dronrome1245/ARDU/02_СЛЕДУЮЩИЙ_ШАГ.md

# 02 — СЛЕДУЮЩИЙ ШАГ

> Совместимый handoff-файл. Канонический статус находится в `STATUS.md`.

**Актуальное направление на 2026-11-14:** Android 0.22.16, Nano R7, ESP V5 source CI PASS; R7 30 712/30 720 B Flash. Следующее физическое действие по D-128 — сохранить `/api/settings`, установить ESP V5 OTA с приватными credentials, затем Nano R7 по полностью проверенному write+verify, после этого провести `04_Прошивка/FAMILY_R7_ACCEPTANCE.md`. До выполненных электрических 44+44 и безопасного Class II gate потолочный монтаж не разрешён. Следующие абзацы — исторический handoff 2026-09.

## Цель следующей итерации

Подтвердить питание и физическую разводку двух потолочных корпусов, затем собрать первый ESP8266↔Nano стенд.

## Уже закрыто

- запас WS2812B подтверждён: 5 м;
- `Ardublock2.aia` разобран;
- режимы и параметры v1 определены;
- модель нового Wi‑Fi приложения определена;
- предварительный HTTP API создан.

## От владельца нужны три группы данных

1. Есть ли мультиметр и паяльник/припой.
2. Расстояние между двумя круглыми корпусами и фактическая потолочная проводка: где разветвляется линия второй клавиши, сколько жил приходит к каждому корпусу.
3. Где можно безопасно и обслуживаемо разместить общий S-30-5.

## Затем измерить

1. S-30-5: V+↔V- без нагрузки.
2. YP-8: 5 В на VIN → VOUT без нагрузки.
3. После подтверждения 3,3 В — YP-8 с ESP8266 под Wi‑Fi нагрузкой.
4. Прочитать маркировку и количество электролитов около `1000 µF`.
5. Собрать делитель Nano TX → ESP RX и измерить его выход до подключения ESP8266.

## Параллельная подготовка

- удалить `201` на DS3231 перед штатным питанием с CR2032;
- проверить способ прошивки ESP8266 через имеющийся Nano/другой мост;
- физически примерить 43 LED на кантик 71,5 см;
- не замыкать DOUT последнего LED обратно на DIN первого.

## После этого

1. утвердить окончательный BOM;
2. собрать `S-30-5 → Nano + YP-8/ESP8266 → UART → одно кольцо`;
3. добиться `PING/PONG`;
4. включить F01 постоянный цвет по Wi‑Fi;
5. добавить второе кольцо;
6. подключить MAX9814 и реализовать M01 VU градиент.

Подробный порядок: `04_Прошивка/ПОРЯДОК_РЕАЛИЗАЦИИ.md`.

## Актуальный следующий шаг 2026-09-20

Собрать безопасный низкоомный programmer-divider `750 Ом / 1,5 кОм` из имеющихся резисторов 1,5 кОм, оставить `100 µF 10 V` у ESP, проверить HIGH около 3,3 В и повторить upload на `115200` с ручным кратким `RST→GND` во время `Connecting...`. Прямой D0→ESP RX больше не использовать как штатный способ.

## Актуальный следующий шаг — FW-0 Nano

1. Полностью отделить Nano от ESP по D0/D1 на время загрузки FW-0.
2. Убрать перемычку `RESET Nano → GND` — она нужна была только когда Nano работала USB↔UART-мостом.
3. Оставить Nano подключённой только по USB к компьютеру и загрузить `04_Прошивка/nano_fw0/nano_fw0.ino`.
4. Открыть Serial Monitor `115200`, окончание строки `Newline`; ожидать `ARDU NANO FW0 READY`.
5. Отправить `PING` → ожидать `PONG`; затем `STATUS` → ожидать строку `STATUS FW=FW0 ...`.

До успешного теста кольцо, ESP и MAX9814 к FW-0 не подключать.

### Уточнение после первой попытки FW-0

Перед повторным Upload Nano: ESP должен быть полностью отключён от `D0` и `D1`; перемычка `RESET Nano→GND` снята; Serial Monitor закрыт. Повторить upload с текущими настройками Arduino IDE. Только если `not in sync` сохранится на полностью изолированной Nano, проверять вариант `ATmega328P (Old Bootloader)` и ручной reset.

### Следующий тест Nano после сохранения `resp=0x41`

В Arduino IDE выбрать `Tools → Processor → ATmega328P (Old Bootloader)` и повторить Upload при полностью свободных D0/D1 и снятом `RESET→GND`. Если ошибка сохранится — выполнить ручной reset Nano в момент начала загрузки.

## Актуальный следующий шаг — FW-1

FW-0 закрыт. Оставить Nano изолированной от ESP, выбрать `Arduino Nano → ATmega328P (Old Bootloader)`. Открыть `04_Прошивка/nano_fw1/nano_fw1.ino` и сначала выполнить только Verify/Compile. Если Arduino IDE сообщает, что `FastLED.h` не найден, установить библиотеку `FastLED` через Library Manager. Кольцо пока не подключать. После успешной компиляции перейти к физической схеме одного кольца на D6.

### FW-1 — физический тест одного канала

Собрать только Nano + один вход WS2812B: Nano питается по USB; лента питается от S-30-5 5 В; земли Nano и S-30-5/ленты объединены; `Nano 5V` с `S-30-5 V+` не соединять. DATA: D6 → DIN начала ленты; предпочтительно через 330 Ом, а для текущего короткого стенда допустим временный последовательный 1,5 кОм из наличия. Проверять первые 43 LED на малой яркости/лимите 500 мА. Второе кольцо, ESP и MAX9814 не подключать.

### FW-1 — схема по AlexGyver

Предыдущий временный вариант DATA через `1,5 кОм` отменён. Перед подключением ленты:
1. прочитать полную маркировку имеющегося электролита `1000 µF` и подтвердить рабочее напряжение ≥6,3 В;
2. найти среди имеющихся резистор `200–500 Ом` (предпочтительно 330 Ом) либо подтвердить, что его нет;
3. затем собрать: `S-30-5 +5V/GND → лента`, `1000 µF` параллельно +5V/GND у начала ленты, `Nano D6 → 200–500 Ом → DIN`, `Nano GND → GND ленты`. Nano остаётся на USB; Nano 5V к S-30-5 V+ не соединять.

### После подтверждения 1000 µF 6,3 V

Конденсатор для питания WS2812B подтверждён. Следующее — найти/подтвердить DATA-резистор `200–500 Ом` (целевой 330 Ом). До его подтверждения физический FW-1 с лентой не собирать.

### После подготовки 220 Ом

1. Пока лента не подключена, загрузить `04_Прошивка/nano_fw1/nano_fw1.ino` в Mini-USB Nano с `ATmega328P (Old Bootloader)`.
2. Отключить USB Nano и 230 В/S-30-5.
3. Собрать один канал: `Nano D6 → 220 Ом → DIN WS2812B`; `S-30-5 +5V → +5V ленты`; `S-30-5 V- → GND ленты`; `Nano GND → GND ленты`; `1000 µF 6,3 V` параллельно +5V/GND у начала ленты (`+` к +5V, `-` к GND).
4. `Nano 5V` с `S-30-5 +5V` не соединять. Второе кольцо, ESP и MAX9814 не подключать.
5. После сборки включить S-30-5, затем подключить Nano по USB. Ожидаемый результат — первые 43 LED тускло красные; затем проверить `STATUS`, `COLOR 0 32 0`, `COLOR 0 0 32`.

## Актуальный следующий шаг — FW-2

1. Открыть `04_Прошивка/nano_fw2/nano_fw2.ino`.
2. Оставить Mini-USB Nano как `Arduino Nano → ATmega328P (Old Bootloader)`.
3. Выполнить только Verify/Compile, не подключая второе кольцо.
4. После успешной компиляции подтвердить наличие второго DATA-резистора `200–500 Ом` (220 Ом подходит) и второго электролита около `1000 µF` ≥6,3 В для второго кольца либо временно тестировать два коротких сегмента рядом с одним общим качественным 5 В вводом.
5. Физический FW-2: D6→резистор→DIN A, D7→резистор→DIN B, обе ленты от S-30-5, общая GND, одинаковый кадр; затем команды `RING A`, `RING B`, `BOTH`.

## Актуальный шаг после решения о зеркальном D7

Второе кольцо пока не подключать. D7 физически не тестировать. На текущем D6-кольце завершить F01-команды:

1. `OFF` — все 43 LED должны погаснуть, ответ `OK`.
2. `ON` — должен вернуться текущий цвет, ответ `OK`.
3. `BRIGHT 8` — заметно уменьшить яркость, ответ `OK`.
4. `BRIGHT 64` — увеличить яркость, ответ `OK`.
5. `STATUS` — проверить, что POWER/BRIGHTNESS/RGB совпадают с командами.

После этого следующий физический слой добавлять только к одному кольцу. D7 остаётся зеркальным выходом и будет проверен после полной настройки первого кольца.

## Актуальный следующий шаг — MAX9814 на одном кольце

1. Сначала открыть и скомпилировать/загрузить `04_Прошивка/nano_mic_test/nano_mic_test.ino` на Mini-USB Nano (`ATmega328P (Old Bootloader)`).
2. После успешной загрузки обесточить стенд и подключить MAX9814: `Vdd→Nano 5V`, `GND→Nano GND`, `Out→A0`; `Gain` и `AR` оставить неподключёнными.
3. Включить стенд, Serial Monitor `115200`, `Newline`.
4. В тишине отправить `MIC` несколько раз; затем говорить/хлопать рядом с микрофоном и снова отправлять `MIC`.
5. Успех этапа: среднее значение остаётся в разумном диапазоне и `P2P` заметно увеличивается при звуке. Второе кольцо, ESP8266 и RTC пока не подключать.

### MAX9814 — уточнённый тест реакции на звук

Перезагрузить обновлённый `nano_mic_test.ino`. В Serial Monitor отправить `MIC1S` и в течение следующей секунды сохранять тишину; дождаться строки `MIC1S ...`. Затем снова отправить `MIC1S` и во время самой секунды сказать громко/хлопнуть рядом с микрофоном. Прислать обе строки. Сравниваем прежде всего `P2P`, а также MIN/MAX; только после этого решаем, годится ли текущая чувствительность MAX9814 для M01 без смены Gain/AREF.

### MAX9814 — уменьшить Gain до 50 dB

1. Обесточить Nano/стенд.
2. Соединить вывод `Gain` MAX9814 с `GND` MAX9814/Nano. `AR` оставить неподключённым.
3. Включить стенд; скетч менять не нужно.
4. Желательно выполнить тест с кольцом `OFF`, чтобы сначала измерить микрофон без возможной помехи от WS2812B.
5. Отправить `MIC1S` в тишине и ещё раз `MIC1S` с громкой речью/хлопком.
6. Цель: громкий тест не должен доходить до `MIN=0` или `MAX=1023`, а `P2P` должен заметно превышать тихий уровень. Если 50 dB всё ещё клиппует — следующий обратимый шаг `Gain→Vdd` (40 dB).

### MAX9814 — откат к последней рабочей схеме

1. Полностью выключить питание стенда.
2. Снять только перемычку `Gain→GND`.
3. Проверить, что остаётся ровно: `Vdd→5V`, `GND→GND`, `Out→A0`; `Gain` и `AR` свободны.
4. Включить и выполнить `MIC1S`.
5. Если `AVG` вернётся примерно к 250, модуль/ADC исправны; затем отдельно по маркировке платы повторно определить пин Gain. Если AVG останется около 0 — измерить мультиметром напряжение `Out→GND` на включённом модуле.

### MAX9814 — перед повторной сменой Gain

Не подключать Gain повторно вслепую. Сначала визуально подтвердить на конкретной плате подписи/расположение выводов `AR / Out / Gain / Vdd / GND` и место, куда ставилась перемычка. После подтверждения повторить 50 dB (`Gain→GND`) либо, если нужно больше запаса, 40 dB (`Gain→Vdd`). Floating 60 dB оставить только как диагностическое состояние: на громком сигнале уже наблюдается `MIN=0`.

### MAX9814 — повтор 50 dB после фотоидентификации

При выключенном питании соединить **центральный свободный** вывод `Gain` с **крайним правым** `GND` (куда приходит синий провод). Жёлтый `Out→A0` и зелёный `Vdd→5V` не трогать; `AR` оставить свободным. После включения выполнить `MIC1S` в тишине и при громком звуке.

### MAX9814 — следующий тест 40 dB

1. Полностью обесточить Nano/стенд.
2. Переставить перемычку `Gain`: снять с `GND` и соединить с `Vdd` MAX9814 (зелёный провод/пин Vdd). Не соединять Gain одновременно с GND и Vdd.
3. `Out→A0`, `Vdd→5V`, `GND→GND` оставить как есть; `AR` оставить свободным.
4. После включения выполнить `MIC1S` в тишине и `MIC1S` при громком звуке.
5. Цель: `MIN>0`, `MAX<1023`, при этом P2P громкого сигнала заметно выше тишины. Проверить также, что `SAMPLES` снова близко к ~5000; если снова около 1000, отдельно диагностировать частоту выборки.

### MAX9814 — перейти к 40 dB

1. Выключить питание.
2. Снять перемычку `Gain→GND`.
3. Соединить `Gain→Vdd` (центральный Gain на соседний справа Vdd/зелёный провод). `Out→A0`, `GND`, `AR` оставить как есть.
4. Включить и выполнить `MIC1S` в тишине.
5. Выполнить `MIC1S` при громкой речи/хлопке.
6. Успех: при громком звуке `MIN>0` и `MAX<1023`, а P2P заметно выше тихого. Тогда 40 dB принимаем для дальнейшего M01.

## Актуальный следующий шаг — M01 VU градиент

1. Оставить MAX9814: `Vdd→5V`, `GND→GND`, `Out→A0`, `Gain→Vdd` (40 dB), `AR` свободен. Второе кольцо и ESP не подключать.
2. Открыть `04_Прошивка/nano_m01/nano_m01.ino`, Verify/Compile и загрузить в Mini-USB Nano (`ATmega328P (Old Bootloader)`).
3. В тихой комнате отправить `CAL`; ожидать `CAL QUIET_MAX=... LOW_PASS=...`. Во время CAL не шуметь.
4. После CAL включить реальную музыку на обычной громкости. Кольцо должно давать симметричный VU-градиент от зелёного к красному и автоматически менять длину шкалы.
5. Для диагностики отправить `AUDIO`; прислать строку при тишине и при музыке, если визуально режим ведёт себя слишком тихо/слишком резко.
6. Экстремальный хлопок не использовать как основной критерий M01; частотные режимы/FHT позже отдельно проверят клиппинг и входную обработку.

## Актуальный следующий шаг — FHT diagnostic

1. Оставить текущее подключение MAX9814: `Gain→Vdd` (40 dB), `Out→A0`, `AR` floating; второе кольцо/ESP/RTC не подключать.
2. Открыть `04_Прошивка/nano_fht_test/nano_fht_test.ino` и выполнить Verify/Compile для `Arduino Nano → ATmega328P (Old Bootloader)`.
3. Если IDE сообщает `FHT.h: No such file or directory`, установить FHT-библиотеку из официального репозитория ColorMusic (`libraries/FHT`) и повторить Verify.
4. После успешной загрузки выполнить `CALF` в тишине.
5. Затем несколько раз `FREQ` в тишине и при музыке. Ожидается, что LOW/MID/HIGH меняются вместе со звуком, а после CALF тишина в основном подавлена.
6. На этом этапе лента специально гасится: сначала проверяем анализ, потом добавляем M03/M04.

### FHT — использовать AvrFHT

1. В Arduino IDE открыть Library Manager и установить `AvrFHT` by KobaProduction.
2. Открыть актуальный `04_Прошивка/nano_fht_test/nano_fht_test.ino` — он уже адаптирован под AvrFHT.
3. Verify/Compile для `Arduino Nano → ATmega328P (Old Bootloader)`.
4. После успешной загрузки: `CALF` в тишине, затем `FREQ` в тишине и при музыке.
5. Старую `FHT` из `AlexGyver/ColorMusic/libraries/FHT` отдельно копировать не нужно, если AvrFHT компилируется и проходит физический тест.

### AvrFHT — повтор после исправления DC-калибровки

1. Загрузить свежий `04_Прошивка/nano_fht_test/nano_fht_test.ino`.
2. Сначала отправить `ADC`. Нормальный ориентир для текущего MAX9814 — `AVG` примерно 240–270; MIN/MAX могут немного гулять.
3. Если `ADC AVG≈250`, отправить `CALF` в тишине. В строке `CALF DC=...` DC также должен быть около 250, а не 914.
4. Затем отправить `FREQRAW` в тишине и при музыке, после этого `FREQ`.
5. Если `ADC` снова показывает около 900, FHT пока не диагностировать: проверить физическое напряжение `OUT→GND` MAX9814 мультиметром.

### AvrFHT — один развилочный тест `ADC`

Не менять проводку и Gain. В текущем Serial Monitor отправить `ADC`.
- Если ответ `ERR UNKNOWN_COMMAND` — на Nano осталась предыдущая версия скетча; загрузить свежий `nano_fht_test.ino` и повторить `ADC`.
- Если `ADC AVG≈240..270` — железо MAX9814/A0 исправно, ошибка локализована в CALF/FHT-коде.
- Если `ADC AVG≈900..1000` — сначала измерить мультиметром `MAX9814 OUT→GND`; к FHT не переходить.

### 2026-09-21 — сначала восстановить обычный A0, FHT не трогать

1. Ничего не менять и отправить команду `ADC` в текущем FHT-скетче.
2. Если `ADC AVG` около 0: выключить питание, снять **только** перемычку `Gain→Vdd`, оставить `Out→A0`, `Vdd→5V`, `GND→GND`, `AR` свободным; включить и снова отправить `ADC`.
3. Если после снятия Gain `ADC AVG` возвращается примерно к 250 — проблема локализована в физической установке перемычки Gain/соседнем контакте. Не продолжать FHT до устойчивого прямого ADC.
4. Если и с floating Gain `ADC AVG≈0` — измерить мультиметром `MAX9814 OUT→GND` и проверить питание `Vdd→GND`.

### 2026-09-21 — перепрошить актуальный FHT-test

1. Не менять проводку MAX9814.
2. В Arduino IDE открыть заново файл `04_Прошивка/nano_fht_test/nano_fht_test.ino` из актуальной версии репозитория.
3. Выбрать `Arduino Nano → ATmega328P (Old Bootloader)` и Upload.
4. После старта отправить `HELP`; в ответе обязательно должна быть команда `ADC`.
5. Затем отправить `ADC` и прислать строку. Только после этого снова выполнять `CALF/FREQRAW`.

### 2026-09-21 — измерить MAX9814 напрямую мультиметром

Не менять прошивку и не выполнять CALF/FREQ. На включённом стенде измерить:
1. `красный щуп → Vdd MAX9814`, `чёрный → GND MAX9814`;
2. `красный щуп → Out MAX9814`, `чёрный → GND MAX9814`.

Ориентир: Vdd около 5 В; Out около 1,25 В DC. Если Out нормальный, проверить провод `Out→A0`/контакт A0. Если Out около 0 В, обесточить и проверить, не смещены ли разъёмы и не замыкает ли `Gain→Vdd` соседний `Out`.

### 2026-09-21 — проверить напряжение непосредственно на Nano A0

Не менять Gain, прошивку или FHT. Оставить `Out→A0` подключённым. На включённом стенде измерить мультиметром: красный щуп прямо на физический контакт `Nano A0`, чёрный щуп на `Nano GND`.
- Если `A0≈1,24 В` — провод до Nano исправен; далее проверять сам A0/ADC и скетч.
- Если `A0≈0 В` — неисправен/не попал в контакт провод `MAX9814 Out→A0` или разъём на одной из сторон.

### 2026-09-21 — прозвонить Out→A0

1. Полностью выключить питание Nano и MAX9814.
2. Снять сигнальный провод `MAX9814 Out→Nano A0` хотя бы с одного конца.
3. Прозвонить сам провод/джампер: сопротивление между его концами должно быть близко к 0 Ом.
4. При снятом Out измерить сопротивление `Nano A0→Nano GND`. Оно не должно быть близко к 0 Ом.
5. Если провод плохой — заменить. Если провод исправен, но A0 сильно посажен на GND — временно перенести микрофон на другой свободный аналоговый вход для диагностики либо исследовать Nano A0 отдельно.

### 2026-09-21 — повторить ADC после ремонта провода

1. Не менять текущую проводку MAX9814.
2. На актуальном `nano_fht_test.ino` отправить `ADC`.
3. Если `ADC AVG≈240..270`, выполнить `CALF` в тишине.
4. После CALF выполнить `FREQRAW` в тишине и при музыке, затем `FREQ`.
5. Если ADC всё ещё не около 250, FHT не продолжать — сначала снова проверить A0.

### 2026-09-21 — проверить FHT после noise gate

Проводку и прошивку не менять. После уже выполненного `CALF`:
1. В тишине отправить `FREQ`.
2. Включить обычную музыку и отправить `FREQ` несколько раз на заметных ударах/звуках.
3. Ожидается: в тишине LOW/MID/HIGH в основном 0; при звуке хотя бы один диапазон должен устойчиво проходить порог.
4. Если при музыке почти всё остаётся 0, не повышать Gain: `SPECTR_LOW_PASS=64` оказался слишком консервативным из-за единичного выброса CALF, и следующим изменением будет более устойчивый алгоритм калибровки шума.

### 2026-09-21 — проверить новую CALF P90

1. Загрузить свежий `04_Прошивка/nano_fht_test/nano_fht_test.ino` (`ATmega328P (Old Bootloader)`). Проводку MAX9814 не менять.
2. В тишине выполнить `CALF`. Новая строка имеет вид `CALF DC=... P50=... P90=... MAX=... SPECTR_LOW_PASS=...`.
3. Ожидается, что `P90` будет существенно ближе к обычному тихому PEAK (~19), чем одиночный `MAX≈58..61`; gate должен стать заметно ниже прежних 61–64.
4. Затем один `FREQ` в тишине и 3–5 `FREQ` под обычную музыку. Успех: тишина в основном 0, при музыке хотя бы LOW/MID/HIGH регулярно ненулевые.
5. Если P90 всё ещё неожиданно высок, прислать строку CALF и несколько FREQRAW — тогда подберём процентиль по фактическому распределению, не меняя Gain.

### 2026-09-21 — не считать P90 эквивалентом оригинала ColorMusic

Перед дальнейшей настройкой FHT сначала выбрать: либо воспроизвести оригинальный частотный вход AlexGyver (отдельный ADC-вход через конденсатор и соответствующая опора), либо осознанно оставить прямой MAX9814→ADC и адаптировать алгоритм. До этого P90 считать только диагностическим экспериментом, не финальным решением.

### 2026-09-21 — перед продолжением FHT сравнить две проверенные ветки

Не продолжать подгонять P90 как финальный алгоритм. Сначала извлечь и сравнить конкретные схемы: (1) официальный ColorMusic/MAX9814; (2) community FireEdition/technotrasher с вариантом MAX4466. После сравнения решить, какой аналоговый вход ARDU воспроизводить на стенде. MAX4466 в инвентаре позволяет сделать прямой сравнительный тест без покупки деталей.

### 2026-09-21 — перейти на vendored original FHT

1. Для ARDU больше не использовать AvrFHT как основную FHT-зависимость.
2. Скопировать папку `04_Прошивка/libraries/FHT` целиком в пользовательскую `Arduino/libraries/FHT` (при наличии старой FHT заменить её этой pinned-копией).
3. Перезапустить Arduino IDE.
4. Открыть свежий `04_Прошивка/nano_fht_test/nano_fht_test.ino` и выполнить Verify/Compile для `Arduino Nano → ATmega328P (Old Bootloader)`.
5. Пока не менять аппаратный вход и не продолжать калибровку: сначала подтвердить чистую компиляцию на оригинальной FHT, затем отдельно приблизить частотный вход к ColorMusic v2.10.

### 2026-09-21 — повторить Verify после SCALE compatibility fix

1. Обновить/открыть свежий `04_Прошивка/nano_fht_test/nano_fht_test.ino`.
2. Vendored папку `FHT` в `Documents/Arduino/libraries/FHT` не менять.
3. Выполнить Verify/Compile для `Arduino Nano → ATmega328P (Old Bootloader)`.
4. Если ошибки `SCALE` исчезли, прислать итог компиляции. Сообщение `grpc ... invalid UTF-8` пока считать вторичным эффектом вывода пути с кириллицей; отдельно лечить только если оно останется после устранения реальной C++ ошибки.

### 2026-09-21 — runtime-проверка после перехода на original FHT

1. Открыть Serial Monitor на 115200.
2. После reset убедиться, что появляется `ARDU NANO FHT TEST READY`.
3. Отправить `HELP`.
4. Отправить `STATUS`.
5. Отправить `ADC`.
6. Не выполнять `CALF` до подтверждения, что `ADC AVG` снова около 250 и runtime не изменился после замены библиотеки.

### 2026-09-21 — перепроверить startup DC и оригинальный CALF

1. Загрузить свежий `nano_fht_test.ino`.
2. После загрузки/перезапуска подождать не менее секунды и отправить `STATUS`.
3. Ожидается `DC` примерно 240..270. Если снова далеко от текущего ADC — сначала диагностировать стартовую калибровку, FHT не продолжать.
4. Затем отправить `ADC`; AVG должен оставаться примерно 250.
5. Если STATUS DC и ADC согласованы, в тишине выполнить `CALF`. Теперь вывод снова оригинального типа: `CALF DC=... QUIET_MAX=... SPECTR_LOW_PASS=...`, где порог = абсолютный максимум + 3.

### 2026-09-21 — повторить валидный тест после восстановления A0

1. Убедиться, что `MAX9814 Out→Nano A0` физически держится.
2. После загрузки свежего скетча подождать 1–2 секунды.
3. Отправить `ADC`.
4. Затем `STATUS`.
5. Если `ADC AVG` и `STATUS DC` оба примерно 240..270, выполнить `CALF` в тишине.
6. После CALF выполнить один `FREQRAW` в тишине и несколько `FREQRAW` под музыку. `FREQ` проверять после подтверждения адекватного порога.

### 2026-09-21 — закрыть проверку noise gate original FHT

1. Проводку и код не менять.
2. В тишине отправить `FREQ` 2–3 раза.
3. Затем при обычной музыке/голосе отправить `FREQ` 3–5 раз.
4. Успех: в тишине LOW/MID/HIGH в основном 0; при звуке хотя бы один диапазон стабильно ненулевой и превышает `LOW_PASS=36`.
5. Дополнительно один `FREQRAW` в тишине полезен для прямого сравнения с уже полученным raw peak=82.

### 2026-09-21 — проверить три диапазона ColorMusic v2.10

Код и проводку не менять. Использовать контролируемый синус/тон через внешний динамик перед MAX9814 и смотреть `FREQ`.

- Сначала тон около 2 кГц: ожидать преимущественно LOW.
- Затем около 4–5 кГц: ожидать MID.
- Затем около 8 кГц: ожидать HIGH.

Это ориентиры для проверки соответствия исходным bins v2.10 (2..5 / 6..10 / 11..31); реальные границы зависят от фактической частоты выборки Arduino. Достаточно по 2–3 строки `FREQ` на каждый тон. Не менять Gain и не перекалибровывать между тонами.

### 2026-09-21 — перед тестом MID/HIGH собрать двухвходовый тракт v2.10

Контролируемые тоны на текущем A0-only стенде больше не считать следующим финальным тестом. Сначала:
1. разобрать официальную схему «С микрофоном» ColorMusic и выписать точные соединения/номиналы узла A2↔A3;
2. перенести основной mono/VU вход на Nano A2;
3. добавить отдельный FHT-вход Nano A3 через оригинальный конденсаторный узел;
4. после этого адаптировать `nano_fht_test` и M01 к A2/A3 и повторить ADC/CALF/FREQ;
5. только затем проверять LOW/MID/HIGH тонами.

### 2026-09-21 — после полного FHT-pass на A0 перейти к финальному A2/A3

A0 больше не диагностировать: его цель выполнена. Следующий шаг — воспроизвести официальный двухвходовый аудиотракт ColorMusic v2.10:
1. A2 — mono/VU вход;
2. A3 — FHT-вход через оригинальный конденсаторный узел;
3. после сборки проверить ADC/уровни;
4. выполнить CALF;
5. быстро повторить 2/5/8 кГц как regression-test. Ожидаем те же LOW/MID/HIGH классы.

### 2026-09-21 — A2/A3 пока не переподключать

Текущий `nano_fht_test` всё ещё читает A0. До новой версии скетча оставить рабочий A0 как есть. После подготовки A2/A3-версии физическая логика будет: основной аудиосигнал → A2; A2 → 10 nF (103) → A3. Выход микрофона не соединять напрямую одновременно с A2 и A3.

### 2026-09-21 — новый A2/A3-скетч готов

1. Сначала Verify/Upload `04_Прошивка/nano_audio_v210_test/nano_audio_v210_test.ino` на Nano с `ATmega328P (Old Bootloader)`.
2. После успешной загрузки полностью обесточить стенд.
3. Собрать ровно по `04_Прошивка/AUDIO_V210_WIRING.md`.
4. Перед C1 проверить его маркировку: 1 µF и напряжение не ниже 6,3 V.
5. После включения сначала `STATUS`, затем `ADC2`, `ADC3`. Не выполнять CALF до этих трёх строк.

### 2026-09-22 — исправленная сборка A2/A3

Не ставить 4,7 kΩ резисторы в аудиотракт. После успешного Verify/Upload нового скетча собрать:
`MAX9814 Out → +C1− → A2`, затем `A2 → 103/10 nF → A3`.
A0 внешне не подключать; скетч держит его LOW как оригинальный `POT_GND`.
Перед монтажом C1 подтвердить его напряжение ≥6,3 V.

### 2026-09-24 — следующий шаг: M03 «5 полос»

1. Оставить подтверждённую схему MAX9814: `Vdd→5V`, `GND→GND`, `Gain→Vdd` (40 dB), `AR` свободен, `Out→A0`.
2. Оставить одно кольцо на D6; D7/второе кольцо не подключать.
3. В Arduino IDE открыть `04_Прошивка/nano_m03/nano_m03.ino`.
4. Выбрать `Arduino Nano → ATmega328P (Old Bootloader)` и сначала выполнить только Verify/Compile.
5. После успешной компиляции загрузить скетч. В тишине выполнить `STATUS`, `ADC`, `CALF`, затем `BANDS`.
6. После CALF проверить 2 кГц → LOW/красная центральная зона, 4–5 кГц → MID/зелёные зоны, 8 кГц → HIGH/жёлтые зоны; затем проверить реальную музыку.

### 2026-09-24 — отдельная проверка ленты

1. Открыть `04_Прошивка/nano_strip_test/nano_strip_test.ino`.
2. Выбрать `Arduino Nano → ATmega328P (Old Bootloader)` и загрузить скетч.
3. Открыть Serial Monitor: 115200 baud, Newline.
4. Выполнить: `STATUS`, затем `RED`, `GREEN`, `BLUE`, `WHITE`, `CHASE`, в конце `OFF`.
5. Проверить, что все 43 LED работают во всех цветах, а CHASE проходит по всей длине без пропусков.
6. Этот тест не использует MAX9814/A0/FHT и нужен для отделения неисправности ленты/питания от аудиотракта.

## Актуальный следующий шаг — M04 «3 полосы» (2026-09-25)

M03 полностью закрыт на одном кольце. Второе кольцо/D7 не подключать.

1. В Arduino IDE открыть `04_Прошивка/nano_m04/nano_m04.ino`.
2. Оставить `Board: Arduino Nano`, `Processor: ATmega328P (Old Bootloader)`.
3. Выполнить сначала только Verify/Compile.
4. Если компиляция успешна — Upload на ту же Nano.
5. Открыть Serial Monitor `115200`, окончание строки `Newline`.
6. Ожидать `ARDU NANO M04 READY`, затем отправить `STATUS`.
7. Норма: `FW=M04 MODE=M04`, `MIC_PIN=A0`, `BACKGROUND=0`, D7 физически остаётся неподключённым.
8. Только после этого выполнить `ADC` и `CALF` в тишине, затем визуально проверить 2/5/8 кГц: LOW / MID / HIGH должны зажигать три разные последовательные трети кольца.

Схему MAX9814 и DATA не менять: используется уже проверенный M03-стенд с общей GND.

## Актуальный следующий шаг — M05 «1 полоса» (2026-09-25)

M04 полностью закрыт. Второе кольцо/D7 не подключать.

1. Открыть `04_Прошивка/nano_m05_r2/nano_m05_r2.ino`.
2. Выбрать `Board: Arduino Nano`, `Processor: ATmega328P (Old Bootloader)`.
3. Выполнить только Verify/Compile.
4. После успешной компиляции — Upload.
5. В Serial Monitor `115200/Newline` ожидать `ARDU NANO M05 R2 READY`.
6. `STATUS` должен показать `FW=M05 REV=2 MODE=M05 ... SUBMODE=THREE BACKGROUND=0`.
7. После `ADC` и `CALF` проверить команды `SUBMODE THREE`, `SUBMODE LOW`, `SUBMODE MID`, `SUBMODE HIGH`.
8. Для одиночных подрежимов использовать контролируемые 2/5/8 кГц; кольцо должно целиком вспыхивать только на выбранной группе.

**Важно:** для текущего теста использовать только M05 R2. Если в Arduino IDE открыт старый unsaved sketch без `R2`, закрыть его и открыть `nano_m05_r2.ino`.

## Актуальный следующий шаг — M05 R3 (2026-09-26)

1. Открыть `04_Прошивка/nano_m05_r3/nano_m05_r3.ino`.
2. Verify + Upload на `Arduino Nano / ATmega328P (Old Bootloader)`.
3. Serial Monitor 115200/Newline: ожидать `ARDU NANO M05 R3 READY`.
4. Одним пакетом выполнить: `STATUS`, `ADC`, `CALF`, `STATUS`.
5. Продолжать тест подрежимов только если STATUS показывает `REV=3`, `DC_OK=YES`, `CAL=YES` и DC остаётся примерно около 250.
6. Затем проверить `SUBMODE THREE/LOW/MID/HIGH`; при любом новом reset (UPTIME снова уменьшается) тест остановить и зафиксировать момент.

## Актуальный следующий шаг — M05 R4 UART/FastLED test (2026-09-26)

1. Открыть `04_Прошивка/nano_m05_r4/nano_m05_r4.ino`.
2. Verify + Upload на Arduino Nano / ATmega328P (Old Bootloader).
3. STATUS должен содержать `FW=M05 REV=4`, `FASTLED_IRQ=ON RX_GUARD_MS=5`.
4. Выполнить `CALF`; убедиться `DC_OK=YES CAL=YES`.
5. Создать худший режим для UART: `ON`, затем `BACKGROUND 32` — кольцо постоянно светится и `FastLED.show()` продолжает работать.
6. Пока кольцо светится, отправить `STATUS` подряд 10 раз и затем по 2–3 раза `SUBMODE LOW`, `SUBMODE MID`, `SUBMODE HIGH`, `SUBMODE THREE`.
7. Успех: ни одного `ERR UNKNOWN_COMMAND` / `ERR BAD_SUBMODE`; все ответы целые; кольцо не мерцает случайными пикселями и цвета не искажаются.
8. В конце вернуть `BACKGROUND 0`.

## Актуальный следующий шаг — M08 R1 «Бегущие частоты» (2026-09-26)

1. Открыть `04_Прошивка/nano_m08_r1/nano_m08_r1.ino`.
2. Verify + Upload для `Arduino Nano / ATmega328P (Old Bootloader)`.
3. Serial Monitor 115200/Newline: ожидать `ARDU NANO M08 R1 READY`.
4. Выполнить пакетом: `STATUS`, `ADC`, `CALF`, `STATUS`.
5. Норма: `FW=M08 REV=1`, `DC_OK=YES`, `CAL=YES`, `FASTLED_IRQ=ON RX_GUARD_MS=5`, `SPEED_MS=11`.
6. На реальной музыке `SUBMODE THREE`: цветные импульсы должны появляться около центрального DATA-index и расходиться в две стороны по кольцу.
7. Проверить `SUBMODE LOW/MID/HIGH` с 2/5/8 kHz или музыкой соответствующего диапазона.
8. Проверить скорость: `SPEED 5` быстрее, `SPEED 20` медленнее, `SPEED 50` заметно медленнее; затем вернуть `SPEED 11`.
9. Во время активного эффекта несколько раз подряд отправить `STATUS`; Serial errors возвращаться не должны.

## Актуальный следующий шаг — M09 R1 «Анализатор спектра» (2026-09-26)

1. Открыть `04_Прошивка/nano_m09_r1/nano_m09_r1.ino`.
2. Verify + Upload для `Arduino Nano / ATmega328P (Old Bootloader)`.
3. Serial Monitor 115200/Newline: ожидать `ARDU NANO M09 R1 READY`.
4. Выполнить пакетом: `STATUS`, `ADC`, `CALF`, `STATUS`.
5. Норма: `FW=M09 REV=1`, `DC_OK=YES`, `CAL=YES`, `DISPLAY_BINS=20`, `HUE_START=0`, `HUE_STEP=5`, `FASTLED_IRQ=ON RX_GUARD_MS=5`.
6. Включить музыку: должна появиться симметричная спектральная картинка; в тишине после decay кольцо гаснет.
7. Во время музыки выполнить несколько `SPEC`: значения bins должны меняться по спектру.
8. Проверить `HUESTART 80` — меняется стартовая цветовая позиция; `HUESTEP 12` — меняется шаг цветов. Затем вернуть `HUESTART 0`, `HUESTEP 5`.
9. Во время активной картинки несколько раз подряд отправить `STATUS`; Serial errors возвращаться не должны.

## Актуальный следующий шаг — F02 R1 «Плавная смена цвета» (2026-09-26)

1. Открыть `04_Прошивка/nano_f02_r1/nano_f02_r1.ino`.
2. Verify + Upload для `Arduino Nano / ATmega328P (Old Bootloader)`.
3. Serial Monitor 115200/Newline: ожидать `ARDU NANO F02 R1 READY`.
4. STATUS должен показать `FW=F02 REV=1 MODE=F02 POWER=ON BRIGHTNESS=64 SAT=255 SPEED_MS=100 FASTLED_IRQ=ON RX_GUARD_MS=5`.
5. Визуально: всё кольцо одного цвета, цвет плавно проходит по HUE.
6. Проверить `SPEED 20` (быстрее), `SPEED 200` (медленнее), затем `SPEED 100`.
7. Проверить `SAT 80` (цвет ближе к белому) и возврат `SAT 255`.
8. Проверить `HUE 96`: текущая точка цикла должна сразу перескочить на новый цвет и продолжить движение оттуда.
9. При активном эффекте отправить несколько STATUS подряд; UART errors быть не должно.

## Актуальный следующий шаг — F03 R1 «Бегущая радуга» (2026-09-26)

1. Открыть `04_Прошивка/nano_f03_r1/nano_f03_r1.ino`.
2. Verify + Upload для `Arduino Nano / ATmega328P (Old Bootloader)`.
3. Serial Monitor 115200/Newline: ожидать `ARDU NANO F03 R1 READY`.
4. STATUS должен показать `FW=F03 REV=1 MODE=F03 POWER=ON BRIGHTNESS=64 SPEED=1 STEP10=5 FRAME_MS=30 FASTLED_IRQ=ON RX_GUARD_MS=5`.
5. Визуально: по кольцу одновременно виден цветовой градиент, который движется во времени.
6. Проверить скорость: `SPEED 1` baseline, `SPEED 5` заметно быстрее, `SPEED 15` ещё быстрее, затем вернуть `SPEED 1`.
7. Проверить spatial step: `STEP10 5` baseline (0.5/LED), `STEP10 20` больше цветового разброса по кольцу, `STEP10 50` ещё больше; затем вернуть `STEP10 5`.
8. `HUE 96` должен сразу сдвинуть всю текущую палитру и движение продолжится.
9. Во время активного эффекта отправить несколько STATUS подряд; Serial errors быть не должно.

## Актуальный следующий шаг — AMBIENT R1 (2026-09-26)

1. Открыть `04_Прошивка/nano_ambient_r1/nano_ambient_r1.ino`.
2. Verify + Upload для `Arduino Nano / ATmega328P (Old Bootloader)`.
3. Serial Monitor 115200/Newline: ожидать `ARDU NANO AMBIENT R1 READY`.
4. STATUS: `FW=AMBIENT REV=1 EFFECT=F01 AUTO=OFF PERIOD_S=10 FASTLED_IRQ=ON RX_GUARD_MS=5`.
5. Ручная интеграция: `EFFECT F01` → `EFFECT F02` → `EFFECT F03` → `EFFECT F01`; визуально каждый ранее проверенный эффект должен сохраняться.
6. Проверить `NEXT` три раза и `PREV` три раза; последовательность должна быть циклической.
7. Выполнить `PERIOD 3`, затем `AUTO ON`; наблюдать минимум 12 секунд. Ожидается автоматическая последовательность F01→F02→F03→F01 примерно раз в 3 s.
8. Во время AUTO несколько раз подряд отправлять STATUS; ошибок Serial быть не должно, EFFECT должен меняться.
9. Выполнить `AUTO OFF`; текущий эффект должен остаться выбранным и больше сам не переключаться.
10. Вернуть `PERIOD 10` после теста.

## Актуальный следующий шаг — DS3231 RTC R1 (2026-09-26)

**Сначала аппаратная безопасность:** проверить/удалить резистор `201` зарядной цепи DS3231. С установленной CR2032 не подключать VCC модуля к 5 В, пока удаление `201` не подтверждено.

После выполнения D-017:

1. Подключить `DS3231 VCC→Nano 5V`, `GND→GND`, `SDA→A4`, `SCL→A5`. SQW/32K оставить свободными.
2. Открыть `04_Прошивка/nano_rtc_r1/nano_rtc_r1.ino`.
3. Verify + Upload для Arduino Nano / ATmega328P (Old Bootloader).
4. Serial Monitor 115200/Newline: ожидать `ARDU NANO RTC R1 READY`.
5. Выполнить `STATUS`, `TIME`, подождать 5–10 s, снова `TIME`, затем `TEMP`.
6. Если время неверное или OSF=1: `SET 2026-09-26 HH:MM:SS` с текущим локальным временем, затем `STATUS`.
7. После `SET` норма: `PRESENT=YES OSF=0 LOST_POWER=NO`.
8. Retention-test: полностью снять питание Nano/RTC на 1–2 минуты, затем включить снова. `TIME` должно продолжиться, `LOST_POWER=NO`.

## Актуальный следующий шаг — ALARM R1 (2026-09-26)

1. Оставить DS3231 подключённым как в пройденном RTC R1.
2. Открыть `04_Прошивка/nano_alarm_r1/nano_alarm_r1.ino`.
3. Verify + Upload для Arduino Nano / ATmega328P (Old Bootloader).
4. Startup: `ARDU NANO ALARM R1 READY`.
5. Выполнить `STATUS`. Норма: `RTC_PRESENT=YES RTC_VALID=YES`.
6. Посмотреть `TIME` и выбрать время на 1–2 минуты вперёд.
7. Например, если сейчас 20:45, выполнить `ALARMSET 20:47`, затем `ALARM ON`, затем `STATUS`. Норма: `SAVED=YES ALARM=ON ALARM_TIME=20:47`.
8. До наступления alarm нажать Reset Nano. После startup выполнить `STATUS`: alarm должен остаться ON с тем же временем.
9. Дождаться минуты. Ожидается ровно одна строка `EVENT ALARM_TRIGGER RTC=...`.
10. Повторные STATUS/TIME в эту же минуту не должны генерировать второе событие.
11. Для повторного теста в тот же день использовать `ALARM CLEARLAST`, затем назначить новую минуту.

## Актуальный следующий шаг — DAWN R1 (2026-09-26)

1. Открыть `04_Прошивка/nano_dawn_r1/nano_dawn_r1.ino`.
2. Verify + Upload для Arduino Nano / ATmega328P (Old Bootloader).
3. Startup: `ARDU NANO DAWN R1 READY`; STATUS должен показать RTC valid, сохранённый alarm и defaults dawn.
4. Быстрый визуальный тест: `DAWN TEST 20`. За 20 s кольцо должно плавно пройти от почти нулевой яркости к `MAX_BR=120`, одновременно меняя hue `8→32`. В конце ожидается `EVENT DAWN_COMPLETE`, STATUS → `DAWN=HOLD`.
5. Во время активного рассвета несколько раз отправить STATUS; Serial errors быть не должно.
6. `DAWN STOP` → кольцо полностью гаснет, STATUS → `DAWN=IDLE`.
7. Параметрический test: `MAXBR 64`, `STARTHUE 0`, `ENDHUE 64`, `DAWN TEST 15`; затем вернуть `MAXBR 120`, `STARTHUE 8`, `ENDHUE 32`.
8. Trigger integration: `FADEMIN 1`, `ALARM CLEARLAST`, назначить alarm на следующую минуту, `ALARM ON`.
9. Ожидать `EVENT ALARM_TRIGGER` + `EVENT DAWN_START SOURCE=ALARM DURATION_S=60`, затем через минуту `EVENT DAWN_COMPLETE`.
10. После теста вернуть `FADEMIN 30`.

## Актуальный следующий шаг — DAWN R2 reset recovery (2026-09-26)

1. Открыть `04_Прошивка/nano_dawn_r2/nano_dawn_r2.ino`.
2. Verify + Upload для Arduino Nano / ATmega328P (Old Bootloader).
3. Startup: `ARDU NANO DAWN R2 READY`.
4. Выполнить `DAWN TEST 30`; подождать примерно 10 s и нажать Reset Nano.
5. После reset ожидать `EVENT DAWN_RECOVER PHASE=RUNNING SOURCE=TEST ELAPSED_S=... REMAINING_S=...`. Визуально рассвет продолжает примерно с прежней яркости, не начинает с нуля.
6. Общая длительность должна остаться около исходных 30 s от первого START.
7. После `EVENT DAWN_COMPLETE` нажать Reset: ожидать `DAWN=HOLD` и восстановленный конечный свет.
8. Выполнить `DAWN STOP`, затем ещё один Reset: кольцо остаётся выключенным, `DAWN=IDLE`, recovery event отсутствует.
9. Alarm recovery: `FADEMIN 1`, `ALARM CLEARLAST`, alarm на следующую минуту, `ALARM ON`. После начала рассвета подождать 15–25 s и Reset.
10. Ожидать `EVENT DAWN_RECOVER ... SOURCE=ALARM`; второго `ALARM_TRIGGER` не должно быть. После теста `DAWN STOP`, `FADEMIN 30`.

## Актуальный следующий шаг — NIGHT R1 (2026-09-26)

1. Открыть `04_Прошивка/nano_night_r1/nano_night_r1.ino`.
2. Verify + Upload для Arduino Nano / ATmega328P (Old Bootloader).
3. Startup: `ARDU NANO NIGHT R1 READY`.
4. На чистом NIGHT EEPROM ожидается `POWER=OFF HUE=24 SAT=180 BRIGHTNESS=18 SAVED=NO`.
5. Выполнить: `ON`, `HUE 24`, `SAT 180`, `BRIGHT 18`, `STATUS`. Визуально — постоянное спокойное низкояркое свечение.
6. Параметрический test: `HUE 0 → 96 → 24`; `SAT 255 → 80 → 180`; `BRIGHT 2 → 40 → 18`.
7. Оставить NIGHT ON с defaults и нажать Reset. После startup должно восстановиться `POWER=ON HUE=24 SAT=180 BRIGHTNESS=18 SAVED=YES`, кольцо само загорается.
8. Выполнить `OFF`, Reset. После startup `POWER=OFF SAVED=YES`, кольцо остаётся выключенным.
9. При NIGHT ON несколько раз подряд отправить STATUS; UART errors быть не должно.

## Актуальный следующий шаг — NIGHT R2 schedule (2026-09-26)

1. Открыть `04_Прошивка/nano_night_r2/nano_night_r2.ino`.
2. Verify + Upload для Arduino Nano / ATmega328P (Old Bootloader).
3. Startup: `ARDU NANO NIGHT R2 READY`.
4. `STATUS`, `TIME`: должны быть `RTC_PRESENT=YES RTC_VALID=YES`.
5. Manual regression: `ON`, `HUE 24`, `SAT 180`, `BRIGHT 18`; затем HUE `0→96→24`, SAT `255→80→180`, BRIGHT `2→40→18`.
6. Для schedule test посмотреть TIME и задать окно на ближайшие минуты. Например при 21:50: `OFF`, `SCHEDULESET 21:51 21:53`, `SCHEDULE ON`.
7. До start: POWER=OFF/WINDOW=INACTIVE. В start minute: `EVENT NIGHT_SCHEDULE POWER=ON`. В off minute: `EVENT NIGHT_SCHEDULE POWER=OFF`.
8. При SCHEDULE=ON нажать Reset: schedule/times сохраняются, POWER сразу восстанавливается по RTC.
9. Manual override: при schedule ON выполнить `ON`; норма `SCHEDULE=OFF CONTROL=MANUAL MANUAL_POWER=ON`.
10. После теста выбрать `SCHEDULESET 22:00 07:00` и оставить `SCHEDULE ON` или `SCHEDULE OFF` по желанию владельца.

## Актуальный следующий шаг — M02 R1 VU радуга (2026-09-27)

1. Открыть `04_Прошивка/nano_m02_r1/nano_m02_r1.ino`.
2. Arduino IDE: Board = Arduino Nano; Processor = `ATmega328P (Old Bootloader)`.
3. Verify. Если компиляция прошла — Upload.
4. Serial Monitor: 115200 baud, Newline.
5. Startup должен содержать `ARDU NANO M02 R1 READY` и `STATUS FW=M02 REV=1`.
6. Отправить `ADC`; `AVG` должен быть в 120..400 и `DC_OK=YES`.
7. В тишине выполнить `CAL`; ожидается `CAL DC=... QUIET_MAX=... LOW_PASS=...`, затем `CAL=YES`.
8. Выполнить базовый visual test с `BACKGROUND 0`, `BRIGHT 64`, `SMOOTH 30`, `RAINSTEP10 50`, `ON`.
9. Проверить скорость `RAINSTEP10 5 → 100 → 50`.
10. Проверить сглаживание `SMOOTH 10 → 80 → 30`.
11. При активной ленте выполнить быстрый пакет `STATUS/AUDIO/STATUS/AUDIO/STATUS`; повреждения UART быть не должно.
12. Проверить `OFF` и `ON`.
13. Полный критерий: `04_Прошивка/M02_R1_TEST.md`.
14. M02 hardware PASS завершён.

## После M02 — L01 и хлопковый выключатель

Это не меняет текущий непосредственный шаг M02.

После hardware PASS M02:
1. отдельный L01 R1: белый свет, яркость, ON/OFF, лимит тока;
2. затем clap diagnostic на MAX9814 и подбор устойчивого распознавания без ложных срабатываний на музыку/речь;
3. подтвердить cold power-on → L01 ON в общей state machine;
4. только после этого собирать единую полную Nano-прошивку.

Требования: `04_Прошивка/LIGHT_CLAP_REQUIREMENTS.md`.

## M02 R1 — после успешного Upload (2026-09-27)

1. Открыть Serial Monitor на 115200 baud; окончание строки = Newline.
2. После reset/startup найти `ARDU NANO M02 R1 READY` и строку STATUS.
3. Отправить `ADC`.
4. Затем отправить `STATUS`.
5. Норма для перехода к CAL: `ADC AVG=120..400`, MIN не около 0, MAX не около 1023, STATUS `DC_OK=YES`.
6. Если gate пройден — следующим шагом выполнить `CAL` в тишине.

## Актуальный следующий шаг — L01 R1 обычный свет (2026-09-27)

1. Открыть `04_Прошивка/nano_l01_r1/nano_l01_r1.ino`.
2. Arduino Nano / `ATmega328P (Old Bootloader)`.
3. Verify + Upload.
4. Serial Monitor: 115200 / Newline.
5. Startup: `ARDU NANO L01 R1 READY`.
6. Кольцо после startup должно автоматически включиться постоянным белым.
7. Выполнить полный тест `04_Прошивка/L01_R1_TEST.md`.
8. После hardware PASS L01 перейти к отдельному clap diagnostic MAX9814.

## Актуальный следующий шаг — L01 R2 Kelvin/RGB + persistence (2026-09-27)

L01 R1 закрыт полностью.

1. Открыть `04_Прошивка/nano_l01_r2/nano_l01_r2.ino`.
2. Verify + Upload для Arduino Nano / ATmega328P (Old Bootloader).
3. Проверить presets 2700/4000/6000.
4. Проверить произвольный Kelvin 1800..6500.
5. Проверить произвольные RGB-цвета.
6. Проверить BRIGHT.
7. `PRESET 2700` + нужный `BRIGHT` + `SAVE`, затем Reset/полный power cycle: профиль должен восстановиться.
8. Отдельно сохранить произвольный RGB и подтвердить restore.
9. Полный критерий: `04_Прошивка/L01_R2_TEST.md`.
10. После hardware PASS L01 R2 перейти к clap diagnostic.

## Актуальный следующий шаг — L01 R3 / 44 LED (2026-09-27)

L01 R2 полностью пройден.

1. Открыть `04_Прошивка/nano_l01_r3/nano_l01_r3.ino`.
2. Verify + Upload.
3. STATUS должен показать `FW=L01 REV=3` и `LEDS=44`.
4. Проверить, что физически работают все 44 LED.
5. `PRESET 2700` должен дать `RGB=255,170,87` и выглядеть как прежний R2 `KELVIN 2200`.
6. Проверить 4000/6000 и короткий RGB regression.
7. `PRESET 2700`, `BRIGHT 64`, `SAVE` → Reset → полный power cycle; профиль должен восстановиться.
8. Полный критерий: `04_Прошивка/L01_R3_TEST.md`.
9. После PASS L01 R3 перейти к clap diagnostic; перед общей сборкой обязательно выполнить 44-LED migration музыкальных режимов.

## Актуальный следующий шаг — CLAP DIAG R1 (2026-09-27)

L01 R3 закрыт полностью. Старые 43-LED скетчи не менять.

1. Открыть `04_Прошивка/nano_clap_diag_r1/nano_clap_diag_r1.ino`.
2. Verify + Upload для Arduino Nano / ATmega328P (Old Bootloader).
3. Serial Monitor: 115200 / Newline.
4. Проверить `ADC`, затем `CALCLAP`.
5. Сделать 10 одиночных хлопков и снять `STATS`.
6. Сделать 5 двойных хлопков и сохранить несколько `GAP_MS`.
7. 30 секунд речи → `STATS`.
8. 30 секунд музыки → `STATS`.
9. Проверить бытовые импульсные звуки.
10. При необходимости подобрать `THRESH`.
11. Полный критерий: `04_Прошивка/CLAP_DIAG_R1_TEST.md`.
12. Только по фактическим данным выбрать single/double clap и final detector.

## Актуальный следующий шаг — CLAP DIAG R2 (2026-09-27)

R1 считать диагностически недостаточным: mouse click ловится, хлопок не ловится.

1. Открыть `04_Прошивка/nano_clap_diag_r2/nano_clap_diag_r2.ino`.
2. Verify + Upload.
3. Выполнить `ADC`, `CALCLAP`, `STATUS`.
4. `CAPTURE` тишины.
5. `CAPTURE` одного mouse click.
6. Три отдельных `CAPTURE` обычного хлопка.
7. `CAPTURE` речи.
8. `CAPTURE` музыки.
9. Сравнить MAX_P2P / MAX_DEV / MAX_AVG_SHIFT.
10. Только после измерений выбрать final threshold и single/double-clap logic.
11. Полный тест: `04_Прошивка/CLAP_DIAG_R2_TEST.md`.

## Актуальный следующий шаг — CLAP DIAG R3 (2026-09-27)

1. Upload `04_Прошивка/nano_clap_diag_r3/nano_clap_diag_r3.ino`.
2. Выполнить `ADC`, затем `CALCLAP`.
3. После CALCLAP дождаться `EVENT ARMED`.
4. CLEAR → EVENT ARMED → 5 одиночных хлопков → STATS.
5. CLEAR → EVENT ARMED → 30 s тишины → STATS.
6. Аналогично 30 s речи и 30 s музыки.
7. CLEAR → EVENT ARMED → 5 double-clap pairs; сохранить GAP_MS.
8. Полный критерий: `04_Прошивка/CLAP_DIAG_R3_TEST.md`.

## Актуальный следующий шаг — CLAP GYVER R1 (2026-09-27)

Предыдущий P2P/DEV path не использовать как основной.

1. Открыть `04_Прошивка/nano_clap_gyver_r1/nano_clap_gyver_r1.ino`.
2. Verify + Upload.
3. `ADC`, `STATUS`.
4. С defaults `TRSH=250 TIMEOUT=500` проверить 5 одиночных хлопков.
5. Проверить 5 double-clap pairs.
6. Проверить 10 одиночных mouse clicks: DOUBLE_CLAP быть не должно.
7. 30 s речи и 30 s музыки: оценить прежде всего DOUBLE_CLAP.
8. Если clap вообще не ловится: `TRSH 200`, затем при необходимости `TRSH 150`; timeout пока оставить 500.
9. Полный критерий: `04_Прошивка/CLAP_GYVER_R1_TEST.md`.

## Актуальный следующий шаг — CLAP GYVER R2 (2026-09-27)

1. Upload `04_Прошивка/nano_clap_gyver_r2/nano_clap_gyver_r2.ino`.
2. Дождаться `EVENT CLAP_READY`.
3. Выполнить `ADC`, `STATUS`; DC_OK должен быть YES.
4. `CLEAR` → CLAP_READY → 5 одиночных хлопков при TRSH=150 → STATS.
5. Если clap не ловится: TRACE ON → 3 хлопка → TRACE OFF; затем только при необходимости `TRSH 100`.
6. Когда single clap ловится — 5 double-clap pairs.
7. Проверить mouse clicks / speech / music по DOUBLE_EVENTS.
8. Полный критерий: `04_Прошивка/CLAP_GYVER_R2_TEST.md`.

## Актуальный следующий шаг — CLAP GYVER R3 CAL (2026-09-27)

1. Upload `04_Прошивка/nano_clap_gyver_r3_cal/nano_clap_gyver_r3_cal.ino`.
2. Для трёх детей выполнить `CLAPCAL START 9`.
3. После quiet baseline сделать по 3 successful `CLAPCAL SAMPLE` каждым пользователем.
4. `CLAPCAL FINISH` — получить suggested threshold.
5. Не сохранять сразу: проверить каждым ребёнком несколько double-clap.
6. Проверить тишину/речь/музыку на false DOUBLE_CLAP.
7. Если результат хороший — `CLAPCAL SAVE`.
8. Reset/power cycle → STATUS должен восстановить saved threshold.
9. Полный тест: `04_Прошивка/CLAP_GYVER_R3_CAL_TEST.md`.

## Актуальный следующий шаг — FW-10 CORE R1 (2026-09-27)

1. Открыть `04_Прошивка/nano_fw10_core_r1/nano_fw10_core_r1.ino`.
2. Verify для Arduino Nano / ATmega328P (Old Bootloader).
3. Если Verify проходит — Upload.
4. Startup ожидается `ARDU NANO FW10 CORE R1 READY`.
5. Выполнить полный `04_Прошивка/FW10_CORE_R1_TEST.md`.
6. До pass CORE R1 не подключать второе D7-кольцо.
7. После pass CORE R1 — отдельный CORE R2 two-ring/power layer.

## Актуальный следующий шаг — ESP8266 HTTP BRIDGE R1 (2026-09-27)

Повторные ручные Dawn/Alarm tests отложены до Android app regression.

1. Открыть `05_WiFi_и_приложение/esp8266_http_bridge_r1/esp8266_http_bridge_r1.ino`.
2. Создать рядом локальный `wifi_secrets.h` по образцу `wifi_secrets.example.h`; вписать SSID/password домашней Wi-Fi.
3. Compile для ранее рабочей конфигурации ESP8266MOD/4MB.
4. Прошить ESP ранее подтверждённым способом.
5. После normal boot соединить рабочий UART ESP↔Nano и общий GND.
6. Минимально проверить:
   - `GET /api/ping`;
   - `GET /api/status`;
   - `POST /api/dev/nano` body=`PING` → Nano `PONG`.
7. Не повторять Dawn/Alarm/Night manual regression на этом этапе.
8. После transport smoke-pass сразу создавать Android Studio/Kotlin app R1.

## Актуальный следующий шаг — Android Studio/Kotlin app R1 (2026-09-29)

Минимальный transport smoke-pass закрыт:
- ESP8266 Wi-Fi/HTTP работает;
- `GET /api/status` получает ответ FW10 CORE R1;
- raw `PING` получает `PONG`;
- `SET ...` пишет DS3231;
- `GET /api/time` читает валидное RTC-время.

Дальше:
1. Создать native Android Studio/Kotlin app R1.
2. Первый экран/слой: подключение к ARDU, `/api/ping`, `/api/status`, `/api/time`.
3. Добавить обязательный Developer Mode с raw `POST /api/dev/nano`.
4. После минимального app transport pass перейти к L01 controls и выполнять сквозной regression через приложение по D-071.

## Актуальный следующий шаг — Android app R1 physical transport pass (2026-09-29)

Исходный проект уже создан в `05_WiFi_и_приложение/android_app_r1/`.

1. **Gradle Sync — ПРОЙДЕН.**
2. **Build/install/launch на физическом телефоне — ПРОЙДЕН.**
3. **`/api/ping` — ПРОЙДЕН:** основной экран показал `Онлайн • HTTP_BRIDGE_R1`.
4. **`/api/status` — ПРОЙДЕН:** `FW=FW10_CORE`, `REV=1`, `LEDS=44`, `RTC_VALID=YES` подтверждены на телефоне.
5. **`/api/time` — ПРОЙДЕН:** время DS3231 увеличивается после обновления; `UPTIME_MS` Nano также растёт.
6. Открыть Developer Mode: `PING` → `PONG`; затем несколько безопасных STATUS-команд подряд.
7. После transport PASS зафиксировать результат и переходить к пользовательскому экрану L01 + сквозному regression по D-071.

Полный чек-лист: `05_WiFi_и_приложение/ANDROID_APP_R1_TEST.md`.

## Актуальный следующий шаг — HTTP_BRIDGE_R2 + L01 ON/OFF (2026-09-30)

Минимальный Android transport R1 полностью ПРОЙДЕН, включая Developer `PING→PONG`.

Код следующего слоя уже в репозитории:
- `05_WiFi_и_приложение/esp8266_http_bridge_r2/esp8266_http_bridge_r2.ino`;
- `05_WiFi_и_приложение/ESP8266_HTTP_BRIDGE_R2_TEST.md`;
- текущий Android project расширен L01 status + ON/OFF.

Следующий физический gate:
1. `git pull` локального `C:\ARDU`.
2. В каталоге `esp8266_http_bridge_r2` создать `wifi_secrets.h` по example и вписать те же Wi-Fi credentials.
3. Compile R2 для той же ESP8266 конфигурации, что прошла R1.
4. После успешного compile — upload R2 на физический ESP и normal boot.
5. Запустить обновлённое Android-приложение: верх должен показать `Онлайн • HTTP_BRIDGE_R2`.
6. Блок `Обычный свет L01` должен показать фактический профиль.
7. `Включить` → кольцо D6 включается, STATUS `MODE=L01`.
8. `Выключить` → кольцо гаснет, STATUS `MODE=OFF`.
9. Повторить ON/OFF несколько раз; затем Developer `PING→PONG` и STATUS/TIME regression.
10. После PASS перейти к brightness + Kelvin presets 2700/4000/6000.

До pass этого слоя не добавлять RGB, sliders, D7, Ambient или Music.

## Актуальный следующий шаг — L01 через текущий HTTP_BRIDGE_R1 без ESP reflash (2026-09-30)

**Предыдущий план немедленного compile/upload HTTP_BRIDGE_R2 отменён D-074. ESP сейчас не трогать.**

1. Выполнить `git pull` в `C:\ARDU`.
2. Android Studio: открыть текущий `android_app_r1`, Sync Project with Gradle Files.
3. Не прошивать ESP и не менять спаянный UART/питание.
4. Запустить обновлённое приложение на телефоне.
5. Верх должен по-прежнему показать `Онлайн • HTTP_BRIDGE_R1`.
6. Блок `Обычный свет L01` должен показать фактический profile, прочитанный из Nano.
7. При исходном `MODE=OFF`: нажать `Включить` → кольцо D6 загорается, STATUS становится `MODE=L01`.
8. Нажать `Выключить` → кольцо гаснет, STATUS становится `MODE=OFF`.
9. Повторить ON/OFF несколько раз; `UPTIME_MS` должен расти без reset.
10. Закрыть/открыть приложение и убедиться, что L01 state снова читается из Nano.
11. Developer `PING→PONG`, STATUS и TIME должны сохраниться.
12. После PASS перейти к brightness + Kelvin presets 2700/4000/6000 тем же app-side compatibility способом.

`HTTP_BRIDGE_R2` физически прошивать только позже отдельным пакетным этапом.

## Актуальный следующий шаг — HTTP_BRIDGE_R4 first wired flash + OTA proof (2026-09-30)

1. `git pull`.
2. Открыть `05_WiFi_и_приложение/esp8266_http_bridge_r4/esp8266_http_bridge_r4.ino`.
3. Вручную вписать реальные `WIFI_SSID`, `WIFI_PASSWORD`, `OTA_PASSWORD` в локальный скетч. Не коммитить секреты.
4. Verify R4 для Generic ESP8266 Module / 4 MB.
5. Только после compile PASS выполнить один wired upload по уже подтверждённой programmer procedure.
6. Вернуть normal boot + рабочий UART.
7. `/api/ping` должен показать `HTTP_BRIDGE_R4`, `wifi_connected=true`, `ota_ready=true`, `ota_hostname=ardu`, `ota_port=8266`.
8. Проверить STATUS/TIME/Developer PING regression.
9. Arduino IDE → Tools → Port: должен появиться network port `ardu`.
10. Следующую минимальную ESP revision загрузить через этот network port с OTA password — без изменения проводки.
11. После OTA proof считать wired programmer path recovery-only и продолжать app/L01 integration.

Полный тест: `05_WiFi_и_приложение/ESP8266_HTTP_BRIDGE_R4_OTA_TEST.md`.

## Актуальный следующий шаг — доказать OTA upload R4 (2026-09-30)

Текущее подтверждённое состояние:
- R4 физически прошит;
- Wi-Fi подключён;
- `192.168.0.4/api/ping` работает;
- `HTTP_BRIDGE_R4`;
- `ota_ready=true`;
- OTA hostname `ardu`, port `8266`;
- Windows `ardu.local` не резолвит, но это не блокирует проверку OTA через network port/IP.

Дальше:
1. В Arduino IDE проверить Tools → Port на наличие сетевого ESP/ardu.
2. Если сетевой port найден — выполнить минимальный OTA upload без изменения проводки.
3. После OTA reboot повторить `/api/ping`.
4. Проверить `/api/status`, `/api/time`, Developer `PING→PONG`.
5. После OTA PASS вернуться к Android L01 integration.

## Актуальный следующий шаг — первый реальный OTA upload HTTP_BRIDGE_R5 (2026-09-30)

Подтверждено:
- физический ESP работает на `HTTP_BRIDGE_R4`;
- `/api/ping` по `192.168.0.4` работает;
- `ota_ready=true`;
- Arduino IDE видит сетевой порт `ardu 192.168.0.4`.

Следующий gate:
1. `git pull`.
2. Открыть `05_WiFi_и_приложение/esp8266_http_bridge_r5/esp8266_http_bridge_r5.ino`.
3. В локальной R5 вручную вписать ТЕ ЖЕ `WIFI_SSID`, `WIFI_PASSWORD`, `OTA_PASSWORD`, которые сейчас использует рабочий R4. Секреты не коммитить.
4. Arduino IDE: Board = Generic ESP8266 Module, flash = фактические 4 MB.
5. Выполнить Verify.
6. Tools → Port → выбрать сетевой `ardu 192.168.0.4`.
7. Нажать Upload и при запросе ввести текущий `OTA_PASSWORD` R4.
8. Проводку, GPIO0, RST и Nano RESET для этого upload НЕ менять.
9. После автоматического reboot проверить `curl.exe http://192.168.0.4/api/ping`; обязательный признак нового образа — `"fw":"HTTP_BRIDGE_R5"`.
10. Затем проверить `/api/status`, `/api/time` и Developer `PING→PONG`.
11. После PASS зафиксировать OTA как основной ESP update path и вернуть фокус на Android L01: ON/OFF → brightness → Kelvin 2700/4000/6000 → persistence.

## Актуальный следующий шаг — post-OTA Nano transport regression (2026-09-30)

OTA upload R5 уже ПРОЙДЕН:
- network port: `ardu 192.168.0.4`;
- после reboot `/api/ping` возвращает `fw=HTTP_BRIDGE_R5`;
- Wi-Fi и OTA service снова поднялись.

Сейчас выполнить только три проверки, не меняя проводку:
1. `curl.exe http://192.168.0.4/api/status`
2. `curl.exe http://192.168.0.4/api/time`
3. `curl.exe -X POST http://192.168.0.4/api/dev/nano -H "Content-Type: text/plain" --data-binary "PING"`

PASS:
- `/api/status`: `ok=true`, Nano отвечает `FW=FW10_CORE REV=1`;
- `/api/time`: `ok=true`, Nano возвращает валидный `TIME ...`;
- Developer PING: `ok=true`, поле `nano` = `PONG`.

После этих трёх PASS:
- wired programmer path = recovery-only;
- ESP updates по умолчанию = OTA;
- следующий функциональный слой = Android L01 ON/OFF, затем brightness, Kelvin 2700/4000/6000, persistence.

## Актуальный следующий шаг — Android L01 на HTTP_BRIDGE_R5 (2026-09-30)

OTA gate полностью ПРОЙДЕН. Физический ESP теперь `HTTP_BRIDGE_R5`; wired flashing = recovery-only.

Следующий слой — только L01 ON/OFF:
1. использовать semantic `GET /api/light/status`;
2. использовать semantic `POST /api/light/settings {"enabled":true|false}`;
3. Nano остаётся источником истины;
4. после команды приложение перечитывает фактическое L01 state;
5. проверить на телефоне: ON → D6 кольцо включается и Nano `MODE=L01`; OFF → кольцо гаснет и Nano `MODE=OFF`;
6. повторить несколько раз и проверить reconnect/state reread.

До физического PASS ON/OFF не добавлять brightness/Kelvin/RGB/persistence.

После ON/OFF PASS:
- brightness;
- Kelvin presets 2700/4000/6000;
- persistence.

## Актуальный следующий шаг — Android semantic L01 read-only gate (2026-09-30)

Подтверждено напрямую на HTTP_BRIDGE_R5:
`GET /api/light/status` → `enabled=false`, `2700 K`, `RGB 255,170,87`, brightness `64`, saved profile valid.

Android transport обновлён до `0.3-l01-semantic-r1`.

Сейчас:
1. `git pull`;
2. Android Studio → Sync;
3. Run на физическом телефоне;
4. убедиться, что верх показывает `Онлайн • HTTP_BRIDGE_R5`;
5. блок L01 должен показать `Выключен • 2700 K • яркость 64`.

Это read-only gate. Если в Nano всё ещё активен DAWN, пока не нажимать L01 ON/OFF.

После read-only PASS следующим отдельным шагом проверить L01 ON/OFF через semantic `POST /api/light/settings`.

## Актуальный следующий шаг — пакетный Android L01 ON/OFF regression (2026-09-30)

Read-only Android semantic gate ПРОЙДЕН.

В одном тестовом цикле:
1. Нажать `Включить`; визуально проверить D6 и нажать `Обновить`.
2. Убедиться: L01 = `Включён`, общий STATUS = `MODE=L01`.
3. Нажать `Выключить`; нажать `Обновить`.
4. Убедиться: L01 = `Выключен`, общий STATUS = `MODE=OFF`.
5. Повторить ON→OFF ещё два раза.
6. Оставить OFF, полностью закрыть приложение, открыть снова.
7. Убедиться, что после reconnect приложение снова читает `Выключен • 2700 K • яркость 64`.
8. Developer Mode → `PING` → `PONG`.

Если перед первым нажатием STATUS всё ещё `MODE=DAWN`, `Включить` намеренно переключит верхний режим с DAWN на L01. Это допустимо только если текущий Dawn уже можно прервать.

После PASS переходить к brightness.

## Актуальный следующий шаг — OTA R6 + brightness/Kelvin пакет (2026-09-30)

Предыдущий Android semantic ON/OFF gate полностью ПРОЙДЕН.

Подготовлено:
- ESP: `05_WiFi_и_приложение/esp8266_http_bridge_r6/esp8266_http_bridge_r6.ino`;
- test plan: `05_WiFi_и_приложение/ESP8266_HTTP_BRIDGE_R6_TEST.md`;
- Android: `0.4-l01-bright-kelvin-r1`;
- UI: brightness slider + presets 2700/4000/6000.

Один пакетный gate:
1. `git pull`.
2. В локальную R6 скопировать те же Wi-Fi/OTA credentials из рабочей R5.
3. Verify R6.
4. Выбрать network port `ardu 192.168.0.4` и выполнить OTA Upload; проводку не менять.
5. `GET /api/ping` должен вернуть `HTTP_BRIDGE_R6`.
6. Direct semantic smoke:
   - POST `{"brightness":128}`;
   - POST `{"kelvin":4000}`;
   - GET `/api/light/status` → brightness 128 / kelvin 4000.
7. Android Studio: Sync/Run обновлённого app.
8. Включить L01 и одним циклом проверить brightness примерно 32 → 128 → 220.
9. Проверить presets 2700 → 4000 → 6000.
10. Вернуть 2700 K / brightness 64.
11. Refresh, ON→OFF→ON, Developer PING→PONG.

До PASS этого пакета не добавлять RGB, произвольный Kelvin slider или persistence.

## Актуальный следующий шаг — R7 complete L01 profile одним пакетом (2026-09-30)

R6 OTA + Android brightness/Kelvin физически работают.

Подготовлено:
- `esp8266_http_bridge_r7/esp8266_http_bridge_r7.ino`;
- `ESP8266_HTTP_BRIDGE_R7_TEST.md`;
- Android `0.5-l01-profile-r1`.

Один крупный gate:
1. `git pull`.
2. Локально перенести актуальные Wi-Fi/OTA credentials в R7.
3. Verify + OTA Upload через `ardu 192.168.0.4`.
4. После reboot подтвердить `HTTP_BRIDGE_R7`.
5. JSON smoke выполнять через `Invoke-RestMethod`, не через проблемный `curl.exe --data-binary`.
6. Android: проверить arbitrary Kelvin 2200→3500→5200.
7. RGB: красный→зелёный→синий.
8. Установить Kelvin 4000 / brightness 100 и сохранить startup profile.
9. Полный power-cycle ARDU → должен стартовать L01 4000 K / 100.
10. Вернуть baseline 2700 K / 64 и снова сохранить.
11. OFF→ON, Refresh, Developer PING→PONG.

Если весь пакет PASS — L01 profile/persistence integration закрывается целиком; дальше можно переходить к следующему функциональному разделу, не делая дополнительных микротестов L01.

## Актуальный следующий шаг — CORE R2 CLAPCAL compile-budget gate (2026-09-30)

R7 complete L01 profile полностью ПРОЙДЕН.

Следующая крупная функция L01 — clap control + family calibration.

ФАКТ:
- FW10 CORE R1 уже содержит работающий double-clap detector;
- default `TRSH=70 / TIMEOUT=500`;
- threshold/timeout уже имеют EEPROM block;
- app-ready family calibration существует в `nano_clap_gyver_r3_cal`, но ещё не интегрирована в CORE;
- CORE R1 compile size ранее был `26014/30720` flash (84%) и `1316/2048` SRAM globals (64%).

Поэтому порядок:
1. создать новую Nano revision `FW10 CORE R2`, не переписывая R1;
2. перенести CLAPCAL без второго полноценного runtime detector там, где можно переиспользовать существующие классы;
3. сохранить EEPROM layout совместимым;
4. сначала Verify и снять flash/SRAM report;
5. если не помещается — НЕ загружать на Nano, сначала оптимизировать;
6. только после compile-budget PASS готовить ESP/Android semantic clap wizard;
7. затем одним физическим блоком проверить clap enable/disable + calibration + persistence.

До compile-budget PASS Nano R1 на железе не трогать.

## CORE R2 source готов — выполнить Verify (2026-09-30)

Файлы:
- `04_Прошивка/nano_fw10_core_r2/nano_fw10_core_r2.ino`;
- `04_Прошивка/FW10_CORE_R2_CLAPCAL_TEST.md`.

Сейчас только:
1. `git pull`;
2. открыть `nano_fw10_core_r2.ino`;
3. Board = Arduino Nano;
4. Processor = ATmega328P (Old Bootloader);
5. нажать Verify;
6. прислать compiler/memory report целиком.

НЕ нажимать Upload до анализа flash/SRAM.

После compile-budget PASS следующий шаг будет крупным: Nano R2 upload + startup smoke + весь family calibration, а затем ESP/Android wizard.

## Актуальный следующий шаг — оптимизировать CORE R2 после 96% flash (2026-09-30)

Первый Verify:
- flash `29788/30720` = 96%, free 932;
- globals `1445/2048` = 70%, free 603.

Решение:
1. Nano пока НЕ прошивать.
2. Сохранить весь функционал CLAPCAL и EEPROM compatibility.
3. Уменьшать прежде всего flash:
   - убрать/сократить диагностические строки и HELP;
   - не дублировать calibration-only logic;
   - по возможности переиспользовать runtime detector;
   - не увеличивать globals без необходимости.
4. Повторить Verify новой ревизии.
5. Только после приемлемого запаса переходить к hardware calibration batch.

Причина: общая Nano-прошивка ещё должна принять Ambient/Music; 932 bytes остатка делает это нереалистичным.

## Актуальный следующий шаг — Verify CORE R3 compact CLAPCAL (2026-09-30)

R2 не загружался. Создан R3:
- `04_Прошивка/nano_fw10_core_r3/nano_fw10_core_r3.ino`;
- `04_Прошивка/FW10_CORE_R3_CLAPCAL_TEST.md`.

Сейчас:
1. `git pull`;
2. открыть R3;
3. Arduino Nano / ATmega328P (Old Bootloader);
4. Verify;
5. прислать две строки memory report.

Upload пока не выполнять.

Сравнение:
- CORE R1: 26014 flash / 1316 globals;
- CORE R2: 29788 flash / 1445 globals;
- цель R3 — вернуть заметный запас относительно R2.

## Актуальный следующий шаг — CORE R3 большой hardware CLAPCAL block (2026-09-30)

Compile R3 принят для аппаратного теста:
- flash 27822/30720;
- globals 1392/2048.

Выполнить одним блоком:
1. временно удержать ESP в Reset, чтобы его TX не мешал USB-UART Nano;
2. Upload CORE R3 в Nano;
3. не отпуская ESP Reset, открыть Serial Monitor 115200;
4. startup/STATUS + CLAP STATUS;
5. `LIGHT CLAP OFF` → double clap не переключает свет;
6. `LIGHT CLAP ON` → double clap переключает L01/OFF;
7. `CLAPCAL START 9`;
8. собрать 9 успешных `CLAPCAL SAMPLE` (для семьи — по 3 пары на пользователя);
9. `CLAPCAL FINISH`, проверить suggested threshold несколькими double-clap;
10. `CLAPCAL SAVE`;
11. снять ESP Reset, выполнить полный power-cycle ARDU;
12. через HTTP проверить `STATUS`, `CLAP STATUS`, Developer PING; новый threshold должен сохраниться;
13. проверить double-clap после power-cycle.

Если весь пакет PASS — Nano clap runtime+calibration считаются закрытыми, затем одним следующим слоем делается semantic ESP/Android calibration wizard.

## Актуальный следующий шаг — повторить Nano R3 upload через manual reset (2026-09-30)

Первая попытка: resp=0x00, R3 не записан.

Без разборки стенда:
1. ESP RST → GND оставить на время Nano upload.
2. Проверить: Nano RESET НЕ соединён с GND.
3. Закрыть Serial Monitor/Serial Plotter и другие программы, использующие COM3.
4. Board = Arduino Nano; Processor = ATmega328P (Old Bootloader); Port = COM3.
5. Нажать Upload.
6. Когда IDE перейдёт от compile к Uploading..., один раз кратко нажать и отпустить Reset на Nano (либо кратко Nano RESET→GND и отпустить).
7. Если снова resp=0x00: проверить, что COM3 действительно Nano (USB unplug → COM3 исчезает; replug → появляется), затем повторить.
8. Только если manual reset не помогает — временно снять только провод ESP TX0/GPIO1 → Nano D0/RX; остальные линии не трогать; ESP всё равно держать Reset LOW.

После успешного Upload: ESP Reset пока оставить LOW и перейти к Serial startup/CLAPCAL batch.

## Актуальный следующий шаг — full Nano v1 release build (2026-10-01)

Предыдущий шаг «повторить Upload CORE R3» отменён решением владельца о финализации.

Не загружать CORE R3 отдельно.

Сейчас:
1. открыть `FINALIZATION_PLAN.md`;
2. собрать новый полный release source Nano v1 из проверенных подсистем;
3. использовать один 44-LED framebuffer и mirrored D6/D7 outputs;
4. добавить CLAPCAL, Ambient, Music M01/M02/M03/M04/M05/M08/M09;
5. закрыть persistence/settings/current-limit/UART v1;
6. оптимизировать flash/SRAM;
7. выполнить только Verify/compile до полного scope;
8. после release-budget PASS временно снять ESP TX→Nano D0 и сделать единственный финальный Nano Upload;
9. затем полный ESP v1 OTA;
10. после firmware freeze — Android functionality/design и финальный монтаж.

## Актуальный следующий шаг — final ESP v1 before release upload session (2026-10-01)

Full Nano v1 уже помещается и проходит CI:
- flash 28090/30720 = 91%;
- globals 1070/2048 = 52%;
- free SRAM 978 bytes.

Nano пока НЕ загружать.

Дальше:
1. считать compact numeric UART v1 Nano замороженным;
2. собрать полный ESP8266 v1 semantic HTTP API под этот UART;
3. Verify/compile ESP v1;
4. выполнить финальный source/API review Nano+ESP;
5. только после двух compile PASS провести один обслуживаемый hardware session:
   - временно разорвать ESP TX→Nano D0;
   - финально загрузить Nano v1;
   - восстановить UART;
   - OTA-загрузить ESP v1;
   - выполнить один общий acceptance smoke/regression;
6. затем firmware freeze → Android app completion/design.

## Актуальный следующий шаг — final release upload + acceptance (2026-10-01)

Обе прошивки source/compile ready.

НЕ добавлять новые firmware features.

1. Подготовить локальный `esp8266_ardu_v1`: перенести рабочие WIFI_SSID/WIFI_PASSWORD/OTA_PASSWORD из локального R7, секреты не коммитить.
2. Выполнить `RELEASE_V1_UPLOAD_ACCEPTANCE.md`.
3. Для Nano upload временно разорвать ESP TX→Nano D0/RX.
4. Загрузить `nano_ardu_v1` один раз.
5. Вернуть UART.
6. Сразу OTA-загрузить `esp8266_ardu_v1`.
7. Выполнить HTTP/UART/режимный acceptance.
8. При PASS — firmware freeze и переход к Android app.

## Актуальный blocker/next gate — replacement Nano + end-to-end acceptance (2026-10-02)

Текущая Nano не принимает final upload; replacement Nano уже заказана. Root cause старой платы не подтверждён.

Пока плата в пути Android functionality доведена до `0.9-functional-v1-rc1` и CI PASS.

Когда новая Nano будет на руках:
1. проверить новую Nano простым upload/boot gate;
2. final upload `nano_ardu_v1`;
3. direct UART smoke 1/2/4/3;
4. вернуть ESP TX→Nano RX;
5. final OTA `esp8266_ardu_v1`;
6. выполнить firmware acceptance;
7. установить Android functional RC и выполнить `ANDROID_V1_FUNCTIONAL_TEST.md`;
8. при PASS перейти к design/UX, второму кольцу и power/ceiling stages.

## Software visual gate while replacement Nano is pending — 2026-10-03

Android `0.14-ios-homehub-focus-rc1` implements the owner-approved Home Hub + Focus Dial direction and passes CI.

Optional immediate owner check before hardware arrives:
1. `git pull`;
2. start `mock_esp_v1.py`;
3. Run Android;
4. review Light Home Hub overview;
5. open ordinary-light device → review Focus Dial;
6. inspect Music / Ambient / Night / Alarm contextual heroes.

Only visual/release-blocker corrections should be made from this point. Physical next gate remains the replacement Nano final-upload sequence.

## Current software next step — owner review of premium Light v0.15 (2026-10-03)

1. `git pull`.
2. Start the existing stateful ESP v1 mock.
3. Run Android `0.15-premium-light-rc1`.
4. Inspect:
   - Light Home Hub overview;
   - visual scene tiles;
   - transition to detailed control;
   - Focus Dial appearance and touch;
   - Kelvin/color/clap controls below the dial.
5. If visual direction is accepted, next implementation pass = premium Music / Ambient / Night / Alarm using the same approved language.

Physical hardware gate remains replacement Nano → final Nano upload → ESP OTA → firmware + Android end-to-end acceptance.

## Immediate Android review gate — real assets Light v0.16 (2026-10-03)

1. `git pull`.
2. Start the existing ESP v1 mock.
3. Android Studio → Run.
4. Inspect Light overview:
   - real living-room hero;
   - ARDU/Online/Refresh/Settings over hero;
   - no old separate status rectangle;
   - real Evening/Warm/Day/Cool photo tiles;
   - ordinary-light state overlay.
5. Open ordinary-light control and re-check Focus Dial.
6. If approved, next software implementation = matching real image asset packs for Music / Ambient / Night / Alarm.

Hardware next gate remains replacement Nano → final Nano v1 → ESP v1 OTA → end-to-end acceptance.

## Immediate Android visual check — Light v0.17 (2026-10-03)

After `git pull` and Run:
1. confirm the hero now shows the warm floor lamp on the right;
2. confirm Brightness and Temperature cards are exactly equal;
3. re-check scene photo tiles and Focus Dial.

If PASS, Light visual geometry is considered closed and the next software pass is real-photo asset propagation to Music / Ambient / Night / Alarm.

## Current software visual gate — Android v0.18 contextual photo heroes (2026-10-03)

Light v0.17 owner check: PASS.

1. `git pull`.
2. Android Studio → Run.
3. Open **Музыка** and inspect the real-photo hero crop/indigo-teal atmosphere.
4. Open **Фон** and inspect purple/cyan atmosphere.
5. Open **Ночь** and confirm the darker right-biased room/lamp composition remains readable.
6. Open **Будильник** and confirm the warm dawn composition is readable.
7. Verify cards/sliders below each hero are unchanged and functional against the stateful mock.

Current v0.18 intentionally uses one approved high-resolution photo master with four different crops/grades. If these compositions pass on the phone, the next visual iteration may replace them with four separate optimized generated WebP assets without changing Android/API architecture.

Physical hardware gate remains replacement Nano → final Nano v1 upload → ESP v1 OTA → firmware + Android end-to-end acceptance.

## Immediate Android check — v0.19 Music/header polish (2026-10-03)

1. `git pull`.
2. Android Studio → Run.
3. Open **Музыка**.
4. Confirm the complete second lines are visible in the mode cards: `Градиент`, `Радуга`, `полос`, `полосы`.
5. Confirm ARDU / Online / refresh / settings / current mode / RTC at the top are **not enclosed by one large rounded rectangle**.
6. Quickly switch to **Фон / Ночь / Будильник** and confirm the same frameless top status rule.

If these two visual defects are gone, this polish gate is closed. Physical next gate remains replacement Nano → final Nano v1 upload → ESP v1 OTA → firmware + Android end-to-end acceptance.

## Next implementation — Music v0.20 Home Hub pass (2026-10-04)

Canonical plan: `05_WiFi_и_приложение/MUSIC_V0_20_PLAN.md`.

Implementation order:
1. create dedicated `ardu_music_hero.webp`;
2. integrate Light-like Music Home Hub hero with status/actions inside it;
3. remove large Play/Stop controls;
4. mode card tap = select + start Music; labels without `VU`; equal-height grid;
5. bottom-nav leave from active Music = `mode=off` before/while navigating;
6. fix SmartSliderView edge clipping globally and regress all user tabs;
7. convert bottom navigation to icon-only native vector items;
8. contract tests + debug APK + owner-phone smoke on mock.

No Nano/ESP change is currently required for these behaviors. Firmware source changes are allowed if a real blocker is found, but physical final upload still waits for replacement Nano.

## Immediate Android smoke — v0.20 Music Home Hub (2026-10-04)

1. `git pull`.
2. Start the existing stateful ESP v1 mock.
3. Android Studio → Run.
4. Open **Музыка** and confirm the hero/status/title are one Home Hub block, with no separate player and no Play/Stop row.
5. Confirm all seven mode cards are visible in two rows, equal height, labels: Градиент / Радуга / 5 полос / 3 полосы / Частота / Бегущие / Спектр.
6. Tap several mode cards; each must immediately become active.
7. While Music is active, tap **Свет**, **Фон**, **Ночь**, then **Будильник** in separate checks; Music must go OFF and the target tab must not auto-start its own mode.
8. Open Settings from active Music: Music must remain active until another bottom user tab is chosen.
9. On every user tab move each custom smart slider to minimum and maximum; the thumb must remain fully visible.
10. Confirm bottom navigation shows icons without visible text labels.

If PASS, close Android Music v0.20 visual/function gate and continue with remaining per-tab premium polish or hardware acceptance depending on replacement Nano arrival.

## Immediate Android smoke — v0.20.1 Music visual hotfix (2026-10-04)

1. `git pull`.
2. Android Studio → Run.
3. Open **Музыка** and confirm the main hero is visibly less zoomed and the complete dedicated image is readable.
4. Confirm all seven mode cards show their own colorful visual illustration and remain equal in height.
5. Tap modes and confirm selected mint border/glow follows the active mode.
6. Inspect bottom navigation: all five icons must be visually centered, with no text labels, inside a clearly separate rounded dock.
7. Re-check Music → another bottom tab still stops active Music.
8. Re-check SmartSlider thumbs at min/max if needed.

If PASS, close the Music visual hotfix gate.

## Immediate Android smoke — v0.20.2 Music framing/icon hotfix (2026-10-04)

1. `git pull`.
2. Android Studio → Run.
3. Open **Музыка**.
4. Confirm the dedicated hero photo is shown as a complete landscape image: no enlarged/cropped photo copy should appear above/below or behind it.
5. Confirm the hero block is visibly more compact than v0.20.1 (250dp instead of 330dp).
6. Compare **Градиент** and **Частота**: Градиент must be a smooth multicolor wave; Частота must be a clearly different radio-frequency/beacon symbol with concentric arcs and a center marker.
7. Tap both modes and confirm selected mint state still follows the active mode and each tap starts Music directly.
8. Re-check bottom dock and Music → another bottom tab OFF behavior only if a regression is suspected.

If PASS, close the Music framing/icon visual gate and keep the next physical gate: replacement Nano → final Nano upload → final ESP OTA → firmware acceptance → Android end-to-end acceptance.

## Immediate Android smoke — v0.20.3 approved Music room hero (2026-10-04)

1. `git pull`.
2. Android Studio → Run.
3. Open **Музыка**.
4. Confirm the hero clearly shows the sofa on the left and the compact speaker on the right at the same time.
5. Confirm the right edge of the photo, including the speaker and plant, is not cropped.
6. Confirm no giant close-up speaker remains and the hero reads as a living room.
7. Re-check only obvious regressions: Music mode tiles still work, selected mint state still follows the active mode, and bottom dock remains intact.

If PASS, close the Music hero visual gate. Next physical gate: replacement Nano → final Nano upload → final ESP OTA → firmware acceptance → Android end-to-end acceptance.

## Актуальный следующий шаг — 2026-10-04 после Ambient v0.21

### Software
1. `git pull`.
2. Android Studio → Run.
3. Открыть **Фон**.
4. Проверить Home Hub hero, status/actions внутри hero, три illustrated effect tiles и selected mint state.
5. Быстро проверить ON/OFF, sliders и auto-cycle на отсутствие регрессии.

После visual PASS следующий небольшой design pass — **Ночь**, без изменения API/UART.

### Hardware
Replacement Nano numeric UART уже подтверждён. Следующий физический gate — OTA финального `ARDU_ESP_V1`, затем firmware acceptance и Android end-to-end acceptance.

## Актуальный следующий шаг — 2026-10-04 после v0.22

### Android
1. `git pull`.
2. Android Studio → Run.
3. Проверить **Ночь** и **Будильник** по v0.22 smoke из Android README.
4. Если визуально PASS — normal-tab redesign закрыт; дальше только release-blocker polish.

### Hardware
Final ESP OTA и read-only status/settings gate уже PASS.
Следующее физическое действие: синхронизировать DS3231 через final `/api/time/sync`, затем повторить `/api/time` и `/api/status`. После RTC PASS продолжить release acceptance и Android end-to-end test.

## Актуальный следующий шаг — Android на реальном ARDU

1. На ПК: `git pull`.
2. Android Studio → Run на физическом телефоне.
3. Телефон должен быть в той же домашней Wi-Fi сети, что ESP.
4. В приложении открыть Settings → Подключение.
5. Ввести `192.168.0.4`.
6. Нажать **Сохранить и переподключиться**.
7. Критерий PASS:
   - Online;
   - реальное время RTC;
   - Light показывает фактические 4000 K / brightness 64;
   - текущий top-level mode считывается с Nano.
8. Затем выполнить первый app-side L01 smoke: OFF → ON и проверить физическое кольцо.

PowerShell baseline уже закрыт; возвращаться к нему нужно только для диагностики расхождения app/device.

## Актуальный следующий шаг — v0.23 на реальном телефоне

1. `git pull`.
2. Android Studio → Run.
3. Подключение к ARDU оставлять на `192.168.0.4`.
4. Сравнить пять вкладок с concept screenshots.
5. Проверить только короткий functional regression:
   - Свет: overview brightness + Kelvin;
   - Музыка: один mode tap;
   - Фон: один effect + hue/brightness;
   - Ночь: +/- brightness;
   - Будильник: enable/time.
6. Прислать screenshots/video v0.23.

Rollback: `git switch archive/android-v0.22-homehub-2026-10-04` даёт точный предыдущий UI.

## Дополнительный финальный gate — ARDU-DIRECT / reserve-ready v1

После текущего v0.23 real-phone smoke:
1. В локальной копии ESP source задать отдельный `SOFTAP_PASSWORD` (>=8 символов) вместе с существующими Wi-Fi/OTA credentials.
2. Verify/compile `05_WiFi_и_приложение/esp8266_ardu_v1/esp8266_ardu_v1.ino`.
3. Пока домашний роутер включён: OTA upload → `/api/ping` Station regression.
4. Отключить/сделать недоступным домашний роутер.
5. Подождать fallback startup (cold boot максимум около 15 s; при потере уже работающего Station AP поднимается без нового 15-s boot wait).
6. На телефоне подключиться к защищённой сети `ARDU-DIRECT`.
7. Android app должен найти `192.168.4.1`; проверить `/api/ping`, L01 ON/OFF и один brightness write/readback.
8. Включить роутер обратно и подтвердить возврат ESP в Station.
9. До потолочного монтажа физически установить доступный USB-C PD BACKUP input + 15→5 V reserve path; сам аккумулятор для завершения v1 не требуется.

## Handoff 2026-10-05 — ring profiles + battery-free v1 build

1. Compile/verify updated `nano_ardu_v1`: confirm flash <30720 and safe SRAM margin after second 44-LED buffer.
2. Compile updated `esp8266_ardu_v1`: Station + ARDU-DIRECT + `/api/system/rings`.
3. Android `assembleDebug` / Run: Settings → Rings normal/emergency selectors.
4. Purchase final battery-free v1 power parts per `02_КОМПОНЕНТЫ_BOM.md`.
5. Bench-build final main power path with Mean Well IRM-30-5ST and existing INV-051 automatic relay selector.
6. Wire D8 MAINS_SENSE: MAIN_5V → 1.5 kΩ → D8; D8 → 4.7 kΩ → GND.
7. Build BACKUP path (no battery): HUSB238 set 15 V/3 A → 3 A fuse → Pololu D36V50F5 → relay NC.
8. Connect both 44-LED rings; normal profile tests: BOTH → A → B → BOTH.
9. Test emergency profile by removing MAIN while powering BACKUP from a suitable 15-V PD source; verify automatic profile switch + event + ARDU-DIRECT.
10. Only after voltage-drop/temperature/relay-contact test: ceiling install. Future battery is plug-in accessory and not required for v1 acceptance.

## Актуальный следующий шаг — 2026-10-07 после D-100

Предыдущие разделы про reserve-ready / ring-profile / BACKUP hardware считать **ОТМЕНЁННЫМИ**.

1. `git pull`.
2. Android Studio → Run → закончить v0.23 real-phone visual/function smoke.
3. Verify/compile текущий ESP source с сохранённым `ARDU-DIRECT` fallback.
4. Physical `ARDU-DIRECT` smoke: недоступный роутер → телефон в `ARDU-DIRECT` → app finds `192.168.4.1` → L01 read/write.
5. Для финального железа вернуться к обычному two-ring power gate: Class II 5 V PSU, D6+D7 44+44, current limit 3000 mA до acceptance.
6. Никаких аккумуляторных/backup деталей или аварийного ring-profile теста.

## Актуальный следующий шаг — 2026-10-07 после отката Android

Предыдущие указания тестировать v0.23 считать отменёнными.

1. Если локально сейчас archive branch:
   `git switch main`
2. `git pull`.
3. Android Studio → Run.
4. Убедиться, что внешний вид снова соответствует выбранному v0.22.
5. Проверить Online и короткий L01 smoke на реальном ARDU.
6. Затем выполнить physical ARDU-DIRECT smoke.
7. После network gate — обычный two-ring power acceptance.
8. Не делать новый общий редизайн без отдельного решения владельца.

## Актуальный следующий шаг — 2026-10-07 после repo cleanup

Локальный конфликт credentials больше не является частью архитектуры репозитория.

1. Однократно отбросить старое локальное изменение tracked ESP sketch.
2. Перейти на `main` и получить текущий репозиторий.
3. Android Studio → Run; внешний вид должен остаться выбранным v0.22.
4. Продолжить functional acceptance на реальном устройстве:
   - Light brightness/Kelvin/RGB/profile;
   - clap;
   - Music;
   - Ambient;
   - Night;
   - Alarm/Dawn;
   - events + power-cycle persistence.
5. ARDU-DIRECT тестировать отдельным gate после основного app acceptance.

## Актуальный следующий шаг — v0.22.2 visual emulator pass

1. `git pull`.
2. Android Studio → Pixel emulator → Run.
3. Не прошивать Nano/ESP для этого шага.
4. Визуально пройти:
   - Свет обзор;
   - Свет управление;
   - Музыка;
   - Фон;
   - Ночь;
   - Будильник;
   - Настройки.
5. Владелец перечисляет дефекты; исправлять по одному экрану/малой группе.
6. После visual PASS отдельно выполнить Nano/ESP compile+upload gate для:
   - ARDU-DIRECT;
   - reset defaults;
   - monotonic Ambient speed.

## Актуальный следующий шаг — v0.22.4 heroes + preset design

1. `git pull` → Emulator → Run.
2. Проверить новые hero: Фон / Ночь / Будильник.
3. Затем отдельно утвердить расширенный список Ambient presets и **как физически светится каждый**.
4. Не фиксировать текущие 4 presets как финальные.
5. После согласования preset model — реализовать её малой отдельной итерацией.
6. Firmware upload пока не выполнять.

## Актуальный следующий шаг — 2026-10-08 после решения D-104

- Android версия не менялась: `0.22.5-ambient-hero-hotfix-rc1`.
- Ближайший фактический gate: `git pull` → Android Studio Emulator → Run → проверить исправленную картинку страницы «Фон».
- По D-104 будущая страница «Фон» сохраняет F01, но **не требует F02/F03**.
- Двенадцать пресетов — **идея**, документ `04_Прошивка/AMBIENT_PRESETS_CONCEPT.md`; не реализовывать/не прошивать без отдельного одобрения.
- Старые F02/F03 всё ещё существуют в текущем коде, их удаление требует отдельной миграции и тестирования. Не считать source и железо изменёнными.

## Актуальный следующий шаг — 2026-10-08: visuals PASS, Ambient implementation plan

- Владелец принял текущие hero-картинки страниц «Фон», «Ночь», «Будильник»; дополнительный Android emulator image check больше не является блокером.
- Новый документ: `04_Прошивка/AMBIENT_PRESETS_IMPLEMENTATION_PLAN.md` (G0…G5). **План сохранён; реализация не запущена.**
- Если дана отдельная команда реализовать пресеты: сначала утвердить каталог и P12/release scope, сделать свежий full Nano/ESP build + Flash/SRAM/EEPROM snapshot (G0/G1), затем три P01/P04/P05 и compile gates.
- Соблюдать `FINALIZATION_PLAN.md`: никакого одиночного firmware prototype upload поверх известной рабочей Nano; полная RC сборка и hardware acceptance только после разрешения.
- F01 останется, F02/F03 планируется убрать лишь из будущего UI; существующие firmware/API/Android пока неизменны. Продолжают ожидать physical ARDU-DIRECT smoke и двухкольцевой 44+44 power test.

## Актуальный следующий шаг — 2026-10-08: первые 3 preset renderer source-complete

- Созданы P01/P04/P05 preview renderer и host tests. GitHub Actions [37807204353](https://github.com/dronrome1245/ARDU/actions/runs/37807204353): standard Nano 28690 Flash/1234 SRAM, full Nano with lab 29312 Flash/1234 SRAM; компиляция и host tests PASS.
- Новый source-only отчёт: `04_Прошивка/AMBIENT_PRESETS_LAB_R1.md`, логика включается **только** флагом `ARDU_AMBIENT_PRESET_PROBE=1`; обычный код F01/F02/F03 не меняет поведение.
- До дальнейшего шага привести Flash к запасу (текущий lab на 128 байт выше 95% ориентира) и оценить stack; затем только полный согласованный release-кандидат Nano / физический осмотр сцен. Не выполнять самостоятельную lab-прошивку.
- Функциональный Android/ESP/API/EEPROM не менялся; по D-104 F02/F03 планируется убрать из будущего UI после миграции. Остаются ARDU-DIRECT и two-ring hardware gates.

## Актуальный следующий шаг — 2026-10-08: PREVIEW RC1 source+HEX готовы

- Полный Nano-скетч `04_Прошивка/nano_ambient_preview_rc1/nano_ambient_preview_rc1.ino` + локальный header, не отдельная тестовая урезанная версия.
- [CI 37809369365](https://github.com/dronrome1245/ARDU/actions/runs/37809369365) PASS: preview 29376/30720 Flash, 1234/2048 globals, [HEX](https://github.com/dronrome1245/ARDU/actions/runs/37809369365/artifacts/11564965835).
- **Владелец:** прочитать `04_Прошивка/AMBIENT_PRESETS_PREVIEW_RC1_TEST.md`, при снятом питании временно отключить ESP TX→Nano D0, Nano Old Bootloader Verify/Upload полной RC, Serial `1`→`O 1`, вернуть UART, открыть Android «Фон» → F01 «Цвет» и посмотреть ~33-секундный цикл P01/P04/P05/F01.
- Запас до hard Flash = 1344 B, внутренний 95% target превышен на 192 B. Запас SRAM для stack/locals = 814 B, фактическое железо/stack/two-ring/load **ещё не измерялись**. При проблеме откат к обычному `nano_ardu_v1.ino`.

## Актуальный следующий шаг — 2026-10-08: исправленная Nano Preview RC2 (один файл)

**Последний blocker:** Windows Arduino IDE не находила `ambient_preset_probe.h` у RC1 даже при нахождении рядом. **Решение:** `04_Прошивка/nano_ambient_preview_rc2/nano_ambient_preview_rc2.ino` содержит всю Nano v1 и три сцены внутри одного .ino.

[CI 37814719230](https://github.com/dronrome1245/ARDU/actions/runs/37814719230) **PASS**: отдельная сборка из **одного .ino**, 29376/30720 Flash + 1234/2048 globals; [HEX](https://github.com/dronrome1245/ARDU/actions/runs/37814719230/artifacts/11567275089). Пользователь: `git pull` или Raw download нового файла, открыть `nano_ambient_preview_rc2.ino`, Nano Old Bootloader → **Verify**, затем безопасный Upload/Serial/Android «Фон» → F01 по `04_Прошивка/AMBIENT_PRESETS_PREVIEW_RC2_TEST.md`. Ничего не прошивалось и не проверялось на реальном LED на этом шаге; ESP/Android/API/UART/EEPROM без изменений.

## Актуальный следующий шаг — 2026-10-08: готов единый source Ambient12 + ARDU-DIRECT, надо физически загрузить

1. Прочитать `ARDU_AMBIENT12_RELEASE_CANDIDATE.md`. Не заливать экспериментальную Nano preview RC2: целевая полная Nano v2 — `04_Прошивка/nano_ambient12_v1/nano_ambient12_v1.ino`.
2. `cd C:\ARDU` → `git switch main` → `git pull`. Проверить работающий ESP /api/ping в домашней сети, снять snapshot /api/settings.
3. В `esp8266_ardu_v2` из `wifi_secrets.example.h` создать локальный `wifi_secrets.h`, подставить реальный домашний SSID/password, старый OTA password и новый WPA2 ARDU-DIRECT password ≥8, установить `ARDU_CREDENTIALS_CONFIGURED 1`. Не коммитить/отправлять пароль. Arduino IDE ESP v2 Verify → **единственное OTA-обновление по работающему Station**.
4. Проверить ESP ping fw=ARDU_ESP_V2_AMBIENT12, Wi-Fi Station/OTA/старую Nano. Только затем полная Nano v2 Old Bootloader USB; **при снятом питании** отключить ESP TX→Nano D0 на время Upload, вернуть после, проверить /api/status /api/ambient/presets.
5. Android Studio Run v0.22.6 или CI APK [37819918951](https://github.com/dronrome1245/ARDU/actions/runs/37819918951/artifacts/11568856875); убедиться в 12 P-сценах, изменении/EEPROM readback, переходе L01/Music/Night/Alarm, затем отключить только домашний Wi-Fi и проверить ARDU-DIRECT 192.168.4.1/WPA2 и восстановление Station.
6. **Не считать релиз готовым по одному CI:** Flash Nano около 29306/30720 после оптимизации [CI 37820974644](https://github.com/dronrome1245/ARDU/actions/runs/37820974644), SRAM globals 1282/2048, реальные worst-case stack и 44+44 ток/температура и световые паттерны не подтверждены.

## Актуальный handoff — ESP v2 R2 без wifi_secrets.h (2026-10-08)

Последнее явное решение владельца D-110: **один `esp8266_ardu_v2.ino`**, в начале четыре вручную вводимые значения `ARDU_WIFI_SSID`, `ARDU_WIFI_PASSWORD`, `ARDU_OTA_PASSWORD`, `ARDU_SOFTAP_PASSWORD`. Никакого `wifi_secrets.h`/флагов, старые указания про создание header заменены. Сохранить отдельную копию .ino вне Git и не коммитить реальные секреты. [ESP CI 37823238584](https://github.com/dronrome1245/ARDU/actions/runs/37823238584) PASS single-file (четыре тестовых значения) + negative default placeholder guard.

Далее по [ARDU_AMBIENT12_RELEASE_CANDIDATE.md](ARDU_AMBIENT12_RELEASE_CANDIDATE.md): личные 4 значения → Arduino IDE Verify → OTA по работающему Station и **паролю старой ESP для текущего Upload** → `/api/ping` → полная Nano v2 по USB → Android 0.22.6 → ARDU-DIRECT/192.168.4.1. Физических Upload/Direct PASS ещё нет.

## Следующий практический шаг — 2026-10-08: новая ESP v2 уже прошита / проверки Nano впереди

**ESP OTA физически PASS:** владелец показал `/api/ping` с `fw:ARDU_ESP_V2_AMBIENT12`, `network_mode:station`, `192.168.0.4`, `ota_ready:true`. Arduino IDE network Serial Monitor error не свидетельствует о сбое установленной прошивки. **Не повторять OTA**.

Сейчас проверить мост новой ESP со старой Nano: `curl.exe http://192.168.0.4/api/status` и `curl.exe http://192.168.0.4/api/ambient/presets`. При old Nano ожидаются рабочий статус и `supported:false` для P-сцен. Только затем полная Nano v2 USB/Old Bootloader с безопасным ESP TX→Nano D0 disconnect/power isolation; Android v0.22.6; отдельно Wi-Fi `ARDU-DIRECT`/192.168.4.1 smoke. План `ARDU_AMBIENT12_RELEASE_CANDIDATE.md`.

## Актуальный следующий шаг — 2026-10-08: Android v0.22.7, все 12 изображений, pull → Run

- В GitHub `main` уже есть 12 реальных `ardu_preset_p01.webp`..`ardu_preset_p12.webp` и обновлённый Android `0.22.7-ambient12-photo-tiles-rc1` (versionCode30). Плитки в «Фон»: 3 строки × 4, изображения с подписями вместо текстовых P05..P12.
- **CI [37838263956](https://github.com/dronrome1245/ARDU/actions/runs/37838263956) PASS**, включая наличие 12 binary assets, Gradle unit contract tests, сборку и [APK](https://github.com/dronrome1245/ARDU/actions/runs/37838263956/artifacts/11576287564). [Art mapping](05_WiFi_и_приложение/AMBIENT12_ARTWORK.md).
- Владелец: `cd C:\ARDU` → `git pull` → Android Studio **Run**, открыть «Фон», проверить 12 миниатюр/названия/выделение P01..P12 и регулировку конкретного пресета. При ошибках прислать скриншот.
- Никакой Nano/ESP перепрошивки ради картинок. В предыдущем тесте пользователя `GET /api/ambient/presets` возвращал все 12 и `P01` применялся/сохранялся; ARDU-DIRECT fallback/2×44 load/полная приёмка эффектов ещё pending.

## Актуальный следующий шаг — 2026-10-09: Android v0.22.8 offline/readback UI

1. В GitHub обновлён Android `0.22.8-ux-readback-rc1` (versionCode31), D-112, [Android CI](https://github.com/dronrome1245/ARDU/actions/runs/37930295301). Фото всех P01..P12 уже визуально показаны владельцем в v0.22.7; на видео ESP «Нет связи» и лента отключена.
2. Владелец: `cd C:\ARDU` → `git pull` → Android Studio **Run**. Без ESP проверь отсутствие ложных 80%/0%, запрет настройки офлайн, начало каждой вкладки сверху и приоритет фотоплиток «Фон».
3. С включёнными Nano+ESP в Wi-Fi проверь реальные readback/состояния, кнопки музыки, пресеты P01–P12, режим F01, ночник и alarm/RTC. Ошибки и скриншоты присылай для дальнейшего точечного исправления.
4. Прошивки не трогать ради UI; отдельно по `ARDU_AMBIENT12_RELEASE_CANDIDATE.md` остаются 44+44 силовой gate, ARDU-DIRECT без роутера, RAM/stack и аппаратная приёмка эффектов.

## Актуальный следующий шаг — 2026-10-09, Android 0.22.9 heartbeat RC

1. Android `0.22.9-keepalive-diagnostics-rc1` / code 32, [CI PASS](https://github.com/dronrome1245/ARDU/actions/runs/37958078703). По просьбе владельца исправлен зависающий `Онлайн` (опрос ESP+Nano каждые 5 секунд в открытом приложении); общие Настройки → Отображение → `Показывать служебные сообщения` (default OFF); усилен контраст кнопки музыки. Протокол и прошивки не менялись.
2. Владелец: `cd C:\ARDU` → `git pull` → Android Studio Run. Проверка: при включённой ARDU `Онлайн`; выключить питание штатным способом, подождать 5–10 с плюс возможный сетевой timeout, убедиться `Нет связи`; включить обратно, дождаться автоматического восстановления. Не отсоединять работающие провода UART/питания ради теста. Переключить служебные сообщения в Настройках, сравнить экран «Фон»/«Свет», перезапустить приложение и проверить запоминание настройки.
3. По коду Nano `dynamics` разбито на 3 диапазона; приведённые на видео 182,190,225 имеют одинаковый коэффициент ускорения. Следующая **отдельная** итерация: непрерывная скорость для P01–P12, компиляция полной Nano и memory/stack, затем физический световой тест после безопасного upload (не часть Android 0.22.9).
4. В текущем UI при чтении Nano reported current limit 4500 мА. До испытания 44+44 LED придерживаться 3000 мА; это настройка, не измеренный ток. Актуальны ARDU-DIRECT, power, heat, stack и UI end-to-end gates.

## Актуальный следующий шаг — 2026-10-09, owner PASS Online/Offline в Android 0.22.9

**Закрыто по тесту владельца:** автоматическая смена Online/Offline на телефоне после 0.22.9 (подтверждение в чате). Видео `18429670918804.mp4` (~63 с) дополнительно показывает чтение состояния, смену разделов Свет/Музыка, контраст кнопки запуска, но не момент отключения питания. Не просить повторять Online/Offline без новой причины.

**Следующее ПО:** компактный source patch полной Nano v2 `renderPreset()`: вместо трёх диапазонов `dynamics` — непрерывная скорость с предсказуемым влиянием регулятора. До физического Upload: CI Nano compile, Flash/SRAM budget, frame-renderer host tests и проверка безопасности изменения. Затем владелец смотрит один 44-LED канал, тестирует P01/P03/P05/P12 и фиксирует реальную скорость. Не перепрошивать ESP/Android ради одной скоростной коррекции.

**Остаётся:** проверить скрытие служебных надписей и сохранение тумблера после перезапуска Android; USB/HTTP readback errors при переключении музыки и завершение мастера калибровки хлопков; ARDU-DIRECT и два 44-LED кольца под нагрузкой. Держать лимит тока не более 3000 мА до измерения.

## Актуальный следующий шаг — 2026-10-09: физический gate Nano Ambient12 R2 скорости

**Source + CI выполнены:** полный новый `04_Прошивка/nano_ambient12_v2/nano_ambient12_v2.ino`, boot `ARDU1 3`, [Arduino Verify https://github.com/dronrome1245/ARDU/actions/runs/37966945125](https://github.com/dronrome1245/ARDU/actions/runs/37966945125) PASS: **29336/30720 Flash, 1286/2048 globals SRAM**, все 12 рендереров и 256 коэффициентов скорости проверены на host, полный HEX собран. Старый `nano_ambient12_v1` сохранён для отката; ESP/Android неизменны.

**Владелец:** `cd C:\ARDU` → `git pull` → Arduino IDE → File/Open: новый `.ino`. Arduino Nano + ATmega328P (Old Bootloader), USB-C COM → Verify. При снятом S-30-5 и USB отсоединить ESP TX0/GPIO1 от Nano D0/RX; затем USB Upload. Проверить boot `ARDU1 3` в Serial Monitor 115200; снять питание, восстановить ESP TX→Nano D0, включить стенд, проверить HTTP status/presets. **Только один проверенный 44-LED канал на D6**: P11 скорость 0→128→255 (~16→7→4 s на один цикл), затем P01/P03/P05/P12. Лимит ≤3000 мА, яркость ≤40%. Полный регламент и rollback: `04_Прошивка/AMBIENT12_SPEED_R2_TEST.md`.

**Физическая приёмка скорости/стека ещё не получена.** Два кольца 44+44, питание/температура, ARDU-DIRECT, все остальные эффекты сохраняются как открытые gates; Android 0.22.9 Online/Offline уже подтверждён владельцем.

## Следующий аппаратный шаг — 2026-10-09: проверка немного замедленного P11 в Nano R3

По обратной связи владельца P11 «Дыхание» на предыдущей прошивке визуально понравилось, но скорость при 0 хочется чуть уменьшить. Создана новая отдельная **полная** `04_Прошивка/nano_ambient12_v3/nano_ambient12_v3.ino` (boot `ARDU1 4`) — цикл P11 ~20,2 с при 0 и прежние ~4,1 с при 255, остальные 11 сцен не затронуты. [CI https://github.com/dronrome1245/ARDU/actions/runs/37971273171](https://github.com/dronrome1245/ARDU/actions/runs/37971273171) PASS: все 12 exact-source рендереров, 256 монотонных P11 скоростей, компиляция **29376 Flash/1286 global SRAM**, R2 rollback скетч сохранён. Stack/питание/физический эффект R3 ещё **НЕ проверены**.

**Следующее действие владельца:** `cd C:\ARDU` → `git pull` → Arduino IDE открыть **новый** `nano_ambient12_v3/nano_ambient12_v3.ino`, Nano/ATmega328P Old Bootloader, Verify; при полностью снятом питании временно снять ESP TX0→Nano D0, затем безопасный USB Upload; увидеть `ARDU1 4`, вернуть ESP TX→D0 при выключенном питании; проверить P11 при 0/128/255 на одном 44-LED кольце. Полная последовательность и откат: `04_Прошивка/AMBIENT12_BREATHING_R3_TEST.md`. Ни ESP, ни Android не обновлять ради P11; ток до двухкольцевого теста ≤3000 мА.

## АКТУАЛЬНЫЙ следующий шаг (2026-10-09) — установить и испытать полную Nano Ambient12 R4

**Source gate PASS:** `04_Прошивка/nano_ambient12_v4/nano_ambient12_v4.ino` содержит 12 видимо анимируемых сцен, P11 «Дыхание» без изменений. [Arduino Verify https://github.com/dronrome1245/ARDU/actions/runs/37975908088](https://github.com/dronrome1245/ARDU/actions/runs/37975908088) PASS: full Nano 29410 Flash / 1286 global SRAM, 44-LED host pixel motion по каждой P01..P12, R3 rollback сохранён. Ревизия загрузки `ARDU1 5`.

**Владелец выполняет один проверяемый физический шаг:** `cd C:\ARDU` → `git pull` → Arduino IDE открыть `04_Прошивка/nano_ambient12_v4/nano_ambient12_v4.ino`, Board Arduino Nano, Processor ATmega328P (Old Bootloader), Verify. На полностью обесточенном стенде временно разъединить ESP TX0→Nano D0/RX, USB Upload, проверить `ARDU1 5`, обесточить и вернуть UART. На одном 44-LED кольце при умеренной яркости последовательно проверить все 12 эффектов с динамикой 0/128/255. Полная инструкция + rollback: `04_Прошивка/AMBIENT12_ALL_SCENES_R4_TEST.md`.

ESP OTA/Android Run ради новых сцен не нужны, физический R4 PASS ещё не получен. До 44+44 power gate не выше 3000 мА; USB/RTC/Music/ночник надо кратко регрессионно проверить после Upload, а ARDU-DIRECT/stack/двухкольцевой ток оставить отдельными этапами.

## Актуальный приоритет после owner R4 motion PASS — 2026-10-09

Владелец подтвердил, что после Nano Ambient12 R4 все P01..P12 **визуально движутся на реальной лампе**. Motion gate закрыт по отчёту владельца, больше не нужен новый Nano firmware только ради видимой анимации. Дальнейшие проверки профилей и железа отделены от этого.

**Ближайший исправляемый дефект программно — Android:** по предыдущему телефонному видео при Music команда порой сопровождалась `unexpected end of stream` или `Connection reset`; команда и readback в `MainActivity.runDeviceAction` сейчас обрабатываются общим try/catch, поэтому надо отличать подтверждённое применение от временно недоступного status GET и допускать восстановление UI из фактического Nano. После успешного CLAPCAL SAVE мастер должен исчезать или сбрасывать завершённое состояние, чтобы не предлагать повторно «Следующая пара», «Рассчитать», «Сохранить». Сохранить диагностику и проверяемую настройку «Показывать служебные сообщения» из Android 0.22.9, оставить approved Home Hub UI.

**Следующий аппаратный gate:** сохраняемость параметров P, полный L01/Music/Night/RTC/Alarm/Clap smoke, ARDU-DIRECT без роутера, два кольца 44+44 с замером питания/температуры и контролем stack. Не начинать потолочный монтаж до безопасного Class II БП и силовой проверки. Программный лимит ≤3000 мА до завершения измерений.

## АКТУАЛЬНЫЙ gate — 2026-10-09, Android 0.22.10 desktop icon & connectivity corrections

**Source/CI выполнены (D-117):** Android `0.22.10-launcher-readback-clap-rc1`, versionCode33. Добавлены нативные adaptive/round/themed launcher ресурсы и icon/roundIcon в manifest; при полученном POST ACK и неуспешном Nano readback команда показывается как подтверждённая с ожиданием нового snapshot, а не ложно «не применена»; только GET сбросы HTTP потока повторяются один раз, не POST. CLAPCAL wizard скрывается и запоминает закрытие после подтверждённого SAVE, новая калибровка открывает заново. [Android Verify https://github.com/dronrome1245/ARDU/actions/runs/37981648045](https://github.com/dronrome1245/ARDU/actions/runs/37981648045) **PASS**, готов APK.

**Шаг владельца:** `cd C:\ARDU` → `git pull` → Android Studio Run. Проверить рабочий стол Android — значок ARDU должен быть тёмный с мятным светящимся кольцом и A. Старый ярлык иногда кэшируется лаунчером — тогда убрать только ярлык с рабочего стола и добавить ARDU заново из списка приложений (не удалять приложение/настройки). Запустить Music (M01/M03/M09) и проверить работу при обычной связи; провести сохранение порога хлопков и убедиться, что мастер закрылся и не открылся повторно после обновления экрана/перезапуска, в настройках проверить тумблер служебных надписей. После сбоя GET не должно быть ложного сообщения о провале подтверждённой команды. Следующий gate — тест прямого ARDU-DIRECT без домашнего роутера, затем два кольца 44+44 и силовые/тепловые/stack измерения. Nano R4 и ESP **не прошивать** ради launcher icon/Android-only исправлений.

## Актуальный следующий gate — 2026-10-10, Android 0.22.11 четыре исправления после видео

Владелец прислал телефонную запись `18437905058452.mp4` и четыре замечания. В Android-only версии `0.22.11-presets-submodes-scene-contrast-rc1`, code34, реализовано: (1) «Фон» 12 P сцен + brightness/dynamics, без visible F01/ручного цвета и автоперебора, ON/OFF перенесены к P плиткам; (2) Music M05/M08 4 равные submode кнопки перед слайдерами и сильный Mint selected; (3) Music background slider явно подписан только **яркостью** и объясняет fixed firmware background hue; у M09 неактуальный slider скрывается; (4) Light «Вечер» = 2700K/115/45% golden фото, «Кино» = 1800K/18/7% dark-blue фото. «Гости» и «Чтение» не тронуты.

[Android Verify https://github.com/dronrome1245/ARDU/actions/runs/38035137524](https://github.com/dronrome1245/ARDU/actions/runs/38035137524) **PASS**, Android debug APK собран, прошивки Nano R4/ESP не изменялись. **Следующий шаг владельца**: `cd C:\ARDU` → `git pull` → Android Studio Run. Проверить скрытый «Свой цвет», сохранённые 12 пресетов, Music M05/M08 submode selected при переключении, фоновые music labels, два quick scenes на реальной лампе, ранее проверенные Online/Offline. Не повышать лимит тока выше 3000 мА до power gate.

После owner phone acceptance: реальный Mxx/Night/Alarm/clap smoke, сцены EEPROM after cold restart, ARDU-DIRECT Station→SoftAP→Station и оба 44 LED кольца/силовая защита/стек/Class II PSU. Не включать новый Nano /ESP firmware ради этих UI-изменений.

2026-10-17 D-126: ESP V4 Nano remote programming source/CI ready; add GPIO4→BC548→Nano RESET service line, then physical write+verify gate. See `02_Архитектура_и_решения/NANO_REMOTE_FLASH.md`.
