dronrome1245/ARDU/01_СТАТУС_ПРОЕКТА.md

# Статус проекта ARDU

> **Актуальный handoff 2026-11-14:** D-128 принят и реализован в исходниках. Android 0.22.16 CI PASS; Nano R7 + ESP V5 source CI PASS ([run 43595155594](https://github.com/dronrome1245/ARDU/actions/runs/43595155594)); Nano занимает 30 712/30 720 B Flash, всего 8 B свободно. Физически установлена R6; R7/ESP V5 не залиты. Далее безопасное OTA ESP V5 → verified Nano R7 → `04_Прошивка/FAMILY_R7_ACCEPTANCE.md`. Монтаж блокируют 44+44 нагрузочный gate и подтверждение Class II БП. Сведения ниже сохранены как история; источник истины — `STATUS.md`.

Дата: 2026-09-06

Канонический статус находится в `STATUS.md`.

Текущий этап: функциональная модель режимов и нового Wi‑Fi приложения завершена; дальше — измерения питания, физическая разводка двух корпусов и первый стенд ESP8266 ↔ Nano.

Ключевые новые документы:

- `04_Прошивка/РЕЖИМЫ_РАБОТЫ.md`;
- `04_Прошивка/ПОРЯДОК_РЕАЛИЗАЦИИ.md`;
- `04_Прошивка/MODEL_IDS.md`;
- `05_WiFi_и_приложение/ФУНКЦИОНАЛЬНАЯ_МОДЕЛЬ.md`;
- `05_WiFi_и_приложение/API_V1.md`;
- `05_WiFi_и_приложение/МОДЕЛЬ_ЭКРАНОВ.md`;
- `08_Исходники_и_референсы/Ardublock2_РАЗБОР.md`;
- `08_Исходники_и_референсы/ColorMusic_РЕЖИМЫ_И_ПАРАМЕТРЫ.md`.

Старый `Ardublock2.aia` разобран. Его Bluetooth-протокол не переносится как обязательный внешний контракт.

Следующий практический шаг: измерить YP-8 и S-30-5, определить потолочную низковольтную разводку и место БП, затем утвердить BOM и собрать первый Wi‑Fi/UART стенд.

## Handoff 2026-09-20

ESP8266 воспроизводимо прошивается до 100% через Nano USB↔UART на 115200 при локальном 100 µF, GPIO0=LOW и ручном кратком RST→GND во время Connecting. Прямой D0→ESP RX используется только как диагностический путь и не считается безопасной штатной схемой. Делитель 1,5 кОм / 3,0 кОм снова вызывает ошибку; следующий тест — низкоомный делитель 750 Ом / 1,5 кОм.

## Handoff 2026-09-20 — переход к FW-0

По решению владельца подбор programmer-divider ESP временно отложен. Безопасность прямого ~5 В на ESP RX не пересматривается: это не штатная схема. Создан `04_Прошивка/nano_fw0/nano_fw0.ino`; следующий тест — загрузить его в Nano и подтвердить `ARDU NANO FW0 READY`, `PING→PONG`, `STATUS`.

## Handoff 2026-09-20 — FW-0 закрыт

Mini-USB Nano подтверждена как `ATmega328P (Old Bootloader)`. FW-0 загружен; `PING→PONG`, `STATUS` работают. Создан `04_Прошивка/nano_fw1/nano_fw1.ino`; следующий шаг — сначала компиляция FW-1 с FastLED без подключения кольца, затем один WS2812B-канал на D6.

## Handoff 2026-09-24 — D-040 закрыт, создан M03

Single-input MAX9814/A0 с 40 dB, DEFAULT AREF, software DC subtraction и original FHT подтверждён на железе для LOW/MID/HIGH. Создан `04_Прошивка/nano_m03/nano_m03.ino` — M03 «5 полос» для одного 43-LED кольца D6. Следующий шаг — Verify/Compile M03 для `ATmega328P (Old Bootloader)`; затем upload, `CALF` и визуальная проверка 2/4–5/8 кГц.

## Handoff 2026-09-25 — M03 закрыт, создан M04

M03 «5 полос» полностью пройден на одном D6-кольце: тишина гасит ленту, 2/5/8 кГц разделяются как LOW/MID/HIGH, реальная музыка проверена. Общая GND Nano/ленты/БП обязательна и восстановлена. Создан `04_Прошивка/nano_m04/nano_m04.ino` — M04 «3 полосы» на том же A0/FHT frontend. Следующий шаг — Verify/Compile M04 для `ATmega328P (Old Bootloader)`, затем Upload и STATUS.

## Handoff 2026-09-25 — M04 закрыт, создан M05

M04 «3 полосы» полностью пройден на одном D6-кольце. Создан `04_Прошивка/nano_m05_r2/nano_m05_r2.ino` с подрежимами `THREE/LOW/MID/HIGH`; frontend MAX9814/A0/FHT не менялся. Следующий шаг — Verify/Compile M05 для `ATmega328P (Old Bootloader)`.

## Handoff 2026-09-25 — M05 R2

После compile conflict M05 актуальная ревизия — R2: `04_Прошивка/nano_m05_r2/nano_m05_r2.ino`. Ожидаемый startup: `ARDU NANO M05 R2 READY`; STATUS: `FW=M05 REV=2`. Следующий шаг — Verify/Compile именно R2.

## Handoff 2026-09-26 — M05 R3

M05 R2 между тестами перезапустился и затем показал invalid `DC=1000`; результаты LOW/MID/HIGH после reset не засчитаны. Актуальная ревизия — `04_Прошивка/nano_m05_r3/nano_m05_r3.ino`. R3 отвергает CALF при DC вне 120..400 и выводит `DC_OK`. Следующий шаг — Verify/Upload R3, затем STATUS/ADC/CALF/STATUS одним пакетом.

## Handoff 2026-09-26 — M05 R4 UART/FastLED

M05 visual behavior is correct, but Serial command corruption is reproducible only while the ring is actively updated. Current revision: `04_Прошивка/nano_m05_r4/nano_m05_r4.ino`. R4 enables FastLED interrupts and a 5 ms RX guard. Next: Verify/Upload R4 and stress Serial while ring is continuously lit; verify no LED glitches.

## Handoff 2026-09-26 — M05 closed, M08 R1 next

M05 R4 полностью пройден: visual + UART stress при активном кольце без ошибок. Создан `04_Прошивка/nano_m08_r1/nano_m08_r1.ino`; наследует R4 UART fix и DC guard. Следующий шаг — Verify/Upload M08 R1, затем ADC/CALF и running-frequency visual tests.

## Handoff 2026-09-26 — M08 closed, M09 R1 next

M08 R1 полностью пройден на железе. Следующий режим: `04_Прошивка/nano_m09_r1/nano_m09_r1.ino` — анализатор спектра, 20 displayed bins, `HUESTART/HUESTEP`, inherited DC guard и FastLED/UART fix. Следующий шаг — Verify/Upload + ADC/CALF + visual test.

## Handoff 2026-09-26 — FW-6 closed, F02 R1 next

M09 R1 полностью пройден, весь FW-6 закрыт на одном кольце. Начат FW-7. Актуальный тестовый файл: `04_Прошивка/nano_f02_r1/nano_f02_r1.ino` — плавная смена общего цвета, HUE/SAT/SPEED/BRIGHT, inherited FastLED/UART fix.

## Handoff 2026-09-26 — F02 closed, F03 R1 next

F02 R1 полностью пройден. Актуальный файл: `04_Прошивка/nano_f03_r1/nano_f03_r1.ino`. F03 = running rainbow, default `SPEED=1`, `STEP10=5`, inherited FastLED/UART fix. Следующий шаг — Verify/Upload и visual parameter regression.

## Handoff 2026-09-26 — F03 closed, AMBIENT R1 next

F03 R1 пройден. Для закрытия FW-7 создан `04_Прошивка/nano_ambient_r1/nano_ambient_r1.ino`: F01/F02/F03, EFFECT/NEXT/PREV, AUTO ON/OFF, PERIOD seconds, inherited FastLED/UART fix. Следующий шаг — hardware integration test.

## Handoff 2026-09-26 — FW-7 closed, RTC R1 next

AMBIENT R1 пройден, FW-7 закрыт. Подготовлены `04_Прошивка/nano_rtc_r1/nano_rtc_r1.ino` и `04_Прошивка/RTC_DS3231_WIRING.md`. Перед подключением 5 В к DS3231 с установленной CR2032 необходимо подтвердить удаление резистора `201` зарядной цепи.

## Handoff 2026-09-26 — RTC passed, ALARM R1 next

RTC R1 пройден. Подготовлены `04_Прошивка/nano_alarm_r1/nano_alarm_r1.ino` и `ALARM_R1_TEST.md`. Следующий шаг — Verify/Upload, задать alarm на 1–2 минуты вперёд, подтвердить сохранение после reset и одно `EVENT ALARM_TRIGGER`.

## Handoff 2026-09-26 — ALARM passed, DAWN R1 next

ALARM R1 пройден: persistence после reset и daily trigger подтверждены. Созданы `04_Прошивка/nano_dawn_r1/nano_dawn_r1.ino` и `DAWN_R1_TEST.md`. Следующий шаг — Verify/Upload, `DAWN TEST 20`, STOP, параметрический тест, затем alarm-triggered dawn.

## Handoff 2026-09-26 — DAWN R1 closed, DAWN R2 next

DAWN R1 пройден. Созданы `04_Прошивка/nano_dawn_r2/nano_dawn_r2.ino` и `DAWN_R2_TEST.md`. R2 восстанавливает RUNNING/HOLD после reset по DS3231; EEPROM пишет только state transitions.

## Handoff 2026-09-26 — FW-8 closed, NIGHT R1 next

DAWN R2 полностью пройден; FW-8 закрыт. Созданы `04_Прошивка/nano_night_r1/nano_night_r1.ino` и `NIGHT_R1_TEST.md`. Следующий шаг — Verify/Upload, visual HSV/brightness regression и persistence ON/OFF после reset.

## Handoff 2026-09-26 — NIGHT R2 schedule next

NIGHT R1 заменён до hardware pass. Актуальный файл: `04_Прошивка/nano_night_r2/nano_night_r2.ino`. Включает manual nightlight, persistence и DS3231 schedule. Следующий шаг — `NIGHT_R2_TEST.md`.

## Handoff 2026-09-27 — FW-9 closed, M02 R1 next

NIGHT R2 hardware test подтверждён владельцем как полностью сработавший; FW-9 закрыт. По новому решению владельца до общей Nano-интеграции отдельно закрываются M02, затем M06. Созданы `nano_m02_r1/nano_m02_r1.ino` и `M02_R1_TEST.md`. Следующий шаг — Verify/Upload M02 R1 и полный hardware test. После M02 → M06 → единая полная Nano-прошивка → regression → приложение.

## Handoff 2026-09-27 — L01/clap and RTC app time added

Добавлен обязательный режим обычного света `L01`: app ON/OFF/brightness, cold power-on после подачи 230 В → L01 ON, локальный clap switch на MAX9814 с app enable/disable. Точный clap detector выбирается после hardware test. Приложение обязано показывать фактическое время DS3231. Порядок: текущий M02 → M06 → L01/clap → единая Nano-прошивка → regression → ESP/app.

## Handoff 2026-09-27 — M06 removed, L01 R1 next

M02 закрыт. M06 R1 полностью прошёл hardware test, после чего владелец исключил стробоскоп из ARDU; активные файлы M06 удалены. Текущий следующий слой: `04_Прошивка/nano_l01_r1/nano_l01_r1.ino` + `L01_R1_TEST.md`. После L01 → clap diagnostic → единая Nano-прошивка → regression → ESP/app.

## Handoff 2026-09-27 — L01 R2 Kelvin/RGB persistence next

L01 R1 полностью пройден. По новому решению владельца ordinary light поддерживает приблизительный Kelvin, presets 2700/4000/6000, любой RGB-цвет и отдельную яркость. L01 startup profile сохраняется на Nano и применяется после cold power-on. Созданы `nano_l01_r2/nano_l01_r2.ino` и `L01_R2_TEST.md`. Следующий шаг — Verify/Upload и persistence test, затем clap diagnostic.

## Handoff 2026-10-01 — finalization v1

По решению владельца дальнейшие промежуточные Nano/ESP uploads прекращены. Канонический план: `FINALIZATION_PLAN.md`. Физический Nano оставить на FW10 CORE R1 до готовности полной release v1; CORE R3 отдельно не загружать. Следующий engineering step — интеграция полной Nano v1 (все active Music/Ambient + CLAPCAL + persistence + D6/D7 44+44 + current limit), compile/SRAM optimization и UART freeze. После этого один Nano upload → один ESP OTA release → Android completion → design → power/mount/release.

## Handoff 2026-10-01 — Nano + ESP v1 release candidates ready

Полные Nano/ESP release candidates проходят CI. Nano = 28024/30720 flash, 1070/2048 globals. ESP = RAM 39%, IRAM 92%, IROM 324376 bytes. Frozen UART: `06_Интерфейс_управления/UART_V1.md`. Следующий шаг — только `RELEASE_V1_UPLOAD_ACCEPTANCE.md`: один final Nano upload, затем ESP OTA, acceptance и firmware freeze.

## Handoff 2026-10-02 — Android design v1 ready

Android `0.10-design-v1-rc1` source/CI ready:
- full final HTTP API functionality;
- fixed 5-mode bottom navigation;
- dark card UI;
- color previews;
- Settings/Developer separated from normal controls;
- contract tests PASS;
- debug APK PASS.

Physical next gate unchanged: replacement Nano → final Nano v1 upload → ESP v1 OTA → firmware + Android end-to-end acceptance.

## Handoff 2026-10-02 — Android v0.13 unified smart-home UI ready

Current Android RC: `0.13-smart-home-tabs-rc1`.

Light/Music/Ambient/Night/Alarm now share one smart-home UI language with semantic custom sliders and selected-state controls. Final Android CI run 37056022090 PASS. Firmware/API unchanged. Replacement Nano remains the next physical gate.

## Handoff 2026-10-03 — final Android style owner-approved

Android current RC: `0.14-ios-homehub-focus-rc1`.

Owner-approved style = mint-dark **Home Hub + Focus Dial**. Home Hub contextual overview + Focus Dial detailed Light control are implemented; contextual heroes are applied to Music/Ambient/Night/Alarm. API/firmware unchanged. Final Android CI run 37062432020 PASS.

Physical next gate remains replacement Nano → final Nano upload → ESP OTA → full firmware/Android acceptance.

## Handoff 2026-10-03 — Android v0.18 contextual photo heroes ready

Current Android RC: `0.18-photo-heroes-rc1`.

Owner accepted the corrected Light v0.17 geometry. Music/Ambient/Night/Alarm contextual heroes now render from a real high-resolution photo master with per-tab focal crop and color grade instead of synthetic Canvas room geometry. Android Verify run 37111268646 PASS. Firmware/API unchanged.

Software next gate: phone visual smoke of Music / Ambient / Night / Alarm contextual photo heroes. Physical next gate remains replacement Nano → final Nano upload → ESP OTA → full firmware/Android acceptance.

## Handoff 2026-10-03 — Android v0.19 Music/header polish ready

Current Android RC: `0.19-music-header-polish-rc1`.

Owner accepted the v0.18 contextual photo screens overall. v0.19 fixes clipped two-line Music mode labels and removes the outer framed card from the common top status/header on normal non-Light tabs. Light Home Hub is unchanged. Android Verify run 37112061533 PASS; firmware/API unchanged.

Software next gate: quick phone check of Music labels + frameless top status. Physical gate remains replacement Nano → final Nano upload → ESP OTA → full firmware/Android acceptance.

## Handoff 2026-10-04 — Android v0.20 Music Home Hub ready

Current Android RC: `0.20-music-homehub-rc1`.

Music now has a dedicated Home Hub photo hero, direct-start mode cards without VU or Play/Stop, 4+3 equal-height non-scroll mode grid, automatic Music OFF when selecting another bottom user tab, global SmartSlider edge clipping fix, and icon-only bottom navigation. Static contract clean; Actions run 37194558467 PASS. Nano/ESP/API unchanged.

Software next gate: owner-phone visual/function smoke v0.20. Physical gate remains replacement Nano → final Nano upload → ESP OTA → full acceptance.

## Handoff 2026-10-04 — Android v0.20.1 Music visual hotfix ready

Current Android RC: `0.20.1-music-visual-hotfix-rc1`.

Owner v0.20 screenshot review triggered three visual-only fixes: uncropped Music hero presentation, illustrated Music mode tiles, and centered icon navigation in a separate dock. Direct-start/stop-on-leave, slider edge fix and semantic API remain unchanged. Actions run 37196929089 PASS.

Next: owner-phone visual smoke v0.20.1. Physical gate remains replacement Nano → final Nano upload → ESP OTA → full acceptance.

## Handoff 2026-10-04 — Android v0.20.2 Music framing/icon hotfix ready

Current Android RC: `0.20.2-music-framing-icon-hotfix-rc1`.

Owner follow-up on v0.20.1 found two remaining visual defects: the Music hero still looked zoomed and M05 «Частота» was too similar to M01 «Градиент». v0.20.2 removes the remaining `centerCrop` photo backdrop, reduces the hero to 250dp with one full `fitCenter` image, and gives M05 a distinct radio-frequency/beacon illustration. API/UART/firmware and Music interaction remain unchanged. Android Verify run 37204187940 PASS.

Next: owner-phone visual smoke v0.20.2. Physical gate remains replacement Nano → final Nano upload → ESP OTA → full acceptance.

## Handoff 2026-10-04 — Android v0.20.3 approved Music room hero ready

Current Android RC: `0.20.3-music-room-hero-rc1`.

Owner approved the wide room composition: sofa visible on the left, compact speaker visible on the right, with blue/amber lighting and room context. `ardu_music_hero.webp` is now 640×360 and rendered by the existing 250dp `fitCenter` hero without `centerCrop`, so the right side is preserved. Android Verify run 37209345952 PASS; API/UART/firmware unchanged.

Next: `git pull` → Android Studio Run → owner-phone visual smoke of the Music hero. Physical gate remains replacement Nano → final Nano upload → ESP OTA → full acceptance.

## Handoff override 2026-10-04 — Android v0.21 / ESP OTA next

Canonical current status is `STATUS.md`.

- replacement Nano numeric UART PING: PASS (`1 → O 1`);
- final ESP v1 local compile: PASS;
- physical next step: OTA `esp8266_ardu_v1.ino`, then release acceptance;
- Android source: `0.21-ambient-homehub-rc1`;
- software next check: owner-phone visual smoke of Ambient Home Hub.

## Handoff override 2026-10-04 — Android v0.22 / RTC sync next

Canonical state is in `STATUS.md`.

- final ESP `ARDU_ESP_V1` OTA: PASS;
- physical `/api/status` + `/api/settings`: PASS;
- current physical blocker: DS3231 invalid time; sync RTC next;
- Android source: `0.22-night-alarm-homehub-rc1`;
- all five normal user tabs now use the approved premium Home Hub/Focus language;
- next Android check: Night + Alarm phone visual smoke.

## Handoff override 2026-10-04 — real Android connection next

- final ESP/Nano Wi-Fi baseline: PASS;
- RTC: PASS;
- L01 OFF/ON repeated semantic regression: PASS;
- current real device IP: `192.168.0.4`;
- Android source: `0.22-night-alarm-homehub-rc1`;
- next: physical phone → same Wi-Fi → Settings → Connection → `192.168.0.4` → save/reconnect → verify Online + real state.

## Handoff override 2026-10-04 — v0.23 visual parity with rollback

- real Android ↔ real ARDU connection: PASS by owner video;
- previous UI safely archived at `archive/android-v0.22-homehub-2026-10-04`;
- current Android source: `0.23-concept-parity-rc1`;
- firmware/API/UART unchanged;
- next: `git pull` → Run → real-phone visual/function smoke.

## Handoff override 2026-10-05 — routerless reserve-ready v1

- Station remains primary, but ESP/Android source now includes `ARDU-DIRECT` fallback at `192.168.4.1`;
- direct-mode source is implemented but not yet physically flashed/accepted;
- final v1 is installed without a battery;
- before ceiling mounting install the accessible USB-C PD BACKUP input and internal 15→5 V reserve path;
- external battery is an optional later accessory; no internal charger/battery.

## Handoff override 2026-10-07 — backup branch cancelled

- owner cancelled accumulator/emergency backup power completely (D-100);
- do not install or buy BACKUP/EXT power hardware, HUSB238, reserve DC/DC, source relay, MAINS_SENSE or emergency ring-profile parts;
- Nano/ESP/Android backup-only source changes were reverted;
- final v1 uses the normal Class II 5-V PSU and mirrored D6/D7 rings;
- Nano USB-C is service/programming only;
- `ARDU-DIRECT` remains in scope as a separate router-less Wi-Fi feature and still needs physical smoke.

## Handoff override 2026-10-07 — v0.22 UI restored

Canonical Android: `0.22.1-homehub-restored-rc1`.

- v0.23 visual experiment rejected by owner;
- v0.22 visual files restored in `main`;
- ARDU-DIRECT support retained;
- battery/backup branch remains cancelled;
- next: Run restored main → ARDU-DIRECT physical smoke → normal two-ring power acceptance.

## Handoff override 2026-10-08 — D-104 Ambient preset concept

**РЕШЕНИЕ:** F01 остаётся в будущем user-facing Ambient; F02/F03 больше не нужны.
**ИДЕЯ:** 12 атмосферных сцен + 4 compact renderer families + индивидуальная яркость/динамика, подробно в `04_Прошивка/AMBIENT_PRESETS_CONCEPT.md`.

Никаких новых frozen P IDs, API/UART или EEPROM форматов. Код Android/Nano/ESP в этом шаге не менялся; F02/F03 всё ещё существуют в source. Следующий практический шаг остаётся визуальной проверкой Ambient hero в эмуляторе Android v0.22.5.

## Handoff override 2026-10-08 — Ambient visual accepted; implementation plan

- Owner accepted all current Android page hero images («Фон», «Ночь», «Будильник»). Android source still `0.22.5-ambient-hero-hotfix-rc1`.
- Canonical implementation roadmap: `04_Прошивка/AMBIENT_PRESETS_IMPLEMENTATION_PLAN.md`. Documentation only; no new firmware / app code / API / IDs / EEPROM changes.
- D-104 stays: future Ambient UI = manual F01 + proposed atmospheric preset cards; hide F02/F03 only after supported migration. P01…P12 are provisional, P12 open.
- Next coding gate only on separate owner command: approve scope and catalog, compile-size/EEPROM baseline, then P01/P04/P05 before adding more.
- `FINALIZATION_PLAN.md` release protections and unfinished ARDU-DIRECT/two-ring physical acceptance remain in force.

## Handoff override 2026-10-08 — three Ambient software renderers CI PASS

- Explicit owner command initiated implementation, not just documentation.
- `04_Прошивка/nano_ardu_v1/ambient_preset_probe.h` now contains 3 actual prototype LED renderers: Aurora (P01), Cosmos (P04), Fireplace (P05). Special compile flag only, default firmware unchanged.
- [Arduino Verify 37807204353](https://github.com/dronrome1245/ARDU/actions/runs/37807204353): host tests and two full Nano variants PASS. Default 28690 Flash / 1234 SRAM; experimental 29312 Flash / 1234 SRAM, 128 Flash bytes above 95% target.
- No Nano/ESP uploads, no changes to Android/APIs/UART/EEPROM; real ring visual acceptance pending.
- Next: reduce/prove Flash/stack budget, then explicitly agreed **full Nano RC** hardware test. Do not use experimental standalone upload.
- Canonical detail: `04_Прошивка/AMBIENT_PRESETS_LAB_R1.md`; G0 catalog including P12 not yet frozen.

## Handoff override 2026-10-08 — complete Nano Ambient PREVIEW RC1 for hardware check

- Source: `04_Прошивка/nano_ambient_preview_rc1/nano_ambient_preview_rc1.ino` + local renderer header, CI-copy matched to full Nano v1. Android F01 tile launches P01/P04/P05/legacy F01 preview cycle; default Nano and F02/F03 semantics unchanged.
- [CI run 37809369365](https://github.com/dronrome1245/ARDU/actions/runs/37809369365) PASS: preview Flash 29376, globals 1234, self-contained Arduino sketch, [HEX](https://github.com/dronrome1245/ARDU/actions/runs/37809369365/artifacts/11564965835).
- Physical upload **not done**; next: `04_Прошивка/AMBIENT_PRESETS_PREVIEW_RC1_TEST.md`. Soft 95% Flash target exceeded by 192B; hard max met, device runtime tests pending.

## Handoff override 2026-10-08 — single-file Ambient Preview RC2

- Owner Windows Arduino IDE failed at missing `ambient_preset_probe.h` in RC1 despite header being in the same folder; root cause not verified.
- New source `04_Прошивка/nano_ambient_preview_rc2/nano_ambient_preview_rc2.ino` has full Nano v1 and inline three scene renderers, NO extra local .h. CI [37814719230](https://github.com/dronrome1245/ARDU/actions/runs/37814719230) passed truly isolated 1-file compilation, 29376 Flash / 1234 SRAM globals; [HEX](https://github.com/dronrome1245/ARDU/actions/runs/37814719230/artifacts/11567275089).
- Next owner gate: `04_Прошивка/AMBIENT_PRESETS_PREVIEW_RC2_TEST.md`, first Windows Verify, then safe Upload + UART recovery + actual ring visual test. RC1 is superseded for physical testing; no hardware acceptance yet.

## Handoff override 2026-10-08 — integrated Ambient12 + protected ARDU-DIRECT

D-109 supersedes previous idea-only catalog: full Nano scene engine P01..P12 / F01 manual, ESP v2 with private-header Station OTA and WPA2 ARDU-DIRECT, Android Home Hub v0.22.6 scene controls. Source/CI green: [Nano 37820974644](https://github.com/dronrome1245/ARDU/actions/runs/37820974644), [ESP 37820404281](https://github.com/dronrome1245/ARDU/actions/runs/37820404281), [Android 37819918951](https://github.com/dronrome1245/ARDU/actions/runs/37819918951). Owner **has not yet flashed new ESP/Nano or verified direct Wi-Fi**.

Next steps strictly in `ARDU_AMBIENT12_RELEASE_CANDIDATE.md`: fill ignored ESP wifi_secrets.h (4 private values) and upload ESP v2 OTA first while home Station works, validate old Nano/L01/status, then Nano v2 USB/Old Bootloader safely, Android v0.22.6, direct-mode and two-ring power/stack acceptance. Retired F02/F03 numeric IDs reserved; old v1 binaries retained as rollback.

## Handoff override — ESP v2 R2 now self-contained manual Wi-Fi credentials (2026-10-08)

Owner rejects `wifi_secrets.h`; ESP `esp8266_ardu_v2.ino` now has four editable macros for home SSID/Wi-Fi, future OTA and WPA2 ARDU-DIRECT pass. One .ino; v2 extra headers/templates deleted. [ESP CI 37823238584](https://github.com/dronrome1245/ARDU/actions/runs/37823238584) PASS isolated one-file with dummy credentials + intentional reject of defaults. Real secrets must not enter Git. Follow `ARDU_AMBIENT12_RELEASE_CANDIDATE.md` to Verify then owner-side OTA. Hardware tests pending.

## Handoff override 2026-10-08 — physical ESP v2 OTA firmware PASS

Owner posted physical ESP HTTP ping: `fw=ARDU_ESP_V2_AMBIENT12`, Station Wi-Fi true at `192.168.0.4`, `rssi=-57`, OTA ready port 8266, SoftAP false (expected in Station). ESP v2 R2 **is installed and running**. Device status/UART link to old Nano and ARDU-DIRECT failover **not yet confirmed**. Next read `/api/status` and `/api/ambient/presets`, then full Nano v2 hardware gate per `ARDU_AMBIENT12_RELEASE_CANDIDATE.md`. Do not reflash ESP just because network Serial Monitor failed to open.

## Handoff override 2026-10-08 — approved twelve-photo Ambient Android UI source and CI PASS

All twelve owner-approved P01..P12 images were converted to compact 192×192 WebP and uploaded as binary Git assets in `android_app_r1/app/src/main/res/drawable-nodpi`. The Android «Фон» page now draws a four-column, three-row photo grid, no more text-only P05..P12; version `0.22.7-ambient12-photo-tiles-rc1` / code 30, preserving approved Home Hub heroes and scene HTTP behavior. [CI 37838263956](https://github.com/dronrome1245/ARDU/actions/runs/37838263956) PASS, [debug APK](https://github.com/dronrome1245/ARDU/actions/runs/37838263956/artifacts/11576287564). Next owner step: `git pull` → Android Studio Run → screenshot/visual test of all thumbnails. No ESP/Nano flash needed for assets. Nano/ESP scene API already returned P01 applied persisted per owner, but full hardware scene/current/ARDU-DIRECT acceptance still pending.

## Handoff override — Android offline/readback UI corrections 2026-10-09

Owner visual walkthrough verified all 12 photo assets load on the phone but showed «Нет связи» and no LED strip. Android `0.22.8-ux-readback-rc1` (code31) D-112 fixes false initial values, offline command/preview, scroll offset, makes P01..P12 photo grid primary, adds Music start/stop and Night/Alarm safety/clarity. [CI](https://github.com/dronrome1245/ARDU/actions/runs/37930295301). Next: `git pull` → Android Studio Run and record offline + connected Nano smoke; no Nano/ESP reflash for Android UI. Hardware/44+44/direct-mode gates remain open.

## Handoff override — Android 0.22.9 keepalive and service captions (2026-10-09)

Owner v0.22.8 video shows online ESP v2 + Nano v2, twelve P tiles, screen reports 4500 mA (not measured load). Reported stale `Онлайн` when power removed is due to lack of periodic polling. Android 0.22.9/code32 now polls ESP+Nano every 5s only in foreground, safely distinguishes ESP-only/no link/reconnect, and adds Settings toggle for nonessential technical work captions (default OFF, errors visible). Primary Music Start contrast repaired. [CI PASS](https://github.com/dronrome1245/ARDU/actions/runs/37958078703). Next owner gate: pull-run, power ARDU off/on and watch status/reconnect, test captions switch. Nano `dynamics` still 3 speeds; fix with separate firmware compile/visual gate. No hardware flashed this iteration.

## Handoff 2026-10-09 — Android 0.22.9 owner-confirmed Online/Offline

Owner reports Online/Offline automatic status working on real phone in Android `0.22.9`. Video `18429670918804.mp4` (~63s) shows Light/Music modes and the online status; direct off-on moment is not visible and exact latency was not measured. Status heartbeat practical gate closed by owner report, not as independent capture proof. Next: separate Nano `renderPreset` continuous dynamics source/size test; 44-LED visual acceptance, current/stack and ARDU-DIRECT still open. Settings message visibility and HTTP-error/readback need later phone regression.

## Handoff override 2026-10-09 — Nano Ambient12 R2 continuous preset speed, source/CI PASS

D-114 создан новый **полный однофайловый** Nano `04_Прошивка/nano_ambient12_v2/nano_ambient12_v2.ino` (boot `ARDU1 3`) с непрерывной динамикой P01..P12; P11 дыхание ~16..4 с. Установленная предыдущая Nano пока не менялась. [Arduino Verify PASS](https://github.com/dronrome1245/ARDU/actions/runs/37966945125): old R1 29306 Flash/1282 globals, R2 29336 Flash/1286 globals, one full v2 HEX artifact. Source+host test PASS не заменяют real LED/stack/питание. Следующий шаг владельца — `git pull`, безопасный USB Upload Nano R2 при временно изолированном ESP TX→Nano D0 (при снятом питании), затем только один 44-LED канал и P11/P01/P03/P05/P12 скорость 0/128/255. Подробно `04_Прошивка/AMBIENT12_SPEED_R2_TEST.md`. ESP и Android не прошивать из-за скорости; rollback к `nano_ambient12_v1`. Лимит текущего стенда до мощностного теста ≤3000 мА.

## Handoff override — 2026-10-09 Nano R4 all-scene animated candidate

По команде владельца все 12 P-пресетов переработаны **одной новой полной Nano**. `nano_ambient12_v4/nano_ambient12_v4.ino` сохраняет утверждённое P11 «Дыхание» из R3 и добавляет заметное движение P01..P10/P12, не меняя ESP/Android/UART/EEPROM. [GitHub Arduino Verify https://github.com/dronrome1245/ARDU/actions/runs/37975908088](https://github.com/dronrome1245/ARDU/actions/runs/37975908088) PASS: реальные кадры 44 HSV LED на концах шкалы динамики для каждой сцены, один файл Nano compile, **29410/30720 Flash, 1286/2048 globals SRAM**, отдельный HEX, boot `ARDU1 5`. Устройство не прошивали через инструмент; следующий gate владельца — безопасный один USB Upload Nano R4, проверка всех P01..P12 на одной 44-LED ленте по `04_Прошивка/AMBIENT12_ALL_SCENES_R4_TEST.md`; при неуспехе откат к полной R3. 44+44 ток/нагрев/stack, ARDU-DIRECT остаются open; лимит ≤3000мА.

## Handoff override — 2026-10-09, Android 0.22.10 native launcher icon / readback (D-117)

Владелец попросил заменить значок ARDU на рабочем столе телефона; в AndroidManifest v0.22.9 icon/roundIcon отсутствовали. Android v0.22.10 versionCode33 добавляет настоящий APK `@mipmap/ic_launcher`, круглый `@mipmap/ic_launcher_round` и monochrome Android 13+; тёмный фон, мятное кольцо + белая A, жёлтый световой акцент, approved UI не меняется. Одновременно улучшены HTTP GET retry без опасного повторения POST, отделён подтверждённый Nano write от сбоя последующего readback; CLAPCAL saved UI session после подтверждения SAVE не открывается вновь по Nano finished. [CI https://github.com/dronrome1245/ARDU/actions/runs/37981648045](https://github.com/dronrome1245/ARDU/actions/runs/37981648045) PASS: Kotlin tests, XML static проверки, debug APK `ardu-android-02210-launcher-debug-apk`; физическая приёмка нового значка и поведения приложения ещё pending. Git pull → Android Studio Run (тот же applicationId). Nano R4 фон уже owner motion PASS, ESP без изменений. Продолжают быть открыты ARDU-DIRECT/два кольца/питание/stack/Class II.

## Handoff 2026-10-10 — Android 0.22.11, four UX corrections D-118

По видео владельца `18437905058452.mp4` исправлен Android-only: только 12 фотопресетов на «Фон» (скрыта legacy F01 ручная настройка; ON/OFF и P brightness/dynamics доступны), четыре выделяющиеся M05/M08 подрежима на всю ширину **над** слайдерами, пояснение настоящего music background **brightness vs fixed hue**, заметно разные Evening 2700K/115 (~45%) и Cinema 1800K/18 (~7%) плюс разные warm/cool thumbnail grades. Light Guests/Reading, Nano Ambient12 R4, ESP v2, UART/API/EEPROM — unchanged. Версия Android 0.22.11/code34, [CI PASS](https://github.com/dronrome1245/ARDU/actions/runs/38035137524), debug APK `ardu-android-02211-presets-music-scenes-debug-apk`.

Следующий gate владельца: `cd C:\ARDU` → `git pull` → Android Studio Run, визуальный тест Android 0.22.11, поочерёдное подтверждение 4 требований на телефоне и сравнение Evening/Cinema на лампе. Новый music background color регулятор **не реализован** — для независимого цвета требуется отдельное решение firmware/API. Остаток v1: Mxx/Night/Alarm regression, scene EEPROM persistence, ARDU-DIRECT, 44+44 power/heat/stack, Class II финальный PSU.

2026-10-17 D-126: ESP V4 Nano remote programming source/CI ready; add GPIO4→BC548→Nano RESET service line, then physical write+verify gate. See `02_Архитектура_и_решения/NANO_REMOTE_FLASH.md`.
