dronrome1245/ARDU/STATUS.md

# Статус проекта ARDU

Дата состояния: 2026-11-14

## Текущий этап

**2026-11-14 — D-128, UX для детской комнаты — source implementation, hardware GATE OPEN.** Пользователь утвердил 6 изменений: вкладки не отправляют режимы; ночник плавно загорается/гаснет; автономный будильник разделён на Пн–Пт и Сб–Вс; после alarm-досветки есть настраиваемое auto-off; 4 избранные фоновые сцены; «Кино» → «Отдых». В main обновлён Android `0.22.16-family-schedule-rc1` (read-only tabs, избранное 4×, теплый «Отдых», family alarm controls со строгим capability gate), отдельно добавлены source-кандидаты Nano `04_Прошивка/nano_warm_dawn_v7/nano_warm_dawn_v7.ino` (boot ARDU1 8, не залита в устройство) и ESP `05_WiFi_и_приложение/esp8266_family_v5/esp8266_family_v5.ino` (не установлена на ESP). **CI PASS**: Nano R7/ESP V5 [run 43595155594](https://github.com/dronrome1245/ARDU/actions/runs/43595155594), Android 0.22.16 [run 43593418689](https://github.com/dronrome1245/ARDU/actions/runs/43593418689). **Nano R7: 30 712/30 720 B flash, 1 076/2 048 B global SRAM; flash reserve всего 8 байт!** CI строго проверяет аппаратный предел и отдельно предупреждает о превышении прежнего резервного порога 30 300 B; новые функции без оптимизации Nano не добавлять. Аппаратных тестов новых Night/Alarm семантик нет. Следующий шаг — безопасно установить сначала ESP V5 (локальные приватные credentials), затем Nano R7 с **полным AVRDUDE write+verify**, предварительно сохранив параметры; проверить автономные сценарии по `04_Прошивка/FAMILY_R7_ACCEPTANCE.md`. Старую R6 оставить для rollback. Прежний электрический gate 44+44/Class II не снят.

**2026-11-07 — кольцо B СВЕТИТСЯ, ошибка подключения DATA исправлена:** пользователь подтвердил «ты прав. поменял все горит» после диагностики по маркировке стрелок WS2812B и рекомендации перенести DATA на вход DIN вместо DOUT. Это подтверждает **свечение кольца B**, 5 В ранее измерены непосредственно на ленте; **кольцо A было отключено**, совместный 44+44 test, current/voltage-drop/тепло и финальная электробезопасность не подтверждены. **Потолочный монтаж НЕ разрешён до** подтверждения Class II БП 5В/6А (S-30-5 с PE без потолочного PE недопустим), защиты соединений 230 В, подключения/синхронной проверки обоих колец под нагрузкой, отсутствия просадки/нагрева и надёжной фиксации проводов. Текущий предел по последнему `/api/status`: 500 mA. Следующий практический шаг — установить, какой БП реально будет использоваться для потолка.

**2026-11-07 — второй LED-круг не светится, первый отключён (со слов владельца):** Nano R6 содержит независимые выходы FastLED D6/D7 (по 44 LED, общий кадр); отключение кольца A само по себе не гасит B. Владелец сообщил, что физически подключённое кольцо B пока не светится, а A отключено. Пока неизвестны состояние режима L01, наличие 5 В прямо на кольце B, правильность DIN/DOUT, GND и соединения D7 (220–470 Ом). Подготовлен первый безопасный gate: `POST /api/light/settings {"enabled":true,"brightness":64}` → `GET /api/status`; при подтверждённом режиме `light` и отсутствии свечения — измерить только DC +5V/GND непосредственно у кольца B, без доступа к открытой сети 230В. Не прошивать Nano и не менять DATA при питании.

**2026-11-07 — физически подключено второе кольцо (сообщение владельца, без hardware PASS):** владелец сообщил «я подключил второе кольцо». Nano R6 уже реализует **2×44 WS2812B, D6/D7 зеркально**; `/api/status` перед новым подключением подтверждал `current_limit_ma=3000`. Показания напряжения на дальнем кольце, фактическое свечение 44+44, ток/нагрев, наличие 220–470 Ω DATA, bulk 1000 µF и класс текущего БП пока **не представлены**. Следующий gate — двухкольцевой низковольтный тест: при безопасном источнике и отсутствии КЗ временно `POST /api/system/current-limit {"milliamps":500}`, проверить оба кольца, измерить +5V/GND непосредственно на B под нагрузкой, последовательно вернуть не более 3000 mA после проверки, проконтролировать стабильность и нагрев. **Не выдавать за подтверждённый 2-ring PASS или безопасную потолочную установку**. На потолочном вводе нет PE; металлический S-30-5 не использовать как финальный БП.

**2026-11-07 — Nano R6 по Wi-Fi: write+verify+application PASS (D-127 закрыт аппаратно).** Владелец запустил `tools/flash_nano_over_wifi.ps1` с локально собранным `nano_warm_dawn_v6.ino.hex` (29 378 B), **без** `-VerifyOnly`, через ESP `ARDU_ESP_V4_NANO_REMOTE_R3_DIAG` / `net:192.168.0.4:3280`, AVRDUDE 8.0-arduino.1 / ATmega328P Old Bootloader 57600 baud. `Writing 100% 13.92 s`; `Reading 100% 12.47 s`; **`29378 bytes of flash verified`**, AVRDUDE exit 0. ESP: `last_result=disconnected`, `active=false`, `uart_overrun=false`, `uart_rx_error=false`, RX=512, TCP→UART=33648 B, UART→TCP=31450 B, max TCP=133, max UART=102. Post-flash `/api/status`: **PASS** `mode=light`, `rtc_valid=true`, `current_limit_ma=3000`. Nano физически установлена и проверена, снимать её с потолка не потребовалось. **Отдельно остаётся** функциональная аппаратная приёмка Night D-125 (ON/OFF/manual/DAWN/restart): успешная запись ещё не доказывает все сценарии. Предыдущий `-VerifyOnly` mismatch относился к старому содержимому и локальному HEX до этой установки, не к нынешнему проверенному R6. Следующий шаг — не перепрошивать, а проверить D-125 через API или при доступности лампы, восстановив исходные настройки.

**2026-11-07 — RTC восстановлен через Wi-Fi:** владелец отправил `POST /api/time/sync` с локальными датой/временем Windows; ответ `ok:true, applied:true`. Повторный `GET /api/time` вернул `ok:true, valid:true, date:2026-11-07, time:21:25:28`, Nano `D 4 1 2026 11 7 21 25 28`. Значит DS3231 принимает запись и возвращает валидное время. Предыдущий `D 4 0` устранён синхронизацией, первопричина сброса/флага потери хода не установлена; сохранение RTC без питания отдельно не проверено. **Следующий gate:** прочитать `/api/settings` перед изменениями, затем проверить manual Night и события расписания D-125 поэтапно.

**2026-11-07 — RTC gate уточнён:** пользовательский `GET /api/time` вернул `{"ok":true,"valid":false,"nano":"D 4 0"}`; Nano доступна по UART, но часы DS3231 невалидны для Night schedule/Dawn. В `nano_warm_dawn_v6` `rtcValidNow()` требует I2C ACK DS3231, чтение status 0x0F без OSF (bit7), и корректные календарные регистры; причина пока не различима по `D 4 0`. Следующее обратимое действие — синхронизировать RTC через `POST /api/time/sync` **с правильными локальными часами Windows** и повторить GET `/api/time`. При неудаче не менять прошивки; локализовать DS3231/I2C/питание/батарею. Перед синхронизацией учесть возможное немедленное срабатывание расписания Night.

**2026-11-07 — После verify-only Nano HTTP recovered, но RTC INVALID:** пользовательский `GET http://192.168.0.4/api/status` вернул `ok:true`, `mode:light`, `rtc_valid:false`, `current_limit_ma:3000`, `uptime_ms:214617`, Nano отвечает по UART (`D 2 1 0 0 70 500 3000 1 0 0 214617`). Имеется **блокер автоматического расписания Night D-125 / Alarm** — до восстановления валидного RTC не проводить временные тесты, не писать Nano. Ближайшая диагностика: `GET /api/time`, затем при необходимости отдельная синхронизация DS3231 после анализа ответа.

**2026-11-07 — R3 DIAG physical verify-only:** пользователь подтвердил физический ESP `ARDU_ESP_V4_NANO_REMOTE_R3_DIAG`, Station `192.168.0.4`, `nano_remote_flash:true`. С локально скомпилированным `nano_warm_dawn_v6.ino.hex` (29 378 B) скрипт `-VerifyOnly` смог выполнить полное чтение AVRDUDE `Reading 100% 11.29 s` без STK500 sync loss; R3 `uart_overrun=false`, `uart_rx_error=false`, UART RX=512 B, TCP→UART=2129 B, UART→TCP=30398 B, max TCP=22, max UART=114, last_result=`disconnected`. Однако **сравнение Flash FAIL**: mismatch начиная с адреса `0x002e` (`device 0x88` vs `input 0xf5`). Ранее записывался другой HEX размером 29 722 B; разница сборок является правдоподобным объяснением, но не подтверждена. **Нельзя объявлять full byte-for-byte verify PASS** и нельзя считать готовым механизм нового Wi-Fi write+verify. Следующий шаг: прочитать `/api/status`, `/api/time`, `/api/settings`, затем проверить Night D-125 функционально, сохранив настройки; повторно не писать Nano до выяснения различий и проверки транспорта записи. Исходники Nano/ESP не менялись.

**2026-11-07 — D-125 Night / Wi-Fi verification gate:** источник Nano R6 с событийным расписанием уже присутствует в main, на устройстве ранее зарегистрирован startup `ARDU1 7`, но полного AVRDUDE verify и функционального hardware PASS пока нет. Инструмент `tools/flash_nano_over_wifi.ps1` получил `-VerifyOnly` (только readback-сравнение HEX, без записи) и автоматический вывод ESP R3 UART/TCP диагностик даже после ошибки. Добавлен `04_Прошивка/NIGHT_R6_WIFI_ACCEPTANCE.md` со сценариями ON/OFF/manual/DAWN/restart. **Следующий аппаратный шаг:** установить ESP V4 R3 DIAG через существующий OTA → проверить готовый Nano R6 HEX командой `-VerifyOnly` → сохранить UART counters/errors и результат `/api/status` → затем проверить сценарии Night. До результата verify Nano не перезаписывать. Исходники ESP/Nano в этой итерации не менялись, устройство удалённо не прошивалось.

**2026-10-17 — D-127 / R6 фактически запускается, но полный Wi-Fi verify всё ещё FAIL; подготовлен ESP V4 R3 DIAG.** На физическом ESP R2 повторный Nano upload снова дал `write 29 722 B = 100%`, а verify сорвался почти сразу. Отдельный `flash:v:` в новом bootloader-сеансе дошёл до 48% и потерял sync с тем же `expected 0x14`, затем эксперимент с 64-byte flash page дошёл только до 7%; значит переход write→verify и размер страницы не являются достаточным объяснением. После холодного старта Nano штатно отвечает `/api/status`, а аппаратный reset-only сеанс дал сырую startup-строку `�ARDU1 7` + `V 9 1`, что является физическим доказательством запуска Nano R6/FW_REV7, но **не заменяет обязательный byte-for-byte AVRDUDE verify**. R3 DIAG сохраняет R2 transport и добавляет latch `Serial.hasOverrun()/hasRxError()`, счётчики байтов и максимальную очередь UART/TCP в `/api/system/nano-program/status`; также фильтрует residual `D ...` из `/api/events` и очищает мусорный префикс перед `ARDU1`. Следующий gate: OTA R3 DIAG → только verify → сразу status diagnostics; Nano больше не записывать до этого результата.

**2026-10-17 — D-127 / первый реальный Nano Wi-Fi upload: WRITE 100%, VERIFY FAIL на ~22%; готов ESP V4 R2 lossless bridge, повторный physical gate pending.** На фактическом железе `avrdude 8.0-arduino.1` через `net:192.168.0.4:3280`, `arduino`, 57600 успешно синхронизировался с ATmega328P (`1E 95 0F`) и записал 29 722 B Nano R6 до 100%. На фазе verify чтение дошло примерно до 22% и протокол потерял синхронизацию (`expected 0x14`, получены `0xe6/0xff/0xc4`). Это **не hardware PASS**: R6 нельзя считать подтверждённой без полного readback verify. В ESP V4 R2 мост больше не игнорирует частичные `write()`: TCP↔UART передаётся до полного количества байт, UART→TCP читает неблокирующим `HardwareSerial::read`, RX buffer programming mode = 512 B, stall имеет явный fail вместо молчаливой потери. AVRDUDE verify остаётся обязательным; `-V` запрещён. Следующий gate: OTA V4 R2 → повтор того же Nano R6 HEX → требовать полный `write + verify + /api/status`.

**2026-10-17 — D-126 / удалённая прошивка Nano: ESP V4 SOURCE + compile gate PASS; hardware gate pending.** Подготовлен `esp8266_nano_remote_v4`: существующий ESP ArduinoOTA сохраняется, дополнительно Station-only service arm с текущим OTA password и IP binding открывает TCP 3280; при подключении стандартного AVRDUDE ESP переключает общий UART на Nano Old Bootloader 57600 и через GPIO4/NPN аппаратно сбрасывает Nano. Добавлен `tools/flash_nano_over_wifi.ps1`. Требуется один раз физически собрать reset stage из имеющихся BC548 + 1,5 kΩ + 4,7 kΩ; после первого реального write+verify будущие Nano updates можно выполнять по Wi-Fi без USB-доступа. Подробно: `02_Архитектура_и_решения/NANO_REMOTE_FLASH.md`.

**2026-10-17 — D-125 / Nano R6 Night schedule semantics: SOURCE + isolated Arduino compile gate PASS в one-shot builder; физическая загрузка R6 pending.** Владелец уточнил конечную модель Night: расписание задаёт два автоматических события (ON/OFF), но не ограничивает ручной Night временным окном. Подготовлен `04_Прошивка/nano_warm_dawn_v6/nano_warm_dawn_v6.ino`, boot `ARDU1 7`: `schedule_on` автоматически переводит в NIGHT (кроме активного DAWN), `schedule_off` выключает NIGHT, но не трогает вручную выбранный LIGHT/MUSIC/AMBIENT; после автоматического ON ручная смена режима разрешена до следующей границы; ручной NIGHT работает 24/7; при загрузке внутри окна расписания NIGHT применяется сразу. Установленная на потолке Nano остаётся R5/FW_REV6 до следующего физического USB-доступа. ESP/Android менять для этой семантики не требуется.

**2026-10-17 — физический RTC/Dawn partial PASS на установленной однокольцевой лампе.** Через `192.168.0.4` подтверждены ESP V3, валидный RTC, UART Nano и автономный запуск ускоренного будильника: `mode:dawn`, `dawn_phase:running`, события `V 6` и `V 2 1 60`; владелец визуально подтвердил позднюю яркую фазу. `current_limit_ma` возвращён на 3000. Начало текущей квадратичной яркости визуально очень тёмное; 5-минутное наблюдение подтвердило работающий running-state, но окончательная настройка кривой остаётся отдельной задачей. Также подтверждено ограничение R5: сохранённый `lastTrigger` запрещает второй автоматический alarm в ту же дату.

**2026-10-10 — переход к физическому Ring B 44 LED (D-124): владелец имеет три отдельных проводника 1×1,5 мм², планирует заранее собрать всю низковольтную трассу и только после стендового PASS поднять два корпуса на потолок.** Владелец сообщил «все получилось» о предыдущем пакете Android/ESP/Nano; это **самоотчёт об успехе**, без опубликованных в данном сообщении новых измерений, firmware-ping или доказательства завершения двухкольцевого/сетевого силового теста. **ФАКТ по прошлым измерениям:** расстояние A→B ≈2 м, Nano D6=Ring A, D7=Ring B, по 44 WS2812B; +5 В и GND — раздельные ветви от общего 5-вольтового узла. Новые три проводника владельца идентифицированы только по количеству и номинальному сечению; их фактическая длина, тип жилы (моножила/многопроволочная), изоляция/цвета **не подтверждены**.

**РЕШЕНИЕ монтажа:** три жилы вести только для **низковольтной отдельной ветви** B: `+5V`, `GND`, `Nano D7 → отдельный series resistor 220–470 Ω у контроллера → DATA_B → DIN первого LED кольца B`. DATA вести близко с GND, не с 230 В; питание Ring B параллельно Ring A, **не** от площадок конца первого кольца и не через его DATA OUT. У Ring B можно параллельно подать +5V/GND на начало и конец одной 44-LED ленты, но последний DOUT оставлять открытым. Толстые/жёсткие жилы не нагружать на медные площадки WS2812B: короткие гибкие переходники, механическое крепление и изоляция; местный электролит около 1000 µF ≥6,3 V параллельно +5/GND (полярность проверить), качественные разъёмные соединения. Резистор D6 уже предусмотрен; наличие **второго** 220–470 Ω и **второго** конденсатора не доказано. До питания прозвонка полярности/отсутствия коротких замыканий; сначала низкая яркость/current cap (начать ≤500 мА), затем по измерениям постепенно до ≤3000 мА. Бывшее значение owner `current_limit_ma:3025` потребует снижения до силового теста.

**ЖЁСТКИЙ монтажный gate:** у потолочного вывода нет PE; открытый металлический S-30-5/клемма PE = **только стенд**, не финальная установка. Финальный потолочный источник — надлежащий **Class II / double-insulated** изолированный 230→5 V/6 A с безопасно закрытыми сетевыми соединениями, защитой и разгрузкой кабелей от натяжения; по BOM Mean Well IRM-30-5ST пока в статусе **«докупить»**, покупка/установка владельцем не подтверждена. Старую 230-вольтовую линию ко второму корпусу нельзя использовать в качестве +5/GND/DATA и нельзя оставлять незащищённой; её отключение, изоляция и монтаж сети — квалифицированным электриком при снятом напряжении. **Пока проверки 44+44 питания/нагрева/напряжений и безопасного Class II БП нет — на потолок не поднимать.** Подробная схема/контрольный протокол: [`02_Архитектура_и_решения/RING_B_44LED_МОНТАЖ_И_ПРОВЕРКА.md`](02_Архитектура_и_решения/RING_B_44LED_МОНТАЖ_И_ПРОВЕРКА.md). Физическое подключение B владельцем **ещё не подтверждено**.

**2026-10-10 — Полная source-реализация warm dawn + последний ARDU-DIRECT recovery + плавное затухание glow (D-121…123); hardware acceptance pending.** Пользователь подтвердил постоянный резкий обрыв свечения активной вкладки у бывшей границы капсулы и повторную нестабильность ARDU-DIRECT. Прислал два JSON с физического ESP V2: `/api/ping` содержит `ok:true`, `network_mode:softap`, `softap_active:true`, `ip:192.168.4.1`; `/api/status` содержит `ok:true`, `nano_fw:ARDU_V2`, `mode:dawn`, `rtc_valid:true`, `ambient_preset_selected:P11`, `current_limit_ma:3025`. Это доказывает доступность ESP и Nano **в моменты двух успешных GET**, но **не доказывает стабильность во времени**. После ещё одного FAIL пользователь решил отказаться от идеи Direct; не превращать в бесконечные итерации. По просьбе владельца вместо фиолетового рассвета реализованы 4 редактируемых тёплых профиля: Firmware + API + Android source.

- **Nano R5** `04_Прошивка/nano_warm_dawn_v5/nano_warm_dawn_v5.ino` — полный отдельный однофайловый sketch, boot `ARDU1 6`, warm Kelvin LUT 1800–4000 K; EEPROM DAWN_VER=2 в тех же 8 байтах 16..23, старые HSV значения заменяются безопасными 2000→3600K defaults, alarm time/RTC, P01..P12, audio и прочие EEPROM блоки сохранены. `D 3 3` даёт десятое значение `1` (capability), новый атомарный UART `78 <startStep> <endStep>` (0..110 step=20K), `77` persist. Время будильника — **конец**, а не начало рассвета. CPU flash 29 534 B / global SRAM 1 286 B, [Arduino Verify PASS](https://github.com/dronrome1245/ARDU/actions/runs/38050231423); физический LED PASS pending.
- **ESP V3** `05_WiFi_и_приложение/esp8266_warm_dawn_v3/esp8266_warm_dawn_v3.ino` — полный однофайловый R2-compatible sketch с четырьмя обязательными локальными паролями. [ESP Verify PASS](https://github.com/dronrome1245/ARDU/actions/runs/38050334769). Сетевые запросы STA к роутеру **не повторяются, пока к ARDU-DIRECT подключён хотя бы один клиент** (исключить channel-jumps от 10-секундного STA retry), возвращаются после отключения AP клиентов. API отдаёт `alarm.dawn_kelvin_supported`, `start_kelvin/end_kelvin` только когда Nano сообщает marker=1; новые поля принимаются попарно, валидируются и атомарно пишутся через opcode 78+77. При старой Nano возвращается 409 и старые HSV не подменяются Kelvin.
- **Android 0.22.15**, code38 — 4 `DawnPresets`: «Очень мягкий» 40 мин 1800→3000 K 25%, «Мягкий» 25 мин 1800→3200 K 30%, «Стандарт» 30 мин 2000→3600 K 40%, «Бодрый» 20 мин 2200→4000 K 55%. Индивидуальная настройка длительности/яркости/начального и конечного Kelvin, EEPROM подтверждается чтением Nano через ESP. Если `dawn_kelvin_supported:false`, нельзя включить legacy HSV-рассвет или отправить preset; при этом **выключить ранее включённый старый будильник можно**. Нижний selected glow имеет внутренние radial falloff ≤43% ширины ячейки с нулевой альфой до её края — соседние кнопки не разделены резкой линией. В direct Wi-Fi GET читает `/api/status` отдельно, допускает старые проверенные настройки **только как read-only** при прерванном `/api/settings`, не выдаёт их за свежий ACK; direct timeout GET можно повторить однократно, POST никогда. [Android Verify PASS](https://github.com/dronrome1245/ARDU/actions/runs/38051196760) на code38, включая финальную UI safety правку 38268f6. [Nano PASS](https://github.com/dronrome1245/ARDU/actions/runs/38051196764) и [ESP PASS](https://github.com/dronrome1245/ARDU/actions/runs/38051196756) повторно подтверждены для текущего пакета; APK `ardu-android-02215-warm-dawn-presets-debug-apk` собран. **Физический Android/лампа/SoftAP — pending**.

**Следующий обязательный gate:** `RELEASE_WARM_DAWN_DIRECT_ACCEPTANCE.md`. Сначала сохранить личную ESP-копию с паролями; по домашнему Wi-Fi обновить ESP V3 через OTA (прошивка в GitHub с шаблонными паролями, без подставления локально не загрузится), далее безопасно прошить Nano R5 с помощью USB Arduino IDE / Old Bootloader, вернуть ESP TX→Nano RX, затем `git pull` → Android Studio Run 0.22.15. После `/api/settings` с `dawn_kelvin_supported:true` проверить на лампе preset, ускоренный 1-минутный тест до времени будильника, STOP, холодный рестарт и Direct. В исходном status владельца был **3025 мА** — вернуть `current_limit_ma` ≤3000 через Station до новых силовых тестов. Старые прошивки Nano R4, ESP V2 оставлены для отката; AVR stack/44+44/Final Class II БП отдельно pending. Нельзя считать CI физическим приёмочным PASS.

**2026-10-10 — Android 0.22.13, ARDU-DIRECT transport stabilization и glow без рамки (D-120). SOURCE/CI PASS в `main`, телефон owner gate pending.** Владелец после теста direct сообщил «нестабильно работает» и прислал `18442333063828.mp4` (около 106,7 c). По кадрам в видео: телефон **подключён** к сети `ARDU-DIRECT` без интернета, в приложении указан `192.168.4.1`, статус однажды стал «● Прямое подключение», L01 state был прочитан и OFF отобразился; позднее около 01:17 появилась «● Ошибка данных» / «нет подтверждения команды», состояние Nano снова стало недоступным. Это **частичный physical PASS для AP discovery/HTTP и FAIL для надёжного удержания управления**. По одному видео нельзя определить, был ли причиной Wi-Fi route Android, краткий STA-retry ESP8266, Nano timeout или питание. Не утверждать, что код Android устранил корневую аппаратную причину.

**Android SOURCE:** `0.22.13-direct-stable-borderless-glow-rc1`, versionCode36, [code commit a221172](https://github.com/dronrome1245/ARDU/commit/a2211723729c039d3ee75bad42f91c1a7ab49169). В `NavGlowItemView` сняты glass/capsule fill и stroke, оставлены только выбранные radial mint halo, свет под иконкой/подписью и тонкая свободная нижняя подсветка. В `ArduApiClient` соединение к `192.168.4.1` направляется через найденный `Network` транспорта `TRANSPORT_WIFI` **с IPv4 192.168.4.x**; никаких требований к интернету или ACCESS_FINE_LOCATION/SSID; добавлено только `ACCESS_NETWORK_STATE`. При таком Wi-Fi direct discovery пробует **исключительно** `192.168.4.1`, не перебирает старые Station IP/ardu.local; когда Wi-Fi сменится, Station адреса вновь доступны. В direct увеличен read timeout до минимум 8 сек; повтор mutating POST **запрещён**. В `MainActivity` исключён heartbeat во время команды и её readback; одинаковый путь используется для кнопок и переключения вкладок. При потерянном POST ACK устройство перечитывается **без повторной команды**, ошибка не объявляется подтверждённым применением. Android-only, Nano R4/ESP v2/HTTP/UART/EEPROM не изменены.

**CI:** [Android Verify 38048024255](https://github.com/dronrome1245/ARDU/actions/runs/38048024255) **PASS**: static direct route/glow checks, Kotlin/JUnit, debug APK `ardu-android-02213-direct-borderless-debug-apk` (artifact ID 11668866174). Аппаратную устойчивость нельзя подтвердить сборкой — phone gate по-прежнему открыт. Следующий gate: `git pull` → Android Studio Run 0.22.13, сравнить glow без рамки, затем в ARDU-DIRECT отключить мобильные данные, показать /api/ping и поочерёдно выполнить пять ON/OFF L01 с readback, потом возврат в Station. При повторах ошибок отдельно измерить /api/ping vs /api/status браузером на телефоне (ESP link vs Nano UART), прежде чем менять ESP или питание. Протокол в `05_WiFi_и_приложение/ARDU_DIRECT_STATION_AP_TEST.md`.

**2026-10-10 — Android 0.22.12, neon glow нижней навигации (D-119), source/CI PASS, phone gate ожидается.** Владелец сообщил «проверил 0.22.11» без результатов по отдельным ранее открытым визуальным пунктам и приложил эталон нижней панели: активный tab в полупрозрачной тёмной капсуле с мятно-голубым мягким ореолом, подчёркнутым краем, светящимися иконкой и подписью. Реализовано в одном Android-пакете `0.22.12-nav-glow-rc1`, versionCode **35**: пять равных нижних `NavGlowItemView`, glow только для выбранной вкладки, прежние 5 SVG/vector icons и подписи, полная область вкладки реагирует на касание, inactive остаётся нейтральным. `showSection()` задаёт selected для icon/text/container. Kotlin `NavGlowItemView.kt` рисует translucent glass capsule, двухслойный mint/cyan radial halo и тонкую нижнюю линию без bitmap или blur-rendering зависимости. Управление Nano/ESP, режимы и HTTP API **не менялись**.

**Source commits:** [nav glow 351fb4f](https://github.com/dronrome1245/ARDU/commit/351fb4f97d1800572694430e16b475145fbf97cd), [CI path fix 765b51e](https://github.com/dronrome1245/ARDU/commit/765b51e183c58b433862e3bdaef8c1615f755aa9), [stable redraw alpha 92980e5](https://github.com/dronrome1245/ARDU/commit/92980e570aa2f80f6c9298c72c34c8686e431085). [Android Verify PASS 38046617214](https://github.com/dronrome1245/ARDU/actions/runs/38046617214) — пять равных glow tabs, Kotlin/JUnit unit tests, debug APK `ardu-android-02212-nav-glow-debug-apk` (artifact ID 11668260250). **Source/CI PASS не означает физический visual PASS.** **Смартфон v0.22.12 и вид свечения пока не проверены владельцем.**

**ARDU-DIRECT gate:** просмотр ESP v2 source подтверждает `ARDU-DIRECT` WPA2 fallback при недоступной Station (после начальной попытки подключения ≤15 с), `192.168.4.1`, `network_mode:softap`, `softap_active:true`; Android `ArduApiClient.ping()` имеет кандидата `http://192.168.4.1`. Аппаратный PASS не заявлен. Точный owner-test: `05_WiFi_и_приложение/ARDU_DIRECT_STATION_AP_TEST.md`: Station→выкл. роутера (лампа остаётся под питанием)→ARDU-DIRECT→контрольный /api/ping→управление→вкл. роутера→Station. Пароль SoftAP хранится только в личной копии ESP .ino, не в GitHub.

**Следующее действие:** Android Studio `cd C:\ARDU && git pull` → Run 0.22.12, проверить selected glow всех 5 табов без прежнего квадратного фона и без мерцания; затем провести описанный **реальный** ARDU-DIRECT тест и прислать ping-response из SoftAP (без пароля). Для Android glow **не перепрошивать Nano/ESP**. Прочие gates: full Music/L01/Night/Alarm regression, 44+44 питание/нагрев/stack, Class II PSU; current limit ≤3000 мА до замеров.

**2026-10-10 — Android 0.22.11, видео владельца и четыре UX-коррекции (D-118); CI PASS, phone acceptance pending.** Владелец передал `18437905058452.mp4` (≈6:09, портрет 578×1280) и потребовал: (1) убрать дублирующий F01/ручной цвет со страницы «Фон», оставив 12 пресетов; (2) выровнять четыре кнопки подрежимов M05/M08 по всей ширине **над** ползунками и усилить выделение; (3) пояснить, где выбирается цвет фоновых светодиодов в музыке; (4) существенно различить «Вечер» и «Кино». Видео демонстрирует близкие световые фото-миниатюры вечер/кино, узкий ряд подрежимов под слайдерами и отдельный F01 внизу «Фон»; запись экрана не доказывает физические изменения ленты.

**РЕШЕНИЕ / source:** новый Android `0.22.11-presets-submodes-scene-contrast-rc1`, versionCode **34**: F01, HSV и старый Auto panel сохранены в XML только скрытыми для старых bindings, но **не представлены пользователю**; видимые 12 WebP-сцен, brightness/dynamics и кнопки ON/OFF остались, ON не активирует старый F01, а повторно выбирает сохранённый Pxx. UART/HTTP/EEPROM F01 не удалены. Подрежимы `3 полосы / Низ / Средние / Верх` занимают четыре равные ширины в карточке Music над эффектными ползунками; текущий `cfg.submode` из Nano выделяется ярко-мятной заливкой и тёмным шрифтом. Music `background_brightness` в действующем Nano — **только яркость**, не цвет: у M01/M02/M05/M08 фон фиолетовый, M03/M04 цвета LOW/MID/HIGH, M09 backgroundBrightness не используется и поэтому скрыт. Android теперь показывает честную подсказку, отдельный регулятор hue не рисуется. Быстрые сцены **Вечер = 2700 K / 115 из 255 ≈45%**, **Кино = 1800 K / 18 из 255 ≈7%** (ранее 2200 K/38 и 2700 K/90), фотокарточки получили разные тёплую/тёмно-синюю grading и динамический процент из общего `LightQuickScenes`. Гости/Чтение, approved Home Hub визуальная структура, Android connectivity, Nano R4 и ESP v2 не изменены.

**CI:** [Android Verify https://github.com/dronrome1245/ARDU/actions/runs/38035137524](https://github.com/dronrome1245/ARDU/actions/runs/38035137524) **PASS** — XML/static guard на скрытый F01 и сохранённые ON/OFF, 4× weighted submode before sliders/selected state, реальные Music background подписи, Kotlin unit tests `LightQuickScenesTest`, `MusicBackgroundUiPolicyTest`, все предыдущие unit tests, debug APK `ardu-android-02211-presets-music-scenes-debug-apk`. **Телефон 0.22.11 ещё не протестирован владельцем.** Следующий gate: `git pull` → Android Studio Run, проверить 5 вкладок, «Фон» без F01, M05/M08 расположение/подсветку, M01/M03/M09 bg label и различие Evening/Cinema на лампе. Если нужен **изменяемый цвет музыкального фона**, потребуется отдельное решение Nano/ESP/API; не выдавать Android UI-only подпись за рабочий регулятор.

**2026-10-09 — Android 0.22.10: собственный значок ARDU на рабочем столе + устойчивее readback/калибровка (D-117).** По просьбе владельца сразу заменить стандартную launcher icon, сохранив утверждённый Home Hub/Focus Dial, в Android `05_WiFi_и_приложение/android_app_r1` добавлен реальный адаптивный значок приложения: тёмно-синий фон, мятное световое кольцо и белая «A» с золотым акцентом; варианты launcher `@mipmap/ic_launcher`, круглый `ic_launcher_round`, Android 13+ `monochrome`. Новые ресурсы `res/drawable/ardu_launcher_foreground.xml`, `ardu_launcher_monochrome.xml`, `res/mipmap-anydpi-v26/ic_launcher*.xml`; `AndroidManifest.xml` явно указывает `android:icon` и `android:roundIcon`. Это **установленный APK launcher resource**, не просто изображение в макете. При Android Studio Run app ID `com.ardu.app` тот же; значок меняется вместе с установленным приложением.

**Дополнительно Android 0.22.10, versionCode33:** исходная ошибка `Connection reset`/`unexpected end of stream` при Music READ обрабатывается безопасным однократным повтором **только GET**, без повторной отправки POST. `runDeviceAction` теперь разделяет подтверждённое выполнение POST и чтение Nano snapshot: если устройство уже подтвердило действие, но readback не удался, UI сообщает «команда подтверждена, состояние перечитывается», блокирует устаревшие регуляторы и восстанавливает данные по foreground heartbeat. Состояние `CLAPCAL FINISHED` из Nano по-прежнему может оставаться после `SAVE`, поэтому Android после **подтверждённого** сохранения закрывает мастер, хранит эту UI-настройку на телефоне и открывает снова при новом старте калибровки. Изменения в Nano/ESP/protocol/EEPROM отсутствуют.

[GitHub Android Verify https://github.com/dronrome1245/ARDU/actions/runs/37981648045](https://github.com/dronrome1245/ARDU/actions/runs/37981648045) **PASS**: static photo+launcher binding/XML, Kotlin/JUnit tests HTTP read-only retry policy + CLAPCAL wizard, полноценный debug APK `ardu-android-02210-launcher-debug-apk`. **Рабочий стол и HTTP/error UX на настоящем телефоне с этой версией ещё не проверены**, следующий gate владельца — `cd C:\ARDU` → `git pull` → Android Studio Run; проверить новый значок, сессию сохранения хлопков, Music Мxx и восстановление связи. ARDU Nano R4/ESP не перепрошивать ради Android значка.

**2026-10-09 — физическое движение 12 фоновых сцен подтверждено владельцем.** После полного Nano Ambient12 R4 (D-116) владелец сообщил: «все задвигалось это хорошо. что осталось исправить?». **ФАКТ ПО ОТЧЁТУ ВЛАДЕЛЬЦА:** ранее неподвижные P01..P10/P12 теперь анимируются на подключённой лампе; P11 «Дыхание» двигался до этого. Этот gate — **owner visual motion PASS**, без видеозамера, идентификации boot-строки `ARDU1 5`, оценки каждой цветовой палитры, подтверждения всех 256 скоростей, EEPROM после отключения питания, двух колец 44+44 или худшей глубины стека. Старые строки «Upload pending» ниже исторические и для источников не означают, что владелец не испытал движение. Программа R4 в GitHub `main` `880f3f6`; [Arduino Verify main 37976579921](https://github.com/dronrome1245/ARDU/actions/runs/37976579921) PASS: **29410/30720 Flash, 1286/2048 globals SRAM**.

**Приоритет следующих исправлений/проверок:** (1) Android 0.22.9: обработка непостоянных `unexpected end of stream`/`Connection reset` при переключении Music с отделением результата записи от readback; закрытие/сброс состояния мастера CLAPCAL после подтверждённого SAVE и проверка сохранения диагностического toggle; (2) без новых прошивок — hardware regression M01/M02/M03/M04/M05/M08/M09, L01/clap, ночник, RTC/будильник/рассвет/STOP, переходы режимов, EEPROM P01..P12 brightness/dynamics после cold reboot; (3) Station→защищённый `ARDU-DIRECT`→Station без роутера; (4) два кольца 44+44, 5V под нагрузкой/ток/нагрев/сигнальная линия, worst-case Nano stack, Class II финальный БП. Лимит тока сохранять ≤3000 мА до реальных измерений. Online/Offline Android 0.22.9 уже подтверждён владельцем ранее; не повторять как незакрытый gate без нового дефекта.

**2026-10-09 — Nano Ambient12 R4: все 12 P-сцен оживлены на уровне исходников, полный CI PASS, Upload владельца ожидается (D-116).** Владелец сообщил: «сделай все сразу. сейчас работает только дыхание». Причина по source: большинство P01..P10/P12 использовали `phase=(uint8_t)(t>>2)` и имели слишком медленный 33–131-секундный фазовый оборот, отдельные P02/P04/P07 также были низкоконтрастны. В новом **полном одном .ino** `04_Прошивка/nano_ambient12_v4/nano_ambient12_v4.ino` (boot `ARDU1 5`) все P01–P10 и P12 получили собственное движение, а P11 «Дыхание» сохраняет точный Q16 clock и пиксельную формулу из R3. EEPROM 29 B, ID P01..P12, UART 111..115, ESP/Android, общий 44 LED буфер на D6+D7, текущий лимит 5V и другие режимы не менялись. Предыдущая **полная R3** оставлена для rollback.

**Подтверждено CI:** [Arduino Verify https://github.com/dronrome1245/ARDU/actions/runs/37975908088](https://github.com/dronrome1245/ARDU/actions/runs/37975908088) **PASS**, как unit/host test, так и настоящая сборка AVR Nano ATmega328P (Old Bootloader) из **одного** .ino. Exact-source 44-HSV-LED host проверил 12 сцен на `dynamics=0` и `255` за 2 секунды: изменяются реальные LED-кадры, изменение ползунка меняет пиксели, P11 идентичен R3, проверена Q16-семантика и rollover millis(). В частности P04 «Космос»: звёздная разница высокой скорости увеличена с 66 до 487 единиц суммарного HSV расхождения по 44 пикселям после доработки рендерера. Полная R3: **29376/30720 Flash и 1286/2048 bytes globals SRAM**; полная R4: **29410/30720 Flash и 1286/2048 globals SRAM**, +34 Flash, +0 статической SRAM, запас 1310 B Flash и 762 B SRAM для локальных переменных/стека. Проектный мягкий Flash target 95%=29184 превышен на 226 B — **это тестовый кандидат, не production freeze**.

**Следующий физический gate:** владелец выполняет `git pull`, безопасный Arduino Nano USB Upload **полной R4** с ESP TX0→Nano D0 временно снятым только при обесточенном стенде, затем восстановить UART, подтвердить загрузку по `ARDU1 5`; на **одном проверенном кольце 44 LED** пройти P01..P12, движение 0/128/255 и сохранение EEPROM. Регламент + откат: [AMBIENT12_ALL_SCENES_R4_TEST.md](04_Прошивка/AMBIENT12_ALL_SCENES_R4_TEST.md). **Физический эффект R4 ещё не подтверждён**; пока не измерены stack, ток/нагрев 44+44 и ARDU-DIRECT. До силового gate не повышать лимит выше 3000 мА. Прошивки ESP/Android не трогать.

**2026-10-09 — Nano Ambient12 R3, P11 «Дыхание» ещё немного медленнее на нуле (D-115, source/CI PASS, R3 Upload pending).** Владелец сообщил, что после предыдущего исправления «Дыхание классно получилось», но предложил «на нуле ещё чуть-чуть замедлить». Это подтверждение положительного визуального результата P11 на используемой лампе **без измеренного периода и без достоверного boot-маркера**, не полная приёмка всех P-сцен/44+44. В отдельном полном `04_Прошивка/nano_ambient12_v3/nano_ambient12_v3.ino` скорость P11 при `dynamics=0` уменьшена: полный цикл ~**20,2 с** вместо ~16,4 с у R2; при `dynamics=128` ~6,8 с, при 255 прежние ~4,1 с. Только P11 получает плавно уменьшающуюся к нулю дополнительную задержку; **остальные 11 сцен и их рендереры побайтно совпадают с R2**. 256 настроек остаются монотонными, изменение не сбрасывает фазу. Параметры в Nano EEPROM/UART 111..115, Android, ESP, питание и лимиты тока не менялись. Новая boot-строка `ARDU1 4`; R2 сохранена для отката.

**ФАКТ CI:** [Arduino Verify https://github.com/dronrome1245/ARDU/actions/runs/37971273171](https://github.com/dronrome1245/ARDU/actions/runs/37971273171) **PASS** — exact-source clock/12-renderer host tests, P11 256 монотонных скоростей, все прежние скорости остальных 11, millis rollover, полная AVR ATmega328P Old Bootloader сборка и HEX. R2 **29336/30720 Flash, 1286/2048 global SRAM** → R3 **29376/30720 Flash, 1286/2048 global SRAM** (+40 Flash, +0 globals). Остаток 1344 байта Flash и 762 байта SRAM для локальных переменных/стека; worst-case runtime stack не измерен. Мягкий ориентир ≤95% Flash (29184 байта) превышен на 192 байта; это тестовая RC, не production freeze. Полная инструкция на один 44-LED канал и rollback: `04_Прошивка/AMBIENT12_BREATHING_R3_TEST.md`.

**Следующий физический шаг:** после `git pull` загрузить только новый полный Nano R3 при штатно безопасном отключении ESP TX→Nano D0 на полностью обесточенном стенде, увидеть `ARDU1 4`, восстановить UART, проверить P11 при 0/128/255 и один неизменённый пресет на одном 44-LED кольце. Не менять ESP/Android, не повышать лимит выше 3000 мА до силового теста; исходная R2 остаётся rollback. **Реальный Upload и скорость R3 на кольце пока не подтверждены**.

**2026-10-09 — исправление скорости P01..P12 реализовано в исходнике полной Nano Ambient12 R2 (D-114), CI PASS; железо ещё не обновлено.** Вместо прежних трёх диапазонов `dynamics 0..69 / 70..170 / 171..255` новый **отдельный** `04_Прошивка/nano_ambient12_v2/nano_ambient12_v2.ino` использует 256 монотонных коэффициентов движения 0..255 без сброса фазы при настройке. P11 «Дыхание» ускорено до цикла примерно 16..4 с. P02/07 намеренно сохраняют почти статический вид. **ФАКТ ПО CI:** [Arduino Verify https://github.com/dronrome1245/ARDU/actions/runs/37966945125](https://github.com/dronrome1245/ARDU/actions/runs/37966945125) PASS: тесты точных функций полного скетча и 12 рендереров, rollover millis, две *полные* сборки Nano; прежняя R1 29306 Flash/1282 globals SRAM, новая R2 **29336/30720 Flash, 1286/2048 globals SRAM** (+30/+4, запас 1384 Flash и 762 SRAM для локальных переменных и стека). Внутренний soft-ориентир Flash 95%=29184 B всё ещё превышен на **152 B**; worst-case runtime stack и эффект на реальной ленте не проверены. Готов отдельный HEX `ardu-nano-ambient12-v2-velocity-rc2`; старый скетч не изменён. Новая boot-строка R2 `ARDU1 3`, ESP `nano_fw:ARDU_V2` по-прежнему является feature-label и не идентифицирует patch revision. **Порядок аппаратной проверки** и rollback: [AMBIENT12_SPEED_R2_TEST.md](04_Прошивка/AMBIENT12_SPEED_R2_TEST.md).

**Следующий gate:** владельцу после `git pull` на стенде выполнить **Verify и безопасный USB Upload только полной R2**, с временным отключением ESP TX→Nano D0 при снятом питании; затем подключить один 44-LED канал D6, пройти P11/P01/P03/P05/P12 при `dynamics 0→128→255` и проверить EEPROM/остальные функции. До измерений при 44+44 не поднимать лимит тока выше **3000 мА**. Новую ESP/Android не загружать ради скорости. Если тест плохой — откат к ранее рабочему `nano_ambient12_v1`; до physical PASS итоговую приёмку не закрывать.

**2026-10-09 — фактическая приёмка Android 0.22.9: Online/Offline PASS по сообщению владельца.** Владелец прямо подтвердил, что при тестировании последней сборки статус подключения автоматически переключается. Получено видео `18429670918804.mp4` (~63 с, экран 578×1280): на нём `Онлайн`, видны экраны «Свет» и «Музыка», переключение сцен освещения и музыкальных режимов, читаемая кнопка «Запустить». **В кадре нет момента отключения ARDU, времени обнаружения потери связи, проверки Settings-тумблера служебных сообщений и светодиодной ленты**; эти сведения не приписывать видеозаписи. Реальное переключение статуса принято как отдельно сообщённый владельцем phone PASS, без измерения задержки.

Следующие открытые задачи: проверить показ/сохранение настройки «Показывать служебные сообщения», исправить трёхступенчатую `dynamics` Nano для P01–P12 через отдельную небольшую прошивочную итерацию с compile/size/memory и реальным LED visual gate; также остаётся улучшение HTTP/readback после ошибок и закрытия мастера хлопков после сохранения. Никакие прошивки не менялись при этой приёмке.

**2026-10-09 — Android 0.22.9 keepalive/diagnostics RC1, CI PASS.** Владелец прислал два идентичных файла одного 4:29 экранного видео Android 0.22.8. На записи показаны `Онлайн`, ESP `ARDU_ESP_V2_AMBIENT12`, Nano `ARDU_V2` и все 12 фотосцен; **физическая анимация WS2812B в кадре отсутствует**. В настройках на экране показан лимит 4500 мА — это сохранённая настройка, **не измерение тока**; до двухкольцевого теста возвращать/соблюдать 3000 мА. По обратной связи добавлен Android-only RC1 `0.22.9-keepalive-diagnostics-rc1` (versionCode 32): пока приложение открыто, раз в 5 секунд последовательные HTTP `/api/ping` и Nano-backed `/api/status` проверяют ESP отдельно от Nano, отключают контролы при потере связи, восстанавливают полноценные настройки после возвращения; монитор останавливается в `onStop`. В общих настройках добавлен сохраняемый тумблер **«Показывать служебные сообщения»** (по умолчанию выключен): скрывает шесть рабочих строк «…готово», порог хлопков, числовые данные микрофона и подтверждение поддержки пресетов; сохраняет видимыми связь, ошибки и предупреждения отсутствующих функций. Исправлен контраст `▶ Запустить` музыки.

[Android CI https://github.com/dronrome1245/ARDU/actions/runs/37958078703](https://github.com/dronrome1245/ARDU/actions/runs/37958078703) **PASS**: assets, статические UX-проверки, Kotlin unit tests, debug APK. **Железо и работа фоновой heartbeat-проверки на реальном телефоне пока не проверены**; Nano/ESP прошивки не менялись. В исходнике Nano `renderPreset()` `dynamics 0..255` действительно конвертируется только в три диапазона `<70 / 70..170 / >170`; например 182/190/225 имеют одинаковую скорость. Это установленный **source-дефект**; непрерывная скорость требует отдельного Nano patch, compile/size/stack и физического теста, НЕ является частью Android 0.22.9.

**Следующее действие:** владелец `git pull` → Android Studio Run, открыть приложение с работающей ESP/Nano, выключить **питание ARDU** и проверить смену `Онлайн→Нет связи` примерно за один-два цикла, снова включить и дождаться восстановления; в настройках проверить переключатель служебных подписей, выбранный пресет и читабельность Music Start. Затем отдельный компактный Nano scene-speed candidate + физический LED visual gate.

**2026-10-09 — Android UX/readback RC1:** пользователь подтвердил, что 12 изображений P01..P12 загрузились в Android на телефоне, и приложил видео обхода пяти экранов без подключённой светодиодной ленты. На записи устройство показывало «Нет связи»; поэтому это **визуальный smoke 12 фотоплиток**, а не подтверждение управления лампой. После замечаний пользователя в Android `0.22.8-ux-readback-rc1` (versionCode 31) реализованы:
- до первого успешного ответа ESP/Nano — прочерки/«нет данных» вместо ложных 80%/4000 K/0% и прочих непроверенных состояний, кнопки действий заблокированы; круговой регулятор также показывает «—»;
- команды не отправляются при offline; после ошибки команда не считается применённой, UI пытается перечитать фактическое состояние;
- вкладки всегда открываются сверху, а не с прежней позиции ScrollView;
- 12 фотопресетов «Фон» первыми после фото-обложки; индивидуальные настройки выбранной сцены сразу ниже, F01 «Свой цвет» ниже; подписи увеличены до 11sp, по ним тоже можно выбирать;
- явно обозначенные запуск/остановка светомузыки, достоверная подпись переключателя ночника, проверка времени расписания, разрешение кнопки остановки рассвета только при RUNNING/HOLD и пояснение при недоступном RTC;
- повышенный лимит тока >3000 мА требует отдельного явного подтверждения; до двухкольцевого теста не повышать;
- калибровка хлопков следует состоянию Nano, а не ошибочному локальному подтверждению сохранения.

Исходники в GitHub, [Android Actions 37930295301](https://github.com/dronrome1245/ARDU/actions/runs/37930295301) **PASS**: asset bindings, Kotlin/JVM unit tests, debug APK. **Новый визуальный PASS на телефоне и физический end-to-end PASS после этой коррекции пока не получены.** Следующий шаг владельца: `cd C:\ARDU` → `git pull` → Android Studio Run, сначала открыть приложение **без ESP** (нет ложных значений/ложных переключений), затем с работающей ESP/Nano в Station или ARDU-DIRECT (настройки прочитаны от устройства, сцены и кнопки меняют фактический режим). Фотоэффекты, 44+44 LED/current/stack и direct mode проверять отдельно. ESP/Nano из-за Android UX не перепрошивать.

## Что подтверждено и решено

- Два старых круглых плоских светильника используются как корпуса под WS2812B: обычный свет L01, светомузыка, фоновые эффекты, ночник и световой будильник.
- Отдельные точечные светильники комнаты сохраняются на первой клавише; дополнительно ARDU получает собственный обычный белый режим L01 на WS2812B.
- Вторая клавиша полностью снимает питание ARDU. После холодной загрузки от подачи 230 В ARDU должен включать L01; будильник работает только если питание оставлено включённым.
- Два корпуса работают синхронно от одного Nano/ESP8266/MAX9814/DS3231.
- Рабочая архитектура: `приложение → домашний Wi‑Fi → ESP8266 → UART → Nano → два кольца WS2812B + MAX9814 + DS3231`.
- Wi‑Fi v1: домашний Station — основной; при недоступном роутере source включает защищённый fallback `ARDU-DIRECT` (`192.168.4.1`). Интернет/облако не требуются; physical direct-mode smoke ещё pending.
- В наличии 5 м WS2812B; для двух колец нужно около 1,43 м.
- **ФАКТ:** владелец увеличил кольцо до 44 LED на корпус; новая каноническая геометрия = 44+44 = 88 LED. Ранее пройденные 43-LED тесты остаются историческими.
- БП S-30-5 5 В 6 А остаётся базовым; на выходе фактического экземпляра измерено `5,01 В` без существенной нагрузки, проверка под нагрузкой ещё требуется; программный лимит лент ориентировочно 4,5 А до фактической проверки.
- **РЕШЕНИЕ владельца 2026-10-07:** аккумуляторное резервное питание отменено полностью. Никаких BACKUP/EXT 5V/USB-C PD входов, HUSB238, reserve DC/DC, source relay, MAINS_SENSE или аварийных ring profiles в v1 не будет. USB-C Nano остаётся сервисным. `ARDU-DIRECT` сохраняется как независимая функция работы без роутера.
- DATA: D6 → кольцо A, D7 → кольцо B; одинаковый кадр на оба кольца.
- Актуальная распиновка аудиотракта Nano по D-040: D0/D1 UART ESP8266; A0 — единственный вход MAX9814 для VU и FHT; A4/A5 — DS3231. A2/A3 в финальном аудиотракте не используются.
- Белая переходная плата ESP8266 питается только 3,3 В; 5 В на VCC запрещены.
- YP-8/AMS1117-3.3: при диагностике 2026-09-20 с общим чёрным щупом на `S-30-5 V-` измерено: `S-30-5 V+ ≈ 5,0 В`, `YP-8 VIN+ ≈ 4,7 В`, `YP-8 VOUT+ ≈ 3,50 В`, `ESP VCC ≈ 3,25 В`. Эти значения относятся к общей точке `S-30-5 V-` и сами по себе не дают истинное напряжение YP-8/ESP между локальными `VCC/GND`; вероятно есть заметное падение по GND-проводнику. Питание ESP считать **неподтверждённым для Wi‑Fi** до измерения `YP-8 GND` и `ESP GND` относительно `S-30-5 V-` и пересборки контактов.
- Nano как USB↔UART-мост: loopback-тест 2026-09-19 пройден (`RESET→GND`, `D0/RX↔D1/TX`). По новым крупным фото 2026-09-20 **штатный последовательный `1 кОм` именно на нашем экземпляре не подтверждён**: рядом с USB-UART видны два SMD `151` (=150 Ом), а четыре `102` (=1 кОм) расположены у индикаторов RX/TX/POW/L. Точный резистор в пути USB-UART→D0 нужно установить измерением конкретной платы.
- Внешний делитель `1,5 кОм / 3,0 кОм` фактически дал `Nano D0 = 4,95 В`, `ESP RX = 3,36 В`. Эти измерения сами по себе хорошо согласуются с расчётом внешнего делителя и **не подтверждают наличие дополнительного 1 кОм перед D0**. До изменения programmer-path сначала измерить, связан ли D0 с парой `151` и какое сопротивление реально стоит между USB-UART и D0.
- Первый тестовый скетч ESP8266 успешно компилируется в Arduino IDE. Отчёт сборки: RAM `28108/80192` (35%), IRAM `59747/65536` (91%, включая 32768 байт cache), код во flash `236148/1048576` (22%).
- **Прошивка ESP8266 воспроизводимо проходит на 100%** через Nano USB↔UART при `Upload Speed = 115200`, установленном локальном `100 µF 10 V`, временном прямом `Nano D0 → ESP RX`, `GPIO0 = LOW` и ручном кратком reset `RST ESP → GND` во время `Connecting...`. После обычного boot тестовый скетч выводит `ARDU ESP8266 OK`. Это подтверждает ESP8266, flash и USB↔UART-мост. Прямой путь `D0 ≈ 4,95 В → ESP RX` остаётся только диагностическим и **не допускается как штатная схема**.
- DS3231 имеет цепь подзаряда; с установленной CR2032 проектное решение — отключить зарядную цепь (удалить резистор `201`).
- Предыдущий MIT App Inventor проект `Ardublock2.aia` (`LumpV3.1`) полностью разобран как функциональный источник.
- В старом приложении подтверждены 9 ColorMusic-режимов, подрежимы, общие яркости, калибровка, будильник и незавершённые разделы ночника/фона.
- Старый Bluetooth-протокол больше не считается обязательным контрактом. Новый внешний интерфейс — локальный HTTP API; внутренний ESP8266↔Nano протокол будет компактным UART.
- Созданы целевые документы по режимам, приложению, API и разбору старого `.aia`.
- **ФАКТ ПО SOURCE 2026-10-05:** ESP добавлен fallback SoftAP `ARDU-DIRECT`, Android direct fallback source добавлен (`192.168.4.1`). Firmware/API semantics Nano не менялись; compile/real-device acceptance нового ESP source ещё требуется.

## Принятый набор функций v1

### Обычный свет L01

- температурный обычный свет с Kelvin;
- пресеты 2700 K / 4000 K / 6000 K;
- произвольный RGB-цвет;
- регулируемая яркость;
- сохранённый startup profile L01;
- ВКЛ/ВЫКЛ из приложения;
- автоматический L01 ON после холодного power-on от второй клавиши;
- хлопковый выключатель на MAX9814;
- clap enable/disable из приложения;
- точный clap detector — после отдельного аппаратного теста.

### Светомузыка

1. VU градиент;
2. VU радуга;
3. 5 полос;
4. 3 полосы;
5. 1 полоса/частотный подрежим;
6. бегущие частоты;
7. анализатор спектра.

Цветная подсветка из старого режима №7 перенесена в раздел фоновых эффектов.

### Фоновые эффекты

- постоянный цвет;
- плавная смена цвета;
- бегущая радуга;
- автоперебор.

### Ночник

- цвет;
- насыщенность;
- яркость;
- расписание — после основной версии.

### Будильник

- ВКЛ/ВЫКЛ;
- время;
- длительность рассвета;
- максимальная яркость;
- начальный/конечный цвет;
- синхронизация RTC с телефоном;
- отображение в приложении фактического времени DS3231;
- остановка активного рассвета.

## Новые канонические документы

- `04_Прошивка/РЕЖИМЫ_РАБОТЫ.md`
- `05_WiFi_и_приложение/ФУНКЦИОНАЛЬНАЯ_МОДЕЛЬ.md`
- `05_WiFi_и_приложение/API_V1.md`
- `05_WiFi_и_приложение/МОДЕЛЬ_ЭКРАНОВ.md`
- `08_Исходники_и_референсы/Ardublock2_РАЗБОР.md`
- `06_Интерфейс_управления/ПРОТОКОЛ_КОМАНД.md` обновлён: фактический старый протокол отделён от нового.

## Что осталось уточнить/измерить

1. YP-8/ESP8266: повторная проверка показала падение с `3,32 В` без нагрузки до около `2,1 В` на `VCC/GND` ESP после подключения. Сначала измерить напряжение прямо на `VOUT/GND` YP-8 при подключённом ESP, затем локализовать причину (стабилизатор/источник либо проводка/контакты); к Wi‑Fi-тесту пока не переходить.
2. S-30-5: `5,01 В` без существенной нагрузки подтверждено; проверить напряжение и нагрев под тестовой нагрузкой.
3. Уточнить количество и напряжение электролитов около 1000 мкФ.
4. Расстояние между двумя потолочными корпусами.
5. Где находится разветвление линии от второй клавиши к двум старым светильникам.
6. Сколько жил и какого сечения приходит к каждому корпусу.
7. Где безопасно и обслуживаемо разместить общий S-30-5.
8. Достаточно ли монтажного провода для 5 В/GND и двух DATA-линий.
9. USB-UART часть Nano проверена loopback-тестом; далее проверить реальную прошивку ESP8266 после устранения просадки питания.

## Предварительный минимальный BOM на докупку

Пока не утверждать окончательно до измерений и осмотра проводки.

С высокой вероятностью:

- 2× резистор 330 Ом в DATA-линии + небольшой запас;
- возможно второй электролит около 1000 мкФ ≥10 В, если в наличии только один;
- монтажный провод/клеммы/предохранители и защитный корпус сетевой части — после определения физической разводки;
- USB-UART 3,3 В — только если не удастся прошить ESP8266 через имеющийся Nano/другой доступный мост.

## Следующий практический шаг

1. Изолированный тест ленты `04_Прошивка/nano_strip_test/nano_strip_test.ino` **ПРОЙДЕН НА ЖЕЛЕЗЕ 2026-09-25** на одном канале D6 / 43 WS2812B.
2. Перед повторной проверкой владелец объединил `Nano GND` с общей землёй ленты/БП `S-30-5 V-`. После этого команды `RED/GREEN/BLUE/WHITE/CHASE` работают корректно.
3. **ФАКТ:** D6→220 Ω→DIN, 43 LED и базовая цветовая/последовательная адресация исправны в изолированном тесте; A0/MAX9814/FHT/RTC/ESP в нём не участвуют, D7 удерживается LOW.
4. **ПРЕДПОЛОЖЕНИЕ:** отсутствие общей GND было одной из причин прежних самопроизвольных вспышек. Единственной доказанной причиной это пока не считать, так как контролируемый A/B-тест без/с общей землёй не проводился.
5. `OFF` выдержан не менее 60 с без самопроизвольных вспышек — изолированный тест ленты **ПОЛНОСТЬЮ ПРОЙДЕН**.
6. После возврата `nano_m03.ino` при подключённой ленте и общей земле выполнено `OFF → ADC`: `AVG=251 MIN=221 MAX=281 P2P=60`.
7. **ФАКТ:** A0/MAX9814 снова находится в нормальном рабочем диапазоне и согласуется с прежними ~234–256 counts; прежний аномальный `CALF DC=11` сейчас не воспроизводится.
8. В тишине выполнен `CALF`: `DC=250 QUIET_MAX=52 SPECTR_LOW_PASS=55`.
9. **ФАКТ:** `DC=250` практически совпадает с предыдущим `ADC AVG=251`; калибровка A0 валидна. `QUIET_MAX=52` выше прежнего рабочего baseline ~33, поэтому перед тонами нужно проверить подавление тишины новым gate=55.
10. После `ON` в тишине `BANDS` дал `LOW=0 MID=0 HIGH=0 LP=55 BR=6,6,6 FLASH=0,0,0`: noise gate работает, но видимый фон создавался настройкой `BACKGROUND=6`, а не шумом микрофона.
11. Команда `BACKGROUND 0` подтверждена на железе. После неё: `BANDS LOW=0 MID=0 HIGH=0 LP=55 BR=0,0,0 FLASH=0,0,0`; лента в тишине полностью гаснет, реакция на звук сохраняется.
12. Контролируемый тон 2 kHz при `BACKGROUND 0` и `LP=55`: `BANDS LOW=97 MID=0 HIGH=0 LP=55 BR=0,0,0 FLASH=0,0,0`.
13. **ФАКТ:** 2 kHz корректно попадает только в LOW; первый из трёх regression-тонов M03 пройден.
14. Дополнительный тест 4 kHz: несколько `BANDS` дали примерно `LOW=0 MID=105–106 HIGH=57–77`; MID устойчиво доминирует, но HIGH также иногда выше gate=55 и может давать отдельный flash.
15. **ФАКТ:** 4 kHz классифицируется прежде всего как MID, но разделение не идеально чистое.
16. **ПРЕДПОЛОЖЕНИЕ:** HIGH-компонент может быть гармоникой/искажением источника тона или микрофонного тракта; порог `LP=55` пока не менять.
17. Точный 5 kHz: `LOW=0 MID=92 HIGH=56` и `LOW=0 MID=89 HIGH=56` при `LP=55`.
18. **ФАКТ:** 5 kHz уверенно классифицируется как MID; HIGH остаётся слабым компонентом примерно на пороге gate.
19. Точный 8 kHz: `LOW=0 MID=0 HIGH=64`, затем `HIGH=55` и `HIGH=81` при `LP=55`; в активных кадрах `FLASH HIGH=1`.
20. **ФАКТ:** 8 kHz попадает только в HIGH. Базовый regression M03 закрыт: 2 kHz→LOW, 5 kHz→MID, 8 kHz→HIGH.
21. Ненулевые `BR` в других полосах при нулевых текущих `BANDS` являются остатком программного затухания/сглаживания, а не текущей ошибочной классификацией.
22. Визуальная проверка M03 на реальной музыке при `BACKGROUND 0` **ПРОЙДЕНА 2026-09-25**: работают 5 зон, в паузах/тишине кольцо полностью гаснет.
23. **ФАКТ:** M03 «5 полос» полностью пройден на одном D6-кольце: валидный ADC/CALF, noise gate, отсутствие фонового свечения, 2/5/8 kHz→LOW/MID/HIGH и визуальная реакция на музыку подтверждены.
24. Следующий слой FW-6 — M04 «3 полосы» на том же одном кольце, без подключения второго кольца и без изменения проверенного A0/MAX9814 frontend.
25. Создан `04_Прошивка/nano_m04/nano_m04.ino`: тот же проверенный A0/FHT/noise-gate тракт, но отрисовка по оригинальной логике ColorMusic v2.10 — первая треть HIGH, средняя треть MID, последняя треть LOW.
26. После подтверждённого владельцем полного гашения в тишине код M03 и новый M04 используют `DEFAULT_BACKGROUND=0`; фон остаётся регулируемым командой `BACKGROUND <0..255>`.
27. **НЕ ПРОВЕРЕНО:** M04 ещё не компилировался/не загружался на физическую Nano.
28. M04 **COMPILE + UPLOAD PASSED 2026-09-25** на фактической Nano (`ATmega328P (Old Bootloader)`).
29. Стартовый runtime подтверждён: `ARDU NANO M04 READY`; `STATUS FW=M04 MODE=M04 POWER=ON BRIGHTNESS=64 BACKGROUND=0 MIC=MAX9814 MIC_PIN=A0 MIC_GAIN=40DB AR=FLOAT ADC_REF=DEFAULT DC=250 SPECTR_LOW_PASS=40 CAL=NO LEDS=43 FHT_N=64`.
30. **ФАКТ:** стартовый DC=250 согласуется с ранее рабочим MAX9814/A0, но CAL ещё не выполнен.
31. M04 `ADC` в тишине: `AVG=249 MIN=243 MAX=256 P2P=13`.
32. **ФАКТ:** A0/MAX9814 стабилен, среднее 249 совпадает со стартовым DC=250, насыщения нет; тихий размах малый.
33. M04 `CALF` в тишине: `DC=251 QUIET_MAX=43 SPECTR_LOW_PASS=46`.
34. **ФАКТ:** калибровка валидна: `DC=251` согласуется с `ADC AVG=249`; в тишине ложных вспышек нет.
35. При близком расположении микрофона нажатия клавиш клавиатуры вызывают реакцию ленты — это ожидаемая реакция на короткие широкополосные звуковые импульсы, а не ложный шум.
36. При непрерывных 2/5/8 kHz визуально наблюдается: после старта тона зоны загораются, затем примерно через некоторое время полностью гаснут.
37. **ФАКТ ПО КОДУ:** M04 использует оригинальную ColorMusic v2.10 flash-логику: `colorMusic_f/bandFiltered` сравнивается с медленным `colorMusic_aver/bandAverage`; при постоянном тоне среднее постепенно догоняет сигнал, `FLASH` сбрасывается и яркость затухает до `BACKGROUND=0`. Поэтому постоянный синус не обязан светиться постоянно.
38. **ПРЕДПОЛОЖЕНИЕ:** одновременная начальная вспышка нескольких/всех зон создаётся широкополосным фронтом включения тона и/или гармониками источника; подтвердить через `BANDS`.
39. Контролируемая классификация M04 после адаптивного затухания **ПРОЙДЕНА**: владелец подтвердил корректные `2 kHz→LOW`, `5 kHz→MID`, `8 kHz→HIGH`.
40. **ФАКТ:** частотный frontend M04 работает корректно; затухание постоянного синуса относится только к flash-логике отображения.
41. Визуальная проверка M04 на реальной музыке **ПРОЙДЕНА 2026-09-25**: три последовательные зоны реагируют раздельно, в паузе при `BACKGROUND=0` кольцо полностью гаснет.
42. **ФАКТ:** M04 «3 полосы» полностью пройден на одном D6-кольце.
43. Создан `04_Прошивка/nano_m05_r2/nano_m05_r2.ino` — M05 «1 полоса» с подрежимами `THREE / LOW / MID / HIGH`.
44. Логика M05 повторяет ColorMusic v2.10: в `THREE` всё кольцо показывает одну активную группу с приоритетом `HIGH → MID → LOW`; в остальных подрежимах реагирует только выбранная группа. Аналоговый/FHT frontend не менялся.
45. **НЕ ПРОВЕРЕНО:** M05 ещё не компилировался и не загружался на физическую Nano.
46. Первая компиляция M05 **НЕ ПРОШЛА** из-за конфликта имён: Arduino core определяет макросы `LOW`/`HIGH`, а M05 использовал их как значения `enum Submode`.
47. Код исправлен: внутренние значения переименованы в `LOW_ONLY / MID_ONLY / HIGH_ONLY`; внешние команды остаются `SUBMODE LOW/MID/HIGH`.
48. Повторная попытка компиляции снова показала старую ошибку `Submode::LOW` на строке 72, при этом актуальный файл в GitHub уже содержит `LOW_ONLY/MID_ONLY/HIGH_ONLY`.
49. **ФАКТ:** Arduino IDE компилирует старую несохранённую временную копию из `.arduinoIDE-unsaved.../sketch_sep25a.ino`, а не обновлённый `04_Прошивка/nano_m05_r2/nano_m05_r2.ino`.
50. M05 R2 **COMPILE + UPLOAD PASSED 2026-09-25** на фактической Nano.
51. Runtime M05 R2 **ПОДТВЕРЖДЁН 2026-09-25**: `ARDU NANO M05 R2 READY`; `STATUS FW=M05 REV=2 MODE=M05 POWER=ON BRIGHTNESS=64 BACKGROUND=0 SUBMODE=THREE MIC=MAX9814 MIC_PIN=A0 MIC_GAIN=40DB AR=FLOAT ADC_REF=DEFAULT DC=250 SPECTR_LOW_PASS=40 CAL=NO LEDS=43 FHT_N=64`.
52. **ФАКТ:** на Nano запущена именно ревизия R2; стартовый DC=250 согласуется с рабочим MAX9814/A0.
53. M05 R2 `ADC` в тишине дал `AVG=10 MIN=6 MAX=28 P2P=22` — **НЕВАЛИДНО** для рабочего MAX9814/A0.
54. **ФАКТ ПО КОДУ:** `calibrateDcOffset()`, `analyzeAudio()`, `printAdc()` и ADC setup в M05 R2 идентичны уже пройденному M04; программная регрессия в этих функциях не обнаружена.
55. **ФАКТ:** startup M05 R2 перед этим показал `DC=250`, то есть A0 был нормален при старте, а затем физический уровень упал.
56. `CALF` не выполнять до восстановления A0.
57. Измерено: `MAX9814 Vdd→GND=5,08 В`, `MAX9814 Out→GND=1,25 В`, `Nano A0→Nano GND=0,16 В`.
58. **ФАКТ:** MAX9814 запитан и формирует нормальный DC bias на Out, но этот уровень не приходит на A0. Неисправность локализована в пути `Out→A0` или в паразитной нагрузке/замыкании A0.
59. Это почти точно повторяет подтверждённый эпизод 2026-09-21: `Out=1,24 В`, `A0=0,15 В`, после ремонта провода/контакта A0 восстановился до ~1,25 В.
60. После восстановления физического пути A0 повторный M05 R2 `ADC` 2026-09-26: `AVG=250 MIN=241 MAX=262 P2P=21`.
61. **ФАКТ:** A0/MAX9814 снова в нормальном рабочем диапазоне; ранее локализованный аппаратный обрыв/контакт больше не проявляется в текущем измерении.
62. Следующий пакет проверки M05 R2: `CALF` в тишине, затем без перепрошивки проверить `SUBMODE THREE / LOW / MID / HIGH`, возвратить `THREE` в конце.

### 2026-09-26 — M05 R2 выявил reset + invalid DC; подготовлен R3

- В `SUBMODE=THREE` после валидной калибровки получено `DC=255 SPECTR_LOW_PASS=68 CAL=YES UPTIME_MS=710801`.
- Позже в `SUBMODE=LOW/MID/HIGH/THREE` STATUS показывал `DC=1000 SPECTR_LOW_PASS=40 CAL=YES`.
- **ФАКТ:** `UPTIME_MS` уменьшился с `710801` до `120349`, значит между этими тестами Nano перезапустилась.
- **ФАКТ:** `DC=1000` невалиден для текущего MAX9814/A0; результаты подрежимов после этого состояния не засчитываются.
- **ПРЕДПОЛОЖЕНИЕ:** причина перезапуска аппаратная/питание/USB либо внешняя; по текущим данным источник reset не установлен.
- Обнаружен программный недостаток R2: `CALF` не отвергает явно неверный DC.
- Создан `04_Прошивка/nano_m05_r3/nano_m05_r3.ino`.
- R3: `FW=M05 REV=3`, startup `ARDU NANO M05 R3 READY`; допустимый startup/CALF DC = `120..400`; при выходе за диапазон калибровка отклоняется с `ERR CALF_BAD_DC`, `CAL=NO`; STATUS добавляет `DC_OK=YES/NO`.
- Следующий критерий — Verify/Upload M05 R3, затем одним пакетом `STATUS → ADC → CALF → STATUS`; только при `DC_OK=YES` проверять `THREE/LOW/MID/HIGH`.

### 2026-09-26 — M05 R3 guard подтверждён на железе

- Startup/STATUS: `FW=M05 REV=3 ... DC=249 DC_OK=YES CAL=NO`.
- `ADC`: `AVG=250 MIN=223 MAX=288 P2P=65`.
- Первые две попытки `CALF` корректно отклонены защитой: `ERR CALF_BAD_DC DC=26` и `DC=25`.
- Затем три валидных калибровки подряд: `DC=250 QUIET_MAX=42 LP=45`, `DC=250 QUIET_MAX=33 LP=36`, `DC=251 QUIET_MAX=33 LP=36`.
- Финальный STATUS: `DC=251 DC_OK=YES SPECTR_LOW_PASS=36 CAL=YES`.
- **ФАКТ:** guard R3 работает: invalid DC не переводит систему в валидное CAL-состояние.
- **ФАКТ:** в этом фрагменте reset не наблюдался: `UPTIME_MS` рос с `417849` до `509745`.
- **ФАКТ:** `SUBMODE THREE/LOW/MID/HIGH/THREE` принимаются командами.
- **ОТКРЫТО:** два кратких провала DC к 25–26 означают, что физический путь MAX9814 Out→A0 всё ещё может быть intermittent. До перехода к следующему режиму нужен короткий stability-check без перепрошивки.

### 2026-09-26 — вероятная причина периодического ERR UNKNOWN_COMMAND при активной ленте

- Владелец уточнил: `ERR UNKNOWN_COMMAND` появляется при повторной отправке одной и той же команды с небольшим интервалом.
- В серии при `POWER=OFF` шесть последовательных `ADC` прошли без единой ошибки.
- **ФАКТ ИЗ FASTLED:** на AVR/Nano для clockless WS2812 FastLED по умолчанию отключает прерывания на весь `show()`; в этот интервал hardware Serial может терять входящие байты.
- **ПРЕДПОЛОЖЕНИЕ:** периодические `ERR UNKNOWN_COMMAND` возникают из-за потери/искажения байтов UART во время `FastLED.show()`, а не из-за логики распознавания конкретной команды.
- Пока не менять firmware revision только ради диагностики этого эффекта. Для аппаратных тестов с частыми Serial-командами использовать `OFF`; финальный ESP↔Nano протокол должен иметь ACK/retry либо иной механизм устойчивости к потерям.
- Отдельная задача перед финальной UART-интеграцией: воспроизводимо подтвердить ошибку при `ON` и её отсутствие при `OFF`, затем выбрать transport-level fix.

### 2026-09-26 — M05 визуально пройден; UART ломается только при активном FastLED; создан R4

- Владелец визуально подтвердил M05: `LOW`, `MID`, `HIGH`, `THREE` работают ожидаемо.
- При `POWER=ON` и активно обновляемом кольце Serial-команды часто повреждаются: `ERR UNKNOWN_COMMAND`, `ERR BAD_SUBMODE`.
- При `POWER=OFF` серия из шести `ADC` подряд прошла без ошибок.
- Финальный STATUS R3 после визуального теста: `DC=249 DC_OK=YES LP=36 CAL=YES UPTIME_MS=3152824`; reset в этом фрагменте не было.
- **ФАКТ:** проблема коррелирует именно с активным `FastLED.show()`; M05 visual logic при этом работает.
- **ФАКТ ИЗ FASTLED:** на AVR `FASTLED_ALLOW_INTERRUPTS` по умолчанию = 0; разрешение прерываний во время clockless show поддерживается опцией конфигурации.
- Создан `04_Прошивка/nano_m05_r4/nano_m05_r4.ino`.
- R4 включает `FASTLED_ALLOW_INTERRUPTS=1` до `FastLED.h` и вводит `SERIAL_RX_GUARD_MS=5`: основной `FastLED.show()` не стартует, пока принимается команда.
- STATUS R4 выводит `FASTLED_IRQ=ON RX_GUARD_MS=5`.
- Следующий критерий — Verify/Upload R4, затем при постоянно светящемся кольце отправлять `STATUS`/подрежимы серией и проверить одновременно отсутствие UART errors и отсутствие визуальных артефактов WS2812B.

### 2026-09-26 — M05 R4 полностью пройден; подготовлен M08 R1

- Владелец подтвердил стресс-тест R4: при активном кольце серии `STATUS` и `SUBMODE` проходят без `ERR UNKNOWN_COMMAND` / `ERR BAD_SUBMODE`.
- Визуально случайных пикселей, искажений цветов и проблем WS2812B не наблюдается.
- STATUS R4 подтверждает `FASTLED_IRQ=ON RX_GUARD_MS=5`, `DC_OK=YES`, `CAL=YES`; `UPTIME_MS` растёт.
- **ФАКТ:** M05 R4 полностью закрывает функциональность M05 и проблему Serial/FastLED на текущем 43-LED стенде.
- **РЕШЕНИЕ:** рабочий transport fix R4 переносить в последующие FastLED-режимы на Nano.
- Создан `04_Прошивка/nano_m08_r1/nano_m08_r1.ino` — M08 «бегущие частоты», первая ревизия нового режима.
- M08 R1 сохраняет: MAX9814/A0 frontend, DC guard, CALF, `FASTLED_ALLOW_INTERRUPTS=1`, RX guard 5 ms, подрежимы `THREE/LOW/MID/HIGH`.
- Добавлен параметр `SPEED <1..255>`; default `11 ms`, как `RUNNING_SPEED=11` в ColorMusic v2.10.
- Для нечётных 43 LED оригинальный двухсторонний линейный эффект адаптирован к одному центральному пикселю index 21: след расходится по DATA-цепочке в обе стороны к её концам.
- **НЕ ПРОВЕРЕНО:** compile/upload/runtime M08 R1.
- Следующий критерий — Verify/Upload M08 R1, затем `STATUS → ADC → CALF → STATUS`, после чего визуально проверить `THREE/LOW/MID/HIGH` и `SPEED 5/20/50`.

### 2026-09-26 — M08 R1 полностью пройден; подготовлен M09 R1

- Владелец подтвердил визуальную работу M08 R1: `THREE/LOW/MID/HIGH` ведут себя адекватно; `SPEED 5/20/50/11` меняет скорость ожидаемо.
- STATUS во время активного эффекта стабилен: `FW=M08 REV=1`, `DC=250 DC_OK=YES`, `SPECTR_LOW_PASS=36`, `CAL=YES`, `FASTLED_IRQ=ON RX_GUARD_MS=5`.
- Серия STATUS при активном эффекте прошла без возврата `UNKNOWN_COMMAND`; `UPTIME_MS` монотонно рос.
- **ФАКТ:** M08 R1 полностью пройден на одном D6-кольце.
- Создан `04_Прошивка/nano_m09_r1/nano_m09_r1.ino` — M09 «анализатор спектра».
- M09 R1 наследует проверенный MAX9814/A0 frontend, DC/CALF guard и FastLED/UART fix.
- Алгоритм M09 повторяет ColorMusic v2.10: 20 отображаемых частотных bins, peak-hold с `LIGHT_SMOOTH=2`, автоматическая нормализация через медленный `freq_max_f`, `HUE_START=0`, `HUE_STEP=5`.
- Для 43 LED спектр симметричен по DATA-цепочке; центральный нечётный LED продолжает самый низкочастотный центральный участок.
- Диагностические команды M09: `SPEC`, `HUESTART <0..255>`, `HUESTEP <1..255>`, `BRIGHT <0..255>`.
- **НЕ ПРОВЕРЕНО:** compile/upload/runtime M09 R1.
- Следующий критерий — Verify/Upload M09 R1, затем `STATUS → ADC → CALF → STATUS`; после этого музыка + `SPEC` и проверка `HUESTART/HUESTEP`.

### 2026-09-26 — M09 R1 полностью пройден; FW-6 закрыт; подготовлен F02 R1

- M09 R1 hardware test пройден визуально.
- `ADC AVG=251 MIN=231 MAX=274 P2P=43`.
- `CALF DC=251 QUIET_MAX=42 SPECTR_LOW_PASS=45`.
- Финальный STATUS стабилен: `FW=M09 REV=1`, `DC_OK=YES`, `CAL=YES`, `DISPLAY_BINS=20`, `HUE_START=0`, `HUE_STEP=5`, `FASTLED_IRQ=ON RX_GUARD_MS=5`.
- `SPEC` на музыке показывает изменяющиеся значения по bins; верхние bins при данном музыкальном материале часто нулевые, что само по себе не является ошибкой.
- `HUESTART 80` и `HUESTEP 12` визуально меняют раскладку; возврат к `0/5` подтверждён.
- Серия STATUS во время активного эффекта прошла без UART errors; uptime рос.
- **ФАКТ:** M09 R1 полностью пройден на одном D6-кольце.
- **ФАКТ:** этап FW-6 (M03/M04/M05/M08/M09) закрыт на одном кольце.
- Следующий слой по утверждённому порядку — FW-7 фоновые эффекты.
- Создан `04_Прошивка/nano_f02_r1/nano_f02_r1.ino` — F02 «плавная смена цвета», первая ревизия.
- F02 R1 повторяет ColorMusic light_mode=1: общий HUE плавно увеличивается; defaults `HUE=0`, `SAT=255`, `SPEED_MS=100`; `BRIGHTNESS=64`.
- Команды: `HUE 0..255`, `SAT 0..255`, `SPEED 1..255`, `BRIGHT 0..255`, `ON/OFF`.
- F02 R1 наследует проверенный `FASTLED_ALLOW_INTERRUPTS=1` + RX guard 5 ms.
- **НЕ ПРОВЕРЕНО:** compile/upload/runtime F02 R1.

### 2026-09-26 — F02 R1 полностью пройден; подготовлен F03 R1

- F02 R1 visual test пройден: плавный общий HUE, `SPEED 20/200/100`, `SAT 80/255`, `HUE 96` работают ожидаемо.
- Серия STATUS при активном эффекте прошла без UART errors; `UPTIME_MS` монотонно рос.
- **ФАКТ:** F02 R1 полностью пройден на одном D6-кольце.
- Создан `04_Прошивка/nano_f03_r1/nano_f03_r1.ino` — F03 «бегущая радуга».
- F03 R1 основан на ColorMusic v2.10 `light_mode=2`: общий базовый HUE сдвигается каждые 30 ms, а вдоль LED используется пространственный rainbow step.
- Defaults: `SPEED=1`, `STEP10=5` (=0.5 hue/LED), `BRIGHTNESS=64`.
- Команды: `SPEED 1..20`, `STEP10 5..100`, `HUE 0..255`, `BRIGHT 0..255`, `ON/OFF`.
- F03 R1 наследует проверенный `FASTLED_ALLOW_INTERRUPTS=1` + RX guard 5 ms.
- **НЕ ПРОВЕРЕНО:** compile/upload/runtime F03 R1.

### 2026-09-26 — F03 R1 пройден; подготовлен интегрированный AMBIENT R1

- Владелец подтвердил полный визуальный пакет F03 R1: бегущая радуга, изменение `SPEED`, `STEP10`, `HUE` работают адекватно.
- **ФАКТ:** F03 R1 считается пройденным на одном D6-кольце.
- Для завершения FW-7 создан `04_Прошивка/nano_ambient_r1/nano_ambient_r1.ino` — общий фоновой контроллер.
- AMBIENT R1 объединяет проверенные `F01/F02/F03`.
- Управление эффектами: `EFFECT F01|F02|F03`, `NEXT`, `PREV`.
- Автоперебор: `AUTO ON/OFF`, `PERIOD 1..255` секунд; default `AUTO=OFF`, `PERIOD_S=10`.
- Ручной выбор `EFFECT/NEXT/PREV` сбрасывает таймер автоперебора, но не выключает AUTO.
- Эффект-специфичные параметры сохраняются раздельно внутри контроллера; `HUE/SAT/SPEED/STEP10` применяются к текущему эффекту.
- AMBIENT R1 наследует проверенный `FASTLED_ALLOW_INTERRUPTS=1` + RX guard 5 ms.
- **НЕ ПРОВЕРЕНО:** compile/upload/runtime AMBIENT R1.
- Следующий критерий — Verify/Upload, ручное переключение F01→F02→F03→F01, NEXT/PREV, затем `PERIOD 3` + `AUTO ON` и наблюдение минимум полного цикла.

### 2026-09-26 — AMBIENT R1 пройден; FW-7 закрыт; подготовлен RTC R1

- Владелец подтвердил корректную работу интегрированного AMBIENT R1: ручной выбор F01/F02/F03, NEXT/PREV и автоперебор работают.
- **ФАКТ:** этап FW-7 «фоновые эффекты» закрыт на одном D6-кольце.
- Следующий этап по порядку — FW-8 DS3231 + будильник/рассвет.
- Первый FW-8 шаг намеренно изолирован от будильника и рассвета: создан `04_Прошивка/nano_rtc_r1/nano_rtc_r1.ino`.
- Создана инструкция `04_Прошивка/RTC_DS3231_WIRING.md`.
- RTC R1 использует только штатную `Wire.h`, без внешней RTC-библиотеки; DS3231 читается напрямую по I²C адресу `0x68`.
- Команды: `STATUS`, `TIME`, `TEMP`, `SET YYYY-MM-DD HH:MM:SS`, `CLEAROSF`.
- **АППАРАТНЫЙ STOP:** в репозитории пока нет подтверждения удаления резистора `201` зарядной цепи DS3231. С установленной CR2032 не подавать 5 В на RTC до выполнения D-017.
- Безопасная временная альтернатива до выпайки `201`: вынуть CR2032 и только после этого проверить I²C от 5 В; retention-test тогда отложить.
- После выполнения D-017 проводка: `VCC→5V`, `GND→GND`, `SDA→A4`, `SCL→A5`; SQW/32K не подключать.
- **НЕ ПРОВЕРЕНО:** compile/upload/runtime RTC R1.

### 2026-09-26 — RTC R1 пройден; подготовлен ALARM R1

- DS3231 обнаружен по I²C: `PRESENT=YES`, адрес `0x68`, SDA=A4, SCL=A5.
- До установки времени часы шли от заводского/сброшенного значения `2000-01-01`; последовательные `TIME` подтвердили ход секунд.
- Температура DS3231 читается: `29.50 °C`.
- `SET 2026-09-26 20:38:00` прошёл; после этого `OSF=0 LOST_POWER=NO`, время продолжило идти.
- Владелец подтвердил выполнение всего запрошенного RTC-теста; удаление резистора `201` и резервное питание от CR2032 считаются подтверждёнными владельцем. Журнал в сообщении прямо подтверждает основной I²C/time/OSF путь; retention подтверждён сообщением владельца.
- **ФАКТ:** RTC R1 hardware pass.
- Следующая малая итерация FW-8: создан `04_Прошивка/nano_alarm_r1/nano_alarm_r1.ino` и `04_Прошивка/ALARM_R1_TEST.md`.
- ALARM R1 пока не управляет светом: проверяет только ежедневный триггер `EVENT ALARM_TRIGGER`, сохранение enabled/hour/minute после reset и защиту от повторного срабатывания в ту же дату.
- Настройки ALARM R1 хранятся во внутренней EEPROM ATmega328P с magic/version/checksum; это намеренно исключает AT24C32 из текущей итерации.
- **НЕ ПРОВЕРЕНО:** compile/upload/runtime ALARM R1.

### 2026-09-26 — ALARM R1 пройден; подготовлен DAWN R1

- ALARM R1 startup/runtime подтверждён: `RTC_PRESENT=YES RTC_VALID=YES`.
- `ALARMSET 20:50` + `ALARM ON` сохранены во внутренней EEPROM Nano: после reset `ALARM=ON ALARM_TIME=20:50 SAVED=YES` восстановились.
- В заданную минуту получено ровно одно штатное событие: `EVENT ALARM_TRIGGER RTC=2026-09-26 20:50:00`.
- Последующее `ALARM CLEARLAST` в той же минуте намеренно очистило защиту даты, поэтому повторный `EVENT ...20:50:07` является ожидаемым поведением тестовой команды, а не самопроизвольным дублем.
- **ФАКТ:** ALARM R1 persistence + daily trigger logic пройдены.
- Создан `04_Прошивка/nano_dawn_r1/nano_dawn_r1.ino` и `04_Прошивка/DAWN_R1_TEST.md`.
- DAWN R1 добавляет реальный световой рассвет на D6: линейный рост яркости 0→MAX_BR и переход HUE START→END по кратчайшей HSV-дуге.
- Defaults: `FADE_MIN=30`, `MAX_BR=120`, `START_HUE=8`, `END_HUE=32`.
- Для быстрого аппаратного теста есть `DAWN TEST <5..120 sec>`; штатный alarm запускает тот же renderer на `FADE_MIN`.
- `DAWN STOP` немедленно гасит кольцо; после завершения рассвет остаётся в `HOLD` на конечном цвете/яркости.
- ALARM R1 EEPROM block 0..9 сохранён совместимым; dawn settings хранятся отдельным блоком с magic/version/checksum.
- DAWN R1 наследует проверенный FastLED/UART fix.
- **ОГРАНИЧЕНИЕ R1:** восстановление прогресса активного рассвета после reset ещё не реализовано; это следующий слой после визуального/trigger pass.
- **НЕ ПРОВЕРЕНО:** compile/upload/runtime DAWN R1.

### 2026-09-26 — DAWN R1 пройден; подготовлен DAWN R2 reset recovery

- Владелец подтвердил DAWN R1 полностью и визуально: ускоренный рассвет, параметры, STOP и запуск от alarm работают.
- **ФАКТ:** DAWN R1 hardware pass.
- Семантика текущей v1 сохранена: `ALARM_TIME` — момент запуска рассвета; `FADE_MIN` задаёт длительность после этого момента.
- Создан `04_Прошивка/nano_dawn_r2/nano_dawn_r2.ino` и `04_Прошивка/DAWN_R2_TEST.md`.
- R2 добавляет reset recovery без периодических записей EEPROM: на START сохраняются RTC start + duration + source; после reset прогресс вычисляется по DS3231.
- Runtime EEPROM пишется только на переходах `START / COMPLETE(HOLD) / STOP(IDLE)`.
- Поддерживается recovery для `TEST`, `MANUAL` и `ALARM`.
- STATUS R2 добавляет `SOURCE`, `RUNTIME_SAVED`, `RECOVERED`.
- Ожидаемое событие при восстановлении активного рассвета: `EVENT DAWN_RECOVER PHASE=RUNNING ...`.
- Alarm daily-trigger lock из ALARM R1 сохраняется, поэтому reset внутри alarm-dawn не должен создавать второй `ALARM_TRIGGER`.
- **НЕ ПРОВЕРЕНО:** compile/upload/runtime DAWN R2.

### 2026-09-26 — DAWN R2 пройден; FW-8 закрыт; подготовлен NIGHT R1

- DAWN R2 alarm path подтверждён: `21:19:00 ALARM_TRIGGER → DAWN_START 60 s → DAWN_COMPLETE`.
- TEST recovery подтверждён: после reset на 19-й секунде получено `EVENT DAWN_RECOVER PHASE=RUNNING SOURCE=TEST ELAPSED_S=19 REMAINING_S=11`; рассвет завершился по исходной шкале времени.
- HOLD/STOP persistence подтверждены: после STOP состояние `IDLE` сохраняется через reset.
- Alarm recovery подтверждён: после reset на 19-й секунде alarm-dawn восстановился как `SOURCE=ALARM ... REMAINING_S=41`, без повторного `ALARM_TRIGGER`, затем завершился штатно.
- **ФАКТ:** DAWN R2 reset recovery полностью пройден на одном D6-кольце.
- **ФАКТ:** этап FW-8 (DS3231 + alarm + dawn + reset recovery) закрыт.
- Следующий этап по утверждённому порядку — FW-9 «Ночник».
- Создан `04_Прошивка/nano_night_r1/nano_night_r1.ino` и `04_Прошивка/NIGHT_R1_TEST.md`.
- NIGHT R1: постоянный HSV, ON/OFF, `HUE/SAT/BRIGHT`, немедленное сохранение во внутреннюю EEPROM и восстановление после reset.
- Defaults на чистой EEPROM: `POWER=OFF HUE=24 SAT=180 BRIGHTNESS=18`; значения цвета/яркости соответствуют текущему примеру API v1, POWER=OFF выбран как безопасный startup default.
- EEPROM block NIGHT R1 начинается с offset 64, не пересекается с alarm/dawn test blocks.
- NIGHT R1 наследует проверенный FastLED/UART fix.
- Расписание ночника в R1 не входит: по функциональной модели это дополнительная функция после базового ночника.
- **НЕ ПРОВЕРЕНО:** compile/upload/runtime NIGHT R1.

### 2026-09-26 — NIGHT R1 заменён NIGHT R2 с расписанием

- По решению владельца расписание ночника включено в текущий FW-9, поэтому отдельный аппаратный pass NIGHT R1 больше не требуется.
- **РЕШЕНИЕ:** NIGHT R1 остаётся исторической первой ревизией, но до аппаратного теста заменён NIGHT R2.
- Создан `04_Прошивка/nano_night_r2/nano_night_r2.ino` и `04_Прошивка/NIGHT_R2_TEST.md`.
- NIGHT R2 содержит весь базовый ночник: постоянный HSV, HUE/SAT/BRIGHT, manual ON/OFF, EEPROM persistence.
- Добавлен DS3231 schedule:
  - default `SCHEDULE=OFF`;
  - сохранённые default времена `22:00 → 07:00`;
  - переход через полночь поддерживается;
  - интервал трактуется как `[ON, OFF)`;
  - `SCHEDULE ON` немедленно применяет текущее состояние по RTC;
  - schedule transitions не пишут EEPROM, POWER вычисляется из RTC;
  - ручные `ON/OFF` отключают schedule и переводят NIGHT в manual control;
  - HUE/SAT/BRIGHT не отключают schedule;
  - при enabled schedule и невалидном RTC fail-safe POWER=OFF.
- STATUS добавляет `CONTROL`, `MANUAL_POWER`, `SCHEDULE`, `SCHED_ON`, `SCHED_OFF`, `WINDOW`, `RTC_PRESENT/VALID`, `TIME`.
- Команды: `SCHEDULESET HH:MM HH:MM`, `SCHEDULE ON/OFF`, `TIME`.
- EEPROM NIGHT R2 остаётся на base 64, но имеет новую magic/version; непроверенные R1-настройки не мигрируются.
- **НЕ ПРОВЕРЕНО:** compile/upload/runtime NIGHT R2.

## Следующая контрольная точка

**Питание измерено, потолочная разводка определена, окончательный BOM утверждён, ESP8266 прошивается и устойчиво обменивается командами с Nano; одно кольцо управляется по Wi‑Fi.**

### Диагностика programmer UART 2026-09-20

- Повторная безопасная попытка с делителем `1,5 кОм / 3,0 кОм` при оставленном `100 µF 10 V` снова завершилась ошибкой загрузки. Точный код ошибки в этом сообщении не зафиксирован.
- Поскольку без делителя + 100 µF полная прошивка на 115200 прошла успешно, а возврат делителя снова нарушил upload, высокий импеданс/качество programmer UART остаётся подтверждённым подозреваемым фактором.
- Следующий тест: низкоомный делитель `750 Ом / 1,5 кОм` из имеющихся резисторов 1,5 кОм, с обязательным измерением HIGH до подключения ESP.

### Вход в ROM bootloader ESP8266 2026-09-20

- При Upload Speed `57600` без ручного reset esptool остаётся на `Connecting...` и соединение не устанавливается.
- Если при `GPIO0 = LOW` кратковременно замкнуть `RST ESP → GND` и отпустить, загрузка начинается.
- Это подтверждает: для текущего стенда Nano-as-USB↔UART автоматический reset/boot ESP не реализован; вход в ROM bootloader выполняется вручную.
- Ошибка отсутствия connect и возможные ошибки уже во время записи — разные этапы диагностики.

### Повторяемость прошивки ESP8266 2026-09-20

- Полная запись на `115200` без внешнего делителя повторно подтверждена: upload доходит до `100%` при ручном кратком reset `RST→GND` на этапе `Connecting...`.
- Без ручного reset соединение с ROM bootloader не начинается.
- С делителем `1,5 кОм / 3,0 кОм` upload снова завершается ошибкой.
- Прямой 5-вольтовый TX не использовать дальше как рабочую схему; задача теперь — сохранить эту устойчивость при безопасном уровне RX.

### Переход к FW-0 Nano 2026-09-20

- Владелец решил временно не тратить время на дальнейший подбор programmer-divider, пока диагностическая прошивка ESP воспроизводимо работает.
- Это **не** отменяет ограничение по уровню: прямой ~5 В на ESP RX остаётся небезопасным и не принимается как финальная схема.
- Создан первый кодовый слой `04_Прошивка/nano_fw0/nano_fw0.ino`: неблокирующий Serial parser, команды `PING`, `STATUS`, `HELP`, централизованные пины D6/D7/A0/A4/A5 и безопасный LOW на DATA-кольцах при старте.
- Код ещё не проверен компиляцией/загрузкой на физической Nano; следующий критерий — аппаратный тест владельца.

### Первая аппаратная попытка FW-0 Nano 2026-09-20

- `nano_fw0.ino` успешно компилируется для выбранной Nano: flash `2514 / 30720` байт (8%), SRAM `254 / 2048` байт (12%).
- Загрузка в Nano не завершилась: 10 попыток `not in sync: resp=0x41`, затем `unable to open port COM3 for programmer arduino`.
- `0x41` соответствует ASCII `A`; с учётом ранее работающего ESP-скетча `ARDU ESP8266 OK` первым проверяется остаточное подключение ESP к D0/D1 Nano. Это пока диагностическая гипотеза, не факт.
- Следующий тест: полностью отключить ESP от D0/D1, убрать `RESET Nano→GND`, закрыть Serial Monitor и повторить upload без изменения Processor/bootloader.

### FW-0 Nano: ESP исключён из причины `resp=0x41`

- Повторный Upload выполнен при полностью отключённых от Nano линиях D0/D1, снятой перемычке `RESET→GND` и закрытом Serial Monitor.
- Результат не изменился: `not in sync: resp=0x41`.
- Следовательно, гипотеза о помехе от ESP8266 на UART Nano для этой ошибки исключена.
- Следующий тест: выбрать `ATmega328P (Old Bootloader)` и повторить Upload на той же Nano/COM3.

### FW-0 Nano закрыт 2026-09-20

- На фактической Mini-USB Nano загрузка проходит при выборе `ATmega328P (Old Bootloader)`.
- После загрузки `PING` возвращает `PONG`.
- `STATUS` возвращает `STATUS FW=FW0 POWER=OFF BRIGHTNESS=32 ...`; полученный uptime `127729 ms` подтверждает устойчивую работу цикла без зависания на момент теста.
- Критерий FW-0 выполнен. Подготовлен следующий слой `04_Прошивка/nano_fw1/nano_fw1.ino` для одного кольца/F01.
- FW-1 пока не считается проверенным: сначала компиляция с FastLED, затем отдельный физический тест одного кольца.

### FW-1 Nano: компиляция пройдена 2026-09-20

- `04_Прошивка/nano_fw1/nano_fw1.ino` успешно компилируется для Mini-USB Nano с `ATmega328P (Old Bootloader)`.
- Библиотека FastLED установлена/доступна в Arduino IDE.
- Следующий шаг — физический тест одного WS2812B-канала на D6. Второе кольцо, ESP8266 и MAX9814 пока не подключать.

### FW-1: схема WS2812B приведена к рекомендациям AlexGyver 2026-09-20

- По явному решению владельца для узлов, у которых есть проверенная схема исходного проекта ColorMusic/AlexGyver, использовать её как базовую и отклоняться только по отдельной инженерной причине.
- Для WS2812B официальная страница ColorMusic рекомендует электролит по питанию ленты минимум `1000 µF`, напряжение не ниже `6,3 V`; общий WS2812-гайд AlexGyver рекомендует `1000–2200 µF` на питание ленты.
- DATA-резистор — отдельный элемент: в WS2812-гайде AlexGyver рекомендованы `200–500 Ом`. Конденсатор 1000 µF не является заменой DATA-резистора.
- Предыдущая временная рекомендация использовать `1,5 кОм` в DATA для FW-1 отменена.
- До физического FW-1 нужно подтвердить номинал/напряжение имеющегося `1000 µF` и наличие резистора `200–500 Ом` (предпочтительно 330 Ом).

### Конденсатор 1000 µF для WS2812B подтверждён

- Фактический электролит для входа питания ленты имеет маркировку `1000 µF 6.3 V`.
- Для 5-вольтовой линии он подходит и соответствует минимальному рабочему напряжению, указанному в рекомендациях ColorMusic/AlexGyver.
- Следующий аппаратный блокер FW-1 — DATA-резистор в диапазоне `200–500 Ом` (предпочтительно 330 Ом).

### FW-1: DATA-резистор подтверждён

- Владелец подготовил последовательный резистор `220 Ом` для DATA WS2812B.
- Номинал входит в диапазон `200–500 Ом`, принятый по рекомендациям AlexGyver.
- Для физического FW-1 теперь подтверждены оба пассивных элемента: `220 Ом` в DATA и `1000 µF 6,3 V` параллельно питанию ленты.
- Следующий шаг — загрузить `nano_fw1.ino` в Nano без подключённой ленты, затем собрать один канал D6→220 Ом→DIN и проверить F01 на первых 43 LED.

### FW-1 аппаратно пройден; начат FW-2

- Один канал WS2812B на D6 с `220 Ом` в DATA и `1000 µF 6,3 V` по питанию работает.
- `STATUS` вернул `STATUS FW=FW1 MODE=F01 POWER=ON BRIGHTNESS=32 RGB=32,0,0 LEDS=43 UPTIME_MS=11880`.
- Команды смены цвета приняты с `OK`; по сообщению владельца тест полностью успешен.
- Критерий FW-1 выполнен.
- Создан `04_Прошивка/nano_fw2/nano_fw2.ino` для двух независимых DATA-линий D6/D7, одинакового кадра на 43+43 LED и диагностических команд `RING A`, `RING B`, `BOTH`.
- Следующий шаг: сначала только скомпилировать FW-2. Для физического FW-2 потребуется второй DATA-резистор `200–500 Ом` и желательно второй электролит порядка `1000 µF` у второго кольца.

### Решение по второму каналу после FW-1

- Владелец решил не переходить сейчас к физическому FW-2.
- Канал `D7` остаётся зарезервирован под второе кольцо и должен в дальнейшем **зеркально повторять кадр D6**, без отдельного режима/состояния.
- Физическое подключение и тест второго кольца откладываются до полной настройки и стабилизации первого кольца.
- Подготовленный `nano_fw2` сохраняется как черновик будущей проверки двух выходов, но не является текущим следующим шагом.
- Текущий фокус: довести одно кольцо до полного рабочего контура. Ближайшая проверка — завершить управление F01 (`OFF/ON/BRIGHT/COLOR`), затем переходить к следующему подсистемному слою на том же кольце.

### F01 одного кольца полностью проверен; следующий слой MAX9814

- Команды `OFF`, `ON`, `BRIGHT 8`, `BRIGHT 64`, `STATUS` проверены владельцем на физическом D6-кольце и работают.
- F01/управление одним кольцом считаются полностью закрытыми для текущего этапа.
- Согласно актуальному однокольцевому порядку следующий слой — MAX9814 на A0.
- Подготовлен `04_Прошивка/nano_mic_test/nano_mic_test.ino`: сохраняет F01 и добавляет неблокирующую диагностику микрофона командой `MIC` (`AVG/MIN/MAX/P2P`).
- Базовая схема MAX9814 берётся по AlexGyver: `Vdd→5V`, `GND→GND`, `Out→A0`; `Gain` и `AR` на первом тесте оставить неподключёнными. Внешний AREF пока не используется, чтобы не добавлять второй неизвестный узел.

### Первые измерения MAX9814 на A0

- Получены два диагностических окна по 50 мс: `AVG=249 MIN=61 MAX=413 P2P=352 SAMPLES=251` и `AVG=252 MIN=130 MAX=415 P2P=285 SAMPLES=251`.
- Среднее около 250 ADC хорошо соответствует ожидаемому смещению выхода MAX9814 около 1,25 В при стандартном 5-вольтовом ADC Nano (идеально около 256 отсчётов).
- В обоих окнах нет явного клиппинга в 0/1023, но P2P уже велик (`285–352`). По этим двум строкам нельзя надёжно сравнить тишину и хлопок: команда `MIC` показывает только последнее завершённое 50-мс окно и может не захватить короткий импульс.
- В `nano_mic_test.ino` добавлена команда `MIC1S`: после запуска она собирает непрерывное 1-секундное окно и автоматически печатает AVG/MIN/MAX/P2P/SAMPLES. Следующий тест — одно окно `MIC1S` в тишине и одно с хлопком/речью в течение самой секунды захвата.

### MAX9814: реакция на звук подтверждена, 60 dB перегружает вход на громком сигнале

- `MIC1S` в тишине: `AVG=252 MIN=108 MAX=417 P2P=309 SAMPLES=4998`.
- `MIC1S` при громком звуке/хлопке: `AVG=307 MIN=0 MAX=886 P2P=886 SAMPLES=4995`.
- Микрофон и A0 однозначно реагируют на звук: P2P вырос с 309 до 886.
- При громком тесте MIN достиг `0`, то есть отрицательная полуволна упёрлась в нижнюю границу ADC; текущий `Gain` floating = 60 dB слишком высокий для громкого сигнала.
- Следующий минимальный тест: соединить `Gain MAX9814 → GND` (50 dB), оставить `AR` неподключённым, повторить `MIC1S` в тишине и при громком звуке. Внешний AREF сейчас не применять: уменьшение опоры ADC только уменьшит запас до клиппинга.

### MAX9814: попытка Gain→GND дала ненормальный нулевой выход

- После изменения только `Gain→GND` получено: `MIC1S AVG=0 MIN=0 MAX=5 P2P=5` и `AVG=0 MIN=0 MAX=16 P2P=16`.
- Это **не соответствует** ожидаемому поведению MAX9814 при 50 dB: DC-смещение OUT должно сохраниться, а не падать почти до нуля.
- Поскольку до перемычки модуль выдавал `AVG≈252`, первым подозревается ошибка подключения/замыкание OUT или неверный контакт Gain, а не внезапная неисправность микрофона.
- Следующий минимальный тест: обесточить стенд, полностью снять перемычку Gain→GND и вернуть точную предыдущую схему `Vdd→5V`, `GND→GND`, `Out→A0`, `Gain/AR` свободны; после включения повторить `MIC1S`. Если AVG снова около 250 — модуль исправен, затем отдельно идентифицировать физический пин Gain перед повтором.

### MAX9814: после снятия Gain→GND рабочий выход восстановился

- После снятия перемычки `Gain→GND` и возврата `Gain` в floating при шуме получено `MIC1S AVG=278 MIN=0 MAX=508 P2P=508 SAMPLES=4996`.
- Это подтверждает, что MAX9814 и вход A0 снова работают; предыдущий почти нулевой результат был связан именно с подключением перемычки/контактом, а не с окончательной неисправностью модуля.
- При floating Gain=60 dB сигнал всё ещё достигает нижней границы ADC (`MIN=0`), поэтому 60 dB для громкого сигнала избыточны.
- До повторной попытки 50/40 dB нужно физически перепроверить, что перемычка ставится именно на вывод `Gain`, а не на соседний `Out`/другую дорожку. Лучше подтвердить фото/маркировкой платы.

### MAX9814: по фото подтверждена распиновка конкретной платы

- На крупном фото читается порядок выводов слева направо: `AR`, `Out`, `Gain`, `Vdd`, `GND`.
- В текущем рабочем подключении: `Out` — жёлтый провод, `Vdd` — зелёный, `GND` — синий; `AR` и центральный `Gain` свободны.
- Для режима 50 dB нужно соединить именно центральный свободный вывод `Gain` с крайним правым `GND`; `Out` (жёлтый) остаётся подключён к A0, `AR` остаётся свободным.
- Перед повтором теста рекомендуется проверить, что перемычка не касается `Out`.

### MAX9814: 50 dB подтверждён, но громкий сигнал всё ещё клиппует

- При `Gain→GND` (50 dB) тишина: `AVG=250 MIN=85 MAX=360 P2P=275 SAMPLES=5000`.
- При громком звуке: `AVG=260 MIN=0 MAX=507 P2P=507 SAMPLES=996`.
- DC-смещение снова нормальное (`AVG≈250`), значит теперь `Gain→GND` подключён правильно.
- На громком сигнале `MIN=0`: нижний клиппинг сохраняется даже при 50 dB. Следующий штатный режим платы — `Gain→Vdd` (40 dB).
- Второй capture имеет аномально низкое число выборок (`996` вместо ~5000/с); это не меняет вывода о клиппинге, но после перехода на 40 dB нужно проверить, повторяется ли аномалия.

### MAX9814 на 50 dB: шум от ленты не выявлен, клиппинг остаётся

- При `Gain→GND` (50 dB) в спокойном состоянии получено `AVG=250 MIN=85 MAX=360 P2P=275 SAMPLES=5000`.
- При шуме с включённой лентой: `AVG=260 MIN=0 MAX=507 P2P=507`; при шуме без ленты: `AVG=257 MIN=0 MAX=506 P2P=506`.
- Практически одинаковые MIN/MAX/P2P при шуме с лентой и без неё показывают, что в текущем стенде WS2812B не вносит заметной дополнительной помехи в A0.
- Но при громком сигнале `MIN=0` сохраняется, то есть 50 dB всё ещё даёт клиппинг по нижней границе ADC.
- Следующий минимальный тест — `Gain→Vdd` (40 dB), `AR` оставить floating, повторить тишину и громкий звук. Если клиппинг исчезнет и P2P останется уверенно выше тихого уровня, 40 dB принять рабочим Gain для M01.

### MAX9814 на 40 dB: FW-4 закрыт, начат M01

- `Gain→Vdd` (40 dB), тихое окно: `AVG=250 MIN=205 MAX=282 P2P=77 SAMPLES=4997`.
- Громкий звук/хлопок: `AVG=250 MIN=0 MAX=503 P2P=503 SAMPLES=4999`.
- На 40 dB тихий фон резко уменьшился по сравнению с 50/60 dB, а реакция на звук остаётся сильной. Краткий экстремальный хлопок всё ещё достигает нижнего rail (`MIN=0`).
- Для M01 это не блокирует продолжение: исходный ColorMusic v2.10 в VU-режимах использует максимум положительных отсчётов, порог тишины, экспоненту 1.4, сглаживание 0.3 и медленный автогейн. Наш положительный максимум меняется примерно от `282` в тишине до `503` при громком звуке.
- Критерий FW-4 выполнен: уровень звука устойчиво отличается от шума помещения. Рабочее состояние MAX9814 для M01 — `Gain→Vdd` (40 dB), `AR` floating.
- Создан `04_Прошивка/nano_m01/nano_m01.ino`, адаптирующий VU-логику ColorMusic под одно кольцо 43 LED на D6. Добавлена команда `CAL`, которая измеряет тихий максимум и ставит `LOW_PASS = quietMax + 13`, как в ColorMusic.

### M01 VU-градиент аппаратно пройден; начат FHT-этап

- Калибровка в тишине: `CAL QUIET_MAX=260 LOW_PASS=273`.
- В рабочем режиме получена диагностика `AUDIO PEAK=276 LOW_PASS=273 LEVEL=2.6 FILTERED=17.8 AVG=63.4 MAX=114.2 PAIRS=3`.
- Владелец подтвердил, что M01 визуально работает на физическом кольце. Критерий первого музыкального режима выполнен.
- Низкий мгновенный `PEAK=276` в одной диагностической строке не противоречит работе: `AUDIO` печатает один текущий кадр, а VU использует сглаживание и медленный автогейн; в этот момент `FILTERED=17.8` и `PAIRS=3` сохраняли реакцию.
- Следующий слой — частотный анализ FHT, всё ещё только на одном кольце.
- Создан `04_Прошивка/nano_fht_test/nano_fht_test.ino`: FHT_N=64, диапазоны ColorMusic `2..5 / 6..10 / 11..31`, калибровка `CALF`, диагностика `FREQ/FREQRAW`.
- В отличие от исходного ColorMusic для ARDU на этапе FHT оставлена `ADC_REF=DEFAULT`: фактический MAX9814 имеет DC offset около 1,25 В, поэтому внутренняя 1,1-вольтовая опора без дополнительного входного преобразования непригодна.

### FHT library choice

- В Arduino Library Manager доступна `AvrFHT` (KobaProduction), но текущий тестовый код ARDU использует API исходной `FHT.h`, как ColorMusic v2.10.
- `AvrFHT` является переработкой старой ArduinoFHT/OpenMusicLabs и меняет структуру заголовков; она не считается drop-in заменой для текущего скетча без адаптации.
- По решению проекта придерживаться проверенной сборки AlexGyver для FHT-этапа используем точную библиотеку `libraries/FHT` из официального репозитория `AlexGyver/ColorMusic` и устанавливаем её вручную в Arduino libraries.

### FHT dependency: переходим на AvrFHT

- Проверен `KobaProduction/AvrFHT` версии `1.1.1`: библиотека предназначена для AVR и является модернизированной версией старой ArduinoFHT/Open Music Labs.
- Она подходит для Arduino Nano ATmega328P, но API немного отличается от старой FHT: используется `FHT_SAMPLES_N`, модульные headers и `fht_transform()` вместо `fht_run()`.
- У AlexGyver FHT действительно есть: в официальном репозитории ColorMusic лежит `libraries/FHT/FHT.h` и связанные таблицы. Это старая библиотека, вложенная в проект, поэтому она может не появляться как отдельная библиотека в Library Manager.
- `04_Прошивка/nano_fht_test/nano_fht_test.ino` переведён на AvrFHT. Для MAX9814 дополнительно введено программное вычитание измеренного DC offset перед FHT; ADC reference остаётся DEFAULT.

### AvrFHT: первая CALF выявила неверное измерение DC, тест исправлен

- Первая попытка после перехода на AvrFHT дала `CALF DC=914 QUIET_MAX=32 SPECTR_LOW_PASS=35`, после чего `FREQ` в тишине и при музыке возвращал нули.
- `DC=914` резко противоречит ранее многократно измеренному MAX9814 offset около `250` ADC, поэтому эти FHT-результаты считаются недействительными.
- Наиболее вероятная причина — измерение DC offset после переключения ADC на быстрый prescaler=32. Код исправлен: DC и отдельная команда `ADC` теперь измеряются на штатном prescaler=128, первые преобразования после переключения отбрасываются, затем для FHT возвращается prescaler=32.
- Следующий тест: загрузить обновлённый `nano_fht_test.ino`, сначала выполнить `ADC`. Ожидаемый AVG около 250. Только затем `CALF`, `FREQRAW`, `FREQ`.

### AvrFHT: повтор CALF всё ещё даёт аномальный DC≈946

- Повтор после исправления: `CALF DC=946 QUIET_MAX=33 SPECTR_LOW_PASS=36`.
- `FREQRAW`: `LOW=19 MID=27 HIGH=19 PEAK=27` и затем `LOW=19 MID=19 HIGH=19 PEAK=19`.
- DC≈946 по-прежнему противоречит ранее подтверждённому MAX9814 offset≈250 на том же A0, поэтому частотные результаты пока не использовать для принятия решений.
- Ключевой следующий тест уже есть в свежем скетче: команда `ADC`. Она одновременно проверяет физический A0 и подтверждает, что на Nano действительно загружена последняя версия скетча (в старой версии команда отсутствует).

### 2026-09-21 — после повторного подключения Gain FHT видит DC=0

- Получено `CALF DC=0 QUIET_MAX=19 SPECTR_LOW_PASS=22`.
- Два `FREQRAW` подряд дали `LOW=0 MID=0 HIGH=0 PEAK=0`.
- **ФАКТ:** это не нормальная работа MAX9814; при ранее исправной схеме его OUT/A0 имел DC около 250 ADC. Нулевой DC означает, что сейчас путь `MAX9814 OUT → A0` фактически находится около 0 В либо нарушен контакт/питание.
- **ПРЕДПОЛОЖЕНИЕ:** поскольку изменение появилось после манипуляции с `Gain→Vdd`, первым проверяется сама перемычка Gain и соседний контакт Out. FHT до восстановления обычного ADC≈250 не диагностировать.

### 2026-09-21 — команда ADC отсутствует на Nano: загружена старая версия FHT-скетча

- В актуальном `04_Прошивка/nano_fht_test/nano_fht_test.ino` команда `ADC` присутствует.
- Физическая Nano отвечает на `ADC` строкой `ERR UNKNOWN_COMMAND`.
- **ФАКТ:** последние результаты `CALF DC=0` и нулевые `FREQRAW` получены не на текущей исправленной версии скетча и не должны использоваться для диагностики железа.
- Следующий шаг — заново загрузить свежий `nano_fht_test.ino` с `ATmega328P (Old Bootloader)`, после загрузки проверить, что `HELP` содержит `ADC`, затем выполнить `ADC`.

### 2026-09-21 — актуальный FHT-скетч подтверждён, прямой ADC почти нулевой

- `HELP` на физической Nano подтвердил актуальную версию: `CMDS PING STATUS ADC CALF FREQ FREQRAW HELP`.
- Прямая команда `ADC` дала `AVG=0 MIN=0 MAX=13`.
- **ФАКТ:** проблема находится до FHT: A0 сейчас видит почти 0 В. Ранее тот же MAX9814 в рабочем M01 давал DC около 250 ADC.
- Следующая развилка — мультиметром измерить непосредственно на модуле `Vdd→GND` и `Out→GND`, не меняя прошивку. Ожидается около 5 В питания и около 1,25 В DC на Out. Если Out≈1,25 В, искать обрыв/неверный контакт до A0; если Out≈0 В, искать проблему питания/перемычки Gain/замыкания на модуле.

### 2026-09-21 — MAX9814 исправен, проблема локализована между Out и Nano A0

- Прямое измерение на MAX9814: `Vdd→GND = 5,09 В`, `Out→GND = 1,24 В`.
- **ФАКТ:** питание MAX9814 и его DC offset нормальны; сам модуль не является причиной `ADC AVG=0`.
- **ФАКТ:** Nano при этом читает `A0` около нуля, значит неисправность/обрыв находится в соединении `MAX9814 Out → Nano A0`, контакте A0 или непосредственно во входе A0.
- Следующий минимальный тест: при включённом стенде измерить напряжение прямо на физическом пине `Nano A0 → Nano GND`, не меняя проводку. Если там около 1,24 В — проблема уже внутри Nano/выбранного входа/скетча; если около 0 В — проблема в проводе/разъёме Out→A0.

### 2026-09-21 — падение между MAX9814 Out и Nano A0 подтверждено

- При том же включённом стенде: `MAX9814 Out→GND = 1,24 В`, а непосредственно `Nano A0→Nano GND = 0,15 В`.
- **ФАКТ:** прямой аналоговый путь `Out→A0` неисправен/имеет плохой контакт либо A0 чем-то нагружен; при исправном соединении эти две точки должны иметь практически одинаковое напряжение.
- Следующий шаг выполнять только при выключенном питании: проверить провод/джампер Out→A0 на сопротивление/прозвонку и отдельно проверить A0→GND на низкое сопротивление при отсоединённом Out.

### 2026-09-21 — провод Out→A0 исправлен, напряжение на A0 восстановлено

- После исправления провода `MAX9814 Out→Nano A0` непосредственно на `Nano A0→GND` измерено `1,25 В`.
- **ФАКТ:** аналоговая линия от MAX9814 до Nano восстановлена; это совпадает с ожидаемым DC offset MAX9814 и предыдущими рабочими измерениями.
- Следующий контроль — команда `ADC` на актуальном FHT-скетче. Ожидаемый `AVG` около 250–260. Только после этого снова выполнять `CALF/FREQRAW/FREQ`.

### 2026-09-21 — AvrFHT заработал после ремонта Out→A0

- Прямой ADC после ремонта: `AVG=250 MIN=233 MAX=264` — DC bias MAX9814 снова нормальный.
- `CALF`: `DC=250 QUIET_MAX=61 SPECTR_LOW_PASS=64`.
- `FREQRAW` в тишине: `LOW=19 MID=19 HIGH=16 PEAK=19`.
- `FREQRAW` при звуке/музыке: `LOW=64 MID=30 HIGH=19 PEAK=64`.
- **ФАКТ:** FHT теперь получает корректный аналоговый сигнал и спектральные значения меняются при звуке. На данном фрагменте сильнее всего вырос диапазон LOW; MID вырос слабее, HIGH почти не изменился.
- `FW-6a` базовый FHT-тракт считать работоспособным, но полное разделение LOW/MID/HIGH ещё не закрыто. Следующий тест — `FREQ` после noise gate в тишине и при музыке; затем при необходимости отдельные частотные тесты.
- `SPECTR_LOW_PASS=64` заметно выше текущего тихого `PEAK=19`, потому что CALF берёт максимальный выброс за серию кадров. Если после gate музыка часто обнуляется, алгоритм калибровки потребуется адаптировать к MAX9814.

### 2026-09-21 — noise gate FHT завышен абсолютным максимумом CALF

- Повторная калибровка: `CALF DC=258 QUIET_MAX=58 SPECTR_LOW_PASS=61`.
- После неё все проверенные `FREQ` дали нули, при этом `FREQRAW` позже показал `LOW=37 MID=19 HIGH=19 PEAK=37`.
- **ФАКТ:** порог `61` выше текущего полезного raw-сигнала `37`, поэтому нулевой `FREQ` является ожидаемым следствием слишком высокого gate, а не отказом AvrFHT.
- Причина алгоритмическая: старая ColorMusic-калибровка берёт абсолютный максимум шума. С MAX9814 единичный выброс завышает порог относительно обычного фона около 19.
- `nano_fht_test.ino` изменён: CALF теперь сохраняет максимум каждого из 100 FHT-кадров, берёт 90-й процентиль и добавляет прежний запас `+3`. В вывод добавлены `P50`, `P90`, `MAX`, чтобы видеть распределение и одиночные выбросы.

### 2026-09-21 — сверка с оригинальным AlexGyver ColorMusic v2.10

- **ФАКТ:** в оригинале VU и частотный анализ используют разные аналоговые входы: `SOUND_R=A2`, `SOUND_R_FREQ=A3`, причём A3 помечен как вход `через кондер`.
- **ФАКТ:** при `POTENT=0` оригинальный код использует внутреннюю опору ADC 1.1 В и ускоряет ADC prescaler до 32.
- **ФАКТ:** оригинальная калибровка спектра делает 100 FHT-анализов, ищет абсолютный максимум по bins 2..31 и ставит `SPEKTR_LOW_PASS = max + 3`. P90-калибровка в текущем ARDU — наша экспериментальная адаптация, а не алгоритм AlexGyver.
- **ФАКТ:** перед ручной калибровкой ColorMusic гасит ленту, ждёт 500 мс, выполняет калибровку и рекомендует ставить музыку на паузу; пороги можно сохранять в EEPROM.
- Следовательно, высокий порог ARDU нельзя считать доказательством недостатка алгоритма AlexGyver: наша текущая входная схема FHT (`MAX9814 Out→A0` напрямую + программное вычитание DC + DEFAULT AREF) отличается от его аппаратного тракта.

### 2026-09-21 — найдено несколько веток ColorMusic и след MAX4466

- На официальной странице AlexGyver ColorMusic подтверждена цепочка официальных прошивок `v1.1 → v2.0 → v2.2 → v2.3 → v2.4 → v2.5 → v2.6 → v2.6.1 → v2.6.2 → v2.7 → v2.8 → v2.10`.
- Официальная страница в списке компонентов указывает микрофонный модуль `MAX9814`; отдельной официальной версии AlexGyver, специально заявленной под MAX4466, не найдено.
- В сообществе есть самостоятельная ветка `ColorMusic FireEdition` (Slenk, на базе technotrasher) с версиями минимум 2.0/2.4/2.5/2.5.1/2.6/2.7/3.1, отдельными входами MIC/LINE и отдельными частотными входами через конденсатор.
- В обсуждении исходного проекта technotrasher 28.12.2020 прямо писал о переработке аппаратной части и выборе `MAX4466` по совету Diman. В FireEdition-потоке также есть практическое обсуждение пользователя с MAX4466 и рекомендации Diman по его подключению. Это сообщественная модификация, а не официальная ревизия AlexGyver.
- До дальнейшего изменения ARDU FHT требуется отдельно сравнить оригинальный MAX9814-тракт и community MAX4466/FireEdition-тракт по схеме, а не только по коду.

### 2026-09-21 — владелец выбрал позднюю официальную линию AlexGyver ColorMusic

- Community FireEdition/MAX4466 больше не рассматривается как основная база прошивки.
- Базу следует выбирать среди поздних официальных ColorMusic; текущий кандидат — `colorMusic_v2.10` как самая поздняя официальная папка прошивки в репозитории AlexGyver.
- Конкретное утверждение v2.10 как финальной версии-базы ждёт выбора владельца после сравнения с v2.7/v2.8.

### 2026-09-21 — оригинальная FHT и поздние ColorMusic сохранены в ARDU

- В ARDU vendored точная FHT из официального `AlexGyver/ColorMusic`, pinned на commit `a3f94de053d431f15282c2f67681b77ab66c30ae`: `04_Прошивка/libraries/FHT/`.
- Сохранены исходные имена файлов, примеры и upstream MIT license.
- `nano_fht_test.ino` переведён с API AvrFHT обратно на исходный API ColorMusic: `FHT_N=64`, `#include <FHT.h>`, `fht_run()`, `fht_mag_log()`.
- Неизменённые поздние официальные скетчи v2.7/v2.8/v2.9/v2.10 сохранены в `08_Исходники_и_референсы/AlexGyver_ColorMusic_official/`.
- Создан каталог точных оригинальных имён прошивок. AvrFHT остаётся историческим диагностическим этапом, но больше не является основной зависимостью.
- Компиляция ARDU после возврата на оригинальную FHT ещё должна быть подтверждена владельцем.

### 2026-09-21 — исправлена совместимость оригинальной FHT с современным FastLED

- Verify с vendored `FHT.h` выявил конфликт препроцессора: оригинальная OpenMusicLabs FHT объявляет глобальный `#define SCALE 1`, а современный FastLED имеет C++ поля/константы с именем `SCALE`.
- Ошибка проявлялась как `expected unqualified-id before numeric constant` в `FastLED/src/fl/math/fixed_point/*`.
- **РЕШЕНИЕ:** оригинальную vendored FHT не изменять; в `nano_fht_test.ino` сразу после `#include <FHT.h>` выполнить `#undef SCALE` перед `#include <FastLED.h>`.
- Это сохраняет исходный FHT-код/имена и устраняет утечку старого макроса в современный FastLED.
- Повторный Verify на физическом ПК ещё требуется.

### 2026-09-21 — оригинальная FHT + FastLED успешно собраны и загружены

- После compatibility fix `#undef SCALE` текущий `nano_fht_test.ino` успешно прошёл компиляцию и Upload на фактическую Nano.
- **ФАКТ:** vendored оригинальная FHT AlexGyver совместима с текущей средой ARDU и современной FastLED при локальном снятии legacy-макроса `SCALE`.
- **ФАКТ:** исходный `FHT.h` при этом не изменён.
- Следующий минимальный runtime-тест: `HELP` и `STATUS`, затем `ADC`; только после подтверждения нормального запуска переходить к дальнейшей проверке FHT.

### 2026-09-21 — runtime original FHT подтверждён, обнаружен ранний DC=390

- После перехода на оригинальную FHT команды работают: `HELP` корректен, `STATUS ... LIB=AlexGyver_FHT FHT_N=64`.
- Прямой ADC после запуска: `AVG=251 MIN=242 MAX=258` — физический MAX9814→A0 исправен и стабилен.
- В том же запуске `STATUS` показал `DC=390`, то есть стартовая `calibrateDcOffset()` отработала не в установившемся состоянии.
- **ФАКТ:** текущее значение A0 около 251; `DC=390` не соответствует текущему входу и не должно использоваться для FHT.
- **ПРЕДПОЛОЖЕНИЕ:** стартовая DC-калибровка выполнялась слишком рано после reset/upload, пока выход MAX9814/аналоговый тракт ещё стабилизировался.
- Код синхронизирован с поздней ColorMusic: экспериментальный P90 удалён, `CALF` снова использует 100 FHT-кадров, абсолютный максимум bins 2..31 и `+3`. Перед калибровкой и стартовой DC-калибровкой добавлена пауза 500 ms.

### 2026-09-21 — причина предыдущего DC=390 уточнена владельцем

- Владелец сообщил, что во время предыдущего runtime-теста провод `MAX9814 Out→Nano A0` отвалился.
- **ФАКТ:** предыдущий `STATUS ... DC=390` нельзя использовать для оценки алгоритма startup DC; вход A0 в тот момент не был надёжно подключён.
- Предыдущая гипотеза о слишком ранней startup-калибровке больше не считается подтверждённой причиной того результата.
- Новый скетч уже загружен. Следующий валидный тест выполнять только при физически исправном `Out→A0`: сначала `ADC`, затем `STATUS`; при согласованных значениях около 250 — `CALF` в тишине.

### 2026-09-21 — original FHT + original CALF дают валидные значения

- После восстановления провода A0 и загрузки свежего скетча:
  - `ADC AVG=265 MIN=259 MAX=272`;
  - `STATUS ... LIB=AlexGyver_FHT FHT_N=64 DC=252`;
  - `CALF DC=264 QUIET_MAX=33 SPECTR_LOW_PASS=36`;
  - `FREQRAW LOW=74 MID=82 HIGH=27 PEAK=82`.
- **ФАКТ:** текущий ADC и повторная DC-калибровка согласованы (~264–265); прежний невалидный DC=390 больше не воспроизводится.
- **ФАКТ:** оригинальный ColorMusic-порог `max + 3` теперь даёт разумный `LOW_PASS=36`, а текущий raw-пик достигает 82, то есть полезный спектральный сигнал способен уверенно превышать gate.
- Контекст последнего `FREQRAW` (тишина/музыка) в сообщении владельца не указан, поэтому разделение тишины и полезного сигнала ещё нужно подтвердить отдельным тестом `FREQ`.

### 2026-09-21 — noise gate original ColorMusic подтверждён на железе

- После `CALF ... SPECTR_LOW_PASS=36` серия в тишине дала три раза подряд `FREQ LOW=0 MID=0 HIGH=0 PEAK=0`.
- При звуке получены как минимум `LOW=38 PEAK=38` и `LOW=66 PEAK=66`; один промежуточный кадр остался нулевым.
- **ФАКТ:** штатный порог ColorMusic `max+3` корректно подавляет текущий тихий фон и пропускает полезные звуковые события.
- **ФАКТ:** текущая группировка совпадает с v2.10: LOW bins 2..5, MID 6..10, HIGH 11..31.
- **НЕ ПОДТВЕРЖДЕНО:** отдельная реакция MID и HIGH; в данной выборке сработал только LOW. FW-6a noise-gate можно считать пройденным, но трёхполосное разделение ещё не закрыто.

### 2026-09-21 — финальный аудиотракт переведён на логику A2/A3 ColorMusic v2.10

- Уточнено: два аналоговых входа — это не другая community-сборка, а сама поздняя официальная `colorMusic_v2.10`: `SOUND_R=A2`, `SOUND_R_FREQ=A3` с пометкой «через кондер».
- Текущий `MAX9814 Out→A0` использовался как диагностический одно-входовый стенд для проверки микрофона, FHT-библиотеки и noise gate; он не считается финальной разводкой музыкального тракта.
- Принято финально повторить оригинальную нумерацию A2/A3, чтобы меньше менять исходный код ColorMusic.
- До перестройки железа нужно отдельно воспроизвести официальный микрофонный вход/конденсаторную связь и определить режим AREF по оригинальной схеме.

### 2026-09-21 — трёхполосное разделение FHT подтверждено на диагностическом A0

Контролируемые тесты на текущем прямом входе `MAX9814 Out→A0`, `LOW_PASS=36`:
- около 2 кГц: `LOW=84..92`, `MID=0`, `HIGH=0`;
- около 5 кГц: `LOW=0`, `MID=92`, `HIGH=0`;
- около 8 кГц: `LOW=0`, `MID=0`, `HIGH=68..78`.

**ФАКТ:** оригинальная FHT, текущая частота выборки и группировка ColorMusic v2.10 bins `2..5 / 6..10 / 11..31` корректно различают LOW/MID/HIGH на реальном Nano.

**ФАКТ:** FW-6a как алгоритмический FHT-диагностический этап на A0 пройден полностью: ADC, CALF, noise gate и трёхполосное разделение подтверждены.

**ОГРАНИЧЕНИЕ:** это результат диагностического прямого A0-тракта. Финальная аппаратная разводка по D-037 остаётся A2 для VU и A3 через оригинальный конденсаторный узел для FHT; после перехода на A3 нужно повторить короткую проверку теми же тонами.

### 2026-09-21 — уточнена физическая логика A2/A3 ColorMusic

- В поздней официальной ColorMusic A2 и A3 — не два независимых выхода микрофона.
- `SOUND_R=A2` — основной аудиовход.
- `SOUND_R_FREQ=A3` — ответвление частотного входа через конденсатор от линии A2.
- В обсуждении оригинального проекта подтверждено: между A2 и A3 используется `0.01 µF = 10 nF` (маркировка `103`).
- Для микрофонной схемы также используется разделительный конденсатор между выходом микрофонного усилителя и A2; точный номинал финально брать с сохранённой официальной схемы перед физической переделкой.
- Пока текущий тестовый скетч читает A0, физически переносить провод на A2/A3 нельзя до обновления кода.

### 2026-09-21 — подготовлен точный стенд A2/A3 по логике ColorMusic v2.10

- Создан `04_Прошивка/nano_audio_v210_test/nano_audio_v210_test.ino`.
- Создан `04_Прошивка/AUDIO_V210_WIRING.md` с точной физической схемой.
- Принята стендовая обвязка из уже имеющихся деталей:
  - `MAX9814 Out → +C1− → A2`, где C1 = 1 µF, допустимый оригинальный диапазон 1–100 µF, рабочее напряжение ≥6,3 V;
  - `A2 → 4,7 kΩ → 4,7 kΩ → GND` = 9,4 kΩ вместо «около 10 kΩ»;
  - `A2 → 10 nF (103) → A3`;
  - Gain→Vdd = 40 dB, AR floating.
- Новый тестовый скетч использует `A2` как VU-вход, `A3` как FHT-вход, original AlexGyver FHT и `analogReference(INTERNAL)` (1,1 V), как поздняя ColorMusic при `POTENT=0`.
- Прямой `MAX9814 Out→A2/A3` в этой версии запрещён: DC offset 1,25 V должен быть отсечён C1.
- Компиляция/загрузка нового A2/A3-скетча ещё не подтверждены на ПК владельца.

### 2026-09-22 — исправлена ошибка: pull-down A2→GND в ColorMusic отсутствует

- Владелец предоставил официальную схему AlexGyver с MAX9814.
- По схеме подтверждено: `MAX9814 Out → C1 1–100 µF → A2`, а `A2 → 103/10 nF → A3`.
- **ФАКТ:** резистора около 10 kΩ от A2 к GND на этой схеме нет. Ранее предложенные `4,7 kΩ + 4,7 kΩ → GND` были ошибочной добавкой и отменены.
- Надпись `10–100 kΩ` на схеме относится к потенциометру AREF, а не к A2.
- A0 в оригинале — `POT_GND` для этого опционального потенциометра; при `POTENT=0` внешний A0 не подключается.
- `AUDIO_V210_WIRING.md`, BOM, инвентарь и тестовый скетч исправлены.

### 2026-09-22 — схема A2/A3 сверена по изображению владельца

- На предоставленной официальной схеме подтверждено отсутствие любого pull-down резистора A2→GND.
- Надпись `10–100 kΩ` относится только к потенциометру между `A0 / AREF / 3V3` для режима `POTENT=1`; к звуковой линии A2 она отношения не имеет.
- В варианте ARDU `POTENT=0` этот потенциометр не устанавливается, внешняя проводка к A0 не нужна.
- Полярность C1 на схеме: отрицательная полоска со стороны A2, то есть `MAX9814 Out → C1(+) / C1(-) → A2`.

### 2026-09-22 — первый runtime финального A2/A3-тракта

- `nano_audio_v210_test` запущен на физической Nano с финальной разводкой ColorMusic v2.10.
- `STATUS FW=FHTV210 ... VU_PIN=A2 FHT_PIN=A3 ... LIB=AlexGyver_FHT FHT_N=64 ADC_REF=INTERNAL_1V1`.
- В тишине получено: `ADC2 AVG=123 MIN=105 MAX=154`.
- В тишине получено: `ADC3 AVG=745 MIN=726 MAX=779`.
- **ФАКТ:** оба входа читаются, не равны нулю и не насыщены на 1023; аппаратный переход с A0 на A2/A3 запущен успешно.
- Различие DC-уровней A2/A3 само по себе не считается ошибкой: сигнальный тракт AC-связан, а оригинальная ColorMusic подаёт в FHT сырые отсчёты A3; спектральные bins 2..31 проверяются следующим шагом.
- `STATUS` печатает `A0=POT_GND_LOW` дважды — косметический дефект диагностической строки, на ADC/FHT не влияет; код до завершения текущего теста не менять.
- Следующий критерий: `CALF` в тишине → несколько `FREQ` в тишине → регрессия 2/5/8 кГц.

### 2026-09-22 — CALF на финальном A3 пройден

- В тишине выполнен `CALF` на `nano_audio_v210_test`.
- Результат: `CALF QUIET_MAX=37 SPECTR_LOW_PASS=40`.
- **ФАКТ:** порог рассчитан точно по исходной формуле ColorMusic `max + 3`; завышения gate на финальной A2/A3-разводке не наблюдается.
- Следующий минимальный тест: несколько `FREQ` подряд в тишине. Ожидание — `LOW/MID/HIGH/PEAK = 0` либо редкие единичные выбросы, не устойчивый сигнал.

### 2026-09-22 — noise gate на финальном A3 пройден

- После `CALF` с `SPECTR_LOW_PASS=40` выполнены три последовательных `FREQ` в тишине.
- Все три результата: `LOW=0 MID=0 HIGH=0 PEAK=0 LOW_PASS=40`.
- **ФАКТ:** штатный spectrum gate полностью подавляет текущий фон на финальной A3-разводке.
- Следующий критерий: контролируемые тоны 2 / 5 / 8 кГц должны соответственно активировать LOW / MID / HIGH уже через финальный A3.

### 2026-09-22 — tone regression на финальном A3 пока не пройден

- При контролируемых тонах 2 / 5 / 8 кГц команда `FREQ` остаётся `LOW=0 MID=0 HIGH=0 PEAK=0 LOW_PASS=40`.
- **ФАКТ:** gate в тишине работает, но полезный тон через финальную A3-разводку пока не подтверждён.
- Это ещё не различает два случая: raw-спектр есть, но ниже порога 40; либо полезный сигнал почти не доходит до A3.
- Следующий минимальный диагностический тест: непрерывный тон 2 кГц → несколько `FREQRAW` без изменения проводки.

### 2026-09-22 — raw FHT при 2 кГц на A3 остаётся на уровне quiet max

- При непрерывном тоне 2 кГц три последовательных `FREQRAW` дали одинаковый результат: `LOW=37 MID=19 HIGH=19 PEAK=37`.
- Предыдущий `CALF` в тишине дал `QUIET_MAX=37`, поэтому текущий 2 кГц raw peak не превышает измеренный максимум тишины и закономерно отсекается gate `40`.
- **ФАКТ:** проблема не в самой команде `FREQ`; полезный 2 кГц сигнал на текущем A3 не поднимает спектр выше quiet baseline.
- Следующий минимальный тест: при том же непрерывном 2 кГц снять `ADC2` и `ADC3` и сравнить их диапазоны с тихими baseline `A2=105..154`, `A3=726..779`.

### 2026-09-22 — тон 2 кГц физически виден на A2 и A3

- При том же непрерывном 2 кГц: `ADC2 AVG=323 MIN=294 MAX=418`, `ADC3 AVG=853 MIN=839 MAX=905`.
- В тишине было: A2 `105..154` (размах 49), A3 `726..779` (размах 53).
- При тоне: A2 размах 124, A3 размах 66.
- **ФАКТ:** полезный сигнал уверенно приходит на A2 и также физически достигает A3; обрыв C1, A2 или ветви 103→A3 не подтверждается.
- При этом FHT raw peak на A3 остаётся 37, поэтому проблема локализована не как полный обрыв, а как недостаточная полезная амплитуда/условия быстрого FHT-сэмплирования на A3.
- Следующий тест: `FREQRAW` отдельно при 5 и 8 кГц, чтобы проверить частотную зависимость ветви 10 нФ до изменения кода или схемы.

### 2026-09-22 — 2/5/8 кГц дают одинаковый raw-спектр на A3

- После 2 кГц те же значения получены и при 5 кГц, и при 8 кГц: `FREQRAW LOW=37 MID=19 HIGH=19 PEAK=37`.
- **ФАКТ:** текущий raw FHT на финальном A3 не различает частоту тестового тона.
- При этом медленный ADC уже подтвердил реакцию A3 на 2 кГц, поэтому полный обрыв входа исключён.
- Выявлено важное отличие от прежнего A0 diagnostic: `nano_fht_test` вычитал измеренный DC offset программно, а `nano_audio_v210_test` по исходной ColorMusic подаёт raw ADC в FHT без вычитания DC.
- В `nano_audio_v210_test` добавлены только диагностические команды, не меняющие обычный `FREQ/FREQRAW`:
  - `ADC3FAST` — A3 при prescaler=32, как в FHT;
  - `FREQRAWZ` — FHT с вычитанием среднего текущего 64-sample кадра.
- Следующий тест после Verify/Upload: при 2 кГц выполнить `ADC3FAST` и `FREQRAWZ`.

### 2026-09-22 — быстрый ADC3 насыщается; сверено с инструкцией AlexGyver

- После добавления диагностики при тестовом тоне получено: `ADC3FAST AVG=1023 MIN=1023 MAX=1023`; `FREQRAWZ LOW=0 MID=0 HIGH=0 PEAK=0`.
- **ФАКТ:** при prescaler=32, который использует ColorMusic для FHT, текущий A3 находится в полном насыщении ADC. Вычитание среднего после такого клиппинга уже не может восстановить спектр.
- Официальная инструкция AlexGyver отдельно предупреждает: режим без потенциометра (`POTENT=0`, внутренняя AREF 1.1 V) работает не с любой громкостью; при слишком низкой AREF Arduino получает слишком высокий сигнал. Для корректной работы предлагается подобрать уровень сигнала либо настроить AREF потенциометром.
- В инвентаре ARDU уже есть `INV-025 B10K`, подходящий к штатной схеме AREF 10–100 kΩ.
- До изменения проводки выполнить `ADC3FAST` в полной тишине. Если он также 1023, считать `POTENT=0 / 1.1 V` неподходящим для текущего MAX9814-стенда и перейти к штатной регулируемой AREF.

### 2026-09-22 — гипотеза локализована на быстром ADC и плавающем A3

- После сверки с ATmega328P datasheet учтено: ADC оптимизирован для источника с выходным сопротивлением порядка ≤10 kΩ; внутренний sample/hold требует времени зарядки.
- Текущий A3 связан с A2 только через последовательный 10 nF, поэтому по постоянному току жёсткой точки покоя на A3 нет.
- **ПРЕДПОЛОЖЕНИЕ:** при prescaler=32 повторные выборки ADC заряжают/смещают плавающий A3, что и даёт 1023 на каждом быстром отсчёте. Это согласуется с тем, что медленный ADC3 остаётся ниже rail.
- В community-сборках ColorMusic встречаются дополнительные 10–100 kΩ (часто 47 kΩ) к GND при проблемах со звуковым трактом, а также отдельный конденсатор от выхода микрофона прямо на частотный вход. Это не официальная схема и пока не принято как решение ARDU.
- В диагностический скетч добавлены `ADC2FAST` и `ADC3TRACE`.
- Следующий тест выполнять в тишине: `ADC2FAST`, `ADC3FAST`, `ADC3TRACE`. Если A2FAST нормален, а A3FAST/TRACE уходят в 1023, причина локализуется именно в ветви 103→A3.

### 2026-09-22 — насыщение подтверждено одновременно на A2 и A3

- В тишине после новой диагностической прошивки: `ADC2FAST AVG=984 MIN=831 MAX=1023`; `ADC3FAST AVG=891 MIN=768 MAX=1023`; `ADC3TRACE` = шестнадцать последовательных `1023`.
- **ФАКТ:** проблема не локальна для ветви A3/103: при prescaler=32 оба AC-связанных входа уходят к верхнему rail.
- Это усиливает гипотезу отсутствия устойчивой DC-привязки после последовательных конденсаторов при быстром ADC.
- Microchip рекомендует низкоомный источник для ADC; community ColorMusic содержит практические исправления с резистивной привязкой обоих аудиовходов к GND.
- Следующий обратимый диагностический тест: добавить по отдельной цепочке `4,7 kΩ + 4,7 kΩ` (=9,4 kΩ) от A2→GND и от A3→GND, не меняя C1/103 и прошивку. Это **не объявляется оригинальной схемой AlexGyver и не является финальным номиналом**; цель — проверить исчезновение fast-ADC saturation.

### 2026-09-22 — подготовлен сравнительный стенд MAX4466

- По решению владельца временно остановлена дальнейшая отладка MAX9814/A2/A3 и подготовлен отдельный сравнительный тест MAX4466.
- MAX4466 в наличии: `INV-015`, модуль с регулируемым gain.
- Созданы `04_Прошивка/AUDIO_MAX4466_WIRING.md` и `04_Прошивка/nano_max4466_test/nano_max4466_test.ino`.
- Первый стенд намеренно исключает 100 µF и 103: MAX4466 OUT идёт отдельно на A2 и A3 через ~9,4 kΩ (2×4,7 kΩ на каждый вход).
- ADC reference = DEFAULT (~5 V); DC bias MAX4466 измеряется и программно вычитается только перед FHT.
- Это **сравнительный эксперимент**, а не замена MAX9814 в финальной архитектуре.
- Следующий шаг: собрать стенд, Verify/Upload, затем в тишине выполнить `STATUS/ADC2/ADC3/ADC2FAST/ADC3FAST`.

### 2026-09-22 — MAX4466 baseline аномально низкий

- В тишине: ADC2=7 (1..12), ADC3=8 (4..12), ADC2FAST=8 (4..14), ADC3FAST=8 (4..15), ADC_REF=DEFAULT_5V.
- Fast ADC стабилен и не saturate, но DC уровень около нуля не соответствует типичному MAX4466 breakout, у которого OUT имеет bias около VCC/2.
- Следующий минимальный шаг — измерить мультиметром VCC→GND и OUT→GND прямо на модуле. CALF/FHT и регулировку gain пока не выполнять.
- Предыдущая последовательная ветвь 9,4 kΩ не считается необходимой: официальный MAX4466 breakout допускает прямое OUT→ADC; решение о переподключении принять после прямого измерения OUT.

### 2026-09-22 — MAX4466: питание есть, OUT≈0 V

- Прямое измерение владельца на модуле: `VCC≈5,1 V`, `OUT≈0 V`.
- Для типичного MAX4466 breakout ожидаемый DC bias OUT в тишине около `VCC/2`; при 5,1 V это примерно 2,55 V.
- **ФАКТ:** текущая проблема находится до FHT/ADC; модуль либо неправильно подключён/нагружен, либо неисправен.
- Следующий минимальный тест: полностью отключить OUT MAX4466 от резисторов/A2/A3, оставить только VCC и GND, затем снова измерить VCC→GND и OUT→GND прямо на модуле.
- Gain не крутить: регулировка gain не должна превращать штатный DC bias VCC/2 в 0 V.

### 2026-09-22 — MAX4466 подтверждён исправным в изоляции

- При отключённом OUT от Nano/резисторов измерено: `VCC≈5,1 V`, `OUT≈2,55 V`.
- **ФАКТ:** модуль MAX4466 исправен и формирует ожидаемый DC bias ≈VCC/2.
- Следовательно, предыдущий `OUT≈0 V` создавался внешней разводкой стенда, а не самим MAX4466.
- Следующий минимальный тест упрощён: без резисторов и без A3 подключить `MAX4466 OUT → Nano A2` напрямую, оставить DEFAULT AREF, затем проверить `ADC2` и `ADC2FAST`.

### 2026-09-22 — прямой MAX4466 OUT→A2: ADC стабилен, но уровень не совпадает с 2,55 V

- При прямом `MAX4466 OUT→Nano A2`, без резисторов/конденсаторов:
  - `ADC2 AVG=244 MIN=208 MAX=293`;
  - `ADC2FAST AVG=230 MIN=199 MAX=286`.
- **ФАКТ:** slow/fast ADC согласуются и saturation отсутствует.
- Но при DEFAULT AREF≈5 V и ранее измеренном изолированном `OUT=2,55 V` ожидался ADC около половины шкалы (~510), а не ~230–244.
- Следующий минимальный тест: при подключённом OUT→A2 измерить мультиметром прямо `MAX4466 OUT→GND` и `Nano A2→GND`. Эти точки должны иметь одинаковое напряжение.

### 2026-09-22 — физическое напряжение A2 не соответствует ADC-коду

- При прямом `MAX4466 OUT→A2` мультиметром подтверждено одновременно:
  - `MAX4466 OUT→GND = 2,55 V`;
  - `Nano A2→GND = 2,55 V`.
- При этом программно: `ADC2 AVG≈244`, `ADC2FAST AVG≈230`.
- **ФАКТ:** микрофон, провод и физическое напряжение на A2 корректны; несоответствие находится в ADC/прошивочном тракте.
- Для локализации создан `04_Прошивка/nano_adc_sanity/nano_adc_sanity.ino`: только `analogRead(A2)`, `analogReference(DEFAULT)`, без FHT/FastLED и без изменения ADC prescaler.
- Следующий критерий: при A2=2,55 V sanity-скетч должен показать около половины шкалы (~510). Если нет — диагностировать конкретную Nano/ADC channel/reference; если да — ошибка находится в MAX4466 diagnostic sketch.

### 2026-09-22 — MAX4466 изолированно даёт OUT≈0,1 V

- MAX4466 полностью отключён от A2/A3 и резистивных ветвей; оставлены только VCC/GND.
- Прямое измерение на модуле: `VCC≈5,1 V`, `OUT≈0,1 V`.
- Для типичного MAX4466 breakout нормальный DC bias OUT в тишине около `VCC/2`; при 5,1 V ожидалось около 2,55 V.
- **ФАКТ:** проблема находится внутри конкретного MAX4466-модуля/его платы, а не в Nano, FHT или внешней нагрузке.
- MAX4466 считать **неподтверждённым/подозрительным по исправности**; сравнительный FHT-тест остановлен.
- Возврат к рабочей ветке MAX9814 выполнять без изменения уже подтверждённых результатов; следующий практический вариант — штатная регулируемая AREF либо отдельный одно-входовый тракт, решение принять следующим шагом.

### 2026-09-22 — принято вернуться к подтверждённому single-input MAX9814

- После неудачного воспроизведения A2/A3-тракта и невалидного сравнительного MAX4466 теста выбран D-040.
- Финальный frontend: `MAX9814 Out→A0` напрямую, DEFAULT AREF, Gain=40 dB, AR floating.
- Один A0 обслуживает и VU, и FHT; для FHT измеренный DC offset вычитается программно.
- Созданы `AUDIO_MAX9814_SINGLE.md` и `nano_audio_single_test.ino`.

### 2026-09-23 — single-input MAX9814 снова даёт нормальный A0, startup DC невалиден

- `STATUS FW=AUDIO_SINGLE ... ADC_REF=DEFAULT DC=467`.
- Сразу после этого: `ADC AVG=237 MIN=225 MAX=250 P2P=25`.
- **ФАКТ:** физический A0 снова находится в ожидаемом диапазоне MAX9814 и не saturate.
- **ФАКТ:** сохранённый startup `DC=467` не соответствует текущему входу `AVG=237` и не должен использоваться для FHT.
- Следующий минимальный тест без изменения проводки: в тишине выполнить `CALF`, который повторно измеряет DC перед spectrum calibration, затем `STATUS` и `FREQ`.
- В тестовый скетч дополнительно добавлена команда `CALDC` для отдельной перекалибровки DC при следующей прошивке, но текущий загруженный скетч можно проверить через существующий `CALF`.

### 2026-09-23 — D-040 CALF на A0 снова валиден

- В тишине выполнен `CALF` на single-input MAX9814/A0.
- Результат: `CALF DC=234 QUIET_MAX=33 SPECTR_LOW_PASS=36`.
- **ФАКТ:** DC=234 согласуется с предыдущим `ADC AVG=237`; программное DC subtraction снова валидно.
- **ФАКТ:** spectrum gate=36 совпадает с ранее успешным A0 baseline.
- Следующий минимальный тест: несколько `FREQ` в тишине; затем повторить 2/5/8 kHz.

## Актуальный handoff — 2026-09-27

- **ФАКТ:** владелец подтвердил полный аппаратный pass NIGHT R2 schedule; FW-9 считается закрытым.
- **РЕШЕНИЕ владельца:** M02 VU радуга закрыт; M06 после успешного теста исключён из целевого функционала.
- До общей прошивки следующим отдельным слоем закрыть L01 ordinary light и clap diagnostic.
- Приложение начинать только после аппаратного pass полной единой прошивки Nano.
- Сетевой режим v1: только домашняя Wi-Fi сеть; резервный SoftAP не реализовывать.
- Приложение должно позволять настраивать параметры каждого режима и запускать калибровку MAX9814.
- В приложении обязателен Developer Mode: диагностика, тесты режимов, live-параметры и отправка сервисных/тестовых команд.
- Создан `04_Прошивка/nano_m02_r1/nano_m02_r1.ino` и `04_Прошивка/M02_R1_TEST.md`.
- M02 R1 сохраняет проверенный MAX9814 Out→A0 / 40 dB / DEFAULT AREF и геометрию M01; добавляет Rainbow palette, runtime `SMOOTH` и `RAINSTEP10`, а также проверенный FastLED/UART guard.
- **НЕ ПРОВЕРЕНО:** M02 R1 ещё не компилировался и не загружался на физическую Nano.
- M02 R1 полностью пройден; следующий практический слой — L01 R1.

### 2026-09-27 — добавлен L01 и RTC clock в приложение

- **РЕШЕНИЕ:** приложение показывает время DS3231 на главном экране; RTC, а не телефон, является источником отображаемого времени.
- **РЕШЕНИЕ:** добавлен верхний раздел `light` и стабильный ID `L01`.
- **РЕШЕНИЕ:** L01 должен включаться после холодного старта при появлении питания от второй клавиши 230 В.
- **РЕШЕНИЕ:** MAX9814 используется для локального хлопкового выключателя обычного света; функцию можно включить/отключить из приложения.
- **НЕ ПРОВЕРЕНО:** алгоритм распознавания хлопка; его параметры будут выбраны только после отдельного hardware test с проверкой ложных срабатываний.
- Создан `04_Прошивка/LIGHT_CLAP_REQUIREMENTS.md`.
- Обновлены MODEL_IDS, режимы, HTTP API, модель экранов и UART-требования.
- Порядок до общей прошивки: M02 (закрыт) → L01 → clap diagnostic → единая Nano-прошивка.

### 2026-09-27 — M02 R1 compile/upload passed

- **ФАКТ:** M02 R1 успешно скомпилирован и загружен на физическую Nano.
- **НЕ ПРОВЕРЕНО:** ADC/DC, CAL, визуальный VU-rainbow, RAINSTEP10, SMOOTH, UART stress и OFF/ON.
- **Следующий практический шаг:** открыть Serial Monitor 115200 / Newline, подтвердить startup `ARDU NANO M02 R1 READY`, затем выполнить `ADC` и `STATUS`.
- Если `ADC AVG` вне 120..400 или `DC_OK=NO`, калибровку не выполнять; сначала восстановить MAX9814/A0.

### 2026-09-27 — M02 R1 ADC gate passed

- **ФАКТ:** `ADC AVG=250 MIN=226 MAX=274 P2P=48`; STATUS `DC=249 DC_OK=YES CAL=NO`.
- MAX9814/A0 gate пройден; можно выполнять CAL в тишине.
- В одном STATUS поле ожидаемого `LEDS=43` пришло как `LDS=43`; проверить на UART stress, пока не считать подтверждённой ошибкой.

### 2026-09-27 — M02 visual pass и persistence requirement

- **ФАКТ:** владелец подтвердил визуально корректную работу M02 R1.
- **ФАКТ:** при `BRIGHT=64` фон практически не виден на значениях `BACKGROUND < 35`; заметное свечение начинается примерно с `BACKGROUND=35`.
- Это наблюдение относится к текущему одному 43-LED кольцу и текущей глобальной FastLED brightness; диапазон команды пока не менять. Нормализацию пользовательского slider решить при общей прошивке/app tuning.
- **РЕШЕНИЕ:** настройки всех режимов должны сохраняться на Nano и переживать полное отключение питания.
- **РЕШЕНИЕ:** приложение хранит настройки всех режимов в локальном cache, но Nano остаётся источником истины и после подключения приложение перечитывает полный набор.
- **ФАКТ ПО КОДУ:** текущий M02 R1 не сохраняет BRIGHT/BACKGROUND/SMOOTH/RAINSTEP10 в EEPROM; это тестовая ревизия и не является финальным persistence behavior.
- Создан `04_Прошивка/PERSISTENCE_V1.md`.

### 2026-09-27 — M02 R1 полностью пройден; M06 удалён; L01 R1 next

- **ФАКТ:** владелец подтвердил успешные CAL и UART stress-test без ошибок.
- Ранее подтверждены: compile/upload, ADC gate, визуальный VU-rainbow, изменение RAINSTEP10/SMOOTH, background behavior и ON/OFF.
- **ИТОГ:** M02 R1 считается полностью пройденным на железе на одном D6-кольце.
- Наблюдение M02: при BRIGHT=64 видимый BACKGROUND начинается примерно с raw value 35; это оставить для будущего UI scaling.
- **ФАКТ:** M06 R1 был успешно загружен и полностью прошёл аппаратный тест.
- **РЕШЕНИЕ владельца:** несмотря на успешный тест, стробоскоп полностью исключён из ARDU; тестовые файлы удалены, режим не входит в приложение/API/persistence.
- Созданы `04_Прошивка/nano_l01_r1/nano_l01_r1.ino` и `04_Прошивка/L01_R1_TEST.md`.
- **Следующий практический шаг:** Verify/Upload L01 R1 и полный аппаратный тест обычного белого света.

### 2026-09-27 — M06 removed, L01 R1 prepared

- **ФАКТ:** M06 R1 полностью прошёл hardware test.
- **РЕШЕНИЕ владельца:** стробоскоп не нужен в ARDU; M06 исключён из active modes.
- Файлы `nano_m06_r1` и `M06_R1_TEST.md` удалены.
- Создан `nano_l01_r1`: постоянный RGB-white, startup ON, BRIGHT 0..255, ON/OFF, single-ring current limit 500 mA, FastLED/UART guard.
- Создан `L01_R1_TEST.md`.
- В L01 R1 clap и общая EEPROM persistence намеренно отсутствуют; они идут следующими слоями.

### 2026-09-27 — L01 R1 passed; L01 R2 Kelvin/RGB persistence prepared

- **ФАКТ:** владелец подтвердил полный hardware pass L01 R1: startup ON, постоянный белый, BRIGHT, ON/OFF, BRIGHT=0 semantics, UART stress и reset behavior.
- **РЕШЕНИЕ:** L01 расширяется до температурного и цветного ordinary light.
- Приложение должно иметь пресеты `2700 K / 4000 K / 6000 K`, Kelvin slider и произвольный color picker.
- Выбранный L01 profile (Kelvin или RGB + brightness) должен сохраняться на Nano.
- После полного отключения/включения питания cold startup должен включать L01 с последним сохранённым profile.
- Создан `04_Прошивка/nano_l01_r2/nano_l01_r2.ino`.
- Создан `04_Прошивка/L01_R2_TEST.md`.
- R2 использует внутреннюю EEPROM Nano: `SAVE` коммитит profile, `LOAD` восстанавливает.
- **Следующий практический шаг:** Verify/Upload L01 R2 и выполнить `L01_R2_TEST.md`; после pass перейти к clap diagnostic.

### 2026-09-27 — L01 R2 compile/upload passed

- **ФАКТ:** L01 R2 успешно загружен на физическую Nano.
- **НЕ ПРОВЕРЕНО:** Kelvin presets/range, arbitrary RGB, brightness, SAVE/LOAD, reset restore и full power-cycle restore.
- Следующий шаг — полный `L01_R2_TEST.md`.

### 2026-09-27 — L01 R2 passed; 44 LED and warmer 2700 K

- **ФАКТ:** владелец подтвердил полный hardware pass L01 R2: Kelvin, presets, arbitrary RGB, brightness, SAVE/LOAD, Reset restore и полный power-cycle restore.
- **ФАКТ:** физическое кольцо увеличено с 43 до 44 WS2812B.
- **РЕШЕНИЕ:** новый preset 2700 K должен использовать визуальный оттенок прежнего R2 2200 K: `RGB=255,170,87`.
- Создан `04_Прошивка/nano_l01_r3/nano_l01_r3.ino`: `FW REV=3`, `LED_COUNT=44`, новый 2700 K mapping.
- Создан `04_Прошивка/L01_R3_TEST.md`.
- **ОБЯЗАТЕЛЬНО ДО ОБЩЕЙ ПРОШИВКИ:** адаптировать всю геометрию режимов, которые ранее тестировались на 43 LED, особенно M01/M02/M03/M04/M08/M09.

### 2026-09-27 — L01 R3 passed; historical 43 LED sketches frozen

- **ФАКТ:** владелец подтвердил полный hardware pass L01 R3.
- Все 44 LED работают; новый preset 2700 K визуально принят; SAVE/reset/full power-cycle persistence работает.
- **РЕШЕНИЕ:** старые скетчи, аппаратно проверенные на 43 LED, не изменять.
- Новая 44-LED геометрия учитывается только в новых слоях и при сборке общей Nano-прошивки.
- Общая прошивка обязана отдельно адаптировать M01/M02/M03/M04/M08/M09 под 44 LED и пройти visual regression.
- Созданы `nano_clap_diag_r1/nano_clap_diag_r1.ino` и `CLAP_DIAG_R1_TEST.md`.
- **Следующий практический шаг:** Verify/Upload CLAP DIAG R1 и собрать измерения хлопков/ложных срабатываний.

### 2026-09-27 — CLAP DIAG R1 не различает хлопок; создан R2

- **ФАКТ:** startup R1: `DC=255 DC_OK=YES CAL=NO THRESH=180`.
- **ФАКТ:** обычный ADC в присланном тесте: `AVG=264 MIN=246 MAX=281 P2P=35 PEAK_DEV=26`.
- **ФАКТ:** короткие щелчки мыши генерировали `EVENT IMPULSE_CANDIDATE` с P2P примерно `181..417`.
- **ФАКТ:** обычные хлопки владельца при том же R1 не генерировали EVENT.
- **ФАКТ ПО КОДУ:** R1 trigger использовал только `P2P >= threshold`; CALCLAP в присланном запуске не выполнялся (`CAL=NO`).
- Не понижать threshold вслепую: мышь/дверь уже являются ложными импульсами для single-peak detector.
- Создан `nano_clap_diag_r2`: raw `CAPTURE` без threshold, отдельные MAX_P2P/MAX_DEV/MAX_AVG_SHIFT, shorter blocks и dual-threshold event detector.
- Следующий критерий — сравнить CAPTURE для silence/click/3×clap/speech/music.

### 2026-09-27 — CLAP DIAG R2: max-based calibration rejected

- **ФАКТ:** `CALCLAP DC=249 QUIET_AVG_P2P=17 QUIET_MAX_P2P=366 QUIET_AVG_DEV=15 QUIET_MAX_DEV=204 THRESH_P2P=732 THRESH_DEV=408`.
- **ФАКТ:** средний quiet baseline мал (`17/15`), но редкие выбросы сильно поднимают absolute max; формула на основе quiet maximum делает threshold непригодно высоким.
- **ФАКТ:** R2 STATUS: DC_OK=YES, CAL=YES, BLOCK_N=16.
- **ФАКТ:** присланные CAPTURE maxima находятся примерно в диапазоне P2P 318..507 / DEV 172..269; несколько измерений практически доходят до одинакового ограниченного диапазона MAX9814.
- **РЕШЕНИЕ ДЛЯ СЛЕДУЮЩЕГО ТЕСТА:** не использовать текущий auto-calculated threshold; вручную поставить `THRESH 180 120` и проверить event capture на хлопках/тишине/речи/музыке.
- Следующая ревизия calibration должна использовать устойчивый baseline (average/percentile/exceedance), а не абсолютный максимум окна.

### 2026-09-27 — CLAP DIAG R3 delayed arming prepared

- Root cause confirmed: Serial Monitor mouse click can contaminate immediate calibration/arming.
- R3 waits 1500 ms before CALCLAP measurement and before arming after CLEAR/ARM ON.
- R3 derives thresholds from quiet averages; quiet maxima are informational only.
- Event candidate now requires BOTH P2P and DEV; lockout increased to 250 ms.
- Created `nano_clap_diag_r3` and `CLAP_DIAG_R3_TEST.md`.
- Next: Verify/Upload R3, then clap/silence/speech/music/double-clap characterization.

### 2026-09-27 — найден штатный AlexGyver double-clap algorithm

- Проверена `GyverLibs/Clap`: распознавание строится по derivative входного уровня и state machine, а не по абсолютному P2P.
- Проверена `AlexGyver/GyverLamp2`: `VolAnalyzer.getRawMax() → Clap`, `TRSH=250`, `timeout=500 ms`, управление состоянием только по двум хлопкам.
- Предыдущие CLAP DIAG R1-R3 считать диагностической веткой, а не final detector.
- Созданы:
  - `04_Прошивка/nano_clap_gyver_r1/nano_clap_gyver_r1.ino`;
  - `04_Прошивка/CLAP_GYVER_R1_TEST.md`;
  - `04_Прошивка/CLAP_GYVER_REFERENCE.md`.
- Первый test начинается с точных GyverLamp2 parameters 250/500; если физический clap не ловится, снижать только derivative threshold 250→200→150.

### 2026-09-27 — CLAP GYVER R1 failed at TRSH=250; R2 prepared

- **ФАКТ:** GYVER R1 startup показал ложный `DC=1019 DC_OK=NO`, но позже `ADC AVG=250 MIN=181 MAX=312 P2P=131`; startup DC measurement признан невалидным.
- **ФАКТ:** при `CLAP_TRSH=250` хлопки не распознавались.
- **ИСТОЧНИК:** в самой GyverLibs/Clap default derivative threshold = 150; значение 250 — настройка конкретного GyverLamp2.
- Создан `nano_clap_gyver_r2`:
  - default `TRSH=150`;
  - timeout 500 ms;
  - startup settle 1200 ms + discard reads;
  - first rawMax primes derivative baseline;
  - 700 ms command-click guard после CLEAR/TRSH/TIMEOUT.
- Создан `CLAP_GYVER_R2_TEST.md`.
- Следующий критерий: hardware test R2; если TRSH=150 не ловит clap, использовать TRACE и только затем пробовать 100.

### 2026-09-27 — CLAP GYVER R2 startup gate passed

- **ФАКТ:** R2 startup: `DC=252 DC_OK=YES CLAP_TRSH=150 CLAP_TIMEOUT_MS=500`.
- **ФАКТ:** command-click guard завершился штатно: `EVENT CLAP_READY`.
- **ФАКТ:** subsequent ADC: `AVG=250 MIN=159 MAX=385 P2P=226`; saturation отсутствует.
- Startup ADC regression R1 (`DC=1019`) исправлен.
- Следующий gate — фактическое распознавание одиночного clap при TRSH=150; если нет EVENT CLAP, снять TRACE на 3 хлопках.

### 2026-09-27 — CLAP GYVER R2 works, threshold 150 too high

- **ФАКТ:** Gyver derivative/state-machine algorithm распознаёт реальные хлопки на ARDU.
- При `TRSH=150` распознавание нестабильно: владелец описывает примерно «через раз».
- В TRACE два пропущенных хлопка имели rawMax rise примерно `267→354` и `265→350` (около +87/+85), а распознанный сильный хлопок `~270→514` (около +244).
- Поэтому `TRSH=150` выше амплитуды derivative части обычных хлопков MAX9814.
- TRACE поле `DER` часто показывает 0, потому что печатается реже, чем 10 ms detector tick; rawMax transition используется как наблюдаемая оценка короткого derivative.
- **Следующий test:** runtime `TRSH 80`, затем single/double clap reliability и false-positive tests. Прошивку пока не менять.

### 2026-09-27 — Gyver R2 at TRSH=80: singles sensitive, double partially reliable

- **ФАКТ:** при runtime `TRSH=80` одиночный clap распознаётся заметно лучше.
- В single-clap run: `STATS SINGLE_EVENTS=14 SEQUENCES=14 DOUBLE_EVENTS=0`; владелец отмечает ложные одиночные срабатывания.
- Ключевой положительный факт: лишние одиночные события в этом run не собрались в ложный `DOUBLE_CLAP`.
- В double-clap run подтверждены минимум 4 `EVENT DOUBLE_CLAP`; владелец оценивает надёжность двойного хлопка примерно «через раз».
- Успешные пары по timestamps имели интервалы примерно 291 ms, 291 ms, 151 ms и 141 ms.
- **Следующий минимальный test без новой прошивки:** `TRSH 70`, `TIMEOUT=500` оставить без изменения; проверить 10 double-clap pairs и затем false DOUBLE_CLAP на тишине/речи/музыке.

### 2026-09-27 — Gyver clap false-positive run: zero events

- Владелец прислал три последовательных `STATS SINGLE_EVENTS=0 SEQUENCES=0 DOUBLE_EVENTS=0`.
- Если это запрошенные тесты тишины/речи/музыки при текущем threshold, ложных clap/double-clap событий не наблюдалось.
- Для фиксации final threshold всё ещё нужен отдельный reliability result: 10 намеренных double-clap pairs при том же runtime threshold.

### 2026-09-27 — family clap calibration R3 prepared

- **ФАКТ:** при runtime threshold≈70 Gyver-style detector дал 8 confirmed DOUBLE_CLAP из 10 намеренных пар; отдельные одиночные false clap встречаются.
- **РЕШЕНИЕ:** fixed threshold не считать финальным, т.к. устройством будут пользоваться несколько детей с разной силой хлопка.
- Создан `nano_clap_gyver_r3_cal`:
  - quiet P99 derivative baseline;
  - 3..12 prompted double-clap samples;
  - хранение weak/strong clap strengths;
  - threshold по lower robust clap distribution + quiet floor;
  - apply-before-save;
  - EEPROM save/cancel.
- Для трёх детей рекомендуемый calibration session = 9 successful pairs (по 3 на каждого).
- Следующий шаг: Verify/Upload R3 CAL и выполнить family calibration test.

### 2026-09-27 — clap calibration deferred; FW-10 CORE R1 created

- **РЕШЕНИЕ владельца:** семейную clap calibration выполнять позже через приложение.
- До calibration default: `double clap / TRSH=70 / TIMEOUT=500 ms`.
- Создан первый общий интеграционный sketch:
  `04_Прошивка/nano_fw10_core_r1/nano_fw10_core_r1.ino`.
- Создан полный test plan:
  `04_Прошивка/FW10_CORE_R1_TEST.md`.
- CORE R1 объединяет: 44-LED L01, clap, DS3231, Alarm/Dawn R2, Night R2, EEPROM blocks и reset/power-on policy.
- Старые 43-LED sketches не изменены.
- R1 намеренно оставляет D7 LOW и current limit=500 mA для безопасного one-ring integration test.
- Ambient/Music пока не включены; они добавляются после CORE pass отдельными интеграционными слоями.
- **НЕ ПРОВЕРЕНО:** compile/upload FW-10 CORE R1.
- Следующий практический шаг: Verify/Upload CORE R1; если compile fails — остановиться и исправить до hardware tests.

### 2026-09-27 — FW-10 CORE R1 first compile error fixed

- **ФАКТ:** первый Verify FW-10 CORE R1 упал на Arduino auto-prototype preprocessing:
  - `LightPersist does not name a type`;
  - `ClapPersist does not name a type`.
- Причина: структуры были объявлены ниже функций, чьи прототипы Arduino IDE автоматически поднимала вверх.
- Исправление: `LightPersist` и `ClapPersist` перенесены в верхнюю type section до функций.
- Дополнительно проверен порядок всех пользовательских типов: более ранних использований до объявления не найдено.
- Следующий шаг: повторный Verify того же `nano_fw10_core_r1.ino`.

### 2026-09-27 — FW-10 CORE R1 compile passed

- **ФАКТ:** повторный Verify `nano_fw10_core_r1.ino` прошёл успешно.
- Arduino IDE report:
  - flash: `26014 / 30720 bytes` = 84%;
  - SRAM globals: `1316 / 2048 bytes` = 64%;
  - estimated remaining SRAM for stack/locals: 732 bytes.
- **РЕШЕНИЕ ДЛЯ ИНТЕГРАЦИИ:** CORE R1 можно загружать и тестировать; перед добавлением Ambient/Music отдельно контролировать flash/SRAM budget.
- Android Studio доступен у владельца; mobile app после полного Nano regression можно реализовывать как Android Studio/Kotlin project.
- Следующий шаг: Upload FW-10 CORE R1 и выполнить startup gate из `FW10_CORE_R1_TEST.md`.

### 2026-09-27 — FW-10 CORE R1 upload/startup partial pass; RTC invalid

- **ФАКТ:** FW-10 CORE R1 успешно загружен и стартовал на Nano.
- Startup:
  - `MODE=L01`;
  - `RESET=WARM_UNKNOWN MCUSR=0`;
  - `LEDS=44`;
  - `RING_A=D6`;
  - `RING_B=DISCONNECTED_TEST`;
  - `LIMIT_MA=500`;
  - `CLAP=ON CLAP_TRSH=70`.
- **ФАКТ:** warm reset differentiation с RAM-cookie работает даже при очищенном bootloader-ом MCUSR.
- **БЛОКЕР:** `RTC_VALID=NO`; до Night schedule / Alarm / Dawn recovery продолжать integration regression нельзя.
- Следующий шаг: локализовать RTC (presence / OSF / read) до остальных CORE tests.

### 2026-09-27 — FW-10 CORE R1 RTC gate passed

- **ФАКТ:** после установки/проверки RTC владелец подтвердил, что FW-10 CORE R1 показывает корректный RTC и блокер `RTC_VALID=NO` снят.
- Можно продолжать integration regression.
- Следующий блок: L01 EEPROM regression + clap toggle + warm Reset vs cold power-on.

### 2026-09-27 — FW-10 CORE R1 L01/clap/reset/power block passed

- **ФАКТ:** владелец подтвердил успешный интеграционный блок:
  - L01 profile save/load;
  - double-clap toggle;
  - одиночный clap не переключает L01;
  - service Reset восстанавливает OFF и не имитирует wall switch;
  - настоящий cold power-cycle включает L01 с сохранённым profile.
- D-058 в CORE R1 считается подтверждённым на текущем one-ring стенде.
- Следующий блок regression: Night manual + Night schedule.

### 2026-09-27 — FW-10 CORE R1 Night block passed

- **ФАКТ:** владелец подтвердил успешный integrated Night regression в FW-10 CORE R1.
- Пройдены:
  - manual ON/OFF;
  - HUE/SAT/BRIGHT;
  - schedule ON/OFF;
  - [ON, OFF) transitions;
  - schedule persistence through Reset;
  - manual NIGHT ON override disables schedule.
- Следующий и последний CORE R1 functional block: Dawn renderer/recovery + Alarm trigger.

### 2026-09-27 — regression moved to app; ESP HTTP bridge R1 created

- **РЕШЕНИЕ владельца:** повторный ручной Dawn/Alarm/Core regression отложить; выполнять финальный сквозной regression уже через приложение.
- Android Studio доступен; целевое приложение — native Kotlin.
- Создан `05_WiFi_и_приложение/esp8266_http_bridge_r1/esp8266_http_bridge_r1.ino`.
- ESP R1:
  - Station only;
  - local HTTP;
  - `GET /api/ping`;
  - `GET /api/status`;
  - `GET /api/time`;
  - `POST /api/dev/nano` raw Developer command;
  - `GET /api/events` polling последних async Nano lines;
  - UART Nano = 115200.
- Wi-Fi credentials вынесены в ignored local `wifi_secrets.h`; в repo только `wifi_secrets.example.h`.
- Создан `ESP8266_HTTP_BRIDGE_R1_TEST.md`.
- Следующий шаг: compile/upload ESP bridge и только минимально подтвердить Wi-Fi/HTTP/Nano transport; затем создавать Android app R1.

### 2026-09-27 — ESP8266 HTTP BRIDGE R1 compile passed

- **ФАКТ:** `esp8266_http_bridge_r1.ino` успешно компилируется.
- Arduino IDE memory report:
  - RAM globals/statics: `30808 / 80192` = 38%;
  - IRAM total used: `60223 / 65536` = 91% (включая 32768-byte instruction cache);
  - IRAM code: 27455 bytes;
  - flash IROM: `294372 / 1048576` = 28%.
- Compile gate пройден; следующий шаг — Upload на физический ESP8266 по уже подтверждённой manual-boot procedure, затем HTTP/UART smoke test.

### 2026-09-27 — ESP8266 pre-upload voltage gate passed

- **ФАКТ:** перед загрузкой HTTP BRIDGE R1 измерено:
  - S-30-5 output = 5.01 V;
  - YP-8 input = 5.01 V;
  - YP-8 output = 3.32 V;
  - ESP8266 VCC/GND = 3.24 V;
  - YP-8 GND → ESP GND drop = 0.00 V;
  - GPIO0→GND in flash mode = 0.06 V;
  - ESP RST idle = 3.25 V.
- Питание, ground path и boot strap GPIO0/RST проходят pre-upload gate.
- Следующий шаг: загрузка ESP8266 HTTP BRIDGE R1 по подтверждённой manual-reset procedure.

### 2026-09-27 — ESP8266 HTTP BRIDGE R1 upload passed

- **ФАКТ:** физическая загрузка `esp8266_http_bridge_r1.ino` успешно завершена.
- Esptool: ESP8266EX, crystal 26 MHz, flash auto-detected 4 MB.
- Written: 328512 bytes (237168 compressed), 100%.
- `Hash of data verified`.
- Следующий шаг: перевести ESP из flash mode в normal boot, собрать рабочий Nano↔ESP UART с level divider и выполнить HTTP smoke test.

### 2026-09-27 — ESP8266 HTTP/Wi-Fi smoke passed

- **ФАКТ:** `GET /api/ping` успешно отвечает с физического ESP8266 HTTP BRIDGE R1.
- Ответ: `ok=true`, device=`ARDU-ESP8266`, fw=`HTTP_BRIDGE_R1`, `wifi_connected=true`, IP=`192.168.0.4`, RSSI=`-55 dBm`.
- Wi-Fi Station + local HTTP server считаются пройденными.
- Следующий gate: UART ESP↔Nano через `GET /api/status` и raw `POST /api/dev/nano` body=`PING`.

### 2026-09-29 — рабочий UART divider Nano→ESP проверен

- **ФАКТ:** рабочий делитель `Nano D1/TX → 1.5 kΩ → ESP RX`, с нижним плечом `3.0 kΩ` к GND, собран и проверен мультиметром.
- **ФАКТ:** уровни относительно общей GND соответствуют ожидаемым (~5 V на Nano TX и ~3.3 V на ESP RX); падение между Nano TX и ESP RX около 1.65 V согласуется с делителем.
- Следующий gate: повторный `GET /api/status` для проверки двунаправленного UART ESP↔Nano.

### 2026-09-29 — ESP↔Nano UART transport passed

- **ФАКТ:** после компактной пересборки рабочий UART ESP8266↔Nano проходит end-to-end HTTP test.
- `GET /api/status` returned Nano `STATUS FW=FW10_CORE REV=1 ...` with `timed_out=false`.
- raw `PING` through `POST /api/dev/nano` returned `PONG`.
- `GET /api/time` reaches Nano but returns `ERR RTC_INVALID`.
- **Вывод:** Wi-Fi + HTTP + both UART directions are working; remaining issue is isolated to RTC validity/wiring/state, not ESP transport.
- Next: restore/verify DS3231, then Android Studio Kotlin R1 can start on the now-proven transport.

### 2026-09-29 — RTC write restored after wiring fix

- **ФАКТ:** после исправления провода DS3231 команда через HTTP/UART `SET 2026-09-29 23:39:00` вернула `OK TIME=2026-09-29 23:39:00` с `timed_out=false`.
- Предыдущий `ERR RTC_WRITE` был связан с физическим соединением RTC после компактной пересборки.
- Остался финальный read-back gate: `GET /api/time` должен вернуть валидное `TIME ...`.
- После read-back минимальный ESP/Wi-Fi/UART/RTC transport gate считается закрытым, следующий этап — Android Studio Kotlin app R1.

### 2026-09-29 — ESP/Wi-Fi/UART/RTC transport gate closed

- **ФАКТ:** после исправления RTC-провода `SET 2026-09-29 23:39:00` вернул `OK TIME=...`.
- **ФАКТ:** последующий `GET /api/time` вернул `TIME 2026-09-29 23:41:24` с `timed_out=false`.
- **ФАКТ:** ранее в том же рабочем стенде подтверждены `/api/ping`, `/api/status` и raw `PING→PONG`.
- Минимальный gate `Android/PC → Wi-Fi → ESP8266 HTTP → UART → Nano → DS3231 → ответ обратно` закрыт.
- По D-071 следующий практический этап — Android Studio / Kotlin app R1; повторный ручной общий regression выполняется уже через приложение.

### 2026-09-29 — создан исходный Android Studio/Kotlin app R1

- **ФАКТ ПО РЕПОЗИТОРИЮ:** создан `05_WiFi_и_приложение/android_app_r1/` — native Android/Kotlin проект R1 с Gradle wrapper.
- R1 реализует `GET /api/ping`, `GET /api/status`, `GET /api/time` и скрытый Developer Mode для raw `POST /api/dev/nano`.
- Текущий bridge-контракт отражён без выдуманного semantic layer: STATUS/TIME берутся из поля `nano` и показывают фактический ответ Nano.
- Nano остаётся источником истины; обычный UI не показывает IP или UART.
- `/api/events` намеренно отложен на следующую малую Developer Mode итерацию.
- Добавлен `05_WiFi_и_приложение/ANDROID_APP_R1_TEST.md`.
- **ФАКТ:** Gradle Sync в Android Studio на Windows успешно пройден 2026-09-29 после разрешения AGP path check для Unicode-пути репозитория.
- **ФАКТ:** Android build/install и запуск приложения на физическом телефоне успешно пройдены.
- **НЕ ПРОВЕРЕНО:** реальные HTTP-запросы именно из приложения к ARDU ещё не подтверждены.
- Следующий gate: запустить приложение на физическом телефоне и закрыть `ping → status → time → Developer PING/PONG`; после PASS перейти к экрану L01.

### 2026-09-29 — Android app R1 Gradle Sync passed

- **ФАКТ:** проект `05_WiFi_и_приложение/android_app_r1` успешно синхронизирован Android Studio.
- Первый sync blocker был связан с кириллицей в пути `05_WiFi_и_приложение`; исправлен настройкой `android.overridePathCheck=true` в `gradle.properties`.
- Следующий gate: запуск приложения на физическом Android-телефоне в той же домашней Wi-Fi сети.

### 2026-09-29 — Android app R1 physical launch passed

- **ФАКТ:** приложение R1 успешно собрано, установлено и открылось на физическом Android-телефоне из Android Studio.
- Следующий gate — подтвердить автоматический `/api/ping` по отображению `Онлайн • HTTP_BRIDGE_R1`, затем STATUS/TIME и Developer `PING→PONG`.

### 2026-09-29 — Android app R1 /api/ping passed

- **ФАКТ:** физический Android-телефон с app R1 показал `Онлайн • HTTP_BRIDGE_R1`.
- Это подтверждает реальный путь `Android app → home Wi-Fi → ESP8266 HTTP /api/ping`.
- Следующий gate: проверить отображаемый Nano STATUS, затем DS3231 time и Developer `PING→PONG`.

### 2026-09-30 — Android app R1 /api/status passed

- **ФАКТ:** физический Android-телефон через app R1 получил Nano STATUS: `FW=FW10_CORE REV=1 MODE=OFF RESET=WARM_UNKNOWN MCUSR=0 LEDS=44 RING_A=D6 RING_B=DISCONNECTED_TEST LIMIT_MA=500 RTC_VALID=YES TIME=2026-09-30 00:39:56 CLAP=ON CLAP_TRSH=70 UPTIME_MS=83578`.
- Подтверждён реальный путь `Android app → ESP HTTP /api/status → UART → Nano → ответ обратно`.
- Следующий gate: отдельное поле времени приложения через `/api/time`, затем Developer `PING→PONG`.

### 2026-09-30 — Android app R1 /api/time passed

- **ФАКТ:** поле `Время ARDU (DS3231)` на физическом телефоне показывает валидное время формата `2026-09-30 00:xx:xx` и оно увеличивается после обновления.
- **ФАКТ:** `UPTIME_MS` в Nano STATUS также увеличивается между запросами, что подтверждает непрерывную работу Nano во время теста.
- Следующий и последний gate минимального app transport R1: Developer Mode `PING → PONG`.

### 2026-09-30 — Android app transport R1 fully passed

- **ФАКТ:** Developer Mode на физическом Android-телефоне отправил raw `PING` через `POST /api/dev/nano` и получил `PONG`.
- Вместе с уже пройденными app `/api/ping`, `/api/status` и `/api/time` это закрывает минимальный Android transport R1.
- Проверенный путь: `Android app → home Wi-Fi → ESP8266 HTTP_BRIDGE_R1 → UART → Nano FW10 CORE R1 → DS3231/Nano response → app`.

### 2026-09-30 — L01 semantic stage 1 implemented in repository

- **ФАКТ ПО КОДУ:** создана новая ревизия ESP `05_WiFi_и_приложение/esp8266_http_bridge_r2/esp8266_http_bridge_r2.ino`; проверенный R1 не переписан.
- R2 сохраняет R1 endpoints и startup UART framing fix, добавляет:
  - `GET /api/light/status`;
  - `POST /api/light/settings` с первым атомарным payload `{"enabled":true|false}`.
- Обычный Android UI больше не использует raw Developer endpoint для L01: добавлен блок `Обычный свет L01`, semantic read и кнопки ON/OFF.
- **НЕ ПРОВЕРЕНО ФИЗИЧЕСКИ:** R2 ещё не компилировался/не загружался на ESP; L01 semantic ON/OFF из приложения ещё не проходил hardware test.
- Следующий gate: compile/upload HTTP_BRIDGE_R2, получить `HTTP_BRIDGE_R2` в app, затем проверить L01 ON/OFF.

### 2026-09-30 — ESP reflash deferred; L01 uses R1 compatibility adapter

- **РЕШЕНИЕ владельца:** не разбирать/переключать уже компактно спаянный рабочий стенд ради каждой новой app-функции.
- **РЕШЕНИЕ:** физический ESP пока остаётся на проверенном `HTTP_BRIDGE_R1`.
- Android L01 stage 1 использует существующий `/api/dev/nano` только внутри transport layer: `STATUS`, `LIGHT STATUS`, `LIGHT ON`, `LIGHT OFF`.
- Обычный пользовательский UI не показывает raw-команды/IP/UART; Nano остаётся источником истины.
- `HTTP_BRIDGE_R2` не удаляется, но его физический compile/upload больше не является текущим gate. Семантические ESP endpoints будут собраны пакетно и прошиты позже одним обслуживаемым этапом.
- **Текущий следующий gate:** пересобрать только Android app на телефоне и проверить L01 OFF→ON→OFF через текущий физический HTTP_BRIDGE_R1.

### 2026-09-30 — HTTP_BRIDGE_R4 with manual Wi-Fi credentials + OTA prepared

- **РЕШЕНИЕ владельца:** отказаться от `wifi_secrets.h` для ближайшей физической прошивки; SSID/password вводить вручную в локальную копию скетча непосредственно перед upload.
- **РЕШЕНИЕ владельца:** добавить OTA, чтобы после одного wired upload дальнейшие ESP revisions загружать по Wi-Fi без перекоммутации спаянного стенда.
- **ФАКТ ПО КОДУ:** создан `esp8266_http_bridge_r3/esp8266_http_bridge_r3.ino`.
- R3 наследует transport R1 и semantic L01 endpoints R2, добавляет ArduinoOTA с hostname `ardu`, port `8266`, password authentication и `ArduinoOTA.handle()` в loop.
- OTA callbacks намеренно не печатают в `Serial`, потому что ESP Serial является UART к Nano.
- `GET /api/ping` R3 сообщает `ota_ready/ota_hostname/ota_port`, но не раскрывает password.
- **НЕ ПРОВЕРЕНО ФИЗИЧЕСКИ:** R3 ещё не компилировался, не прошивался и OTA proof ещё не выполнен.

### 2026-09-30 — R3 superseded before test; R4 prepared

- **ФАКТ ПО QA:** до физической компиляции R3 обнаружена несовместимость проверки placeholders с актуальным ESP8266 `WString`: сравнение `String != F(...)` не является поддерживаемым оператором.
- R3 помечается `superseded_before_test`; на железо его не загружать.
- Создан `HTTP_BRIDGE_R4`: placeholder checks используют обычный `strcmp`; при незаполненных credentials reconnect-loop Wi-Fi/OTA не запускается.
- Архитектура R4 осталась той же: ручные SSID/password/OTA password + ArduinoOTA + transport/L01 functionality.
- **НЕ ПРОВЕРЕНО:** R4 ещё не компилировался и не загружался.

### 2026-09-30 — ESP GPIO2 pull-up and bootloader behavior confirmed

- **ФАКТ владельца:** текущая физическая сборка имеет `ESP GPIO2 → 4.7 kΩ → 3.3 V`.
- **РЕШЕНИЕ:** этот pull-up оставить; GPIO2 является boot-strap pin и должен быть HIGH при normal boot и UART bootloader. Через 4.7 kΩ это допустимо; прямое жесткое соединение GPIO2→3.3 V не использовать.
- **ФАКТ владельца:** текущая прошивка ESP теперь начинается без дополнительного ручного краткого `RST→GND` на этапе `Connecting...`.
- **ИНТЕРПРЕТАЦИЯ:** отдельный manual reset не обязателен, если ESP уже вошёл в ROM bootloader при reset/power-up с `GPIO0=LOW`.

### 2026-09-30 — HTTP_BRIDGE_R4 Wi-Fi/HTTP/OTA startup passed

- **ФАКТ:** после исправления SSID в локальной копии R4 физический ESP8266 успешно подключился к домашнему Wi-Fi.
- **ФАКТ:** `GET http://192.168.0.4/api/ping` вернул:
  - `ok=true`;
  - `fw=HTTP_BRIDGE_R4`;
  - `wifi_connected=true`;
  - `ip=192.168.0.4`;
  - `rssi=-57`;
  - `ota_ready=true`;
  - `ota_hostname=ardu`;
  - `ota_port=8266`.
- **ФАКТ:** `curl http://ardu.local/api/ping` на Windows не резолвится: `Could not resolve host: ardu.local`.
- **ВЫВОД:** Wi-Fi, HTTP и OTA service на ESP работают; текущая проблема локализована к mDNS/hostname resolution на ПК, а не к ESP connectivity.
- Следующий gate: доказать OTA upload через network port/IP, затем STATUS/TIME/Developer PING regression и L01 app test.

### 2026-10-01 — проект переведён в режим финализации v1

- **РЕШЕНИЕ владельца:** больше не выполнять мелкие промежуточные загрузки Nano/ESP ради каждой функции; подготовить полные release-прошивки и загрузить их по одному разу.
- Создан канонический `FINALIZATION_PLAN.md`.
- CORE R3 остаётся compile-tested исходником CLAPCAL, но физически не загружается как промежуточная ревизия.
- Финальная Nano v1 должна включить все обязательные режимы, family CLAPCAL, persistence, D6+D7 44+44 и service-adjustable current limit.
- Финальный ESP v1 должен получить полный semantic API и сохранить OTA.
- После firmware freeze порядок: Android functionality → дизайн/UX → второе кольцо/power → потолочный монтаж → acceptance/release.
- Следующий практический шаг: сборка исходника полной Nano v1 и compile/SRAM optimization без физической прошивки до полного scope.

### 2026-10-01 — физическая потолочная топология уточнена владельцем

- **ФАКТ:** расстояние между двумя корпусами ≈ 2 м.
- **ФАКТ:** доступ к существующей проводке в стенах отсутствует.
- **ФАКТ:** у ближайшего ко входу корпуса есть доступная потолочная точка бывшей люстры, где физически можно разместить общий S-30-5.
- **ФАКТ:** к корпусам приходит существующая линия 2×2,5 мм² от одного выключателя.
- **РЕШЕНИЕ владельца:** ко второму корпусу будет проложена новая низковольтная 5-вольтовая трасса за потолком.
- **АРХИТЕКТУРНОЕ СЛЕДСТВИЕ:** контроллерный узел Nano/ESP/RTC/MAX9814 и S-30-5 размещать у первого корпуса; Ring A=D6 локально, Ring B=D7 через ~2 м low-voltage run.
- Для Ring B финальная трасса должна включать минимум +5V, GND и DATA D7; DATA вести рядом с reference GND. Старую 230-V линию не использовать как DATA.
- **ОТКРЫТЫЙ SAFETY GATE:** перед монтажом проверить фактическую маркировку/класс S-30-5 и необходимость PE/FG. При двухжильном вводе нельзя предполагать наличие защитного проводника.

### 2026-10-01 — S-30-5 PE requirement confirmed by photo

- **ФАКТ ПО ФОТО:** клеммник S-30-5 подписан слева направо `L / N / ⏚ / -V / +V`.
- **ФАКТ ПО ФОТО:** защитная клемма `⏚` присутствует и сейчас не подключена.
- **ФАКТ ПО ФОТО:** корпус БП металлический.
- **ВЫВОД:** этот экземпляр S-30-5 должен рассматриваться как БП с защитным заземлением корпуса; оставлять клемму PE пустой в финальном потолочном монтаже нельзя.
- При существующем вводе `2×2,5 мм²` отдельный PE не подтверждён. До финального монтажа нужно либо обеспечить отдельный защитный PE до S-30-5, либо заменить S-30-5 на подходящий Class II / double-insulated 230→5 V источник без PE requirement.
- Нейтраль `N` нельзя использовать как PE.

### 2026-10-01 — PE at ceiling confirmed unavailable

- **ФАКТ владельца:** защитного PE-проводника в потолочной точке нет.
- **РЕШЕНИЕ:** металлический S-30-5 с клеммой ⏚ исключён из финального потолочного монтажа и остаётся стендовым/лабораторным БП.
- Для финальной установки требуется Class II / double-insulated 230→5 V источник достаточной мощности, не требующий PE.
- Это не блокирует Nano/ESP firmware, Android и low-voltage проектирование.

### 2026-10-01 — full Nano v1 compact release candidate fits ATmega328P

- Создана и доведена до successful CI compile полная `04_Прошивка/nano_ardu_v1/nano_ardu_v1.ino`.
- В release candidate входят: 2×44 mirrored D6/D7, L01, clap + CLAPCAL, RTC, Night, Alarm/Dawn recovery, Ambient F01-F03, Music M01/M02/M03/M04/M05/M08/M09, extended persistence и service current limit.
- Первый прямой merge был слишком большим: `43638/30720` flash и `1975/2048` globals.
- После compact refactor:
  - удалён Wire в пользу компактного DS3231 TWI path;
  - UART v1 переведён на компактный числовой протокол;
  - заменён тяжёлый FastLED power model на компактный dual-ring limiter;
  - уплотнены async EVENT/calibration replies.
- **CI PASS:** flash `28090/30720` = 91%; globals `1070/2048` = 52%; свободно SRAM для stack/locals `978 bytes`.
- Последний GitHub Actions `Arduino Verify` = SUCCESS.
- **ФИЗИЧЕСКИ НЕ ЗАГРУЖЕНО:** Nano всё ещё работает на FW10 CORE R1.
- Следующий практический этап — подготовить финальный ESP8266 v1 под замороженный compact UART v1 и выполнить compile gate обеих release-прошивок перед одним обслуживаемым сеансом финальной загрузки Nano + ESP.

### 2026-10-01 — final ESP8266 v1 source + Nano/ESP contract compile pass

- Создан `05_WiFi_и_приложение/esp8266_ardu_v1/esp8266_ardu_v1.ino`.
- ESP v1 сохраняет проверенные Station Wi-Fi + ArduinoOTA и реализует полный semantic HTTP API поверх compact numeric Nano UART v1.
- Реализованы: status/settings/time, mode/power, полный L01 + clap calibration wizard, Music, Ambient, Night, Alarm/Dawn, current limit, events и Developer raw numeric endpoint.
- Ambient effect selection дополнительно коммитится persistent через opcode 110.
- Static contract scan: каждый literal opcode ESP присутствует в Nano; missing opcodes = NONE.
- Compact UART v1 документирован в `06_Интерфейс_управления/UART_V1.md`.
- **ESP CI PASS:** RAM 31988/80192 (39%); IRAM 60823/65536 (92%); IROM code 324376 bytes.
- **Nano после persistence fix CI PASS:** 28024/30720 flash (91%); globals 1070/2048 (52%), free SRAM 978 bytes.
- Night HUE/SAT/BRIGHT и Dawn parameters теперь имеют RAM live-preview + явные save opcodes 56/77, чтобы slider не писал EEPROM на каждом промежуточном значении.
- Физические release uploads ещё не выполнялись.

### 2026-10-02 — replacement Nano pending; Android functional v1 source/CI complete

- **ФАКТ СО СЛОВ ВЛАДЕЛЬЦА:** final Nano upload на текущую плату пока не удаётся; заказана новая Nano.
- **НЕ ПОДТВЕРЖДЕНО:** точная аппаратная причина отказа старой Nano. Не считать плату доказанно неисправной до отдельной диагностики.
- Firmware source не менялся: Nano v1 и ESP v1 остаются release candidates с compile PASS.
- Android app обновлён до `0.9-functional-v1-rc1`.
- Android теперь использует final `ARDU_ESP_V1` semantic API, а не HTTP_BRIDGE_R7 response assumptions.
- Реализованы все пользовательские разделы: Light, Music, Ambient, Night, Alarm/Dawn.
- Реализованы clap family calibration, microphone calibration, RTC sync, STOP Dawn, events, current limit и numeric Developer UART v1.
- Подключение: сохранённый/ручной адрес + fallback discovery; приложение не зависит только от `ardu.local`.
- JVM mock-ESP contract tests PASS.
- Android debug APK build PASS в GitHub Actions.
- Physical Android end-to-end test отложен до final Nano+ESP uploads.
- Acceptance plan: `05_WiFi_и_приложение/ANDROID_V1_FUNCTIONAL_TEST.md`.

### 2026-10-02 — stateful ESP v1 mock ready for pre-hardware Android testing

- Создан `05_WiFi_и_приложение/mock_esp_v1/mock_esp_v1.py`.
- Mock использует только Python stdlib и поднимает stateful final HTTP API на PC.
- Android-телефон может подключаться к `<PC_LAN_IP>:8080` через manual address.
- Симулируются Light/Music/Ambient/Night/Alarm, clap calibration, audio calibration, current limit, events и numeric Developer UART.
- Это только UI/API test double; LED/FHT/RTC/electrical behavior он не подтверждает.
- Mock ESP Verify CI: Python syntax + HTTP/state smoke PASS.

### 2026-10-02 — Android mock device smoke passed on physical phone

- **ФАКТ СО СЛОВ ВЛАДЕЛЬЦА + SCREENSHOT:** Android `0.9-functional-v1-rc1` успешно подключился на физическом телефоне к `ARDU_ESP_V1_MOCK`.
- На экране подтверждены:
  - состояние `Онлайн`;
  - firmware `ARDU_ESP_V1_MOCK`;
  - RSSI mock;
  - текущий semantic mode;
  - RTC/date-time rendering;
  - section navigation;
  - Alarm/Dawn controls и значения из `/api/settings`.
- Это закрывает manual UI/API smoke для mock path.
- Реальный hardware end-to-end остаётся pending до replacement Nano + final Nano/ESP uploads.
- Пока replacement Nano в пути следующий software этап: Android design/UX polish без изменения frozen firmware/API.

### 2026-10-02 — Android design/UX v1 RC implemented

- Android version: `0.10-design-v1-rc1`.
- Functional API layer unchanged; frozen firmware/HTTP/UART contracts were not modified.
- Engineering prototype UI replaced by dark user-oriented UI:
  - fixed bottom navigation for 5 main sections: Light / Music / Ambient / Night / Alarm;
  - no horizontal scrolling for primary navigation;
  - Settings moved to a separate header action;
  - status/header card with connection, current semantic mode and RTC time;
  - grouped settings cards with clearer hierarchy;
  - primary/secondary action styling;
  - live RGB/Hue color previews;
  - Developer Mode visually isolated inside Settings.
- Manual-address/mock workflow remains supported.
- Static ID scan: missing/duplicate layout IDs = NONE.
- GitHub Actions after redesign: JVM API contract tests PASS + debug APK build PASS.
- Physical visual/UX smoke on owner phone is next software check; real end-to-end remains blocked only by replacement Nano/final firmware upload.

### 2026-10-02 — Android smart-home UI v0.11 implemented

- По обратной связи владельца верхняя status-card v0.10 была слишком высокой, а основной control language всё ещё слишком slider-oriented.
- Создан Android `0.11-home-ui-rc1`.
- Header сокращён до compact two-row control:
  - ARDU;
  - `● Онлайн/Нет связи`;
  - small refresh;
  - settings;
  - current semantic mode;
  - HH:MM RTC.
- Firmware/RSSI больше не занимают main header; technical ESP data выводятся в Settings diagnostics.
- Light screen переработан как smart-home dashboard:
  - compact power card;
  - quick scenes: Evening 2200 K / Warm 2700 K / Day 4000 K / Cool 6000 K;
  - brightness percentage + ± step controls;
  - slider сохранён только как fine adjustment;
  - interactive HSV color wheel без сторонних libraries;
  - precise RGB sliders скрыты под advanced action;
  - startup profile + clap сгруппированы как behavior.
- Scene actions используют существующий semantic API; firmware/API contract не менялся.
- Static layout scan: missing IDs = NONE; duplicate IDs = NONE.
- Final GitHub Actions for `d78f44dc`: `testDebugUnitTest` PASS + `assembleDebug` PASS.
- Следующая software проверка: owner-phone visual smoke на stateful ESP mock.

### 2026-10-02 — custom smart sliders replace primitive Light SeekBars

- Owner accepted Light functionality/smart-home direction but identified standard Android sliders as visually primitive.
- Created reusable native `SmartSliderView` without third-party libraries.
- Light brightness slider:
  - 24dp rounded track;
  - semantic dark→accent brightness fill;
  - large draggable thumb;
  - touch anywhere on track;
  - API commit only on finger release.
- Light Kelvin slider:
  - continuous warm orange → warm white → cool blue gradient;
  - large thumb tinted by current Kelvin;
  - range remains 1800..6500 K.
- Existing ± brightness buttons and quick scenes remain.
- Component is reusable for Music/Ambient/Night/Alarm after owner visual approval.
- Android version: `0.12-smart-slider-rc1`.
- Final GitHub Actions run: contract tests PASS + debug APK build PASS.
- Firmware/API contract unchanged.

### 2026-10-02 — smart-home interaction language propagated to all user tabs

- **ФАКТ ПО OWNER SCREENSHOT/FEEDBACK:** Light v0.12 visual direction accepted; owner explicitly asked to propagate it to other tabs, tune font sizes and use icons where text is redundant.
- Android version: `0.13-smart-home-tabs-rc1`.
- Music:
  - all primary sliders replaced by `SmartSliderView`;
  - brightness/background use brightness semantics;
  - smoothing/sensitivity/speed use neutral accent semantics;
  - M09 hue uses rainbow slider;
  - mode buttons use selected-state smart cards;
  - submode selection gets selected state;
  - power actions reduced to compact ▶ / ■.
- Ambient:
  - Hue uses rainbow smart slider;
  - saturation/speed/period use accent smart sliders;
  - brightness uses brightness smart slider;
  - F01/F02/F03 show selected state;
  - compact ▶ / ■ power actions.
- Night:
  - Hue/saturation/brightness converted to semantic smart sliders;
  - schedule retained as compact functional card.
- Alarm/Dawn:
  - fade, max brightness, start/end hue use smart sliders;
  - hue sliders are rainbow-semantic;
  - save time uses compact ✓ action;
  - RTC sync and STOP Dawn labels shortened.
- Typography scale normalized: section 24sp, card 16sp, values 15sp, secondary labels/buttons 13sp.
- Stock `SeekBar` remains only in collapsed precise RGB service controls and service current-limit; no stock SeekBar remains in primary normal-user controls.
- During refactor static ID validation caught an over-broad XML replacement; layout was restored from clean v0.12 and reapplied safely. Final ID scan: missing NONE, duplicates NONE.
- GitHub Actions final run `37056022090`: contract tests PASS + debug APK build PASS.
- Firmware/API contract unchanged.

### 2026-10-03 — OWNER APPROVED final Android direction implemented: Home Hub + Focus Dial

- **РЕШЕНИЕ ВЛАДЕЛЬЦА:** финальный Android visual/interaction direction = Unified iPhone Style, объединяющий Home Hub и Focus Dial; текущая mint-dark palette остаётся.
- Android version: `0.14-ios-homehub-focus-rc1`.
- Light теперь имеет два внутренних UI-level экрана без нового API:
  1. **Home Hub overview** — contextual living-room hero, device summary, quick scenes, brightness/Kelvin summary;
  2. **Focus Dial control** — крупный интерактивный circular brightness dial, ON/OFF, Kelvin, color wheel, precise RGB, startup profile и clap.
- Переход overview↔control локальный; Nano остаётся source of truth, после write приложение reread делает как раньше.
- Создан native reusable `FocusDialView`:
  - 270° dial;
  - brightness 0..255;
  - large draggable thumb;
  - percentage rendering;
  - local preview while moving;
  - semantic HTTP write only on release.
- Создан native reusable `RoomHeroView` без bitmap/third-party assets:
  - LIVING;
  - MUSIC;
  - AMBIENT;
  - NIGHT;
  - DAWN.
- Music/Ambient/Night/Alarm получили contextual room hero в утверждённом Home Hub language; существующие smart sliders/selected-state controls сохранены.
- Никаких новых HTTP endpoints, UART opcodes или firmware changes.
- Static layout validation after integration: missing IDs = NONE, duplicate IDs = NONE, duplicate functions = NONE.
- GitHub Actions final run `37062432020`: `testDebugUnitTest` PASS + `assembleDebug` PASS.
- Следующий Android gate: owner-phone visual smoke `0.14` через stateful ESP mock; после replacement Nano — physical end-to-end.

### 2026-10-03 — premium Light pass v0.15 complete

- Следующий approved-design этап выполнен: Light Home Hub overview + Focus Dial control доведены ближе к утверждённому concept board.
- Android version: `0.15-premium-light-rc1`.
- Добавлен native `SceneTileView`:
  - visual previews для Evening/Warm/Day/Cool;
  - мини room/window/lamp composition;
  - без bitmap assets и third-party libraries.
- Home Hub `RoomHeroView` получил дополнительную глубину:
  - plant silhouette;
  - floor shadow;
  - cinematic vignette/light falloff.
- `FocusDialView` получил premium polish:
  - mint→cyan sweep gradient;
  - outer glow;
  - radial center glow;
  - scale ticks;
  - large white thumb;
  - сохранена логика local preview + semantic commit on release.
- Light scene behavior не изменён: scenes по-прежнему compose existing semantic Light calls.
- Static layout check: missing IDs = NONE; duplicate IDs = NONE; duplicate functions = NONE.
- GitHub Actions run `37102197040`: `testDebugUnitTest` PASS + `assembleDebug` PASS.
- Firmware/API/UART contract unchanged.
- Следующий software gate: owner-phone visual smoke Light overview + Focus Dial. После approval — тот же premium level распространяется на Music/Ambient/Night/Alarm.

### 2026-10-03 — real photo assets integrated into Light Home Hub v0.16

- **РЕШЕНИЕ ВЛАДЕЛЬЦА:** для финального premium UI выбран вариант с реальными hero/image assets, а не canvas-иллюстрациями.
- Android version: `0.16-real-assets-light-rc1`.
- В Android repo добавлены оптимизированные generated WebP assets:
  - `ardu_light_hero.webp` — 640×360, 12.6 KB;
  - `ardu_scene_evening.webp` — 120×160, 2.1 KB;
  - `ardu_scene_warm.webp` — 120×160, 2.8 KB;
  - `ardu_scene_day.webp` — 120×160, 3.5 KB;
  - `ardu_scene_cool.webp` — 120×160, 2.8 KB.
- Суммарный photo-asset footprint ≈ 24 KB.
- Light Home Hub:
  - canvas `RoomHeroView` для Light заменён реальным hero photo;
  - ARDU / Online status / Refresh / Settings теперь расположены поверх hero;
  - отдельная rectangular global status-card скрывается на вкладке Light;
  - Light title / room context / description / ordinary-light device card собраны внутри hero;
  - device card использует glass-style overlay.
- `SceneTileView` теперь center-crop рендерит реальные WebP фото и рисует только readability gradient + labels поверх.
- Music/Ambient/Night/Alarm пока используют текущие contextual heroes; real-asset propagation откладывается до owner review Light.
- Static Android contract: missing IDs = 0; duplicate IDs = 0; duplicate functions = 0.
- GitHub Actions final run `37105664138`: `testDebugUnitTest` PASS + `assembleDebug` PASS.
- Firmware/API/UART unchanged.

### 2026-10-03 — Light real-asset layout polish v0.17

- **OWNER FEEDBACK:** real-photo direction accepted; two visual defects identified:
  1. hero center-crop cut the warm floor lamp;
  2. Brightness/Temperature summary cards were not visually equal.
- Android version: `0.17-light-layout-polish-rc1`.
- Added dependency-free native `FocalCropImageView`:
  - same center-crop coverage semantics;
  - explicit focal point;
  - Light hero focus = X 0.64 / Y 0.50;
  - image translation is clamped so no empty area can appear.
- Result: right-side lamp stays inside the almost-square hero without stretching the image.
- Brightness/Temperature summary cards now both:
  - height = 108dp;
  - equal weight/width;
  - 16dp padding;
  - center-vertical content;
  - primary value = 26sp.
- Static layout validation: missing IDs = 0; duplicate IDs = 0; duplicate functions = 0.
- Final GitHub Actions run `37110520082`: contract tests PASS + debug APK build PASS.
- Firmware/API/UART unchanged.

### 2026-10-03 — contextual photo heroes propagated to Music/Ambient/Night/Alarm v0.18

- **OWNER PASS:** исправленная геометрия Light `0.17-light-layout-polish-rc1` принята владельцем на телефоне.
- Android version: `0.18-photo-heroes-rc1`.
- `RoomHeroView` больше не рисует схематичную комнату Canvas-примитивами.
- Music / Ambient / Night / Alarm используют существующий утверждённый 640×360 photorealistic hero как общий high-resolution master:
  - Music — левый focal crop + indigo/teal grade;
  - Ambient — central crop + purple/cyan grade;
  - Night — right-biased crop + deep navy/warm-lamp grade;
  - Alarm/Dawn — warm crop + sunrise/golden grade.
- Это намеренно маленькая обратимая итерация: общий photo master проверяет композицию/crop/contrast до добавления отдельных уникальных photo assets для каждого раздела.
- HTTP API v1, numeric UART v1, Nano/ESP firmware и semantic controls не изменены.
- GitHub Actions Android Verify run `37111268646`: contract tests PASS, debug APK build PASS.
- Следующий software check: owner-phone visual smoke Music / Ambient / Night / Alarm.

### 2026-10-03 — Music labels and frameless global header v0.19

- **OWNER REVIEW v0.18:** остальные экраны/контекстные фото выглядят хорошо.
- Найдены два UI defect:
  1. двухстрочные Music mode labels (`VU / Градиент`, `VU / Радуга`, `5 / полос`, `3 / полосы`) подрезались снизу;
  2. верхний общий status/header на Music/Ambient/Night/Alarm был снова заключён в отдельную рамочную карточку.
- Android version: `0.19-music-header-polish-rc1`.
- Music mode buttons: 100×76dp, explicit two-line layout, font padding disabled, centered text, controlled inner padding.
- `globalHeaderPanel`: outer `ardu_header` background/stroke removed; status content sits directly on the page background.
- Light Home Hub remains unchanged with status/controls inside its hero.
- Firmware/API/UART unchanged.
- GitHub Actions Android Verify run `37112061533`: contract tests PASS, debug APK build PASS.
- Next owner check: Music mode labels are fully visible + no outer rectangle around top status on normal tabs.

### 2026-10-04 — Music v0.20 owner plan approved

- Owner selected Music interaction variant A: no large Play/Stop.
- Tap on a Music mode card starts that mode immediately.
- Leaving Music through another bottom user tab must stop active Music with top-level OFF.
- Dedicated Music photorealistic hero asset will be created; fake media player is explicitly excluded.
- Music labels: Градиент / Радуга / 5 полос / 3 полосы / Частота / Бегущие / Спектр.
- Music chooser target = equal-height grid, no horizontal scroll dependency.
- SmartSliderView min/max clipping will be fixed once in the reusable component and regressed across all tabs.
- Bottom navigation target = icon-only native vector icons.
- Implementation plan: `05_WiFi_и_приложение/MUSIC_V0_20_PLAN.md`.
- Firmware source changes are now owner-authorized while replacement Nano is pending, but none are required for the Music v0.20 behavior identified so far.

### 2026-10-04 — Music Home Hub v0.20 implemented

- Android version: `0.20-music-homehub-rc1`.
- Added dedicated generated/optimized `drawable-nodpi/ardu_music_hero.webp`.
- Music top composition now follows Light Home Hub: ARDU/status/refresh/settings/title/context/state live inside the hero.
- Fake media player is not implemented.
- Removed large Music Play/Stop controls.
- Mode card tap directly calls existing `/api/music/mode`; Nano opcode 80 already activates top-level MUSIC.
- User labels: `Градиент`, `Радуга`, `5 полос`, `3 полосы`, `Частота`, `Бегущие`, `Спектр`.
- Music choices are two equal-height rows (4 + 3), no horizontal scrolling.
- Leaving active Music via another bottom user tab sends existing `mode=off`; target tab is opened but not auto-started.
- Settings navigation does not stop Music.
- `SmartSliderView` edge clipping fixed at reusable component level and therefore applies to all normal smart sliders.
- Bottom navigation switched to five icon-only native vector buttons with selected-state tint and accessibility descriptions.
- Static validation: missing IDs = 0; duplicate layout IDs = 0; duplicate private functions = 0.
- Added HTTP contract coverage for Music mode selection + top-level OFF.
- GitHub Actions Android Verify run `37194558467`: unit contract tests PASS, debug APK build PASS.
- Nano/ESP source unchanged in this implementation.

### 2026-10-04 — Music visual hotfix v0.20.1

- Owner screenshot confirmed three v0.20 visual defects: zoomed Music hero, text-only mode cards, bottom navigation blending into page content.
- Android version: `0.20.1-music-visual-hotfix-rc1`.
- Music hero now uses two layers: soft center-crop backdrop + uncropped `fitCenter` foreground, keeping the full dedicated asset visible.
- Added dependency-free custom `MusicModeTileView` with seven mode-specific colorful illustrations.
- Mode cards now have 104dp height for icon + label composition; selected tile retains mint glow/border.
- Bottom nav converted from compound-drawable Buttons to centered `ImageButton` controls.
- Added `ardu_bottom_dock.xml`: rounded separate surface, border, spacing and elevation.
- Static validation: missing IDs = 0; duplicate IDs = 0; duplicate private functions = 0.
- Actions run `37196929089`: tests PASS + debug APK build PASS.
- Firmware/API/UART unchanged.

### 2026-10-04 — Music framing/icon hotfix v0.20.2

- **OWNER FEEDBACK v0.20.1:** верхняя Music-картинка всё ещё выглядела увеличенной; «Частота» и «Градиент» визуально были слишком похожи.
- Android version: `0.20.2-music-framing-icon-hotfix-rc1`.
- Music hero:
  - удалён оставшийся `centerCrop` backdrop того же фото;
  - hero height уменьшен с 330dp до 250dp, чтобы геометрия лучше соответствовала landscape asset;
  - единственный photo layer использует `fitCenter`, поэтому кадр не обрезается и не увеличивается второй копией изображения.
- `MusicModeTileView`:
  - M01 «Градиент» остаётся цветной плавной волной;
  - M05 «Частота» заменена на отдельную radio-frequency/beacon композицию с концентрическими дугами и центральным маркером.
- Music behavior/API/UART/firmware unchanged.
- GitHub Actions Android Verify run `37204187940`: `testDebugUnitTest` PASS + `assembleDebug` PASS.
- Следующий software gate: owner-phone visual smoke v0.20.2.

### 2026-10-04 — approved wide Music room hero v0.20.3

- **РЕШЕНИЕ ВЛАДЕЛЬЦА:** утверждён новый Music hero, визуально соответствующий раннему эскизу: диван слева, небольшая колонка справа, растение/городской фон, холодный синий свет слева и тёплый янтарный справа.
- Android version: `0.20.3-music-room-hero-rc1` (versionCode 20).
- `drawable-nodpi/ardu_music_hero.webp` заменён на новый оптимизированный 640×360 WebP.
- Hero layout оставлен безопасным для композиции: 250dp + один `fitCenter` layer, без `centerCrop`; поэтому правая сторона изображения и колонка не должны обрезаться.
- Остальная Music UI/behavior без изменений.
- GitHub Actions Android Verify run `37209345952`: `testDebugUnitTest` PASS + `assembleDebug` PASS.
- Следующий software gate: owner-phone visual smoke v0.20.3 через `git pull` → Run.

### 2026-10-04 — replacement Nano numeric UART transport confirmed

- **ФАКТ:** физический ESP всё ещё работает на `HTTP_BRIDGE_R7` и доступен по Wi-Fi/OTA на `192.168.0.4`.
- **ФАКТ:** старый R7 `GET /api/status` отправляет текстовую `STATUS`, новая Nano отвечает `E 1`, что соответствует parse error frozen numeric UART v1.
- **ФАКТ:** через raw bridge выполнен `POST /api/dev/nano` с телом `1`; ответ: `nano="O 1"`, `timed_out=false`.
- Вывод: физический UART ESP→replacement Nano исправен, новая Nano принимает numeric UART v1, opcode 1/PING подтверждён end-to-end через существующий ESP transport.
- Следующий hardware шаг: OTA загрузка `esp8266_ardu_v1.ino` на текущий ESP, затем первый HTTP gate `/api/ping → fw=ARDU_ESP_V1`.

### 2026-10-04 — owner local ESP v1 compile PASS

- **ФАКТ:** владелец локально скомпилировал `05_WiFi_и_приложение/esp8266_ardu_v1/esp8266_ardu_v1.ino` с рабочими локальными Wi-Fi/OTA credentials.
- RAM: `32020 / 80192` = 39%.
- IRAM: `60823 / 65536` = 92%.
- IROM/flash code: `324400 / 1048576` = 30%.
- Compile PASS; значения согласуются с release CI и не показывают нового memory blocker.
- Следующий шаг: OTA upload финального `ARDU_ESP_V1` на текущий ESP через network port `ardu / 192.168.0.4`.

### 2026-10-04 — physical ESP v1 OTA PASS

- **ФАКТ:** финальный `esp8266_ardu_v1.ino` успешно загружен по OTA на физический ESP8266.
- После reboot `GET /api/ping` вернул: `fw=ARDU_ESP_V1`, `uart_protocol=1`, `wifi_connected=true`, IP `192.168.0.4`, RSSI `-53`, `ota_ready=true`, hostname `ardu`, port `8266`.
- Вывод: финальный ESP v1 boot/Wi-Fi/OTA gate пройден на реальном железе.
- Следующий gate: read-only `/api/status` + `/api/settings` + `/api/time`, затем raw opcode 1 regression.

### 2026-10-04 — Ambient Home Hub v0.21

- Android version: `0.21-ambient-homehub-rc1` (versionCode 21).
- «Фон» переведён в тот же Home Hub visual language, что Light/Music:
  - 250dp contextual RoomHeroView;
  - ARDU / connection / refresh / settings inside hero;
  - current ambient effect shown in the glass summary;
  - old separate global header hidden on Ambient.
- F01/F02/F03 plain text choices replaced by dependency-free `AmbientEffectTileView`:
  - F01 «Цвет» — glowing color orb;
  - F02 «Смена» — flowing color paths;
  - F03 «Радуга» — rainbow arcs;
  - selected effect retains mint border/glow.
- ON/OFF remain the existing semantic actions; API/UART/firmware behavior is unchanged.
- Static validation: all new Ambient XML IDs map 1:1 to Kotlin bindings; duplicate/new missing Ambient IDs = 0.
- Android Verify status for this exact v0.21 head is not yet visible through the current GitHub connector.
- Software next gate: owner-phone visual smoke v0.21.
- Physical next gate remains final ESP v1 OTA → firmware acceptance → Android end-to-end acceptance.

### 2026-10-04 — physical ESP/Nano read-only gate

- **ФАКТ:** `GET /api/status` на физическом `ARDU_ESP_V1` успешно читает replacement Nano: `nano_fw=ARDU_V1`, `uart_protocol=1`, `mode=light`, `current_limit_ma=3000`, `music_mode=M01`, `ambient_effect=F01`, без timeout.
- **ФАКТ:** RTC gate пока не пройден: `rtc_valid=false`; `GET /api/time` → `valid=false`, Nano `D 4 0`.
- **ФАКТ:** `GET /api/settings` успешно вернул полный schema 1 snapshot Light/Clap/Night/Alarm/Ambient/Music/System. Текущий Light: Kelvin 4000 K, brightness 64; clap enabled threshold 70 timeout 500 ms; current limit 3000 mA; audio calibration state present (`mic_dc=250`, `vu_low_pass=300`, `spectrum_low_pass=40`).
- Вывод: HTTP↔ESP↔Nano settings/status transport PASS; единственный blocker текущего read-only acceptance — невалидное время DS3231.
- Следующий шаг: `POST /api/time/sync` с текущим временем ПК, затем повторный `GET /api/time` и `GET /api/status`.

### 2026-10-04 — Night + Alarm Home Hub v0.22

- **OWNER DIRECTION:** remaining normal user pages must follow the same Home Hub format already used on the approved Light/Music/Ambient design.
- Android version: `0.22-night-alarm-homehub-rc1` (versionCode 22).
- Night:
  - 250dp contextual night hero;
  - ARDU / connection / refresh / settings inside hero;
  - glass summary shows enabled state, brightness and manual/schedule window;
  - color/saturation/brightness and schedule semantics unchanged;
  - schedule time inputs are now a balanced two-column composition.
- Alarm/Dawn:
  - 250dp dawn hero;
  - ARDU / connection / refresh / settings inside hero;
  - glass summary shows alarm state/time and RTC status;
  - wake time editor enlarged and simplified;
  - existing fade / max brightness / start hue / end hue / RTC sync / stop dawn controls retained.
- Shared global status header is now hidden on all five normal user tabs and remains available for Settings/service.
- Firmware/API/UART behavior unchanged.
- Static validation after write:
  - total layout IDs = 177;
  - duplicate layout IDs = 0;
  - Night/Alarm IDs = 41, missing bindings = 0;
  - duplicate private functions = 0;
  - Night/Alarm refresh disable/restore wiring is symmetric.
- Exact v0.22 Android Actions result is not yet visible through the current connector.

### 2026-10-04 — RTC time sync PASS on replacement Nano

- **ФАКТ:** на replacement Nano повторный `POST /api/time/sync` через физический `ARDU_ESP_V1` успешно применён.
- PowerShell `Invoke-RestMethod` вернул `ok=True, applied=True`.
- Вывод: opcode 5 ESP→Nano и запись Nano→DS3231 по I²C проходят на новой плате; предыдущий `E 3` относился к прежней физической сборке/подключению, а не к HTTP/API contract.
- Следующий gate: `GET /api/time` должен вернуть `valid=true`, затем `GET /api/status` должен вернуть `rtc_valid=true`.

### 2026-10-04 — physical RTC readback gate PASS

- **ФАКТ:** после успешного `POST /api/time/sync` физический `GET /api/time` вернул `valid=true`, дату `2026-10-04`, время `20:09:23`, Nano `D 4 1 2026 10 4 20 9 23`.
- **ФАКТ:** повторный `GET /api/status` вернул `rtc_valid=true`, `mode=off`, `nano_fw=ARDU_V1`, `uart_protocol=1`; RTC time продолжает идти (`20:09:28`).
- RTC sync/readback gate на replacement Nano полностью пройден.
- Следующий acceptance слой: реальный L01 через финальный HTTP API при текущем безопасном brightness=64.

### 2026-10-04 — physical L01 ON PASS

- **ФАКТ:** на реальном стенде через финальный `ARDU_ESP_V1` выполнен `POST /api/light/settings {"enabled":true}` → `ok=true, applied=true`.
- **ФАКТ:** `GET /api/light/status` после команды: `enabled=true`, `color_mode=kelvin`, `kelvin=4000`, `brightness=64`, `clap_enabled=true`.
- **ФАКТ владельца:** физическое кольцо загорелось.
- Следующий минимальный gate: L01 OFF → физическое гашение → readback `enabled=false`; затем повторный ON для проверки воспроизводимости.

### 2026-10-04 — physical Wi-Fi/API baseline + L01 OFF/ON regression PASS

Owner repeated the full final Wi-Fi baseline on the real assembled stack.

Read-only:
- `GET /api/ping` → `fw=ARDU_ESP_V1`, UART v1, Wi-Fi connected, IP `192.168.0.4`, OTA ready;
- `GET /api/status` → `nano_fw=ARDU_V1`, `rtc_valid=true`, current limit 3000 mA, no timeout;
- `GET /api/time` → `valid=true`, RTC advancing normally;
- `GET /api/settings` → schema 1 full snapshot for Light/Clap/Night/Alarm/Ambient/Music/System.

L01 regression:
- semantic OFF applied → `GET /api/light/status enabled=false`;
- semantic ON applied → `GET /api/light/status enabled=true`;
- repeat OFF → `enabled=false`;
- repeat ON → `enabled=true`;
- final `GET /api/status` → top-level `mode=light`, `mode_id=1`.

Final observed L01 state: Kelvin 4000 K, brightness 64, clap enabled, current limit 3000 mA.

**ФАКТ:** final Wi-Fi → ESP → numeric UART → Nano control/readback path is reproducible for baseline Light control.

Next integration gate: Android v0.22 on the physical phone against `192.168.0.4`.

### 2026-10-04 — real Android connection PASS + v0.23 concept parity source ready

- **ФАКТ владельца + video/screenshots:** physical Android app connected to the real ARDU over home Wi‑Fi; Online state and real user pages were shown from the assembled device.
- Previous Android v0.22 implementation was archived before visual changes:
  - branch `archive/android-v0.22-homehub-2026-10-04`;
  - commit `a9daf3839786414b264f32dfe0a680b68f8a7be3`;
  - manifest `05_WiFi_и_приложение/ANDROID_V0_22_ARCHIVE.md`.
- New Android source: `0.23-concept-parity-rc1`.
- v0.23 changes are presentation/app-composition only:
  - Light: compact hero, concept-like app scenes, real overview brightness/Kelvin sliders, smaller Focus Dial;
  - Music: real M01…M09 contract retained, chooser compacted, no fake player;
  - Ambient: distinct RGB media-wall visual context, compact F01/F02/F03, primary hue/brightness, advanced parameters collapsed;
  - Night: distinct bedroom/night context, primary moon brightness +/- card, saturation collapsed, compact schedule;
  - Alarm/Dawn: distinct dawn-bedroom context, primary wake-time card, compact dawn controls, end hue primary, start hue collapsed;
  - success operation text no longer stays as “готово”.
- Unsupported concept-only functions were not added: no fake audio volume, no fake sleep presets, no fake media playback.
- Static validation:
  - 187 layout IDs;
  - duplicate IDs 0;
  - missing Kotlin ID bindings 0;
  - duplicate private functions 0;
  - Kotlin braces/parentheses balanced;
  - XML LinearLayout/FrameLayout/ScrollView container balance clean.
- CI result for exact v0.23 head is not yet observable through the current connector.

### 2026-10-07 — owner rejected v0.23; v0.22 Home Hub restored

- **РЕШЕНИЕ ВЛАДЕЛЬЦА:** v0.23 concept-parity redesign «не пойдёт».
- Owner manually returned to `archive/android-v0.22-homehub-2026-10-04`.
- Canonical `main` was then restored to the v0.22 visual implementation instead of requiring development to continue on the archive branch.
- Current Android version: `0.22.1-homehub-restored-rc1`, versionCode 24.
- Exact restored visual files:
  - `activity_main.xml`;
  - `RoomHeroView.kt`;
  - `SceneTileView.kt`;
  - `MusicModeTileView.kt`;
  - `AmbientEffectTileView.kt`.
- Those files match the archived v0.22 branch exactly.
- `MainActivity.kt` uses the v0.22 UI behavior plus only later valid network additions:
  - `network_mode` awareness;
  - “Прямое подключение” label;
  - ARDU-DIRECT service summary;
  - do not persist 192.168.4.1 as the normal home address.
- `ArduApiClient` / ESP `ARDU-DIRECT` work remains in scope.
- v0.23 is historical/rejected, not a candidate for further polish.
- Static restore validation: 177 IDs, duplicate IDs 0, missing bindings 0, duplicate private functions 0.

### 2026-10-07 — repository cleanup: ESP credentials no longer modify tracked sketch

- Final ESP v1 source no longer requires editing tracked `esp8266_ardu_v1.ino` for Wi-Fi/OTA credentials.
- Added ignored local file:
  `05_WiFi_и_приложение/esp8266_ardu_v1/wifi_secrets.h`.
- Added tracked template:
  `wifi_secrets.example.h`.
- The tracked sketch compiles source-only with non-secret placeholders when no local header exists; real hardware values remain local.
- This removes the recurring `git pull` conflict caused by local credentials in the tracked sketch.
- Android remains `0.22.1-homehub-restored-rc1`; ARDU-DIRECT support remains.
- Current repository cleanup gate is closed. Next practical gate returns to real Android functional acceptance.

### 2026-10-07 — owner polish v0.22.2 source ready

**Owner-requested targeted changes implemented on top of D-101 v0.22 baseline:**

1. Direct Wi-Fi:
   - existing Station→`ARDU-DIRECT` source retained;
   - Settings now explains direct mode and opens Android Wi-Fi settings;
   - Android already probes `192.168.4.1`.
2. Bottom dock:
   - each icon now has a short label.
3. Settings:
   - explicit Back button;
   - “Сбросить настройки по умолчанию” with confirmation.
4. Light:
   - overview gets ON/OFF;
   - quick scenes = Вечер / Кино / Гости / Чтение with strongly different brightness/Kelvin profiles.
5. Active state:
   - Light ON/OFF, overview ON/OFF and Ambient ON/OFF use selected-state visuals after real reread;
   - Music mode tile is highlighted only while Music is actually active.
6. Navigation behavior:
   - Light/Music/Ambient/Night tab immediately activates corresponding runtime mode;
   - Alarm tab stops the current runtime mode (`off`) and opens alarm configuration.
7. Ambient:
   - dedicated TV/RGB hero;
   - existing F01/F02/F03 retained;
   - new Android presets: Северное сияние / Закат / Океан / Космос;
   - presets are macros over existing effects, not new firmware IDs;
   - F02/F03 speed semantics changed to monotonic frame interval: higher = faster; raw hue-step wrap alias removed.
8. Night/Alarm:
   - dedicated bedroom-night and dawn-bedroom hero assets from approved concept references.

Android version: `0.22.2-homehub-owner-polish-rc1`, versionCode 25.

Reset extension:
- HTTP: `POST /api/system/reset-defaults`;
- UART: opcode 130;
- resets user settings/current limit, preserves RTC and hardware audio calibration.

**Important physical state:** Nano/ESP source changes from this iteration have NOT been uploaded yet. Physical hardware still runs the previously accepted v1 firmware until a later explicit upload gate.

### 2026-10-07 — hero scale polish v0.22.3

Owner feedback: dedicated Ambient/Night/Alarm background scenes looked too large/zoomed.

Android-only correction:
- hero container size and internal text layout unchanged;
- Ambient/Night/Dawn dedicated images now render as a smaller fit-centered foreground scene;
- a subdued full-bleed copy remains behind it so the card does not become letterboxed/empty;
- Light and Music hero rendering are unchanged.

Version: `0.22.3-hero-scale-polish-rc1` / versionCode 26.
Static validation: 195 unique IDs, missing bindings 0, RoomHeroView structure clean.

### 2026-10-07 — generated hero scenes approved and applied (v0.22.4)

**РЕШЕНИЕ владельца:** новые сгенерированные сцены для Фон / Ночь / Будильник приняты («Да огонь. Применяй»).

Applied Android assets:
- `ardu_ambient_hero.webp` — wide night living room / TV / cyan-magenta ambient glow;
- `ardu_night_hero.webp` — wide moonlit bedroom with warm bedside light;
- `ardu_alarm_hero.webp` — wide sunrise bedroom.

Rendering:
- removed v0.22.3 small-inset workaround;
- main 16:9 scene is displayed complete across available hero width;
- subdued full-bleed copy only fills the taller card behind it;
- Light and Music rendering unchanged.

Android version: `0.22.4-generated-heroes-rc1`, versionCode 27.
Static validation: 195 unique layout IDs, duplicate IDs 0, missing Kotlin bindings 0, RoomHeroView structure clean.

**Ambient presets:** current four-item block is provisional. Owner explicitly requires more presets and separate agreement on how each preset physically lights/moves before the preset layer is finalized.

### 2026-10-08 — Ambient hero asset repair v0.22.5

Owner screenshot showed corrupted gray noise instead of the approved cinema-room photo in the Ambient hero. Night/Alarm heroes were visually accepted.

Implemented narrow Android-only fix:
- replaced only `app/src/main/res/drawable-nodpi/ardu_ambient_hero.webp`;
- generated fresh 640×360 lossy WebP from the approved `cinematic_nighttime_smart_home_living_room.png`;
- Pillow decode verification PASS; Git blob SHA `667b6bac57b4c32ff29cea9e6f18513bcae4db6a` matches the verified local output;
- `RoomHeroView.kt`, XML, Night/Alarm images and all presets unchanged;
- Android version = `0.22.5-ambient-hero-hotfix-rc1`, versionCode 28.

Source asset integrity PASS; actual Android emulator appearance still pending owner smoke.
Next: `git pull` → Emulator Run → check only Ambient hero.

### 2026-10-08 — D-104: F02/F03 not required; 12-scene proposal archived as idea

Owner explicitly stated that F02 and F03 are unnecessary and asked to save the rest of the 12-preset proposal as an idea.

**DECISION:**
- future Ambient user-facing model: **F01 retained, F02/F03 excluded**;
- do not reuse F02/F03 IDs casually;
- no firmware/ESP/Android deletion now; currently deployed and source versions still carry F02/F03.

**IDEA ONLY:**
- 12 candidate scenes (working P01…P12), four compact renderer families;
- per-scene brightness/dynamics, persistent choice, local animation;
- detailed colors/movement/memory/implementation gates in `04_Прошивка/AMBIENT_PRESETS_CONCEPT.md`.

The 12 IDs, API route, UART commands and EEPROM format are **NOT approved or frozen**. No changes to Android app version (`0.22.5-ambient-hero-hotfix-rc1`), firmware, protocols or hardware in this documentation-only step.

### 2026-10-08 — герои утверждены; план реализации Ambient-пресетов сохранён

- **ФАКТ со слов владельца:** «все фоновые картинки меня устраивают»; дополнительная визуальная проверка исправленной картинки «Фон» больше не является блокером.
- **ДОКУМЕНТ:** `04_Прошивка/AMBIENT_PRESETS_IMPLEMENTATION_PLAN.md` — этапы G0…G5: baseline/memory + EEPROM, P01/P04/P05, семейства оставшихся сцен, контракт/миграция, ESP/Android, физическая приёмка.
- **РЕШЕНИЕ:** F01 остаётся, F02/F03 не нужны в будущем UI (D-104). Старые wire IDs не переписываются. P01…P12, включая P12 «Радуга», пока только условные кандидаты.
- **ФАКТ:** в этом коммите меняется только документация; Android version, прошивки, HTTP/UART контракт, EEPROM и железо остаются без изменений.
- **Следующее действие:** по отдельной команде на реализацию выполнить G0/G1; без новых одиночных test-sketch uploads. Сохранить отдельный gate v1/ARDU-DIRECT/two-ring acceptance.

### 2026-10-08 — первый источник P01/P04/P05, host + AVR compile PASS

- **РЕШЕНИЕ владельца:** начать реализацию фоновых пресетов; первый малый срез — три существенно разных анимации вместо прежних макросов. Пакет не замораживает каталог, EEPROM/API или внешние P ID.
- **РЕАЛИЗОВАНО В SOURCE:** `04_Прошивка/nano_ardu_v1/ambient_preset_probe.h`, compile-only флаг `ARDU_AMBIENT_PRESET_PROBE=1`, host tests и отдельная экспериментальная сборка в `.github/workflows/arduino-verify.yml`. Без этого флага release behavior F01/F02/F03 не меняется.
- **CI PASS:** [run 37807204353](https://github.com/dronrome1245/ARDU/actions/runs/37807204353); штатная Nano 28690 / 1234 B (Flash/globals), lab 29312 / 1234 B. Добавка +622 Flash / +0 SRAM. Target 95% = 29184 B пока превышен на 128 B; максимальный Flash 30720 B не превышен.
- **ПРОВЕРЕНО:** host C++ 44-LED bounds, детерминированные разные сцены/анимация/диапазоны. **НЕ ПРОВЕРЕНО:** реальная лента/ток/скорости/стек в работе.
- **ПОСТОЯННЫЙ ПОТОК:** Android/ESP/API/UART/EEPROM без изменений, F02/F03 не удалялись. Не прошивать lab build. Следующий gate — сокращение Flash/stack-review и согласованный полный Nano release candidate для визуальной проверки владельцем, а не изолированный test sketch.
- **Отчёт:** `04_Прошивка/AMBIENT_PRESETS_LAB_R1.md`.

### 2026-10-08 — full Nano Ambient PREVIEW RC1 ready, physical gate next

- **CI** [37809369365](https://github.com/dronrome1245/ARDU/actions/runs/37809369365) PASS: default Nano 28690/1234 Flash/SRAM globals, full preview 29376/1234, IDE-openable sketch + header sync + host 44-LED tests + [HEX 11564965835](https://github.com/dronrome1245/ARDU/actions/runs/37809369365/artifacts/11564965835).
- В preview F01 запускает цикл P01/P04/P05/legacy F01 по ~8,2 с, F02/F03 сохраняются. В обычной сборке все legacy режимы неизменны.
- **Риск:** 95%-ориентир Flash = 29184 B; preview превышает на 192 B. Hard 30720 — PASS, свободно 1344 B; globals 1234, free for stack 814 B; runtime/actual LED test pending.
- **Первый wrapper FAIL** [37809142084](https://github.com/dronrome1245/ARDU/actions/runs/37809142084): относительный include другого .ino после Arduino preprocessing. Исправлено двумя самодостаточными файлами и синхронизацией через CI.
- **Физически в этом шаге ничего не прошивали.** Готовы [инструкция Nano Upload, просмотр, rollback](04_Прошивка/AMBIENT_PRESETS_PREVIEW_RC1_TEST.md). ESP/Android/API/UART/EEPROM не изменены; staged reset/speed Nano изменения входят в preview и нуждаются в smoke.

### 2026-10-08 — RC2 устраняет зависимость от внешнего файла на Windows

- **ФАКТ от владельца:** при Verify `nano_ambient_preview_rc1.ino` получено `fatal error: ambient_preset_probe.h: No such file or directory`, хотя заголовок, по сообщению владельца, был в той же папке. Причина поведения Windows/IDE не доказана.
- **ИСПРАВЛЕНО:** новая версия `04_Прошивка/nano_ambient_preview_rc2/nano_ambient_preview_rc2.ino` содержит код трёх эффектов внутри единственного `.ino`. Старую RC1 оставить для истории, не просить пользователя заново располагать файлы.
- **CI PASS:** [Arduino Verify 37814719230](https://github.com/dronrome1245/ARDU/actions/runs/37814719230) подтвердил байтовое соответствие полной Nano v1 + inlined header, host tests и **сборку в изолированной папке с одним .ino**: 29376/30720 Flash, 1234/2048 globals. [HEX artifact 11567275089](https://github.com/dronrome1245/ARDU/actions/runs/37814719230/artifacts/11567275089).
- **Следующий практический шаг:** только `RC2` и [инструкция](04_Прошивка/AMBIENT_PRESETS_PREVIEW_RC2_TEST.md), сначала Windows Verify. Hardware Upload/LED view не заявлены; ESP/Android/API/UART/EEPROM source и стандартная Nano v1 не изменены.

### 2026-10-08 — D-109: full Ambient12 + ARDU-DIRECT source/CI PASS, физический smoke следующий

**РЕШЕНИЕ ВЛАДЕЛЬЦА:** ARDU-DIRECT не был физически загружен, теперь требуется сразу реализовать его вместе с 12 новыми пресетами, убрать F02/F03 из пользовательских режимов и один раз OTA обновить ESP после подготовки полной функциональной версии. Включить P12 Радуга.

**ФАКТ ПО SOURCE/CI:**
- Nano `nano_ambient12_v1/nano_ambient12_v1.ino` — 12 атмосферных сцен без дополнительных буферов, F01 manual, новые numeric 111..115; 29 B EEPROM при 512..540 с checksum/version, старый Light/Music/RTC сохранён. [CI](https://github.com/dronrome1245/ARDU/actions/runs/37818601346) PASS: 29560/30720 Flash, 1282/2048 SRAM globals.
- ESP `esp8266_ardu_v2/esp8266_ardu_v2.ino` — защищённый `ARDU-DIRECT`, OTA Station only, HTTP `/api/ambient/preset` и `/api/ambient/presets`, per-scene settings, readback и no-Nano-v2 fallback. Настоящая сборка требует игнорируемого локального файла четырёх паролей, CI тестирует защиту от placeholders. [ESP CI](https://github.com/dronrome1245/ARDU/actions/runs/37820404281) PASS; RAM 32176/80192, IRAM 60823/65536.
- Android v0.22.6 versionCode29 — 12 сцен, индивидуальные параметры и Nano readback, F02/F03 скрыты, утверждённые Home Hub/герои сохранены. [JVM+APK CI](https://github.com/dronrome1245/ARDU/actions/runs/37819918951) PASS, [APK artifact](https://github.com/dronrome1245/ARDU/actions/runs/37819918951/artifacts/11568856875).

**ФАКТ О ЖЕЛЕЗЕ:** владелец подтвердил, что ARDU-DIRECT на ESP ещё НЕ прошивал; физическая новая OTA и Nano USB, Wi-Fi fallback, питание/две ленты и качество всех 12 сцен пока НЕ ПРОВЕРЕНЫ. Nano > 95%-target на 376 байт, измерение worst-case stack открыто. До release freeze выполнить `ARDU_AMBIENT12_RELEASE_CANDIDATE.md`, ESP→Nano→Android→routerless в таком порядке. D-104 backlog superseded D-109; старые F02/F03 numeric IDs reserved.

### 2026-10-08 — окончательный актуальный Nano v2 memory gate после исключения F02/F03

- [Arduino Verify 37820974644](https://github.com/dronrome1245/ARDU/actions/runs/37820974644) **PASS:** полная Nano Ambient12 29306/30720 Flash, 1282/2048 globals SRAM; [HEX artifact](https://github.com/dronrome1245/ARDU/actions/runs/37820974644/artifacts/11568284647). По сравнению с ранее успешной 29560-байтной сборкой сэкономлено 254 B Flash, globals не выросли.
- Запас до абсолютного предела 30720 = 1414 B; до мягкой цели 29184 ещё превышение **122 B**; RAM globals оставляют 766 B для stack/locals, максимум runtime stack не измерен.
- Старые UART 103/104/108/109 для deprecated F02/F03/auto теперь возвращают ошибку применимости, их numeric ID не переиспользуются; 105/106/107 оставлены для ручного F01. Прочие v1 группы сохранены.
- Все обязательные hardware acceptance gates (ESP v2 OTA, Nano USB, direct-mode Wi-Fi, 12 физических сцен, 2×44/ток/температура и power-cycle EEPROM) **ожидают исполнения владельцем**.

### 2026-10-08 — owner-requested ESP v2 R2 manual credentials

- Владелец отказался от `wifi_secrets.h` и будет вводить SSID/пароль непосредственно в скетч ESP.
- ESP v2 R2 — **один `esp8266_ardu_v2.ino`**, четыре явных `#define` в начале: домашняя Wi-Fi сеть/пароль, новый OTA пароль, WPA2 пароль `ARDU-DIRECT`. Дополнительные .h/флаги не нужны; v2 headers-примеры удалены, ESP v1 сохранён.
- **[CI 37823238584](https://github.com/dronrome1245/ARDU/actions/runs/37823238584) PASS:** compile отдельного одного .ino с фиктивными тестовыми данными и отрицательный тест, где незаменённые шаблонные пароли отклоняются компилятором. Реальная физическая OTA / ARDU-DIRECT пока не загружены/не проверены.
- Настоящие credentials хранить только в личной копии вне Git, не публиковать. Порядок OTA и rollback исправлен в `ARDU_AMBIENT12_RELEASE_CANDIDATE.md`.

### 2026-10-08 — первая физическая попытка OTA ESP v2 R2: результат НЕИЗВЕСТЕН

- **ФАКТ из вывода Arduino IDE владельца:** ESP v2 R2 прошла сборку (RAM 32208/80192, IRAM 60823/65536, IROM 329120/1048576); на этапе OTA получено `Authenticating...OK`, затем `Uploading...` с точками. **Финальная строка `Done uploading` / `Failed uploading` в предоставленном фрагменте отсутствует.**
- Отдельное сообщение IDE: `No monitor available for the port protocol network. Could not connect to 192.168.0.4 network port.` Это попытка открыть **Serial Monitor через сетевой OTA-порт**, а не доказательство неуспешной передачи бинарника. Закрыть вкладку Serial Monitor, дождаться завершения текущего Upload.
- **Gate ещё не закрыт:** до повторной OTA, перезагрузок или Nano USB нужен реальный `curl.exe http://192.168.0.4/api/ping` (после завершения Upload): `fw=ARDU_ESP_V2_AMBIENT12` подтверждает запуск нового ESP; прежняя версия/таймаут требуют отдельной диагностики. Текущий физический ESP firmware **не определён** данным фрагментом.

### 2026-10-08 — ESP8266 v2 R2 подтверждена физически после OTA (Station + HTTP ping PASS)

- **ФАКТ измерения владельца, реальный HTTP GET `http://192.168.0.4/api/ping`:** `ok:true`; `device:"ARDU-ESP8266"`, `fw:"ARDU_ESP_V2_AMBIENT12"`, `uart_protocol:1`, `wifi_connected:true`, `network_mode:"station"`, `softap_active:false`, `ip:"192.168.0.4"`, `rssi:-57`, `ota_ready:true`, `ota_hostname:"ardu"`, `ota_port:8266`. Это подтверждает новую прошивку на физическом ESP, успешный запуск HTTP и подключение к домашнему Wi-Fi. Попытка OTA ранее дошла до `Authenticating...OK`/`Uploading...`; итоговый HTTP подтверждает запуск v2.
- **НЕ ПРОВЕРЕНО:** работа ESP↔Nano по UART после перезагрузки ESP, все HTTP endpoints, повторное обновление OTA, защищённый `ARDU-DIRECT` в отсутствии роутера. `softap_active:false` при `station` штатно.
- **Следующий минимальный gate (перед любым Upload Nano):** владелец выполняет `curl.exe http://192.168.0.4/api/status` и `curl.exe http://192.168.0.4/api/ambient/presets`. Для всё ещё старой Nano ожидается нормальный ответ status, а для presets `supported:false` / `NANO_UPDATE_REQUIRED`. Только после проверки мостового UART переходить к полной Nano v2 по `ARDU_AMBIENT12_RELEASE_CANDIDATE.md`.

### 2026-10-08 — D-111: 12 фото-миниатюр P01..P12 в Android, CI PASS

- **РЕШЕНИЕ владельца:** утвердил три 2×2 коллажа с тематическими изображениями без привязки к интерьерам, потребовал встроить все 12 в приложение и выполнять обычное `git pull` → Run.
- **СДЕЛАНО:** из исходных утверждённых коллажей изготовлены 12 независимых WebP 192×192, `ardu_preset_p01.webp`..`ardu_preset_p12.webp` в `05_WiFi_и_приложение/android_app_r1/app/src/main/res/drawable-nodpi`. Привязка P01–P12 однозначная. Первые четыре XML ImageButton получают новые фото; остальные восемь вместо старых текстовых кнопок стали ImageButton с такими же изображениями и подписями, сетка 4 колонки × 3 ряда. Существующий Home Hub/hero других страниц и управление режимами сохранены.
- **CI PASS:** [Android Verify 37838263956](https://github.com/dronrome1245/ARDU/actions/runs/37838263956), проверено наличие 12 реальных WebP и Kotlin-мэппинга, unit contract tests, assembleDebug и [APK artifact 11576287564](https://github.com/dronrome1245/ARDU/actions/runs/37838263956/artifacts/11576287564). Android `versionCode 30` / `versionName 0.22.7-ambient12-photo-tiles-rc1`. Визуальное отображение на телефоне ждёт пользователя.
- **УСТРОЙСТВО:** прежний пользовательский `GET /api/ambient/presets` `supported:true` по 12 сценам, `POST P01` `applied:true/persisted:true`, тест старого Android прошёл; но это не полная приёмка всех 12 анимаций. Для графики прошивки Nano/ESP не менялись. Детали `05_WiFi_и_приложение/AMBIENT12_ARTWORK.md`.
