dronrome1245/ARDU/SOURCES.md

# Источники проекта ARDU

Здесь фиксируются внешние источники, пользовательские материалы и фактические измерения. Источник не превращает предположение в факт автоматически: для конкретной детали приоритет имеет маркировка фактического экземпляра и измерение.

## S-001 — AlexGyver ColorMusic

- Сайт проекта: `https://alexgyver.ru/colormusic/`
- Репозиторий исходников: `https://github.com/AlexGyver/ColorMusic`
- Назначение: режимы светомузыки, FastLED/FHT-архитектура, калибровка, сохранение настроек.
- Лицензия исходного проекта: MIT.

## S-002 — видео-референс 1

`https://www.youtube.com/watch?v=UCz8JVM37BM`

Назначение: визуальная/концептуальная идея светомузыки.

## S-003 — видео-референс 2

`https://www.youtube.com/watch?v=nu31By9Phdc`

Назначение: визуальная/концептуальная идея светомузыки.

## S-004 — старые пользовательские материалы

В текущий чат были загружены материалы по распиновке Arduino/HC-05/MAX9814/DS3231/WS2812B, ColorMusic, будильнику-рассвету, протоколу команд приложения, калибровке микрофона, тесту хлопков и конденсаторам аудиотракта.

Эти материалы рассматриваются как история предыдущей разработки. При конфликтах распиновки они не являются автоматической истиной.

## S-005 — фото ESP8266MOD AI-THINKER

Пользовательское фото 2026-09-05: модуль `ESP8266MOD`, `AI-THINKER` установлен на белой переходной плате с выведенными контактами.

На верхней стороне переходной платы видны резисторы `103`, `0`, `103`; отдельный стабилизатор на нижней стороне не установлен.

## S-006 — первая расширенная фотоинвентаризация

Пользовательские фото 2026-09-05. Зафиксированы позиции из `02_Наши_детали/ИНВЕНТАРЬ.md`.

Особо читаемые маркировки: `HC-SR04`, `SRD-05VDC-SL-C`, `B10K`, `МЭЛТ MT-16S2H v.7`, `W5500`, `AMS1117-3.3 / YP-8`, `PCF8574A`, `ATmega328P`, `TIANBO HJR1-2C L-12V`.

## S-007 — документация MT-16S2H

Производитель МЭЛТ: MT-16S2H — символьный LCD 16×2, питание 5 В, параллельный интерфейс 4/8 бит, контроллер совместимого класса KS0066/HD44780.

Источник: документация производителя `melt.com.ru`.

## S-008 — YP-8 / AMS1117-3.3

Публичные описания идентифицируют YP-8 как модуль линейного стабилизатора 3,3 В на AMS1117. Для нашего экземпляра перед использованием обязательно измерить фактический VOUT и поведение под нагрузкой.

## S-009 — вторая фотоинвентаризация 2026-09-05

Пользовательские фотографии подтвердили DS3231/CR2032, MAX9814, MAX4466, HC-05, S-30-5 5 В 6 А, электролиты 1 мкФ и 100 мкФ, BC548, 1N4148, резисторы 1,5 кОм и 4,7 кОм.

## S-010 — White Adapter board for ESP8266

Источник: `https://homeding.github.io/boards/whiteadapter.htm`

Описание совпадает с нашей белой платой по трём элементам на верхней стороне:

- левый 10 кОм (`103`) подтягивает CH_PD к VCC;
- средний `0 Ω` является перемычкой внешнего VCC непосредственно к Module-VCC при **неустановленном стабилизаторе**;
- правый 10 кОм (`103`) подтягивает GPIO15 к GND;
- GPIO0 должен быть HIGH для запуска и LOW для serial upload;
- при добавлении регулятора средний `0 Ω` должен быть удалён.

Это основание считать VCC нашей платы 3,3-вольтовым.

## S-011 — Ai-Thinker ESP-01/07/12 Series Module Manual

Источник: `https://docs.ai-thinker.com/_media/esp8266/esp8266_series_modules_user_manual_en.pdf`

Для ESP-12-серии:

- питание модуля 3,0–3,6 В, типично 3,3 В;
- boot/run: EN high, GPIO15 low, GPIO0 high, GPIO2 high;
- download: EN high, GPIO15 low, GPIO0 low, GPIO2 high.

## S-012 — DS3231 ZS-042-подобная зарядная цепь

Источник: `https://www.onetransistor.eu/2019/07/zs042-ds3231-battery-charging-circuit.html`

Для распространённой синей платы DS3231/AT24C32 описана зарядная цепь из резистора 200 Ом и 1N4148. Для обычной CR2032 рекомендуют отключить заряд, удалив резистор или диод. На нашем фото видны резистор `201` и стеклянный диод, соответствующие этой цепи.

Дополнительное обсуждение и измерения: `https://forum.arduino.cc/t/zs-042-ds3231-rtc-module/268862/39`.

## S-013 — WS2812B / Worldsemi

Источник: `https://world-semi.com/ws2812-family/`

Текущая таблица Worldsemi для WS2812B указывает 12 мА × 3 канала для современных вариантов. Старые WS2812B часто рассчитываются консервативно как до 60 мА на LED при полном RGB. Так как ревизия нашей ленты неизвестна, силовую часть рассчитывать по более тяжёлому сценарию и ограничивать ток программно.

## S-014 — пользовательские уточнения 2026-09-06

Пользователь сообщил:

- два круглых корпуса не имеют рабочего белого света и используются только для ARDU;
- основной свет детской — отдельные точечные светильники на первой клавише;
- вторая клавиша полностью отключает ARDU;
- нужен один БП на два синхронных кольца;
- приложение пишется заново;
- предыдущий прототип приложения собирался в MIT App Inventor;
- в наличии 5 м WS2812B;
- 72,5 см фактической ленты содержат 44 LED;
- внутренний кантик одного корпуса имеет длину 71,5 см.

На дополнительных фото:

- `100 µF 10 V` читается непосредственно на электролите;
- дисковый конденсатор `103` соответствует 10 нФ.

## S-015 — MIT App Inventor: экспорт исходников

Официальная инструкция MIT App Inventor: `https://appinventor.mit.edu/explore/ai2/share`

Проект экспортируется как `.aia` через пункт `Projects/File → Export selected project (.aia) to my computer`. Этот файл содержит исходный проект, включая Designer/Blocks, и пригоден для импорта и анализа.

## S-016 — CR2032 является первичной литиевой батареей

Источник производителя Panasonic Energy: `https://energy.panasonic.com/na/business/products/lithium/coin-cr-standard/models/CR2032`

CR2032 относится к серии **Primary Lithium Batteries**. Поэтому штатную зарядную цепь DS3231-модуля нельзя оставлять включённой при установленной CR2032. Если нужен заряд, требуется отдельный совместимый перезаряжаемый элемент и корректный режим зарядки; для ARDU это не требуется.

## S-017 — Ardublock2.aia / LumpV3.1

Пользовательский исходный проект MIT App Inventor, загружен 2026-09-06.

Файл был распакован и проанализирован напрямую. Подтверждены:

- `Screen1.scm/.bky`;
- `Obichniy.scm/.bky`;
- `Nochnik.scm/.bky`;
- `FON.scm/.bky`;
- `Disco.scm/.bky`.

Из исходников извлечены реальные названия режимов, подрежимы, параметры UI и фактические старые Bluetooth-команды. Подробный разбор: `08_Исходники_и_референсы/Ardublock2_РАЗБОР.md`.

## S-018 — опубликованная таблица управления ColorMusic

Источник: `https://alexgyver.ru/colormusic/`.

На странице проекта опубликована таблица режимов 1–9 с назначением параметров ←→, ↑↓ и подрежимов #. Она использована для проверки соответствия старого `Disco.bky` исходному ColorMusic.

Зафиксированная адаптация: ColorMusic №7 (постоянный цвет / плавная смена / радуга) в ARDU переносится в отдельный раздел фоновых эффектов, потому что он не зависит от звука.

## S-019 — измерение YP-8 2026-09-13

Пользовательское измерение мультиметром на фактическом модуле YP-8/AMS1117-3.3.

Условия: вход YP-8 подключён к 5-вольтовой линии от S-30-5 через макетную плату; ESP8266 и другая нагрузка к VOUT не подключены.

Результат: `VOUT = 3,31 В`.

Вывод: выход без нагрузки соответствует требуемому уровню 3,3 В. Это не заменяет проверку просадки, нагрева и стабильности при активном Wi‑Fi ESP8266.

## S-020 — измерение S-30-5 2026-09-13

Пользовательское измерение мультиметром на фактическом БП S-30-5.

Условия: измерение низковольтной линии `V+ / V-`; существенной рабочей нагрузки нет, YP-8 подключён, но его VOUT не нагружен.

Результат: `5,01 В`.

Вывод: выход S-30-5 без существенной нагрузки соответствует номиналу 5 В. Требуется отдельная проверка под рабочей нагрузкой и контроль нагрева.

## S-021 — YP-8 с подключённым ESP8266 2026-09-13

Пользовательское измерение мультиметром на линии питания фактической белой платы ESP8266 от YP-8.

Условия: ESP8266 подключён к выходу YP-8; вход YP-8 питается от S-30-5.

Результат: `VCC ESP8266 = 3,28 В`; ранее без нагрузки на YP-8 было `3,31 В`.

Вывод: наблюдаемая статическая просадка составляет около `0,03 В`, поэтому базовое питание ESP по уровню напряжения проходит. Активный Wi‑Fi, пиковые просадки, отсутствие перезагрузок и нагрев YP-8 этим измерением не подтверждены.

## S-022 — loopback-тест Nano USB↔UART 2026-09-19

Пользовательский стендовый тест фактической Arduino Nano.

Условия: Nano подключена по USB; `RESET → GND`, `D0/RX ↔ D1/TX`; Serial Monitor `115200`, без участия ESP8266.

Результат: отправленный тестовый текст возвращается в Serial Monitor.

Вывод: USB-UART часть Nano и выбранный COM-порт работают в loopback. Возможность прошивки ESP8266 через этот мост остаётся отдельной проверкой после стабилизации питания ESP.

## S-023 — измерения питания YP-8/ESP8266 2026-09-19

Пользовательские измерения мультиметром при подключённом фактическом ESP8266.

Результаты: `VIN YP-8 = 4,7 В`; `VOUT YP-8 = 3,30 В`; `VCC ESP8266 = 3,10 В`.

Вывод: YP-8 удерживает 3,3 В на собственном выходе под текущей нагрузкой. Падение около `0,20 В` возникает между YP-8 и ESP8266, поэтому требуется проверить/сократить соединения и контакты. Пониженные `4,7 В` на входе YP-8 требуют отдельного измерения непосредственно на клеммах S-30-5 при той же нагрузке.

## S-024 — S-30-5 при подключённом ESP8266 2026-09-19

Пользовательское измерение мультиметром непосредственно на винтовых клеммах фактического S-30-5 при подключённом через YP-8 ESP8266.

Результат: `V+ / V- = 5,00 В`.

Вывод: при текущей небольшой нагрузке S-30-5 удерживает 5 В. Ранее измеренные `4,7 В` на VIN YP-8 и `3,10 В` на VCC ESP обусловлены падением в последующей низковольтной разводке/контактах, а не просадкой самого БП на его клеммах.

## S-025 — измерения питания относительно S-30-5 V- 2026-09-20

Пользовательские измерения мультиметром при подключённом ESP8266. Чёрный щуп оставался на `S-30-5 V-`, красным последовательно измерялись точки цепи.

Результаты: `S-30-5 V+ ≈ 5,0 В`; `YP-8 VIN+ ≈ 4,7 В`; `YP-8 VOUT+ ≈ 3,50 В`; `ESP VCC ≈ 3,25 В`.

Интерпретация: эти показания являются потенциалами относительно `S-30-5 V-`, поэтому `3,50 В` на `YP-8 VOUT+` нельзя трактовать как фактическое напряжение YP-8 между `VOUT/GND`, пока не измерен потенциал локального `YP-8 GND`. Следующая проверка — `YP-8 GND` и `ESP GND` относительно `S-30-5 V-`.

## S-026 — падение по GND-тракту 2026-09-20

Пользовательские измерения при подключённом ESP8266 и чёрном щупе мультиметра на `S-30-5 V-`.

Результаты: `YP-8 GND = 0,8 В`; `ESP GND = 1,5 В`.

Интерпретация: общий низковольтный возврат имеет недопустимо большое падение напряжения. Это согласуется с нестабильными/противоречивыми измерениями питания ESP и указывает на плохой контакт, высокое сопротивление Dupont/макетной шины или разрыв секции шины. До пересборки силовой разводки прошивку и Wi‑Fi ESP8266 не выполнять.

## S-027 — контроль питания после пересборки 2026-09-20

Пользовательские измерения мультиметром после пересборки низковольтной цепи питания ESP8266 прямыми короткими соединениями.

Результаты: `S-30-5 = 5,0 В`; `YP-8 VIN = 5,0 В`; `YP-8 VOUT = 3,3 В`; `ESP VCC = 3,3 В`.

Вывод: ранее наблюдавшаяся большая просадка была связана с макетной/контактной разводкой GND/питания. После её исключения статическое питание ESP8266 соответствует требуемому уровню. Проверка активного Wi‑Fi остаётся обязательной.

## S-028 — проверка делителя Nano→ESP RX 2026-09-20

Пользовательская проверка мультиметром и фото фактических резисторов.

Подтверждено: каждый резистор имеет маркировку `коричневый–зелёный–красный–золотой`, то есть `1,5 кОм ±5%`. После исправления соединения верхнее плечо делителя измерено около `1,5 кОм`, нижнее плечо от узла ESP RX до GND — около `3,0 кОм`.

Вывод: резистивная топология делителя 5 В→около 3,3 В собрана правильно; необходима финальная проверка напряжения при включённом Nano USB-UART.

## S-029 — фактические уровни Nano→ESP 2026-09-20

Пользовательские измерения мультиметром при подключённом Nano USB↔UART-мосте и ESP8266.

Результаты: `Nano D0 = 4,95 В`; после делителя `ESP RX = 3,36 В`; `ESP VCC = 3,20 В`.

Вывод: делитель 1,5 кОм / 3,0 кОм обеспечивает корректный уровень логической HIGH на RX ESP8266. Питание 3,20 В находится внутри документированного диапазона 3,0–3,6 В, но окончательная пригодность YP-8 должна подтверждаться при активной радионагрузке.

## S-030 — первая попытка прошивки ESP8266 2026-09-20

Пользовательский лог Arduino IDE/esptool.py v3.0.

Подтверждено: `ESP8266EX`, Wi‑Fi feature, crystal `26 MHz`, stub успешно загружен и запущен, flash автоматически определена как `4 MB`. Ошибка возникает уже при записи первого сжатого блока: `Failed to write compressed data to flash after seq 0 (result was C100)`.

В документации/issue esptool код `0xC1` соответствует ошибке checksum полученных данных; типичная первая мера — уменьшить скорость serial upload и исключить шум/плохие соединения UART. Источник: espressif/esptool issue #182 и описание serial protocol esptool.

## S-031 — повторная запись на 57600, 2026-09-20

Пользовательский лог Arduino IDE/esptool.py v3.0.

Результат: после ручного reset в bootloader чип `ESP8266EX` и flash `4 MB` успешно определены, stub запущен; запись дошла до `15%`, затем завершилась `Failed to write compressed data to flash after seq 1 (result was C100)`.

Вывод: вход в bootloader исправен; ошибка воспроизводится уже во время передачи/записи и стала возникать позже при меньшей скорости. Следующий диагностический шаг — ещё уменьшить upload speed и отдельно контролировать питание ESP под записью.

## S-032 — esptool 0107 при загрузке stub, 2026-09-20

Пользовательский лог: после установки `100 µF 10 V` у ESP8266 чип `ESP8266EX` определяется, затем при `Uploading stub...` возникает `Failed to write to target RAM (result was 0107)`.

Официальная документация esptool трактует `0107` как timeout при записи в RAM и рекомендует проверять стабильность serial-соединения, драйвер/USB-UART, сокращать путь Host→ESP и при необходимости использовать другой адаптер. Источник: Espressif esptool Troubleshooting.

## S-033 — штатные 1 кОм UART Arduino Nano

Официальная схема Arduino Nano V3.3 (`NanoV3.3_sch.pdf`) показывает резисторную сборку RP1A/RP1B по `1 кОм` между FT232RL и линиями RX/TX ATmega/разъёма. Пользователь отдельно указал наличие соответствующего штатного `1 кОм` на используемой Nano/совместимой плате.

Следствие для стенда: при использовании Nano как USB↔UART-моста этот резистор входит в путь PC→ESP RX и должен учитываться при расчёте согласования. Для рабочего пути ATmega D1/TX→ESP RX он не является последовательным элементом источника сигнала.

## S-034 — крупные фото UART-обвязки Nano 2026-09-20

Пользовательские крупные фото используемой Arduino Nano-совместимой платы.

По маркировке непосредственно на экземпляре видны два SMD `151` (=150 Ом) рядом с 16-выводным USB-UART-чипом и четыре SMD `102` (=1 кОм) возле индикаторов `RX/TX/POW/L` на лицевой стороне.

Вывод: типовая схема другой Nano не должна автоматически переноситься на этот экземпляр. Наличие и номинал последовательного резистора именно в пути USB-UART→D0 требуют прозвонки/измерения на фактической плате.

## S-035 — upload без внешнего делителя, 2026-09-20

Пользовательский лог esptool.py v3.0: при `Upload Speed = 57600` и временном прямом соединении Nano D0→ESP RX запись дошла до `30%` и завершилась `Failed to write compressed data to flash after seq 3 (result was C100)`.

Интерпретация: по сравнению с прежним внешним делителем 1,5 кОм / 3,0 кОм линия стала устойчивее, что указывает на чувствительность к импедансу/фронтам programmer UART. Прямое соединение не является допустимым финальным решением из-за 5-вольтового уровня D0.

## S-036 — первая успешная полная прошивка ESP8266 2026-09-20

Пользовательский лог Arduino IDE / esptool.py v3.0.

Условия успешной попытки: `Upload Speed = 115200`, локальный электролит `100 µF 10 V` между ESP VCC/GND, внешний делитель programmer RX временно отсутствовал, ручной reset при `Connecting...`.

Результат: `ESP8266EX`, flash `4MB`; запись 0–100%; `Wrote 269712 bytes ...`; `Hash of data verified`.

Вывод: физический ESP8266, flash и базовый Nano USB↔UART-путь способны выполнить полную прошивку. Поскольку одновременно были изменены питание и UART-согласование, причина предыдущих ошибок не изолирована. Прямой 5-вольтовый D0→ESP RX не является допустимой финальной схемой.

## S-037 — запуск тестового скетча ESP8266 2026-09-20

Пользовательский результат Serial Monitor после обычного boot ESP8266.

Условия: `GPIO0 = HIGH`, ESP перезапущен после успешной прошивки; Serial Monitor `115200`.

Результат: `ARDU ESP8266 OK`.

Вывод: пользовательская прошивка корректно стартует из flash на физическом модуле. Следующий отдельный тест — активная Wi‑Fi-нагрузка.

## S-038 — повторяемая 100% прошивка ESP8266 2026-09-20

Пользовательский стендовый результат: ESP8266 прошивается до `100%` через Nano USB↔UART на `115200`, если внешний делитель отсутствует, на питании ESP установлен локальный `100 µF 10 V`, `GPIO0 = LOW`, а при `Connecting...` выполняется краткий ручной reset `RST → GND`.

Отдельно подтверждено: без ручного reset соединение не начинается; при возврате делителя `1,5 кОм / 3,0 кОм` upload снова завершается ошибкой.

Инженерный вывод: ручной reset является обязательной частью текущей стендовой процедуры, а безопасное согласование PC→ESP RX ещё не закрыто. Прямой 5-вольтовый TX не считать допустимым финальным решением.

## S-039 — AlexGyver ColorMusic: питание WS2812B

Официальная страница проекта: `https://alexgyver.ru/colormusic/`.

В FAQ проекта указано: электролитический конденсатор на питание ленты — минимум `1000 µF`, рабочее напряжение не ниже `6,3 V`.

## S-040 — AlexGyver WS2812 guide: DATA и фильтрация питания

Официальный гайд: `https://alexgyver.ru/ws2812_guide/`.

Подтверждено:
- DATA: при возможной подаче сигнала на обесточенную ленту ставить последовательный резистор `200–500 Ом`;
- GND Arduino и ленты обязательно соединять;
- на питание микроконтроллера рекомендован электролит около `470 µF` при общем шумном питании;
- на питание ленты — более ёмкий электролит `1000–2200 µF`;
- адресную ленту не питать через Arduino при токе выше допустимого USB/платы.

Для ARDU это означает: `1000 µF` ставится параллельно +5V/GND ленты и **не заменяет** DATA-резистор.

## S-041 — маркировка электролита 1000 µF

Пользовательское чтение маркировки фактического компонента: `1000 µF 6.3 V`.

Вывод: подходит для 5-вольтовой линии WS2812B и соответствует минимальному напряжению, указанному в схеме/рекомендациях ColorMusic.

## S-042 — AlexGyver MAX9814: базовое подключение к Arduino

Официальный урок AlexGyver: `https://alexgyver.ru/lessons/max9814-mic/`.

Подтверждено: MAX9814 питается от `3..5 V`; `Out` подключается к аналоговому входу Arduino; `Gain` без подключения = 60 dB, на GND = 50 dB, на VCC = 40 dB; `AR` можно оставить неподключённым для базового режима. Автор отдельно описывает внешний AREF 3,3 В как опциональный способ увеличить разрешение измерения, а не обязательное условие первого запуска.

Для первого ARDU-теста принято прямое `Out→A0` при стандартном ADC reference Nano, без внешнего AREF; после измерения фактического диапазона решим, нужен ли AREF/иная обработка.

## S-043 — измерения MAX9814 на физическом стенде

Данные владельца 2026-09-20:
- `MIC AVG=249 MIN=61 MAX=413 P2P=352 SAMPLES=251`;
- `MIC AVG=252 MIN=130 MAX=415 P2P=285 SAMPLES=251`.

Средний ADC-код около 250 согласуется с маркированным на модуле DC Offset `1.25V` при стандартной опоре ADC Nano около 5 В. Для оценки реакции на кратковременный звук 50-мс snapshot признан недостаточным; добавлен 1-секундный capture `MIC1S`.

## S-044 — MAX9814: 1-секундные quiet/loud измерения

Физический стенд, 2026-09-20:
- тишина: `AVG=252 MIN=108 MAX=417 P2P=309 SAMPLES=4998`;
- громкий звук/хлопок: `AVG=307 MIN=0 MAX=886 P2P=886 SAMPLES=4995`.

Вывод: MAX9814 исправен и чувствителен к звуку; при `Gain` floating (60 dB) громкий сигнал достигает нижней границы 10-битного ADC (`0`), поэтому требуется уменьшить усиление до 50 dB и повторить тест.

## S-045 — MAX9814: аномальный результат после перемычки Gain→GND

Физический стенд, 2026-09-20:
- `MIC1S AVG=0 MIN=0 MAX=5 P2P=5 SAMPLES=4993`;
- `MIC1S AVG=0 MIN=0 MAX=16 P2P=16 SAMPLES=4992`.

Это резко отличается от предыдущего рабочего состояния `AVG≈252` и требует проверки фактического контакта Gain/Out. До повторной идентификации пина 50 dB не считать проверенным.

## S-046 — MAX9814: восстановление после снятия Gain→GND

Физический стенд, 2026-09-20, при шуме и `Gain` снова floating: `MIC1S AVG=278 MIN=0 MAX=508 P2P=508 SAMPLES=4996`.

Вывод: модуль и A0 работоспособны; предыдущее падение выхода к нулю связано с конкретной попыткой подключения Gain, а не с постоянной неисправностью MAX9814.

## S-047 — крупное фото MAX9814, распиновка конкретного модуля

Фото владельца 2026-09-20 подтверждает подписи контактного ряда слева направо: `AR`, `Out`, `Gain`, `Vdd`, `GND`. На фото видны рабочие подключения: `Out` — жёлтый, `Vdd` — зелёный, `GND` — синий; `AR` и `Gain` свободны.

## S-048 — MAX9814: физические измерения при Gain=50 dB

Данные владельца 2026-09-20:
- тишина: `MIC1S AVG=250 MIN=85 MAX=360 P2P=275 SAMPLES=5000`;
- громкий звук: `MIC1S AVG=260 MIN=0 MAX=507 P2P=507 SAMPLES=996`.

Вывод: правильное подключение Gain к GND подтверждено по восстановившемуся DC-offset около 250 ADC, однако громкий сигнал всё ещё клиппует по нижней границе. Следующий штатный вариант платы — Gain к Vdd (40 dB).

## S-048 — MAX9814 50 dB: сравнение при включённой/выключенной ленте

Данные физического стенда 2026-09-20:
- спокойное состояние: `AVG=250 MIN=85 MAX=360 P2P=275 SAMPLES=5000`;
- шум, лента включена: `AVG=260 MIN=0 MAX=507 P2P=507`;
- шум, лента выключена: `AVG=257 MIN=0 MAX=506 P2P=506 SAMPLES=4991`.

Разница между шумовыми окнами с лентой и без неё пренебрежимо мала для текущего теста; 50 dB всё ещё достигает нижнего rail ADC.

## S-049 — AlexGyver ColorMusic v2.10: алгоритм VU/M01

Официальный репозиторий: `https://github.com/AlexGyver/ColorMusic`, файл `firmware/colorMusic_v2.10/colorMusic_v2.10.ino`.

Для первых двух VU-режимов исходник делает 100 `analogRead`, берёт максимальный отсчёт, отсекает шум через `LOW_PASS`, переводит диапазон в 0..500, применяет степень `EXP=1.4`, сглаживание `SMOOTH=0.3`, медленное среднее `averK=0.006` и `MAX_COEF=1.8` для автоподстройки шкалы. Автокалибровка VU берёт максимум из 200 измерений тишины и задаёт `LOW_PASS = quietMax + LOW_PASS_ADD`, где `LOW_PASS_ADD=13`.

ARDU M01 использует эти же принципы, но адаптирован под один моно-микрофон A0 и кольцо 43 LED.

## S-050 — MAX9814 40 dB, физический стенд

Данные владельца 2026-09-20 при `Gain→Vdd`:
- тишина: `MIC1S AVG=250 MIN=205 MAX=282 P2P=77 SAMPLES=4997`;
- громкий звук: `MIC1S AVG=250 MIN=0 MAX=503 P2P=503 SAMPLES=4999`.

Вывод для M01: положительный пик уверенно отделяется от шума, 40 dB принимается как рабочий Gain первого VU-режима; отрицательный rail clipping экстремального хлопка оставить предметом отдельной проверки перед FHT/частотными режимами.

## S-051 — M01, физическая калибровка и рабочая диагностика

Данные владельца 2026-09-20:
- `CAL QUIET_MAX=260 LOW_PASS=273`;
- `AUDIO PEAK=276 LOW_PASS=273 LEVEL=2.6 FILTERED=17.8 AVG=63.4 MAX=114.2 PAIRS=3`;
- визуальная работа M01 подтверждена владельцем.

Эти данные закрывают первый музыкальный режим на физическом кольце и дают фактический порог тишины для текущего MAX9814 40 dB.

## S-052 — KobaProduction AvrFHT

Репозиторий: `https://github.com/KobaProduction/AvrFHT`.

`library.properties`: версия `1.1.1`, `architectures=avr`. README описывает AvrFHT как модификацию устаревшей ArduinoFHT/Open Music Labs с изменённой архитектурой и оптимизациями памяти.

API, нужный ARDU:
- `FHT_SAMPLES_N` задаёт размер выборки;
- `fht_input[]` сохраняется;
- отдельные headers `fht_window.h`, `fht_reorder.h`, `fht_mag_log.h`;
- преобразование вызывается `fht_transform()`;
- логарифмический результат — `fht_log_out[]`.

## S-053 — AlexGyver ColorMusic содержит старую FHT

Официальный репозиторий `https://github.com/AlexGyver/ColorMusic`, путь `libraries/FHT/` содержит `FHT.h`, reorder/cas/hann tables и examples. Поэтому утверждение «у AlexGyver не было FHT» неверно; она была вложена в репозиторий проекта и не обязана отображаться как отдельная Library Manager библиотека.

## S-054 — первая AvrFHT-калибровка на железе

Данные владельца 2026-09-20:
- `CALF DC=914 QUIET_MAX=32 SPECTR_LOW_PASS=35`;
- `FREQ LOW=0 MID=0 HIGH=0 PEAK=0 LOW_PASS=35` (два раза).

Поскольку ранее тот же MAX9814 устойчиво давал DC около 250 ADC, эти FHT-данные не принимаются как физический результат. Диагностический код изменён так, чтобы DC offset измерять на стандартной скорости ADC и отдельно проверять командой `ADC`.

## S-055 — AvrFHT повторный стендовый результат

Данные владельца 2026-09-20:
- `CALF DC=946 QUIET_MAX=33 SPECTR_LOW_PASS=36`;
- `FREQRAW LOW=19 MID=27 HIGH=19 PEAK=27`;
- `FREQRAW LOW=19 MID=19 HIGH=19 PEAK=19`.

Результат DC остаётся несовместимым с предыдущими прямыми измерениями MAX9814 на A0 (около 250 ADC), поэтому спектр пока считается диагностически невалидным.

## S-056 — MAX9814/FHT, нулевой вход после повторного подключения Gain

Физический стенд 2026-09-21:
- `CALF DC=0 QUIET_MAX=19 SPECTR_LOW_PASS=22`;
- `FREQRAW LOW=0 MID=0 HIGH=0 PEAK=0` два раза.

До восстановления прямого ADC около прежних ~250 эти данные не использовать как характеристику AvrFHT или спектра.

## S-057 — прямой ADC после подтверждения актуальной прошивки

Физический стенд 2026-09-21:
- `CMDS PING STATUS ADC CALF FREQ FREQRAW HELP`;
- `ADC AVG=0 MIN=0 MAX=13`.

Следствие: текущий A0 практически у нулевого rail; спектральные результаты до восстановления OUT/A0 невалидны.

## S-058 — прямые напряжения MAX9814, физический стенд

Измерения владельца 2026-09-21:
- `MAX9814 Vdd→GND = 5,09 В`;
- `MAX9814 Out→GND = 1,24 В`.

Модуль имеет нормальное питание и ожидаемое выходное DC-смещение; текущий нулевой ADC на Nano возникает после точки Out.

## S-059 — напряжение непосредственно на Nano A0

Физический стенд 2026-09-21: `Nano A0→Nano GND = 0,15 В` при `MAX9814 Out→GND = 1,24 В`.

Разница почти 1,1 В на прямой сигнальной линии подтверждает аппаратную проблему между модулем и входом Nano либо нагрузку A0.

## S-060 — восстановление напряжения на Nano A0

Физический стенд 2026-09-21: после исправления провода `MAX9814 Out→Nano A0` измерено `Nano A0→GND = 1,25 В`.

Это подтверждает восстановление аналоговой линии и соответствует ожидаемому DC bias MAX9814.

## S-061 — первый валидный AvrFHT спектр на физическом стенде

Данные владельца 2026-09-21 после ремонта `Out→A0`:
- `ADC AVG=250 MIN=233 MAX=264`;
- `CALF DC=250 QUIET_MAX=61 SPECTR_LOW_PASS=64`;
- тишина: `FREQRAW LOW=19 MID=19 HIGH=16 PEAK=19`;
- звук/музыка: `FREQRAW LOW=64 MID=30 HIGH=19 PEAK=64`.

Вывод: аналоговый вход и AvrFHT работают; спектр реагирует на звук. На данном тестовом фрагменте LOW доминирует, поэтому отдельная проверка MID/HIGH ещё нужна.

## S-062 — FHT gate слишком высок при абсолютном максимуме

Данные владельца 2026-09-21:
- `CALF DC=258 QUIET_MAX=58 SPECTR_LOW_PASS=61`;
- серия `FREQ` — только нули;
- `FREQRAW LOW=37 MID=19 HIGH=19 PEAK=37`.

Поскольку raw peak=37 ниже gate=61, нулевой gated-результат объясняется порогом. Для ARDU CALF адаптирован: вместо абсолютного максимума 100 кадров используется 90-й процентиль максимумов +3. Это сохраняет принцип ColorMusic «измеренный шум + запас», но исключает влияние редких выбросов MAX9814.

## S-063 — оригинальный тракт FHT AlexGyver ColorMusic v2.10

Официальные источники: `AlexGyver/ColorMusic`, `firmware/colorMusic_v2.10/colorMusic_v2.10.ino`, и страница `https://alexgyver.ru/colormusic/`.

Подтверждено:
- `SOUND_R A2` — вход VU;
- `SOUND_R_FREQ A3` — отдельный вход частот, в коде прямо отмечен `через кондер`;
- `FHT_N=64`, логарифмический FHT output;
- при `POTENT=0` используется внутренняя опора 1.1 В;
- ADC prescaler устанавливается в 32;
- spectrum auto-low-pass: 100 FHT кадров, поиск абсолютного максимума по bins 2..31, затем `SPEKTR_LOW_PASS = max + LOW_PASS_FREQ_ADD`, где `LOW_PASS_FREQ_ADD=3`;
- `fullLowPass()` гасит ленту, ждёт 500 мс, выполняет калибровку, ждёт ещё 500 мс и возвращает яркость;
- официальная инструкция требует калибровать шум при поставленной на паузу музыке и рекомендует сохранение порогов в EEPROM.

Вывод для ARDU: текущий прямой MAX9814→A0 с DEFAULT AREF и программным DC subtraction не является точной копией оригинального частотного входа ColorMusic. P90 — эксперимент ARDU, не исходный алгоритм.

## S-064 — официальные версии AlexGyver ColorMusic

Официальная страница `https://alexgyver.ru/colormusic/` содержит changelog: v1.1, v2.0, v2.2, v2.3, v2.4, v2.5, v2.6, v2.6.1, v2.6.2, v2.7, v2.8, v2.10. В списке компонентов указан микрофонный модуль MAX9814. Отдельная официальная ревизия под MAX4466 на странице не найдена.

## S-065 — ColorMusic FireEdition и MAX4466

Community thread: `https://community.alexgyver.ru/threads/cvetomuzyka-na-arduino-fireedition.4683/`.

FireEdition авторства Slenk основана на разработках technotrasher и имеет собственную линейку (2.0, 2.4, 2.5, 2.5.1, 2.6, 2.7, 3.1). Поддерживает MIC/LINE и отдельные `SOUND_R_MIC` / `SOUND_R_MIC_FREQ` входы.

В обсуждении исходного проекта technotrasher 28.12.2020 указал план использовать MAX4466 по совету Diman. В FireEdition-потоке пользователь подтвердил наличие MAX4466; Diman отметил отсутствие AGC у MAX4466, регулируемый больший выходной диапазон и рекомендовал отличающуюся от MAX9814 обвязку. Это относится к community-модификациям и не является официальной версией AlexGyver.

## S-066 — поздние официальные прошивки ColorMusic в репозитории AlexGyver

Официальный репозиторий `AlexGyver/ColorMusic` содержит текущую папку `firmware/colorMusic_v2.10/` и старые официальные ревизии, включая `colorMusic_v2.7` и `colorMusic_v2.8` в `firmware/Old versions/`. README проекта документирует изменения до v2.7; наличие v2.8/v2.10 подтверждается самим деревом официального репозитория и исходниками.

## S-067 — vendored FHT и официальные поздние ColorMusic

Источник: официальный `AlexGyver/ColorMusic`, pinned commit `a3f94de053d431f15282c2f67681b77ab66c30ae`.

В ARDU сохранены:
- исходная `libraries/FHT/` вместе с примерами;
- upstream LICENSE;
- `colorMusic_v2.7.ino`, `colorMusic_v2.8.ino`, `colorMusic_v2.9.ino`, `colorMusic_v2.10.ino`;
- каталог точных имён прошивочных папок и файлов.

Это убирает зависимость компиляции музыкального тракта от сторонней AvrFHT и сохраняет исходный API поздней официальной ColorMusic.

## S-068 — конфликт legacy FHT SCALE с современным FastLED

Физическая компиляция владельца 2026-09-21 показала, что `FHT.h` из ColorMusic содержит `#define SCALE 1`; современный FastLED использует идентификатор `SCALE` в fixed-point типах и gamma LUT, что даёт серию ошибок `expected unqualified-id before numeric constant`.

Compatibility fix сделан в ARDU-скетче, а не в upstream-копии FHT: после `#include <FHT.h>` выполняется `#undef SCALE`, затем подключается `FastLED.h`.

## S-069 — аппаратная проверка сборки original FHT

Отчёт владельца 2026-09-21: после внесения `#undef SCALE` загрузка `nano_fht_test.ino` успешно завершена на реальной Arduino Nano.

Это подтверждает компиляцию и Upload оригинальной vendored FHT в текущем окружении ARDU.

## S-070 — runtime original FHT и рассогласование startup DC

Физический стенд 2026-09-21:
- `HELP -> CMDS PING STATUS ADC CALF FREQ FREQRAW HELP`;
- `STATUS FW=FHTTEST MIC_GAIN=40DB SPECTR_LOW_PASS=40 LIB=AlexGyver_FHT FHT_N=64 DC=390 ADC_REF=DEFAULT ...`;
- `ADC AVG=251 MIN=242 MAX=258`.

Текущий A0 исправен, но startup DC=390 не соответствует установившемуся входу. Для следующего теста добавлена пауза 500 ms; CALF возвращён к оригинальной схеме ColorMusic `max + 3`.

## S-071 — уточнение физического состояния A0 при DC=390

Сообщение владельца 2026-09-21: в прошлом тесте провод с A0 отвалился. Следовательно, ранее полученный `STATUS ... DC=390` был снят при ненадёжном/разомкнутом аналоговом входе и не должен использоваться как характеристика исправного MAX9814→A0.

## S-072 — валидный original FHT + ColorMusic CALF

Физический стенд 2026-09-21:
- `ADC AVG=265 MIN=259 MAX=272`;
- `STATUS ... LIB=AlexGyver_FHT FHT_N=64 DC=252`;
- `CALF DC=264 QUIET_MAX=33 SPECTR_LOW_PASS=36`;
- `FREQRAW LOW=74 MID=82 HIGH=27 PEAK=82`.

Вывод: direct ADC исправен, повторная DC-калибровка согласована с текущим уровнем, оригинальный `max + 3` gate больше не завышен относительно raw-сигнала.

## S-073 — gated FREQ после original CALF

Физический стенд 2026-09-21:
- тишина: три раза `FREQ LOW=0 MID=0 HIGH=0 PEAK=0 LOW_PASS=36`;
- звук: `FREQ LOW=38 MID=0 HIGH=0 PEAK=38 LOW_PASS=36`;
- звук: `FREQ LOW=66 MID=0 HIGH=0 PEAK=66 LOW_PASS=36`.

Официальный `colorMusic_v2.10.ino` делит группы так же, как текущий ARDU diagnostic: LOW bins 2..5, MID 6..10, HIGH 11..31.

## S-074 — A2/A3 в официальной ColorMusic v2.10

Официальный `AlexGyver/ColorMusic`, `firmware/colorMusic_v2.10/colorMusic_v2.10.ino`:
- `#define SOUND_R A2`;
- `#define SOUND_L A1`;
- `#define SOUND_R_FREQ A3` с комментарием «через кондер»;
- `#define POT_GND A0`;
- при `MONO=1` основной звуковой канал — `SOUND_R`.

Официальная страница проекта также содержит отдельную схему «С микрофоном» и в перечне деталей конденсатор 10 нФ. Community-обсуждения стандартной гайверовской схемы уточняют связь A2/A3 через 10 нФ, но финальную физическую разводку ARDU следует брать с официальной схемы.

## S-075 — контролируемые частотные тесты FHT на A0

Физический стенд 2026-09-21, `LOW_PASS=36`:
- 2 кГц: `LOW=92/84/92/84`, MID/HIGH=0;
- 5 кГц: `MID=92` четыре раза, LOW/HIGH=0;
- 8 кГц: `HIGH=78/68/68/72`, LOW/MID=0.

Это аппаратно подтверждает соответствие группировки `LOW bins 2..5`, `MID 6..10`, `HIGH 11..31` текущему FHT-тракту Nano.

## S-076 — физическая связь A2/A3 в ColorMusic

Официальный код v2.10 задаёт `SOUND_R=A2` и `SOUND_R_FREQ=A3` («через кондер»). В обсуждении оригинального проекта участники, собиравшие штатную схему, указывают: `A2↔A3 = 0.01 µF (10 nF, 103)`. Для микрофонного варианта между выходом микрофона и A2 применяется дополнительный разделительный конденсатор; встречается 22 µF 6.3 V в сборках по схеме проекта. Перед финальной пайкой номинал/полярность проверить по сохранённой официальной схеме.

## S-077 — аппаратная схема A2/A3 для текущего стенда

Основание:
- официальный `colorMusic_v2.10.ino`: `SOUND_R=A2`, `SOUND_R_FREQ=A3`, `POTENT=0 → analogReference(INTERNAL)`;
- официальная схема ColorMusic «С микрофоном»: MAX9814, разделительный электролит 1–100 µF ≥6,3 V, резистор около 10 kΩ и конденсатор 103/10 nF в ветви частотного входа;
- фактический инвентарь ARDU: 1 µF электролиты, 4,7 kΩ резисторы и 103/10 nF доступны.

Проектная замена: вместо одного 10 kΩ использовать два 4,7 kΩ последовательно = 9,4 kΩ.

## S-078 — официальная схема MAX9814 ColorMusic, предоставленная владельцем

На предоставленной владельцем схеме «Светомузыка на адресной светодиодной ленте by AlexGyver, Версия 2.0» визуально подтверждено:
- выход MAX9814 идёт через электролит `1–100 µF, 6.3 V или выше` к A2;
- между A2 и A3 стоит `103` ≈10 nF;
- отдельного резистора A2→GND нет;
- `10–100 kΩ` — это номинал потенциометра цепи AREF;
- A0 используется как земля этого потенциометра.

Эта схема имеет приоритет над прежним предположением о pull-down A2.

## S-078 — визуальная сверка официальной схемы ColorMusic с MAX9814

Предоставленное владельцем изображение официальной схемы AlexGyver показывает:
- MAX9814 Out через электролит 1–100 µF ≥6,3 V на A2;
- A2 через `103` (около 10 nF) на A3;
- **нет** резистора A2→GND;
- потенциометр `10–100 kΩ` подключён отдельно к `A0 / REF / 3V3` и относится к настройке AREF;
- подпись схемы разрешает работу без потенциометра при `POTENT=0`.

## S-079 — первый аппаратный runtime A2/A3

Данные владельца 2026-09-22 на `nano_audio_v210_test`:
- `STATUS FW=FHTV210 MIC_GAIN=40DB VU_PIN=A2 FHT_PIN=A3 ... SPECTR_LOW_PASS=40 LIB=AlexGyver_FHT FHT_N=64 ADC_REF=INTERNAL_1V1`;
- `ADC2 AVG=123 MIN=105 MAX=154`;
- `ADC3 AVG=745 MIN=726 MAX=779`.

Следствие: после перехода на официальную A2/A3-разводку оба аналоговых входа читаются и не находятся на rail 0/1023. Это подтверждает первый аппаратный запуск новой разводки, но ещё не закрывает `CALF/FREQ` и VU — они проверяются отдельно.

## S-080 — CALF на финальном A3

Данные владельца 2026-09-22:
- `CALF QUIET_MAX=37 SPECTR_LOW_PASS=40`.

Это подтверждает, что на финальной A2/A3-разводке original ColorMusic calibration `max + 3` формирует рабочий порог 40. Проверка фактического подавления тишины выполняется отдельной командой `FREQ`.

## S-081 — gated FREQ в тишине на финальном A3

Данные владельца 2026-09-22 после `CALF QUIET_MAX=37 SPECTR_LOW_PASS=40`:
- `FREQ LOW=0 MID=0 HIGH=0 PEAK=0 LOW_PASS=40`;
- `FREQ LOW=0 MID=0 HIGH=0 PEAK=0 LOW_PASS=40`;
- `FREQ LOW=0 MID=0 HIGH=0 PEAK=0 LOW_PASS=40`.

Следствие: spectrum noise gate на финальной A3-разводке стабильно подавляет тишину. Следующий аппаратный критерий — контролируемые тоны 2 / 5 / 8 кГц.

## S-082 — tone regression A3: gated output остаётся нулевым

Данные владельца 2026-09-22:
- при проверке 2 / 5 / 8 кГц `FREQ LOW=0 MID=0 HIGH=0 PEAK=0 LOW_PASS=40`.

Результат не доказывает отсутствие сигнала до просмотра `FREQRAW`: текущий gate может обнулять значения ниже 40. Следующая проверка — raw FHT при непрерывном 2 кГц.

## S-083 — raw FHT при 2 кГц на финальном A3

Данные владельца 2026-09-22, непрерывный 2 кГц:
- `FREQRAW LOW=37 MID=19 HIGH=19 PEAK=37`;
- `FREQRAW LOW=37 MID=19 HIGH=19 PEAK=37`;
- `FREQRAW LOW=37 MID=19 HIGH=19 PEAK=37`.

Ранее в тишине `CALF QUIET_MAX=37 SPECTR_LOW_PASS=40`. Следовательно, полезный 2 кГц на текущем A3 не поднимает raw peak выше quiet maximum; gated `FREQ=0` является ожидаемым. Следующий тест локализует потерю между A2 и A3 через сравнение ADC-диапазонов под тоном.

## S-084 — ADC2/ADC3 при непрерывном 2 кГц

Данные владельца 2026-09-22:
- `ADC2 AVG=323 MIN=294 MAX=418`;
- `ADC3 AVG=853 MIN=839 MAX=905`.

Тихий baseline ранее: A2 `105..154`, A3 `726..779`. Тон увеличивает размах A2 с 49 до 124 и A3 с 53 до 66 ADC counts. Следовательно, сигнал проходит до обоих входов; нулевой gated FHT нельзя объяснить полным обрывом ветви A3.

## S-085 — raw FHT одинаков для 2/5/8 кГц на A3

Данные владельца 2026-09-22:
- 2 кГц: `FREQRAW LOW=37 MID=19 HIGH=19 PEAK=37`;
- 5 кГц: `FREQRAW LOW=37 MID=19 HIGH=19 PEAK=37`;
- 8 кГц: `FREQRAW LOW=37 MID=19 HIGH=19 PEAK=37`.

Кодовая сверка показала: прежний успешно проверенный `nano_fht_test` вычисляет `micDcOffset` и перед FHT использует `analogRead(...) - micDcOffset`. Текущий `nano_audio_v210_test` намеренно следует v2.10 и подаёт raw A3 без программного DC subtraction. Для локализации добавлены `ADC3FAST` и `FREQRAWZ`.

## S-086 — официальный AlexGyver: внутренняя AREF 1.1 V требует подходящего уровня сигнала

Официальная страница ColorMusic AlexGyver указывает:
- AREF регулируется потенциометром при смене источника/громкости;
- слишком низкая опора означает слишком высокий входной сигнал;
- при `POTENT=0` используется внутренняя 1.1 V, но этот режим работает не с любой громкостью и требует подбора входного уровня.

Физический результат ARDU 2026-09-22: `ADC3FAST AVG=1023 MIN=1023 MAX=1023` при prescaler=32. Это согласуется со сценарием насыщения ADC при текущей 1.1 V AREF. Перед переходом на внешний AREF проверить `ADC3FAST` в тишине.

## S-087 — требования ADC ATmega328P и community-практика ColorMusic

Microchip ATmega328P datasheet: ADC оптимизирован для источника с выходным сопротивлением около 10 kΩ или меньше; при большем сопротивлении заряд sample/hold-конденсатора требует больше времени и результат сильнее зависит от источника.

AlexGyver Community:
- при проблемах звукового тракта встречается рекомендация резисторов 10–100 kΩ, часто 47 kΩ, к GND;
- в одной рабочей микрофонной модификации частотный A3 подключён отдельным конденсатором прямо от выхода микрофона, что улучшило стабильность частотных режимов.

Эти варианты не заменяют официальную схему и используются только как диагностические ориентиры. Для ARDU сначала проверяется быстрый ADC на A2 и динамика первых отсчётов A3.

## S-088 — fast ADC saturation одновременно A2/A3

Физический стенд 2026-09-22, генератор выключен:
- `ADC2FAST AVG=984 MIN=831 MAX=1023`;
- `ADC3FAST AVG=891 MIN=768 MAX=1023`;
- `ADC3TRACE SAMPLES=1023,1023,1023,1023,1023,1023,1023,1023,1023,1023,1023,1023,1023,1023,1023,1023`.

Следствие: насыщение относится не только к частотной ветви A3. Для следующей проверки выбран диагностический DC-return обоих AC-coupled входов к GND. Community-схемы ColorMusic используют 10–100 kΩ, часто 47 kΩ; ARDU временно использует имеющиеся 2×4,7 kΩ последовательно на каждый вход только для локализации причины.

## S-089 — MAX4466 как сравнительный микрофонный стенд

Analog Devices: MAX4466 работает от 2.4–5.5 V, имеет rail-to-rail output и 600 kHz gain-bandwidth при минимальном стабильном gain +5.

AlexGyver Community/FireEdition: MAX4466 отмечался как удобный для тестирования благодаря регулируемому выходному диапазону; при проблемах с исходной микрофонной разводкой предлагалось использовать резистивное подключение и сначала контролировать DC/уровень сигнала.

Для ARDU выбран отдельный диагностический вариант: A2 и A3 получают один и тот же OUT через независимые ~9,4 kΩ ветви, DEFAULT AREF; это не объявляется оригинальной схемой ColorMusic.

## S-090 — первый MAX4466 runtime и ожидаемый DC bias

Физический стенд 2026-09-22:
- STATUS DC=7;
- ADC2 AVG=7 MIN=1 MAX=12;
- ADC3 AVG=8 MIN=4 MAX=12;
- ADC2FAST AVG=8 MIN=4 MAX=14;
- ADC3FAST AVG=8 MIN=4 MAX=15.

Официальная документация Adafruit для типичного MAX4466 breakout указывает DC bias OUT около VCC/2 и прямое подключение OUT к ADC микроконтроллера без обязательного разделительного конденсатора. Следовательно, текущий уровень около нуля требует прямого измерения OUT на модуле до FHT.

## S-091 — MAX4466: ожидаемый DC bias и фактический OUT≈0 V

Adafruit для типичного MAX4466 breakout указывает DC-coupled OUT с bias около VCC/2; OUT допускается подключать напрямую к ADC микроконтроллера.

Физический ARDU-стенд 2026-09-22: `VCC≈5,1 V`, `OUT≈0 V` прямо на модуле. Это не соответствует нормальному bias и требует изоляционного теста модуля без подключения OUT к Nano.

## S-092 — изолированный MAX4466 даёт нормальный bias

Физический стенд 2026-09-22:
- `VCC≈5,1 V`;
- `OUT≈2,55 V` при полностью отключённом выходе.

Это подтверждает исправность MAX4466 и ожидаемый bias около VCC/2. Предыдущий нулевой OUT был следствием внешней стендовой разводки.

## S-093 — прямой MAX4466 OUT→A2

Физический стенд 2026-09-22:
- `ADC2 AVG=244 MIN=208 MAX=293`;
- `ADC2FAST AVG=230 MIN=199 MAX=286`.

При DEFAULT reference и ранее измеренном изолированном OUT=2,55 V ожидаемый код был бы примерно половиной шкалы. Требуется измерить OUT и A2 мультиметром именно в подключённом состоянии, чтобы отделить падение физического напряжения от несоответствия ADC/reference.

## S-094 — A2 физически 2,55 V при ADC≈244

Физический стенд 2026-09-22:
- MAX4466 OUT→GND = 2,55 V;
- Nano A2→GND = 2,55 V;
- software ADC2 AVG≈244, ADC2FAST AVG≈230.

При 10-bit ADC и reference около 5 V код для 2,55 V должен быть примерно половиной шкалы. Для отделения ошибки скетча от аппаратного ADC создан минимальный sanity sketch без FHT и изменения prescaler.

## S-092 — MAX4466 не прошёл изоляционный DC-bias тест

Физический ARDU-стенд 2026-09-22:
- MAX4466 OUT полностью отключён от Nano и резисторов;
- `VCC≈5,1 V`;
- `OUT≈0,1 V`.

Официальная документация Adafruit для типичного MAX4466 breakout указывает DC-coupled OUT с bias около VCC/2 и допускает прямое OUT→ADC. Analog Devices подтверждает рабочее питание MAX4466 2.4–5.5 V. При 5,1 V текущие 0,1 V на свободном OUT не соответствуют нормальному режиму типичного breakout.

## S-093 — основание для single-input MAX9814

Подтверждённые физические результаты предыдущего A0-стенда:
- MAX9814 OUT≈1,24–1,25 V;
- ADC около 250 counts;
- M01 VU визуально работал;
- original AlexGyver FHT работала с software DC subtraction;
- 2 kHz активировал LOW, 5 kHz MID, 8 kHz HIGH;
- noise gate после CALF подавлял тишину.

Эти данные являются прямым аппаратным основанием D-040. Двухвходовое разделение A2/A3 не требуется самим визуальным режимам: оно было частью analog frontend оригинальной ColorMusic; ARDU сохраняет алгоритмы режимов, но использует единый подтверждённый ADC frontend.

## S-094 — первый runtime D-040 после возврата MAX9814 на A0

Данные владельца 2026-09-23:
- `STATUS FW=AUDIO_SINGLE MIC=MAX9814 MIC_PIN=A0 MIC_GAIN=40DB AR=FLOAT ADC_REF=DEFAULT DC=467 ...`;
- `ADC AVG=237 MIN=225 MAX=250 P2P=25`.

Следствие: аналоговый вход A0 снова физически исправен и находится в рабочем диапазоне, но startup DC=467 не соответствует текущему среднему 237. До FHT требуется повторная DC-калибровка.

## S-095 — валидный CALF после возврата MAX9814 на A0

Данные владельца 2026-09-23:
- `CALF DC=234 QUIET_MAX=33 SPECTR_LOW_PASS=36`.

Перед этим `ADC AVG=237 MIN=225 MAX=250`. Следовательно, повторная DC-калибровка согласована с физическим входом, а spectrum gate вернулся к ранее успешно проверенному значению 36.

## FastLED — AVR interrupt blackout при WS2812

- FastLED Wiki: Performance and Timing — для AVR (Uno/Nano/Mega) `FASTLED_ALLOW_INTERRUPTS=0` по умолчанию; при clockless WS2812 прерывания отключаются на весь кадр, что может мешать hardware Serial и другим interrupt-driven перифериям.
- Источник: https://github.com/FastLED/FastLED/wiki/Performance-and-Timing
- Использование в ARDU: объяснение периодических повреждённых Serial-команд при активном `FastLED.show()`; финальный UART требует устойчивого протокола/ACK-retry.

## FastLED AVR — interrupt policy

- FastLED current AVR platform README states `FASTLED_ALLOW_INTERRUPTS` defaults to `0` on AVR and may be forced to `1` with tighter timing constraints.
- FastLED config documents `FASTLED_INTERRUPT_RETRY_COUNT` with default retry count 2 for frames disrupted by long interrupts.
- Sources:
  - https://github.com/FastLED/FastLED/blob/master/src/platforms/avr/README.md
  - https://github.com/FastLED/FastLED/blob/master/src/fastled_config.h
- ARDU use: M05 R4 transport experiment enabling interrupts during WS2812B output, followed by hardware regression for both UART reliability and LED signal integrity.

## 2026-09-27 — W3C WCAG — Three Flashes (исторический источник, M06 удалён)

- W3C WAI, WCAG 2.2 Understanding SC 2.3.1 / 2.3.2: flashing content guidance uses a threshold of no more than three flashes in any one-second period (or specific flash-threshold analysis for SC 2.3.1).
- Источник использовался только при временном тесте M06 R1. После решения владельца 2026-09-27 стробоскоп исключён из ARDU; источник больше не определяет активные требования проекта.
- Не считать это медицинской гарантией, испытанием конкретной лампы или сертификацией аппаратного устройства.
- Источник: W3C WAI WCAG 2.2, Understanding Three Flashes / Three Flashes or Below Threshold.

## 2026-09-27 — owner hardware update: 44 LED rings and warm 2700K

- Владелец сообщил, что физическое кольцо увеличено до 44 WS2812B.
- Новая финальная геометрия: 44 LED на корпус, 88 суммарно.
- Владелец подтвердил полный L01 R2 test.
- Визуально preset R2 2700 K оказался недостаточно тёплым; желаемый 2700 K соответствует внешнему виду прежнего R2 KELVIN 2200.
- Для L01 R3 принят 2700 K -> RGB 255,170,87 как пользовательская визуальная калибровка конкретного ARDU.

## 2026-09-27 — AlexGyver Clap / VolAnalyzer / GyverLamp2

Проверены исходники:
- `https://github.com/GyverLibs/Clap` — official GyverLibs Clap library;
- `https://github.com/GyverLibs/VolAnalyzer` — amplitude analyzer;
- `https://github.com/AlexGyver/GyverLamp2/blob/master/firmware/GyverLamp2/analog.ino`;
- `https://github.com/AlexGyver/GyverLamp2/blob/master/firmware/GyverLamp2/Clap.h`;
- `https://github.com/AlexGyver/GyverLamp2/blob/master/firmware/GyverLamp2/VolAnalyzer.h`.

Практически важное:
- GyverLamp2: `clap.setTimeout(500)`, `clap.setTrsh(250)`;
- `clap.tick(vol.getRawMax())`;
- переключение состояния по `clap.hasClaps(2)`.
- Clap state machine анализирует derivative, а не абсолютную амплитуду.
- README текущей Clap предупреждает о несовместимости с актуальной VolAnalyzer, поэтому ARDU diagnostic не смешивает несогласованные версии библиотек.

## 2026-09-30 — ESP8266 ArduinoOTA — official core

- Official ESP8266 Arduino core ArduinoOTA API: `ArduinoOTA.setPort()`, `setHostname()`, `setPassword()`, `begin()`, `handle()`; default ESP8266 OTA port is 8266.
- Official BasicOTA example confirms Station Wi-Fi + ArduinoOTA workflow.
- Sources:
  - https://github.com/esp8266/Arduino/blob/master/libraries/ArduinoOTA/ArduinoOTA.h
  - https://github.com/esp8266/Arduino/blob/master/libraries/ArduinoOTA/ArduinoOTA.cpp
  - https://github.com/esp8266/Arduino/blob/master/libraries/ArduinoOTA/examples/BasicOTA/BasicOTA.ino
- ARDU-specific constraint: do not print OTA progress to ESP Serial because it is the Nano command UART.

## S-OTA-001 — первый реальный ESP OTA pass 2026-09-30

Пользовательский лог Arduino IDE и HTTP regression после загрузки по Wi-Fi.

Подтверждено:
- Arduino IDE обнаруживает network port `ardu 192.168.0.4`;
- OTA authentication проходит;
- следующая ревизия R5 передана по Wi-Fi без изменения рабочей проводки;
- после reboot `GET /api/ping` возвращает `fw=HTTP_BRIDGE_R5`, `wifi_connected=true`, `ota_ready=true`, hostname `ardu`, port `8266`;
- `GET /api/status` после OTA возвращает `FW=FW10_CORE REV=1`, `RTC_VALID=YES`, `timed_out=false`;
- `GET /api/time` возвращает `TIME 2026-09-30 22:18:58`, `timed_out=false`;
- Developer `PING` возвращает `PONG`, `timed_out=false`.

Вывод: OTA update/boot и ESP↔Nano transport после OTA физически подтверждены. Проводной programmer path далее нужен только как recovery.

## S-L01-APP-002 — Android semantic L01 ON/OFF PASS 2026-09-30

Подтверждение владельца физического стенда после ранее заданного полного checklist: «все pass».

Проверенный пакет включал:
- L01 ON → физическое D6-кольцо и `MODE=L01`;
- L01 OFF → физическое выключение и `MODE=OFF`;
- ещё два повторных ON→OFF цикла;
- закрытие/повторное открытие Android-приложения с reread состояния;
- сохранённый профиль `2700 K / brightness 64`;
- Developer `PING→PONG`.

Вывод: semantic Android L01 ON/OFF на HTTP_BRIDGE_R5 физически закрыт; можно переходить к brightness + Kelvin presets.

## S-L01-APP-003 — R6 brightness/Kelvin physical result 2026-09-30

Данные владельца:
- после OTA `GET /api/ping` → `fw=HTTP_BRIDGE_R6`, `wifi_connected=true`, `ota_ready=true`, RSSI -57 dBm;
- `GET /api/light/status` на момент проверки → L01 ON, Kelvin 2700, brightness 64;
- Android brightness и Kelvin controls работают физически;
- два ручных `curl.exe` JSON POST были отклонены endpoint.

Интерпретация:
- R6 image/OTA/semantic write path физически работает через Android;
- отказ именно двух ручных curl вызовов не доказывает дефект R6 parser, так как Android вызывает тот же endpoint успешно;
- для следующих PowerShell JSON tests использовать `Invoke-RestMethod`, чтобы исключить native-command quoting.

## S-L01-APP-004 — R7 complete L01 profile PASS 2026-09-30

Подтверждение владельца: «R7 весь блок PASS».

Проверенный пакет включал:
- OTA R7;
- arbitrary Kelvin;
- brightness;
- Kelvin presets;
- RGB primary colors;
- explicit startup-profile save;
- cold power-cycle restore;
- возврат baseline `2700 K / brightness 64` и повторное сохранение;
- OFF/ON, Refresh, Developer PING regression.

Вывод: L01 profile/persistence через Android→ESP→Nano→EEPROM физически закрыт.

## 2026-10-04 — owner-approved generated Music room hero asset

- Source: generated visual asset in the owner/assistant design session, then explicitly approved by the owner for the Android Music hero.
- Canonical app file: `05_WiFi_и_приложение/android_app_r1/app/src/main/res/drawable-nodpi/ardu_music_hero.webp`.
- Final prepared size: 640×360 WebP.
- Composition requirement confirmed by owner: sofa visible on the left and compact speaker visible on the right; room context retained.
- This is a presentation asset only; no API/UART/firmware evidence is derived from it.

## 2026-10-05 — direct Wi-Fi and reserve power component sources

### D-100 cancellation note

As of 2026-10-07, all battery/backup-power component candidates in this section (HUSB238, reserve DC/DC, external battery) are **historical only** and are not part of the current ARDU v1 BOM. The ESP8266 SoftAP references remain current for `ARDU-DIRECT`.

### ESP8266 SoftAP API
- Official ESP8266 Arduino documentation: SoftAP supports WPA2-PSK, default/direct IP 192.168.4.1, `softAPConfig`, `softAPIP`, `softAPdisconnect`, and combined `WIFI_AP_STA` mode.
- https://github.com/esp8266/Arduino/blob/master/doc/esp8266wifi/soft-access-point-class.rst
- https://github.com/esp8266/Arduino/blob/master/doc/esp8266wifi/generic-class.rst

### Preferred USB-C PD sink/trigger
- Adafruit HUSB238 USB Type-C Power Delivery Dummy Breakout.
- Fixed jumper configuration supports 15 V and 3 A request without a host MCU.
- https://www.adafruit.com/product/5807
- https://learn.adafruit.com/adafruit-husb238-usb-type-c-power-delivery-breakout

### Preferred reserve 15→5 V regulator class
- Pololu D36V50F5: fixed 5 V, nominal 5.5 A class, input 5.5–50 V, reverse-voltage protection; actual continuous current depends on thermal/input conditions and therefore still requires ARDU load testing.
- https://www.pololu.com/product/4091

### Candidate external battery
- UGREEN Nexode Power Bank 20000 mAh 100 W, SKU 25188.
- Official specification: 72 Wh total; USB-C1 includes 15 V / 3 A PD profile; suitable power class for the ARDU 15-V reserve input.
- https://eu.ugreen.com/de/products/25188

These sources define candidate hardware only. Final acceptance remains a physical ARDU load/temperature/backfeed test.

## 2026-10-05 — final battery-free v1 purchase sources

**Historical note:** backup-power-related parts below were cancelled by D-100 on 2026-10-07. The Mean Well Class II PSU remains current because it is required by the ceiling installation independently of any battery.

### Final mains PSU
- Mean Well IRM-30-5ST official IRM-30 datasheet: 5 V / 6 A / 30 W; IRM-30 entire series = Class II design, no FG pin; ST = screw-terminal style.
- https://www.meanwell.com/Upload/PDF/IRM-30/IRM-30-SPEC.PDF
- German retail confirmation: Reichelt IRM-30-5ST, Isolationklasse II, 5 V / 6 A / 30 W.

### Existing relay candidate
- Songle SRD-05VDC-SL-C datasheet family: 5 V coil; Form C contact rating in the 7 A @ 28/30 VDC class depending exact approved variant.
- This supports candidate use at ARDU 5 V load, but actual INV-051 board/traces/terminals still require physical load/temperature test before ceiling use.

### Reserve PD path
- Adafruit HUSB238 breakout: jumper-configurable PD sink; 15 V selectable, 3 A selected with both current jumpers open.
- Pololu D36V50F5: fixed 5 V output, 5.5 A class; actual continuous output depends on thermal/input conditions.

### Future battery (not purchased for v1)
- UGREEN Nexode 20000 mAh 100 W SKU 25188: 72 Wh, USB-C1 supports 15 V / 3 A.

All mains/relay/DC-DC candidates remain subject to final ARDU two-ring voltage-drop, current and temperature acceptance before ceiling installation.

## 2026-10-08 — Nano Ambient presets lab R1 / first CI evidence

- Исходники: `04_Прошивка/nano_ardu_v1/ambient_preset_probe.h`, `.../tests/ambient_preset_probe_host.cpp`; хранятся в том же репозитории, аппаратной идентификации не требуют.
- Проверка CI: [GitHub Actions Arduino Verify run 37807204353](https://github.com/dronrome1245/ARDU/actions/runs/37807204353), 2026-10-08, full original Nano and experimental full Nano + host tests PASS.
- По тексту CI: baseline 28690/30720 Flash + 1234/2048 globals; probe 29312/30720 Flash + 1234/2048 globals. Это данные компилятора; они **не** подтверждают физические эффекты/температуру/напряжение и не разрешают upload.

## 2026-10-08 — verified IDE-openable full Nano Ambient preview RC1

- [Arduino Verify run 37809369365](https://github.com/dronrome1245/ARDU/actions/runs/37809369365): host tests / source sync / standalone full preview compile / full default Nano compile all PASS; 28690→29376 Flash bytes, globals SRAM 1234 B unchanged. 
- [Compiled HEX artifact 11564965835](https://github.com/dronrome1245/ARDU/actions/runs/37809369365/artifacts/11564965835), ZIP SHA256 from CI: `07fbf048192593c9f093ac4028b0a3bda55e62bbf992b031d78d6e905bb494a2`.
- Документация: `04_Прошивка/AMBIENT_PRESETS_PREVIEW_RC1_TEST.md`. Данные CI не подтверждают прошивку устройства, визуальную приёмку, реальный ток или остаток стека в runtime.

## 2026-10-08 — owner Arduino IDE error and verified single-file Nano RC2

- **Наблюдение владельца:** Windows path `C:\Users\Пользователь\Downloads\nano_ambient_preview_rc1\nano_ambient_preview_rc1.ino:38` → missing `ambient_preset_probe.h`, несмотря на нахождение заголовка в той же папке по сообщению. Скрин/полный компиляторский verbose log не предоставлен — точная причина неизвестна.
- **Source fix:** `04_Прошивка/nano_ambient_preview_rc2/nano_ambient_preview_rc2.ino` без локального заголовка; стандартная Nano v1 сохранена.
- **CI evidence:** [Arduino Verify 37814719230](https://github.com/dronrome1245/ARDU/actions/runs/37814719230) — скетч с **одним** `.ino` в пустом каталоге скомпилирован, host tests и byte-for-byte renderer-source check прошли, 29376 Flash / 1234 globals SRAM. [RC2 HEX artifact 11567275089](https://github.com/dronrome1245/ARDU/actions/runs/37814719230/artifacts/11567275089).

## 2026-10-08 — Full Ambient12 v2 source and CI evidence

- Nano full twelve-scene source `04_Прошивка/nano_ambient12_v1/nano_ambient12_v1.ino`, [Arduino Verify 37818601346](https://github.com/dronrome1245/ARDU/actions/runs/37818601346) compile PASS for initial v2: 29560/30720 Flash and 1282/2048 globals SRAM. [Nano HEX artifact](https://github.com/dronrome1245/ARDU/actions/runs/37818601346/artifacts/11568002897). Later F02/F03 code cleanup has its own CI run (read latest size).
- ESP v2 `05_WiFi_и_приложение/esp8266_ardu_v2/esp8266_ardu_v2.ino`, [ESP CI 37820404281](https://github.com/dronrome1245/ARDU/actions/runs/37820404281) PASS including private-header OTA build and reject-default-password guard; statics 32176/80192 RAM, 60823/65536 IRAM, IROM ≈329096. Protected ARDU-DIRECT and STA-only OTA not physically tested.
- Android `0.22.6-ambient12-functional-rc1`: [CI 37819918951](https://github.com/dronrome1245/ARDU/actions/runs/37819918951) unit contract tests + debug APK PASS, [APK artifact](https://github.com/dronrome1245/ARDU/actions/runs/37819918951/artifacts/11568856875).
- [ARDU_AMBIENT12_RELEASE_CANDIDATE.md](ARDU_AMBIENT12_RELEASE_CANDIDATE.md) contains owner-side physical checks. Compilation does not establish physical upload/LED-current/direct-mode PASS.

## 2026-10-08 — latest Nano Ambient12 optimization CI evidence

- After removing the unneeded legacy F02/F03/auto controls from the **new Nano v2 only**, [Arduino Verify 37820974644](https://github.com/dronrome1245/ARDU/actions/runs/37820974644) **PASS**. Latest full Nano12: **29306/30720 bytes Flash**; globals **1282/2048 SRAM**. Free: 1414 Flash bytes, 766 SRAM bytes for stack/locals; the latter is not an observed worst-case stack measurement. Soft 95% Flash guideline (29184) still exceeded by **122 bytes**.
- [Updated compiled Nano12 HEX 11568284647](https://github.com/dronrome1245/ARDU/actions/runs/37820974644/artifacts/11568284647) replaces the earlier unoptimized artifact for future bench acceptance; both remain Git history, no actual hardware upload in this conversation.

## 2026-10-08 — ESP v2 R2 single INO evidence

[ESP8266 Verify run 37823238584](https://github.com/dronrome1245/ARDU/actions/runs/37823238584) completed successfully. One `esp8266_ardu_v2.ino` copied into isolated directory with **four fake CI values** and compiled without `wifi_secrets.h` or other local headers. Explicit negative test: unchanged placeholders rejected at compile. ESP RAM statics 32256/80192 B (40%), IRAM 60823/65536 (92%), IROM 329096 B. The test does not imply OTA or SoftAP physically works. Local real credentials must never be committed or sent in chat.

## 2026-10-08 — owner physical HTTP confirmation after ESP v2 OTA

Владелец прислал прямой результат запроса ESP `/api/ping`: `ok=true`; `fw=ARDU_ESP_V2_AMBIENT12`; `uart_protocol=1`; `wifi_connected=true`; `network_mode=station`; `softap_active=false`; `ip=192.168.0.4`; `rssi=-57`; `ota_ready=true`; `ota_hostname=ardu`; `ota_port=8266`. **ФАКТ:** физический ESP запустился на новой v2 R2, HTTP/Station работают. Этот запрос **не** подтверждает UART Nano или реальное переключение в ARDU-DIRECT; отдельные измерения ожидаются.

## 2026-10-08 — approved Ambient12 thumbnail artwork source and APK evidence

- Пользователь прислал три утверждённых листа с 12 тематическими картинками, без сцен интерьера: P01…P04, P05…P08, P09…P12. Происхождение и мэппинг описаны в `05_WiFi_и_приложение/AMBIENT12_ARTWORK.md`; сами финальные 12 миниатюр размещены как **реальные WebP Git blobs** в `android_app_r1/app/src/main/res/drawable-nodpi/ardu_preset_p01.webp`..`ardu_preset_p12.webp` (192×192).
- [GitHub commit 4221b5b](https://github.com/dronrome1245/ARDU/commit/4221b5b6d497b2bf32172aec638c1efb92d5f8ae) — файлы и Kotlin/XML mapping. [CI 37838263956](https://github.com/dronrome1245/ARDU/actions/runs/37838263956) confirms presence/RIFF-WEBP headers/12 resource refs, Android unit tests, APK build, [APK artifact 11576287564](https://github.com/dronrome1245/ARDU/actions/runs/37838263956/artifacts/11576287564).
- Это **программное** свидетельство успешной сборки; реальный внешний вид сетки на телефоне будет подтверждён пользователем после `git pull`→Run.

## S-ARDU-2026-10-09 — owner app walkthrough and Android UX regression evidence

- Владелец 2026-10-09 подтвердил, что 12 фото-пресетов загружены в Android, и прикрепил видео `SVID_20261009_092631_1.mp4` в текущем чате. На записи «Нет связи», лента не подключена. Источник — **реальное визуальное представление телефона, не доказательство действительного переключения устройства**.
- Source fixes: `05_WiFi_и_приложение/android_app_r1` Android v0.22.8, D-112; [Android CI source/tests/APK](https://github.com/dronrome1245/ARDU/actions/runs/37930295301). Устройство ESP/Nano/лента этим CI не проверяются.

## S-ARDU-2026-10-09-RC1 — owner v0.22.8 video + source speed diagnosis

- User uploads in current chat `18428313537172 (4).mp4` / `18428313537172 (3).mp4`: verified byte-identical, both SHA256 `c7847fcdead3cc4dc3ec14da6050ce0dbbc525341b095adde63d6c9e12c9ae67`; 4:28,82 screen capture, 578×1280. Device display `Online`, ESP `ARDU_ESP_V2_AMBIENT12`, Nano `ARDU_V2`; app presents 12 P cards and reads settings, including 4500 mA current limit. This is a phone/UI evidence source, not physical LED/current measurement.
- Source `04_Прошивка/nano_ambient12_v1/nano_ambient12_v1.ino` `renderPreset`: dynamics maps into three exact branches `>170`, `<70`, else; sampled 182,190,225 are indistinguishable in output speed. Hardware behavior only reported by user; firmware not modified in Android RC.
- [Android 0.22.9 CI verified](https://github.com/dronrome1245/ARDU/actions/runs/37958078703) checks foreground keepalive/test, service text toggle source, Kotlin/JVM tests and APK. Physical disconnect/reconnect test still pending.

## S-ARDU-2026-10-09-0229 — owner 0.22.9 phone video and Online/Offline result

- Видео владельца `18429670918804.mp4`, файл в переписке 2026-10-09, SHA256 `e98a017f109a29e4c129b5988f36352cdc78277e11418a4898a36f049d7656a6`, примерно 62.98 с, 578×1280. На записи показаны UI «Свет»/«Музыка», состояние «Онлайн», смена быстрых сцен и музыкальных режимов, контрастный текст кнопки запуска.
- Отдельное сообщение владельца: «онлайн офлайн работает» — источник подтверждения фактического автоматического изменения статуса в 0.22.9. В самом видео power-off-переход не показан; точная задержка и независимая проверка не измерены.
- [Android `main` CI PASS](https://github.com/dronrome1245/ARDU/actions/runs/37958705334) для `fb2b9144`; реальная электрическая приёмка двух колец/12 сцен этим не подтверждена.

## S-ARDU-2026-10-09-NANO-R2 — исходник и проверки 256-уровневой скорости

- `04_Прошивка/nano_ambient12_v2/nano_ambient12_v2.ino`: полный самостоятельный Nano Ambient12 scene-speed R2, boot `ARDU1 3`, непрерывный Q16 phase clock, P11 короткий цикл, EEPROM/UART/FHT/Music/Night/Alarm без изменений.
- `04_Прошивка/nano_ambient12_v2/tests/preset_motion_host.cpp`: host test именно извлечённых функций из .ino (клок и 12 рендереров). Профиль [Arduino Verify run 37966945125](https://github.com/dronrome1245/ARDU/actions/runs/37966945125) **PASS**: R1 29306 Flash / 1282 global SRAM, R2 29336 Flash / 1286 global SRAM; прошивка собирается для Arduino Nano ATmega328P Old Bootloader, создан HEX `ardu-nano-ambient12-v2-velocity-rc2`. Test system не измеряет worst-case stack и не доказывает реальное свечение.
- Отдельный owner 44-LED physical test и rollback plan: `04_Прошивка/AMBIENT12_SPEED_R2_TEST.md`. Старый проверявшийся source `04_Прошивка/nano_ambient12_v1` оставлен без изменения.

## S-ARDU-2026-10-09-P11-R3 — owner feedback, clock tuning and CI

- Владелец в текущем чате 2026-10-09: «дыхание классно получилось. на нуле еще чуть чуть можно замедлить». Это direct visual feedback о P11 в предыдущей версии; без видеозамера длительности и без данных о worst-case stack.
- `04_Прошивка/nano_ambient12_v3/nano_ambient12_v3.ino`: полный Nano P11-only R3, boot `ARDU1 4`; только `advancePresetClock(...,bool breathing)` получает `ceil(3*(255-dynamics)/8)` снижение rates для scene P11. При dynamics=0 P11 ~20,2s вместо R2 ~16,4s, при 255 ~4,1s в обоих. Остальные 11 пресетов не изменены, EEPROM/UART/API идентичны.
- `04_Прошивка/nano_ambient12_v3/tests/preset_motion_host.cpp` + [Arduino Verify https://github.com/dronrome1245/ARDU/actions/runs/37971273171](https://github.com/dronrome1245/ARDU/actions/runs/37971273171) PASS: тесты исходных функций из R3, идентичность прежних 12 рендереров, непрерывные 256 rates, полный AVR compile/HEX. R3 **29376/30720 Flash** и **1286/2048 SRAM globals**. Остаток static SRAM нельзя считать измерением stack. Тест на реальной плате R3 ожидается; инструкция `04_Прошивка/AMBIENT12_BREATHING_R3_TEST.md`.

## S-ARDU-2026-10-09-ALL-P-SCENES-R4

- Сообщение владельца: «сделай все сразу. сейчас работает только дыхание» — прямое свидетельство физического UX-дефекта неподвижных P-сцен; не подтверждает fault конкретного UART/ESP.
- Актуальный код Nano R3 `04_Прошивка/nano_ambient12_v3/nano_ambient12_v3.ino`: использование `phase=(uint8_t)(t>>2)` или статических приглушённых градиентов у P01..P10/P12. Один оборот `phase` при dynamics 0..255 примерно 33..131с, в результате многим сценам не хватало заметного движения за несколько секунд.
- Новый полный `04_Прошивка/nano_ambient12_v4/nano_ambient12_v4.ino` и exact-source host test `04_Прошивка/nano_ambient12_v4/tests/preset_motion_host.cpp` — пиксельные эффекты P01..P10/P12; P11 byte-equal to R3. [Nano R4 workflow](https://github.com/dronrome1245/ARDU/actions/runs/37975908088). Без физического видео/измерения с R4 утверждать только программную проверку.

- [Final source/CI Nano R4 run https://github.com/dronrome1245/ARDU/actions/runs/37975908088](https://github.com/dronrome1245/ARDU/actions/runs/37975908088): full one-.ino AVR Nano ATmega328P Old Bootloader compile **29410/30720 Flash, 1286/2048 SRAM globals**; из того же `.ino` извлечены функции для host 44-HSV-LED теста всех 12 сцен. R3 P11 unchanged source gate. P04 refined high-speed signal=487 (9 изменяющихся звёзд), P02/P07 min signal=624. Эффект на реальных WS2812B и запас runtime stack **не определяются** CI.

## S-ARDU-2026-10-09-R4-MOTION-OWNER-PASS

- Отдельное явное сообщение владельца 2026-10-09: «все задвигалось это хорошо. что осталось исправить?» — подтверждение движения всех P-сцен после коррекции Nano R4 **на реальной сборке**, без приложенных в этом сообщении видео, power measurement или точного `ARDU1 5` boot log. Принимать visual motion, но не полный color/EEPROM/stack/current/direct-mode PASS.
- [Arduino Verify main 37976579921](https://github.com/dronrome1245/ARDU/actions/runs/37976579921) PASS, полный Nano Ambient12 R4 29410 Flash/1286 static SRAM, host 44-LED motion checks. Старый полный Nano R3 в репозитории для rollback.

## S-ARDU-2026-10-09-ANDROID-02210-ICON-READBACK

- Запрос владельца в текущем чате: «Хорошо. Измени значок сразу приложения на рабочем столе если возможно» после согласования следующего Android-пакета; визуальная иконка в устройстве ещё не подтверждена.
- `05_WiFi_и_приложение/android_app_r1/app/src/main/AndroidManifest.xml` теперь задаёт `@mipmap/ic_launcher`, `@mipmap/ic_launcher_round`; `res/mipmap-anydpi-v26` — adaptive/round/themed icon, `res/drawable/ardu_launcher_foreground.xml` и `ardu_launcher_monochrome.xml` — точные VectorDrawable ресурсы.
- Source `MainActivity.kt` / `ArduApiClient.kt` / `HttpReadbackPolicy.kt` / `ClapWizardUiPolicy.kt`: безопасный повтор только GET и разделение успешного POST ACK от readback, сохранение dismiss мастера CLAPCAL при Nano finished state.
- [Android Verify https://github.com/dronrome1245/ARDU/actions/runs/37981648045](https://github.com/dronrome1245/ARDU/actions/runs/37981648045) **PASS**: Android 0.22.10 versionCode33, Kotlin tests, photo/launcher resource checks, debug APK artifact `ardu-android-02210-launcher-debug-apk`. Реальное устройство/иконка/HTTP retries и поведение CLAPCAL подтверждаются только последующим phone gate.

## S-ARDU-2026-10-10-ANDROID-02211-USER-VIDEO

- Файл владельца `18437905058452.mp4` (368.98 s, 578×1280) демонстрирует экран Android v0.22.10 в разделах Light, Music и Ambient: старый F01/manual UI, 4 узкие кнопки M05/M08 под слайдерами, похожие quick scenes Вечер/Кино. В записи **нет измерения** LED brightness/heat/voltage и нет доказательства работы нового Android v0.22.11.
- Исходник [Arduino Nano Ambient12 R4](https://github.com/dronrome1245/ARDU/blob/main/04_Прошивка/nano_ambient12_v4/nano_ambient12_v4.ino): Music `cfg.background` — яркость, в `renderVu` и `M05/M08` fixed `HUE_PURPLE`, M03/M04 per-band low/mid/high palette, M09 используется `cfg.speed/aux` для спектра без фона. Самостоятельный music background hue отсутствует в API v1; новая UI-подсказка основана на этом коде.
- [Android Verify https://github.com/dronrome1245/ARDU/actions/runs/38035137524](https://github.com/dronrome1245/ARDU/actions/runs/38035137524) PASS по source `0.22.11-presets-submodes-scene-contrast-rc1` code34 и debug APK. Kotlin`LightQuickScenes` и `MusicBackgroundUiPolicy` определяют truth labels; `SceneTileView.kt` рендерит разный photographic mood. Проверка phone/LED ждёт владельца.

## S-ARDU-2026-10-10-ANDROID-02212-GLOW-DIRECT

- Пользовательское референс-изображение нижней панели (октябрь 2026; пять иконок «Свет», «Музыка», «Фон», «Ночь», «Будильник»), в котором активная вкладка имеет мягкое cyan/mint свечение. Получено в чате, исходный скриншот не загружен в GitHub. Владелец попросил реализовать визуальный приём и сообщил, что проверил v0.22.11, **не указав по каждому пункту физический PASS**.
- Source Android v0.22.12/code35: `NavGlowItemView.kt`, `MainActivity.kt`, `activity_main.xml` и `styles.xml`, Android Verify static nav guard; [GitHub commit](https://github.com/dronrome1245/ARDU/commit/92980e570aa2f80f6c9298c72c34c8686e431085). Не путать успешный source/CI с физическим скриншотом и отзывом владельца после Run.
- Source ESP `esp8266_ardu_v2.ino`: `ARDU_SOFTAP_PASSWORD` WPA2 guard, `startSoftAp()` на `192.168.4.1`, `maintainWifi()` возвращает Station; `ArduApiClient.kt` уже проверяет URL `http://192.168.4.1`. Аппаратный Station→AP→Station тест ещё не выполнен.

- [Android Verify PASS 38046617214](https://github.com/dronrome1245/ARDU/actions/runs/38046617214) — пять равных glow tabs, Kotlin/JUnit unit tests, debug APK `ardu-android-02212-nav-glow-debug-apk` (artifact ID 11668260250). Реальный телефон 0.22.12 и переключение ARDU-DIRECT продолжают ожидать аппаратной проверки.

## S-ARDU-2026-10-10-OWNER-DIRECT-VIDEO

- Пользовательский файл `18442333063828.mp4` (≈106,7 с; 578×1280), просмотрен в чате 2026-10-10. Прямое подключение к Wi-Fi `ARDU-DIRECT` действительно присутствует в настройках Android, статус прямого режима и данные L01 хотя бы один раз появляются, далее показана нестабильность/ошибка данных при ON/OFF. В видео нет separate browser `/api/ping` в момент сбоя, нет ESP serial log, измерения питания или Nano RESET-флагов. Это не доказательство причины ошибки, только предмет регрессионного теста.
- [Исходник Android исправления](https://github.com/dronrome1245/ARDU/commit/a2211723729c039d3ee75bad42f91c1a7ab49169): `DirectConnectionPolicy.kt` с pure Kotlin test, `ArduApiClient` с Wi-Fi Network binding и `MainActivity` с guard команд/heartbeat, `NavGlowItemView` без selected border. [Android CI](https://github.com/dronrome1245/ARDU/actions/runs/38048024255) требует full Gradle PASS и последующего теста владельца.

- [Android Verify 38048024255](https://github.com/dronrome1245/ARDU/actions/runs/38048024255) **PASS**: static direct route/glow checks, Kotlin/JUnit, debug APK `ardu-android-02213-direct-borderless-debug-apk` (artifact ID 11668866174). Результат JUnit/build не подтверждает физический ARDU-DIRECT и не снимает наблюдение о сбоях из видео владельца.

## S-ARDU-2026-10-10-WARM-DAWN-LAST-DIRECT

- Присланный владельцем реальный JSON `GET /api/ping` содержит `fw:ARDU_ESP_V2_AMBIENT12`, `network_mode:softap`, `softap_active:true`, `ip:192.168.4.1`, `ota_ready:false`. Присланный `GET /api/status`: `nano_fw:ARDU_V2`, `mode:dawn`, `rtc_valid:true`, `ambient_preset_selected:P11`, `current_limit_ma:3025`. Это подтверждает ответ ESP/Nano **во время отдельных запросов**, но не стабильный поток без ошибок. Точное происхождение случайных TCP/Nano timeout не установлено.
- Владелец приложил `18442952444564.mp4` (≈92с) и `18442850863764 (1).mp4` (≈61с) и попросил убрать glow seam и закончить одну последнюю Direct-итерацию, затем перейти к штатному режиму при неуспехе.
- Исходные ESP V3 (WiFi softAP clients hold and Kelvin capability), Nano R5 (warm range 1800–4000K), Android 0.22.15 (4 scenes and partial direct GET fallback). [Nano CI](https://github.com/dronrome1245/ARDU/actions/runs/38050231423), [ESP CI](https://github.com/dronrome1245/ARDU/actions/runs/38050334769), [Android CI](https://github.com/dronrome1245/ARDU/actions/runs/38050719704) все прошли. Физического upload или phone/hardware acceptance ассистент не выполнял; точная инструкция `RELEASE_WARM_DAWN_DIRECT_ACCEPTANCE.md`. Важный safety флаг: 3025 mA чуть выше рекомендуемого ≤3000 до теста двух колец.

## S-ARDU-2026-10-10-OWNER-RING-B-3-WIRES

- Сообщение владельца: «все получилось. давай перейдем к монтажу второго кольца. у меня есть три провода 1х1,5мм2. Хочу сразу соединить потом монтаж на потолок.» Это **свидетельство наличия трёх проводов с номинальным сечением** и общего успеха предыдущего функционального этапа, не доказательство конкретного LED/Direct/силового PASS.
- [Finalization physical topology](FINALIZATION_PLAN.md): ≈2 м, отдельно D6/D7, три сигнала +5V/GND/DATA второго корпуса, запрет питать Open-frame S-30-5 без PE на потолке.
- [`02_Архитектура_и_решения/RING_B_44LED_МОНТАЖ_И_ПРОВЕРКА.md`](02_Архитектура_и_решения/RING_B_44LED_МОНТАЖ_И_ПРОВЕРКА.md) — рекомендуемая схема Ring B и последовательность низковольтной приёмки; не подтверждает, что пользователь её реализовал.

## S-NANO-OTA-001 — официальные основания remote Nano programming, 2026-10-17

- Arduino `ArduinoCore-avr/boards.txt`: `nano.menu.cpu.atmega328old` использует `upload.protocol=arduino`, `upload.maximum_size=30720`, `upload.speed=57600`, bootloader `ATmegaBOOT_168_atmega328.hex`. Источник: `https://github.com/arduino/ArduinoCore-avr/blob/master/boards.txt`.
- AVRDUDE 8.0 documentation: для serial-программаторов `-P net:host:port` создаёт TCP connection к terminal/console server, который прозрачно соединяет network stream с serial programmer. Источник: `https://avrdudes.github.io/avrdude/8.0/avrdude_4.html`.
- White Adapter / ESP8266 pin references: GPIO4/GPIO5 являются обычными GPIO, в отличие от boot strap GPIO0/GPIO2/GPIO15; существующая white adapter routes ESP-12 signals to headers. Источники уже зафиксированы как S-010/S-011; дополнительная pin table: `https://homeding.github.io/boards/pins.htm`.

Эти источники определяют software/protocol assumptions. Фактическая транзисторная RESET-цепь и первый remote flash Nano остаются hardware gate.

## Дополнение D-127 — ESP8266 Arduino core WiFiClient / HardwareSerial transport contract

Официальный upstream ESP8266 Arduino core:
- `https://github.com/esp8266/Arduino/blob/master/libraries/ESP8266WiFi/src/WiFiClient.cpp` — `WiFiClient::write()` возвращает `size_t` фактически переданных байт; доступен `availableForWrite()`.
- `https://github.com/esp8266/Arduino/blob/master/cores/esp8266/HardwareSerial.h` — `HardwareSerial::read(buffer,size)` является чтением без timeout, `write()` возвращает число принятых байт, доступен `availableForWrite()` и настройка RX buffer.

Использовано в D-127, чтобы TCP↔UART bridge не предполагал, что один вызов `write()` всегда принимает весь буфер.

## S-096 — Nano R6 remote-programming diagnostics 2026-10-17

Пользовательские аппаратные логи: R2 upload Nano R6 (`29 722 B`) дважды достигал write 100%, но полный verify терял STK500 sync; verify-only в отдельном сеансе достигал 48%, эксперимент с 64-byte page — 7%. После power-cycle нормальный API восстановился. Reset-only через GPIO4 дал `�ARDU1 7` и `V 9 1`, физически подтверждая запуск FW_REV7.

Для диагностики ESP8266 Arduino Core использованы официальные `HardwareSerial::hasOverrun()` / `hasRxError()`; нижний UART HAL документирует их как return-and-clear flags. Источники: `https://github.com/esp8266/Arduino/blob/master/cores/esp8266/HardwareSerial.h`, `https://github.com/esp8266/Arduino/blob/master/cores/esp8266/uart.h`.
