dronrome1245/ARDU/02_Архитектура_и_решения/RING_B_44LED_МОНТАЖ_И_ПРОВЕРКА.md

# ARDU — кольцо B, 44 WS2812B: подключение до потолочного монтажа

**Дата:** 2026-10-10. **Статус:** владелец **2026-11-07 сообщил о подключении** второго кольца. Физический **PASS** (питание, напряжение, свечение, отсутствие нагрева и безопасность БП) ещё **не подтверждён**. Действующая Nano R6 уже поддерживает 2×44 D6/D7; программной модификации не требуется.

## Подтверждено / ещё неизвестно

- **ФАКТ:** Nano D6 — кольцо A, D7 — кольцо B; `LED_COUNT=44` на каждом, прошивка Nano R5 использует общий кадр, два FastLED выхода, управление готово без нового скетча.
- **ФАКТ:** расстояние между круглыми корпусами около **2 м** (`FINALIZATION_PLAN.md`); к корпусу A приходит существующая потолочная 230В проводка 2×2,5 мм²; у потолочной точки **нет PE**.
- **ФАКТ со слов владельца:** три отдельных провода `1×1,5 мм²` для новой низковольтной трассы A→B.
- **НЕ ПОДТВЕРЖДЕНО:** длина каждого провода с монтажным запасом (~3 м при типовом обходном пути), медь/материал, моножила либо гибкий провод, цвета/изоляция, сечение коротких переходов, клеммы, наличие **второго** 220–470 Ω резистора, **второго** 1000 µF конденсатора, приобретение Class II БП, предохранители, силовые измерения.

## Соединение исключительно постоянного напряжения 5 В

**Электрический тип: ПАРАЛЛЕЛЬНЫЙ ПОДВОД ПИТАНИЯ К КАЖДОМУ КОЛЬЦУ, независимые DATA.**

```text
Безопасный изолированный БП 5 В (V+ / V-)
     +5V ──┬─────────── кольцо A +5V  [44 LED]
           ├── жила №1 ────────┬── кольцо B +5V (вход)
           │                   └── кольцо B +5V (конец, по желанию)
           └── +5V Nano / другое оборудование существующей схемы

     GND ──┬─────────── кольцо A GND
           ├── жила №2 ────────┬── кольцо B GND (вход)
           │                   └── кольцо B GND (конец, по желанию)
           └── GND Nano/ESP/RTC/MAX9814 (общая земля)

     Nano D6 ── [уже существующий 220Ω] ──► DIN кольцо A
     Nano D7 ── [отдельный 220–470Ω] ── жила №3 ──► DIN кольцо B

     Кольцо A DOUT последнего LED ── НЕ СОЕДИНЯТЬ с кольцом B.
     Кольцо B DOUT последнего LED ── НЕ СОЕДИНЯТЬ обратно с DIN.
```

- Резистор 220–470 Ω (в утверждённом стенде **220 Ω**) должен стоять **последовательно с D7 возле Nano**, а не вместо GND, не в питание и не параллельно DATA.
- Жилы №1 и №2: независимо от Ring A, но от **одного** выходного узла 5В/GND. Не питать длинную ветвь через тонкие медные дорожки первого кольца и не соединять B после A по DATA.
- Жилу №3 (DATA D7) вести непосредственно рядом с GND жилой №2 в защищённом пучке/трассе. Отдельные одинарные проводники надо механически защитить, учитывать требования монтажа и изоляции. Не прокладывать вместе с 230 В и не использовать ранее существующую 230-вольтовую жилу под DATA.
- Если провода толстые/жёсткие, **не припаивать 1,5 мм² напрямую к маленьким LED-площадкам** без снятия механического натяжения: короткие подходящие гибкие проводники от `+5V`, `GND`, `DIN`, соединение с магистралью на рассчитанных клеммах, все медные части изолировать, закрепить от перегиба/отрыва к корпусу. Не оставлять подвешенную тяжёлую жилу на пайке.
- Допустимо параллельно соединить +5V/GND у начала и конца **одной и той же** 44-пиксельной ленты кольца B, поскольку они физически рядом. **DATA только в первый DIN**, по стрелке направления сегмента.
- Возле входа питания кольца B предпочтителен электролит `~1000 µF` на `≥6,3 В` (лучше 10В при покупке) **ПАРАЛЛЕЛЬНО** между `+5V` и `GND`, плюс конденсатора на +5V, полоса/минус — на GND; **никогда последовательно** с питанием.

## До первого включения

1. Полностью снять питание **всей системы**, включая USB Nano; не работать с оголёнными контактами при подключённой сети. Старую 230В линию второго корпуса должен безопасно обесточить, разъединить и оконцевать квалифицированный электрик.
2. На двух концах маркировать три жилы (+5V красная, GND чёрная, DATA синяя метки). Если фактически провод желто-зелёный — **не использовать его для +5V или DATA** (назначение защитного PE).
3. Прозвонить каждую жилу от конца до конца, убедиться в отсутствии перепутанных проводников и устойчивого замыкания +5V→GND, DATA→+5V/GND. Проверять при снятом питании; кратковременный отклик из-за зарядки электролита не путать с постоянным КЗ.
4. Проверить, что DATA подключена к **DIN**, не DOUT, резистор на D7 отдельный и находится возле Nano. Полярность электролита и +5/GND проверить визуально и мультиметром.
5. Установить через приложение лимит суммарного тока **≤500 мА** для первого включения от надлежащего низковольтного изолированного БП. В прежнем JSON владельца было 3025 мА: перед двухкольцевым тестом гарантированно вернуть ≤3000 мА.
6. Подать питание и проверить на малой яркости оба кольца (первые/последние 44 LED), общий L01 ON/OFF, P11 и другие фоновые сцены. Плата и ESP не должны перезапускаться, B не должен хаотически менять пиксели.
7. Постепенно увеличивать яркость/лимит при контроле мультиметром **только постоянного 5В** на выходе БП и непосредственно на +5V/GND **у B**, сравнивать с A и искать просадку. По возможности измерять реальный общий ток в соответствии с характеристиками прибора; держаться **≤3000 мА** до силового gate и не рассчитывать на software cap как единственную защиту от КЗ.
8. Длительный прогон 15–30 минут, проверить температуру проводов, контактов, блока питания и самих лент; не должно быть запаха, локального нагрева клемм, падения напряжения, мерцания B или ошибок ESP. Проверить L01, Music Mxx, P01/P11, Night и Dawn STOP.
9. Отдельно проверить отказостойкость двух DATA каналов на **обесточенном** стенде: отсоединить B DATA, затем включить — A должна работать сама; после отключения питания вернуть DATA B. Не переподключать DATA на работающей ленте.

**PASS:** 44+44 загораются синхронно; D6/D7 независимы; 5В у обоих корпусов в допустимых пределах без заметной просадки; клеммы и провода не нагреваются; есть механическая разгрузка, нет перепутанной полярности и случайных SHORT; результаты измерений/времени и фото подключения сохранены.

## Жёсткая граница перед потолочным монтажом

У владельца **нет PE** в потолочном выводе. Металлический открытый `S-30-5` с клеммой `⏚` остаётся **только для соответствующего требованиям заземления защищённого стенда**, **не для потолка**. `N` сети не превращать в PE, запрещено выдумывать «землю» из нуля. Целевой источник для потолка по BOM — **Class II / double insulated 5В 6А** (Mean Well IRM-30-5ST как ранее выбранный кандидат; факт покупки пока отсутствует). Его сетевые клеммы также требуют закрытого безопасного корпуса и крепления; нужен доступ для обслуживания, механическая защита низковольтной линии, допустимые клеммы и разделение с прежней 230В проводкой.

До подтверждения источника класса II, безопасного отключения старой 230В линии B и физического двухкольцевого теста **корпуса не поднимать на потолок**.

## Данные, которые нужны от владельца перед окончательным способом оконцевания

- длина **каждой** из трёх жил и моножила это или гибкий многопроволочный провод;
- цвет/маркировка, изоляция, есть ли защитный рукав/канал;
- фото точек +5V/GND/DIN на кольце B и доступных клемм;
- куплен ли финальный Class II блок питания 5В ~6А (не открытый S-30-5).

**Прошивку менять не нужно:** действующая полная Nano R5 поддерживает зеркальный второй канал D7, `LED_COUNT=44`. Этот документ — план монтажа, а не утверждение о выполненной пайке или разрешении на сетевой монтаж.
