dronrome1245/ARDU/02_Архитектура_и_решения/NANO_REMOTE_FLASH.md

# Удалённая прошивка Arduino Nano через ESP8266 — R3 DIAG

Дата: 2026-10-17  
Статус: **аппаратный Wi-Fi Nano upload PASS (2026-11-07)**: ESP V4 R3 DIAG, AVRDUDE write+byte-for-byte verify 29 378 B, post-session `/api/status` PASS. Night D-125 функционально ещё не принят.

## 1. Что реализовано

ESP `ARDU_ESP_V4_NANO_REMOTE` остаётся обычным HTTP/UART шлюзом и получает сервисный режим удалённой прошивки Nano. После авторизации ESP на 30 секунд разрешает TCP-соединение только с того IP, который выполнил arm-запрос. При подключении `avrdude` ESP переключает общий UART с 115200 на 57600, аппаратно сбрасывает Nano в её штатный Old Bootloader и прозрачно передаёт байты `avrdude ↔ Nano`. После завершения TCP-сессии ESP возвращает UART 115200.

Формат HEX, запись Flash и verify выполняет стандартный AVRDUDE, а не самодельный flash-parser ESP. Для фактической Nano проект уже подтверждал `ATmega328P (Old Bootloader)`; официальный Arduino AVR `boards.txt` задаёт для него `protocol=arduino`, `upload.speed=57600`, `maximum_size=30720`.

## 2. Дополнительная reset-цепь

**Тип соединения:** ESP управляет RESET Nano **через NPN-транзистор как открытый коллектор**. Nano RESET напрямую к GPIO ESP не подключать: RESET Nano подтянут в 5-вольтовом домене, а ESP8266 не является 5-V tolerant.

```text
ESP GPIO4 ── 1.5 kΩ ──┬──► B  BC548
                       │
                     4.7 kΩ
                       │
GND ESP/Nano ──────────┴──► E  BC548

Nano RESET ─────────────────► C  BC548
```

- `GPIO4 LOW` → транзистор закрыт → Nano работает от штатной RESET pull-up;
- `GPIO4 HIGH` → транзистор открыт → RESET притянут к GND;
- 4.7 kΩ B→GND удерживает транзистор выключенным во время старта ESP;
- земли ESP и Nano уже должны быть общими по рабочему UART;
- точный порядок физических ножек `C/B/E` конкретного BC548 перед пайкой сверить по маркировке/даташиту экземпляра, не угадывать по форме корпуса.

GPIO4 выбран потому, что текущая ESP V3 его не использует, а у ESP-12 он не является boot strap pin. GPIO0/GPIO2/GPIO15 для этой функции не используются.

## 3. Сервисный API

`GET /api/ping` дополнительно:

```json
{"nano_remote_flash":true,"nano_program_port":3280,"nano_program_baud":57600}
```

`GET /api/system/nano-program/status` возвращает `supported/active/armed/port/baud/reset_gpio/last_result`.

`POST /api/system/nano-program/arm`:

```json
{"password":"CURRENT_ESP_OTA_PASSWORD"}
```

Ограничения: только домашний Station; пароль совпадает с локальным `ARDU_OTA_PASSWORD`; ARDU-DIRECT не разрешает программирование Nano; arm действует 30 s и привязан к IP компьютера.

## 4. Прошивка с Windows

В репозитории: `tools/flash_nano_over_wifi.ps1`. Скрипт сам находит AVRDUDE из Arduino IDE, спрашивает текущий OTA-пароль без вывода на экран, arm-ит ESP и запускает стандартную запись + verify через `-P net:<IP>:3280`.

Пример:

```powershell
cd C:\ARDU
.\tools\flash_nano_over_wifi.ps1 `
  -HexPath .\path\to\nano_warm_dawn_v6.ino.hex `
  -DeviceIp 192.168.0.4
```

Во время удалённой прошивки Nano USB-кабель не подключать. Питание ARDU не выключать и Wi-Fi не переключать. Если TCP/upload оборвался, повторно выполнить arm и запуск скрипта: аппаратный GPIO4→RESET позволяет снова войти в bootloader даже при повреждённом приложении Nano.

## 5. Первый физический gate

1. При снятом питании собрать транзисторную RESET-цепь.
2. Проверить мультиметром отсутствие прямого соединения Nano RESET↔ESP GPIO4 без резистора/транзистора.
3. Включить ARDU, проверить обычный `/api/status`.
4. OTA установить ESP V4 и убедиться, что `/api/ping` содержит `nano_remote_flash:true`.
5. Первый раз удалённо записать Nano R6 HEX скриптом.
6. После verify проверить `/api/status`, `/api/settings`, `/api/time`, L01 и Night.
7. Не считать механизм полного remote-flash hardware-PASS до первого реального write+verify+post-status.

## 6. Физическая проверка RESET — PASS, 2026-10-17

Владелец установил ESP V4 по ArduinoOTA и получил `/api/ping` с `fw:"ARDU_ESP_V4_NANO_REMOTE"`, `nano_remote_flash:true`, `nano_program_port:3280`, `nano_program_baud:57600`.

После успешного `POST /api/system/nano-program/arm` (`armed:true`) тестовое TCP-подключение к порту 3280 вызвало аппаратный reset Nano через GPIO4/BC548. До reset Nano сообщала `uptime_ms=890258`; через ~10 секунд после теста — `uptime_ms=9488`. `/api/status` снова отвечал штатно, RTC оставался valid, а `/api/system/nano-program/status` вернул `active:false`, `armed:false`, `last_result:"disconnected"`. В `/api/events` появился `warm_reset` (code 9); перед `ARDU1 6` наблюдался один нечитаемый байт на границе переключения UART, что не помешало восстановлению протокола.

**Вывод:** физическая reset-цепь `ESP GPIO4 → 1.5 kΩ → BC548 B`, `4.7 kΩ B→GND`, `E→GND`, `C→Nano RESET` подтверждена на собранном устройстве. Следующий gate — первый реальный `avrdude write + verify` Nano R6 по Wi-Fi и post-flash `/api/status`.

## 6. Physical gate 2026-10-17 / R2 transport fix

Фактический reset через GPIO4/BC548 подтверждён (`uptime_ms` 890258 → 9488). Первый AVRDUDE upload распознал ATmega328P и записал 29 722 B до 100%, но verify потерял STK500 `0x14` примерно на 22%. Поэтому firmware не считается принятой. V4 R2 заменяет one-shot UART/TCP writes на complete-write loops, использует `availableForWrite()`, неблокирующий `HardwareSerial::read` и 512-B programming RX buffer. `-V` не использовать. Критерий PASS остаётся: полный write + полный verify + `/api/status` после возврата UART 115200.

## R3 DIAG — локализация нестабильного verify (2026-10-17)

Физические тесты R2 показали, что полный write устойчиво доходит до 100%, тогда как длинный Nano→ESP→TCP readback verify падает в непостоянной точке (около 1/7/22/48%). Отдельный verify-only исключил переход write→verify; 64-byte page test не устранил ошибку. R6 при этом физически запускается (`ARDU1 7`).

R3 DIAG не ослабляет критерий PASS и не отключает verify. В `/api/system/nano-program/status` после сеанса сохраняются: `uart_overrun`, `uart_rx_error`, `tcp_to_uart_bytes`, `uart_to_tcp_bytes`, `max_uart_available`, `max_tcp_available`, `uart_rx_buffer_size`. Следующий тест — verify-only и немедленное чтение этих полей.

## 2026-11-07 — безопасная проверка уже установленной Nano R6

В `tools/flash_nano_over_wifi.ps1` добавлен `-VerifyOnly`: стандартный AVRDUDE сравнивает содержимое Nano с переданным R6 HEX через `flash:v`, **не выполняя запись**. Скрипт после завершения AVRDUDE (включая FAIL) запрашивает `/api/system/nano-program/status` и выводит latched `uart_overrun`, `uart_rx_error`, TCP/UART byte counters и максимальные очереди. После успешного verify он отдельно требует восстановления `/api/status`.

```powershell
cd C:\ARDU
.\tools\flash_nano_over_wifi.ps1 `
  -HexPath ".\04_Прошивка\nano_warm_dawn_v6\nano_warm_dawn_v6.ino.hex" `
  -DeviceIp 192.168.0.4 -VerifyOnly
```

Это **следующий тест после OTA установки ESP `ARDU_ESP_V4_NANO_REMOTE_R3_DIAG`**, а не доказательство, что он уже выполнен. До получения диагностики R3 Nano не перезаписывать. Функциональный сценарий D-125 и критерии hardware PASS: `04_Прошивка/NIGHT_R6_WIFI_ACCEPTANCE.md`. Отсутствие ошибок при verify-only подтверждает путь чтения, но не полный write+verify нового обновления.

## 2026-11-07 — R3 DIAG physical verify-only: чтение восстановлено, сравнение FAIL

На устройстве реально установлена ESP `ARDU_ESP_V4_NANO_REMOTE_R3_DIAG`. Первый `-VerifyOnly` со вновь собранным R6 HEX прочитал 29378 B (AVRDUDE Reading 100% за 11.29 с) без потери STK500 sync. R3: `uart_overrun=false`, `uart_rx_error=false`, RX 512 B, TCP→UART 2129 B, UART→TCP 30398 B, max TCP=22, max UART=114. Дальнейший verify сообщил **flash verification mismatch** уже на `0x002e`; локальная сборка 29378 B отличается по размеру от ранее записанного HEX 29722 B. Неизвестно, были ли эти HEX побайтово идентичны; причины расхождения пока не установлены. Это успешный полный сеанс чтения, **не успешная верификация** прошивки. Поскольку PowerShell остановился исключением после AVRDUDE, восстановление `/api/status` нужно отдельно проверить. Запись Nano не выполнялась. Следующий шаг — статус/RTC и функциональные тесты Night, без перезаписи.

## 2026-11-07 — D-127 / Nano remote flash hardware PASS

Подтверждён успешный штатный вызов `tools/flash_nano_over_wifi.ps1` **без** `-VerifyOnly`: ESP V4 R3 DIAG, ATmega328P old bootloader, 57600 baud, AVRDUDE 8.0-arduino.1; `Writing 100%` за 13.92 с, `Reading 100%` за 12.47 с, **`29378 bytes of flash verified`**. UART `overrun=false`, `rx_error=false`, RX buffer=512, TCP→UART=33648, UART→TCP=31450, max TCP=133, max UART=102, `last_result=disconnected`, `active=false`. `/api/status` восстановлен, `mode=light`, `rtc_valid=true`, `current_limit_ma=3000`. **D-127 технический gate записи + verify + восстановления приложения выполнен.** Требуется отдельная приёмка поведения Night D-125; снятие Nano не потребовалось.
