dronrome1245/ARDU/02_Наши_детали/ИНВЕНТАРЬ.md

# Инвентарь имеющихся компонентов

Дата последнего обновления: 2026-09-05

Это реестр **того, что физически есть у владельца**. Он не равен BOM финальной лампы: ненужные для ARDU детали тоже сохраняются здесь.

Обозначения:

- ✅ идентификация уверенная;
- 🔵 нужно проверить номинал/исправность/точную модификацию;
- `основа` — кандидат в финальную лампу;
- `стенд` — полезен при разработке;
- `резерв` — пригодится только при альтернативной схеме;
- `не нужен` — не требуется базовой архитектуре ARDU.

## Контроллеры и связь

| ID | Компонент | Кол-во | Основание | Роль ARDU | Статус |
|---|---|---:|---|---|---|
| INV-001 | Arduino Nano, ATmega328P, Mini-USB | ≥1 | фото, маркировка MCU + стендовый upload 2026-09-20 | резерв / стенд / programmer bridge | ✅ есть; Arduino IDE: `ATmega328P (Old Bootloader)` |
| INV-002 | Arduino Nano-совместимая плата, ATmega328P, USB-C | ≥1 | фото, маркировка MCU + подтверждение владельца 2026-10-05 | текущий основной Nano; USB-C только service/programming | ✅ основа / текущая сборка |
| INV-003 | ESP8266MOD AI-THINKER на белой переходной плате | 1 | ранее предоставленные фото | Wi‑Fi-шлюз | ✅ основа, питание/прошивку проверить |
| INV-004 | Bluetooth HC-05 | 1 | фото лицевой и обратной стороны, подписи `+5V GND TX RX STATE`, `LEVEL:3.3V` | резервный транспорт | ✅ резерв |
| INV-005 | W5500 Ethernet module | 1 | фото, маркировка платы | проводная сеть | ✅ не нужен базовой версии |

Повторные крупные планы Mini-USB Nano в текущей партии не увеличивают количество: считается тот же класс платы, пока владелец явно не подтвердит отдельный экземпляр.

## Свет, звук, время

| ID | Компонент | Кол-во | Основание | Роль ARDU | Статус |
|---|---|---:|---|---|---|
| INV-010 | Адресная лента WS2812B | 1 отрезок/комплект | ранее предоставленные материалы | световая часть | ✅ основа; длину/LED посчитать |
| INV-011 | MAX9814 microphone amplifier module | 1 | новые крупные фото лицевой/обратной стороны, маркировка `MAX9814`, `AGC Mic Amp` | основной микрофон комнаты | ✅ основа |
| INV-012 | DS3231 RTC module с AT24C32/совместимой EEPROM и держателем элемента CR2032 | 1 | новые фото обеих сторон, маркировка `DS3231`, пины `SCL SDA VCC GND`, батарея `CR2032` | будильник-рассвет | ✅ основа/поздний этап; цепь батареи проверить до питания |
| INV-013 | Выводные LED 5 мм, разные цвета | пакет | фото | индикаторы стенда | ✅ стенд/резерв |
| INV-014 | Зуммер, тип не установлен | 1 | фото | опциональный звуковой сигнал будильника | 🔵 проверить active/passive и напряжение |
| INV-015 | MAX4466 microphone amplifier module с подстроечником | 1 | фото лицевой/обратной стороны, маркировка `MAX4466`, `VCC 2.4–5.5V`, `Adjustable gain` | альтернативный микрофон без AGC | ✅ резерв/сравнительный стенд |

### Примечания по микрофонам

На MAX9814 на плате читается:

- `Gain float -> 60dB`;
- `G=Gnd -> 50dB`;
- `G=Vdd -> 40dB`;
- `Output 2Vpp max`;
- `DC Offset: 1.25V`;
- пины `AR / Out / Gain / Vdd / GND`.

MAX4466 имеет ручной подстроечник усиления и подписи `VCC / GND / OUT`.

Для базовой архитектуры пока сохраняется MAX9814, потому что проект изначально построен вокруг него. MAX4466 не назначать заменой без сравнительного теста и отдельного решения.

### Важная проверка DS3231

В держателе установлен элемент **CR2032**. До подачи питания на RTC-модуль определить, есть ли на конкретной плате цепь подзаряда резервного элемента. Не заряжать CR2032 как аккумулятор.

2026-09-26: по D-017 зарядная цепь уже идентифицирована; требуется удалить резистор `201`. Выполнение удаления пока **не подтверждено**. RTC R1 test подготовлен, но штатное питание модуля с установленной CR2032 до этого запрещено.

## Питание и пассивные компоненты

| ID | Компонент | Кол-во | Основание | Роль ARDU | Статус |
|---|---|---:|---|---|---|
| INV-020 | БП S-30-5, 5 В 6 А 30 Вт | 1 | новое фото шильдика: `MODEL S-30-5`, `DC OUTPUT: 5V 6A`, `AC INPUT: 110/220V ±15%` | питание WS2812B/системы | ✅ основа; выход и безопасность сетевой части проверить |
| INV-021 | YP-8, AMS1117-3.3 | 1 | фото + читаемая маркировка | возможное 3,3 В питание ESP8266 на стенде | 🔵 проверить 3,3 В, просадку и нагрев |
| INV-022 | Электролитические конденсаторы, смешанный пакет | ≥4 | фото | фильтрация питания | 🔵 номиналы не всех читаются |
| INV-023 | Электролит 1000 мкФ 6,3 В | ≥1 | маркировка прочитана владельцем 2026-09-20 | буфер по питанию WS2812B | ✅ подходит для линии 5 В |
| INV-024 | Малые керамические/монолитные конденсаторы | несколько | фото | развязка/фильтрация | 🔵 определить номиналы по маркировке/измерению |
| INV-025 | Потенциометр B10K | 1 | фото `B10K` | ручная настройка/стенд | ✅ опционально |
| INV-026 | Электролитический конденсатор 1 мкФ | 10 шт. | пакет с подписью `Конденсатор электролитический 1 мкФ 10 шт.` | аудиотракт ColorMusic v2.10: C1 Out→A2 | ✅ есть; перед установкой подтвердить ≥6,3 В |
| INV-027 | Электролитический конденсатор 100 мкФ | 3 шт. | пакет с подписью `Конденсатор электролитический 100 мкФ 3 шт.` | питание/фильтрация | ✅ есть; рабочее напряжение не подтверждено |
| INV-028 | Резистор 1,5 кОм | 10 шт. | пакет с подписью `Резистор 1,5 кОм 10 шт.` | делители/стенд | ✅ есть |
| INV-029 | Резистор 4,7 кОм | 10 шт. | пакет с подписью `Резистор 4,7 кОм 10 шт.` | подтяжки/стенд; для A2/A3 ColorMusic не используется | ✅ есть |

## Дискретные полупроводники

| ID | Компонент | Кол-во | Основание | Роль ARDU | Статус |
|---|---|---:|---|---|---|
| INV-060 | BC548 NPN transistor | 10 шт. | пакет с подписью `Транзистор BC548 10 шт.` | ключ/индикаторы/стенд | ✅ резерв/стенд |
| INV-061 | Диод 1N4148 | 10 шт. | пакет с подписью `Диод 1N4148 10 шт.` | малосигнальные цепи/защита | ✅ резерв/стенд |

## Макетирование и кабели

| ID | Компонент | Кол-во | Основание | Роль ARDU | Статус |
|---|---|---:|---|---|---|
| INV-030 | Полноразмерная breadboard | ≥1 | фото | стендовые тесты | ✅ стенд |
| INV-031 | USB A ↔ Mini-B кабель | 1 | фото | прошивка Mini-USB Nano | ✅ стенд |
| INV-032 | Соединительные провода с разъёмами Dupont/аналогичными | количество не зафиксировано | видны на новых фото в коробке | макетирование | 🔵 наличие видно, типы и количество посчитать позже |
| INV-033 | Резистор 220 Ом | ≥1 | подготовлен владельцем 2026-09-20 | DATA WS2812B FW-1 | ✅ стенд/основа |

## Дисплей и расширители

| ID | Компонент | Кол-во | Основание | Роль ARDU | Статус |
|---|---|---:|---|---|---|
| INV-040 | МЭЛТ MT-16S2H v.7, LCD 16×2 | 1 | фото маркировки | диагностический дисплей | ✅ стенд, в финальную лампу не нужен |
| INV-041 | I2C LCD backpack на PCF8574/совместимом чипе | 1 | фото платы | I2C-подключение LCD | ✅ стенд |
| INV-042 | PCF8574A DIP | 1 | фото маркировки | I/O expander | ✅ резерв/стенд |

## Датчики и реле, не относящиеся к базовой лампе

| ID | Компонент | Кол-во | Основание | Роль ARDU | Статус |
|---|---|---:|---|---|---|
| INV-050 | HC-SR04 | 1 | фото | ультразвуковой дальномер | ✅ не нужен базовой версии |
| INV-051 | Релейный модуль 5 В, SRD-05VDC-SL-C | 1 | фото | коммутация нагрузки | ✅ не нужен базовой версии |
| INV-052 | TIANBO HJR1-2C L-12V, реле 12 В 2CO | ≥1? | фото маркировки | отдельное реле | 🔵 наличие/количество подтвердить; для ARDU не требуется |

## Что эта партия уже закрывает или почти закрывает

1. **RTC физически подтверждён.** DS3231 с резервным элементом реально есть.
2. **Оба микрофонных варианта физически есть.** Покупать новый микрофон сейчас не требуется.
3. **БП 5 В 6 А 30 Вт физически подтверждён по шильдику.** Его достаточность зависит от фактического числа WS2812B и ограничения яркости.
4. **Для согласования Nano TX 5 В → ESP8266 RX 3,3 В уже есть резисторы 1,5 кОм.** Возможен делитель: 1,5 кОм сверху и 3,0 кОм снизу, где 3,0 кОм собирается из двух 1,5 кОм последовательно. Это пока кандидат схемы; перед ESP8266 проверить фактическое выходное напряжение мультиметром.
5. **4,7 кОм** пригодятся для подтяжек и стендовых I2C/логических цепей, если они действительно потребуются.
6. Электролиты 1 мкФ и 100 мкФ закрывают часть фильтрующих номиналов; 1000 мкФ всё ещё требует подтверждения рабочего напряжения.

## Что всё ещё не подтверждено

- резистор 220–470 Ом для DATA WS2812B;
- наличие 100 нФ развязочных конденсаторов как подтверждённого номинала;
- фактическое количество и типы Dupont-проводов;
- способ прошивки ESP8266;
- выход и стабильность YP-8 под нагрузкой;
- число светодиодов WS2812B;
- напряжение электролита около 1000 мкФ;
- исправность всех модулей после хранения.

## Правило дальнейшего пополнения

Каждую новую деталь по фото заносить сюда до выводов о закупке. Если одна и та же плата снята с двух сторон или крупным планом, не увеличивать количество автоматически.

### MAX9814 — подтверждение по фото 2026-09-20

На конкретной плате порядок выводов слева направо: `AR | Out | Gain | Vdd | GND`. Текущие цвета стенда: Out=жёлтый, Vdd=зелёный, GND=синий.

### Назначение пассивов для A2/A3 ColorMusic v2.10

- 1× INV-026 1 µF — C1 между MAX9814 Out и A2, только если маркировка напряжения ≥6,3 V;
- 1× дисковый 103/10 nF из INV-024 — A2→A3;
- INV-029 4,7 kΩ в этой аудиосхеме **не используется**.

### MAX4466 — сравнительный стенд 2026-09-22

INV-015 переведён из пассивного резерва в активный сравнительный тест. Финальной заменой MAX9814 не считается до прохождения fast ADC, CALF и 2/5/8 kHz.

### MAX4466 — результат сравнительного теста 2026-09-22

INV-015: при VCC≈5,1 V и полностью отключённом OUT измерено OUT≈0,1 V вместо ожидаемого порядка VCC/2. Статус: 🔵 **ПОДОЗРЕНИЕ НА НЕИСПРАВНОСТЬ / НЕ ИСПОЛЬЗОВАТЬ КАК ЭТАЛОН** до отдельной проверки платы.

### 2026-09-26 — DS3231 RTC hardware pass

- Владелец подтвердил удаление резистора `201` зарядной цепи при установленной CR2032.
- DS3231 отвечает на `0x68`; часы идут; температура читается; SET времени работает; OSF очищается.
- Battery retention подтверждён владельцем по выполненному полному RTC R1 тесту.
- INV-012 считать аппаратно пригодным для следующего слоя будильника.

### 2026-09-27 — текущая геометрия WS2812B

- Владелец увеличил физическое кольцо до **44 LED на корпус**.
- Целевая финальная система: 44 + 44 = 88 WS2812B.
- Старые записи/тесты на 43 LED сохраняются как исторические результаты; для новых прошивок использовать 44.

### 2026-10-01 — данные потолочной разводки

- Расстояние между корпусами: примерно 2 м.
- Существующая линия к корпусам: 2×2,5 мм², оба старых светильника были на одном выключателе.
- Доступа к проводке в стенах нет.
- Общий S-30-5 можно разместить у ближайшего ко входу корпуса в доступной потолочной точке бывшей люстры.
- Владелец планирует отдельную новую 5-V трассу за потолком ко второму корпусу.
- Для финальной ARDU-топологии эта новая трасса должна нести +5V/GND и DATA D7 с reference GND.
- Наличие PE у точки питания не подтверждено; перед финальным монтажом проверить конкретные входные клеммы/класс S-30-5.

### 2026-10-01 — S-30-5 terminal photo confirmation

- На конкретном INV-020 визуально подтверждены клеммы `L / N / ⏚ / -V / +V`.
- Корпус металлический.
- Клемма защитного заземления `⏚` присутствует и на текущем стенде не подключена.
- Для финального монтажа INV-020 требуется защитный PE; `N` не является заменой PE.
- Если к потолочной точке нельзя подвести PE, INV-020 не использовать в финальной установке; нужен Class II/double-insulated 5 V источник подходящей мощности.

### 2026-10-01 — INV-020 переведён в стендовый PSU

Владелец подтвердил отсутствие PE-проводника в потолочной точке. Поэтому металлический S-30-5 (INV-020) с клеммой защитного заземления не используется в финальной потолочной установке. Статус: стенд/нагрузочные тесты. Для потолка нужен отдельный Class II / double-insulated 5 V PSU.

### 2026-10-10 — новые низковольтные провода Ring B

**Со слов владельца:** есть **3 шт. отдельных проводов 1×1,5 мм²**, предназначенных для будущей трассы низковольтного кольца B. **Количество и номинальное сечение подтверждены сообщением**; длина каждого, гибкость жилы, тип изоляции и цветная маркировка не предоставлены. Статус `ЕСТЬ / ДЛИНУ И ТИП ПРОВЕРИТЬ`. Не считать законченной потолочной разводкой. Проверить по `02_Архитектура_и_решения/RING_B_44LED_МОНТАЖ_И_ПРОВЕРКА.md` до пайки и монтажа; электропитание с потолка отдельно через требуемый Class II PSU.

### 2026-10-17 — назначение имеющихся деталей для Nano remote reset

D-126 использует уже имеющиеся INV-060 BC548, INV-028 резистор 1,5 кΩ и INV-029 резистор 4,7 кΩ для service reset stage ESP GPIO4→Nano RESET. Новая покупка не требуется. Фактическое изъятие деталей из запаса/пайка ещё не подтверждены; до этого статус наличия не менять на «установлено».
