dronrome1245/ARDU/02_Архитектура_и_решения/ПИТАНИЕ_И_ДВА_СВЕТИЛЬНИКА.md

# Питание и два синхронных светильника

Дата: 2026-09-06

## 1. Фактическая конфигурация помещения

- В детской комнате двухклавишный выключатель.
- Первая клавиша управляет отдельными точечными светильниками — это основной белый свет комнаты и он не относится к ARDU.
- Вторая клавиша раньше питала два круглых плоских светильника. Их штатный белый свет больше не используется.
- Корпуса обоих круглых светильников используются только как механическая база/рассеиватель для WS2812B.
- Вторая клавиша должна полностью снимать питание со всей системы ARDU.
- Для двух корпусов желателен один общий БП 5 В и синхронная работа лент.

## 2. Функциональное следствие выключателя

Если вторая клавиша выключена, Nano, ESP8266 и ленты обесточены. DS3231 продолжает хранить время только от резервной батареи.

Следовательно, **световой будильник может сработать только если вторая клавиша оставлена включённой на ночь**. В нормальной эксплуатации клавиша считается мастер-выключателем/сервисным отключением, а состояние лент `OFF` задаётся программно из приложения.

## 3. Геометрия лент

Фактические данные владельца:

- на отрезке 72,5 см насчитано 44 LED;
- это соответствует примерно 60,7 LED/м, то есть практически стандартной плотности 60 LED/м;
- длина внутреннего кантика одного корпуса: 71,5 см.

Расчётная цель: **43 LED на один корпус**, всего **86 LED** на два корпуса.

Перед окончательной пайкой один сегмент физически уложить по кантику и убедиться, что 43 пикселя действительно замыкают окружность без натяжения и нахлёста. DATA-кольцо замыкать нельзя: `DOUT` последнего LED не соединяется обратно с `DIN` первого.

Питание каждого кольца рекомендуется подавать на оба конца сегмента, так как начало и конец после укладки оказываются рядом. Это уменьшает падение напряжения. Плюс и GND обоих концов соединяются с одной и той же ветвью 5 В.

## 4. Рекомендуемая системная топология

```text
230 В, вторая клавиша
        │
        ▼
защищённое место установки БП
S-30-5 230 В → 5 В / 6 А
        │
        ├──────── 5 В/GND ───────► светильник A: WS2812B ~43 LED
        │                              ▲ DATA_A
        │
        ├──────── 5 В/GND ───────► светильник B: WS2812B ~43 LED
        │                              ▲ DATA_B
        │
        └──── 5 В ─► Nano / YP-8 ─► 3,3 В ─► ESP8266
                       │
                       ├── MAX9814
                       ├── DS3231
                       ├── DATA_A
                       └── DATA_B
```

Один Nano, один ESP8266, один MAX9814 и один DS3231 управляют обоими корпусами. Второй светильник не получает отдельный контроллер.

Ленты получают два независимых DATA-выхода Nano и отображают один и тот же кадр. Это предпочтительнее последовательной цепочки через оба корпуса: отказ/обрыв DATA одного кольца не должен лишать сигнала второе кольцо.

## 5. Предварительная распиновка Nano

До отдельной причины изменить назначение принять:

| Функция | Nano |
|---|---|
| ESP8266 UART RX/TX | D0 / D1, аппаратный UART |
| WS2812B светильник A | D6 |
| WS2812B светильник B | D7 |
| MAX9814 OUT | A0 |
| DS3231 SDA | A4 |
| DS3231 SCL | A5 |

Линия **рабочего** `Nano D1/TX (ATmega328P) → ESP8266 RX` проходит через делитель 5 В → около 3,3 В. Кандидат из наличия: 1,5 кОм сверху и 3,0 кОм снизу (два 1,5 кОм последовательно). Это относится к рабочему UART ATmega→ESP и не должно автоматически переноситься на путь прошивки через USB-UART Nano. Для нашего конкретного экземпляра номинал последовательного элемента USB-UART→D0 ещё не подтверждён: на новых фото рядом с USB-UART видны `151` (=150 Ом), поэтому требуется измерение.

Для каждой линии DATA WS2812B нужен свой последовательный резистор ориентировочно 220–470 Ом у выхода Nano. Предпочтительный закупочный номинал при отсутствии — 330 Ом, 2 шт. + запас.

## 6. Бюджет мощности

Для 86 LED:

- консервативный старый расчёт 60 мА/LED при полном белом: 5,16 А только ленты;
- для современных WS2812B с 12 мА на канал полный RGB составляет около 36 мА/LED: около 3,10 А на 86 LED.

Точная ревизия имеющейся ленты неизвестна, поэтому питание проектировать консервативно.

БП S-30-5 5 В 6 А может быть оставлен, так как WS2812B не является основным белым светом. В прошивке должен быть жёсткий лимит суммарного тока лент ориентировочно **4,5 А**, оставляя запас для Nano, ESP8266 и переходных процессов. Максимальный сплошной белый на 100% яркости не является штатным режимом.

Окончательный лимит корректируется после измерения напряжения 5 В под нагрузкой и температуры БП.

## 7. Безопасность 230 В

Целевая концепция: **230 В присутствует только до общего БП; к обоим корпусам светильников по возможности идут только 5 В и DATA**.

S-30-5 — открытый металлический сетевой БП. В финальном монтаже он не должен лежать свободно внутри пластикового корпуса. Требуется:

- закрытое/недоступное для касания место установки;
- жёсткое механическое крепление;
- подключение защитного PE к металлическому корпусу БП, если PE предусмотрен существующей проводкой;
- закрытые клеммы L/N/PE и отсутствие оголённой меди;
- разгрузка кабелей от натяжения;
- физическое разделение сетевой и низковольтной проводки;
- доступность для обслуживания без снятия живых частей.

Точная схема размещения зависит от существующей потолочной проводки и места, где линия второй клавиши разветвляется на два светильника. До финального монтажа нужно выяснить это.

## 8. Низковольтная разводка

От БП к каждому кольцу желательно вести отдельную ветвь `+5V + GND`; DATA идёт вместе со своим GND или рядом с ним.

Окончательное сечение проводов и необходимость отдельных предохранителей выбираются после получения:

- расстояния от БП/контроллера до каждого корпуса;
- доступных жил существующей проводки/нового кабеля;
- фактического места установки БП.

Для длинной DATA-линии использовать пару `DATA + GND`, а не вести DATA отдельно от общего возврата.

## 9. ESP8266 — конкретная белая переходная плата

По фото переходная плата соответствует распространённому `White Adapter board for ESP8266`:

- левый `103` подтягивает CH_PD к VCC;
- средний `0` — нулевой резистор, напрямую соединяющий внешний `VCC` с VCC ESP-модуля при **отсутствии стабилизатора**;
- правый `103` подтягивает GPIO15 к GND.

На нашем экземпляре стабилизатор на нижней стороне не установлен, а перемычка `0` присутствует. Поэтому **контакт VCC этой платы является 3,3-вольтовым. 5 В на него подавать нельзя.**

Для обычного старта дополнительно нужны `GPIO0 = HIGH` и `RST = HIGH`. Для режима прошивки `GPIO0` удерживается LOW во время reset/power-up. Имеющиеся 4,7 кОм можно использовать как pull-up GPIO0 и RST к 3,3 В.

## 10. Прошивка ESP8266 без отдельного USB-UART — план стенда

Сначала пробуем использовать Mini-USB Nano как USB↔UART мост:

1. Nano удержать в reset: `RESET → GND`.
2. ESP8266 питать отдельно от проверенного YP-8 3,3 В; не от 3,3-вольтового вывода Nano.
3. Общий GND Nano/YP-8/ESP.
4. Путь PC→ESP RX через USB-UART Nano обязательно согласовать до 3,3 В. **Не предполагать номинал штатного последовательного резистора по типовой Nano:** на нашем экземпляре рядом с USB-UART видны `151` (=150 Ом), а точный путь до D0 требуется прозвонить. После любой конфигурации измерить реальный HIGH на ESP RX до прошивки.
5. ESP TX может идти на RX USB-UART стороны Nano без повышения до 5 В.
6. На ESP для прошивки: GPIO15 LOW (уже обеспечивается адаптером), CH_PD HIGH (адаптер), GPIO0 LOW, затем reset; после загрузки GPIO0 HIGH и reset.

Точные перекрёстные соединения `Nano RX/TX ↔ ESP RX/TX` проверить loopback-тестом конкретной Nano перед первой прошивкой, потому что маркировка D0/D1 относится к ATmega328P, а при удержании AVR в reset используется USB-UART чип платы.

Если этот способ окажется нестабильным или конкретная Nano не даст нормальный UART-мост, тогда USB-UART 3,3 В переводится в `ДОКУПИТЬ`.

## 11. YP-8: как проверить

Проверка выполняется мультиметром до ESP8266:

1. Подать на `VIN` YP-8 стабильные 5 В, `GND` соединить с минусом источника.
2. Мультиметр поставить на постоянное напряжение, диапазон 20 В или auto.
3. Чёрный щуп — GND, красный — VOUT.
4. Нормальная цель: около 3,3 В; значение не должно быть выше 3,6 В.
5. После этого поставить рядом с ESP по питанию имеющийся 100 мкФ 10 В и повторить тест уже с ESP в режиме активного Wi‑Fi.
6. Наблюдать перезагрузки ESP, заметный нагрев AMS1117 и падение VOUT. Если мультиметр имеет MIN/MAX — использовать его.

Обычный мультиметр может не поймать очень короткие провалы питания, поэтому итоговая проверка — отсутствие reset ESP при многократном подключении/сканировании Wi‑Fi плюс стабильное показание VOUT.

## 12. S-30-5: как проверить 5 В

Измеряется только низковольтный выход `V+ / V-` при безопасно закрытой сетевой части.

- мультиметр: DC V, диапазон 20 В или auto;
- чёрный щуп на `V-`, красный на `V+`;
- сначала без нагрузки, затем под стендовой нагрузкой;
- целевое значение около 5,0 В.

Работа рядом с открытыми клеммами 230 В требует опыта сетевого монтажа. Если нет безопасного изолированного тестового подключения, проверку сетевого БП выполняет электрик. Нельзя держать руками открытый БП или переставлять сетевые провода под напряжением.

## 13. Электролиты

Рабочее напряжение электролитического конденсатора **не измеряется мультиметром** — оно написано на корпусе.

На новом крупном фото один конденсатор читается как `100 µF 10 V` — он подходит как локальный фильтр линии 5 В.

На старом фото электролит около 1000 мкФ визуально похож на `1000 µF / 10 V`, но до окончательной фиксации нужно прочитать маркировку на конкретном экземпляре. Для 5-вольтовой линии номинал 10 В подходит.

Жёлтый дисковый конденсатор с маркировкой `103` = **10 нФ**, а не 100 нФ. Маркировка 100 нФ обычно `104`.

## 14. DS3231 и CR2032

По фото наш RTC относится к типовой синей плате DS3231/AT24C32 с цепью подзаряда: на плате видны стеклянный диод и резистор `201` (200 Ом), соответствующие распространённой схеме заряда элемента 2032.

Так как установлен обычный **CR2032**, цепь подзаряда должна быть отключена до штатного питания от 5 В. Предпочтительный способ для нашего проекта — удалить/выпаять резистор `201` в зарядной цепи; альтернативно можно разорвать цепь диода.

После удаления `201` RTC работает от VCC, а при снятии питания сохраняет ход от CR2032.

## 15. Что ещё нужно узнать до финального силового проекта

1. Есть ли суммарно минимум **1,43 м WS2812B** для двух колец по 71,5 см.
2. Расстояние между двумя потолочными корпусами.
3. Где физически находится разветвление провода от второй клавиши к двум светильникам и доступно ли оно.
4. Сколько жил и какого сечения приходит в каждый старый светильник.
5. Где реально можно закрепить общий S-30-5 в закрытом доступном месте.
6. Есть ли мультиметр, паяльник и возможность безопасно выполнить сетевое подключение/испытание.
7. Сколько электролитов `1000 µF 10 V` фактически имеется.
