dronrome1245/ARDU/05_Коллизии/ОТКРЫТЫЕ_ВОПРОСЫ.md

# Открытые вопросы и коллизии

Дата: 2026-09-06

Инвентаризация закрыта. Функциональная архитектура двух корпусов определена. Здесь остаются только реальные нерешённые вопросы.

## C-001 — ESP8266 VCC — РАЗРЕШЕНО

Белая adapter board идентифицирована по `103 / 0 / 103`. Средний `0 Ω` — прямой мост VCC→Module-VCC при отсутствии регулятора. На нашем экземпляре регулятор не установлен.

**Итог:** VCC = 3,3 В. 5 В запрещены.

## C-002 — способ прошивки ESP8266 — ОТКРЫТО

Сначала проверить Mini-USB Nano как USB↔UART мост с AVR в reset и обязательным делителем в направлении к ESP RX.

Если не работает стабильно — докупить USB-UART 3,3 В.

## C-003 — распиновка — РАЗРЕШЕНО ДО СТЕНДА

Предварительно:

- ESP UART: D0/D1;
- кольцо A: D6;
- кольцо B: D7;
- MAX9814: A0;
- DS3231: A4/A5.

Менять только при выявленном конфликте на стенде.
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
