dronrome1245/ARDU/02_КОМПОНЕНТЫ_BOM.md

# Компоненты / BOM проекта ARDU

Это канонический перечень деталей именно для проекта двух синхронных потолочных WS2812B-светильников. Полный склад пользователя находится в `02_Наши_детали/ИНВЕНТАРЬ.md`.

## Статусы

- ✅ `ЕСТЬ` — наличие подтверждено;
- 🔵 `ПРОВЕРИТЬ` — есть, но нужен тест/измерение;
- 🟢 `ДОКУПИТЬ` — подтверждённо отсутствует и требуется;
- 🟡 `ПОСЛЕ ТЕСТА` — покупка зависит от проверки;
- ⚪ `ОПЦИОНАЛЬНО` — базовой версии не требуется;
- ⛔ `НЕ НУЖНО` — не закупать для текущей архитектуры.

## A. Контроллеры и связь

| Позиция | Нужно | Статус | Комментарий |
|---|---:|---|---|
| Arduino Nano ATmega328P | 1 + резерв | ✅ ЕСТЬ | текущий основной экземпляр по подтверждению владельца — USB-C Nano; USB-C = SERVICE/programming, не силовой BACKUP input; один Nano управляет обоими кольцами |
| ESP8266MOD AI-THINKER | 1 | ✅ ЕСТЬ / 🔵 ПРОВЕРИТЬ WIFI | белая adapter board питается **3,3 В**; flash-прошивка и запуск пользовательского скетча (`ARDU ESP8266 OK`) подтверждены, далее активный Wi‑Fi тест |
| HC-05 | 0–1 | ✅ ЕСТЬ / ⚪ РЕЗЕРВ | только отладка |
| ESP32 | 0 | ⛔ НЕ ПОКУПАТЬ | архитектура закрывается имеющимся железом |

## B. Свет, звук, RTC

| Позиция | Нужно | Статус | Комментарий |
|---|---:|---|---|
| WS2812B | 44 LED на корпус, 88 суммарно | ✅ ФАКТИЧЕСКАЯ ГЕОМЕТРИЯ | владелец увеличил кольцо до 44 LED; все будущие прошивки использовать LED_COUNT=44; фактическую длину разводки учитывать при финальном монтаже |
| MAX9814 | 1 | ✅ ЕСТЬ | один микрофон обслуживает оба кольца |
| MAX4466 | 0–1 | ✅ ЕСТЬ / ⚪ РЕЗЕРВ | сравнительный тест при необходимости |
| DS3231 + EEPROM | 1 | ✅ ЕСТЬ / RTC R1 ПРОЙДЕН | CR2032; резистор `201` зарядной цепи удалён по подтверждению владельца; I²C/time/OSF/retention проверены |
| Зуммер | 0–1 | ✅ ЕСТЬ / ⚪ ОПЦИОНАЛЬНО | режимы будильника обсудить позже |

## C. Питание

| Позиция | Требование | Статус | Комментарий |
|---|---|---|---|
| S-30-5 | 5 В, 6 А | ✅ ЕСТЬ / ⛔ ТОЛЬКО СТЕНД | металлический корпус, L/N/⏚/-V/+V; PE на потолке отсутствует, поэтому в финальную установку не ставить. Использовать для разработки/нагрузочных тестов |
| Class II финальный PSU | Mean Well IRM-30-5ST, 5 V / 6 A / 30 W | 🟢 ДОКУПИТЬ | screw-terminal encapsulated Class II module; финальный потолочный источник вместо S-30-5 |
| YP-8 AMS1117-3.3 | 5 В → 3,3 В для ESP8266 | ✅ ЕСТЬ / 🔵 ИЗМЕРИТЬ | проверить VOUT и Wi‑Fi нагрузку |
| Электролит 100 мкФ 10 В | ≥1 у ESP/питания | ✅ ЕСТЬ / ИСПОЛЬЗУЕТСЯ | установлен непосредственно между ESP VCC/GND на стенде; оставить для дальнейших тестов |
| Электролит 1000 мкФ 6,3 В | минимум 1 на тест/предпочтительно по одному у каждого кольца | ✅ ЕСТЬ / 🔵 КОЛИЧЕСТВО | фактическая маркировка подтверждена; подходит для 5 В WS2812B, ставится параллельно +5V/GND у входа ленты |
| Локальные 100 нФ | развязка | ✅ УЖЕ ЕСТЬ НА МОДУЛЯХ/ЛЕНТЕ | YP-8 имеет SMD `104/106`, на WS2812B есть локальные C1; отдельная покупка сейчас не обязательна |

## D. Согласование и DATA

| Позиция | Нужно | Статус | Комментарий |
|---|---:|---|---|
| Делитель рабочего Nano D1/TX → ESP RX | 1 комплект | ✅ МОЖНО СОБРАТЬ | для **рабочего ATmega→ESP**: 1,5 кОм сверху + 3,0 кОм снизу из двух 1,5 кОм; измерить до подключения. Для **прошивки через USB-UART Nano** не переносить типовую схему: фактический последовательный резистор USB-UART→D0 ещё измеряется |
| Резистор DATA 200–500 Ом | 2 + запас | ✅ 1×220 Ом ЕСТЬ / НУЖЕН ЕЩЁ 1 ДЛЯ ВТОРОГО КОЛЬЦА | владелец подготовил 220 Ом для FW-1; номинал подходит по AlexGyver. По одному последовательно у D6 и D7 возле Nano |
| Резисторы 4,7 кОм | 2–3 | ✅ ЕСТЬ | pull-up GPIO0/RST ESP при необходимости; **в аудиотракт A2/A3 не ставить** |
| Дисковый `103` | 10 нФ | ✅ ЕСТЬ / НЕ НУЖЕН В D-040 | сохраняется в запасе; single-input MAX9814 не использует A2/A3-ветвь |
| Электролит 1–100 µF ≥6,3 V для аудиовхода | 1 | ✅ ЕСТЬ / НЕ НУЖЕН В D-040 | single-input MAX9814 использует прямой Out→A0; конденсатор сохраняется в запасе |

## E. Предварительная распиновка Nano

| Функция | Пин |
|---|---|
| ESP8266 UART | D0 RX / D1 TX |
| WS2812B корпус A | D6 |
| WS2812B корпус B | D7 |
| MAX9814 VU/FHT path | A0 напрямую от Out; Gain→Vdd (40 dB), AR floating; DEFAULT AREF; software DC subtraction для FHT |
| A2/A3 | свободны в финальном аудиотракте D-040 |
| DS3231 SDA/SCL | A4/A5 |

## F. Монтаж двух корпусов — топология уточнена 2026-10-01

**ФАКТ:** корпуса находятся примерно в 2 м друг от друга.  
**ФАКТ:** существующая потолочная линия к корпусам — 2×2,5 мм² от одного выключателя; доступа к проводке в стенах нет.  
**РЕШЕНИЕ владельца:** общий S-30-5 размещается у ближайшего ко входу корпуса; ко второму корпусу прокладывается новая низковольтная 5-V трасса за потолком.

Принятая разводка:
- узел S-30-5 + Nano/ESP/RTC/MAX9814 у корпуса A;
- корпус A / Ring A: локальные +5V/GND, DATA D6;
- корпус B / Ring B: ~2 м новая ветвь +5V/GND, DATA D7;
- DATA D7 вести с близким reference GND;
- существующую mains-линию не использовать как DATA.

Предварительно для 2-м ветви Ring B:
- +5V/GND: медь ~1,5 мм² или больше;
- DATA: отдельная сигнальная жила;
- series DATA resistor 200–500 Ω у источника;
- bulk capacitor у входа Ring B.

Осталось определить/докупить:
- фактический low-voltage кабель и длину с монтажным запасом;
- клеммы/разъёмы;
- закрытый безопасный корпус/место S-30-5;
- отдельный PE-проводник к S-30-5 либо замена БП на Class II/double-insulated вариант;
- низковольтную защиту/предохранители при необходимости.

Финальное сечение подтверждается двухкольцевым voltage-drop/load test.

## G. Прошивка ESP8266

| Позиция | Статус | Комментарий |
|---|---|---|
| Mini-USB Nano как USB↔UART | ✅ РАБОТАЕТ / 🔵 СОГЛАСОВАТЬ RX | полная прошивка воспроизводимо проходит на `115200` с ручным `RST→GND` при `Connecting...`; прямой D0→RX небезопасен по уровню, безопасный programmer-level-shift ещё определить |
| отдельный USB-UART 3,3 В | 🟡 ПОСЛЕ ТЕСТА | покупать только если Nano-мост не работает стабильно |

## H. Не нужно базовой версии

W5500, HC-SR04, релейные модули, LCD 16×2 и PCF8574 не входят в финальную лампу. LCD разрешён только как стендовый диагностический инструмент.

## I. Минимальная закупка для первой законченной лампы v1

Обязательное/практически обязательное перед потолочным монтажом:

| Позиция | Кол-во | Конкретный выбор / требование |
|---|---:|---|
| Финальный Class II PSU | 1 | **Mean Well IRM-30-5ST**, 5 V / 6 A / 30 W, screw terminals |
| DATA resistor второго кольца | 1 + запас | 220 Ω, допустимо 200–500 Ω |
| Bulk capacitor второго кольца | 1 | 1000 µF, предпочтительно 10 V / 105 °C; покупать только если второго подтверждённого экземпляра нет |
| Low-voltage трасса A→B | ~3 м с запасом | +5 V/GND медь ~1.5 mm²; DATA D7 рядом с reference GND |
| Клеммы/разъёмы/монтаж | комплект | 5–6 A low-voltage path, обслуживаемые соединения, закрытая изоляция сетевых клемм |
| Защитный монтажный кожух/коробка | 1 | закрыть 230-V terminals IRM-30-5ST, оставить требуемую вентиляцию/зазоры |

Опционально после финального нагрузочного теста:
- отдельные низковольтные предохранители ветвей колец, если выбранная монтажная схема этого требует.

Не покупать для v1:
- аккумулятор / powerbank для ARDU;
- HUSB238 или другой USB-C PD trigger;
- reserve DC/DC;
- MAIN/BACKUP relay/selector;
- отдельный BACKUP fuse;
- компоненты MAINS_SENSE;
- новый ESP/Nano/MAX9814/DS3231/WS2812B — уже есть.

### Финальный PSU после подтверждения отсутствия PE — 2026-10-05

- 🟢 **ДОКУПИТЬ:** Mean Well `IRM-30-5ST`.
- Подтверждённые целевые характеристики: Class II, без FG/PE, 5 V / 6 A / 30 W, screw-terminal style.
- Финальный two-ring load/temperature/voltage-drop test остаётся обязательным перед потолком.

## J. 2026-10-10 — новые доступные провода для Ring B (D-124)

**Владелец сообщил о наличии** трёх отдельных проводов `1×1,5 мм²` (3 шт.; фактические длины, изоляция, цвет и тип жилы ещё проверить). Предварительно достаточно по числу линий для трассы Ring A→Ring B: отдельная `+5V`, общий `GND`, отдельный `DATA` от D7 через 220–470 Ω возле Nano. **Статус: ЕСТЬ ПО СЛОВАМ ВЛАДЕЛЬЦА / ПРОВЕРИТЬ ДЛИНУ И ПРИГОДНОСТЬ ДЛЯ ПРОКЛАДКИ.** Не включать кабель повторно в список покупки до физической проверки.

Остаются на проверке: запас длины к ~2 м между корпусами, один отдельный DATA resistor Ring B, локальный capacitor ≈1000 µF, безопасные переходные гибкие выводы/клеммы, защита +5 В ветвей, Class II финальный БП вместо S-30-5. `02_Архитектура_и_решения/RING_B_44LED_МОНТАЖ_И_ПРОВЕРКА.md` определяет критерии электрической приёмки; S-30-5 без защитного PE не устанавливать на потолок.

## K. Nano remote flash service — D-126 (2026-10-17)

Дополнительная закупка не требуется: использовать 1× имеющийся `BC548`, 1× `1,5 кΩ`, 1× `4,7 кΩ` и короткий сигнальный провод. Назначение: изолированное управление Nano RESET от ESP GPIO4. Перед пайкой подтвердить C/B/E конкретного транзистора. Эти детали переводятся из резерва/общего запаса в service reset-цепь только после физической сборки; пока source/CI ready, hardware pending.
