dronrome1245/ARDU/04_Прошивка/RTC_DS3231_WIRING.md

# ARDU — DS3231 RTC: первый аппаратный тест

Дата: 2026-09-26

## Цель

Изолированно проверить DS3231 перед реализацией будильника/рассвета.

Тестовый скетч:

`04_Прошивка/nano_rtc_r1/nano_rtc_r1.ino`

## Критическая безопасность батареи

На фактическом модуле установлен **CR2032** и по фото идентифицирована зарядная цепь с резистором `201`.

По решению D-017:

- **до подачи 5 В на модуль с установленной CR2032 удалить резистор `201`;**
- CR2032 не является перезаряжаемым аккумулятором;
- пока удаление `201` не подтверждено, не подключать VCC RTC к Nano 5V с батареей на месте.

Безопасная диагностическая альтернатива, если нужно проверить только I²C до выпайки `201`: вынуть CR2032 из держателя, затем можно временно запитать модуль от 5 В. Но retention-test без батареи тогда не выполняется.

## Проводка после выполнения D-017

| DS3231 | Arduino Nano |
|---|---|
| VCC | 5V |
| GND | GND |
| SDA | A4 |
| SCL | A5 |

SQW/32K не подключать.

На первом тесте ESP8266 не нужен. Кольцо не участвует.

## Команды

- `STATUS` — наличие RTC, OSF/lostPower, текущее время;
- `TIME` — текущее время;
- `TEMP` — температура кристалла DS3231;
- `SET YYYY-MM-DD HH:MM:SS` — ручная установка даты/времени, одновременно очищает OSF;
- `CLEAROSF` — отдельно очистить флаг остановки генератора;
- `HELP`.

## Критерий первого pass

1. Startup: `ARDU NANO RTC R1 READY`.
2. `PRESENT=YES`.
3. `TIME` читается и секунды увеличиваются.
4. `TEMP` возвращает разумное числовое значение.
5. После `SET ...`: `OSF=0 LOST_POWER=NO`.
6. После полного снятия питания Nano на 1–2 минуты и повторного включения:
   - время продолжает идти;
   - `LOST_POWER=NO`.

Последний пункт подтверждает резервное питание от CR2032.
