dronrome1245/ARDU/04_Прошивка/AUDIO_V210_WIRING.md

# ARDU — аудиовход по логике AlexGyver ColorMusic v2.10

Дата: 2026-09-21

## Цель

После успешного диагностического FHT на прямом `MAX9814 Out→A0` перейти к двухвходовой логике поздней официальной ColorMusic:

- `A2` — основной mono/VU вход (`SOUND_R`);
- `A3` — отдельный частотный вход (`SOUND_R_FREQ`) через конденсатор;
- `A0` в ARDU здесь не используется.

## Физическое подключение

Используем имеющиеся детали:
- MAX9814;
- 1× электролит `1 µF` (на оригинальной схеме указан диапазон 1–100 µF), **рабочее напряжение не ниже 6,3 V**;
- 1× керамический/дисковый `103 = 10 nF`.

**Резистора A2→GND в оригинальной схеме нет.** Предыдущая предложенная цепочка 4,7 kΩ + 4,7 kΩ была ошибочной проектной добавкой и удалена.

```text
MAX9814

AR    ───────────── НЕ ПОДКЛЮЧАТЬ
Gain  ───────────── Vdd            (40 dB)
Vdd   ───────────── Nano 5V
GND   ───────────── Nano GND

Out ──── (+) C1 1 µF (-) ────●──────── Nano A2
                               │
                               └── C2 10 nF (103) ── Nano A3
```

### Полярность C1

На предоставленной официальной схеме отрицательная полоска электролита показана со стороны A2, а сторона без полоски — со стороны выхода MAX9814. Это также согласуется с тем, что OUT MAX9814 имеет положительное DC-смещение около 1,25 V.

Поэтому:
- `+` C1 → к `Out` MAX9814;
- `−` C1 → к Nano A2.

Отдельного резистора, задающего DC-потенциал A2, на этой схеме нет.

Если берётся другой электролит из диапазона 1–100 µF, ориентация та же.

C2 `103 / 10 nF` неполярный — направление не важно.

## Что НЕ соединять

- Не соединять `MAX9814 Out` напрямую с A2 или A3 при этом скетче: между Out и A2 стоит C1.
- Не ставить резистор A2→GND: на показанной официальной схеме его нет.
- Не соединять A2 и A3 проводом напрямую: между ними только `10 nF / 103`.
- Не подавать 5 V на A2/A3.
- Не использовать A0 как сигнальный вход в этой версии.
- Nano, питаемый от USB, не соединять своим `5V` с `S-30-5 +5V`; общий GND с лентой сохраняется по уже проверенной стендовой схеме.

## Прошивка

Файл:

`04_Прошивка/nano_audio_v210_test/nano_audio_v210_test.ino`

Arduino IDE:
- Board: Arduino Nano;
- Processor: ATmega328P (Old Bootloader);
- Serial Monitor: 115200.

Команды:
- `STATUS` — пины/AREF/библиотека;
- `ADC2` — сырые значения A2;
- `ADC3` — сырые значения A3;
- `CALF` — штатный ColorMusic noise gate (100 FHT кадров, max + 3);
- `FREQRAW` — спектр без gate;
- `FREQ` — спектр с gate.

## Первый критерий успеха

После сборки не начинать сразу с музыки.

1. `STATUS` должен показать `VU_PIN=A2 FHT_PIN=A3 ADC_REF=INTERNAL_1V1`.
2. В тишине выполнить `ADC2` и `ADC3`; значения не должны постоянно быть 1023.
3. Выполнить `CALF` в тишине.
4. Проверить `FREQ` в тишине.
5. Затем повторить уже проверенные тоны 2 / 5 / 8 кГц.

A0-диагностический baseline сохранён отдельно и используется для сравнения.

## Диагностический тест DC-привязки — 2026-09-22

Это **не изменение канонической схемы AlexGyver** и не финальный номинал. Тест введён после фактического насыщения обоих входов при быстром ADC.

Временно добавить:
- `A2 → 4,7 kΩ → 4,7 kΩ → GND`;
- `A3 → 4,7 kΩ → 4,7 kΩ → GND`.

C1 между MAX9814 Out и A2 и C2=103/10 nF между A2 и A3 оставить без изменений.

Цель: дать обоим AC-coupled входам определённый DC-return и проверить, исчезнет ли `1023` при prescaler=32. Если эффект подтверждается, финальный номинал выбирается отдельно; временные 9,4 kΩ не считать автоматически финальной схемой.
