dronrome1245/ARDU/05_WiFi_и_приложение/ARDU_DIRECT_STATION_AP_TEST.md

# ARDU-DIRECT — физическая проверка Station → SoftAP → Station

Дата: 2026-10-10
Статус: **код подтверждён в ESP v2 и Android; аппаратный PASS ожидается**.

## Что проверяем

При пропадании домашнего Wi-Fi ESP8266 с прошивкой `ARDU_ESP_V2_AMBIENT12` предоставляет защищённую WPA2-сеть `ARDU-DIRECT` с IP `192.168.4.1`; при возврате домашнего роутера восстанавливает Station и выключает резервную точку доступа. При этом Nano и LED продолжают получать питание, Интернет не нужен.

## Перед тестом

- Лампа/Nano/ESP получают питание **независимо от выключаемого роутера**. Не обесточивать плату ESP в ходе переключения сети.
- `GET http://192.168.0.4/api/ping` в домашней сети возвращает `ok:true`, `fw:ARDU_ESP_V2_AMBIENT12`, `network_mode:station`, `softap_active:false`. Домашний IP может отличаться; использовать действительный адрес устройства.
- В **локально загруженном ESP .ino** ранее должны быть указаны четыре реальные значения `ARDU_WIFI_SSID`, `ARDU_WIFI_PASSWORD`, `ARDU_OTA_PASSWORD`, `ARDU_SOFTAP_PASSWORD`. Пароль SoftAP — отдельный, минимум 8 символов. Не пересылать пароли или локальную копию `.ino` в чат и не коммитить в GitHub.
- Телефон с установленным Android v0.22.11+ и возможностью открыть настройки Wi-Fi.

## Пошаговый тест

1. Пока роутер включён, приложение показывает `Онлайн`; проверить на телефоне обычный L01 ON/OFF. Выполнить `GET /api/ping` и записать `network_mode:station`.
2. Выключить **только домашний роутер**, не выключая ARDU. Выждать 20–30 секунд; если сеть не появилась, выждать ещё 30 секунд без перепрошивок и сбросов.
3. На телефоне открыть **Настройки → Wi-Fi** → выбрать `ARDU-DIRECT`. Ввести именно пароль `ARDU_SOFTAP_PASSWORD` из приватной копии прошивки. При «Без интернета» выбрать «Оставаться подключённым». Если Android перенаправляет трафик на мобильную сеть, временно выключить мобильные данные.
4. В браузере телефона открыть `http://192.168.4.1/api/ping`. Ожидать HTTP JSON с `ok:true`, `network_mode:"softap"`, `softap_active:true`, `ip:"192.168.4.1"` и совместимым `uart_protocol:1`. Записать ответ (без секретов).
5. В приложении нажать **Обновить**, дождаться `Онлайн`. Включить/выключить обычный свет, изменить яркость и выбрать безопасный фоновый P-пресет; проверить реальное действие и readback. Если auto-discovery не сработал, вручную указать адрес `192.168.4.1` в **Настройки → Адрес ARDU**, повторить обновление. Не требовать Интернета.
6. Включить роутер. Дождаться повторного подключения ESP к домашнему Wi-Fi. Телефон должен вернуться в домашнюю сеть (при необходимости выбрать её вручную). `GET /api/ping` по актуальному домашнему IP снова сообщает `network_mode:"station"`, `softap_active:false`. Открыть приложение, нажать **Обновить**, проверить `Онлайн` и изменение L01 яркости.

## Критерии PASS/FAIL

**PASS**, только если на реальном оборудовании подтверждены обе стороны перехода: Station→ARDU-DIRECT (соответствующий `/api/ping` и управление светом)→Station (после возврата роутера `/api/ping` и управление работают). Записать firmware, примерный интервал перехода и любые ошибки Android; пароль **не записывать**.

Если `ARDU-DIRECT` отсутствует: сначала перепроверить установленную прошивку ESP, guard пароля AP, питание ESP и время ожидания; не менять Nano. Если сеть есть, но `192.168.4.1` не отвечает: проверить, что телефон действительно остался на этой сети и не переключился на мобильную. Если браузер отвечает, а Android Offline: открыть настройки адреса и убедиться в корректном active URL/новом `Обновить`. Сброс настроек и повторная OTA **не являются первым шагом** диагностики.

## Источник прошивки

- `05_WiFi_и_приложение/esp8266_ardu_v2/esp8266_ardu_v2.ino`: `WIFI_CONNECT_TIMEOUT_MS = 15000`, `startSoftAp()` на `192.168.4.1`, `maintainWifi()` возвращает Station, `handlePing()` сообщает реальный network_mode.
- `05_WiFi_и_приложение/android_app_r1/app/src/main/java/com/ardu/app/net/ArduApiClient.kt`: ping-кандидаты, включая `http://192.168.4.1`.

## Повторный direct regression — Android 0.22.13 (после видео 18442333063828.mp4)

**Промежуточный результат владельца (2026-10-10):** Direct Wi-Fi поднялся и телефон подключился, Android один раз показал «Прямое подключение» и реальные данные света, затем во время L01 ON/OFF произошла ошибка подтверждения и состояние потерялось. Считать это **частичным PASS только для сети, FAIL для стабильности управляющего цикла**.

После `git pull` → Android Studio Run 0.22.13/code36:

1. Выключить только роутер, оставить Nano/ESP запитанными. Подключиться к ARDU-DIRECT и выбрать «Оставаться подключённым», выключить мобильные данные. Зафиксировать появление Wi-Fi адреса из 192.168.4.x в Android, если отображается.
2. В браузере телефона открыть `http://192.168.4.1/api/ping` **три раза** с паузой примерно 5 с. Ожидается `network_mode:softap`, `softap_active:true`, `ip:192.168.4.1`. Если ping не отвечает, это **не** только UI-проблема — проверить Wi-Fi/ESP/AP.
3. Открыть `http://192.168.4.1/api/status`. Если ping работает, а status периодически не отвечает или содержит ошибку Nano, отдельно расследовать ESP↔Nano, UART и питание до новой прошивки. Не считать доступный /api/ping доказательством Nano PASS.
4. Запустить Android 0.22.13 → «Обновить». Проверить «Прямое подключение», затем выполнить пять поочерёдных L01 ON/OFF (с паузами по 2–3 секунды между подтверждениями) и один безопасный P-пресет. Для каждого шага проверить **реальное изменение светодиодов** и читаемое состояние в приложении, без ошибки подтверждения.
5. Если повторно появляется «Ошибка данных» или «Nano не отвечает», сразу (не перезагружая плату) открыть браузером `/api/ping` и `/api/status`, записать, какой endpoint отказал. Android по-прежнему не повторяет POST при потерянном ACK, потому что команда могла уже исполниться.
6. Включить роутер, подключить телефон к домашней Wi-Fi сети, нажать «Обновить»; проверить Station ping и L01. Функция прямого закрепления снимается при уходе телефона из Wi-Fi подсети 192.168.4.x.

**Критерий PASS:** три direct ping подряд + direct status + пять управляющих циклов с Nano readback + возврат Station. Если тест на физическом телефоне не прошёл, CI Android не закрывает аппаратную проблему; следующий слой — отдельно исследовать ESP `maintainWifi()` (попытки Station каждые 10 с при AP) и Nano UART timeout, не менять одновременно их и Android.

## Last-chance Direct trial — ESP V3 + Android 0.22.15

Owner-provided independent `/api/ping` **and** `/api/status` from `192.168.4.1` succeeded on installed ESP V2 while app control remained intermittent; this separates intermittent failure from permanent ESP/Nano unreachability. New ESP V3 does not rescan Station while `WiFi.softAPgetStationNum()>0`, and Android v0.22.15 tolerates direct transient `settings/time` GET as **read-only partial data**. To run last real test: install ESP V3 over Station and Nano R5; connect phone Wi-Fi to ARDU-DIRECT with mobile data off; check `/api/ping` `softap_clients >= 1`, `/api/status` valid; run 5 L01 ON/OFF with readback and 1 safe P-scene; restore Station after manually leaving direct Wi-Fi. If error repeats, collect both endpoint results and mark this feature **deferred / not accepted**; continue with Station as owner instructed, without more experimental Direct changes in v1.
