dronrome1245/ARDU/04_Прошивка/ALARM_R1_TEST.md

# ARDU — ALARM R1: проверка ежедневного триггера и EEPROM

Дата: 2026-09-26

## Цель слоя

Проверить отдельно от рассвета:

1. настройку времени будильника;
2. включение/выключение будильника;
3. сохранение этих настроек после reset/power cycle Nano;
4. автономный ежедневный trigger от DS3231;
5. отсутствие повторного trigger в ту же календарную дату.

Светодиоды в этой ревизии **не загораются**. Успех фиксируется строкой Serial:

`EVENT ALARM_TRIGGER RTC=YYYY-MM-DD HH:MM:SS`

## Хранение

R1 использует внутреннюю EEPROM ATmega328P, потому что объём настроек минимален и это позволяет не добавлять вторую неизвестную (AT24C32) до проверки логики будильника.

Хранятся:

- enabled;
- hour;
- minute;
- дата последнего срабатывания;
- magic/version/checksum.

EEPROM записывается при изменении настроек и один раз при ежедневном trigger.

## Команды

- `STATUS`
- `TIME`
- `ALARMSET HH:MM`
- `ALARM ON`
- `ALARM OFF`
- `ALARM CLEARLAST`
- `SET YYYY-MM-DD HH:MM:SS`
- `HELP`

## Тест

1. Убедиться `RTC_VALID=YES`.
2. Установить alarm на 1–2 минуты вперёд.
3. `ALARM ON`.
4. `STATUS` → `SAVED=YES`.
5. Нажать Reset Nano или перепрошить без изменения EEPROM и снова `STATUS`: время alarm и `ALARM=ON` должны сохраниться.
6. Дождаться заданной минуты. Должна один раз появиться:
   `EVENT ALARM_TRIGGER ...`
7. Несколько раз `STATUS` в ту же минуту не должны генерировать второй event.
8. Для повторного теста в тот же день: `ALARM CLEARLAST`, затем назначить новую минуту.
