dronrome1245/ARDU/HISTORY.md

# История проекта ARDU

Хронология хранит только фактически выполненные действия и полученные данные. Старые записи не переписывать по смыслу.

## 2026-09-05 — инициализация репозитория

- Создан репозиторий `dronrome1245/ARDU`.
- Зафиксирована цель: круглая потолочная лампа со светомузыкой, микрофоном и управлением со смартфона.
- Проанализированы старые материалы по Arduino/HC-05/MAX9814/DS3231/WS2812B и ColorMusic.
- Выбрано рабочее направление Nano + ESP8266.
- Созданы базовые документы архитектуры, требований, протокола и дорожной карты.

## 2026-09-05 — переход к инженерной модели ведения проекта

- В качестве образца организации изучен репозиторий `dronrome1245/RC-Toy-Fighter`.
- Принято вести ARDU с постоянным контекстом для любой нейросети: `00_AI_START_HERE.md`, `STATUS.md`, `DECISIONS.md`, `HISTORY.md`, `SOURCES.md`.
- Принято сначала инвентаризировать все имеющиеся компоненты и только потом утверждать закупки.

## 2026-09-05 — первая расширенная фотоинвентаризация

Пользователь предоставил серию фотографий имеющейся электроники.

По фото зафиксированы:

- набор выводных LED разных цветов;
- HC-SR04;
- релейный модуль 5 В SRD-05VDC-SL-C;
- потенциометр B10K;
- LCD МЭЛТ MT-16S2H 16×2;
- набор электролитических/керамических конденсаторов;
- I2C LCD backpack на PCF8574/совместимом чипе;
- W5500 Ethernet-модуль;
- зуммер неизвестного типа;
- USB A ↔ Mini-B кабель;
- Arduino Nano ATmega328P с Mini-USB;
- Arduino Nano ATmega328P-совместимая плата с USB-C;
- YP-8 на AMS1117-3.3;
- отдельная PCF8574A DIP;
- маркировка реле TIANBO HJR1-2C L-12V;
- полноразмерная макетная плата.

Несколько фото относятся к разным сторонам/крупным планам одних и тех же плат и не считаются отдельными экземплярами.

## 2026-09-05 — вторая фотоинвентаризация

Пользователь предоставил ещё одну серию фотографий, включая крупные планы маркировки ранее известных и новых компонентов.

Подтверждено:

- RTC-модуль DS3231 с AT24C32/совместимой EEPROM и батарейным держателем; установлен CR2032;
- MAX9814 — основной микрофонный модуль, маркировка и выводы читаются на фото;
- MAX4466 — отдельный микрофонный усилитель с ручной регулировкой gain;
- HC-05 физически присутствует; сфотографированы обе стороны;
- БП S-30-5 физически присутствует; по шильдику 5 В, 6 А, 30 Вт;
- электролитические конденсаторы 1 мкФ — 10 шт.;
- электролитические конденсаторы 100 мкФ — 3 шт.;
- BC548 — 10 шт.;
- 1N4148 — 10 шт.;
- резисторы 1,5 кОм — 10 шт.;
- резисторы 4,7 кОм — 10 шт.;
- на фоне видны соединительные провода Dupont/аналогичные, но их типы и количество пока не подсчитаны.

Дополнительный крупный план Mini-USB Nano не был автоматически принят за новый отдельный экземпляр.

После этой партии BOM уточнён: новый микрофон, RTC и отдельный level shifter покупать пока не требуется. Для линии Nano TX → ESP8266 RX зафиксирован кандидат делителя из трёх имеющихся резисторов 1,5 кОм с обязательной проверкой мультиметром до подключения.

Отдельным вопросом безопасности отмечена CR2032 в RTC-модуле: до питания проверить, нет ли на плате цепи её подзаряда.

## 2026-09-06 — инвентаризация закрыта

- Пользователь подтвердил, что дополнительных компонентов больше нет.
- Этап сбора списка наличия завершён.
- Проект переведён к проверке совместимости, питания, геометрии лампы и оставшихся инженерных неопределённостей.

## 2026-09-06 — определена конфигурация двух круглых светильников

Пользователь уточнил фактическую схему комнаты и назначение корпусов:

- первая клавиша выключателя управляет отдельными точечными светильниками и остаётся основным белым светом;
- два круглых плоских светильника больше не ремонтируются как белые лампы;
- оба корпуса используются под WS2812B для светомузыки и светового будильника;
- вторая клавиша должна полностью снимать питание со всей ARDU-системы;
- требуется один общий БП и синхронная работа обоих колец;
- мобильное приложение пишется заново;
- фактический отрезок 72,5 см содержит 44 LED, кантик корпуса 71,5 см.

По этим данным:

- целевая плотность ленты принята около 60 LED/м;
- проектная цель — 43 LED на корпус, 86 LED суммарно, с физической проверкой перед резкой;
- выбран один Nano/ESP/MAX9814/DS3231 на оба корпуса;
- два кольца получают отдельные DATA-выходы D6 и D7 и синхронный кадр;
- Wi‑Fi выбран: Station основной + SoftAP резерв; первая версия приложения работает через локальный HTTP API;
- белая ESP8266-переходная плата идентифицирована по схеме `103/0/103` как вариант без установленного стабилизатора, поэтому внешний VCC зафиксирован как 3,3 В;
- для S-30-5 установлен предварительный программный лимит лент около 4,5 А;
- на новом фото подтверждён электролит `100 µF 10 V`;
- дисковый `103` идентифицирован как 10 нФ;
- по фото DS3231 подтверждены `201` и стеклянный диод зарядной цепи; для CR2032 принято отключить зарядную цепь перед штатным питанием.

Создан подробный файл `02_Архитектура_и_решения/ПИТАНИЕ_И_ДВА_СВЕТИЛЬНИКА.md` с топологией питания, измерениями и вопросами физического монтажа.

## 2026-09-06 — уточнён запас ленты и источник приложения

- Пользователь подтвердил наличие **5 м WS2812B**; дополнительную ленту для двух колец покупать не требуется.
- Пользователь сообщил, что предыдущий мобильный прототип собирался в **MIT App Inventor** (`ai2.appinventor.mit.edu`).
- Для анализа предыдущего приложения принято получить исходный проект в формате `.aia`; `.apk` не является заменой исходникам блоков.
- После получения `.aia` нужно разобрать экраны, блоки, старые Bluetooth-команды и полезные UX-решения, затем уже проектировать Wi‑Fi-версию.

## 2026-09-06 — разобран Ardublock2.aia и спроектирована функциональная модель v1

- Получен и распакован `Ardublock2.aia`; внутреннее имя проекта — `LumpV3.1`.
- Подтверждены пять экранов: `Screen1`, `Obichniy`, `Nochnik`, `FON`, `Disco`.
- В `Disco` подтверждены 9 режимов ColorMusic, подрежимы и именованные параметры.
- Восстановлен фактический старый Bluetooth-протокол `Disco` и `Obichniy`.
- Установлено, что ранее проектные команды `L1/MM/...` не были фактическим протоколом этого `.aia`; документ протокола исправлен.
- Установлено, что `Nochnik` и `FON` в загруженной версии имели интерфейс, но их прикладные блоки управления не были завершены.
- Из ColorMusic отдельно зафиксирована таблица режимов и параметров.
- Определён целевой функциональный набор ARDU v1: Светомузыка / Фон / Ночник / Будильник.
- Цветная подсветка ColorMusic перенесена из музыкальных режимов в раздел фоновых эффектов.
- Литеральная цветовая температура Kelvin исключена из основной модели WS2812B; вместо неё используются цвет/HUE, насыщенность и яркость.
- Спроектирован новый локальный HTTP API v1 и модель экранов нового приложения.
- Создан поэтапный порядок реализации прошивки от одного кольца и постоянного цвета до FHT, RTC и полного набора режимов.

## 2026-09-13 — первичная проверка YP-8

- YP-8 подключён к 5-вольтовой линии от S-30-5 через макетную плату.
- Без подключённой нагрузки на выходе YP-8 мультиметром измерено `3,31 В`.
- Первичная проверка стабилизатора без нагрузки пройдена.
- Нагрузочная проверка с ESP8266 и активным Wi‑Fi ещё не выполнена.

## 2026-09-13 — первичная проверка S-30-5

- На низковольтной линии `V+ / V-` фактического S-30-5 мультиметром измерено `5,01 В`.
- В момент измерения существенной рабочей нагрузки не было; YP-8 был подключён без нагрузки на своём выходе.
- Выход 5 В без существенной нагрузки соответствует номиналу.
- Проверка S-30-5 под нагрузкой и контроль нагрева ещё не выполнены.

## 2026-09-13 — YP-8 с подключённым ESP8266

- К выходу YP-8 подключена фактическая белая плата ESP8266.
- На питании ESP8266 мультиметром измерено `3,28 В` против `3,31 В` без нагрузки.
- Наблюдаемая статическая просадка составила около `0,03 В`; базовое питание ESP по напряжению выглядит стабильным.
- Активность Wi‑Fi, отсутствие перезагрузок при радиопередаче и нагрев AMS1117 в этом измерении не подтверждены; это следующий отдельный тест.

## 2026-09-18 — повторная проверка питания ESP8266

- На проводах питания от YP-8 без подключённого ESP8266 измерено `3,32 В`.
- После подключения фактического ESP8266 напряжение непосредственно между его `VCC` и `GND` измерено около `2,1 В`.
- Это противоречит предыдущему измерению `3,28 В` с подключённым ESP8266 от 2026-09-13; прежний вывод о стабильном питании считать неподтверждённым до повторной диагностики.
- Следующая проверка: при подключённом ESP8266 измерить напряжение непосредственно на `VOUT` и `GND` YP-8, чтобы отделить просадку самого стабилизатора/источника от падения на проводах или контактах.

## 2026-09-19 — loopback-тест Nano как USB↔UART-моста

- Nano подключена к компьютеру по USB; ATmega328P удерживался в reset соединением `RESET → GND`.
- Для loopback соединены `D0/RX ↔ D1/TX`.
- В Serial Monitor на `115200` отправленный тестовый текст корректно вернулся обратно.
- USB-UART часть Nano подтверждена как рабочая для дальнейшего использования в роли моста.
- Это ещё не подтверждает успешную прошивку ESP8266: перед подключением UART к ESP сначала требуется устранить/локализовать просадку питания до около `2,1 В`, зафиксированную 2026-09-18.

## 2026-09-19 — локализация падения питания ESP8266

- При подключённом ESP8266 измерено: `VIN YP-8 = 4,7 В`, `VOUT YP-8 = 3,30 В`, `VCC ESP8266 = 3,10 В`.
- YP-8 при этой нагрузке сохраняет около 3,3 В на собственном выходе.
- Между выходом YP-8 и питанием ESP наблюдается падение около `0,20 В`, что указывает на сопротивление/плохой контакт в проводах, макетке или соединениях.
- На входе YP-8 также наблюдается около `4,7 В`, что ниже ранее измеренных `5,01 В` без существенной нагрузки; следующий тест — измерение непосредственно на клеммах S-30-5 при той же нагрузке.
- До стабилизации около 3,3 В непосредственно на ESP прошивку и Wi‑Fi-тест не начинать.

## 2026-09-19 — S-30-5 под текущей нагрузкой ESP8266

- При подключённом через YP-8 ESP8266 напряжение непосредственно на клеммах `V+ / V-` S-30-5 измерено `5,00 В`.
- Одновременно ранее были получены `VIN YP-8 = 4,7 В`, `VOUT YP-8 = 3,30 В`, `VCC ESP = 3,10 В`.
- Следовательно, S-30-5 удерживает номинальное напряжение под этой небольшой нагрузкой, а заметные падения возникают в соединениях/контактах между БП, YP-8 и ESP8266.

## 2026-09-20 — измерения относительно общей точки S-30-5 V-

- При подключённом ESP8266 и неподвижном чёрном щупе на `S-30-5 V-` получены: `S-30-5 V+ ≈ 5,0 В`, `YP-8 VIN+ ≈ 4,7 В`, `YP-8 VOUT+ ≈ 3,50 В`, `ESP VCC ≈ 3,25 В`.
- Эти значения измерены относительно общей точки БП, а не относительно локальных GND YP-8/ESP.
- Значение `3,50 В` на `YP-8 VOUT+` не считать истинным выходом стабилизатора до измерения `YP-8 GND` относительно той же точки; оно может включать подъём локального GND из-за сопротивления обратного проводника.
- Следующий тест: не двигая чёрный щуп с `S-30-5 V-`, измерить `YP-8 GND` и `ESP GND`.

## 2026-09-20 — подтверждено большое падение по GND-тракту

- При неизменном чёрном щупе на `S-30-5 V-` измерено: `YP-8 GND = 0,8 В`, `ESP GND = 1,5 В`.
- Эти значения ненормальны для общего низковольтного GND и подтверждают высокое сопротивление/плохой контакт в обратном проводнике или макеточной разводке.
- С учётом ранее измеренных относительно той же точки `YP-8 VIN+ ≈ 4,7 В`, `YP-8 VOUT+ ≈ 3,50 В`, `ESP VCC ≈ 3,25 В`, фактические локальные напряжения оказываются сильно заниженными.
- Решение следующего шага: обесточить систему и пересобрать питание короткими прямыми соединениями, исключив макеточную шину/сомнительные Dupont-контакты из силового пути ESP8266.

## 2026-09-20 — питание ESP8266 стабилизировано после пересборки

- После обнаружения большого падения по GND-тракту низковольтное питание пересобрано прямыми короткими соединениями, исключив проблемную макеточную/контактную разводку из силового пути ESP8266.
- Контрольные локальные измерения: `S-30-5 = 5,0 В`, `YP-8 VIN = 5,0 В`, `YP-8 VOUT = 3,3 В`, `ESP VCC = 3,3 В`.
- Базовая статическая проверка питания YP-8 → ESP8266 пройдена.
- Следующий этап: первая прошивка ESP8266 через уже проверенный Nano USB↔UART-мост, затем тест активного Wi‑Fi с контролем напряжения/нагрева/перезапусков.

## 2026-09-20 — проверка резистивного делителя Nano→ESP RX

- Все три использованных резистора по цветовой маркировке подтверждены как `1,5 кОм ±5%`.
- После исправления соединения измерено: `Nano D0/RX → узел ESP RX ≈ 1,5 кОм`; `узел ESP RX → GND ≈ 3,0 кОм` (два резистора 1,5 кОм последовательно).
- Резистивная часть делителя соответствует проектной схеме. Перед первой прошивкой остаётся проверить фактическое напряжение в узле ESP RX при UART HIGH.

## 2026-09-20 — проверка фактического уровня делителя Nano→ESP RX

- При Nano в режиме USB↔UART-моста (`RESET → GND`) измерено `Nano D0 = 4,95 В` в состоянии UART HIGH.
- В узле после делителя 1,5 кОм / 3,0 кОм измерено `ESP RX = 3,36 В`.
- На питании ESP8266 одновременно измерено `ESP VCC = 3,20 В`.
- Уровень RX соответствует требуемому 3,3-вольтовому интерфейсу; питание находится в допустимом диапазоне ESP8266, но требует контроля при прошивке и активном Wi‑Fi.

## 2026-09-20 — успешная компиляция первого скетча ESP8266

- Тестовый скетч для ESP8266 успешно собран в Arduino IDE без ошибок компиляции.
- Отчёт сборки: глобальные/статические данные RAM `28108 / 80192` байт (35%); Instruction RAM `59747 / 65536` байт (91%, включая `32768` байт зарезервированного flash instruction cache и `26979` байт IRAM-кода); код во flash `236148 / 1048576` байт (22%).
- Это подтверждает корректную установку ESP8266 Arduino core и выбранную конфигурацию платы на уровне компиляции. Загрузка бинарника в физический ESP8266 остаётся следующим тестом.

## 2026-09-20 — первая попытка записи во flash ESP8266

- Arduino IDE успешно установила соединение с физическим ESP8266 через Nano USB↔UART: определён `ESP8266EX`, crystal `26 MHz`, загружен и запущен esptool stub.
- Flash автоматически определена как `4 MB`.
- Запись началась (`Writing at 0x00000000...`) и оборвалась на первом блоке с `Failed to write compressed data to flash after seq 0 (result was C100)`.
- Факт подключения к ROM bootloader и запуска stub подтверждён; загрузка прошивки во flash пока не завершена.
- Следующий минимальный тест: снизить Upload Speed с 115200 до 57600; при повторе ошибки — 38400 и дополнительная проверка качества UART/питания.

## 2026-09-20 — попытка прошивки ESP8266 на 57600

- После первой ошибки записи `C100` скорость загрузки снижена до `57600`.
- Новая попытка завершилась раньше: `Failed to connect to ESP8266: Timed out waiting for packet header`.
- Так как предыдущая попытка успешно определяла ESP8266EX и запускала stub, UART-тракт ранее работал; текущая ошибка указывает на отсутствие корректного входа ESP8266 в ROM bootloader при этой попытке.
- Следующий тест: удерживать `GPIO0` в LOW и выполнить аппаратный reset (`RST` кратковременно на GND, затем отпустить), после чего повторить Upload.

## 2026-09-20 — повторная запись ESP8266 на 57600

- При `Upload Speed = 57600` и принудительном входе в bootloader (`GPIO0 = LOW`, краткий reset) esptool снова успешно определил `ESP8266EX`, запустил stub и определил flash `4 MB`.
- Запись прошивки продвинулась дальше первой попытки: были записаны блоки до `15%` (`0x00000000`, затем `0x00004000`).
- После `seq 1` снова получена ошибка `Failed to write compressed data to flash ... (result was C100)`.
- Boot-режим и базовая UART-связь подтверждены; нестабильность остаётся именно во время передачи/записи. Следующий минимальный тест — `Upload Speed = 38400` без других изменений схемы.

## 2026-09-20 — ошибка 0107 после установки 100 µF

- На питание ESP8266 установлен электролит `100 µF 10 V` непосредственно между VCC и GND.
- Новая попытка прошивки при тех же базовых соединениях завершилась на этапе загрузки stub ошибкой `Failed to write to target RAM (result was 0107)` после успешного определения `ESP8266EX`.
- По документации esptool `0107` означает timeout при записи в RAM и обычно связан с нестабильным serial-соединением/USB-UART/драйвером или качеством тракта Host→ESP; сама flash-конфигурация к этой ошибке не относится.
- Следующий предпочтительный тест: укоротить UART-провода и/или проверить второй имеющийся Nano как альтернативный USB↔UART-мост.

## 2026-09-20 — уточнён штатный 1 кОм в UART Nano

- Владелец указал на штатный последовательный резистор `1 кОм` между USB-UART (CH340/FT232-класс) и пином D0 Nano; для классической Nano V3.3 это также подтверждается официальной схемой Arduino (RP1A/RP1B по 1 кОм на RX/TX).
- Первоначальный расчёт внешнего делителя `1,5 кОм / 3,0 кОм` для режима Nano-as-USB↔UART этот штатный резистор не учитывал.
- Это не отменяет отдельное согласование рабочего сигнала ATmega D1/TX → ESP RX: в финальном режиме источник сигнала — ATmega, а не USB-UART через штатный 1 кОм.
- Ошибки `C100/0107` при прошивке теперь дополнительно рассматриваются как возможное следствие избыточного последовательного сопротивления/ухудшения фронтов programmer UART.

## 2026-09-20 — фотоуточнение UART-обвязки фактической Nano

- Получены крупные фото обеих сторон используемой Nano.
- Рядом с 16-выводным USB-UART-чипом на обратной стороне видны два SMD-резистора с маркировкой `151`, то есть `150 Ом`.
- На лицевой стороне около индикаторов `RX`, `TX`, `POW`, `L` видны четыре SMD `102`, то есть `1 кОм`; по расположению они относятся к индикаторной обвязке и не являются доказательством последовательного 1 кОм в UART-пути.
- Предыдущее утверждение, что на **конкретной** Nano гарантированно стоит 1 кОм между USB-UART и D0, снято как неподтверждённое. Нужно измерить связь D0 с парой `151`.

## 2026-09-20 — попытка прошивки без внешнего делителя

- Внешний делитель между Nano D0 и ESP RX был временно удалён, Upload Speed оставлен `57600`.
- ROM bootloader и stub снова успешно запустились; запись прошивки дошла до `30%` (`seq 3`) и затем снова завершилась `C100`.
- По сравнению с делителем 1,5 кОм / 3,0 кОм (ошибка около 15%) передача стала устойчивее, что указывает на влияние выходного сопротивления/фронтов UART.
- Прямое соединение признано неприемлемым для продолжения, поскольку ранее на D0 измерено около `4,95 В`, а ESP RX — 3,3-вольтовый вход.
- Следующий тест: низкоомный делитель 750 Ом / 1,5 кОм из имеющихся резисторов 1,5 кОм и проверка фактического HIGH до подключения ESP.

## 2026-09-20 — первая успешная полная прошивка ESP8266

- Перед успешной попыткой внешний UART-делитель был удалён, а непосредственно между `ESP VCC` и `ESP GND` установлен `100 µF 10 V`.
- Upload Speed установлен `115200`; при `Connecting...` выполнен ручной reset ESP (`RST → GND` кратковременно) при `GPIO0 = LOW`.
- Esptool определил `ESP8266EX`, flash `4 MB`; запись прошла от 0 до 100%, записано `269712` байт, затем получено `Hash of data verified`.
- Это первая воспроизводимая успешная запись flash физического ESP8266.
- Поскольку одновременно изменились два фактора (удалён делитель и добавлен 100 µF), корневая причина прежних `C100/0107` не считается однозначно установленной.
- Прямое `Nano D0 ≈ 4,95 В → ESP RX` не принимается как штатное решение и должно быть отключено после диагностической прошивки; безопасное согласование programmer UART остаётся отдельной задачей.

## 2026-09-20 — первый успешный запуск пользовательской прошивки ESP8266

- После успешной записи flash ESP переведён из режима прошивки в обычный boot: `GPIO0` убран с GND и подтянут HIGH через 4,7 кОм.
- Путь `Nano D0 → ESP RX` отключён; для чтения Serial оставлен `ESP TX → Nano D1` и общий GND.
- После перезапуска в Serial Monitor на `115200` получена строка `ARDU ESP8266 OK`.
- Подтверждено: flash-прошивка не только записалась, но и реально стартует на физическом ESP8266.
- Следующая проверка — активный Wi‑Fi с контролем питания/нагрева.

## 2026-09-20 — повторная попытка с безопасным делителем после успешной прошивки

- После подтверждённой успешной прошивки с локальным `100 µF 10 V` внешний делитель `1,5 кОм / 3,0 кОм` был возвращён для безопасного уровня RX.
- При сохранённом конденсаторе upload снова завершился ошибкой; конкретный код ошибки в сообщении пользователя не указан.
- Это усиливает гипотезу, что именно высокоомный programmer-path/качество соединения ухудшает UART-передачу. Следующий обратимый тест — делитель `750 Ом / 1,5 кОм`.

## 2026-09-20 — подтверждён ручной вход ESP8266 в bootloader

- На `Upload Speed = 57600` простое нажатие Upload не приводит к соединению: esptool остаётся на `Connecting...`.
- При `GPIO0 = LOW` краткий reset ESP (`RST → GND`, затем отпустить) запускает процесс загрузки.
- Вывод: текущая схема Nano USB↔UART не управляет reset/boot ESP автоматически; ручной reset является штатной процедурой стенда.

## 2026-09-20 — подтверждена повторяемая полная прошивка ESP8266

- При `Upload Speed = 115200`, локальном `100 µF 10 V`, временном прямом `Nano D0 → ESP RX` и `GPIO0 = LOW` прошивка снова проходит до `100%`.
- Для начала соединения требуется ручной краткий reset ESP: на этапе `Connecting...` замкнуть `RST → GND` и отпустить.
- Без ручного reset esptool не устанавливает соединение.
- Делитель `1,5 кОм / 3,0 кОм` при прочих близких условиях снова приводит к ошибке upload.
- Прямой 5-вольтовый путь не принимается как штатный из-за уровня около `4,95 В` на D0; следующий тест — низкоомный безопасный делитель.

## 2026-09-20 — начата реализация FW-0 Nano

- По решению владельца дальнейшая диагностика programmer-divider ESP8266 временно отложена.
- Создан `04_Прошивка/nano_fw0/nano_fw0.ino`.
- Реализованы: Serial `115200`, фиксированный входной буфер без `String`, неблокирующий разбор строк, `PING→PONG`, `STATUS`, `HELP`, структура базовых настроек и централизованная карта пинов.
- D6/D7 при старте удерживаются LOW, чтобы будущие DATA-линии WS2812B не выдавали случайных импульсов до FW-1.
- Физическая компиляция/загрузка на Nano и критерий `ARDU NANO FW0 READY` ещё не подтверждены владельцем.

## 2026-09-20 — FW-0 Nano компилируется, первая загрузка не прошла

- Компиляция `04_Прошивка/nano_fw0/nano_fw0.ino` успешна: `2514/30720` байт flash, `254/2048` байт SRAM.
- Upload завершился десятью предупреждениями `not in sync: resp=0x41` и ошибкой открытия `COM3` для programmer.
- Так как `0x41` = ASCII `A`, возможна помеха от всё ещё подключённого ESP, который ранее выводил `ARDU ESP8266 OK`; это требует проверки проводки, а не считается подтверждённой причиной.

## 2026-09-20 — ESP отключён, `resp=0x41` сохраняется

- Nano повторно прошивалась изолированно: D0/D1 свободны, `RESET→GND` снят, Serial Monitor закрыт.
- Ошибка `not in sync: resp=0x41` сохранилась без изменений.
- Помеха от ESP8266 исключена как причина этой конкретной ошибки.
- Следующий диагностический шаг — `ATmega328P (Old Bootloader)`.

## 2026-09-20 — FW-0 Nano успешно закрыт

- Для фактической Mini-USB Nano подтверждён загрузчик `ATmega328P (Old Bootloader)`; с обычным вариантом upload выдавал `not in sync: resp=0x41`.
- `nano_fw0.ino` успешно загружен.
- Команда `PING` возвращает `PONG`.
- Команда `STATUS` вернула `STATUS FW=FW0 POWER=OFF BRIGHTNESS=32 UPTIME_MS=127729`.
- Критерий FW-0 выполнен: Nano стабильно стартует и отвечает на диагностические команды.
- Создан `04_Прошивка/nano_fw1/nano_fw1.ino`: один канал WS2812B на D6, F01 постоянный цвет, яркость, ON/OFF, лимит мощности 500 мА и Serial-команды диагностики.

## 2026-09-20 — FW-1 успешно компилируется

- `nano_fw1.ino` успешно прошёл Verify/Compile на выбранной Mini-USB Nano-конфигурации.
- FastLED доступна и код одного кольца/F01 собирается без ошибок.
- Аппаратный критерий FW-1 ещё не выполнен; следующий тест — одно WS2812B-кольцо/первые 43 LED на D6 с отдельным 5 В питанием и общей землёй Nano.

## 2026-09-20 — FW-1 синхронизирован со схемой AlexGyver

- Владелец попросил придерживаться опробованных аппаратных схем исходного проекта ColorMusic/AlexGyver.
- Проверены официальные страницы AlexGyver ColorMusic и WS2812 guide.
- Подтверждено: на питание ленты ставится электролит минимум `1000 µF` (в общем гайде `1000–2200 µF`), а в DATA-линии используется отдельный последовательный резистор `200–500 Ом`.
- Временная рекомендация `1,5 кОм` в DATA для FW-1 отменена.

## 2026-09-20 — подтверждён электролит 1000 µF 6.3 V

- Владелец прочитал маркировку фактического конденсатора: `1000 µF 6.3 V`.
- Конденсатор принят для стенда FW-1 как буфер по питанию WS2812B на линии 5 В.

## 2026-09-20 — подготовлен DATA-резистор 220 Ом для FW-1

- Владелец подготовил резистор `220 Ом` для последовательной установки в линию `Nano D6 → DIN WS2812B`.
- Номинал соответствует принятому диапазону 200–500 Ом.
- Аппаратный FW-1 готов к сборке одного канала: 220 Ом в DATA + 1000 µF 6,3 V по питанию ленты.

## 2026-09-20 — FW-1 аппаратно пройден

- На одном канале D6 подключена WS2812B через `220 Ом`, питание ленты от S-30-5 с `1000 µF 6,3 V` на входе и общей землёй с Nano.
- FW-1 стартует и возвращает `STATUS FW=FW1 MODE=F01 POWER=ON BRIGHTNESS=32 RGB=32,0,0 LEDS=43 UPTIME_MS=11880`.
- Команды изменения F01 приняты с ответом `OK`; владелец подтвердил корректную работу.
- Критерий FW-1 выполнен.
- Подготовлен следующий слой `04_Прошивка/nano_fw2/nano_fw2.ino` для двух синхронных независимых DATA-каналов D6/D7.

## 2026-09-20 — физический тест второго кольца отложен

- После успешного FW-1 владелец выбрал продолжение разработки на одном кольце.
- D7 сохраняется как будущий зеркальный выход того же кадра, что D6.
- Отдельная настройка второго кольца не планируется; его аппаратная проверка будет выполнена после полной настройки первого.
- Подготовленный ранее FW-2 не удалён, но текущим этапом не является.

## 2026-09-20 — F01 одного кольца полностью проверен

- На физическом кольце D6 подтверждены `OFF`, `ON`, `BRIGHT 8`, `BRIGHT 64`, `STATUS`; владелец сообщил, что все команды работают.
- Однокольцевой F01 закрыт как воспроизводимый слой.
- Создан `04_Прошивка/nano_mic_test/nano_mic_test.ino` для следующего слоя MAX9814: A0, непрерывный сбор min/max/avg/p2p по 50-мс окнам и команда `MIC`.

## 2026-09-20 — первые реальные данные MAX9814

- MAX9814 на A0 выдаёт стабильное среднее около `249–252` ADC.
- Два 50-мс окна: `61..413, P2P=352` и `130..415, P2P=285`, по 251 отсчёту.
- DC-уровень соответствует ожидаемому смещению около 1,25 В; явного упора в границы ADC нет.
- Для корректного сравнения тишины/звука добавлен `MIC1S`, так как прежний `MIC` печатал случайное последнее 50-мс окно и мог пропускать хлопок.

## 2026-09-20 — MAX9814 уверенно реагирует на звук, обнаружен клиппинг при 60 dB

- 1-секундное окно в тишине: `AVG=252 MIN=108 MAX=417 P2P=309 SAMPLES=4998`.
- 1-секундное окно при громком звуке: `AVG=307 MIN=0 MAX=886 P2P=886 SAMPLES=4995`.
- Реакция микрофона подтверждена: амплитудный размах вырос почти в 3 раза.
- При плавающем `Gain` (60 dB) громкий сигнал достигает ADC=0, поэтому следующий тест — `Gain→GND` (50 dB).

## 2026-09-20 — ненормальный результат после Gain→GND

- После попытки установить MAX9814 в 50 dB через `Gain→GND` выход практически исчез: два 1-секундных окна дали `AVG=0`, `P2P=5` и `P2P=16`.
- Такое поведение не похоже на штатное уменьшение усиления; вероятна ошибка подключения/контакта.
- Принято сначала вернуться к ранее рабочей схеме с плавающим Gain и проверить восстановление DC-смещения около 250 ADC.

## 2026-09-20 — MAX9814 восстановился после снятия перемычки Gain

- После возврата `Gain` в floating при шуме измерено `AVG=278 MIN=0 MAX=508 P2P=508 SAMPLES=4996`.
- Работоспособность MAX9814/A0 подтверждена повторно.
- Аномальный нулевой выход возникал только при предыдущем подключении `Gain→GND`, поэтому перед новой попыткой смены усиления требуется проверить фактический вывод Gain и монтаж.

## 2026-09-20 — фото подтвердило распиновку MAX9814

- По крупному фото конкретного модуля подтверждён порядок контактов: `AR | Out | Gain | Vdd | GND`.
- Видимое рабочее подключение соответствует: Out=жёлтый, Vdd=зелёный, GND=синий; AR и Gain свободны.
- Это позволяет повторить 50 dB без неоднозначности: центральный Gain → крайний правый GND.

## 2026-09-20 — MAX9814 на 50 dB: клиппинг сохраняется

- Правильный `Gain→GND` подтвердился нормальным DC-offset: в тишине `AVG=250 MIN=85 MAX=360 P2P=275 SAMPLES=5000`.
- При громком звуке получено `AVG=260 MIN=0 MAX=507 P2P=507 SAMPLES=996`.
- Вывод: 50 dB снижает амплитуду, но громкий сигнал всё ещё достигает ADC=0. Следующий тест — 40 dB через `Gain→Vdd`.
- Отдельно замечено: во втором 1-секундном capture число samples снизилось до 996; повторно проверить на следующем тесте.

## 2026-09-20 — MAX9814, 50 dB: сравнение с лентой и без неё

- Тихое окно: `AVG=250 MIN=85 MAX=360 P2P=275 SAMPLES=5000`.
- Громкий шум при включённой ленте: `AVG=260 MIN=0 MAX=507 P2P=507`.
- Громкий шум без ленты: `AVG=257 MIN=0 MAX=506 P2P=506 SAMPLES=4991`.
- Вклад включённой WS2812B в измеряемый шум не обнаружен на уровне этого теста: амплитудные показатели практически совпадают.
- Клиппинг `MIN=0` остаётся при 50 dB; следующий тест — 40 dB (`Gain→Vdd`).

## 2026-09-20 — MAX9814 40 dB принят для M01, начат FW-5

- При `Gain→Vdd` получено: тишина `AVG=250 MIN=205 MAX=282 P2P=77`; громкий звук `AVG=250 MIN=0 MAX=503 P2P=503`.
- 40 dB даёт лучший запас по шуму среди проверенных настроек 60/50/40 dB; экстремальный хлопок всё ещё клиппует отрицательную полуволну.
- Для первого VU-режима это приемлемо: ColorMusic v2.10 оценивает максимум положительных ADC-отсчётов, а положительная амплитуда у нашего стенда уверенно отличается от тишины.
- FW-4/MAX9814 закрыт. Создан `04_Прошивка/nano_m01/nano_m01.ino` с калибровкой тишины и M01 VU-градиентом на одном 43-LED кольце.

## 2026-09-20 — M01 VU-градиент пройден на железе

- Калибровка тишины дала `QUIET_MAX=260`, `LOW_PASS=273`.
- Рабочая диагностическая строка: `PEAK=276 LOW_PASS=273 LEVEL=2.6 FILTERED=17.8 AVG=63.4 MAX=114.2 PAIRS=3`.
- Владелец подтвердил визуально корректную работу музыкального VU-градиента.
- M01/FW-5 закрыт.
- Создан минимальный следующий слой `nano_fht_test.ino` для проверки FHT и трёх частотных диапазонов до реализации M03/M04.

## 2026-09-20 — выбран точный FHT из ColorMusic вместо AvrFHT

- В Library Manager найдена только `AvrFHT`.
- Проверено: AvrFHT — модификация ArduinoFHT с изменённой архитектурой заголовков, поэтому не является прямой заменой `#include <FHT.h>` без правок.
- Для воспроизводимости с ColorMusic v2.10 выбран оригинальный каталог `libraries/FHT` из `AlexGyver/ColorMusic`.

## 2026-09-20 — FHT diagnostic переведён на AvrFHT

- Проверен репозиторий `KobaProduction/AvrFHT`; библиотека заявлена для AVR и основана на ArduinoFHT/Open Music Labs.
- Подтверждено, что AlexGyver ColorMusic действительно содержит старую FHT в `libraries/FHT`.
- `nano_fht_test.ino` адаптирован: `FHT_SAMPLES_N=64`, `fht_transform()`, `fht_mag_log()`, программное вычитание DC offset MAX9814.
- Следующий тест — установка AvrFHT через Library Manager, Verify/Compile и затем `CALF`/`FREQ`.

## 2026-09-20 — первая AvrFHT-калибровка дала ошибочный DC=914

- `CALF` выдал `DC=914 QUIET_MAX=32 SPECTR_LOW_PASS=35`; последующие `FREQ` выдавали нули.
- Значение DC=914 не согласуется с предыдущими прямыми измерениями MAX9814 (`AVG≈250`) и признано ошибкой диагностического кода/режима ADC, а не новым свойством микрофона.
- `nano_fht_test.ino` исправлен: DC offset измеряется на штатной скорости ADC, добавлена команда `ADC` для прямой проверки A0 до FHT.

## 2026-09-20 — AvrFHT: аномальный DC сохраняется после первого исправления

- Повторный `CALF` дал `DC=946 QUIET_MAX=33 SPECTR_LOW_PASS=36`.
- Два `FREQRAW` дали максимум 27 и 19.
- До интерпретации спектра требуется выполнить команду `ADC`: если она неизвестна — прошита старая версия; если работает и показывает ≈250 — ошибка остаётся внутри CALF/FHT-кода; если показывает ≈946 — проверяется физический OUT MAX9814/A0.

## 2026-09-21 — FHT остановлен из-за нулевого входа A0

- После повторной проверки Gain получено `CALF DC=0`, `QUIET_MAX=19`; `FREQRAW` дважды полностью нулевой.
- Это противоречит ранее подтверждённому MAX9814 DC bias около 250 ADC и указывает на проблему до спектрального анализа.
- Следующий минимальный тест: команда `ADC`; при нуле — снять только перемычку Gain→Vdd и повторить `ADC`, сохранив `Out→A0`.

## 2026-09-21 — обнаружена старая версия nano_fht_test на физической Nano

- Команда `ADC` вернула `ERR UNKNOWN_COMMAND`.
- Актуальный файл в репозитории содержит обработчик `ADC`, значит последняя исправленная версия фактически не была загружена на Nano.
- Предыдущие `CALF DC=0` / `FREQRAW=0` не интерпретировать до перепрошивки.

## 2026-09-21 — ADC-команда подтверждает почти нулевой сигнал A0

- После гарантированной загрузки текущего FHT-скетча `HELP` содержит `ADC`.
- `ADC AVG=0 MIN=0 MAX=13`.
- Это исключает FHT как первичную причину нулевого спектра: сначала требуется восстановить физический аналоговый выход MAX9814/A0.

## 2026-09-21 — MAX9814 подтверждён исправным мультиметром

- `Vdd→GND = 5,09 В`.
- `Out→GND = 1,24 В`.
- Это соответствует ожидаемому питанию и DC offset MAX9814 и локализует текущий `ADC=0` после выхода модуля: в проводе/контакте `Out→A0`, пине A0 либо дальше во входе Nano.

## 2026-09-21 — локализовано падение 1,24 В → 0,15 В на линии Out→A0

- На MAX9814 Out измерено 1,24 В.
- На Nano A0 одновременно измерено 0,15 В.
- Это подтверждает проблему соединения или ненормальную нагрузку входа A0; FHT/ADC-код дальше не диагностировать до восстановления этой линии.

## 2026-09-21 — восстановлена линия MAX9814 Out→Nano A0

- После исправления сигнального провода напряжение на Nano A0 стало `1,25 В` вместо `0,15 В`.
- Аппаратная причина нулевого ADC была в соединении Out→A0.
- Следующий тест — `ADC` текущего FHT-скетча, затем при нормальном AVG возврат к CALF/FREQ.

## 2026-09-21 — FHT-тракт впервые дал валидную реакцию на звук

- `ADC AVG=250 MIN=233 MAX=264` после исправления сигнального провода.
- `CALF DC=250 QUIET_MAX=61 SPECTR_LOW_PASS=64`.
- В тишине `FREQRAW LOW=19 MID=19 HIGH=16 PEAK=19`.
- При звуке `FREQRAW LOW=64 MID=30 HIGH=19 PEAK=64`.
- AvrFHT и программное удаление DC offset работоспособны. Полная проверка трёх диапазонов продолжается.

## 2026-09-21 — CALF переведён с абсолютного максимума на P90

- При `SPECTR_LOW_PASS=61` все `FREQ` были нулевыми, хотя `FREQRAW` показывал `PEAK=37`.
- Подтверждено, что абсолютный максимум 58 во время CALF завышает gate для текущего MAX9814.
- Реализована устойчивая к выбросам калибровка: 100 максимумов FHT-кадров, сортировка, `P90 + 3` как рабочий порог; абсолютный MAX остаётся только диагностикой.

## 2026-09-21 — повторно сверена оригинальная реализация FHT ColorMusic

- Установлено, что оригинал использует отдельный частотный вход A3 через конденсатор и абсолютный максимум +3 для spectrum noise gate.
- Текущий ARDU FHT-тест отличается аппаратным входом и опорой ADC; поэтому P90 помечен как экспериментальная адаптация, а не как перенос AlexGyver.

## 2026-09-21 — исследованы версии ColorMusic и MAX4466

- Подтверждён официальный changelog ColorMusic до v2.10.
- Найдена FireEdition — отдельная community-ветка Slenk/technotrasher с MIC/LINE и версиями до v3.1.
- Найдено прямое упоминание technotrasher о выборе MAX4466 для переработанной схемы, а также практическое обсуждение MAX4466 в FireEdition.
- Отдельной официальной AlexGyver-прошивки, явно предназначенной для MAX4466, не найдено.

## 2026-09-21 — направление возвращено к официальной поздней ColorMusic

- Владелец указал придерживаться поздних официальных AlexGyver ColorMusic.
- FireEdition/technotrasher остаются только референсом.
- Для конкретной базы сравниваются v2.7/v2.8/v2.10; основной кандидат — v2.10.

## 2026-09-21 — сохранена оригинальная FHT AlexGyver и поздние прошивки

- Полная текстовая копия `libraries/FHT/` из официального ColorMusic сохранена в ARDU вместе с примерами и лицензией; upstream pinned на `a3f94de053d431f15282c2f67681b77ab66c30ae`.
- Сохранены неизменённые `colorMusic_v2.7.ino`, `colorMusic_v2.8.ino`, `colorMusic_v2.9.ino`, `colorMusic_v2.10.ino`.
- Создан каталог исходных имён прошивок.
- `nano_fht_test.ino` переведён с AvrFHT на оригинальный API FHT ColorMusic.

## 2026-09-21 — устранён конфликт FHT `SCALE` ↔ FastLED

- Оригинальная FHT ColorMusic успешно находилась Arduino IDE, но её глобальный макрос `SCALE` конфликтовал с современным FastLED.
- `nano_fht_test.ino` получил локальный compatibility shim: `#undef SCALE` после FHT и до FastLED.
- Vendored `FHT.h` оставлен бит-в-бит без изменений.

## 2026-09-21 — оригинальная FHT успешно загружена на Nano

- Свежий `nano_fht_test.ino` с оригинальным `FHT.h` AlexGyver и `#undef SCALE` успешно скомпилирован и загружен.
- Этап совместимости legacy FHT ↔ modern FastLED закрыт.

## 2026-09-21 — original FHT runtime работает; CALF возвращён к ColorMusic v2.10

- Получено: `STATUS ... LIB=AlexGyver_FHT FHT_N=64 DC=390`.
- Получено: `ADC AVG=251 MIN=242 MAX=258`.
- Аналоговый вход исправен; ранний DC=390 признан некорректным для текущего сигнала.
- Экспериментальный P90 удалён. CALF снова реализует исходный принцип ColorMusic v2.10: абсолютный максимум 100 FHT-кадров по bins 2..31 + 3.
- Добавлена 500 ms пауза перед DC/шумовой калибровкой.

## 2026-09-21 — предыдущий DC=390 признан невалидным из-за отвалившегося A0

- Владелец уточнил, что сигнальный провод `Out→A0` отвалился во время прошлого теста.
- Поэтому `DC=390` не является валидным измерением нормального микрофонного тракта и не подтверждает проблему времени startup-калибровки.

## 2026-09-21 — штатный max+3 CALF заработал на оригинальной FHT

- `ADC AVG=265 MIN=259 MAX=272`.
- `STATUS DC=252` после старта.
- `CALF DC=264 QUIET_MAX=33 SPECTR_LOW_PASS=36`.
- `FREQRAW LOW=74 MID=82 HIGH=27 PEAK=82`.
- Это первый валидный запуск original FHT + original ColorMusic CALF после исправления A0 и перехода с AvrFHT.

## 2026-09-21 — noise gate FHT пройден

- Тишина после CALF=36: три последовательных `FREQ` дали 0/0/0.
- Звук: зафиксированы `LOW=38` и `LOW=66` выше порога 36.
- Gate работает. Следующая отдельная проверка — MID/HIGH контролируемыми тонами.

## 2026-09-21 — принято перейти с диагностического A0 на финальные A2/A3

- После сверки с ColorMusic v2.10 подтверждено, что официальный поздний код использует A2 для mono/VU и A3 для FHT через конденсатор.
- A0-only стенд сохраняет ценность как диагностика, но не переносится в финальную схему.

## 2026-09-21 — LOW/MID/HIGH подтверждены контролируемыми тонами на A0

- 2 кГц → только LOW, значения 84–92.
- 5 кГц → только MID, значение 92.
- 8 кГц → только HIGH, значения 68–78.
- На диагностическом A0 полностью подтверждены FHT, noise gate и разбиение диапазонов ColorMusic v2.10.

## 2026-09-21 — подготовлен A2/A3 diagnostic v2.10

- После полного FHT-pass на A0 создан отдельный следующий тест, чтобы не ломать подтверждённый baseline.
- Новый скетч использует A2 для VU, A3 для FHT и INTERNAL 1,1 V.
- Подготовлена физическая обвязка: разделительный C1, ~10 kΩ к GND и 10 nF A2→A3.

## 2026-09-22 — удалён ошибочно добавленный pull-down A2

- Сверка по официальной картинке схемы показала отсутствие резистора A2→GND.
- Ошибочная цепочка 2×4,7 kΩ удалена из проектной схемы и BOM.
- Сохранена точная цепь: Out→C1→A2; A2→103→A3.

## 2026-09-22 — исправлена ошибочная добавка 9,4 kΩ в аудиотракт

- После проверки официальной схемы владельца подтверждено: 2×4,7 kΩ A2→GND были ошибочно добавлены при интерпретации схемы.
- Реальная схема: Out→C1→A2 и A2→103→A3, без резистора на A2.
- 10–100 kΩ на рисунке — номинал отдельного AREF-потенциометра A0/REF/3V3.

## 2026-09-22 — финальный A2/A3 тракт впервые запущен на железе

- На физической Nano запущен `nano_audio_v210_test` с `A2` как VU и `A3` как FHT.
- `STATUS` подтвердил original FHT, `FHT_N=64` и `ADC_REF=INTERNAL_1V1`.
- Тишина: `ADC2 AVG=123 MIN=105 MAX=154`; `ADC3 AVG=745 MIN=726 MAX=779`.
- Оба ADC-канала живые и не насыщены; следующий тест — штатный `CALF` в тишине и gated `FREQ`.

## 2026-09-22 — CALF на A3 дал штатный порог

- Тишина: `QUIET_MAX=37`.
- Итоговый spectrum gate: `SPECTR_LOW_PASS=40`.
- Формула `max + 3` отработала как в ColorMusic; следующий шаг — gated `FREQ` в тишине.

## 2026-09-22 — gated FREQ в тишине на A3 пройден

- После `CALF=40` три последовательных `FREQ` дали `LOW=0 MID=0 HIGH=0 PEAK=0`.
- Noise gate на финальной A3-разводке подтверждён.
- Следующий шаг — повторить 2/5/8 кГц и подтвердить LOW/MID/HIGH.

## 2026-09-22 — регрессия 2/5/8 кГц на A3 дала нули

- На финальной A2/A3-разводке `FREQ` при 2, 5 и 8 кГц остался `0/0/0` при `LOW_PASS=40`.
- Следующий шаг переведён на `FREQRAW`, чтобы отделить слишком высокий gate от отсутствия полезного сигнала на A3.

## 2026-09-22 — FREQRAW 2 кГц на A3 совпал с quiet max

- Три раза при 2 кГц: `FREQRAW LOW=37 MID=19 HIGH=19 PEAK=37`.
- `PEAK=37` совпадает с `QUIET_MAX=37` из CALF, поэтому `LOW_PASS=40` корректно обнуляет сигнал.
- Следующая локализация: сравнить `ADC2/ADC3` под тем же тоном с тихими значениями.

## 2026-09-22 — ADC подтвердил прохождение 2 кГц через A2→103→A3

- 2 кГц: `ADC2=323 (294..418)`, `ADC3=853 (839..905)`.
- По сравнению с тишиной размах A2 вырос 49→124, A3 53→66.
- Полного обрыва A3 нет; следующий шаг — raw FHT на 5/8 кГц.

## 2026-09-22 — одинаковый raw FHT на 2/5/8 кГц; добавлена диагностика DC

- 5 и 8 кГц повторили результат 2 кГц: `LOW=37 MID=19 HIGH=19 PEAK=37`.
- Найдено отличие от пройденного A0-теста: там перед FHT вычитался `micDcOffset`; в текущем v2.10-тесте raw ADC идёт в FHT без центрирования.
- Добавлены команды `ADC3FAST` и `FREQRAWZ`; основной ColorMusic-путь не изменён.

## 2026-09-22 — ADC3FAST выявил насыщение при prescaler=32

- Под тоном: `ADC3FAST=1023/1023/1023`, `FREQRAWZ=0/0/0`.
- Причина нулевого zero-mean FHT: кадр уже полностью клиппирован до вычитания среднего.
- Сверка с официальной инструкцией AlexGyver показала, что внутренняя AREF 1.1 V при `POTENT=0` прямо обозначена как работающая не с любой громкостью.
- Следующий минимальный тест — `ADC3FAST` в тишине; затем при подтверждённом насыщении использовать имеющийся B10K для штатной внешней AREF.

## 2026-09-22 — добавлена проверка charge-up A3 на быстром ADC

- По datasheet ATmega328P источник ADC желательно держать низкоомным; текущий A3 после последовательного 10 nF не имеет явной DC-привязки.
- Community ColorMusic содержит практические варианты с 47 kΩ к GND и отдельным конденсатором на частотный вход, но это пока только внешние свидетельства, не проектное решение.
- В `nano_audio_v210_test` добавлены `ADC2FAST` и `ADC3TRACE` для сравнения A2/A3 при prescaler=32.

## 2026-09-22 — fast ADC saturation подтверждён на обоих аудиовходах

- Тишина: A2FAST `984 (831..1023)`; A3FAST `891 (768..1023)`; первые 16 быстрых A3 — все `1023`.
- Гипотеза «сломана только ветвь 103→A3» исключена.
- Подготовлен обратимый тест DC-привязки: по 9,4 kΩ от A2 и A3 к GND; не считать это штатной схемой до аппаратного результата.

## 2026-09-22 — создан отдельный сравнительный тест MAX4466

- Владелец решил проверить имеющийся MAX4466 вместо продолжения текущей диагностики MAX9814.
- Добавлен отдельный скетч и отдельная схема, не изменяющие MAX9814 baseline.
- В первом тесте OUT MAX4466 разводится на A2/A3 через две независимые ветви 9,4 kΩ; AREF=DEFAULT, DC subtraction выполняется программно для FHT.

## 2026-09-22 — первый MAX4466 ADC baseline около нуля

- STATUS: DC=7, DEFAULT 5V.
- ADC2=7 (1..12), ADC3=8 (4..12), ADC2FAST=8 (4..14), ADC3FAST=8 (4..15).
- Это исключает fast-ADC saturation, но не соответствует ожидаемому VCC/2 bias типичного MAX4466 breakout.
- Следующий тест — мультиметр прямо на VCC/GND и OUT/GND модуля.

## 2026-09-22 — MAX4466 OUT около 0 V при нормальном питании

- На модуле измерено `VCC≈5,1 V`, `OUT≈0 V`.
- До дальнейшего кода/FHT диагностика переведена на изолированный модуль: только VCC/GND, OUT полностью отключён от Nano.

## 2026-09-22 — MAX4466 исправен; внешний стенд тянул OUT вниз

- В изоляции: `VCC=5,1 V`, `OUT=2,55 V`.
- Это соответствует нормальному bias VCC/2.
- Диагностика возвращена к минимальной схеме: прямой OUT→A2 без резисторов и без A3.

## 2026-09-22 — прямой MAX4466→A2 устранил saturation, но ADC ниже ожидаемого

- Direct OUT→A2: ADC2=244 (208..293), ADC2FAST=230 (199..286).
- Fast ADC теперь нормален и близок к slow ADC.
- До FHT нужно сопоставить цифровой уровень с физическим напряжением OUT/A2 при подключённой Nano.

## 2026-09-22 — создан минимальный ADC sanity после несоответствия 2,55 V ↔ 244 counts

- OUT и A2 мультиметром одновременно = 2,55 V.
- ADC diagnostic показывает ~230–244, что несовместимо с DEFAULT ~5 V reference.
- Создан отдельный `nano_adc_sanity` без FHT и ручной настройки ADC.

## 2026-09-22 — MAX4466 не прошёл изоляционный тест

- При полностью свободном OUT и только VCC/GND измерено: `VCC≈5,1 V`, `OUT≈0,1 V`.
- Ожидаемый bias типичного MAX4466 breakout — около VCC/2.
- Сравнительный MAX4466 FHT-тест остановлен как аппаратно невалидный.

## 2026-09-22 — финальный audio frontend возвращён на рабочий A0

- Двухвходовый A2/A3 тракт ColorMusic не дал воспроизводимого частотного результата; быстрый ADC насыщался.
- Сравнительный MAX4466 не принят как основа после противоречивых аппаратных измерений; последнее измерение владельца в изоляции: OUT≈0,1 V при VCC≈5,1 V.
- Принят D-040: MAX9814 Out→A0 напрямую, DEFAULT AREF, software DC subtraction.
- Подготовлен единый диагностический скетч для VU + FHT на одном A0.

## 2026-09-23 — single-input A0 восстановлен, startup DC=467 признан невалидным

- Текущий MAX9814/A0: `AVG=237 MIN=225 MAX=250 P2P=25`.
- Startup status одновременно содержал `DC=467`, поэтому стартовая DC-калибровка не соответствует установившемуся входу.
- Для следующей проверки использовать `CALF` в тишине; в код добавлена отдельная команда `CALDC` для будущих запусков.

## 2026-09-23 — single-input CALF восстановлен

- `CALF DC=234 QUIET_MAX=33 SPECTR_LOW_PASS=36`.
- DC согласован с текущим ADC≈237; прежний startup DC=467 признан стартовым выбросом.
- Следующий шаг — gated FREQ в тишине и регрессия 2/5/8 kHz.
## 2026-09-24 — D-040: 2 кГц снова подтверждён на финальном A0/40 dB

- После обнаружения ошибочного подключения MAX9814 Out к D0 вместо A0 восстановлена схема `Out→A0`.
- На старой проверенной `nano_fht_test.ino`, при `Gain→Vdd` = 40 dB и `AR` floating: `CALF DC=249 QUIET_MAX=32 SPECTR_LOW_PASS=35`.
- На тоне около 2 кГц: `ADC AVG=251 MIN=92 MAX=407`; `FREQRAW LOW=89 MID=24 HIGH=19`, затем `LOW=80 MID=24 HIGH=19`; gated `FREQ LOW=89 MID=0 HIGH=0 PEAK=89 LOW_PASS=35`.
- **ФАКТ:** диапазон LOW на 2 кГц подтверждён чисто; следующий тест — 5 кГц → MID, затем 8 кГц → HIGH.

## 2026-09-24 — D-040: 5 кГц подтверждён как MID

- После тихой калибровки: `CALF DC=274 QUIET_MAX=33 SPECTR_LOW_PASS=36`.
- На тоне около 5 кГц: `FREQRAW LOW=19 MID=49 HIGH=19`, затем `LOW=19 MID=48 HIGH=19`; отдельный кадр дал `LOW=41 MID=50 HIGH=35`.
- Gated: `FREQ LOW=0 MID=68 HIGH=41 PEAK=68 LOW_PASS=36`.
- **ФАКТ:** 5 кГц корректно классифицируется как MID, но в одном gated-кадре остаётся заметная HIGH-составляющая; тест считается PASS по доминирующему диапазону, не как идеальная изоляция.
- Следующий тест — 8 кГц → HIGH.

## 2026-09-24 — D-040: 8 кГц пока ниже noise gate

- На 8 кГц при текущем `LOW_PASS=36` получено: `FREQRAW LOW=19 MID=19 HIGH=27`, `LOW=19 MID=24 HIGH=24`, `LOW=19 MID=24 HIGH=27`; gated `FREQ=0/0/0`.
- **ФАКТ:** максимум raw-спектра находится в HIGH, то есть направление классификации правильное, но уровень `24..27` ниже gate `36`.
- Этот результат пока не считать отказом FHT. Следующий минимальный тест — измерить `ADC` во время 8 кГц и сравнить размах с пройденным 2 кГц (`MIN=92 MAX=407`, P2P=315). Если 8 кГц даёт малый P2P, проверять уровень/источник тона; если P2P большой, разбираться в FHT/частоте выборки.

## 2026-09-24 — D-040: слабый 8 кГц локализован до FHT

- При звучащих 8 кГц прямой ADC дал: `AVG=250 MIN=228 MAX=274` (P2P=46), `AVG=247 MIN=222 MAX=270` (P2P=48), `AVG=245 MIN=219 MAX=272` (P2P=53).
- Для сравнения на пройденных 2 кГц было `MIN=92 MAX=407` (P2P=315).
- **ФАКТ:** на 8 кГц до FHT приходит значительно меньшая амплитуда; поэтому `FREQRAW HIGH=24..27` ниже gate=36 не доказывает проблему FHT.
- Следующий минимальный тест: не менять схему/40 dB/CALF; увеличить акустический уровень 8 кГц (громкость или уменьшить расстояние) до заметного роста ADC P2P и повторить `FREQRAW/FREQ`.

## 2026-09-24 — D-040: чистый повторный прогон 2/4/8 кГц после переподключения

- После переподключения стенда стартовый STATUS дал невалидный startup `DC=452`, при этом прямой `ADC AVG=252 MIN=241 MAX=263` подтвердил нормальный A0.
- В тишине выполнено `CALF DC=256 QUIET_MAX=33 SPECTR_LOW_PASS=36`; gated `FREQ=0/0/0` — noise gate пройден.
- 2 кГц: `ADC AVG=251 MIN=226 MAX=277` (P2P=51); `FREQRAW LOW=44/45/41 MID=24 HIGH=19`; gated `FREQ LOW=39 MID=0 HIGH=0`. **PASS LOW**.
- 4 кГц: `ADC AVG=250 MIN=225 MAX=277` (P2P=52); `FREQRAW LOW=19 MID=39/42/37 HIGH=19`; gated `FREQ LOW=0 MID=41 HIGH=0`. **PASS MID**.
- 8 кГц: `ADC AVG=249 MIN=224 MAX=277` (P2P=53); первый `FREQRAW LOW=19 MID=24 HIGH=33`. Амплитуда ADC практически такая же, как на 2/4 кГц, поэтому слабый HIGH уже нельзя объяснять слабой общей амплитудой входа. Нужны дополнительные raw/gated кадры 8 кГц перед выводом о gate/bin alignment.

## 2026-09-24 — D-040: 8 кГц классифицируется как HIGH, но находится у gate

- Без новой CALF и без переподключений на 8 кГц получено: `FREQRAW HIGH=41,40,38,33,38` при `LOW/MID≈19..24`, `LOW_PASS=36`.
- Gated кадры: один `FREQ LOW=0 MID=0 HIGH=38 PEAK=38`, затем два кадра `0/0/0`.
- **ФАКТ:** 8 кГц попадает в правильный диапазон HIGH; ошибочной классификации в LOW/MID нет.
- **ФАКТ:** peak HIGH колеблется вокруг порога 36, поэтому gate срабатывает нестабильно.
- Следующий минимальный тест: не менять схему и CALF; немного повысить акустический уровень только 8 кГц и повторить `ADC + FREQRAW + FREQ`. Если HIGH устойчиво >36, железо/FHT считаются пройденными, а дальнейшая работа переносится в настройку noise gate/режимов.

## 2026-09-24 — D-040: трёхполосная классификация на A0 закрыта

- Повторный 8 кГц тест без новой CALF: `ADC AVG=248 MIN=222 MAX=273`; `FREQRAW HIGH=35,37,42` при `LOW=19`, `MID=24`, `LOW_PASS=36`.
- Gated: один кадр `HIGH=38`, два последующих обнулены общим noise gate.
- **ФАКТ:** 8 кГц устойчиво классифицируется в HIGH; проблема не в выборе полосы, а в том, что уровень находится около общего спектрального порога.
- В официальном ColorMusic v2.10 тот же единый `SPEKTR_LOW_PASS` применяется ко всем bins до формирования LOW/MID/HIGH, после чего используются временные фильтры `colorMusic_aver[]` и `colorMusic_f[]` и порог вспышки относительно среднего. Поэтому одиночный диагностический `FREQ` является более жёстким тестом, чем реальный режим.
- **РЕШЕНИЕ:** D-040 по физическому single-input A0 и LOW/MID/HIGH классификации считать пройденным. Пограничную чувствительность HIGH настраивать уже в реальном музыкальном режиме, а не дальнейшими переподключениями.
- Следующий программный шаг: перенести подтверждённый A0 frontend и original-FHT обработку в первый частотный музыкальный режим, сохранив 40 dB, DEFAULT AREF, DC subtraction и текущие bins 2..5 / 6..10 / 11..31.

## 2026-09-24 — создан первый частотный музыкальный режим M03

- После закрытия D-040 создан `04_Прошивка/nano_m03/nano_m03.ino`.
- Основа M03: проверенный single-input `MAX9814 Out→A0`, DEFAULT AREF, программное вычитание DC, original AlexGyver FHT `FHT_N=64`, noise gate `max+3`.
- Из ColorMusic v2.10 перенесены частотные группы `2..5 / 6..10 / 11..31`, сглаживание `SMOOTH_FREQ=0.8`, `AVER_K=0.006`, динамический коэффициент вспышки `MAX_COEF_FREQ=1.2` и затухание `SMOOTH_STEP=20`.
- Визуальная схема M03 сохранена по смыслу оригинала: `HIGH → MID → LOW → MID → HIGH`; для 43 LED деление сделано пропорционально на пять зон, чтобы были отрисованы все LED.
- Текущий стенд остаётся однокольцевым: D6 активен, D7 принудительно LOW, лимит FastLED 500 mA, глобальная яркость по умолчанию 64.
- Добавлены диагностические команды `STATUS`, `ADC`, `CALF`, `BANDS`, а также `ON/OFF/BRIGHT/BACKGROUND`.
- **ФАКТ:** файл создан и сохранён в репозитории.
- **НЕ ПРОВЕРЕНО:** компиляция, загрузка и работа M03 на физической Nano/кольце. Следующий критерий — Verify/Compile.

## 2026-09-24 — M03 compile/upload пройдены

- Владелец открыл и загрузил `04_Прошивка/nano_m03/nano_m03.ino` на фактическую Mini-USB Nano; ошибок компиляции/загрузки не сообщено.
- **ФАКТ:** compile/upload M03 считаются пройденными.
- **НЕ ПРОВЕРЕНО:** runtime `STATUS/ADC/CALF/BANDS` и визуальная реакция пяти зон на LOW/MID/HIGH.
- Следующий минимальный тест: в тишине `STATUS → ADC → CALF → BANDS`.

## 2026-09-24 — M03 runtime baseline пройден

- После загрузки M03: `STATUS FW=M03 ... DC=450 ... CAL=NO`; startup DC признан невалидным до калибровки.
- Прямой вход: `ADC AVG=249 MIN=237 MAX=263 P2P=26`.
- В тишине: `CALF DC=256 QUIET_MAX=33 SPECTR_LOW_PASS=36`, что согласуется с прямым ADC.
- После CALF: `BANDS LOW=0 MID=0 HIGH=0 LP=36 BR=6,6,6 FLASH=0,0,0`.
- **ФАКТ:** M03 runtime baseline, A0/FHT, калибровка тишины и отсутствие ложных вспышек пройдены.
- Следующий критерий: 2 кГц → LOW и визуально центральная красная зона; затем 4–5 кГц → MID и 8 кГц → HIGH.

## 2026-09-24 — M03: 2 кГц попадает в LOW; постоянный тон не подходит для проверки flash

- На непрерывных 2 кГц после CALF получено три раза: `BANDS LOW=44/45/44 MID=0 HIGH=0 LP=36`.
- **ФАКТ:** частотная классификация M03 для 2 кГц корректна — сигнал проходит gate только в LOW.
- При этом `BR=6,6,6 FLASH=0,0,0` после длительного непрерывного тона ожидаемо для логики ColorMusic: `colorMusic_aver` медленно подтягивается к постоянному уровню, и вспышка возникает на росте относительно динамического среднего, а не на бесконечном стационарном синусе.
- Предыдущий критерий «непрерывный тон должен постоянно держать полосу яркой» уточнён: визуальную вспышку проверять на фронте тона/пульсирующем сигнале или реальной музыке.

## 2026-09-24 — M03 впервые визуально работает на кольце

- После подключения D6-кольца владелец подтвердил видимую реакцию M03 на тестовый тон: лента активно мигает.
- **ФАКТ:** цепочка `MAX9814→A0→FHT→M03→FastLED→D6` работает сквозным образом на физическом стенде.
- Наблюдение «мигает очень быстро» пока не считать дефектом: тест идёт на чистом непрерывном тоне, а M03 использует исходные параметры ColorMusic v2.10 `MAIN_LOOP≈5 ms` и `SMOOTH_STEP=20`, рассчитанные на музыкальные транзиенты.
- Следующий критерий — проверить поведение на реальной музыке при умеренной громкости; только после этого решать, требуется ли замедлять затухание/сглаживание.

## 2026-09-24 — M03: после подключения кольца CALF получил невалидный DC=11

- До подключения/визуального теста M03 прямой A0 был нормальным: `ADC AVG=249`, `CALF DC=256`.
- После подключения кольца и последующего `CALF` получено: `DC=11 QUIET_MAX=8 SPECTR_LOW_PASS=11`; `STATUS ... CAL=YES DC=11`.
- **ФАКТ:** этот CALF невалиден для рабочего MAX9814, ранее подтверждённый DC bias которого около 250 ADC.
- До дальнейшей светомузыки требуется проверить прямой `ADC` при `OFF` кольца. Если ADC снова около 250 — искать влияние питания/отрисовки; если около 0..20 — локализовать физический MAX9814 Out→A0/питание/землю.

## 2026-09-24 — создан независимый тест WS2812B на D6

- По запросу владельца создан `04_Прошивка/nano_strip_test/nano_strip_test.ino` для проверки ленты отдельно от M03 и аудиотракта.
- Тест не использует MAX9814, A0, FHT, RTC или ESP8266; D7 принудительно LOW.
- Параметры стенда: D6, 43 LED, GRB, яркость по умолчанию 32, FastLED current limit 500 mA.
- Команды: `STATUS`, `RED`, `GREEN`, `BLUE`, `WHITE`, `CHASE`, `OFF`, `BRIGHT <0..255>`.
- `CHASE` последовательно проходит по всем 43 LED и нужен для поиска пропуска/обрыва DATA-цепочки.
- **ПРОЙДЕНО 2026-09-25:** после объединения Nano GND с землёй ленты/БП физическая Nano успешно выполняет `RED`, `GREEN`, `BLUE`, `WHITE`, `CHASE`; базовый D6/43 LED тракт подтверждён.

## 2026-09-25 — изолированный тест WS2812B прошёл после объединения земли

- Владелец соединил `Nano GND` с общей землёй отдельно запитанной ленты / `S-30-5 V-`.
- `nano_strip_test` стартует штатно: `FW=STRIP_TEST PIN=D6 LEDS=43 MODE=OFF BRIGHTNESS=32 MAX_MA=500 D7=LOW`.
- На физическом кольце успешно проверены `RED`, `GREEN`, `BLUE`, `WHITE` и `CHASE`.
- **ФАКТ:** одно кольцо, DATA D6 через 220 Ω и адресация 43 LED исправны в изолированном тесте.
- **ПРЕДПОЛОЖЕНИЕ:** отсутствие общей земли было существенным фактором прежних самопроизвольных вспышек. Единственной причиной это не считается без контролируемого A/B-воспроизведения.
- `OFF` выдержан не менее 60 секунд без единой самопроизвольной вспышки.
- **ФАКТ:** изолированный WS2812B-тест на D6 полностью пройден после объединения земли.
- Следующий шаг: вернуть `nano_m03.ino`, оставить корректную общую GND и сначала проверить `OFF → ADC` до любой новой `CALF`; это отделит состояние MAX9814/A0 от влияния уже исправленного DATA/GND-тракта ленты.

## 2026-09-25 — M03 A0 нормализовался после исправления общей земли

- После полного прохождения изолированного теста WS2812B и восстановления общей земли `Nano GND ↔ S-30-5 V- ↔ GND ленты` загружен `nano_m03`.
- При `OFF` кольца команда `ADC` дала: `AVG=251 MIN=221 MAX=281 P2P=60`.
- **ФАКТ:** MAX9814/A0 снова находится в ожидаемом диапазоне и согласуется с ранее подтверждённым рабочим baseline ~234–256 counts.
- Предыдущий аномальный `CALF DC=11` на этом стенде сейчас не воспроизводится.
- Следующий минимальный шаг: `CALF` в тишине; принять только если новый `DC` остаётся близок к текущему A0.

## 2026-09-25 — M03 CALF валиден после восстановления общей земли

- В тишине после `ADC AVG=251` выполнен `CALF`.
- Результат: `CALF DC=250 QUIET_MAX=52 SPECTR_LOW_PASS=55`.
- **ФАКТ:** `DC=250` согласуется с непосредственным A0 baseline `AVG=251`; прежний невалидный `DC=11` устранён на текущем стенде.
- `QUIET_MAX=52` выше прежнего успешного baseline около 33, поэтому следующий тест — проверить, что gate=55 подавляет тишину до контролируемых тонов.

## 2026-09-25 — M03: тишина подавляется, фоновое свечение убрано отдельно

- После валидного `CALF DC=250 QUIET_MAX=52 SPECTR_LOW_PASS=55` включён M03.
- В тишине: `BANDS LOW=0 MID=0 HIGH=0 LP=55 BR=6,6,6 FLASH=0,0,0`.
- **ФАКТ:** noise gate работает: LOW/MID/HIGH и FLASH равны нулю; видимое бледное свечение было заданным фоном `BACKGROUND=6`, а не ложной реакцией на шум.
- Выполнено `BACKGROUND 0`; затем `BANDS LOW=0 MID=0 HIGH=0 LP=55 BR=0,0,0 FLASH=0,0,0`.
- **ФАКТ:** при `BACKGROUND 0` лента полностью гаснет в тишине и сохраняет реакцию на звуковые частоты.
- Следующий критерий M03: 2/5/8 kHz должны раздельно активировать LOW/MID/HIGH при текущем gate=55.

## 2026-09-25 — M03: 2 kHz корректно определяется как LOW

- При `BACKGROUND 0`, `SPECTR_LOW_PASS=55` и непрерывном тоне 2 kHz получено:
  `BANDS LOW=97 MID=0 HIGH=0 LP=55 BR=0,0,0 FLASH=0,0,0`.
- **ФАКТ:** частотное разделение для 2 kHz работает: активна только LOW-полоса.
- `BR/FLASH=0` в момент запроса не отменяет классификацию: эти поля отражают текущую динамическую яркость/триггер и могут успеть затухнуть при непрерывном ровном тоне.
- Следующий regression-тон: 5 kHz → MID.

## 2026-09-25 — M03: 4 kHz преимущественно MID, есть HIGH-компонент

- При непрерывном 4 kHz получены несколько кадров:
  - `LOW=0 MID=105 HIGH=57`;
  - `LOW=0 MID=106 HIGH=73`;
  - `LOW=0 MID=106 HIGH=77`;
  - `LOW=0 MID=106 HIGH=75`.
- **ФАКТ:** MID устойчиво является доминирующей полосой, LOW=0.
- HIGH находится чуть/заметно выше `LP=55` и иногда вызывает `FLASH HIGH`.
- **ПРЕДПОЛОЖЕНИЕ:** HIGH может соответствовать гармонике/искажению генератора/динамика/микрофонного тракта; калибровку и gate пока не менять.
- Следующий regression-тест — точный 5 kHz, затем 8 kHz.

## 2026-09-25 — M03: 5 kHz уверенно определяется как MID

- При непрерывном 5 kHz получено:
  - `BANDS LOW=0 MID=92 HIGH=56 LP=55`;
  - `BANDS LOW=0 MID=89 HIGH=56 LP=55`.
- **ФАКТ:** MID является доминирующей полосой; LOW=0.
- HIGH-компонент остаётся слабым и находится практически на пороге `LP=55`.
- Следующий regression-тон: 8 kHz → HIGH.

## 2026-09-25 — M03: 8 kHz подтверждает HIGH, regression 2/5/8 kHz закрыт

- При 8 kHz получены кадры:
  - `LOW=0 MID=0 HIGH=64 LP=55 ... FLASH=0,0,1`;
  - `LOW=0 MID=0 HIGH=55 LP=55`;
  - `LOW=0 MID=0 HIGH=81 LP=55 ... FLASH=0,0,1`.
- **ФАКТ:** 8 kHz попадает только в HIGH.
- Совместно с предыдущими тестами подтверждено:
  - 2 kHz → LOW;
  - 5 kHz → MID;
  - 8 kHz → HIGH.
- Базовое частотное разделение M03 на одном D6-кольце пройдено.
- Ненулевые `BR` в других полосах при текущих `BANDS=0` объясняются программным затуханием яркости и не являются текущей ошибочной классификацией.
- Следующий критерий M03: визуальная проверка на реальной музыке при `BACKGROUND 0`, затем переход к M04.

## 2026-09-25 — M03 «5 полос» полностью пройден на одном кольце

- Выполнена визуальная проверка на реальной музыке при `BACKGROUND 0`.
- **ФАКТ:** отображаются пять зон M03.
- **ФАКТ:** в паузах и полной тишине кольцо гаснет полностью; ложного постоянного свечения нет.
- Вместе с ранее подтверждёнными `2 kHz→LOW`, `5 kHz→MID`, `8 kHz→HIGH` критерий M03 закрыт.
- Проверенный frontend сохраняется без изменений: `MAX9814 Out→A0`, DEFAULT AREF, software DC subtraction.
- Следующий слой FW-6 — M04 «3 полосы» на одном D6-кольце.

## 2026-09-25 — подготовлен M04 «3 полосы»

- Создан `04_Прошивка/nano_m04/nano_m04.ino`.
- Аналоговый и FHT-тракт не менялись относительно полностью пройденного M03: `MAX9814 Out→A0`, Gain=40 dB, AR floating, DEFAULT AREF, software DC subtraction, FHT_N=64, диапазоны 2..5 / 6..10 / 11..31.
- Отрисовка взята из оригинальной логики ColorMusic v2.10 режима «3 полосы»: первая треть кольца = HIGH, средняя треть = MID, последняя треть = LOW.
- Для 43 LED это даёт 14 HIGH + 14 MID + 15 LOW по правилу целочисленного деления оригинального алгоритма.
- После подтверждённого владельцем поведения «тишина = полностью погашено» `DEFAULT_BACKGROUND` в M03 изменён с 6 на 0; M04 сразу создан с default 0. Команда `BACKGROUND <0..255>` остаётся доступной.
- **НЕ ПРОВЕРЕНО:** compile/upload/runtime M04 на физической Nano.
- Следующий шаг: Verify/Compile M04, затем Upload и `STATUS`.

## 2026-09-25 — M04 compile/upload и startup пройдены

- `nano_m04.ino` успешно скомпилирован и загружен на фактическую Arduino Nano с `ATmega328P (Old Bootloader)`.
- После старта получено `ARDU NANO M04 READY`.
- Стартовый STATUS: `FW=M04 MODE=M04 POWER=ON BRIGHTNESS=64 BACKGROUND=0 MIC=MAX9814 MIC_PIN=A0 MIC_GAIN=40DB AR=FLOAT ADC_REF=DEFAULT DC=250 SPECTR_LOW_PASS=40 CAL=NO LEDS=43 FHT_N=64`.
- **ФАКТ:** новый M04 запускается корректно и сохраняет проверенный A0/MAX9814 frontend; фоновая яркость по умолчанию = 0.
- Следующий минимальный шаг: `ADC`, затем только при нормальном A0 — `CALF` в тишине.

## 2026-09-25 — M04 A0 baseline валиден

- В тишине выполнен `ADC`: `AVG=249 MIN=243 MAX=256 P2P=13`.
- **ФАКТ:** A0/MAX9814 стабилен, среднее значение согласуется со стартовым `DC=250`, насыщения нет.
- Следующий шаг: `CALF` в тишине.

## 2026-09-25 — M04 CALF валиден, тишина подавляется

- В тишине выполнен `CALF`: `DC=251 QUIET_MAX=43 SPECTR_LOW_PASS=46`.
- **ФАКТ:** `DC=251` согласуется с предыдущим `ADC AVG=249`; калибровка A0 валидна.
- **ФАКТ:** в тишине кольцо не мигает.
- При близком микрофоне механические нажатия клавиш вызывают реакцию ленты; это соответствует реальному короткому звуковому импульсу и не считается ложной реакцией.
- Следующий тест: 2/5/8 kHz → LOW/MID/HIGH с визуальной проверкой трёх последовательных зон M04.

## 2026-09-25 — M04: непрерывный тон затухает из-за adaptive flash-логики

- При непрерывных 2/5/8 kHz владелец наблюдает начальное свечение, после чего кольцо полностью гаснет.
- **ФАКТ ПО РЕАЛИЗАЦИИ:** M04 сохраняет алгоритм ColorMusic v2.10: локально фильтрованный уровень сравнивается с медленным средним; при устойчивом постоянном тоне среднее адаптируется, `FLASH` прекращается, `thisBright/bandBrightness` затухает до `BACKGROUND=0`.
- Поэтому постоянный синус используется для проверки `BANDS`, а не как критерий постоянного визуального свечения.
- **ПРЕДПОЛОЖЕНИЕ:** одновременная вспышка нескольких зон в момент запуска тона связана с широкополосным фронтом/гармониками источника.
- Следующий тест: во время продолжающегося тона, уже после гашения, считать `BANDS` отдельно для 2/5/8 kHz.

## 2026-09-25 — M04: классификация 2/5/8 kHz пройдена

- После адаптивного гашения непрерывного тона владелец проверил `BANDS`.
- **ФАКТ:** классификация нормальная: 2 kHz→LOW, 5 kHz→MID, 8 kHz→HIGH.
- Это подтверждает, что частотный анализ M04 не теряет сигнал после визуального затухания.
- До полного закрытия M04 остаётся только визуальная проверка трёх последовательных зон на реальной музыке и полного гашения в паузе при `BACKGROUND=0`.

## 2026-09-25 — M04 полностью пройден, подготовлен M05

- Визуальная проверка M04 на реальной музыке пройдена: три последовательные трети кольца реагируют по частотным группам, в паузе при `BACKGROUND=0` кольцо полностью гаснет.
- **ФАКТ:** M04 «3 полосы» полностью закрыт на одном D6-кольце.
- Создан `04_Прошивка/nano_m05/nano_m05.ino`.
- M05 сохраняет проверенный frontend M04: MAX9814→A0, Gain=40 dB, DEFAULT AREF, software DC subtraction, original FHT, тот же noise gate.
- Подрежимы: `THREE`, `LOW`, `MID`, `HIGH`.
- В `THREE` сохранена оригинальная ColorMusic v2.10 логика приоритета вспышек: HIGH→MID→LOW; всё кольцо окрашивается в цвет выбранной полосы.
- Диагностическая команда: `SUBMODE <THREE|LOW|MID|HIGH>`; текущий подрежим выводится в `STATUS`.
- **НЕ ПРОВЕРЕНО:** compile/upload/runtime M05 на физической Nano.

## 2026-09-25 — исправлен compile conflict M05 с Arduino LOW/HIGH

- Первая компиляция `nano_m05.ino` завершилась ошибкой на `enum Submode { LOW, HIGH }`.
- **ФАКТ:** `Arduino.h` определяет `LOW` и `HIGH` как макросы цифровых уровней, поэтому эти идентификаторы нельзя использовать как enum members без конфликта препроцессора.
- Внутренние значения M05 переименованы в `LOW_ONLY`, `MID_ONLY`, `HIGH_ONLY`.
- Пользовательский протокол не изменён: команды остаются `SUBMODE THREE/LOW/MID/HIGH`, STATUS также выводит `THREE/LOW/MID/HIGH`.
- Следующий шаг: повторить Verify/Compile.

## 2026-09-25 — повторная M05 compile использовала старую unsaved-копию

- Ошибка компиляции снова указывает на `enum Submode` со старым `LOW` на строке 72.
- Актуальный GitHub-файл уже содержит `LOW_ONLY / MID_ONLY / HIGH_ONLY`.
- Путь ошибки: `.arduinoIDE-unsaved.../sketch_sep25a.ino`; следовательно Arduino IDE компилирует старую временную копию, а не обновлённый M05.
- Следующий шаг: открыть актуальный `04_Прошивка/nano_m05/nano_m05.ino` либо вручную заменить enum в текущем скетче, затем Verify.

## 2026-09-25 — введено явное версионирование исправлений прошивки; M05 = R2

- По решению владельца каждое исправление уже выданной/тестируемой прошивки получает новую ревизию.
- Первая M05 считается R1; она не компилировалась из-за конфликта `LOW/HIGH` с макросами Arduino.
- Исправленная версия оформлена как `04_Прошивка/nano_m05_r2/nano_m05_r2.ino`.
- Актуальный unversioned `nano_m05/nano_m05.ino` удалён из дерева, чтобы не путать ревизии; старая версия остаётся доступна через Git history.
- R2 печатает при старте `ARDU NANO M05 R2 READY` и в STATUS `FW=M05 REV=2`.
- Стабильный Mode ID остаётся `M05`; номер ревизии относится только к реализации прошивки.

## 2026-09-25 — M05 R2 compile/upload пройдены

- Владелец подтвердил успешную компиляцию и загрузку `04_Прошивка/nano_m05_r2/nano_m05_r2.ino` на фактическую Nano.
- **ФАКТ:** M05 R2 прошёл compile + upload.
- Runtime ещё не подтверждён; следующий критерий — startup `ARDU NANO M05 R2 READY` и `STATUS FW=M05 REV=2`.

## 2026-09-25 — M05 R2 runtime подтверждён

- Startup: `ARDU NANO M05 R2 READY`.
- STATUS: `FW=M05 REV=2 MODE=M05 POWER=ON BRIGHTNESS=64 BACKGROUND=0 SUBMODE=THREE MIC=MAX9814 MIC_PIN=A0 MIC_GAIN=40DB AR=FLOAT ADC_REF=DEFAULT DC=250 SPECTR_LOW_PASS=40 CAL=NO LEDS=43 FHT_N=64`.
- **ФАКТ:** на физической Nano запущена именно M05 R2.
- Следующий шаг: `ADC` в тишине.

## 2026-09-25 — M05 R2 A0 внезапно упал после нормального startup

- После startup `DC=250` команда `ADC` дала `AVG=10 MIN=6 MAX=28 P2P=22`.
- **ФАКТ:** это невалидный уровень для рабочего MAX9814/A0.
- Сверены M04 и M05 R2: `calibrateDcOffset()`, `analyzeAudio()`, `printAdc()`, ADC reference/prescaler setup идентичны.
- **ФАКТ:** явной программной регрессии в ADC frontend M05 R2 нет.
- Поскольку при startup `DC=250` был нормальным, а затем `ADC≈10`, вероятнее физический intermittent path/power/contact, но причина ещё не подтверждена.
- `CALF` запрещён до восстановления нормального A0.
- Следующий диагностический блок: `OFF` + повторные `ADC`; затем измерить MAX9814 Vdd, MAX9814 Out и Nano A0 относительно соответствующего GND.

## 2026-09-25 — M05 R2: повторно локализован обрыв/просадка пути MAX9814 Out→A0

- Измерено: `MAX9814 Vdd→GND=5,08 В`, `MAX9814 Out→GND=1,25 В`, `Nano A0→Nano GND=0,16 В`.
- **ФАКТ:** MAX9814 исправно питается и формирует нормальный bias на Out; A0 не получает этот уровень.
- Локализация: провод/контакт `Out→A0` либо низкоомная паразитная нагрузка A0.
- Это почти полностью повторяет аппаратный сбой 2026-09-21 (`Out≈1,24 В`, `A0≈0,15 В`), который тогда был устранён ремонтом провода/контакта.
- До восстановления `A0≈1,25 В` не выполнять `CALF`.

## 2026-09-26 — M05 R2 A0 восстановлен

- Повторный `ADC`: `AVG=250 MIN=241 MAX=262 P2P=21`.
- **ФАКТ:** MAX9814/A0 снова работает в нормальном диапазоне; насыщения нет.
- Предыдущий локализованный сбой пути `Out→A0` в текущем измерении не проявляется.
- Следующая проверка выполняется пакетом: `CALF` + `SUBMODE THREE/LOW/MID/HIGH`.

## 2026-09-26 — M05 R2: reset между подрежимами, DC ушёл в 1000; создан R3

- После `SUBMODE THREE`: `DC=255 SPECTR_LOW_PASS=68 CAL=YES UPTIME_MS=710801`.
- Позже `SUBMODE LOW/MID/HIGH/THREE` показывали `DC=1000 SPECTR_LOW_PASS=40 CAL=YES`.
- **ФАКТ:** уменьшение `UPTIME_MS` до `120349` доказывает перезапуск Nano между тестами.
- **ФАКТ:** `DC=1000` не соответствует рабочему MAX9814/A0; эти подрежимные результаты недействительны.
- Причина reset пока не подтверждена.
- R2 позволял выставить `CAL=YES` при заведомо неверном DC — это признано дефектом защиты калибровки.
- Создан `04_Прошивка/nano_m05_r3/nano_m05_r3.ino`.
- R3 отклоняет `CALF`, если DC вне `120..400`, печатает `ERR CALF_BAD_DC`, оставляет `CAL=NO` и выводит `DC_OK` в STATUS.

## 2026-09-26 — M05 R3 guard сработал, но A0 ещё кратко проваливается

- `STATUS`: `REV=3 DC=249 DC_OK=YES CAL=NO`.
- `ADC AVG=250 MIN=223 MAX=288 P2P=65`.
- Две `CALF` подряд были отклонены: `DC=26`, затем `DC=25`; защита вывела `ERR CALF_BAD_DC`.
- После этого три `CALF` подряд прошли валидно: `250/42/45`, `250/33/36`, `251/33/36` (DC/QUIET_MAX/LP).
- Финальный STATUS: `DC=251 DC_OK=YES LP=36 CAL=YES`.
- Uptime монотонно рос, reset в этой серии не было.
- Команды `SUBMODE THREE/LOW/MID/HIGH/THREE` приняты.
- **ФАКТ:** защитный механизм R3 подтверждён на железе.
- **ОТКРЫТО:** transient `DC≈25` снова указывает на intermittent analog path/contact; перед новым режимом нужна проверка стабильности A0.

## 2026-09-26 — ERR UNKNOWN_COMMAND коррелирует с активным FastLED show

- Владелец уточнил, что ошибка появляется при повторной отправке одной команды с небольшим интервалом.
- При `POWER=OFF` шесть подряд `ADC` успешно обработаны без ошибки.
- По документации FastLED на AVR clockless WS2812 вывод блокирует прерывания на время кадра; это может приводить к потере UART-байтов.
- **ПРЕДПОЛОЖЕНИЕ:** предыдущие `ERR UNKNOWN_COMMAND` были следствием повреждённой строки команды из-за UART/FastLED timing collision.
- Код пока не менять: сначала воспроизводимый ON/OFF A/B-тест; для финального UART предусмотреть ACK/retry.

## 2026-09-26 — M05 visual logic passed; UART errors reproduce only with active ring; R4 created

- Visual M05 submodes `LOW/MID/HIGH/THREE` confirmed correct by owner.
- With ring active, repeated Serial commands reproducibly produce `ERR UNKNOWN_COMMAND` / `ERR BAD_SUBMODE`.
- With `POWER=OFF`, six consecutive `ADC` commands completed successfully.
- Final R3 STATUS remained valid: `DC=249 DC_OK=YES LP=36 CAL=YES`, uptime increased normally.
- This isolates remaining defect to Serial/FastLED coexistence rather than M05 frequency logic.
- FastLED AVR docs: `FASTLED_ALLOW_INTERRUPTS` defaults to 0 on AVR and can be forced to 1 before including `FastLED.h`.
- Created `04_Прошивка/nano_m05_r4/nano_m05_r4.ino`:
  - `REV=4`;
  - `FASTLED_ALLOW_INTERRUPTS=1`;
  - `SERIAL_RX_GUARD_MS=5`;
  - main render skips starting a new `FastLED.show()` while Serial bytes are arriving;
  - STATUS exposes `FASTLED_IRQ=ON RX_GUARD_MS=5`.
- Hardware regression required: commands while ring continuously lit + LED visual stability.

## 2026-09-26 — M05 R4 полностью пройден; создан M08 R1

- При активно светящемся кольце UART stress-test R4 пройден без единого `UNKNOWN_COMMAND`/ `BAD_SUBMODE`.
- Владелец подтвердил визуальную стабильность WS2812B.
- **ФАКТ:** комбинация `FASTLED_ALLOW_INTERRUPTS=1` + RX guard 5 ms решила воспроизводимую проблему Serial/FastLED на текущем Nano/43 LED стенде.
- M05 R4 считается полностью пройденным на железе.
- Создан `04_Прошивка/nano_m08_r1/nano_m08_r1.ino`.
- M08 основан на оригинальном ColorMusic v2.10 running frequencies (mode 8 / internal case 7): активный цвет рождается в середине и двигается к краям.
- ARDU adaptation for 43 odd LEDs: один центральный pixel index 21; trail сдвигается от центра к обоим концам DATA-цепочки.
- Подрежимы: `THREE/LOW/MID/HIGH`; `THREE` priority = HIGH→MID→LOW.
- Параметр `SPEED 1..255` задаёт интервал шага в ms; default 11.
- M08 R1 наследует проверенный R4 UART transport fix и R3 DC/CALF guard.
- **НЕ ПРОВЕРЕНО:** compile/upload/runtime M08 R1.

## 2026-09-26 — M08 R1 полностью пройден; создан M09 R1

- Визуально подтверждены M08 `THREE/LOW/MID/HIGH`.
- `SPEED 5`, `20`, `50`, возврат `11` работают ожидаемо.
- Активный UART/FastLED regression пройден: последовательные STATUS без ошибок, uptime растёт.
- Финальные значения: `DC=250`, `DC_OK=YES`, `LP=36`, `CAL=YES`.
- **ФАКТ:** M08 R1 закрыт на железе.
- Создан `04_Прошивка/nano_m09_r1/nano_m09_r1.ino`.
- M09 основан на ColorMusic v2.10 analyzer case: 20 displayed bins, `HUE_START=0`, `HUE_STEP=5`, `LIGHT_SMOOTH=2`.
- Добавлена команда `SPEC` для печати 20 текущих peak-hold значений и `MAXF`.
- Для 43 LED выполнена симметричная odd-count adaptation с одним центральным LED.
- R4 transport fix и R3 DC guard перенесены без изменения.

## 2026-09-26 — M09 R1 полностью пройден; FW-6 закрыт; создан F02 R1

- M09 ADC: `251 / 231..274 / P2P 43`.
- CALF: `DC=251 QUIET_MAX=42 LP=45`.
- `SPEC` меняется по музыке, визуальный анализатор работает адекватно.
- `HUESTART/HUESTEP` подтверждены визуально и возвращены к defaults 0/5.
- Active-effect Serial regression пройден без ошибок; uptime монотонно растёт.
- **ФАКТ:** M09 R1 hardware pass.
- **ФАКТ:** весь FW-6 frequency layer закрыт на одном D6-кольце.
- Создан `04_Прошивка/nano_f02_r1/nano_f02_r1.ino`.
- F02 R1: ColorMusic light_mode=1, `HUE=0`, `SAT=255`, `SPEED_MS=100`, brightness 64; UART fix перенесён.
- Следующий критерий: Verify/Upload F02 R1 и визуальная проверка плавной смены цвета/скорости/насыщенности.

## 2026-09-26 — F02 R1 полностью пройден; создан F03 R1

- F02 визуально подтверждён.
- `SPEED 20` ускоряет цикл, `SPEED 200` замедляет; возврат 100 подтверждён.
- `SAT 80` / `SAT 255` визуально работают.
- `HUE 96` меняет текущую точку цикла; далее HUE продолжает двигаться.
- Active-effect STATUS burst прошёл без Serial errors; uptime растёт.
- **ФАКТ:** F02 R1 hardware pass.
- Создан `04_Прошивка/nano_f03_r1/nano_f03_r1.ino`.
- F03 R1 повторяет ColorMusic running rainbow: frame interval 30 ms, default hue shift 1 за frame, spatial step 0.5 hue/LED.
- Тестовый Serial interface: `SPEED 1..20`; `STEP10 5..100` хранит spatial step ×10.
- FastLED/UART fix перенесён.

## 2026-09-26 — F03 R1 пройден; создан AMBIENT R1

- Владелец подтвердил визуальную работу F03 R1 и всех запрошенных параметров.
- **ФАКТ:** F03 R1 hardware pass.
- Создан `04_Прошивка/nano_ambient_r1/nano_ambient_r1.ino`.
- Контроллер объединяет F01/F02/F03 и добавляет ручные `EFFECT/NEXT/PREV`.
- Добавлен автоперебор `AUTO ON/OFF` с `PERIOD 1..255` секунд; default 10 s, AUTO=OFF.
- При ручной смене эффекта auto timer начинается заново.
- Параметры эффектов хранятся отдельно, чтобы возврат к эффекту восстанавливал его последнее состояние.
- FastLED/UART fix перенесён.

## 2026-09-26 — AMBIENT R1 пройден; FW-7 закрыт; подготовлен RTC R1

- Владелец подтвердил интеграцию F01/F02/F03, NEXT/PREV и AUTO cycle.
- **ФАКТ:** FW-7 closed on one D6 ring.
- Создан `04_Прошивка/nano_rtc_r1/nano_rtc_r1.ino` — минимальный DS3231 hardware sanity test.
- Скetch использует `Wire.h` и прямые DS3231 registers, без внешней RTC library.
- Поддержаны I²C probe, чтение времени, temperature register, OSF/lostPower, ручной SET и очистка OSF.
- Создан `04_Прошивка/RTC_DS3231_WIRING.md`.
- Перед питанием RTC с установленной CR2032 остаётся обязательным D-017: удалить `201`. Выполнение этого аппаратного шага пока не подтверждено.

## 2026-09-26 — RTC R1 пройден; создан ALARM R1

- DS3231: `PRESENT=YES`, I²C `0x68`.
- Время до установки увеличивалось нормально: `00:01:33 → 00:01:43 → 00:02:04`.
- Температура: `29.50 °C`.
- `SET 2026-09-26 20:38:00` принят.
- После установки: `OSF=0 LOST_POWER=NO`, время продолжает идти.
- Владелец сообщил, что весь запрошенный RTC-тест выполнен успешно; D-017 (удаление `201`) и battery retention считаются подтверждёнными владельцем.
- **ФАКТ:** RTC R1 hardware pass.
- Создан `nano_alarm_r1`: ежедневный trigger без LED dawn, persistent alarm settings во внутренней EEPROM Nano.
- EEPROM format: magic/version/checksum + enabled + HH:MM + last-trigger date.

## 2026-09-26 — ALARM R1 пройден; создан DAWN R1

- Alarm settings пережили reset Nano: `20:50 / ON / SAVED=YES`.
- Ежедневный trigger: `EVENT ALARM_TRIGGER RTC=2026-09-26 20:50:00`.
- Повтор в `20:50:07` произошёл только после явной команды `ALARM CLEARLAST`, которая предназначена именно для снятия daily-trigger lock при повторных тестах.
- **ФАКТ:** ALARM R1 hardware pass.
- Создан `nano_dawn_r1`:
  - D6/43 WS2812B;
  - FastLED IRQ + RX guard;
  - manual accelerated `DAWN TEST`;
  - alarm-triggered real-duration dawn;
  - STOP and HOLD states;
  - persistent fade/max brightness/start hue/end hue.
- Active dawn reset recovery намеренно отложен на следующую итерацию.

## 2026-09-26 — DAWN R1 пройден; создан DAWN R2

- Владелец подтвердил DAWN R1 визуально и функционально.
- **ФАКТ:** manual accelerated dawn, parameter changes, STOP и alarm-start работают.
- Создан `nano_dawn_r2` с RTC-based reset recovery.
- R2 сохраняет runtime только на START/COMPLETE/STOP; прогресс после reset восстанавливается по DS3231, без частых EEPROM writes.
- Runtime source: ALARM/MANUAL/TEST.
- Добавлены `RUNTIME_SAVED`, `RECOVERED` и `EVENT DAWN_RECOVER`.
- Создан `DAWN_R2_TEST.md`.

## 2026-09-26 — DAWN R2 пройден; FW-8 закрыт; создан NIGHT R1

- TEST recovery: reset at ~19 s → `RUNNING / REMAINING_S=11` → complete on original 30-s timeline.
- HOLD and STOP persistence passed.
- ALARM recovery: reset during 60-s alarm dawn → `SOURCE=ALARM ELAPSED_S=19 REMAINING_S=41`; duplicate alarm trigger absent.
- **ФАКТ:** DAWN R2 hardware pass and FW-8 complete.
- Создан `nano_night_r1`:
  - constant HSV;
  - default OFF / HUE 24 / SAT 180 / brightness 18;
  - EEPROM persistence at offset 64;
  - restore ON/OFF and visual settings after reset;
  - FastLED/UART fix inherited.
- Schedule intentionally deferred.

## 2026-09-26 — по решению владельца NIGHT R1 заменён NIGHT R2 до hardware pass

- Отдельный NIGHT R1 hardware test не выполнялся.
- Создан `nano_night_r2`: базовый persistent nightlight + DS3231 schedule.
- Default schedule disabled; default times 22:00→07:00.
- Overnight interval supported with `[ON, OFF)` semantics.
- Manual ON/OFF disables schedule; visual parameter changes do not.
- Schedule transitions derive effective power from RTC without EEPROM writes.
- RTC-invalid fail-safe while schedule enabled = light OFF.

## 2026-09-27 — FW-9 закрыт; подготовлен M02 R1

- Владелец подтвердил, что полный тест NIGHT R2 schedule сработал; FW-9 закрыт.
- Владелец изменил порядок следующей работы: сначала отдельно M02, затем M06, и только после их pass — единая Nano-прошивка.
- Создан `04_Прошивка/nano_m02_r1/nano_m02_r1.ino`.
- M02 R1 основан на уже пройденной VU-логике M01 и Rainbow rendering ColorMusic v2.10.
- Wiring не меняется: MAX9814 Out→A0, Gain→Vdd 40 dB, AR floating, D6 = одно кольцо 43 LED, D7 LOW.
- В M02 R1 добавлены `ADC`, DC guard 120..400 для CAL, `SMOOTH 5..100`, `RAINSTEP10 5..200`, default BACKGROUND=0 и FastLED/UART guard из M05 R4.
- Создан `04_Прошивка/M02_R1_TEST.md`.
- Компиляция, upload и hardware pass M02 R1 пока не выполнены.

## 2026-09-27 — добавлены обычный свет, clap control и RTC clock UI

- Владелец добавил обязательное отображение в приложении фактического времени DS3231.
- Владелец добавил отдельный режим обычного освещения на WS2812B.
- Принят стабильный ID `L01` и верхний раздел `light`.
- Требование cold power-on: после появления питания от второй клавиши 230 В L01 включается автоматически.
- Добавлено требование хлопкового выключателя на MAX9814; приложение должно позволять включать/отключать clap control.
- Точная схема распознавания хлопков не выбрана до аппаратного теста из-за риска ложных срабатываний на музыку/речь.
- Создан `04_Прошивка/LIGHT_CLAP_REQUIREMENTS.md`.
- Обновлены документы режимов, приложения, API, stable IDs и протокола.
- План перед полной интеграцией расширен: после M02 и M06 отдельно закрыть L01 и clap detector.

## 2026-09-27 — M02 R1 compile + upload passed

- Владелец подтвердил успешную загрузку `04_Прошивка/nano_m02_r1/nano_m02_r1.ino` на физическую Arduino Nano.
- Verify/compile и upload M02 R1 считаются пройденными.
- Hardware functional test ещё не выполнен.
- Следующий gate: Serial Monitor 115200 → startup/STATUS → `ADC`. К `CAL` переходить только если `ADC AVG` находится в защитном диапазоне 120..400 и STATUS показывает `DC_OK=YES`.

## 2026-09-27 — M02 R1 ADC gate passed

- M02 R1 runtime ADC: `AVG=250 MIN=226 MAX=274 P2P=48`.
- STATUS: `FW=M02 REV=1 MODE=M02 POWER=ON BRIGHTNESS=64 BACKGROUND=0 SMOOTH=30 RAINSTEP10=50 MIC=MAX9814 MIC_PIN=A0 MIC_GAIN=40DB AR=FLOAT ADC_REF=DEFAULT DC=249 DC_OK=YES CAL=NO LOW_PASS=300 ... UPTIME_MS=428374`.
- **ФАКТ:** MAX9814/A0 находится в валидном диапазоне; saturation отсутствует; DC startup согласуется с ADC AVG.
- В присланной строке STATUS поле `LEDS=43` визуально пришло как `LDS=43`. Пока считать возможным единичным пропуском байта/копирования, не объявлять UART regression failed; проверить повторными STATUS/AUDIO при активной ленте.
- Следующий шаг: полный M02 R1 hardware test, начиная с CAL в тишине.

## 2026-09-27 — M02 visual result and settings persistence decision

- Владелец сообщил, что M02 визуально работает корректно.
- На текущем стенде при BRIGHT=64 фон не виден ниже примерно BACKGROUND=35; с 35 начинает светиться.
- Это значение записано как hardware/UI observation, без изменения команды BACKGROUND 0..255.
- Владелец подтвердил требование: все настройки всех режимов должны переживать отключение питания и быть доступны/сохранены в приложении.
- Проверено по коду: M02 R1 хранит settings только в RAM; persistence в этой тестовой ревизии отсутствует.
- Создан `PERSISTENCE_V1.md`; общая Nano-прошивка обязана иметь versioned/checksummed EEPROM settings и wear-safe commit.

## 2026-09-27 — M02 R1 hardware pass; created M06 R1

- Владелец подтвердил CAL без ошибок.
- Владелец подтвердил UART stress-test M02 без ошибок.
- С учётом ранее подтверждённых визуальных тестов M02 R1 полностью закрыт на железе.
- Создан `nano_m06_r1` — отдельный ручной стробоскоп.
- R1 не стартует автоматически, boot state = OFF.
- Частота ограничена Nano до 0.5..3.0 вспышек/с, default 1.0.
- Тестовая яркость ограничена 1..128.
- Каждая ON-сессия auto-stop через 15 s; OFF действует немедленно.
- Подготовлен `M06_R1_TEST.md`.

## 2026-09-27 — M06 passed then removed; L01 R1 created

- Владелец подтвердил, что полный аппаратный тест M06 R1 прошёл успешно.
- После теста владелец решил полностью исключить стробоскоп из ARDU.
- M06 удалён из active mode list, приложения, persistence и текущего плана.
- Тестовые файлы `nano_m06_r1/nano_m06_r1.ino` и `M06_R1_TEST.md` удалены.
- История успешного теста сохранена только как исторический факт.
- Созданы `04_Прошивка/nano_l01_r1/nano_l01_r1.ino` и `04_Прошивка/L01_R1_TEST.md`.
- L01 R1: одно кольцо D6/43 LED, постоянный RGB-white, startup ON, BRIGHT, ON/OFF, 500 mA current limit, UART guard.
- Следующий критерий — Verify/Upload и hardware pass L01 R1.

## 2026-09-27 — L01 R1 passed; L01 R2 created

- Владелец подтвердил, что весь L01 R1 test прошёл.
- После R1 добавлено новое требование: ordinary light должен иметь регулируемую теплоту и произвольный цвет.
- Приняты app presets 2700 K / 4000 K / 6000 K + Kelvin slider + color picker.
- Принято сохранять startup L01 profile на Nano: color mode, Kelvin/RGB и brightness.
- Создан `nano_l01_r2` с EEPROM persistence.
- Kelvin mapping для WS2812B помечен как approximate visual mapping, не как измеренная CCT.
- Следующий hardware test — L01 R2 persistence после reset/power cycle.

## 2026-09-27 — L01 R2 compile + upload passed

- Владелец подтвердил успешную загрузку `04_Прошивка/nano_l01_r2/nano_l01_r2.ino` на физическую Nano.
- Compile/Verify + Upload L01 R2 пройдены.
- Следующий gate: полный Kelvin/RGB/persistence hardware test, включая SAVE→reset и SAVE→полное снятие/возврат питания.

## 2026-09-27 — L01 R2 passed; ring changed to 44 LED

- Владелец подтвердил, что весь L01 R2 test прошёл.
- Kelvin presets, custom RGB, brightness, SAVE/LOAD, reset restore и full power-cycle persistence подтверждены.
- Владелец увеличил физическое кольцо до 44 WS2812B.
- Владелец сообщил, что R2 2700 K недостаточно тёплый; желаемый 2700 K визуально соответствует прежнему R2 2200 K.
- Создан L01 R3: LED_COUNT=44; 2700 K mapping = RGB 255,170,87.
- До общей прошивки требуется адаптация всех 43-LED geometry assumptions.

## 2026-09-27 — L01 R3 passed; clap diagnostic prepared

- Владелец подтвердил успешный полный тест L01 R3 на 44 LED.
- Новый тёплый mapping 2700 K принят.
- Владелец решил не менять старые 43-LED скетчи; они сохраняются как исторические hardware-tested revisions.
- 44 LED будут учтены при сборке общей прошивки и новых слоях.
- Создан `nano_clap_diag_r1` для MAX9814/A0: quiet calibration, P2P threshold, impulse events, GAP_MS, статистика и false-positive tests.
- Создан `CLAP_DIAG_R1_TEST.md`.

## 2026-09-27 — CLAP DIAG R1 misses claps; R2 raw capture created

- R1 MAX9814 frontend валиден: DC=255, обычный ADC P2P=35.
- Mouse clicks вызвали несколько impulse candidates; P2P событий 181..417.
- Хлопки не дали EVENT при default THRESH=180.
- R1 на этом запуске был CAL=NO и детектировал только по P2P.
- Создан CLAP DIAG R2 с threshold-free CAPTURE на 3 s, отдельным peak deviation от DC и dual P2P/DEV event logic.
- Цель R2 — сначала измерить форму silence/click/clap/speech/music, затем выбирать single/double clap detector.

## 2026-09-27 — CLAP R2 shows outlier-dominated calibration

- Quiet average metrics: P2P=17, DEV=15.
- Rare quiet-window spikes reached P2P=366 / DEV=204 and inflated automatic thresholds to 732 / 408.
- CAPTURE maxima supplied by owner: P2P 503/507/505/506/318 and DEV 255/259/257/269/172.
- Conclusion: absolute max over a 3 s window is not a robust noise baseline; do not tune final detector from it.
- Next experiment uses R2 manual `THRESH 180 120` with 16-sample blocks before changing firmware again.

## 2026-09-27 — CLAP DIAG R3 fixes command-click contamination

- The R2 quiet calibration was contaminated by a strong transient consistent with the same mouse-click class already observed in R1.
- R3 adds 1500 ms settling delay for CALCLAP and arming commands.
- Thresholds now use quiet averages rather than absolute maxima.
- Candidate logic requires P2P+DEV and uses 250 ms lockout.

## 2026-09-27 — inspected AlexGyver Clap and GyverLamp2

- Найдена официальная `GyverLibs/Clap`.
- Clap определяет clap по последовательности derivative fronts: positive → negative ≤200 ms → return to neutral ≤200 ms.
- GyverLamp2 передаёт в Clap `VolAnalyzer.getRawMax()`, ставит threshold=250, sequence timeout=500 ms и переключает лампу по двум хлопкам.
- Создан отдельный ARDU diagnostic с этой архитектурой без управления LED.

## 2026-09-27 — Gyver clap R1 threshold mismatch on MAX9814

- GYVER R1 не реагировал на хлопки при GyverLamp2 threshold=250.
- Startup DC был ложным 1019, хотя последующий ADC давал AVG=250; startup ADC timing исправляется в новой ревизии.
- Проверено: GyverLibs/Clap имеет собственный default threshold=150.
- Создан GYVER R2 с TRSH=150, valid startup DC procedure, baseline priming и command-click guard.

## 2026-09-27 — Gyver clap R2 startup fixed

- R2 uploaded and running.
- Startup DC=252 / DC_OK=YES; later ADC AVG=250, P2P=226.
- EVENT CLAP_READY confirms command-click ignore window completed.
- Next test is clap recognition at derivative threshold 150, then TRACE if no clap event.

## 2026-09-27 — Gyver R2 recognizes clap; tune derivative threshold

- GYVER R2 успешно распознал часть реальных хлопков.
- Пропущенные хлопки показали rawMax rises порядка 85..87, сильный распознанный — порядка 244.
- Default GyverLib threshold 150 остаётся слишком высоким для части хлопков на текущем MAX9814.
- Следующий обратимый test без новой прошивки: `TRSH 80`.

## 2026-09-27 — Gyver R2 TRSH=80 partial double-clap pass

- Single clap sensitivity improved at threshold 80, with extra single false positives.
- Single-clap test produced 14 single sequences and 0 double sequences.
- Double-clap test produced at least 4 confirmed DOUBLE_CLAP events but owner reports roughly every-other-pair reliability.
- Successful detected pair gaps were about 141..291 ms.
- Next reversible tuning step: threshold 70 only; keep timeout 500 ms fixed.

## 2026-09-27 — created app-ready family clap calibration

- Владелец потребовал учитывать нескольких детей с разной силой хлопка.
- Создан CLAP GYVER R3 CAL: guided quiet + multi-user double-clap sampling, suggested threshold, test-before-save, EEPROM persistence.
- Calibration protocol спроектирован так, чтобы ESP/app позже могли управлять им без raw Developer Mode.

## 2026-09-27 — started FW-10 CORE integration

- Owner accepted clap default 70/500 double-clap and deferred family calibration to app stage.
- Created `nano_fw10_core_r1`.
- First integration intentionally includes only L01/clap/RTC/Alarm/Dawn/Night on one physical D6 ring with 44 LED and 500 mA test cap.
- EEPROM map kept compatible: Alarm 0, Dawn 16/32, Night 64, L01 128, Clap 192; new core state starts at 224.
- Added reset policy: active unfinished Dawn recovers even after cold interruption; stale HOLD yields to L01 on cold power-on; warm reset restores prior mode.
- Created `FW10_CORE_R1_TEST.md`.

## 2026-09-27 — FW10 CORE R1 Arduino prototype ordering fix

- Owner reported compile errors for `LightPersist` and `ClapPersist`.
- Root cause was Arduino .ino generated prototypes appearing before those local type declarations.
- Moved both persistence structs into the common top-level type section; behavior unchanged.
- No other custom type is used before declaration in the current file.

## 2026-09-27 — FW10 CORE R1 compile passed

- After Arduino prototype-order fix, FW10 CORE R1 compiles successfully.
- Flash usage: 26014/30720 bytes (84%).
- Global SRAM: 1316/2048 bytes (64%), 732 bytes reported available for locals/stack.
- Memory budget becomes an explicit constraint before integrating FHT/music layers.
- Owner has Android Studio available for later mobile-app implementation.

## 2026-09-27 — FW10 CORE R1 L01/clap/reset/power passed

- Owner confirmed integrated ordinary light behavior works.
- L01 persistence, double-clap control, warm Reset restore, and cold power-on -> L01 all passed together in FW10 CORE R1.
- Next integration block is Night manual/schedule.

## 2026-09-27 — FW10 CORE R1 Night passed

- Owner confirmed Night manual controls and RTC schedule work correctly inside FW10 CORE R1.
- Reset persistence and manual override behavior also passed.
- Remaining CORE R1 block: Dawn recovery and Alarm integration.

## 2026-09-27 — moved integration regression to Android app stage

- Owner chose not to repeat already performed Dawn/Alarm manual tests before app development.
- Previous app-after-full-manual-regression order was superseded.
- Android Studio/Kotlin selected for the new native app.
- Created ESP8266 HTTP bridge R1 to expose Nano over home Wi-Fi, including Developer raw-command endpoint and async-event polling.

## 2026-09-27 — ESP8266 HTTP bridge R1 compiles

- ESP HTTP/UART bridge R1 compiles successfully for the project ESP8266 configuration.
- Memory: RAM 38%, IRAM 91%, flash 28%.
- Next step is physical upload and transport smoke test.

## 2026-09-27 — ESP8266 pre-upload voltages passed

- Measured before flashing HTTP bridge R1: S-30-5 5.01 V, YP-8 IN 5.01 V, YP-8 OUT 3.32 V, ESP VCC 3.24 V.
- Ground drop YP-8 GND→ESP GND = 0.00 V.
- GPIO0 in bootloader-low = 0.06 V; RST idle = 3.25 V.
- Power and boot-pin voltage gate passed.

## 2026-09-27 — ESP8266 HTTP bridge R1 flashed successfully

- Upload completed to 100% on physical ESP8266EX.
- Flash 4 MB auto-detected; hash verified.
- Next is normal boot + working UART + HTTP smoke test.

## 2026-09-29 — Nano TX → ESP RX divider voltage verified

- Working UART level divider was rebuilt compactly and checked.
- Nano TX is ~5 V, ESP RX is ~3.3 V relative to common GND.
- Measured TX-to-RX drop ~1.65 V, consistent with correct divider operation.
- Next: re-test HTTP→UART bridge with `/api/status`.

## 2026-09-29 — HTTP→ESP→Nano round trip passed

- `STATUS` returned FW10 CORE R1 over HTTP/UART with no timeout.
- `PING` returned `PONG`.
- `TIME` returned `ERR RTC_INVALID`, proving command transport is functional while RTC remains invalid.

## 2026-09-29 — ESP boot UART framing issue identified

- After an ESP restart, the first HTTP→Nano command once returned `ERR UNKNOWN_COMMAND` even though the JSON command field contained the correct `SET ...`.
- Root cause is consistent with ESP8266 ROM boot bytes on TX leaving a partial line in Nano's UART parser before the first normal command.
- HTTP bridge R1 source now sends a clean newline after Wi-Fi startup and drains the resulting stale Nano reply before starting HTTP service.
- This source change requires a later ESP reflash; current RTC verification can continue on the already-flashed build by simply repeating the first command after ESP restart.

## 2026-09-29 — RTC write restored

- After correcting the RTC wiring, remote `SET 2026-09-29 23:39:00` returned `OK TIME=2026-09-29 23:39:00`.
- No UART timeout occurred.
- Final confirmation is a `/api/time` read-back.

## 2026-09-29 — transport smoke gate fully passed

- RTC read-back after wiring repair: `TIME 2026-09-29 23:41:24`, `timed_out=false`.
- Together with verified `/api/ping`, `STATUS`, and `PING→PONG`, this closes the minimum ESP HTTP↔UART↔Nano↔RTC transport smoke test.
- Next implementation stage: native Android Studio/Kotlin app R1.

## 2026-09-29 — создан Android Studio/Kotlin app R1 transport layer

- После закрытия Wi-Fi/HTTP↔UART↔Nano↔DS3231 gate создан первый native Android/Kotlin project: `05_WiFi_и_приложение/android_app_r1/`.
- Transport вынесен в `ArduApiClient`; UI не выполняет HTTP напрямую.
- Реализованы `/api/ping`, `/api/status`, `/api/time` и Developer raw `POST /api/dev/nano`.
- Для текущего HTTP_BRIDGE_R1 приложение отображает raw Nano STATUS/TIME из фактического поля `nano`, не подменяя текущий transport bridge будущим semantic API.
- Обычный UI не показывает IP/UART; raw-команды находятся только в скрываемом Developer Mode.
- Добавлены Gradle wrapper, Android manifest/network config и `ANDROID_APP_R1_TEST.md`.
- `/api/events` оставлен на следующую малую итерацию.
- В текущем AI/runtime нет Android SDK, поэтому Gradle Sync/build/install и физический app transport PASS здесь не объявляются выполненными.

## 2026-09-29 — Android app R1 Gradle Sync passed

- Первый Android Studio sync остановился на AGP path check из-за non-ASCII символов в каталоге `05_WiFi_и_приложение`.
- В `android_app_r1/gradle.properties` добавлен `android.overridePathCheck=true`.
- После `git pull` владелец повторил Gradle Sync; Sync прошёл успешно.
- Build/install и физический app→ESP transport test ещё не выполнены.

## 2026-09-29 — Android app R1 physical launch passed

- После успешного Gradle Sync приложение R1 запущено из Android Studio на физическом Android-телефоне.
- Build/install/runtime startup прошли без ошибки, приложение открылось.
- Сетевой app→ESP transport ещё не считается пройденным до подтверждения `Online`, STATUS/TIME и Developer PING/PONG.

## 2026-09-29 — Android app R1 /api/ping passed

- На физическом Android-телефоне приложение R1 показало `Онлайн • HTTP_BRIDGE_R1`.
- Автоматический `GET /api/ping` из приложения до физического ESP8266 подтверждён.
- Следующая проверка — raw Nano STATUS, затем DS3231 time и Developer raw PING.

## 2026-09-30 — Android app R1 /api/status passed

- На физическом телефоне app R1 успешно получил raw Nano STATUS через `GET /api/status`.
- Подтверждены поля: `FW=FW10_CORE`, `REV=1`, `LEDS=44`, `RING_A=D6`, `RING_B=DISCONNECTED_TEST`, `LIMIT_MA=500`, `RTC_VALID=YES`, `CLAP=ON`, `CLAP_TRSH=70`.
- Следующий app gate: `GET /api/time`, затем Developer raw `PING`.

## 2026-09-30 — Android app R1 /api/time passed

- На физическом Android-телефоне app R1 показывает фактическое время DS3231 через `GET /api/time`.
- После повторного обновления время увеличивается; `UPTIME_MS` Nano также растёт между запросами.
- Последний transport gate R1: Developer raw `PING` должен вернуть `PONG`.

## 2026-09-30 — Android app transport R1 closed

- Developer Mode на физическом телефоне: `PING` → `PONG`.
- Минимальный app transport R1 теперь полностью закрыт: ping, Nano STATUS, DS3231 time и raw Developer command пройдены через реальное приложение.

## 2026-09-30 — implemented L01 semantic stage 1

- Создан ESP8266 HTTP BRIDGE R2 как новая ревизия после hardware-tested R1.
- R2 добавляет semantic L01 read `GET /api/light/status` и первый write slice `POST /api/light/settings {"enabled":true|false}`.
- Semantic status формируется только после запросов Nano `STATUS` + `LIGHT STATUS`; Nano остаётся источником истины.
- ON/OFF преобразуется в `LIGHT ON` / `LIGHT OFF` и HTTP success возвращается только после ожидаемого ACK Nano.
- Android current project расширен пользовательским L01 блоком; raw `/api/dev/nano` остаётся только Developer Mode.
- Добавлен `ESP8266_HTTP_BRIDGE_R2_TEST.md`.
- R2 compile/upload и physical L01 test ещё не выполнялись.

## 2026-09-30 — deferred repeated ESP reflashing

- После подготовки HTTP_BRIDGE_R2 владелец указал, что рабочий стенд уже компактно спаян и повторная перепрошивка ESP требует нежелательного вмешательства в монтаж.
- Текущий L01 stage 1 переведён на Android compatibility adapter поверх уже hardware-tested HTTP_BRIDGE_R1.
- Android internally sends `LIGHT STATUS`, `LIGHT ON`, `LIGHT OFF` through existing `POST /api/dev/nano`; ordinary UI raw transport details are hidden.
- HTTP_BRIDGE_R2 source сохранён для будущего пакетного ESP update; физический R2 upload сейчас отложен.

## 2026-09-30 — prepared ESP HTTP_BRIDGE_R3 with OTA

- Owner requested manual Wi-Fi credentials directly in the local sketch because the current physical ESP no longer answers at the previous address and credentials were suspected.
- Created a new R3 instead of rewriting R1/R2.
- R3 contains explicit local placeholders for SSID, Wi-Fi password and OTA password.
- Added ESP8266 ArduinoOTA: hostname `ardu`, port `8266`, password authentication, OTA handle in main loop.
- Avoided Serial logging from OTA callbacks because ESP Serial is the live Nano UART transport.
- R3 keeps the startup UART framing fix and all R2 HTTP/L01 functionality.
- Physical compile/wired upload/OTA proof remain pending.

## 2026-09-30 — R3 superseded by R4 before hardware test

- Post-commit source QA against current ESP8266 WString API found that R3 placeholder comparison used an unsupported `String != F(...)` form.
- No owner compile/upload of R3 had been performed yet.
- Created R4 with `strcmp` placeholder checks and an explicit guard preventing Wi-Fi reconnect/OTA startup while credentials remain placeholders.
- R3 remains historical and must not be flashed.

## 2026-09-30 — GPIO2 pull-up retained; manual flash reset no longer required

- Owner reports current build has `ESP GPIO2 → 4.7 kΩ → 3.3 V`.
- This is accepted as the external HIGH pull-up for the ESP8266 boot-strap pin.
- Owner also reports ESP flashing now starts without the previous additional `RST→GND` pulse during `Connecting...`.
- Do not assume automatic DTR/RTS reset from this observation; the ESP may simply already be in UART bootloader after reset/power-up with GPIO0 LOW.

## 2026-09-30 — R4 Wi-Fi and OTA service came online

- Initial R4 Wi-Fi failure was caused by an incorrect SSID in the local sketch.
- After correcting SSID and reflashing, `/api/ping` at `192.168.0.4` returned `HTTP_BRIDGE_R4`, Wi-Fi connected, RSSI -57 dBm, and OTA ready on hostname `ardu`, port 8266.
- `ardu.local` still does not resolve from the Windows curl environment; this is treated as mDNS resolution only because direct IP HTTP works.
- Next: verify actual OTA upload over Wi-Fi.

## 2026-09-30 — OTA discovery passed; prepared HTTP_BRIDGE_R5 proof

- Arduino IDE now shows the network port `ardu 192.168.0.4` from the physically running HTTP_BRIDGE_R4.
- This closes the OTA discovery gate even though Windows `curl` still does not resolve `ardu.local`.
- Created `esp8266_http_bridge_r5/esp8266_http_bridge_r5.ino` as the first OTA-proof image.
- R5 keeps R4 behavior and changes only the externally visible `/api/ping` firmware identifier to `HTTP_BRIDGE_R5`, so a successful reboot can be proven unambiguously.
- Repository R5 contains only credential placeholders. Before OTA upload the owner must copy the same local Wi-Fi and OTA credentials used by the working R4 into the local R5 file.
- OTA upload itself is still pending; working UART/power wiring must not be changed.

## 2026-09-30 — first real Wi-Fi OTA upload passed

- Arduino IDE uploaded the prepared R5 image through network port `ardu 192.168.0.4` with password authentication.
- OTA authentication succeeded and the image transfer completed without changing GPIO0/RST/Nano RESET/UART wiring.
- After the ESP reboot, `GET http://192.168.0.4/api/ping` returned `fw=HTTP_BRIDGE_R5`, `wifi_connected=true`, `ota_ready=true`, hostname `ardu`, port `8266`.
- This proves that a new ESP firmware image can be installed over Wi-Fi and boot successfully.
- Remaining OTA gate: verify post-OTA Nano transport with `/api/status`, `/api/time`, and Developer `PING→PONG`.
- Security note: verbose Arduino upload output can expose the OTA password in the local command line. Do not paste or commit that secret; rotate it in a later local OTA revision.

## 2026-09-30 — post-OTA Nano transport regression passed

После успешной OTA-загрузки HTTP_BRIDGE_R5 владелец подтвердил:
- `GET /api/status` → `ok=true`, Nano: `FW=FW10_CORE REV=1`, `LEDS=44`, `RTC_VALID=YES`, `CLAP_TRSH=70`, `UPTIME_MS=2157794`;
- на момент проверки Nano находился в `MODE=DAWN`; это наблюдаемое состояние машины режимов, а не ошибка транспорта;
- `GET /api/time` → `TIME 2026-09-30 22:18:58`;
- Developer `PING` → `PONG`;
- все ответы `timed_out=false`.

Итог:
- первый реальный ESP OTA gate полностью закрыт;
- wired programmer path переведён в recovery-only;
- последующие штатные ESP revisions выполнять OTA;
- следующий функциональный этап — Android L01 на физическом HTTP_BRIDGE_R5.

## 2026-09-30 — Android L01 switched to semantic R5 API

- Physical `GET /api/light/status` on HTTP_BRIDGE_R5 passed.
- Returned state: `enabled=false`, `color_mode=kelvin`, `kelvin=2700`, `RGB=255,170,87`, `brightness=64`, `saved=true`, `dirty=false`.
- Updated Android `ArduApiClient` so normal L01 UI reads `GET /api/light/status` directly.
- L01 ON/OFF now uses `POST /api/light/settings {"enabled":true|false}`.
- After a write, existing MainActivity logic still rereads L01 state from the device.
- Raw `POST /api/dev/nano` remains only for Developer Mode.
- App version bumped to `0.3-l01-semantic-r1`.
- Physical Android read/write test remains pending.

## 2026-09-30 — Android semantic L01 read-only passed

- На физическом Android-телефоне приложение `0.3-l01-semantic-r1` подключилось к `HTTP_BRIDGE_R5`.
- Верх экрана показывает `Онлайн • HTTP_BRIDGE_R5`.
- Блок L01 показывает `Выключен • 2700 K • яркость 64`.
- Это совпадает с ранее подтверждённым прямым `GET /api/light/status`.
- Read-only semantic Android gate закрыт.
- Следующий gate: пакетный ON/OFF regression через `POST /api/light/settings`.

## 2026-09-30 — Android semantic L01 ON/OFF regression passed

- Владелец подтвердил полный ранее заданный пакетный checklist как PASS.
- Через обычный Android UI semantic `POST /api/light/settings` корректно переключает L01 ON/OFF.
- Выполнены три цикла ON→OFF.
- После ON общий Nano STATUS показывает `MODE=L01`; после OFF — `MODE=OFF`.
- После полного закрытия/повторного открытия приложения состояние перечитывается с Nano.
- Сохранённый профиль отображается как `2700 K / brightness 64`.
- Developer `PING` после regression возвращает `PONG`.
- L01 ON/OFF semantic integration закрыт.

Следующий слой реализован в репозитории:
- `HTTP_BRIDGE_R6` — atomic brightness + Kelvin preset writes;
- Android `0.4-l01-bright-kelvin-r1` — brightness slider + presets 2700/4000/6000.
- Physical R6 OTA/build/runtime ещё не проверены.

## 2026-09-30 — R6 brightness/Kelvin Android block passed

- Владелец OTA-загрузил HTTP_BRIDGE_R6 без изменения проводки.
- `GET /api/ping` после reboot вернул `fw=HTTP_BRIDGE_R6`, Wi-Fi connected, OTA ready.
- Два ручных Windows PowerShell вызова `curl.exe --data-binary` для JSON brightness/Kelvin вернули `R6_SUPPORTS_ENABLED_BRIGHTNESS_KELVIN_PRESETS_ONLY`.
- При этом владелец подтвердил: «в приложении все работает» — Android `0.4-l01-bright-kelvin-r1` физически управляет brightness и Kelvin presets через semantic endpoint.
- Поэтому R6 feature layer считается hardware-working через Android transport; direct curl discrepancy оставлен как shell/body quoting issue для тестовой команды, а не как дефект света/ESP transport.
- Для следующих JSON smoke-tests использовать PowerShell `Invoke-RestMethod`.

После этого по просьбе владельца тестовые итерации укрупняются: следующий gate объединяет arbitrary Kelvin + RGB + persistence.

## 2026-09-30 — prepared R7 complete L01 profile

- Создан `esp8266_http_bridge_r7`.
- R7 сохраняет R6 ON/OFF/brightness и расширяет `POST /api/light/settings`:
  - arbitrary Kelvin `1800..6500` → `LIGHT KELVIN`;
  - RGB → `LIGHT RGB`;
  - `persist_startup_profile=true` → `LIGHT SAVE`.
- Android обновлён до `0.5-l01-profile-r1`.
- Добавлены Kelvin slider, RGB controls, saved/dirty indicator и явная кнопка сохранения startup profile.
- EEPROM write не выполняется на каждом движении slider; persistence только по явной кнопке.
- Подготовлен один пакетный test с cold power-cycle.
- Compile/OTA/physical R7 ещё не подтверждены.

## 2026-09-30 — R7 complete L01 profile passed

Владелец подтвердил весь пакет R7 как PASS.

Подтверждено на физическом стенде:
- HTTP_BRIDGE_R7 загружен по OTA;
- Android `0.5-l01-profile-r1` работает;
- arbitrary Kelvin slider работает в диапазоне пользовательского теста;
- Kelvin presets работают;
- brightness работает;
- RGB red/green/blue test работает;
- explicit startup-profile save работает;
- cold power-cycle восстанавливает сохранённый L01 profile;
- после regression проектный baseline `2700 K / brightness 64` возвращён и снова сохранён;
- OFF→ON / Refresh / Developer PING regression пройден.

Итог: L01 color/brightness/profile/persistence integration закрыт.

Следующий незакрытый L01 feature — clap app control + family calibration. CORE R1 уже содержит runtime double-clap detector и persistent threshold/timeout, но app-ready CLAPCAL state machine пока находится только в отдельной diagnostic branch.

## 2026-09-30 — FW10 CORE R2 CLAPCAL source prepared

- Создана новая ревизия `04_Прошивка/nano_fw10_core_r2/nano_fw10_core_r2.ino`; R1 не переписывался.
- Интегрирован app-ready family CLAPCAL из отдельной R3 diagnostic branch.
- Добавлены команды:
  - `CLAPCAL START <3..12>`;
  - `SAMPLE`;
  - `FINISH`;
  - `SAVE`;
  - `STATUS`;
  - `CANCEL`.
- Calibration переиспользует A0, runtime RawEnvelope/ClapDetector и существующий EEPROM `CLAP_BASE=192`.
- Для sample-strength detector используется второй маленький объект того же класса, а не вторая независимая audio architecture.
- Normal runtime clap при active calibration приостанавливается.
- Создан `FW10_CORE_R2_CLAPCAL_TEST.md`.
- Из-за baseline CORE R1 flash 84% следующий gate строго compile-budget; Upload до него запрещён.

## 2026-09-30 — CORE R2 first compile passed but budget too tight

Владелец выполнил Verify `nano_fw10_core_r2.ino`.

Результат:
- flash: `29788 / 30720 bytes` = 96%;
- свободно flash: `932 bytes`;
- globals SRAM: `1445 / 2048 bytes` = 70%;
- свободно для stack/locals: `603 bytes`.

Сравнение с CORE R1:
- flash было `26014`; рост = `+3774 bytes`;
- globals было `1316`; рост = `+129 bytes`.

Компиляция технически PASS, но проектный budget gate не принят:
- 932 bytes flash недостаточно для будущей интеграции Ambient/Music;
- Upload R2 до оптимизации запрещён;
- EEPROM layout/поведение менять не требуется — сначала уменьшить код CLAPCAL/diagnostics и повторить Verify.

## 2026-09-30 — FW10 CORE R3 compact CLAPCAL prepared

После CORE R2 compile 96% создана новая ревизия R3; R2 не изменялся и не загружался.

Оптимизации:
- один `ClapDetector` переиспользуется runtime/calibration;
- вместо 24 clap-strength значений хранится до 12 weak pair strengths;
- top-2 sample candidates считаются на лету;
- quiet P99: 32×uint8 histogram / 20 ms sampling вместо 64×uint16;
- сокращены CLAPCAL diagnostics и HELP;
- EEPROM `CLAP_BASE=192` и persisted threshold/timeout format сохранены;
- D-068 сохраняется: quiet baseline на Nano, sample strengths на Nano, suggested threshold на Nano, RAM-before-SAVE, CANCEL.

Static structure/balance scan пройден. Следующий gate — Verify R3 и фактический memory report. Upload до него запрещён.

## 2026-09-30 — CORE R3 compile budget accepted for CLAPCAL hardware test

Verify `nano_fw10_core_r3`:
- flash `27822 / 30720` = 90%;
- flash free = `2898` bytes;
- globals `1392 / 2048` = 67%;
- reported free SRAM = `656` bytes.

Сравнение:
- R1: 26014 flash / 1316 globals;
- R2: 29788 flash / 1445 globals;
- R3: 27822 flash / 1392 globals.

R3 экономит относительно R2:
- 1966 bytes flash;
- 53 bytes globals.

Решение:
- R3 разрешён для аппаратного CLAPCAL integration test;
- это НЕ финальное закрытие memory budget для Music/Ambient;
- после functional CLAPCAL pass перед full Music/Ambient integration потребуется отдельный общий memory optimization/budget этап.

## 2026-09-30 — CORE R3 upload attempt did not write Nano; CLAPCAL paused

- CORE R3 Verify: flash 27822/30720 (90%), globals 1392/2048 (67%).
- Owner attempted Nano upload on COM3 / ATmega328P Old Bootloader while the compact ESP↔Nano UART wiring remained in place and ESP was held in reset.
- avrdude returned repeated `programmer is not responding / not in sync: resp=0x00`.
- No successful flash write occurred; physical Nano therefore remains on the previously verified FW10 CORE R1.
- This failure is not a flash-size error. It is consistent with the already known Nano bootloader requirement that D0/D1 be isolated from the ESP during USB serial upload; merely holding ESP RESET low was not sufficient on this physical assembly.
- Re-evaluation: CLAPCAL is useful but not required to continue the app. FW10 CORE R1 already provides the accepted runtime double-clap baseline `TRSH=70 / TIMEOUT=500`, plus L01/Night/Alarm/Dawn/RTC.
- Current tactic: do not disturb the compact Nano wiring just for calibration. Keep CORE R2/R3 sources for a later deliberate Nano maintenance batch.

## 2026-09-30 — CORE R3 first upload attempt failed with resp=0x00

- Verify R3 повторно подтвердил: flash 27822/30720 (90%), globals 1392/2048 (67%).
- Arduino IDE использовал фактическую Mini-USB Nano конфигурацию: ATmega328P / Old Bootloader, COM3, avrdude baud 57600.
- Upload получил 10× programmer is not responding / not in sync: resp=0x00, затем завершился ошибкой.
- Bootloader handshake не состоялся; запись flash не подтверждена и Nano следует считать оставшимся на предыдущем FW10 CORE R1.
- Имя build artifact esp8266_http_bridge_r2.ino.hex отражает локальное имя reused sketch tab и не определяет содержимое/target; AVR memory report и avrdude target были Nano/ATmega328P.
- Следующий diagnostic: ESP Reset LOW, Nano RESET свободен, Serial Monitor закрыт, затем manual Nano reset точно в начале Upload. Только если это не поможет — временно разорвать одну линию ESP TX→Nano D0.

## 2026-10-01 — создан единый план финализации ARDU v1

- Владелец решил завершить проект без дальнейшей серии мелких firmware-upload итераций.
- Добавлен `FINALIZATION_PLAN.md`.
- Зафиксирован release-порядок: full Nano v1 → one Nano upload → full ESP v1 → one OTA upload → Android functionality → design/UX → second ring/power → ceiling install → acceptance.
- Промежуточный CORE R3 CLAPCAL больше не является текущим upload gate.
- Для финальной Nano release обязательны все активные Music/Ambient режимы, family CLAPCAL, full persistence, 44+44 output и runtime-adjustable safe current limit.
- Следующая работа — интеграция/оптимизация полного Nano v1 source без физического upload до завершения scope.

## 2026-10-01 — уточнена финальная потолочная разводка

Владелец сообщил:
- корпуса разделены примерно 2 м;
- существующая проводка скрыта в стенах и недоступна;
- у первого корпуса доступна потолочная точка бывшей люстры для размещения общего БП;
- существующая линия к корпусам 2×2,5 мм² и работала от одного выключателя;
- ко второму корпусу будет проложена новая low-voltage 5-V линия за потолком.

Проектная топология уточнена:
- S-30-5 + контроллерный узел у корпуса A;
- Ring A=D6 локально;
- Ring B=D7 через ~2 м;
- к Ring B новая трасса +5V/GND/DATA с reference GND;
- safety gate перед монтажом: проверить PE/FG требования конкретного S-30-5, потому что двухжильный ввод не подтверждает наличие PE.

## 2026-10-01 — фото подтвердило PE-клемму S-30-5

Владелец прислал крупные фото S-30-5.

Подтверждено:
- металлический корпус;
- клеммы L, N, защитное заземление ⏚, -V, +V;
- PE-клемма сейчас не подключена.

Монтажное решение уточнено:
- текущий S-30-5 использовать в потолке только при подключённом защитном PE;
- N не использовать как PE;
- если отдельный PE недоступен при существующем 2-жильном вводе, заменить блок питания на Class II/double-insulated 230→5 V подходящей мощности.

## 2026-10-01 — S-30-5 исключён из потолочного монтажа

- Владелец подтвердил: PE-проводника на потолке нет.
- По предыдущему фото S-30-5 имеет металлический корпус и PE-клемму.
- Финальное решение: S-30-5 оставить для стенда; в потолок установить Class II/double-insulated 230→5 V PSU.
- Firmware/app work продолжается без блокировки.

## 2026-10-01 — full Nano v1 reduced from 142% to 91% flash and CI passed

- Создан `nano_ardu_v1` с полным целевым scope.
- Первый интеграционный build: 43638/30720 flash (142%), globals 1975/2048 (96%).
- Выполнен целевой compact refactor без удаления обязательных пользовательских режимов.
- Основные изменения: compact DS3231 TWI вместо Wire, numeric UART v1, compact two-ring current limiter, compact events/calibration replies.
- Финальный текущий CI report: 28090/30720 flash (91%), 1070/2048 globals (52%), 978 bytes свободно для stack/locals.
- GitHub Actions run 15 прошёл SUCCESS.
- Physical Nano upload ещё не выполнялся; рабочее железо остаётся на FW10 CORE R1.

## 2026-10-01 — final ESP v1 implemented and both firmware compile gates closed

- После compact Nano v1 создан полный `esp8266_ardu_v1`.
- ESP переводит semantic HTTP API в frozen numeric UART v1.
- Добавлены full settings/status/time, L01, clap calibration, Music, Ambient, Night, Alarm/Dawn, current limit, async events и Developer numeric raw command.
- Static opcode scan: missing mappings = NONE.
- ESP8266 core 3.1.2 GitHub Actions compile passed.
- ESP memory: RAM 31988/80192 (39%), IRAM 60823/65536 (92%), IROM 324376 bytes.
- Nano persistence refinement: Night/Dawn slider fields больше не пишут EEPROM на каждом preview; добавлены opcodes 56/77 для commit.
- Nano repeated compile after change passed: 28024/30720 flash (91%), 1070/2048 globals (52%).
- Оба physical devices пока не обновлялись до release v1.
- Следующий этап — единый final upload + acceptance session.

## 2026-10-02 — Android functional v1 completed at source/CI level while replacement Nano is pending

- Владелец сообщил, что final Nano upload на текущую плату не получается; заказана новая Nano.
- Причина проблемы текущей платы не установлена, поэтому зафиксирован только upload blocker, без диагноза.
- Android network client переписан под final `ARDU_ESP_V1` API.
- Добавлен полный `/api/settings` parser и release data models.
- Реализованы Light, clap calibration wizard, Music M01/M02/M03/M04/M05/M08/M09, Ambient F01/F02/F03, Night schedule, Alarm/Dawn/RTC, current limit, events, numeric Developer Mode.
- Добавлено сохранение/ручной ввод адреса ARDU; mDNS не является единственной точкой подключения.
- Создан JVM mock HTTP contract test для final ESP JSON и semantic writes.
- GitHub Actions: contract tests PASS; debug APK assemble PASS.
- Версия приложения поднята до `0.9-functional-v1-rc1`.

## 2026-10-02 — stateful ESP v1 mock added

- Добавлен LAN mock final ESP API для ручной проверки Android до прихода replacement Nano.
- Mock stateful: semantic writes меняют settings/status, clap wizard и service endpoints работают без hardware.
- Отдельный GitHub Actions workflow проверяет syntax, ping/settings и stateful Music write/reread.
- Mock ESP Verify PASS.

## 2026-10-02 — Android functional RC manually connected to stateful ESP mock

- Владелец запустил stateful `ARDU_ESP_V1_MOCK` и Android app на физическом телефоне.
- Приложение успешно показало Online, firmware mock, semantic current mode, RTC time и раздел Alarm/Dawn.
- Скриншот подтверждает, что saved/manual address + LAN mock path работают на реальном телефоне.
- Mock manual smoke PASS.
- Следующий software этап до replacement Nano: visual design/UX polish.

## 2026-10-02 — Android v1 visual redesign completed

- Rebuilt `activity_main.xml` from engineering prototype into production-oriented dark UI.
- Added reusable ARDU color palette, card/button/input/navigation drawables and styles.
- Primary navigation is now fixed at the bottom and always fits the screen.
- Settings are separated from the five user modes.
- Added RGB/Hue previews for Light, Ambient, Night and Dawn colors.
- Added active bottom-tab state and Online/Offline visual status.
- Version bumped to `0.10-design-v1-rc1`.
- Final CI after style fix: contract tests PASS; debug APK build PASS.

## 2026-10-02 — Android Light screen moved to smart-home interaction model

- Owner feedback: v0.10 visual style accepted, but header consumed too much vertical space and controls should feel more like a modern smart-home app than a set of sliders.
- Implemented `0.11-home-ui-rc1`.
- Compact header replaces large status block and full-width Refresh button.
- Added quick Light scenes and ± brightness steps.
- Added custom native `ColorWheelView` for touch RGB selection; no third-party dependency.
- Existing RGB channel sliders remain available only as optional precise controls.
- Current brightness is shown as percent in the primary UI.
- ESP firmware/RSSI moved out of primary header into diagnostic summary.
- API contract and firmware remain frozen/unchanged.
- Contract tests PASS; debug APK PASS.

## 2026-10-02 — standard Light SeekBars replaced by custom smart sliders

- Owner feedback: smart-home Light functionality is good, but default Android sliders still look primitive.
- Added native `SmartSliderView`.
- Brightness uses semantic filled rounded track and large thumb.
- Kelvin uses full warm→neutral→cool gradient and Kelvin-colored thumb.
- Both controls preserve release behavior: preview is local while dragging, one semantic HTTP write on release.
- Version bumped to `0.12-smart-slider-rc1`.
- Contract tests PASS; debug APK build PASS.

## 2026-10-02 — smart-home UI propagated to Music/Ambient/Night/Alarm

- Owner approved Light smart-home direction and requested the same visual language on other tabs, with better font sizing and icon-only actions where obvious.
- Added HUE mode to reusable `SmartSliderView`.
- Replaced primary stock sliders throughout Music, Ambient, Night and Alarm/Dawn.
- Added selected-state choice cards for Music modes, Music submodes and Ambient effects.
- Compact action glyphs introduced where meaning is obvious (refresh/settings already present; Music/Ambient start/stop; Alarm save).
- Typography normalized across all user screens.
- A static ID check caught a broad XML replacement that had removed neighboring tags; layout was restored from clean v0.12 and the conversion was repeated safely tag-by-tag.
- Final layout validation: missing IDs = 0; duplicate IDs = 0.
- Version = `0.13-smart-home-tabs-rc1`.
- Final CI run 37056022090: unit contract tests PASS, debug APK build PASS.

## 2026-10-03 — final Android design direction approved and implemented

- Owner reviewed layout/theme collages and explicitly selected combined **Focus Dial + Home Hub** direction.
- Palette selection: current mint-dark remains preferred.
- Implemented Android `0.14-ios-homehub-focus-rc1`.
- Added native `FocusDialView` and `RoomHeroView`; no third-party UI dependencies and no image assets required.
- Light is now split at UI level into Home Hub overview and Focus Dial detailed control while using exactly the existing semantic API.
- Contextual hero scenes added to Music, Ambient, Night and Alarm/Dawn.
- Existing final functional controls preserved: RGB/color wheel, scenes, clap wizard, Music IDs/settings, Ambient, Night schedule, Alarm/Dawn, service/debug.
- Static layout contract: zero missing/duplicate IDs.
- Final Actions run 37062432020: API contract tests PASS; debug APK build PASS.

## 2026-10-03 — premium Light visual pass completed

- После утверждения Home Hub + Focus Dial начат final product-level visual pass.
- Создан `SceneTileView` для визуальных Light scenes вместо текстовых scene buttons.
- `RoomHeroView` углублён дополнительными native-drawn scene layers.
- `FocusDialView` получил gradient ring, glow, tick scale и более premium visual depth.
- No external image dependencies / no third-party UI library.
- Android bumped to `0.15-premium-light-rc1`.
- Static contract clean; Actions run 37102197040 PASS (unit contract tests + debug APK).

## 2026-10-03 — real Home Hub photo assets integrated

- Owner approved generated photorealistic living-room hero and four scene images.
- Assets optimized to WebP and committed as Android `drawable-nodpi`; total size ≈24 KB.
- Light standalone status header removed from visual flow; its ARDU/Online/Refresh/Settings controls are now overlaid on the real hero image.
- Ordinary-light state card moved into the hero composition.
- Scene tiles switched from native geometric illustration to real photo bitmaps with center-crop + readability gradient.
- Existing semantic API, Focus Dial behavior, RGB/clap/startup controls remain unchanged.
- Android version = `0.16-real-assets-light-rc1`.
- Final Actions run 37105664138: contract tests PASS, debug APK PASS.

## 2026-10-03 — Light hero crop and summary geometry corrected

- Owner phone screenshot showed that standard centerCrop removed the real-photo floor lamp and that the Brightness/Temperature cards had unequal visual geometry.
- Added `FocalCropImageView`; Light hero uses right-biased focal crop X=0.64.
- Summary cards fixed to identical 108dp geometry and typography.
- Initial intermediate CI attempts failed only because the first FocalCrop prototype inherited AppCompatImageView while this app intentionally has no AppCompat dependency; it was immediately replaced with standard Android ImageView.
- Final Android v0.17 CI run 37110520082 PASS.

## 2026-10-03 — real-photo contextual heroes propagated after Light approval

- Владелец подтвердил, что исправленный Light v0.17 с видимой правой лампой и равными Brightness/Temperature cards выглядит хорошо.
- Это закрыло owner visual gate Light.
- Реализован Android `0.18-photo-heroes-rc1`.
- `RoomHeroView` переведён с полностью synthetic Canvas room geometry на bitmap rendering утверждённого high-resolution photorealistic hero.
- Music/Ambient/Night/Alarm получили собственные focal crop и color/light grade поверх общего photo master; существующие semantic controls сохранены.
- Отдельные уникальные contextual photo files пока не добавлялись: v0.18 — композиционный/crop gate перед возможной заменой master на четыре специализированных WebP.
- Firmware, HTTP API и numeric UART не менялись.
- GitHub Actions Android Verify run 37111268646: unit contract tests PASS, debug APK build PASS.

## 2026-10-03 — Music label clipping and framed status header corrected

- Owner review of v0.18: contextual photo screens otherwise look good.
- On Music, the second line of several mode buttons was clipped at the bottom.
- The common top status/header still had a rounded rectangular outer frame on non-Light tabs, contrary to the approved concept.
- Music dynamic mode buttons changed from 96×64dp to 100×76dp; two-line text is explicit, centered, with font padding disabled and controlled vertical padding.
- Removed `@drawable/ardu_header` from `globalHeaderPanel`; reduced its extra inset padding so the header reads as floating page content rather than a separate card.
- Light hero/status composition unchanged.
- Android bumped to `0.19-music-header-polish-rc1`.
- Actions run 37112061533: contract tests PASS, debug APK build PASS.

## 2026-10-04 — Music Home Hub v0.20 completed

- Implemented the owner-approved Music v0.20 plan without firmware/API changes.
- Generated and committed a dedicated Music hero WebP; Music no longer reuses `RoomHeroView`/Light photo for its main hero.
- Music header/status/actions moved inside the hero; separate page header hidden while Music is selected.
- Removed Music Play/Stop row.
- Music mode names simplified and rebuilt as equal-height 4+3 grid.
- Existing `/api/music/mode` verified as direct select+start path; existing `/api/mode off` used for stop-on-leave.
- Bottom user navigation now stops active Music when moving to Light/Ambient/Night/Alarm; Settings is non-stopping.
- Fixed SmartSliderView min/max thumb clipping globally by increasing usable edge inset to include thumb radius and shadow reserve.
- Bottom navigation converted from visible words to native vector icons.
- Contract test now covers `selectMusicMode(M01)` and `setMode(off)` payloads.
- Static layout/source validation clean.
- Android Verify run 37194558467 PASS: tests + assembleDebug.

## 2026-10-04 — Music v0.20.1 visual hotfix completed

- Owner phone screenshot of v0.20 showed hero crop too aggressive, mode cards visually under-designed, and icon bottom navigation not centered/separated enough.
- Music hero rendering changed to uncropped fit-centered foreground over a subdued full-bleed backdrop of the same asset.
- Added `MusicModeTileView`: native Canvas illustrations for all seven Music modes with selected mint glow.
- Music mode tile height raised to 104dp to make room for illustration + label.
- Bottom nav items changed to actual `ImageButton`; created separate rounded/elevated dock background.
- App version bumped to `0.20.1-music-visual-hotfix-rc1`.
- Firmware/API/UART unchanged.
- Static validation clean.
- Android Verify run 37196929089 PASS.

## 2026-10-04 — Music framing/icon hotfix v0.20.2

По owner feedback после v0.20.1 выполнена ещё одна маленькая Android-only итерация.

Изменено:
- удалена оставшаяся фоновая `centerCrop`-копия `ardu_music_hero.webp`, которая визуально возвращала zoom вокруг fit-centered foreground;
- Music hero уменьшен с 330dp до 250dp и теперь использует только полный `fitCenter` photo layer на тёмной hero surface;
- M05 «Частота» в `MusicModeTileView` больше не рисуется второй волной: заменена на отдельный radio-frequency/beacon icon с концентрическими дугами и центральным маркером;
- Android version поднята до `0.20.2-music-framing-icon-hotfix-rc1` (versionCode 19).

Не изменены:
- HTTP API v1;
- numeric UART v1;
- Nano/ESP firmware;
- Music direct-start и stop-on-leave;
- bottom navigation dock и SmartSlider semantics.

Проверка: GitHub Actions Android Verify run `37204187940` — unit contract tests PASS, debug APK build PASS.

## 2026-10-04 — approved wide Music room hero v0.20.3

Владелец отверг предыдущий close-up Music asset и подтвердил композицию раннего эскиза, где одновременно читаются диван и колонка.

Выполнено:
- подготовлен и утверждён wide 16:9 Music room asset без встроенного UI-текста;
- asset оптимизирован до 640×360 WebP и записан как `app/src/main/res/drawable-nodpi/ardu_music_hero.webp`;
- композиция: диван слева, колонка справа, растения/городской фон, blue/amber lighting;
- существующий Music hero layout оставлен 250dp + `fitCenter` без `centerCrop`, чтобы правая сторона изображения гарантированно помещалась;
- Android version: `0.20.3-music-room-hero-rc1`, versionCode 20.

Не изменены Music behavior, API/UART и прошивки Nano/ESP.

Проверка: GitHub Actions Android Verify run `37209345952` — unit contract tests PASS, debug APK build PASS.

## 2026-10-04 — replacement Nano numeric UART PING PASS

Владелец загрузил release-скетч на другую Arduino Nano и восстановил реальную сборку.

Проверка через ещё работающий ESP `HTTP_BRIDGE_R7`:
- `GET /api/ping` → Wi-Fi/OTA ESP исправны, `fw=HTTP_BRIDGE_R7`, IP `192.168.0.4`;
- `GET /api/status` → Nano вернула `E 1`, поскольку R7 отправляет старую текстовую команду `STATUS`, а replacement Nano уже ожидает numeric UART v1;
- raw `POST /api/dev/nano` body `1` → `O 1`, без timeout.

**ФАКТ:** физическая линия ESP↔Nano и numeric UART v1 opcode 1 подтверждены на replacement Nano. Следующий шаг — финальный ESP v1 OTA.

## 2026-10-04 — owner local ESP v1 compile PASS

Локальная Arduino IDE владельца успешно скомпилировала финальный `esp8266_ardu_v1.ino` после открытия правильной папки скетча вместе с `ardu_esp_v1_types.h`.

Фактические размеры:
- RAM 32020/80192 (39%);
- IRAM 60823/65536 (92%);
- IROM 324400/1048576 (30%).

Следующий hardware gate — OTA upload `ARDU_ESP_V1` на физический ESP.

## 2026-10-04 — physical ESP v1 OTA PASS

Финальный `ARDU_ESP_V1` успешно загружен по OTA на физический ESP8266.

После reboot:
- `GET /api/ping` → `ok=true`;
- `fw=ARDU_ESP_V1`;
- `uart_protocol=1`;
- Wi-Fi connected, IP `192.168.0.4`, RSSI `-53`;
- OTA ready, hostname `ardu`, port `8266`.

Следующий шаг — read-only firmware/API gate через status/settings/time.

## 2026-10-04 — Android Ambient Home Hub v0.21

Продолжен design/UX pass после approved Music v0.20.3.

Реализовано:
- Android version `0.21-ambient-homehub-rc1` / versionCode 21;
- Ambient/«Фон» получил 250dp Home Hub hero с ARDU/status/actions внутри hero;
- отдельный global status header на Ambient больше не используется;
- current effect перенесён в glass summary внутри hero;
- F01/F02/F03 заменены с plain text Buttons на custom `AmbientEffectTileView` с различимыми native Canvas illustrations и mint selected state;
- ON/OFF оставлены семантически прежними;
- Ambient settings sliders/auto-cycle/API behavior не изменены.

Статическая проверка после записи в GitHub:
- новые Ambient IDs присутствуют в layout ровно по одному;
- Kotlin bindings для новых IDs присутствуют ровно по одному;
- custom view class и import присутствуют;
- version = `0.21-ambient-homehub-rc1`.

GitHub connector пока не показывает Actions/check status для exact v0.21 head, поэтому CI PASS не заявляется до отдельного подтверждения.

Physical handoff не изменён этим UI-pass: replacement Nano numeric UART PING уже PASS; следующий hardware step — final ESP v1 OTA.

## 2026-10-04 — physical read-only API gate

После финального ESP OTA выполнены первые реальные read-only запросы.

Результаты:
- `/api/status` PASS: `nano_fw=ARDU_V1`, numeric UART v1, mode light, current limit 3000 mA, без timeout;
- `/api/settings` PASS: полный schema 1 snapshot всех подсистем;
- `/api/time` не прошёл функциональный критерий только по RTC: `valid=false`, Nano `D 4 0`.

Таким образом транспорт и settings parser на реальном ESP/Nano подтверждены; до Night/Alarm acceptance нужно синхронизировать DS3231.

## 2026-10-04 — Android Home Hub completion v0.22

По прямому указанию владельца Home Hub visual language распространён на оставшиеся normal user pages — Night и Alarm/Dawn.

### Night
- 250dp contextual night hero;
- ARDU / status / refresh / settings moved inside hero;
- dynamic summary: enabled state + brightness + manual or schedule window;
- original Night semantic controls retained;
- schedule inputs reorganized into balanced ON/OFF columns.

### Alarm/Dawn
- 250dp dawn hero;
- ARDU / status / refresh / settings moved inside hero;
- summary keeps alarm enabled/time/dawn phase;
- added read-only RTC status/time text from the already-read `Snapshot.time`;
- wake time editor enlarged;
- fade, brightness, start/end hue, RTC sync and stop-dawn behavior unchanged.

### Shared UI
- global status header hidden on Light/Music/Ambient/Night/Alarm;
- Settings/service remains separate;
- Android version = `0.22-night-alarm-homehub-rc1`, versionCode 22.

### Static verification
- 177 layout IDs;
- duplicate layout IDs = 0;
- 41 Night/Alarm IDs, missing Kotlin bindings = 0;
- duplicate private functions = 0;
- refresh controls restore in both success and error branches.

No firmware/API/UART source change.

Physical context at this point:
- final ESP v1 OTA already PASS;
- physical `/api/status` + `/api/settings` PASS;
- RTC still invalid until time sync.

## 2026-10-04 — replacement Nano RTC sync PASS

На новой физической Nano выполнен финальный HTTP→ESP→numeric UART→Nano→DS3231 time sync.

Результат `POST /api/time/sync`: `ok=True, applied=True`.

Это подтверждает рабочую запись DS3231 по I²C через release firmware. Следующий шаг — readback `/api/time` и `/api/status`.

## 2026-10-04 — physical RTC readback PASS

После time sync выполнен readback на реальном стенде:
- `GET /api/time` → `valid=true`, корректная дата/время, Nano `D 4 1 ...`;
- `GET /api/status` → `rtc_valid=true`, режим `off`, numeric UART v1 стабилен.

RTC gate закрыт. Следующий этап — L01 regression через финальный API.

## 2026-10-04 — physical L01 ON PASS

На финальной физической связке Android/API backend ESP v1 → numeric UART v1 → replacement Nano выполнено первое включение L01.

Результат:
- semantic HTTP write `enabled=true` принят;
- readback `enabled=true`, Kelvin 4000 K, brightness 64;
- владелец подтвердил, что кольцо физически загорелось.

Следующий шаг — OFF/readback, затем повторный ON.

## 2026-10-04 — physical baseline repeated; Android real-device gate opened

The owner repeated the final Wi-Fi/API baseline and L01 toggle sequence on the physical device.

Confirmed:
- ESP firmware = `ARDU_ESP_V1`;
- IP = `192.168.0.4`;
- Nano firmware = `ARDU_V1`;
- numeric UART protocol = 1;
- RTC valid and advancing;
- settings schema 1 full read succeeds;
- L01 OFF → readback false;
- L01 ON → readback true;
- repeated OFF/ON also succeeds;
- final top-level mode = light.

This closes the minimum network/backend gate needed to move testing from PowerShell to the Android application.

Next: run current Android app on the phone, set address `192.168.0.4` in Settings → Connection, then verify real startup sync and Light controls.

## 2026-10-04 — real Android video review → v0.23 concept parity

Owner connected the current Android app to the real physical ARDU and supplied a video/screenshots. This is the first direct visual review of the final real-device path rather than mock-only rendering.

Before changes:
- archived v0.22 branch: `archive/android-v0.22-homehub-2026-10-04`;
- archived source commit: `a9daf3839786414b264f32dfe0a680b68f8a7be3`;
- archive manifest committed.

Implemented v0.23:
- `RoomHeroView` now creates distinct Ambient media-wall, Night bedroom and Dawn bedroom contexts over the existing image base;
- Light overview summary tiles replaced with real SmartSlider brightness/Kelvin controls;
- Light quick scenes moved toward concept labels: Вечер / Кино / Гости / Чтение;
- Light Focus Dial reduced from 300dp to 270dp;
- Music mode tiles reduced to a denser real-mode chooser;
- Ambient primary control reduced to effect + hue + brightness; detailed effect parameters collapsed;
- Night brightness becomes a primary moon +/- control; saturation is secondary;
- Alarm end hue becomes the primary wake color; start hue is secondary;
- success operation text clears after successful writes.

No Nano/ESP/API/UART source changes.

## 2026-10-05 — external 5 V reserve power requirement

Владелец добавил аппаратное требование: аккумулятор не хранится и не заряжается внутри ARDU, но при отключении сети к лампе должен подключаться внешний 5 V battery block.

Зафиксирована безопасная v1-топология:
- отдельный вход `EXT 5V` у корпуса A;
- резервный источник питает общую 5-V шину всей ARDU, а не Nano через USB;
- штатный PSU и battery source не параллелятся напрямую;
- для v1 предпочтителен ручной двухполюсный выбор `NORMAL / EXT 5V`;
- на `EXT 5V` требуется входной предохранитель;
- встроенной зарядки аккумулятора нет;
- текущий ориентир источника при 3000 mA LED current limit: ≥4 A continuous, предпочтительно 5–6 A;
- cold boot от резервных 5 V должен штатно приводить к L01, поэтому базовое освещение не зависит от наличия Wi-Fi во время отключения сети.

Физическая реализация и закупка конкретного разъёма/переключателя отложены до final power/two-ring gate. Firmware/API/UART не менялись.

## 2026-10-05 — reserve-ready v1 + routerless source implemented

Owner clarified the target: finish and install the first complete ARDU **without a battery**, but make later backup use possible without removing the ceiling unit.

Source changes:
- ESP v1 now uses Station primary + protected `ARDU-DIRECT` fallback;
- direct address = `192.168.4.1`;
- separate local SoftAP password is required;
- HTTP API remains the same; ping reports network mode/direct status;
- OTA remains Station-only;
- Android discovery now includes `192.168.4.1` and accepts a valid direct ARDU ping when home Station is absent;
- Nano firmware and numeric UART v1 unchanged.

Hardware target refined:
- external accessible USB-C PD BACKUP input must be installed before ceiling mounting;
- reserve path = 15 V PD → fuse → 5 V high-current DC/DC → accessible NORMAL/BACKUP source selector → common 5 V bus;
- no battery is installed or charged by ARDU;
- battery purchase is optional after v1 completion.

Current state: source implemented and documented; new ESP direct-mode compile/OTA/hardware smoke and reserve power hardware acceptance are still pending.

### 2026-10-05 — direct-mode Android UX refinement

- Android validates direct discovery by `device=ARDU-ESP8266` and UART protocol v1 before accepting `192.168.4.1`.
- Ping model now carries `network_mode` and `softap_active`.
- UI shows `Прямое подключение` / `ARDU-DIRECT` when operating through SoftAP.
- Temporary direct IP is not written over the saved home preferred address.
- Static delimiter validation is clean for ESP `.ino`, `Models.kt`, `ArduApiClient.kt`, and `MainActivity.kt`.
- Exact Arduino/Gradle compile was not available through the current connector/runtime; physical/IDE compile remains an acceptance gate.

## 2026-10-05 — selectable normal/emergency ring profiles implemented

Owner kept the previously selected future battery class and requested selectable rings in both normal and emergency operation.

Implemented source:
- Nano: persistent normal/emergency ring profiles, values BOTH/A/B; defaults BOTH/A;
- Nano D8 = MAINS_SENSE; current limiter now scales by active ring count;
- Nano uses separate D6/D7 FastLED buffers while retaining one renderer frame; B-only restores the animation frame after output;
- UART 121 read / 122 set;
- ESP semantic `/api/system/rings` GET/POST;
- Android Settings card with independent Normal and Emergency A/B/Both buttons;
- ring profile is included in app refresh/reread after writes.

Hardware decision:
- no manual source selector;
- candidate automatic source switch = existing INV-051 SRD-05VDC-SL-C relay module, subject to contact/load test;
- MAINS_SENSE divider uses existing 1.5 kOhm + 4.7 kOhm;
- battery remains optional/later.

Static delimiter checks are clean for Nano/ESP/Kotlin; Android XML IDs have no duplicates and LinearLayout nesting balances when self-closing tags are handled. No commit-associated Actions run is visible through the connector yet, so compile/memory gate remains pending.

## 2026-10-07 — owner cancelled backup battery branch

Owner explicitly abandoned the accumulator/emergency backup-power idea.

Current result:
- D-096, D-098 and D-099 marked superseded by D-100;
- backup/EXT/USB-C PD power input removed from current architecture;
- HUSB238, reserve DC/DC, source-selector relay, backup fuse and D8 MAINS_SENSE removed from current BOM;
- Nano emergency ring-profile source reverted to the pre-backup release baseline;
- ESP `/api/system/rings` and UART 121/122 removed by source rollback;
- Android ring-profile model/client/UI removed by source rollback;
- INV-051 relay returned to non-core inventory;
- Nano USB-C remains service/programming only;
- final v1 returns to two mirrored D6/D7 rings on the normal Class II 5-V PSU.

Important: `ARDU-DIRECT` is retained. Router-less local Wi-Fi was requested separately and remains useful without any battery.

The historical 2026-10-05 backup design records remain in HISTORY/DECISIONS/SOURCES for traceability but are not current requirements.

## 2026-10-07 — v0.23 rejected; canonical Android UI restored to v0.22

Owner tested/reviewed the attempted concept-parity direction and rejected it, then switched locally to:
`archive/android-v0.22-homehub-2026-10-04`.

To make that owner choice canonical without discarding later valid network work:
- restored v0.22 layout and all affected visual custom views to `main`;
- rebuilt `MainActivity` from the v0.22 UI version and retained only later ARDU-DIRECT/network-mode behavior;
- kept current Android API client direct fallback changes;
- version set to `0.22.1-homehub-restored-rc1` / versionCode 24.

Restore validation:
- layout IDs 177;
- duplicate IDs 0;
- missing MainActivity bindings 0;
- duplicate private functions 0;
- visual source files exactly match archived v0.22.

v0.23 remains in Git history/documentation but is no longer the active design.

## 2026-10-07 — final ESP credentials isolated from Git-tracked sketch

Repository hygiene fix after owner's pull was blocked by local edits in `esp8266_ardu_v1.ino`.

Implemented:
- optional local `wifi_secrets.h`;
- tracked `wifi_secrets.example.h`;
- v1 local secrets path added to `.gitignore`;
- tracked sketch uses local macros when the header exists and safe placeholders otherwise.

Result: normal branch switching/pulling no longer requires modifying the tracked final ESP sketch for credentials.

No runtime API/UART behavior changed.

## 2026-10-07 — targeted Home Hub owner-polish v0.22.2

After owner rejected broad v0.23 redesign, a new iteration was implemented strictly as local corrections to v0.22.

Android:
- labels restored under bottom-nav icons;
- Settings Back/direct-Wi-Fi/reset-defaults UX;
- Light overview ON/OFF and differentiated scenes;
- selected-state feedback fixed for Light/Ambient, Music highlight tied to active runtime;
- navigation now activates selected runtime mode;
- dedicated Ambient/Night/Dawn photo assets;
- Ambient concept presets added without adding new firmware mode IDs.

Firmware source:
- F02/F03 speed fixed from ambiguous/raw 8-bit behavior to monotonic higher= faster semantics;
- reset-defaults opcode 130 added;
- ESP endpoint added.

Contracts documented in D-102, API_V1 and UART_V1.
Physical upload is deliberately deferred until emulator visual acceptance.

## 2026-10-07 — dedicated hero image scale reduced

Owner reported Ambient/Night/Alarm hero photos felt excessively large. RoomHeroView was adjusted only for AMBIENT/NIGHT/DAWN: the actual scene is fit-centered at reduced scale over a dark subdued full-bleed copy. Light/Music unchanged.

## 2026-10-07 — owner approved regenerated Ambient/Night/Alarm hero art

The scale-only v0.22.3 correction was abandoned. Three new wide scene assets were generated specifically for the Home Hub hero composition and explicitly approved by the owner.

Repo replacement:
- Ambient asset blob: `22aae69892044ecf3e1a8ab01a3e450a40de3e70`;
- Night asset blob: `8b0f4441efa75113eacec86b60298d15723693ba`;
- Alarm/Dawn asset blob: `ec59069783d9566861712bb0f418aed0c2004f41`.

RoomHeroView now preserves the full wide scene instead of using the v0.22.3 inset scale trick.

Preset follow-up intentionally deferred: owner wants an expanded catalog (>4) and explicit behavior design before more firmware/app preset work.

## 2026-10-08 — Ambient hero corruption fixed at asset layer

Owner showed screenshot where Ambient hero was gray corrupted texture while Night and Alarm heroes were correct. Restored just `ardu_ambient_hero.webp` from the approved RGB-TV living-room original. A newly encoded WebP decoded successfully locally and was inserted as an exact Git blob (SHA `667b6bac57b4c32ff29cea9e6f18513bcae4db6a`). Bumped Android to `0.22.5-ambient-hero-hotfix-rc1` (28). No changes to rendering, navigation, presets or hardware. Awaiting emulator visual result.

## 2026-10-08 — owner rejects F02/F03 for future Ambient; presets saved as idea

Owner direction: «F02 и F03 не нужен. остальное зафиксируй в репозитории как идею».

Documentation-only decision D-104:
- target Ambient retains F01;
- F02/F03 retired from **planned user-facing** functionality, without immediate source deletion;
- twelve candidate scenes with example patterns/brightness, 4 compact algorithm families, UX, persistence, and staged hardware plan saved in `04_Прошивка/AMBIENT_PRESETS_CONCEPT.md` as **IDEA / NOT APPROVED FOR IMPLEMENTATION**.

No code/firmware/application assets changed and no hardware retest claimed.

## 2026-10-08 — Ambient heroes accepted; implementation plan stored

- Владелец подтвердил принятие всех текущих фоновых Android hero-картинок; прежний blocker проверки исправленного `ardu_ambient_hero.webp` снят на основании сообщения владельца (не выдавать это за новый автотест эмулятора).
- Создан `04_Прошивка/AMBIENT_PRESETS_IMPLEMENTATION_PLAN.md`: согласование будущего каталога, свежая compilation/EEPROM baseline, три P01/P04/P05 алгоритма, memory gates, дальнейший каталог, versioned persistence/API, ESP/Android, physical acceptance и rollback.
- D-105 фиксирует принятие визуалов и последовательность работ; D-104 (F01 да, F02/F03 нет в будущем UI) сохраняется. P01…P12 не frozen IDs.
- Документационное изменение: source прошивок, Android, UART/HTTP, EEPROM и физическое устройство **не изменены / не тестировались**.

## 2026-10-08 — Ambient three-scene software lab R1: code + CI passed

Владелец дал прямую команду начать реализацию пресетов. В `nano_ardu_v1/ambient_preset_probe.h` реализованы AURORA (P01), COSMOS (P04), FIREPLACE (P05) с одним 44-LED framebuffer, без новых EEPROM/UART IDs. Рабочая прошивка Nano v1 подключает эти алгоритмы **только** при специальном compile флаге (по умолчанию OFF), так что доступные Android/ESP F01/F02/F03 не меняют смысла.

Разработаны C++ host tests, расширен Arduino Verify workflow до отдельной полной Nano probe compile, оптимизированы 32-bit math и preview scheduler:
- коммиты исходного алгоритма/интеграции: `46ef1c2`, `44eb68e`;
- оптимизации: `fc44636`, `7f676fc`, `82747f0`;
- итоговая проверка [CI run 37807204353](https://github.com/dronrome1245/ARDU/actions/runs/37807204353) **PASS**: host tests, стандартный full Nano 28690/30720 flash + 1234/2048 SRAM, experimental full Nano 29312/30720 flash + 1234/2048 SRAM.
- +622 Flash / +0 globals по сравнению со standard; над проектным ориентиром 95% Flash на 128 B, реальный stack не измерен.

Нет ни firmware upload, ни физического визуального теста/тока, ни app/API migration; локальная лампа остаётся на предыдущих версиях. См. `04_Прошивка/AMBIENT_PRESETS_LAB_R1.md`.

## 2026-10-08 — compiled full Ambient PREVIEW RC1 and hardware handoff

Первая попытка собрать отдельный IDE-wrapper для всей Nano v1 через относительный include `../nano_ardu_v1/nano_ardu_v1.ino` не прошла CI [37809142084](https://github.com/dronrome1245/ARDU/actions/runs/37809142084): после препроцессинга путь был недоступен. Исправлено на самодостаточную папку `04_Прошивка/nano_ambient_preview_rc1/` (полная версия .ino + копия header). В CI добавлен byte-for-byte sync с основной Nano v1 + flag.

Итог: [CI 37809369365](https://github.com/dronrome1245/ARDU/actions/runs/37809369365) PASS — host frames, source sync, standard full Nano 28690 Flash/1234 globals, preview full Nano 29376 Flash/1234 globals, отдельный IDE-sketch PASS и [HEX artifact 11564965835](https://github.com/dronrome1245/ARDU/actions/runs/37809369365/artifacts/11564965835). Разработана инструкция `04_Прошивка/AMBIENT_PRESETS_PREVIEW_RC1_TEST.md`: физический Nano Upload, UART, Android F01 demo, возврат. Физических загрузок/измерений в чате не было.

## 2026-10-08 — RC1 include issue on owner Windows; self-contained RC2 verified

Получено от владельца: `nano_ambient_preview_rc1.ino:38:10 fatal error: ambient_preset_probe.h: No such file or directory`, при этом заголовок, по сообщению, расположен рядом. Реальная причина поиска Arduino IDE не установлена; RC1 не пройдена локально.

Реализована отдельная RC2: `04_Прошивка/nano_ambient_preview_rc2/nano_ambient_preview_rc2.ino`. Она сформирована из **всего** `nano_ardu_v1.ino` с включённым preview и с **inline** содержимым `nano_ardu_v1/ambient_preset_probe.h`; прежняя canonical Nano не менялась. GitHub workflow добавил проверку соответствия inline исходнику и isolated compile, где в папке буквально только один RC2 .ino.

[CI 37814719230](https://github.com/dronrome1245/ARDU/actions/runs/37814719230) **PASS**, 29376 B Flash/1234 B globals, [HEX artifact 11567275089](https://github.com/dronrome1245/ARDU/actions/runs/37814719230/artifacts/11567275089). Дальнейшие действия на реальном Nano ещё не подтверждены. Инструкция: `04_Прошивка/AMBIENT_PRESETS_PREVIEW_RC2_TEST.md`.

## 2026-10-08 — completed Ambient12 v2 integration in GitHub, physical ESP OTA outstanding

Выполнено по явному разрешению владельца: созданы отдельные **полные** версии `04_Прошивка/nano_ambient12_v1/nano_ambient12_v1.ino` и `05_WiFi_и_приложение/esp8266_ardu_v2/esp8266_ardu_v2.ino` и обновлено Android-приложение `0.22.6-ambient12-functional-rc1`. Полный набор P01…P12 с хранением в отдельной EEPROM и UART 111..115; REST endpoints чтения, выбора и индивидуальных brightness/dynamics; WPA2 `ARDU-DIRECT` при отсутствии домашнего Wi-Fi; OTA в Station.

Коды firmware source прошли GitHub CI: [Nano 37818601346](https://github.com/dronrome1245/ARDU/actions/runs/37818601346) 29560 Flash/1282 globals, [ESP 37820404281](https://github.com/dronrome1245/ARDU/actions/runs/37820404281) включая real-credentials compile guard. [Android 37819918951](https://github.com/dronrome1245/ARDU/actions/runs/37819918951) JVM tests + APK PASS (artifact 11568856875). Важный этап безопасности: приватный `wifi_secrets.h` обязателен в ESP v2, `.gitignore` исключает его из Git; placeholder-пароли не допускаются при обычной сборке.

Создан `ARDU_AMBIENT12_RELEASE_CANDIDATE.md` с безопасным планом одного OTA ESP v2 → USB полной Nano v2 → Android → теста `ARDU-DIRECT`. **Владелец сообщил, что ARDU-DIRECT до сих пор не загружал; реальные OTA/USB/питание/две ленты/12 сцен этим чатом не подтверждены.**

## 2026-10-08 — Nano Ambient12 Flash optimization regression PASS

Итерация `db752733ec964b908c4e065b9a74408401146521`: в новом полном `nano_ambient12_v1.ino` устаревшие F02/F03/auto действия 103/104/108/109 возвращают ошибку применимости; F01 продолжает принимать ручные hue/saturation/brightness через 105/106/107. [Arduino Verify 37820974644](https://github.com/dronrome1245/ARDU/actions/runs/37820974644) PASS. Размер уменьшился с 29560 до **29306 байт Flash** (−254); globals SRAM **1282/2048**. Это остаётся на 122 B выше мягкого ориентира 95% и пока не испытано на устройстве. [Актуальный полный HEX](https://github.com/dronrome1245/ARDU/actions/runs/37820974644/artifacts/11568284647).

## 2026-10-08 — ESP v2 R2 one-file manual Wi-Fi fields, CI PASS

По запросу владельца из `esp8266_ardu_v2.ino` удалён внешний `wifi_secrets.h`. В начале скетча четыре вручную редактируемые строки: Station SSID/password, новый OTA password, отдельный `ARDU-DIRECT` WPA2 password. Удалены ненужные ESP v2 header и template; source v1 не менялся. Без замены placeholders real Verify специально останавливается. [ESP8266 Verify CI 37823238584](https://github.com/dronrome1245/ARDU/actions/runs/37823238584) PASS: отрицательный тест шаблонов, положительная сборка один .ino с четырьмя фиктивными значениями, compile ESP v1. Реальные OTA/ARDU-DIRECT/физические команды не тестировались. Исправлены ESP README и `ARDU_AMBIENT12_RELEASE_CANDIDATE.md`.

## 2026-10-08 — Owner started ESP v2 R2 OTA; Auth OK, upload result not shown

Владелец сообщил об OTA-попытке на IP 192.168.0.4. IDE компилирует ESP v2: 32208/80192 bytes static RAM, 60823/65536 IRAM, 329120/1048576 IROM. Вывод `Authenticating...OK`, затем `Uploading...` и точки. Одновременно окно `No monitor available for the port protocol network` — это IDE Serial Monitor для network-порта, не самостоятельный OTA-failure verdict. **Полного лога с завершающим результатом пока нет, модель ESP на железе не подтверждена.** Следующий минимальный gate после окончания текущей загрузки: закрыть Serial Monitor, `curl.exe --max-time 8 http://192.168.0.4/api/ping` и прочитать поле `fw`; до результата не менять Nano и не делать вторую загрузку ESP.

## 2026-10-08 — first physical ESP v2 OTA is SUCCESSFUL by firmware ping

После сообщения Arduino IDE `Authenticating...OK` / `Uploading...` (и отдельной ошибки сетевого Serial Monitor) владелец прислал **реальный** ответ ESP: `{"ok":true,"device":"ARDU-ESP8266","fw":"ARDU_ESP_V2_AMBIENT12","uart_protocol":1,"wifi_connected":true,"network_mode":"station","softap_active":false,"ip":"192.168.0.4","rssi":-57,"ota_ready":true,"ota_hostname":"ardu","ota_port":8266}`. Это доказывает успешное обновление до новой ESP v2 R2, работу домашнего Station Wi-Fi и доступность HTTP и запущенной OTA-службы; жалоба IDE касалась попытки открытия serial monitor через network port, не фактической неудачи новой прошивки.

**Gate closed:** ESP v2 firmware/ping/Station startup physically PASS. **Pending:** ESP↔Nano UART, device settings, ARDU-DIRECT SoftAP under router outage, further OTA, Nano v2 flash, Android real phone and LED/power regression. Далее выполнить `/api/status` и `/api/ambient/presets` до Nano USB Upload.

## 2026-10-08 — all twelve approved atmospheric photo thumbnails committed to Android main

Владелец передал три утверждённых 2×2 листа P01..P12 и потребовал залить непосредственно в `dronrome1245/ARDU`. **Фактическая реализация:** каждый рисунок вырезан, уменьшен до 192×192 WebP (сохранён чёткий крупный образ для маленьких плиток), 12 бинарных Git-blob опубликованы под `android_app_r1/app/src/main/res/drawable-nodpi/ardu_preset_p01..p12.webp`. Kotlin XML P01–P04 и программно P05–P12 показывают изображения в сетке 4×3; выбранные подписи и состояние пресета обновляются по реальному readback, F01/остальные экраны не перерабатывались. `MainActivity.kt`, `activity_main.xml`, `app/build.gradle.kts` обновлены; версия `0.22.7` code 30. [Коммит 4221b5b](https://github.com/dronrome1245/ARDU/commit/4221b5b6d497b2bf32172aec638c1efb92d5f8ae).

Первый Android workflow run [37838188257](https://github.com/dronrome1245/ARDU/actions/runs/37838188257) упал только на ошибочном относительном пути в **новом preflight тесте** (скетч/ресурсы были на месте). Путь исправлен [1e47d767](https://github.com/dronrome1245/ARDU/commit/1e47d76795a53ade5169f325157d18c3a959b4a4). [CI 37838263956](https://github.com/dronrome1245/ARDU/actions/runs/37838263956) **PASS**: 12 binary resource checks, JVM contract tests, assembleDebug и [APK 11576287564](https://github.com/dronrome1245/ARDU/actions/runs/37838263956/artifacts/11576287564). Android `pull` → Run пока не подтверждён пользователем, аппаратная прошивка не требуется.

## 2026-10-09 — 12 thumbnails phone visual PASS; Android UX correction RC1

**Владелец:** 12 пресетов появились на телефоне в Android v0.22.7. Обзорное видео пяти вкладок и настроек записано **без ленты**, приложение показывает **«Нет связи»**. Это подтверждает только отрисовку 12 ресурсов и навигацию, а не переключение лампы/EEPROM/таймеров.

**Исправлен source Android в `05_WiFi_и_приложение/android_app_r1`:** 0.22.8/code31: unknown state UI (в т.ч. Focus Dial), запрет offline-команд, откат локальных превью по повторному Nano readback, ScrollView scroll=0 при смене разделов; P01..P12 на первом плане, F01 ниже, нормальные подписи/нажатие на них; две кнопки музыки; тумблер ночника и HH:MM, активная остановка рассвета, лимит >3000 с подтверждением; кнопки калибровки хлопков связаны с реальным этапом. Добавлены `UiSafetyPolicyTest` и статические проверки Android в CI; [run](https://github.com/dronrome1245/ARDU/actions/runs/37930295301). Nano/ESP исходники не изменялись.

**Pending physical:** новый Android `git pull`→Run на телефоне с/без связи, подтвердить работу над Nano (основной свет, музыка, 12 пресетов, ночь, alarm), двухкольцевой ток/stack, ARDU-DIRECT без роутера.

## 2026-10-09 — owner video v0.22.8, Android connectivity + messages RC1

**ФАКТ:** владелец передал два одинаковых видео `18428313537172 (4).mp4` и `18428313537172 (3).mp4`, SHA256 обоих совпадает, продолжительность 268,82 с, дисплей 578×1280. Запись показывает Android `Онлайн`, в настройках ESP `ARDU_ESP_V2_AMBIENT12`, Nano `ARDU_V2`, 12 картинок P01–P12 и применение параметров в UI. Ток не измерен, сама WS2812B лента в записи отсутствует; экран настройки показывает `Лимит тока: 4500 мА`. В режиме «Музыка» label `Запустить` в выбранном состоянии низкоконтрастен.

**Android код 0.22.9/code32:** foreground `Handler` 5 секунд в `MainActivity`, `pingSelected` без сканирования всех адресов на каждом online tick и Nano `status`; отдельные состояния OFFLINE/ESP_ONLY/SETTINGS_UNAVAILABLE/ONLINE, восстановление полного snapshot при reconnect, прекращение таймера в `onStop`, исключение overlapping polls с ручным refresh; сохраняемый `Показывать служебные сообщения` в общих настройках, с сокрытием повторяющихся рабочих сообщений, сохранением ошибок, связь всегда видима; контраст primary Music Start. Unit/CI статические и Kotlin проверки, [Android CI PASS](https://github.com/dronrome1245/ARDU/actions/runs/37958078703), APK создан. Нового владельческого phone test этих изменений пока нет.

**Nano bug (source diagnosis, no firmware write):** `renderPreset` имеет ровно три диапазона скорости `dynamics`. При значениях 182/190/225 скорость одинаковая. Отдельное исправление pending; Nano не перешивали, надо подготовить full build/size и аппаратный визуальный тест.

## 2026-10-09 — Android 0.22.9, owner Phone Online/Offline PASS

Владелец сообщил: «вот тест 0.22.9. онлайн офлайн работает». Это **прямое пользовательское подтверждение** работоспособности автоматической смены статуса при проверке на настоящем телефоне, не только проверка кода или CI. Видео `18429670918804.mp4` (около 63 с, 578×1280) показывает `Онлайн`, экран «Свет» с изменениями яркости/быстрых сцен и экран «Музыка» с выбором нескольких режимов, читаемую кнопку запуска. Видеозапись **не показывает** фактический момент отключения питания, задержку переключения в `Нет связи`, экран переключателя служебных надписей и свечение WS2812B. Не объявлять эти дополнительные проверки пройденными. Прошивки Nano и ESP не изменялись.

**Практический результат:** проблема «Онлайн навсегда» v0.22.8 закрыта по отчёту владельца для Android 0.22.9. Следующий firmware gate — непрерывная скорость фоновых P01..P12 (текущий Nano source только 3 уровня), compile/size до физической проверки на 44 LED. Другие pending: Settings service-caption toggle на телефоне, UI HTTP-error readback и мастер калибровки хлопков, два кольца 44+44, ARDU-DIRECT.

## 2026-10-09 — Nano Ambient12 continuous speed R2 implemented and CI verified; owner Upload pending

После подтверждения Android 0.22.9 Online/Offline владелец потребовал исправить скорость фона. Исходник полной Nano R1 содержит только `dynamics<70` / 70..170 / `>170`; 182/190/225 идентичны. Создан отдельный **полный однофайловый** скетч `04_Прошивка/nano_ambient12_v2/nano_ambient12_v2.ino`, не патч поверх Nano R1 на железе, без локального `.h` и без изменённых EEPROM/UART/API. `uint32_t presetPhaseQ16` добавляет 4 B globals, функция `advancePresetClock(elapsed, dynamics, q16)` считает 256 монотонных скоростей, P11 переведён на заметный ~4..16s цикл. Ревизия boot `ARDU1 3`; исходный файл R1 без изменений.

В GitHub Actions первый прогон [37966645395](https://github.com/dronrome1245/ARDU/actions/runs/37966645395) не прошёл из-за **дублирования функции только в host-тестовой обвязке** (выделялась дважды); исправлена граница извлечения без изменения алгоритма. Повторный [Arduino Verify 37966945125](https://github.com/dronrome1245/ARDU/actions/runs/37966945125) **PASS**: exact-source host test 256 разных скоростей, rollover, разные скорости 182/190/225, все 12 рендереров; полная AVR Nano Old Bootloader. Прошлая полная R1 29306 Flash/1282 global SRAM, новая полная R2 **29336 Flash/1286 globals** (+30/+4), создаётся полноценный HEX `ardu-nano-ambient12-v2-velocity-rc2`. Runtime stack, фактический Upload, питание/нагрев и визуальная скорость **не измерены**, soft 95% Flash target превышен.

Подготовлен `04_Прошивка/AMBIENT12_SPEED_R2_TEST.md` (одна кольцевая линия D6, ограничение тока 3000 мА, upload с временно отключённым ESP TX→Nano D0, readback и rollback). Владелец пока ничего не прошивал в этом шаге.

## 2026-10-09 — owner liked P11 breathing; small low-end speed adjustment R3

**Наблюдение владельца:** «дыхание классно получилось. на нуле еще чуть чуть можно замедлить». Из этого следует субъективный visual PASS P11 предыдущей схемы; точная длительность и ревизия boot на плате не измерены. Предложен щадящий сдвиг только P11 от 16,4 до ~20,2 c на `dynamics=0`; при 255 ~4,1 c без изменения.

Создан **новый полный автономный скетч** `04_Прошивка/nano_ambient12_v3/nano_ambient12_v3.ino`, сохранив R2 rollback. R3 использует тот же Q16, но при `scene==10` дополнительно вычитает `ceil(3*(255-dynamics)/8)` из частоты. Пиксельный renderer P01..P12 побайтно как в R2, структура 29B EEPROM, HTTP/UART и остальные подсистемы не менялись. Boot `ARDU1 4`.

Первый [CI 37971014038](https://github.com/dronrome1245/ARDU/actions/runs/37971014038) упал на host-assert: округление к нулю делало последние 253/254 эквивалентными R2; изменили формулу на округление вверх и уточнили host tests. [Полный Arduino Verify https://github.com/dronrome1245/ARDU/actions/runs/37971273171](https://github.com/dronrome1245/ARDU/actions/runs/37971273171) PASS: тесты 256 строго возрастающих P11 speeds, неизменность 11 прочих clocks и 12 renderers, R3 HEX, AVR compile и size. **R2 29336 Flash/1286 SRAM globals → R3 29376 Flash/1286 SRAM globals**, рост +40/+0. Фактический USB Upload R3, Visual P11 и stack под нагрузкой пока не проведены. Gate/rollback: `04_Прошивка/AMBIENT12_BREATHING_R3_TEST.md`.

## 2026-10-09 — All twelve Ambient P-scene motion in Nano R4 (D-116)

Владелец: «сделай все сразу. сейчас работает только дыхание». Исследован активный полный Nano R3; скорость `dynamics` была непрерывной, однако renderer почти всех других сцен использовал `phase=t>>2` и малозаметную амплитуду, из-за чего сцены выглядели неподвижными на реальной 44-LED ленте. Один пакет, не 11 отдельных прошивок: полный однофайловый `nano_ambient12_v4/nano_ambient12_v4.ino`, boot `ARDU1 5`, отдельные видимые движения для P01..P10 и P12, сохранённый P11 R3, без изменения F01/Music/RTC/UART/API/EEPROM/current limit.

Создан `nano_ambient12_v4/tests/preset_motion_host.cpp`, который через CI вставляет **точно те же** функции Q16 и `renderPreset` из полного .ino и проверяет изменения HSV-кадра 44 LED за 2 c при dynamics 0/255 для всех 12; сверяет P11 с R3, включая неизменность его рендеринга. Добавлены более жёсткие проверки для P02, P04, P05, P07. Порядок безопасной установки/отката: `AMBIENT12_ALL_SCENES_R4_TEST.md`.

Ни один аппаратный Upload по этому изменению не выполнялся ассистентом. Стек в реальной Nano и ток двух колец по CI не определяются.

**Arduino CI R4:** первая попытка [37975199836](https://github.com/dronrome1245/ARDU/actions/runs/37975199836) остановилась на сравнении P11-формул из-за названия следующего case в комментарии, pixel-код P11 не менялся. Исправлена граница проверки, [37975471145](https://github.com/dronrome1245/ARDU/actions/runs/37975471145) PASSED. Анализ сигнатур 44-LED кадров показал, что P04 при max dynamics за 2с менялся слишком слабо (суммарный HSV distance=66), поэтому усилены P02/P07 тени и изменена частота звёзд/огня/свечей. Финальный [Arduino Verify https://github.com/dronrome1245/ARDU/actions/runs/37975908088](https://github.com/dronrome1245/ARDU/actions/runs/37975908088) **PASS**: P04 high distance=487, у 9 LED-позиций заметная смена; P02/P07 low distance=624, P05 high=2375, все 12 кадров реагируют на динамику 0/255. Полная Nano R4 **29410/30720 Flash**, **1286/2048 global SRAM** против полной R3 29376/1286. HEX `ardu-nano-ambient12-v4-all-moving-rc1` опубликован; full R3 recovery HEX не удалён. Аппаратный визуальный тест пока НЕ выполнен.

## 2026-10-09 — 12 ambient motion physical PASS by owner report after R4

Владелец сообщил: «все задвигалось это хорошо. что осталось исправить?». Это закрывает именно проблему **отсутствия заметного движения фоновых сцен P01..P12 на подключённой лампе** после R4 по оценке владельца, в отличие от прежнего подтверждения только CI. В сообщении нет видео/лога boot `ARDU1 5`, измерений электрических параметров или детальной экспертизы внешнего вида/скоростей/EEPROM — такие gates **не считать пройденными**. Исходники R4, предыдущая R3 и ESP/Android в этой итерации не изменялись. [main Arduino Verify 37976579921](https://github.com/dronrome1245/ARDU/actions/runs/37976579921) PASS.

Следующая итерация — Android HTTP/readback resilience при переключении Music и корректное закрытие CLAPCAL wizard после сохранения; параллельно остаются реальные режимные тесты, fallback ARDU-DIRECT, два кольца 44+44, Class II PSU и stack/ток/тепло. Android Online/Offline v0.22.9 подтверждён владельцем ранее.

## 2026-10-09 — Android v0.22.10 launcher icon + HTTP/readback + finished CLAPCAL, CI PASS

Последнее обращение владельца: «Хорошо. Измени значок сразу приложения на рабочем столе если возможно». В Android v0.22.9 отсутствовал `android:icon` в манифесте — launcher использовал системную иконку. Реализован адаптивный icon `mipmap-anydpi-v26/ic_launcher.xml`, `ic_launcher_round.xml`; foreground ARDU кольцо из светло-мятных линий с A и тёплым акцентом, Android 13+ monochrome; `AndroidManifest.xml` подключает icon и roundIcon. Приложение остаётся `com.ardu.app`, версия `0.22.10-launcher-readback-clap-rc1` (33). Нет изменений структуры утверждённых 5 экранов.

Одновременно исправлен ранее обсуждённый баг из владельческого Music-видео: повторять один раз только GET при connection reset/unexpected EOF, `Connection: close`; POST не повторять. `MainActivity.runDeviceAction` разделяет успешное POST (ACK confirmed) и чтение Nano snapshot, а при вторичном GET-сбое показывает подтверждённый результат с pending readback вместо false negative. `CLAPCAL SAVE` onAcknowledged закрывает Android Wizard и сохраняет dismissed state, так как Nano продолжает возвращать `finished=true` после SAVE; новая START-сессия разрешает показ мастера.

[GitHub Android Verify https://github.com/dronrome1245/ARDU/actions/runs/37981648045](https://github.com/dronrome1245/ARDU/actions/runs/37981648045) **PASS**: XML/resource иконки, JUnit policy tests и APK `ardu-android-02210-launcher-debug-apk`. Готов для `git pull` → Android Studio Run. **Установка на физический Android и обновление значка на реальном рабочем столе пока не подтверждены.** ESP/Nano не перепрошивались.

## 2026-10-10 — Android 0.22.11 after owner 6:09 video: Ambient, Music, Evening/Cinema

Получено видео `18437905058452.mp4` (~368.98 с, 578×1280). На экране Android v0.22.10 показано управление L01, круговой регулятор и RGB, быстрые сцены с похожими тёплыми плитками «Вечер»/«Кино», M01..M09, тесная четвёрка M05/M08 frequency-submode под слайдерами, отдельные F01 «Свой цвет» и ручная настройка на странице «Фон». Владелец потребовал четыре UX-изменения одним пакетом и пояснение настройки цвета музыкального background.

Android v0.22.11/code34: скрыты F01/HSV/Auto card roots (legacy endpoints и XML IDs оставлены для совместимости), ON/OFF перенесены в P-grid; M05/M08 submodes перед ползунками и на всю ширину, выбранные из Nano readback highlighted mint; music background label честно объясняет: регулируется только яркость, цвет закреплён в Nano, M09 background не использует. Evening 2700K/115 (~45%) и Cinema 1800K/18 (~7%), фото превью warm-vs-deep-blue, Guest/Reading не менялись. [Android CI PASS](https://github.com/dronrome1245/ARDU/actions/runs/38035137524): XML/static tests, JVM unit tests и APK artifact `ardu-android-02211-presets-music-scenes-debug-apk`. На железе/в приложении R11 пока не проверено; Nano R4/ESP без изменений.

## 2026-10-10 — Android 0.22.12 nav glow source + инструкция физического ARDU-DIRECT теста

Владелец сообщил «проверил 0.22.11» без пометок PASS/FAIL отдельных пунктов и показал мини-скриншот нижней панели с cyan/mint glow активной вкладки. В main внесён Android-only `NavGlowItemView`: пять равных selectable капсул, выбранная рисуется с мягкой мятной радиальной подсветкой, стеклянным фоном, тонкой нижней линией и glow текста, inactive не рисует эффекта. Прежние icon/vector assets, семантический переход между вкладками, Nano Ambient12 R4, ESP v2, UART/API не менялись. Android версия `0.22.12-nav-glow-rc1` (code35). Коммиты `351fb4f` (UI), `765b51e` (исправлен CI working-directory static guard), `92980e5` (стабилизирован alpha Paint на повторной перерисовке). [Android Verify PASS 38046617214](https://github.com/dronrome1245/ARDU/actions/runs/38046617214) — пять равных glow tabs, Kotlin/JUnit unit tests, debug APK `ardu-android-02212-nav-glow-debug-apk` (artifact ID 11668260250). Физический Android ещё не проверялся после изменения.

Для защищённого Station→SoftAP→Station добавлен пошаговый gate `05_WiFi_и_приложение/ARDU_DIRECT_STATION_AP_TEST.md`. Проверка исходника ESP v2 и API подтверждает наличие кода SoftAP `ARDU-DIRECT` 192.168.4.1 и fallback-кандидата Android; владелец ещё не предоставил логи реального теста. Пароли не запрашивались и в репозиторий не вносились.

## 2026-10-10 — Android 0.22.13 direct Wi-Fi recovery and selected glow without capsule

Из видео владельца `18442333063828.mp4`: телефон показывает Wi-Fi `ARDU-DIRECT` / «Подключено (нет доступа в Интернет)», приложение настроено на `192.168.4.1`, около 00:57 виден status «Прямое подключение», читается L01. Затем наблюдаются ошибки ответа/данных при управлении светом и невозможность читать актуальное состояние; полный direct PASS **не достигнут**. Скриншоты/телефонный ролик не подтверждают отказ самой ESP либо Nano — без отдельных HTTP ping/status нельзя локализовать корень.

В `main` внесён Android-only пакет `0.22.13-direct-stable-borderless-glow-rc1` code36 (commit `a221172`): direct-candidate lock при обнаружении Wi-Fi 192.168.4.x, `Network.openConnection` через Wi-Fi даже при сотовом default network, readTimeout direct ≥8 сек без POST retry, foreground command gate против heartbeat, общий путь readback после смены режима; `NavGlowItemView` теперь без стеклянной выбранной капсулы/stroke. [Android Verify 38048024255](https://github.com/dronrome1245/ARDU/actions/runs/38048024255) **PASS**: static direct route/glow checks, Kotlin/JUnit, debug APK `ardu-android-02213-direct-borderless-debug-apk` (artifact ID 11668866174). На реальном Android и лампе изменения пока не проверены. В ESP, Nano, RTC, UART, EEPROM и питание правок нет.

## 2026-10-10 — Реализация warm Kelvin рассвета и завершающая Direct/glow-итерация

Владелец сообщил о резком обрезании borderless glow у границы бывшей капсулы, нестабильности Direct после 0.22.13 и предоставил два успешных браузерных ответа по `192.168.4.1`: `/api/ping` (ESP V2 Station=false/SoftAP=true) и `/api/status` (реальная Nano отвечает, `mode:dawn`, `rtc_valid:true`, `current_limit_ma:3025`). Два успешных ответа не отменяют заявленных срывов подключения; физический regression FAIL остаётся открытым. Пользователь согласовал один последний вариант, затем отказ от идеи direct при неуспехе.

В `main` создан самостоятельный **полный** Nano `nano_warm_dawn_v5/nano_warm_dawn_v5.ino` boot `ARDU1 6`, EEPROM dawn v2 и warm Kelvin, старт за `fade_minutes` до wake clock. [Arduino Verify PASS](https://github.com/dronrome1245/ARDU/actions/runs/38050231423) на 29534 Flash /1286 global SRAM; прошивку физически не загружали. Создан полный ESP `esp8266_warm_dawn_v3/esp8266_warm_dawn_v3.ino` с `softAPgetStationNum` hold, atomic `78` Kelvin bridge и snapshot capability gate; [ESP Verify PASS](https://github.com/dronrome1245/ARDU/actions/runs/38050334769); реальные приватные Wi-Fi пароли в GitHub не вносились, OTA upload не выполнялся. Android `0.22.14` мягко обрабатывает частичный readback и рисует shrink-radius glow; `0.22.15` добавляет 4 натуральных сценария и Kelvin sliders, [Android Verify PASS](https://github.com/dronrome1245/ARDU/actions/runs/38050719704) плюс последняя safety поправка на разрешённый OFF для старого HSV alarm. Собраны APK `ardu-android-02215-warm-dawn-presets-debug-apk`, HEX `ardu-nano-warm-dawn-v5-rc1`; работоспособность на реальной лампе/телефоне ожидает владельца.

Рабочая последовательность upload, теста RTC wake-time, direct stability и rollback оформлена `RELEASE_WARM_DAWN_DIRECT_ACCEPTANCE.md`. Контроллеры/питание физически не менялись.

## 2026-10-10 — начало работы над вторым кольцом (не физический монтаж)

Владелец сообщил «все получилось» после предыдущих исправлений и переключил приоритет на монтаж второго светодиодного кольца. Новый **факт со слов владельца:** доступны три отдельных провода маркированного сечения **1×1,5 мм²**; владелец намерен собрать соединения заранее на столе. Новых измерений длины/типа/цветов провода, наличия второй защиты DATA, конденсатора Ring B, приобретённого Class II БП и тестов второй ленты ещё нет. Сам факт соединения/пайки или монтажа **не зафиксирован**.

Сверена принятая топология `FINALIZATION_PLAN.md`: Ring B 44 LED на Nano D7, отдельная низковольтная ветвь ~2 м с +5V/GND/DATA, отсутствие PE и исключение металлического S-30-5 из потолочного исполнения. Подготовлен воспроизводимый монтажный gate `02_Архитектура_и_решения/RING_B_44LED_МОНТАЖ_И_ПРОВЕРКА.md`, без изменения firmware Android/Nano/ESP и без заказа деталей. Физический контроль владелец выполнит на следующем шаге.

## 2026-10-17 — физическая проверка RTC-рассвета и новая семантика Night

- На установленной однокольцевой ARDU через Station `192.168.0.4` подтверждены ESP `ARDU_ESP_V3_WARM_DAWN`, валидный RTC и связь ESP↔Nano.
- Сервисный лимит тока возвращён с 4500 мА на 3000 мА.
- Ускоренный будильник с `fade_minutes=1` физически перешёл в `mode:dawn`; `/api/events` выдал `V 6` (alarm trigger) и `V 2 1 60` (alarm dawn start). Владелец подтвердил, что свет позже стал ярким; начало текущей квадратичной кривой визуально очень тёмное.
- Выявлено ограничение текущего R5: повторный будильник в ту же календарную дату блокируется сохранённым `lastTrigger`; отдельное исправление остаётся будущей задачей.
- По новому явному требованию владельца подготовлен Nano R6: расписание Night работает как события ON/OFF, а ручной NIGHT больше не ограничивается временным окном.

## 2026-10-17 — Nano remote flashing R1 source/CI

- По прямой команде владельца подготовлен ESP `ARDU_ESP_V4_NANO_REMOTE` поверх работающего Warm Dawn V3.
- Реализован Station-only authenticated arm, IP-bound 30 s window, TCP port 3280, прозрачный `avrdude ↔ ESP UART0 ↔ Nano Old Bootloader` bridge на 57600 и GPIO4 reset control через NPN.
- Добавлен Windows helper `tools/flash_nano_over_wifi.ps1`, использующий AVRDUDE из Arduino IDE и стандартный write+verify.
- Добавлен монтажный/приёмочный документ `02_Архитектура_и_решения/NANO_REMOTE_FLASH.md`.
- One-shot CI компилирует полный ESP V4 как Generic ESP8266 с четырьмя тестовыми credentials до публикации исходника. Физический reset-транзистор, реальный Wi-Fi Nano upload и recovery retry владельцем ещё не проверены.

## 2026-10-17 — первый реальный удалённый upload Nano: запись 100%, verify transport FAIL

- ESP V4 и физическая GPIO4→BC548→Nano RESET цепь уже подтвердили удалённый reset: Nano `uptime_ms` 890258 → 9488 ms.
- Владелец запустил `tools/flash_nano_over_wifi.ps1` на фактическом `nano_warm_dawn_v6.ino.hex`.
- AVRDUDE 8.0-arduino.1 через TCP 3280 / STK500v1 / 57600 определил ATmega328P signature `1E 95 0F`, прочитал HEX 29 722 B и выполнил запись Flash до 100%.
- Verify остановился примерно на 22%: `protocol expects sync byte 0x14 but got 0xe6`, затем `0xff`, `programmer is out of sync`, `unable to read byte at address 0x0000`, затем `0xc4`.
- Результат классифицирован как **WRITE COMPLETE / VERIFY FAIL**, а не как успешная прошивка. Отключение verify (`-V`) не допускается.
- Подготовлена ESP `ARDU_ESP_V4_NANO_REMOTE_R2`: lossless forwarding с учётом фактического return count `write()`, `availableForWrite()`, неблокирующим UART read и 512-B RX buffer. Повторный physical write+verify pending.

## 2026-10-17 — повторный Nano Wi-Fi verify и физическое подтверждение R6 startup

- На физическом ESP `ARDU_ESP_V4_NANO_REMOTE_R2` повторный upload Nano R6 через `net:192.168.0.4:3280`, 57600 снова записал 29 722 B до 100%, но verify потерял STK500 sync почти сразу.
- Отдельный verify-only в новом bootloader-сеансе дошёл до 48% и завершился теми же `expected 0x14`, `0xe6/0xff/0xc4`; вариант с 64-byte flash page дошёл до 7% и также FAIL.
- После полного power-cycle `/api/status` снова PASS: RTC valid, current limit 3000 mA, normal UART работает.
- Reset-only через ESP GPIO4 дал сырую startup-строку `�ARDU1 7` и событие `V 9 1`; следовательно, записанная Nano R6/FW_REV7 фактически стартует на железе. Это не отменяет требование полного AVRDUDE verify для remote-programming hardware PASS.
- Подготовлен ESP V4 R3 DIAG: latched UART overrun/RX-error, byte counters/max queue diagnostics и фильтрация residual UART строк в events.

## 2026-11-07 — Night D-125: безопасный read-only gate для Nano R6 через Wi-Fi

- Проверены актуальные `STATUS.md`, `DECISIONS.md`, `NANO_REMOTE_FLASH.md`, прошивка Nano R6 (`ARDU1 7`) и ESP V4 R3 DIAG; исходный алгоритм расписания D-125 уже реализован.
- Изменён `tools/flash_nano_over_wifi.ps1`: добавлен `-VerifyOnly` с `avrdude -U flash:v`, вывод latched R3 UART/TCP диагностик даже после неуспешного AVRDUDE, и отдельная проверка восстановления `/api/status`. Обычный режим записи сохранил обязательный write+verify.
- Добавлен `04_Прошивка/NIGHT_R6_WIFI_ACCEPTANCE.md`: последовательность установки R3 по OTA, read-only сравнение установленного R6 HEX и проверки семантики ручного Night, границ ON/OFF и приоритета DAWN.
- Исходный Nano/ESP код в этой итерации не изменён. Операций OTA, readback или проверки устройства по локальной сети из GitHub-коннектора не выполнялось; hardware gate остаётся открытым.

## 2026-11-07 — аппаратный тест R3 DIAG: Nano readback 100%, HEX mismatch

- Подтверждено владельцем: `/api/ping` ESP `ARDU_ESP_V4_NANO_REMOTE_R3_DIAG`, сеть Station `192.168.0.4`, сервис Nano remote flash на TCP 3280.
- Выполнен PowerShell `tools/flash_nano_over_wifi.ps1 -VerifyOnly` с HEX `04_Прошивка/nano_warm_dawn_v6/build/arduino.avr.nano/nano_warm_dawn_v6.ino.hex`, скомпилированным локально до 29378 байт. Использован штатный AVRDUDE `8.0-arduino.1`, `ATmega328P` signature `1E 95 0F`, 57600 baud.
- AVRDUDE выполнил `Reading 100% 11.29 s` без прежней ошибки STK500 sync; ESP диагностировал `uart_overrun=false`, `uart_rx_error=false`, `uart_rx_buffer_size=512`, `tcp_to_uart_bytes=2129`, `uart_to_tcp_bytes=30398`, `max_tcp_available=22`, `max_uart_available=114`, `last_result=disconnected`, `active=false`.
- **Строгий verify FAIL:** `flash verification mismatch`, первое видимое отличие на 0x002e (device 0x88, input 0xf5); сравниваемый HEX 29378 B, тогда как предыдущая запись R6 содержала 29722 B. Возможна разница компилятора/библиотек/сборки, но причины пока не подтверждены.
- Не было команды `flash:w`: Nano НЕ перезаписывалась. Не объявлять физический full verify PASS или write+verify PASS. Из-за исключения скрипт не выполнил post-session `/api/status`, нужно проверить его отдельно; далее функциональный тест D-125.

## 2026-11-07 — постпроверка Nano: HTTP восстановлен, RTC invalid

- После аппаратного `-VerifyOnly` владелец запросил `/api/status`: `ok:true`, `nano_fw:ARDU_V2`, `mode:light`, `rtc_valid:false`, `current_limit_ma:3000`, `uptime_ms:214617`, статус Nano `D 2 1 0 0 70 500 3000 1 0 0 214617`.
- Подтверждено: UART/HTTP приложение Nano работает после выхода из bootloader. Но DS3231 сейчас сообщает невалидное время (причина не установлена); Night schedule и Alarm запускать на время до выяснения нельзя. Следующий безвредный шаг — `/api/time` без записи настроек.

## 2026-11-07 — RTC/Night diagnosis: `/api/time` invalid

- Владелец выполнил `GET http://192.168.0.4/api/time`: `ok:true`, `valid:false`, `nano:"D 4 0"`.
- Код Nano R6 `rtcValidNow()` допускает несколько причин: нет ACK DS3231, ошибка чтения status/time, некорректные значения даты или OSF=1 (флаг остановки осциллятора). HTTP ответ не различает причины.
- Следующее действие: синхронизация даты/времени через существующий ESP API `/api/time/sync` с часов ПК, затем readback; если не удаётся, дальнейшая диагностика I2C/DS3231. Никакая перепрошивка в этом диагностическом шаге не выполнялась.

## 2026-11-07 — RTC sync hardware PASS после `D 4 0`

- Владелец вызвал `POST /api/time/sync` с локальным временем Windows: `ok:true`, `applied:true`.
- `GET /api/time` сразу после записи вернул `ok:true`, `valid:true`, `date:2026-11-07`, `time:21:25:28`, Nano `D 4 1 2026 11 7 21 25 28`.
- DS3231 доступна на чтение и запись, автоматические функции по времени снова можно испытывать. Первопричина прежнего `valid:false` и удержание хода при отключении питания пока не проверены.
- Следующий шаг: прочитать сохранённые настройки `/api/settings` и тестировать Night D-125 без новой прошивки.

## 2026-11-07 — первая полностью подтверждённая Wi-Fi прошивка Arduino Nano R6

- Владелец выполнил `tools/flash_nano_over_wifi.ps1` **без** `-VerifyOnly` из Windows PowerShell; HEX `04_Прошивка/nano_warm_dawn_v6/build/arduino.avr.nano/nano_warm_dawn_v6.ino.hex` (29 378 байт); ESP R3 DIAG, TCP `192.168.0.4:3280`, STK500 v1 / 57600 бод / ATmega328P Old Bootloader.
- AVRDUDE 8.0-arduino.1: `Writing 29378 bytes to flash`, `Writing 100% 13.92 s`; `Reading 100% 12.47 s`; **`29378 bytes of flash verified`**, штатное завершение (exit code 0).
- ESP R3 diagnostics после сеанса: `last_result=disconnected`, `active=false`, `UART overrun=false`, `rx_error=false`, `RX buffer=512`, TCP→UART `33648 B`, UART→TCP `31450 B`, max available TCP=133, UART=102.
- Скрипт вывел **`PASS: AVRDUDE write + byte-for-byte verify succeeded`**, затем **`PASS: Nano application responds. mode=light, rtc_valid=True, current_limit_ma=3000`**.
- **АППАРАТНЫЙ PASS механизма удалённой загрузки Nano (D-127)**: запись + побайтовая проверка + восстановление приложения без снятия потолочной лампы. **Функциональные сценарии Night D-125 ещё не проверены**; они остаются отдельным gate.

## 2026-11-07 — владелец подключил второе кольцо; нагрузочный тест ещё не выполнен

- Владелец сообщил о физическом подключении второго 44-LED кольца ARDU.
- Nano R6 уже содержит два выхода FastLED D6/D7 с общим буфером 44 LED на каждое кольцо, суммарный программный лимит 3000 mA; прошивка/Android для зеркальной работы не требуют изменения.
- Нет подтверждения напряжения на кольце B, отсутствия мерцания, тока, нагрева, наличия развязки и безопасного Class II БП. Нельзя считать аппаратный gate 44+44 пройденным.
- Следующая процедура: предварительно убедиться в корректности схемы и отсутствии короткого замыкания, установить через `/api/system/current-limit` 500 mA, проверить свечение обоих колец, напряжение дальнего B под нагрузкой и стабильность; только после подтверждения вернуть до 3000 mA.

## 2026-11-07 — кольцо B подключено, но пока не светится

- Владелец сообщил, что после подключения второго кольца B не светится, а первое A отключено. Поведение пока не локализовано.
- В Nano R6 FastLED D6 и D7 являются независимыми выходами с зеркальным кадром (44 WS2812B на каждом); отсутствие кольца A не является объяснением отсутствия свечения B.
- Следующая проверка без перепрошивки: принудительно включить L01 через `/api/light/settings` и подтвердить `/api/status`; затем, если B всё ещё не светится, измерить 5 В постоянного тока на B при безопасном доступе к низковольтной части, далее проверять GND/D7→DIN/resistor 220–470 Ω с полностью отключённым питанием.

## 2026-11-07 — кольцо B заработало после исправления DATA→DIN

- Пользователь ранее подтвердил 5 В непосредственно на ленте B; `/api/status` показывал `mode=light`, `current_limit_ma=500`, `rtc_valid=false` после недавнего перезапуска.
- По фотографии идентифицировано подозрение на подключение сигнала со стороны DOUT; после переноса пользователь сообщил: «ты прав. поменял все горит». Свечение B подтверждено словами владельца.
- Кольцо A в предыдущем тесте было физически отключено. Синхронная работа 44+44, нагрузочный тест, падение 5 В под нагрузкой, тепловые проверки и безопасный финальный Class II БП не подтверждены. К монтажу на потолке переходить только после закрытия этих gate; ESP/Nano/Android прошивки менять не нужно.

## 2026-11-14 — D-128: программная реализация улучшенного семейного UX

- В Android `android_app_r1` нижняя навигация больше не вызывает `api.setMode()`; явные контролы режимов сохранены. Пресет «Кино» показан как «Отдых», плитка стала теплее по цвету, Kelvin и brightness сохранены.
- Для 12 фоновых сцен добавлена локальная панель четырёх избранных с удержанием для добавления/удаления. Фактический active preset продолжает перечитываться с Nano; локальный список не выдаётся за состояние лампы.
- В Android `0.22.16-family-schedule-rc1` добавлены экраны и код парсинга расписания Пн–Пт/Сб–Вс, выходного времени и auto-off 0–120 мин. При отсутствии capability флагов новых firmware кнопки семейного расписания не показываются.
- Созданы **отдельные source-кандидаты** Nano `nano_warm_dawn_v7` (boot `ARDU1 8`, семейный EEPROM блок, wake-date weekday logic, ручной/событийный Night fade, alarm-only hold timeout) и ESP `esp8266_family_v5` (HTTP JSON + UART family opcode62, строгая проверка версии Nano). Старые R6/ESP V4 оставлены неизменными.
- Android Verify [43593418689](https://github.com/dronrome1245/ARDU/actions/runs/43593418689) **PASS** после замены устаревшего теста, требовавшего команду смены режима при открытии вкладки. ESP V5 compile PASS в Family R7 workflow. В первых запусках Nano R7 возникло переполнение flash; в отдельной кандидатной сборке идёт оптимизация. **До успешной CI memory-gate и физического Nano write+verify не объявлять новые Night/Alarm режимы установленными или аппаратно пройденными.**
- Не вмешивались в питание, проводку или физическую лампу; совместный тест 44+44 и Class II PSU остаются обязательными.

## 2026-11-14 — CI PASS семейного Nano R7 и ESP V5 после оптимизации flash

- Первоначальная Nano R7 source не помещалась в flash, до 31 050 B. Оптимизированы календарный расчёт дня недели (8-bit с учётом високосных лет 2000..2099), плавное обновление яркости, хранение FamilyAlarm через EEPROM.get/put, сериализация только действующих атмосферных полей с сохранением 14-значного wire-format для старого ESP.
- Окончательный результат GitHub Actions [ARDU Family R7 Candidates, run 43595155594](https://github.com/dronrome1245/ARDU/actions/runs/43595155594): **Nano compile/memory PASS 30 712/30 720 Flash, 1 076/2 048 global SRAM**; ESP V5 one-file (CI dummy credentials) compile PASS. В CI отдельно выдано предупреждение о **всего 8 байтах оставшегося flash**: последующие функции требуют сокращения прошивки.
- Android [run 43593418689](https://github.com/dronrome1245/ARDU/actions/runs/43593418689) **PASS**: unit tests, debug APK `ardu-android-02216-family-schedule-debug-apk`; новые вкладки, фавориты, экран семейного будильника в коде.
- Ни R7, ни ESP V5 этим действием физически не установлены. Не заявлять hardware PASS Night/Alarm, пока не пройдены AVRDUDE verify и полный протокол `04_Прошивка/FAMILY_R7_ACCEPTANCE.md`.
