dronrome1245/ARDU/04_Прошивка/nano_warm_dawn_v7/nano_warm_dawn_v7.ino

/*
  ARDU Nano R7 candidate: family alarm schedule + post-dawn timeout + gentle Night fades.
  Based on the hardware-tested Warm Dawn R5 / Ambient12 R4 feature set.
  Built from hardware-tested ARDU subsystems.

  v1 scope:
  - 2 x 44 WS2812B, mirrored frame: D6 + D7
  - L01 + persisted Kelvin/RGB profile
  - local double-clap + family CLAPCAL
  - DS3231 + Night schedule + Alarm/Dawn recovery
  - Ambient F01 manual + 12 distinct local atmospheric P01..P12 scenes; F02/F03 retired
  - Music M01/M02/M03/M04/M05/M08/M09
  - shared MAX9814/A0 audio frontend + shared FHT_N=64
  - extended EEPROM persistence + service current limit

  R3 remains in nano_ambient12_v3 for rollback. Check CI/size before Upload.
*/

#include <Arduino.h>
#include <util/twi.h>
#include <EEPROM.h>
#include <avr/io.h>
#define FHT_N 64
#define LOG_OUT 1
#include <FHT.h>
#ifdef SCALE
#undef SCALE
#endif

#define FASTLED_ALLOW_INTERRUPTS 1
#include <FastLED.h>

namespace Pins {
constexpr uint8_t RING_A = 6;
constexpr uint8_t RING_B = 7;
constexpr uint8_t MIC_IN = A0;
}

namespace Cfg {
constexpr unsigned long SERIAL_BAUD = 115200UL;
constexpr uint8_t FW_REV = 8;

constexpr uint16_t LED_COUNT = 44;
constexpr uint16_t DEFAULT_CURRENT_LIMIT_MA = 3000;
constexpr uint16_t MIN_CURRENT_LIMIT_MA = 500;
constexpr uint16_t HARD_CURRENT_LIMIT_MA = 4500;
constexpr unsigned long SERIAL_RX_GUARD_MS = 5UL;
constexpr size_t RX_BUFFER_SIZE = 64;

constexpr uint8_t DS3231_ADDR = 0x68;
constexpr unsigned long RTC_POLL_MS = 250UL;
constexpr unsigned long DAWN_FRAME_MS = 50UL;

// Existing compatible EEPROM blocks.
constexpr int ALARM_BASE = 0;       // 0..9
constexpr int DAWN_BASE = 16;       // 16..23
constexpr int DAWN_RUNTIME_BASE = 32; // 32..45
constexpr int NIGHT_BASE = 64;      // 64..76
constexpr int FAMILY_ALARM_BASE = 80; // 80..88, isolated versioned policy block
constexpr int LIGHT_BASE = 128;     // L01 R2/R3 compatible
constexpr int CLAP_BASE = 192;      // threshold/timeout
constexpr int CORE_BASE = 224;      // current mode + clap enable
constexpr int EXT_BASE = 256;       // v1 Music/Ambient/audio/service block
constexpr int PRESET_BASE = 512;    // independent scene EEPROM, preserving legacy v1 blocks
constexpr uint16_t PRESET_MAGIC = 0xA1D2;
constexpr uint8_t PRESET_VER = 1;

constexpr uint16_t EXT_MAGIC = 0xA1D1;
constexpr uint8_t EXT_VER = 1;

constexpr uint16_t FAMILY_ALARM_MAGIC = 0xA8D2;
constexpr uint8_t FAMILY_ALARM_VER = 1;
constexpr uint16_t ALARM_MAGIC = 0xA8D1;
constexpr uint8_t ALARM_VER = 1;
constexpr uint16_t DAWN_MAGIC = 0xDA01;
constexpr uint8_t DAWN_VER = 2; // v2 stores warm Kelvin steps; v1 HSV EEPROM resets to safe warm defaults
constexpr uint16_t DAWN_RUNTIME_MAGIC = 0xDA02;
constexpr uint8_t DAWN_RUNTIME_VER = 1;
constexpr uint16_t NIGHT_MAGIC = 0x4E32;
constexpr uint8_t NIGHT_VER = 2;
constexpr uint16_t LIGHT_MAGIC = 0x4C32;
constexpr uint8_t LIGHT_VER = 2;
constexpr uint16_t CLAP_MAGIC = 0x4343;
constexpr uint8_t CLAP_VER = 1;
constexpr uint16_t CORE_MAGIC = 0xC010;
constexpr uint8_t CORE_VER = 1;

constexpr uint8_t DEFAULT_ALARM_HOUR = 7;
constexpr uint8_t DEFAULT_ALARM_MINUTE = 0;

constexpr uint8_t DEFAULT_FADE_MIN = 30;
constexpr uint8_t DEFAULT_DAWN_MAX_BR = 102; // 40%
constexpr uint16_t DAWN_MIN_KELVIN = 1800;
constexpr uint16_t DAWN_MAX_KELVIN = 4000;
constexpr uint8_t DAWN_STEP_KELVIN = 20;
constexpr uint8_t DAWN_MAX_STEP = (DAWN_MAX_KELVIN-DAWN_MIN_KELVIN)/DAWN_STEP_KELVIN;
constexpr uint8_t DEFAULT_DAWN_START_STEP = (2000-DAWN_MIN_KELVIN)/DAWN_STEP_KELVIN;
constexpr uint8_t DEFAULT_DAWN_END_STEP = (3600-DAWN_MIN_KELVIN)/DAWN_STEP_KELVIN;

constexpr uint8_t DEFAULT_NIGHT_HUE = 24;
constexpr uint8_t DEFAULT_NIGHT_SAT = 180;
constexpr uint8_t DEFAULT_NIGHT_BR = 18;
constexpr unsigned long NIGHT_FADE_MS = 16320UL;

constexpr uint8_t DEFAULT_LIGHT_BR = 64;
constexpr uint16_t DEFAULT_LIGHT_KELVIN = 4000;
constexpr uint16_t MIN_KELVIN = 1800;
constexpr uint16_t MAX_KELVIN = 6500;

constexpr int DEFAULT_CLAP_TRSH = 70;
constexpr uint16_t DEFAULT_CLAP_TIMEOUT_MS = 500;
constexpr unsigned long CLAP_COMMAND_GUARD_MS = 700UL;
constexpr uint16_t CLAP_VOL_DT_US = 700;
constexpr uint16_t CLAP_VOL_PERIOD_MS = 5;
constexpr uint8_t CLAP_VOL_WINDOW = 20;
constexpr uint16_t CLAP_AMPLI_DT_MS = 150;

constexpr unsigned long CLAPCAL_PRE_DELAY_MS = 1000UL;
constexpr unsigned long CLAPCAL_QUIET_WINDOW_MS = 3000UL;
constexpr unsigned long CLAPCAL_SAMPLE_WINDOW_MS = 2200UL;
constexpr unsigned long CLAPCAL_QUIET_SAMPLE_MS = 20UL;
constexpr uint8_t CLAPCAL_DER_FLOOR = 15;
constexpr uint8_t CLAPCAL_MIN_PAIRS = 3;
constexpr uint8_t CLAPCAL_MAX_PAIRS = 12;

constexpr uint32_t RAM_COOKIE_MAGIC = 0x41524455UL; // "ARDU"
}

// -------------------- common types --------------------

struct RtcTime {
  uint16_t year = 2000;
  uint8_t month = 1;
  uint8_t day = 1;
  uint8_t hour = 0;
  uint8_t minute = 0;
  uint8_t second = 0;
};

enum class SystemMode : uint8_t {
  OFF = 0,
  LIGHT = 1,
  NIGHT = 2,
  DAWN = 3,
  AMBIENT = 4,
  MUSIC = 5
};

enum class ColorMode : uint8_t {
  KELVIN = 0,
  RGB = 1
};

enum class DawnPhase : uint8_t {
  IDLE = 0,
  RUNNING = 1,
  HOLD = 2
};

enum class DawnSource : uint8_t {
  NONE = 0,
  ALARM = 1,
  MANUAL = 2,
  TEST = 3
};

struct AlarmSettings {
  bool enabled = false;
  uint8_t hour = Cfg::DEFAULT_ALARM_HOUR;
  uint8_t minute = Cfg::DEFAULT_ALARM_MINUTE;
  uint16_t lastTriggerYear = 0;
  uint8_t lastTriggerMonth = 0;
  uint8_t lastTriggerDay = 0;
  bool storageValid = false;
};

struct DawnSettings {
  uint8_t fadeMinutes = Cfg::DEFAULT_FADE_MIN;
  uint8_t maxBrightness = Cfg::DEFAULT_DAWN_MAX_BR;
  uint8_t startStep = Cfg::DEFAULT_DAWN_START_STEP;
  uint8_t endStep = Cfg::DEFAULT_DAWN_END_STEP;
  bool storageValid = false;
};

struct FamilyAlarmSettings {
  bool weekdaysEnabled = true;
  bool weekendsEnabled = false;
  uint8_t weekendHour = 9;
  uint8_t weekendMinute = 0;
  uint8_t holdMinutes = 15; // 0 disables auto-off; max 120
};

struct DawnRuntime {
  DawnPhase phase = DawnPhase::IDLE;
  DawnSource source = DawnSource::NONE;
  uint32_t startRtcSeconds = 0;
  uint32_t durationSeconds = 0;
  bool storageValid = false;
};

struct NightSettings {
  bool manualEnabled = false;
  uint8_t hue = Cfg::DEFAULT_NIGHT_HUE;
  uint8_t saturation = Cfg::DEFAULT_NIGHT_SAT;
  uint8_t brightness = Cfg::DEFAULT_NIGHT_BR;
  bool scheduleEnabled = false;
  uint8_t onHour = 22;
  uint8_t onMinute = 0;
  uint8_t offHour = 7;
  uint8_t offMinute = 0;
  bool storageValid = false;
};

struct LightSettings {
  ColorMode colorMode = ColorMode::KELVIN;
  uint8_t brightness = Cfg::DEFAULT_LIGHT_BR;
  uint16_t kelvin = Cfg::DEFAULT_LIGHT_KELVIN;
  CRGB customRgb = CRGB::White;
  bool storageValid = false;
  bool dirty = false;
};

struct ClapSettings {
  uint16_t threshold = Cfg::DEFAULT_CLAP_TRSH;
  uint16_t timeoutMs = Cfg::DEFAULT_CLAP_TIMEOUT_MS;
  bool storageValid = false;
  bool dirty = false;
};

struct LightPersist {
  uint16_t magic;
  uint8_t version;
  uint8_t colorMode;
  uint8_t brightness;
  uint16_t kelvin;
  uint8_t r,g,b;
  uint8_t sum;
};

struct ClapPersist {
  uint16_t magic;
  uint8_t version;
  uint16_t threshold;
  uint16_t timeoutMs;
  uint8_t sum;
};

struct CoreState {
  SystemMode lastMode = SystemMode::LIGHT;
  bool clapEnabled = true;
  bool storageValid = false;
};

struct TempAnchor {
  uint16_t k;
  uint8_t r, g, b;
};

enum class MusicMode : uint8_t {
  M01 = 0, M02 = 1, M03 = 2, M04 = 3, M05 = 4, M08 = 5, M09 = 6, COUNT = 7
};

enum class BandSubmode : uint8_t {
  THREE = 0, LOW_ONLY = 1, MID_ONLY = 2, HIGH_ONLY = 3
};

enum class AmbientEffect : uint8_t {
  F01 = 0, F02 = 1, F03 = 2
};

enum UartError : uint8_t {
  UE_PARSE=1, UE_RANGE=2, UE_RTC=3, UE_STATE=4, UE_APPLICABILITY=5
};

enum BandIndex : uint8_t {
  BAND_LOW = 0, BAND_MID = 1, BAND_HIGH = 2, BAND_COUNT = 3
};

struct Bands {
  uint8_t low, mid, high, peak;
};

struct MusicModeSettings {
  uint8_t brightness;
  uint8_t background;
  uint8_t smooth;
  uint8_t sensitivity;
  uint8_t speed;
  uint8_t aux;
  uint8_t submode;
};

struct AmbientSettingsV1 {
  uint8_t effect;
  uint8_t f01Hue, f01Sat, f01Brightness;
  uint8_t f02Hue, f02Sat, f02Brightness, f02Speed;
  uint8_t f03Hue, f03Brightness, f03Speed, f03Step10;
  uint8_t autoCycle, autoPeriodSec;
};

struct ExtendedSettings {
  uint16_t currentLimitMa = Cfg::DEFAULT_CURRENT_LIMIT_MA;
  uint16_t vuLowPass = 300;
  int16_t micDcOffset = 250;
  uint8_t spectrumLowPass = 40;
  uint8_t audioCalibrated = 1;
  MusicMode selectedMusic = MusicMode::M01;
  MusicModeSettings music[static_cast<uint8_t>(MusicMode::COUNT)];
  AmbientSettingsV1 ambient;
  bool storageValid = false;
  bool dirty = false;
};

struct __attribute__((packed)) ExtendedPersist {
  uint16_t magic;
  uint8_t version;
  uint16_t currentLimitMa;
  uint16_t vuLowPass;
  int16_t micDcOffset;
  uint8_t spectrumLowPass;
  uint8_t audioCalibrated;
  uint8_t selectedMusic;
  MusicModeSettings music[static_cast<uint8_t>(MusicMode::COUNT)];
  AmbientSettingsV1 ambient;
  uint8_t sum;
};

constexpr uint8_t PRESET_COUNT=12;
struct __attribute__((packed)) PresetPersist {
  uint16_t magic;
  uint8_t version;
  uint8_t selected; // 0=manual F01, 1..12=atmospheric scenes
  uint8_t brightness[PRESET_COUNT];
  uint8_t dynamics[PRESET_COUNT];
  uint8_t sum;
};
static_assert(sizeof(PresetPersist)==29,"preset EEPROM layout unexpected");

struct VuRuntime {
  uint16_t filtered;
  uint16_t averageLevel;
  uint16_t maxLevel;
  uint16_t lastPeak;
  uint16_t rainbowHue10;
  uint8_t pairs;
  unsigned long lastRainbowMs;
};

struct BandRuntime {
  uint16_t filtered[BAND_COUNT];
  uint16_t average[BAND_COUNT];
  uint8_t brightness[BAND_COUNT];
  uint8_t flashMask;
  uint8_t runningMask;
  Bands last;
  unsigned long lastShiftMs;
};

struct SpectrumRuntime {
  uint8_t trail[20];
  uint16_t maxFiltered256;
};

union MusicRuntime {
  VuRuntime vu;
  BandRuntime band;
  SpectrumRuntime spectrum;
};

// -------------------- globals --------------------

AlarmSettings alarmCfg;
FamilyAlarmSettings familyAlarm;
DawnSettings dawnCfg;
DawnRuntime dawnRuntime;
NightSettings nightCfg;
LightSettings lightCfg;
ClapSettings clapCfg;
CoreState coreCfg;
ExtendedSettings extCfg;
MusicRuntime musicRt;
PresetPersist presetCfg;

SystemMode currentMode = SystemMode::OFF;
DawnPhase dawnPhase = DawnPhase::IDLE;
bool dawnRecoveredAtBoot = false;

CRGB leds[Cfg::LED_COUNT];

char rxBuffer[Cfg::RX_BUFFER_SIZE];
size_t rxLength = 0;
unsigned long lastSerialRxMs = 0;
bool frameDirty = false;
uint8_t requestedBrightness = 255;

bool rtcPresent = false;
bool rtcLostPower = true;
bool rtcReadOk = false;
unsigned long lastRtcPollMs = 0;

bool nightEffectivePower = false;
bool nightWindowActive = false;

struct NightFade {
  bool active = false;
  bool offAtEnd = false;
  uint8_t from = 0, to = 0;
  unsigned long started = 0;
};
NightFade nightFade;

unsigned long lastDawnFrameMs = 0;
unsigned long dawnStartMs = 0;
unsigned long dawnDurationMs = 0;

unsigned long lastMusicFrameMs = 0;
unsigned long lastAmbientFrameMs = 0;
uint32_t presetPhaseQ16 = 0;  // shared phase for active Pxx; no extra RGB buffer
unsigned long lastAmbientAutoMs = 0;
uint8_t ambientRuntimeHue = 0;

uint8_t rawResetFlags = 0;
bool coldBoot = true;
uint32_t ramResetCookie __attribute__((section(".noinit")));

// -------------------- small helpers --------------------

uint8_t checksum(const uint8_t* bytes, uint8_t len) {
  uint8_t c = 0x5A;
  for (uint8_t i = 0; i < len; ++i) {
    c = static_cast<uint8_t>((c << 1) | (c >> 7));
    c ^= bytes[i];
  }
  return c;
}

uint8_t bcdToDec(uint8_t v) {
  return static_cast<uint8_t>((v >> 4) * 10 + (v & 0x0F));
}

uint8_t decToBcd(uint8_t v) {
  return static_cast<uint8_t>(((v / 10) << 4) | (v % 10));
}

bool isLeapYear(uint16_t y) {
  if ((y % 400) == 0) return true;
  if ((y % 100) == 0) return false;
  return (y % 4) == 0;
}

uint8_t daysInMonth(uint16_t y, uint8_t m) {
  static const uint8_t days[] = {
    31,28,31,30,31,30,31,31,30,31,30,31
  };
  if (m < 1 || m > 12) return 0;
  if (m == 2 && isLeapYear(y)) return 29;
  return days[m - 1];
}

bool validRtc(const RtcTime& t) {
  return t.year >= 2000 && t.year <= 2099 &&
         t.month >= 1 && t.month <= 12 &&
         t.day >= 1 && t.day <= daysInMonth(t.year, t.month) &&
         t.hour <= 23 && t.minute <= 59 && t.second <= 59;
}

void print2(uint8_t v) {
  if (v < 10) Serial.print('0');
  Serial.print(v);
}

void print4(uint16_t v) {
  if (v < 1000) Serial.print('0');
  if (v < 100) Serial.print('0');
  if (v < 10) Serial.print('0');
  Serial.print(v);
}

void printRtc(const RtcTime& t) {
  print4(t.year); Serial.print('-');
  print2(t.month); Serial.print('-');
  print2(t.day); Serial.print(' ');
  print2(t.hour); Serial.print(':');
  print2(t.minute); Serial.print(':');
  print2(t.second);
}

const __FlashStringHelper* modeName(SystemMode m) {
  switch (m) {
    case SystemMode::OFF: return F("OFF");
    case SystemMode::LIGHT: return F("L01");
    case SystemMode::NIGHT: return F("NIGHT");
    case SystemMode::DAWN: return F("DAWN");
    case SystemMode::AMBIENT: return F("AMBIENT");
    case SystemMode::MUSIC: return F("MUSIC");
  }
  return F("?");
}

const __FlashStringHelper* dawnPhaseName() {
  switch (dawnPhase) {
    case DawnPhase::IDLE: return F("IDLE");
    case DawnPhase::RUNNING: return F("RUNNING");
    case DawnPhase::HOLD: return F("HOLD");
  }
  return F("?");
}

const __FlashStringHelper* dawnSourceName(DawnSource s) {
  switch (s) {
    case DawnSource::NONE: return F("NONE");
    case DawnSource::ALARM: return F("ALARM");
    case DawnSource::MANUAL: return F("MANUAL");
    case DawnSource::TEST: return F("TEST");
  }
  return F("?");
}

bool serialGuard() {
  return (millis() - lastSerialRxMs) < Cfg::SERIAL_RX_GUARD_MS;
}

bool parseLongRange(const char* text, long lo, long hi, long& value) {
  if (text == nullptr || *text == '\0') return false;
  char* end = nullptr;
  const long v = strtol(text, &end, 10);
  if (*end != '\0' || v < lo || v > hi) return false;
  value = v;
  return true;
}

bool parseByte(const char* text, uint8_t& value) {
  long v = 0;
  if (!parseLongRange(text, 0, 255, v)) return false;
  value = static_cast<uint8_t>(v);
  return true;
}

bool parseClock(const char* text, uint8_t& h, uint8_t& m) {
  if (text == nullptr || strlen(text) != 5 || text[2] != ':') return false;
  if (text[0] < '0' || text[0] > '9' ||
      text[1] < '0' || text[1] > '9' ||
      text[3] < '0' || text[3] > '9' ||
      text[4] < '0' || text[4] > '9') return false;
  h = static_cast<uint8_t>((text[0]-'0')*10 + (text[1]-'0'));
  m = static_cast<uint8_t>((text[3]-'0')*10 + (text[4]-'0'));
  return h <= 23 && m <= 59;
}

bool parseFixed(const char* text, uint8_t len, uint16_t& value) {
  value = 0;
  for (uint8_t i = 0; i < len; ++i) {
    if (text[i] < '0' || text[i] > '9') return false;
    value = static_cast<uint16_t>(value * 10 + (text[i]-'0'));
  }
  return true;
}

bool parseSetTime(const char* text, RtcTime& t) {
  if (strlen(text) != 19 ||
      text[4] != '-' || text[7] != '-' || text[10] != ' ' ||
      text[13] != ':' || text[16] != ':') return false;

  uint16_t y,mo,d,h,mi,s;
  if (!parseFixed(text+0,4,y) ||
      !parseFixed(text+5,2,mo) ||
      !parseFixed(text+8,2,d) ||
      !parseFixed(text+11,2,h) ||
      !parseFixed(text+14,2,mi) ||
      !parseFixed(text+17,2,s)) return false;

  t.year=y; t.month=mo; t.day=d; t.hour=h; t.minute=mi; t.second=s;
  return validRtc(t);
}

// -------------------- RTC --------------------

void twiMasterInit(){
  TWSR=0;
  TWBR=static_cast<uint8_t>(((F_CPU/100000UL)-16UL)/2UL);
  TWCR=_BV(TWEN);
}

bool twiWait(){
  uint16_t guard=60000;
  while(!(TWCR&_BV(TWINT)) && --guard){}
  return guard!=0;
}

bool twiStart(uint8_t addressRw){
  TWCR=_BV(TWINT)|_BV(TWSTA)|_BV(TWEN);
  if(!twiWait())return false;
  uint8_t st=TWSR&0xF8;
  if(st!=TW_START && st!=TW_REP_START)return false;
  TWDR=addressRw;
  TWCR=_BV(TWINT)|_BV(TWEN);
  if(!twiWait())return false;
  st=TWSR&0xF8;
  return st==TW_MT_SLA_ACK || st==TW_MR_SLA_ACK;
}

void twiStop(){
  TWCR=_BV(TWINT)|_BV(TWEN)|_BV(TWSTO);
}

bool twiWriteByte(uint8_t value){
  TWDR=value;
  TWCR=_BV(TWINT)|_BV(TWEN);
  if(!twiWait())return false;
  return (TWSR&0xF8)==TW_MT_DATA_ACK;
}

bool twiReadByte(uint8_t& value,bool ack){
  TWCR=_BV(TWINT)|_BV(TWEN)|(ack?_BV(TWEA):0);
  if(!twiWait())return false;
  const uint8_t st=TWSR&0xF8;
  if(st!=(ack?TW_MR_DATA_ACK:TW_MR_DATA_NACK))return false;
  value=TWDR;
  return true;
}

bool rtcProbe(){
  if(!twiStart((Cfg::DS3231_ADDR<<1)|TW_WRITE)){twiStop();return false;}
  twiStop();return true;
}

bool rtcReadRegs(uint8_t reg,uint8_t* data,uint8_t len){
  if(!twiStart((Cfg::DS3231_ADDR<<1)|TW_WRITE)){twiStop();return false;}
  if(!twiWriteByte(reg)){twiStop();return false;}
  if(!twiStart((Cfg::DS3231_ADDR<<1)|TW_READ)){twiStop();return false;}
  for(uint8_t i=0;i<len;++i){
    if(!twiReadByte(data[i],i+1<len)){twiStop();return false;}
  }
  twiStop();return true;
}

bool rtcWriteRegs(uint8_t reg,const uint8_t* data,uint8_t len){
  if(!twiStart((Cfg::DS3231_ADDR<<1)|TW_WRITE)){twiStop();return false;}
  if(!twiWriteByte(reg)){twiStop();return false;}
  for(uint8_t i=0;i<len;++i){
    if(!twiWriteByte(data[i])){twiStop();return false;}
  }
  twiStop();return true;
}

bool rtcWriteReg(uint8_t reg,uint8_t value){
  return rtcWriteRegs(reg,&value,1);
}

bool rtcReadLostPower(bool& lost) {
  uint8_t s=0;
  if (!rtcReadRegs(0x0F,&s,1)) return false;
  lost = (s & 0x80) != 0;
  return true;
}

bool rtcClearLostPower() {
  uint8_t s=0;
  if (!rtcReadRegs(0x0F,&s,1)) return false;
  s &= static_cast<uint8_t>(~0x80);
  return rtcWriteReg(0x0F,s);
}

bool rtcRead(RtcTime& t) {
  uint8_t d[7]={0};
  if (!rtcReadRegs(0x00,d,7)) return false;

  t.second=bcdToDec(d[0]&0x7F);
  t.minute=bcdToDec(d[1]&0x7F);

  const uint8_t hr=d[2];
  if (hr & 0x40) {
    const uint8_t h12=bcdToDec(hr&0x1F);
    const bool pm=(hr&0x20)!=0;
    t.hour=(h12==12)?(pm?12:0):static_cast<uint8_t>(h12+(pm?12:0));
  } else {
    t.hour=bcdToDec(hr&0x3F);
  }

  t.day=bcdToDec(d[4]&0x3F);
  t.month=bcdToDec(d[5]&0x1F);
  t.year=static_cast<uint16_t>(2000+bcdToDec(d[6]));
  return validRtc(t);
}

bool rtcSet(const RtcTime& t) {
  if(!validRtc(t))return false;
  uint8_t d[7]={
    decToBcd(t.second),decToBcd(t.minute),decToBcd(t.hour),decToBcd(1),
    decToBcd(t.day),decToBcd(t.month),decToBcd(static_cast<uint8_t>(t.year-2000))
  };
  if(!rtcWriteRegs(0x00,d,7))return false;
  return rtcClearLostPower();
}

bool rtcValidNow(RtcTime* out=nullptr) {
  rtcPresent=rtcProbe();
  if (!rtcPresent) {
    rtcReadOk=false; rtcLostPower=true; return false;
  }

  bool lost=true;
  if (!rtcReadLostPower(lost)) {
    rtcReadOk=false; rtcLostPower=true; return false;
  }
  rtcLostPower=lost;

  RtcTime now;
  if (!rtcRead(now)) {
    rtcReadOk=false; return false;
  }
  rtcReadOk=true;
  if (out) *out=now;
  return !rtcLostPower;
}

uint32_t rtcSeconds2000(const RtcTime& t) {
  uint32_t days=0;
  for (uint16_t y=2000;y<t.year;++y) days += isLeapYear(y)?366UL:365UL;
  for (uint8_t m=1;m<t.month;++m) days += daysInMonth(t.year,m);
  days += static_cast<uint32_t>(t.day-1);
  return days*86400UL +
         static_cast<uint32_t>(t.hour)*3600UL +
         static_cast<uint32_t>(t.minute)*60UL + t.second;
}

// -------------------- EEPROM: Alarm/Dawn --------------------

void saveAlarm() {
  uint8_t b[9];
  b[0]=Cfg::ALARM_MAGIC&0xFF; b[1]=Cfg::ALARM_MAGIC>>8;
  b[2]=Cfg::ALARM_VER; b[3]=alarmCfg.enabled?1:0;
  b[4]=alarmCfg.hour; b[5]=alarmCfg.minute;
  b[6]=(alarmCfg.lastTriggerYear>=2000 && alarmCfg.lastTriggerYear<=2099)
      ? static_cast<uint8_t>(alarmCfg.lastTriggerYear-2000) : 0xFF;
  b[7]=alarmCfg.lastTriggerMonth; b[8]=alarmCfg.lastTriggerDay;
  for(uint8_t i=0;i<9;++i) EEPROM.update(Cfg::ALARM_BASE+i,b[i]);
  EEPROM.update(Cfg::ALARM_BASE+9,checksum(b,9));
  alarmCfg.storageValid=true;
}

void loadAlarm() {
  uint8_t b[9];
  for(uint8_t i=0;i<9;++i) b[i]=EEPROM.read(Cfg::ALARM_BASE+i);
  const uint16_t magic=static_cast<uint16_t>(b[0])|(static_cast<uint16_t>(b[1])<<8);
  const bool ok=magic==Cfg::ALARM_MAGIC && b[2]==Cfg::ALARM_VER &&
      EEPROM.read(Cfg::ALARM_BASE+9)==checksum(b,9) &&
      b[3]<=1 && b[4]<=23 && b[5]<=59 && b[7]<=12 && b[8]<=31;
  if(!ok){ alarmCfg=AlarmSettings(); return; }
  alarmCfg.enabled=b[3]!=0; alarmCfg.hour=b[4]; alarmCfg.minute=b[5];
  if(b[6]==0xFF || b[7]==0 || b[8]==0) {
    alarmCfg.lastTriggerYear=0; alarmCfg.lastTriggerMonth=0; alarmCfg.lastTriggerDay=0;
  } else {
    alarmCfg.lastTriggerYear=2000+b[6]; alarmCfg.lastTriggerMonth=b[7]; alarmCfg.lastTriggerDay=b[8];
  }
  alarmCfg.storageValid=true;
}

struct FamilyAlarmPersist {
  uint16_t magic;
  uint8_t version,weekdayFlag,weekendFlag,hour,minute,hold,sum;
};
static_assert(sizeof(FamilyAlarmPersist)==9,"FamilyAlarm EEPROM ABI must be 9 bytes");

void saveFamilyAlarm(){
  FamilyAlarmPersist d={
      Cfg::FAMILY_ALARM_MAGIC,Cfg::FAMILY_ALARM_VER,
      static_cast<uint8_t>(familyAlarm.weekdaysEnabled),
      static_cast<uint8_t>(familyAlarm.weekendsEnabled),
      familyAlarm.weekendHour,familyAlarm.weekendMinute,familyAlarm.holdMinutes,0
  };
  d.sum=checksum(reinterpret_cast<const uint8_t*>(&d),8);
  EEPROM.put(Cfg::FAMILY_ALARM_BASE,d);
}
void loadFamilyAlarm(){
  FamilyAlarmPersist d{};
  EEPROM.get(Cfg::FAMILY_ALARM_BASE,d);
  if(d.magic!=Cfg::FAMILY_ALARM_MAGIC||d.version!=Cfg::FAMILY_ALARM_VER||
     d.hour>23||d.minute>59||d.hold>120||
     d.sum!=checksum(reinterpret_cast<const uint8_t*>(&d),8)){
    familyAlarm=FamilyAlarmSettings();return;
  }
  familyAlarm.weekdaysEnabled=d.weekdayFlag!=0;
  familyAlarm.weekendsEnabled=d.weekendFlag!=0;
  familyAlarm.weekendHour=d.hour;familyAlarm.weekendMinute=d.minute;
  familyAlarm.holdMinutes=d.hold;
}

void saveDawnSettings() {
  uint8_t b[7];
  b[0]=Cfg::DAWN_MAGIC&0xFF; b[1]=Cfg::DAWN_MAGIC>>8; b[2]=Cfg::DAWN_VER;
  b[3]=dawnCfg.fadeMinutes; b[4]=dawnCfg.maxBrightness;
  b[5]=dawnCfg.startStep; b[6]=dawnCfg.endStep;
  for(uint8_t i=0;i<7;++i) EEPROM.update(Cfg::DAWN_BASE+i,b[i]);
  EEPROM.update(Cfg::DAWN_BASE+7,checksum(b,7));
  dawnCfg.storageValid=true;
}

void loadDawnSettings() {
  uint8_t b[7];
  for(uint8_t i=0;i<7;++i) b[i]=EEPROM.read(Cfg::DAWN_BASE+i);
  const uint16_t magic=static_cast<uint16_t>(b[0])|(static_cast<uint16_t>(b[1])<<8);
  const bool ok=magic==Cfg::DAWN_MAGIC && b[2]==Cfg::DAWN_VER &&
      EEPROM.read(Cfg::DAWN_BASE+7)==checksum(b,7) &&
      b[3]>=1 && b[3]<=120 && b[4]>=1 &&
      b[5]<=Cfg::DAWN_MAX_STEP && b[6]<=Cfg::DAWN_MAX_STEP && b[5]<=b[6];
  if(!ok){
    // Old HSV settings must not cause colored wake-ups after upgrade.
    // Keep the separate RTC alarm/last-trigger EEPROM block untouched.
    dawnCfg=DawnSettings(); return;
  }
  dawnCfg.fadeMinutes=b[3]; dawnCfg.maxBrightness=b[4];
  dawnCfg.startStep=b[5]; dawnCfg.endStep=b[6]; dawnCfg.storageValid=true;
}

void writeU32(uint8_t* p,uint32_t v){
  p[0]=v&0xFF; p[1]=(v>>8)&0xFF; p[2]=(v>>16)&0xFF; p[3]=(v>>24)&0xFF;
}
uint32_t readU32(const uint8_t* p){
  return static_cast<uint32_t>(p[0]) |
         (static_cast<uint32_t>(p[1])<<8) |
         (static_cast<uint32_t>(p[2])<<16) |
         (static_cast<uint32_t>(p[3])<<24);
}

void saveDawnRuntime() {
  uint8_t b[13];
  b[0]=Cfg::DAWN_RUNTIME_MAGIC&0xFF; b[1]=Cfg::DAWN_RUNTIME_MAGIC>>8;
  b[2]=Cfg::DAWN_RUNTIME_VER;
  b[3]=static_cast<uint8_t>(dawnRuntime.phase);
  b[4]=static_cast<uint8_t>(dawnRuntime.source);
  writeU32(b+5,dawnRuntime.startRtcSeconds);
  writeU32(b+9,dawnRuntime.durationSeconds);
  for(uint8_t i=0;i<13;++i) EEPROM.update(Cfg::DAWN_RUNTIME_BASE+i,b[i]);
  EEPROM.update(Cfg::DAWN_RUNTIME_BASE+13,checksum(b,13));
  dawnRuntime.storageValid=true;
}

void loadDawnRuntime() {
  uint8_t b[13];
  for(uint8_t i=0;i<13;++i) b[i]=EEPROM.read(Cfg::DAWN_RUNTIME_BASE+i);
  const uint16_t magic=static_cast<uint16_t>(b[0])|(static_cast<uint16_t>(b[1])<<8);
  const bool ok=magic==Cfg::DAWN_RUNTIME_MAGIC && b[2]==Cfg::DAWN_RUNTIME_VER &&
      EEPROM.read(Cfg::DAWN_RUNTIME_BASE+13)==checksum(b,13) &&
      b[3]<=static_cast<uint8_t>(DawnPhase::HOLD) &&
      b[4]<=static_cast<uint8_t>(DawnSource::TEST);
  if(!ok){ dawnRuntime=DawnRuntime(); return; }
  dawnRuntime.phase=static_cast<DawnPhase>(b[3]);
  dawnRuntime.source=static_cast<DawnSource>(b[4]);
  dawnRuntime.startRtcSeconds=readU32(b+5);
  dawnRuntime.durationSeconds=readU32(b+9);
  dawnRuntime.storageValid=true;
}

void setDawnRuntimeIdle() {
  dawnRuntime.phase=DawnPhase::IDLE;
  dawnRuntime.source=DawnSource::NONE;
  dawnRuntime.startRtcSeconds=0;
  dawnRuntime.durationSeconds=0;
  saveDawnRuntime();
}

// -------------------- EEPROM: Night --------------------

void saveNight() {
  uint8_t b[12];
  b[0]=Cfg::NIGHT_MAGIC&0xFF; b[1]=Cfg::NIGHT_MAGIC>>8; b[2]=Cfg::NIGHT_VER;
  b[3]=nightCfg.manualEnabled?1:0;
  b[4]=nightCfg.hue; b[5]=nightCfg.saturation; b[6]=nightCfg.brightness;
  b[7]=nightCfg.scheduleEnabled?1:0;
  b[8]=nightCfg.onHour; b[9]=nightCfg.onMinute;
  b[10]=nightCfg.offHour; b[11]=nightCfg.offMinute;
  for(uint8_t i=0;i<12;++i) EEPROM.update(Cfg::NIGHT_BASE+i,b[i]);
  EEPROM.update(Cfg::NIGHT_BASE+12,checksum(b,12));
  nightCfg.storageValid=true;
}

void loadNight() {
  uint8_t b[12];
  for(uint8_t i=0;i<12;++i) b[i]=EEPROM.read(Cfg::NIGHT_BASE+i);
  const uint16_t magic=static_cast<uint16_t>(b[0])|(static_cast<uint16_t>(b[1])<<8);
  const bool ok=magic==Cfg::NIGHT_MAGIC && b[2]==Cfg::NIGHT_VER &&
      EEPROM.read(Cfg::NIGHT_BASE+12)==checksum(b,12) &&
      b[3]<=1 && b[7]<=1 && b[8]<=23 && b[9]<=59 &&
      b[10]<=23 && b[11]<=59 && !(b[8]==b[10] && b[9]==b[11]);
  if(!ok){ nightCfg=NightSettings(); return; }
  nightCfg.manualEnabled=b[3]!=0; nightCfg.hue=b[4]; nightCfg.saturation=b[5];
  nightCfg.brightness=b[6]; nightCfg.scheduleEnabled=b[7]!=0;
  nightCfg.onHour=b[8]; nightCfg.onMinute=b[9];
  nightCfg.offHour=b[10]; nightCfg.offMinute=b[11];
  nightCfg.storageValid=true;
}

// -------------------- EEPROM: L01 --------------------

uint8_t lightChecksum(const LightPersist& d) {
  const uint8_t* p=reinterpret_cast<const uint8_t*>(&d);
  uint8_t s=0x5A;
  for(size_t i=0;i<sizeof(LightPersist)-1;++i){
    s=static_cast<uint8_t>((s<<1)|(s>>7)); s^=p[i];
  }
  return s;
}

void loadLight() {
  LightPersist d;
  EEPROM.get(Cfg::LIGHT_BASE,d);
  const bool ok=d.magic==Cfg::LIGHT_MAGIC && d.version==Cfg::LIGHT_VER &&
      d.colorMode<=static_cast<uint8_t>(ColorMode::RGB) &&
      d.kelvin>=Cfg::MIN_KELVIN && d.kelvin<=Cfg::MAX_KELVIN &&
      d.sum==lightChecksum(d);
  if(!ok){ lightCfg=LightSettings(); return; }
  lightCfg.colorMode=static_cast<ColorMode>(d.colorMode);
  lightCfg.brightness=d.brightness; lightCfg.kelvin=d.kelvin;
  lightCfg.customRgb=CRGB(d.r,d.g,d.b);
  lightCfg.storageValid=true; lightCfg.dirty=false;
}

void saveLight() {
  LightPersist d;
  d.magic=Cfg::LIGHT_MAGIC; d.version=Cfg::LIGHT_VER;
  d.colorMode=static_cast<uint8_t>(lightCfg.colorMode);
  d.brightness=lightCfg.brightness; d.kelvin=lightCfg.kelvin;
  d.r=lightCfg.customRgb.r; d.g=lightCfg.customRgb.g; d.b=lightCfg.customRgb.b;
  d.sum=0; d.sum=lightChecksum(d);
  EEPROM.put(Cfg::LIGHT_BASE,d);
  lightCfg.storageValid=true; lightCfg.dirty=false;
}

// -------------------- EEPROM: Clap/Core --------------------

uint8_t clapChecksum(const ClapPersist& d) {
  const uint8_t* p=reinterpret_cast<const uint8_t*>(&d);
  uint8_t s=0xA7;
  for(size_t i=0;i<sizeof(ClapPersist)-1;++i){
    s=static_cast<uint8_t>((s<<1)|(s>>7)); s^=p[i];
  }
  return s;
}

void loadClap() {
  ClapPersist d;
  EEPROM.get(Cfg::CLAP_BASE,d);
  const bool ok=d.magic==Cfg::CLAP_MAGIC && d.version==Cfg::CLAP_VER &&
      d.threshold>=20 && d.threshold<=300 &&
      d.timeoutMs>=250 && d.timeoutMs<=1200 &&
      d.sum==clapChecksum(d);
  if(!ok){ clapCfg=ClapSettings(); return; }
  clapCfg.threshold=d.threshold;
  clapCfg.timeoutMs=d.timeoutMs;
  clapCfg.storageValid=true;
  clapCfg.dirty=false;
}

void saveClap() {
  ClapPersist d;
  d.magic=Cfg::CLAP_MAGIC;
  d.version=Cfg::CLAP_VER;
  d.threshold=clapCfg.threshold;
  d.timeoutMs=clapCfg.timeoutMs;
  d.sum=0;
  d.sum=clapChecksum(d);
  EEPROM.put(Cfg::CLAP_BASE,d);
  clapCfg.storageValid=true;
  clapCfg.dirty=false;
}

void loadCore() {
  uint8_t b[5];
  for(uint8_t i=0;i<5;++i) b[i]=EEPROM.read(Cfg::CORE_BASE+i);
  const uint16_t magic=static_cast<uint16_t>(b[0])|(static_cast<uint16_t>(b[1])<<8);
  const bool ok=magic==Cfg::CORE_MAGIC && b[2]==Cfg::CORE_VER &&
      b[3]<=static_cast<uint8_t>(SystemMode::MUSIC) && b[4]<=1 &&
      EEPROM.read(Cfg::CORE_BASE+5)==checksum(b,5);
  if(!ok){ coreCfg=CoreState(); return; }
  coreCfg.lastMode=static_cast<SystemMode>(b[3]);
  coreCfg.clapEnabled=b[4]!=0;
  coreCfg.storageValid=true;
}

void saveCore() {
  SystemMode persistMode=currentMode;
  if(persistMode==SystemMode::DAWN) persistMode=SystemMode::OFF;
  uint8_t b[5];
  b[0]=Cfg::CORE_MAGIC&0xFF; b[1]=Cfg::CORE_MAGIC>>8; b[2]=Cfg::CORE_VER;
  b[3]=static_cast<uint8_t>(persistMode); b[4]=coreCfg.clapEnabled?1:0;
  for(uint8_t i=0;i<5;++i) EEPROM.update(Cfg::CORE_BASE+i,b[i]);
  EEPROM.update(Cfg::CORE_BASE+5,checksum(b,5));
  coreCfg.lastMode=persistMode; coreCfg.storageValid=true;
}



// -------------------- v1 extended persistence --------------------

void setMusicDefaults(MusicModeSettings& m, MusicMode id){
  m=MusicModeSettings();
  m.brightness=64;
  m.background=0;
  m.sensitivity=100;
  switch(id){
    case MusicMode::M01: m.smooth=30; break;
    case MusicMode::M02: m.smooth=30; m.aux=50; break; // rainbow step x10
    case MusicMode::M03:
    case MusicMode::M04: m.smooth=80; break;
    case MusicMode::M05: m.smooth=80; m.submode=0; break;
    case MusicMode::M08: m.smooth=80; m.speed=11; m.submode=0; break;
    case MusicMode::M09: m.speed=0; m.aux=5; break; // HUE_START / HUE_STEP
    default: break;
  }
}

void setExtendedDefaults(){
  extCfg=ExtendedSettings();
  extCfg.currentLimitMa=Cfg::DEFAULT_CURRENT_LIMIT_MA;
  extCfg.vuLowPass=300;
  extCfg.micDcOffset=250;
  extCfg.spectrumLowPass=40;
  extCfg.audioCalibrated=1;
  extCfg.selectedMusic=MusicMode::M01;
  for(uint8_t i=0;i<static_cast<uint8_t>(MusicMode::COUNT);++i)
    setMusicDefaults(extCfg.music[i],static_cast<MusicMode>(i));
  extCfg.ambient.effect=0;
  extCfg.ambient.f01Hue=0; extCfg.ambient.f01Sat=255; extCfg.ambient.f01Brightness=64;
  extCfg.ambient.f02Hue=0; extCfg.ambient.f02Sat=255; extCfg.ambient.f02Brightness=64; extCfg.ambient.f02Speed=100;
  extCfg.ambient.f03Hue=0; extCfg.ambient.f03Brightness=64; extCfg.ambient.f03Speed=1; extCfg.ambient.f03Step10=5;
  extCfg.ambient.autoCycle=0; extCfg.ambient.autoPeriodSec=10;
  extCfg.storageValid=false;
  extCfg.dirty=false;
}

uint8_t extendedChecksum(const ExtendedPersist& d){
  return checksum(reinterpret_cast<const uint8_t*>(&d),static_cast<uint8_t>(sizeof(ExtendedPersist)-1));
}

void saveExtended(){
  ExtendedPersist d{};
  d.magic=Cfg::EXT_MAGIC; d.version=Cfg::EXT_VER;
  d.currentLimitMa=extCfg.currentLimitMa;
  d.vuLowPass=extCfg.vuLowPass;
  d.micDcOffset=extCfg.micDcOffset;
  d.spectrumLowPass=extCfg.spectrumLowPass;
  d.audioCalibrated=extCfg.audioCalibrated;
  d.selectedMusic=static_cast<uint8_t>(extCfg.selectedMusic);
  memcpy(d.music,extCfg.music,sizeof(d.music));
  d.ambient=extCfg.ambient;
  d.sum=0; d.sum=extendedChecksum(d);
  EEPROM.put(Cfg::EXT_BASE,d);
  extCfg.storageValid=true; extCfg.dirty=false;
}

void loadExtended(){
  ExtendedPersist d{};
  EEPROM.get(Cfg::EXT_BASE,d);
  const bool ok=d.magic==Cfg::EXT_MAGIC && d.version==Cfg::EXT_VER &&
      d.sum==extendedChecksum(d) &&
      d.currentLimitMa>=Cfg::MIN_CURRENT_LIMIT_MA &&
      d.currentLimitMa<=Cfg::HARD_CURRENT_LIMIT_MA &&
      d.selectedMusic<static_cast<uint8_t>(MusicMode::COUNT) &&
      d.ambient.effect<=static_cast<uint8_t>(AmbientEffect::F03);
  if(!ok){setExtendedDefaults();return;}
  extCfg.currentLimitMa=d.currentLimitMa;
  extCfg.vuLowPass=d.vuLowPass;
  extCfg.micDcOffset=d.micDcOffset;
  extCfg.spectrumLowPass=d.spectrumLowPass;
  extCfg.audioCalibrated=d.audioCalibrated?1:0;
  extCfg.selectedMusic=static_cast<MusicMode>(d.selectedMusic);
  memcpy(extCfg.music,d.music,sizeof(extCfg.music));
  extCfg.ambient=d.ambient;
  extCfg.storageValid=true; extCfg.dirty=false;
}


// -------------------- independent ambient scene persistence --------------------
void presetDefaults(){
  memset(&presetCfg,0,sizeof(presetCfg));
  presetCfg.magic=Cfg::PRESET_MAGIC;
  presetCfg.version=Cfg::PRESET_VER;
  const uint8_t br[PRESET_COUNT]={115,128,102,64,115,64,51,89,128,102,77,115};
  const uint8_t dyn[PRESET_COUNT]={90,20,95,40,100,55,0,70,115,85,80,120};
  memcpy(presetCfg.brightness,br,PRESET_COUNT);
  memcpy(presetCfg.dynamics,dyn,PRESET_COUNT);
}
uint8_t presetSum(){
  return checksum(reinterpret_cast<const uint8_t*>(&presetCfg),
                  sizeof(PresetPersist)-1);
}
void savePresets(){
  presetCfg.magic=Cfg::PRESET_MAGIC; presetCfg.version=Cfg::PRESET_VER;
  presetCfg.sum=presetSum();
  const uint8_t* p=reinterpret_cast<const uint8_t*>(&presetCfg);
  for(uint8_t i=0;i<sizeof(PresetPersist);++i)EEPROM.update(Cfg::PRESET_BASE+i,p[i]);
}
void loadPresets(){
  EEPROM.get(Cfg::PRESET_BASE,presetCfg);
  if(presetCfg.magic!=Cfg::PRESET_MAGIC ||
     presetCfg.version!=Cfg::PRESET_VER ||
     presetCfg.selected>PRESET_COUNT ||
     presetCfg.sum!=presetSum())presetDefaults();
}
// PRESET_MOTION_BEGIN
// All OTHER P scenes preserve R2 speed. Only P11 "Breathing" starts ~20s instead
// of ~16s at dynamics=0; both reach the SAME maximum speed as R2.
// Integer-only monotonic ramp; no jump or phase reset on parameter change.
uint16_t advancePresetClock(uint32_t elapsedMs,uint8_t dynamics,
                            uint32_t& phaseQ16,bool breathing){
  uint16_t rate=static_cast<uint16_t>(512U+static_cast<uint16_t>(dynamics)*6U);
  if(breathing){
    rate-=static_cast<uint16_t>(
        (static_cast<uint16_t>(255U-dynamics)*3U+7U)>>3);
  }
  phaseQ16+=elapsedMs*static_cast<uint32_t>(rate);
  return static_cast<uint16_t>(phaseQ16>>16);
}
// PRESET_MOTION_END
uint8_t presetTri(uint8_t a){
  return a<128?static_cast<uint8_t>(a<<1):
               static_cast<uint8_t>((255U-a)<<1);
}
uint8_t presetHash(uint8_t v){
  v^=static_cast<uint8_t>(v<<3);
  v^=static_cast<uint8_t>(v>>5);
  return static_cast<uint8_t>(v*29U);
}

// No second RGB buffer, no Arduino String/delay, autonomous at loss of Wi-Fi.
// Uses local colors and movement for twelve visibly distinct scene types.
// PRESET_RENDER_V4_BEGIN
// Every scene uses a changing clock phase; no extra LED/RGB buffer.
// t advances by ~8..31 ticks/s at dynamics 0..255, rather than t>>2.
// Gentle scenes keep their palette but have visibly moving highlights.
void renderPreset(uint8_t scene,uint16_t t){
  const uint8_t phase=static_cast<uint8_t>(t);
  for(uint8_t i=0;i<Cfg::LED_COUNT;++i){
    const uint8_t w=presetTri(static_cast<uint8_t>(i*9U+phase));
    uint8_t h=120,sa=240,v=180;
    switch(scene){
      case 0: { // P01 aurora: two colored curtains in opposite directions
        const uint8_t veil=presetTri(static_cast<uint8_t>(i*5U-(phase>>1)));
        h=static_cast<uint8_t>(92U+(w>>2)+(veil>>4));
        v=static_cast<uint8_t>(55U+(w>>1)+(veil>>3));
        break;
      }
      case 1: // P02 Bali: stable sunset palette, moving golden light
        h=i<25?static_cast<uint8_t>(10U+i/2U):
                  static_cast<uint8_t>(224U+(i-25U)/2U);
        v=static_cast<uint8_t>(100U+(w>>1));
        break;
      case 2: // P03 ocean: rolling blue/cyan wave fronts
        h=static_cast<uint8_t>(151U-(w>>3));
        v=static_cast<uint8_t>(65U+(w>>1));
        break;
      case 3: { // P04 cosmos: several scattered, independently fading stars
        const uint8_t seed=presetHash(static_cast<uint8_t>(i*37U));
        h=165;sa=230;v=8;
        if(seed<47U){
          h=static_cast<uint8_t>(148U+(seed>>2));sa=75;
          v=static_cast<uint8_t>(12U+
             (presetTri(static_cast<uint8_t>(phase*3U+seed*5U))>>1));
        }
        break;
      }
      case 4: { // P05 fireplace: irregular orange flame flicker
        const uint8_t flick=presetTri(static_cast<uint8_t>(
            phase*3U+presetHash(static_cast<uint8_t>(i*37U))));
        h=static_cast<uint8_t>(4U+(flick>>4));
        sa=250;v=static_cast<uint8_t>(50U+(flick>>1));
        break;
      }
      case 5: { // P06 candles: softer golden flicker
        const uint8_t flick=presetTri(static_cast<uint8_t>(
            phase*3U+presetHash(static_cast<uint8_t>(i*11U))));
        h=19;sa=225;v=static_cast<uint8_t>(105U+(flick>>2));
        break;
      }
      case 6: // P07 moonlight: drifting shadows, muted icy blue
        h=150;sa=48;v=static_cast<uint8_t>(65U+(w>>1));
        break;
      case 7: // P08 forest: moving leaf shade and warm dappled sun
        h=static_cast<uint8_t>(84U+(w>>3));
        v=static_cast<uint8_t>(70U+(w>>1));
        if(presetHash(static_cast<uint8_t>(i*43U))<24U){
          h=27;sa=170;
          v=static_cast<uint8_t>(95U+
             (presetTri(static_cast<uint8_t>(phase+i*13U))>>1));
        }
        break;
      case 8: { // P09 neon: rotating cyan/magenta blocks with light pulse
        const uint8_t pos=static_cast<uint8_t>(i*9U+phase);
        h=(pos&32U)?212U:130U;
        v=static_cast<uint8_t>(150U+(presetTri(static_cast<uint8_t>(
            i*7U+(phase<<1)))>>2));
        break;
      }
      case 9: // P10 lava: slowly moving hot ruby/amber blobs
        h=static_cast<uint8_t>(253U+(w>>4));
        v=static_cast<uint8_t>(40U+(w>>1));
        break;
      case 10: // breathing: whole circle slow pulse
        h=118;sa=175;
        v=static_cast<uint8_t>(45U+(presetTri(static_cast<uint8_t>(t<<1))>>1));break;
      default: // P12 rainbow: steadily rotating full ring spectrum
        h=static_cast<uint8_t>(i*6U+phase);sa=255;v=225;
        break;
    }
    leds[i]=CHSV(h,sa,v);
  }
  requestedBrightness=presetCfg.brightness[scene];
  frameDirty=true;
}
// PRESET_RENDER_V4_END
void printPresets(){
  Serial.print(F("D 115 1 "));
  Serial.print(presetCfg.selected);Serial.print(' ');
  Serial.print(currentMode==SystemMode::AMBIENT && presetCfg.selected!=0?1:0);
  for(uint8_t i=0;i<PRESET_COUNT;++i){
    Serial.print(' ');Serial.print(presetCfg.brightness[i]);
    Serial.print(' ');Serial.print(presetCfg.dynamics[i]);
  }
  Serial.println();
}

// -------------------- Light color/render --------------------


const TempAnchor TEMP[] PROGMEM = {
  {1800,255,147,41},{2200,255,157,61},{2700,255,170,87},{3000,255,183,114},
  {4000,255,228,206},{5000,255,244,234},{6000,245,249,255},{6500,232,241,255}
};
constexpr uint8_t TEMP_N=sizeof(TEMP)/sizeof(TEMP[0]);

uint8_t lerp8(uint8_t a,uint8_t b,uint16_t n,uint16_t d){
  if(!d) return a;
  const int32_t v=static_cast<int32_t>(a) +
      (static_cast<int32_t>(static_cast<int16_t>(b)-a)*n)/d;
  return v<0?0:(v>255?255:static_cast<uint8_t>(v));
}

TempAnchor tempAnchor(uint8_t i){
  TempAnchor a;
  memcpy_P(&a,&TEMP[i],sizeof(a));
  return a;
}

CRGB kelvinRgb(uint16_t k){
  TempAnchor a=tempAnchor(0);
  if(k<=a.k)return CRGB(a.r,a.g,a.b);
  for(uint8_t i=0;i<TEMP_N-1;++i){
    const TempAnchor b=tempAnchor(i+1);
    if(k<=b.k){
      const uint16_t n=k-a.k,d=b.k-a.k;
      return CRGB(lerp8(a.r,b.r,n,d),lerp8(a.g,b.g,n,d),lerp8(a.b,b.b,n,d));
    }
    a=b;
  }
  return CRGB(a.r,a.g,a.b);
}

CRGB lightColor(){
  return lightCfg.colorMode==ColorMode::RGB ? lightCfg.customRgb : kelvinRgb(lightCfg.kelvin);
}

void prepareOff() {
  fill_solid(leds,Cfg::LED_COUNT,CRGB::Black);
  requestedBrightness=static_cast<uint8_t>(0); frameDirty=true;
}

void prepareLight() {
  fill_solid(leds,Cfg::LED_COUNT,lightColor());
  requestedBrightness=static_cast<uint8_t>(lightCfg.brightness); frameDirty=true;
}

uint16_t minuteOfDay(uint8_t h,uint8_t m){return static_cast<uint16_t>(h)*60U+m;}
void emitEvent(uint8_t code){
  Serial.print(F("V "));Serial.println(code);
}
void emitEvent2(uint8_t code,uint16_t value){
  Serial.print(F("V "));Serial.print(code);Serial.print(' ');Serial.println(value);
}
void emitEvent3(uint8_t code,uint16_t a,uint16_t b){
  Serial.print(F("V "));Serial.print(code);Serial.print(' ');Serial.print(a);Serial.print(' ');Serial.println(b);
}


bool insideNightWindow(const RtcTime& now){
  const uint16_t cur=minuteOfDay(now.hour,now.minute);
  const uint16_t on=minuteOfDay(nightCfg.onHour,nightCfg.onMinute);
  const uint16_t off=minuteOfDay(nightCfg.offHour,nightCfg.offMinute);
  return on<off ? (cur>=on && cur<off) : (cur>=on || cur<off);
}

bool reconcileNight(bool announce=false){
  (void)announce;
  if(nightCfg.scheduleEnabled){
    RtcTime now;
    if(rtcValidNow(&now))nightWindowActive=insideNightWindow(now);
  } else {
    nightWindowActive=false;
  }

  // Schedule is automation, not a permission gate. If NIGHT is selected
  // manually, render it at any time of day regardless of the schedule window.
  nightEffectivePower=currentMode==SystemMode::NIGHT;
  if(currentMode==SystemMode::NIGHT){
    fill_solid(leds,Cfg::LED_COUNT,CHSV(nightCfg.hue,nightCfg.saturation,255));
    requestedBrightness=static_cast<uint8_t>(nightCfg.brightness);
    frameDirty=true;
  }
  return true;
}

void applyMode(SystemMode m,bool persist);

void beginNightFade(uint8_t from,uint8_t to,bool offAtEnd) {
  nightFade.active=true;nightFade.offAtEnd=offAtEnd;
  nightFade.from=from;nightFade.to=to;nightFade.started=millis();
  requestedBrightness=from;frameDirty=true;
}

void updateNightFade() {
  if(!nightFade.active)return;
  if(currentMode!=SystemMode::NIGHT){nightFade.active=false;return;}
  const unsigned long dt=millis()-nightFade.started;
  if(dt>=Cfg::NIGHT_FADE_MS){
    nightFade.active=false;
    if(nightFade.offAtEnd)applyMode(SystemMode::OFF,true);
    else{requestedBrightness=nightFade.to;frameDirty=true;}
    return;
  }
  // 64 ms quantization gives 256 smooth steps over 16.32 s.
  // FastLED provides an efficient AVR 8-bit interpolation.
  const uint8_t value=lerp8by8(nightFade.from,nightFade.to,
      static_cast<uint8_t>(dt>>6));
  if(value!=requestedBrightness){
    requestedBrightness=value;frameDirty=true;
  }
}

bool syncNightSchedule(const RtcTime& now,bool announce=false,bool forceOn=false){
  if(!nightCfg.scheduleEnabled){
    nightWindowActive=false;
    return true;
  }

  const bool before=nightWindowActive;
  const bool active=insideNightWindow(now);
  const bool changed=active!=before;
  nightWindowActive=active;

  // ON boundary has priority over ordinary user modes, but never interrupts
  // an active dawn. After the boundary the user may select another mode.
  if(active && (changed||forceOn)){
    if(currentMode!=SystemMode::DAWN){
      const uint8_t from=(currentMode==SystemMode::OFF)?0:requestedBrightness;
      applyMode(SystemMode::NIGHT,false);
      beginNightFade(from,nightCfg.brightness,false);
    }
  } else if(!active && changed && currentMode==SystemMode::NIGHT){
    // OFF boundary only fades NIGHT; other user-selected modes are untouched.
    beginNightFade(requestedBrightness,0,true);
  }

  nightEffectivePower=currentMode==SystemMode::NIGHT;
  if(announce&&changed)emitEvent2(1,active?1:0);
  return true;
}

bool syncNightScheduleNow(bool announce=false,bool forceOn=false){
  if(!nightCfg.scheduleEnabled){
    nightWindowActive=false;
    return true;
  }
  RtcTime now;
  if(!rtcValidNow(&now))return false;
  return syncNightSchedule(now,announce,forceOn);
}

uint8_t limitedBrightness(){
  if(!requestedBrightness)return 0;
  uint32_t sum=0;
  for(uint8_t i=0;i<Cfg::LED_COUNT;++i)
    sum+=static_cast<uint16_t>(leds[i].r)+leds[i].g+leds[i].b;
  if(!sum)return requestedBrightness;
  // Two mirrored 44-LED rings, approx. 20 mA per RGB channel at value 255.
  const uint32_t denom=sum*40UL;
  uint32_t safe=static_cast<uint32_t>(extCfg.currentLimitMa)*65025UL/denom;
  if(safe>255)safe=255;
  return requestedBrightness<safe?requestedBrightness:static_cast<uint8_t>(safe);
}

void showIfSafe(){
  if(!frameDirty || serialGuard()) return;
  FastLED.setBrightness(limitedBrightness());
  FastLED.show(); frameDirty=false;
}


// -------------------- Ambient + shared Music engine --------------------

#define cbi(sfr, bit) (_SFR_BYTE(sfr) &= ~_BV(bit))
#define sbi(sfr, bit) (_SFR_BYTE(sfr) |= _BV(bit))

constexpr uint8_t MUSIC_DISPLAY_BINS=20;
constexpr uint8_t LOW_BIN_FIRST=2, LOW_BIN_LAST=5;
constexpr uint8_t MID_BIN_FIRST=6, MID_BIN_LAST=10;
constexpr uint8_t HIGH_BIN_FIRST=11, HIGH_BIN_LAST=31;
constexpr unsigned long MUSIC_FRAME_MS=5UL;
constexpr uint8_t MUSIC_DECAY_STEP=20;
constexpr int16_t MIC_DC_MIN=120, MIC_DC_MAX=400;

MusicModeSettings& activeMusicCfg(){
  return extCfg.music[static_cast<uint8_t>(extCfg.selectedMusic)];
}

const __FlashStringHelper* musicName(MusicMode m){
  switch(m){
    case MusicMode::M01:return F("M01"); case MusicMode::M02:return F("M02");
    case MusicMode::M03:return F("M03"); case MusicMode::M04:return F("M04");
    case MusicMode::M05:return F("M05"); case MusicMode::M08:return F("M08");
    case MusicMode::M09:return F("M09"); default:return F("M01");
  }
}

bool parseMusicMode(const char* p,MusicMode& out){
  if(strcmp(p,"M01")==0)out=MusicMode::M01;
  else if(strcmp(p,"M02")==0)out=MusicMode::M02;
  else if(strcmp(p,"M03")==0)out=MusicMode::M03;
  else if(strcmp(p,"M04")==0)out=MusicMode::M04;
  else if(strcmp(p,"M05")==0)out=MusicMode::M05;
  else if(strcmp(p,"M08")==0)out=MusicMode::M08;
  else if(strcmp(p,"M09")==0)out=MusicMode::M09;
  else return false;
  return true;
}

const __FlashStringHelper* ambientName(){
  switch(static_cast<AmbientEffect>(extCfg.ambient.effect)){
    case AmbientEffect::F01:return F("F01");
    case AmbientEffect::F02:return F("F02");
    case AmbientEffect::F03:return F("F03");
  }
  return F("F01");
}

void audioDefaultPrescaler(){
  sbi(ADCSRA,ADPS2); sbi(ADCSRA,ADPS1); sbi(ADCSRA,ADPS0);
}

void audioFastPrescaler(){
  sbi(ADCSRA,ADPS2); cbi(ADCSRA,ADPS1); sbi(ADCSRA,ADPS0);
}

bool musicUsesFht(){
  return extCfg.selectedMusic!=MusicMode::M01 && extCfg.selectedMusic!=MusicMode::M02;
}

void configureAudioForMode(){
  if(currentMode==SystemMode::MUSIC && musicUsesFht()) audioFastPrescaler();
  else audioDefaultPrescaler();
}

void resetMusicRuntime(){
  memset(&musicRt,0,sizeof(musicRt));
  lastMusicFrameMs=0;
  if(extCfg.selectedMusic==MusicMode::M01 || extCfg.selectedMusic==MusicMode::M02){
    musicRt.vu.averageLevel=50; musicRt.vu.maxLevel=100;
  }else if(extCfg.selectedMusic==MusicMode::M09){
    musicRt.spectrum.maxFiltered256=5U*256U;
  }else{
    const uint8_t bg=activeMusicCfg().background;
    for(uint8_t i=0;i<BAND_COUNT;++i) musicRt.band.brightness[i]=bg;
  }
  configureAudioForMode();
}

void analyzeFht(){
  for(uint8_t i=0;i<FHT_N;++i)
    fht_input[i]=static_cast<int16_t>(analogRead(Pins::MIC_IN))-extCfg.micDcOffset;
  fht_window(); fht_reorder(); fht_run(); fht_mag_log();
}

Bands readBands(){
  analyzeFht();
  Bands b{};
  const uint16_t sens=activeMusicCfg().sensitivity;
  for(uint8_t i=2;i<32;++i){
    uint8_t v=fht_log_out[i];
    if(v<extCfg.spectrumLowPass)v=0;
    else{
      uint16_t scaled=static_cast<uint16_t>(v)*sens/100U;
      v=scaled>255?255:static_cast<uint8_t>(scaled);
    }
    if(v>b.peak)b.peak=v;
    if(i>=LOW_BIN_FIRST&&i<=LOW_BIN_LAST){if(v>b.low)b.low=v;}
    else if(i>=MID_BIN_FIRST&&i<=MID_BIN_LAST){if(v>b.mid)b.mid=v;}
    else if(i>=HIGH_BIN_FIRST&&i<=HIGH_BIN_LAST){if(v>b.high)b.high=v;}
  }
  return b;
}

uint8_t bandValue(const Bands& b,uint8_t i){
  return i==BAND_LOW?b.low:(i==BAND_MID?b.mid:b.high);
}

uint8_t bandHue(uint8_t i){
  return i==BAND_LOW?HUE_RED:(i==BAND_MID?HUE_GREEN:HUE_YELLOW);
}

void updateBandRuntime(){
  musicRt.band.last=readBands();
  const MusicModeSettings& cfg=activeMusicCfg();
  for(uint8_t i=0;i<BAND_COUNT;++i){
    const uint8_t v=bandValue(musicRt.band.last,i);
    const int16_t avgDelta=static_cast<int16_t>(v)-static_cast<int16_t>(musicRt.band.average[i]);
    musicRt.band.average[i]=static_cast<uint16_t>(static_cast<int16_t>(musicRt.band.average[i])+avgDelta/166);
    musicRt.band.filtered[i]=static_cast<uint16_t>(
        (static_cast<uint32_t>(v)*cfg.smooth+
         static_cast<uint32_t>(musicRt.band.filtered[i])*(100U-cfg.smooth))/100U);
    const bool fire=v>0 &&
        static_cast<uint32_t>(musicRt.band.filtered[i])*10UL >
        static_cast<uint32_t>(musicRt.band.average[i])*12UL;
    if(fire){
      musicRt.band.brightness[i]=255;
      musicRt.band.flashMask|=_BV(i);
      musicRt.band.runningMask|=_BV(i);
    }else musicRt.band.flashMask&=~_BV(i);
    uint8_t& br=musicRt.band.brightness[i];
    br=br>=MUSIC_DECAY_STEP?br-MUSIC_DECAY_STEP:0;
    if(br<cfg.background)br=cfg.background;
    if(br<=cfg.background)musicRt.band.runningMask&=~_BV(i);
  }
}

void renderVu(bool rainbow){
  const MusicModeSettings& cfg=activeMusicCfg();
  if(cfg.background) fill_solid(leds,Cfg::LED_COUNT,CHSV(HUE_PURPLE,255,cfg.background));
  else fill_solid(leds,Cfg::LED_COUNT,CRGB::Black);
  const uint8_t maxPairs=Cfg::LED_COUNT/2;
  uint8_t pairs=musicRt.vu.pairs;
  if(pairs>maxPairs)pairs=maxPairs;
  for(uint8_t p=0;p<pairs;++p){
    CRGB c;
    if(rainbow){
      const uint8_t pi=static_cast<uint8_t>((static_cast<uint16_t>(p)*255U/maxPairs)-
          static_cast<uint8_t>(musicRt.vu.rainbowHue10/10U));
      c=ColorFromPalette(RainbowColors_p,pi);
    }else{
      const uint8_t hue=static_cast<uint8_t>(96U-(static_cast<uint16_t>(p)*96U/(maxPairs-1U)));
      c=CHSV(hue,255,255);
    }
    leds[p]=c;
    leds[Cfg::LED_COUNT-1U-p]=c;
  }
  requestedBrightness=static_cast<uint8_t>(cfg.brightness); frameDirty=true;
}

uint16_t readVuPeak(){
  uint16_t peak=0;
  for(uint8_t i=0;i<100;++i){const uint16_t v=analogRead(Pins::MIC_IN);if(v>peak)peak=v;}
  return peak;
}

void updateVu(bool rainbow){
  MusicModeSettings& cfg=activeMusicCfg();
  if(rainbow && millis()-musicRt.vu.lastRainbowMs>=30UL){
    musicRt.vu.lastRainbowMs=millis();
    musicRt.vu.rainbowHue10=static_cast<uint16_t>((musicRt.vu.rainbowHue10+cfg.aux)%2560U);
  }
  const uint16_t peak=readVuPeak();
  musicRt.vu.lastPeak=peak;
  uint16_t level=0;
  if(peak>extCfg.vuLowPass && extCfg.vuLowPass<1023){
    level=static_cast<uint16_t>(
        (static_cast<uint32_t>(peak-extCfg.vuLowPass)*500UL)/
        static_cast<uint16_t>(1023U-extCfg.vuLowPass));
    level=static_cast<uint16_t>(static_cast<uint32_t>(level)*cfg.sensitivity/100U);
    if(level>700)level=700;
  }
  musicRt.vu.filtered=static_cast<uint16_t>(
      (static_cast<uint32_t>(level)*cfg.smooth+
       static_cast<uint32_t>(musicRt.vu.filtered)*(100U-cfg.smooth))/100U);
  if(musicRt.vu.filtered>15){
    const int16_t delta=static_cast<int16_t>(musicRt.vu.filtered)-static_cast<int16_t>(musicRt.vu.averageLevel);
    musicRt.vu.averageLevel=static_cast<uint16_t>(
        static_cast<int16_t>(musicRt.vu.averageLevel)+delta/166);
    musicRt.vu.maxLevel=static_cast<uint16_t>(
        (static_cast<uint32_t>(musicRt.vu.averageLevel)*18UL)/10UL);
    if(musicRt.vu.maxLevel<1)musicRt.vu.maxLevel=1;
    uint32_t pairs=static_cast<uint32_t>(musicRt.vu.filtered)*(Cfg::LED_COUNT/2U)/musicRt.vu.maxLevel;
    if(pairs>Cfg::LED_COUNT/2U)pairs=Cfg::LED_COUNT/2U;
    musicRt.vu.pairs=static_cast<uint8_t>(pairs);
  }else musicRt.vu.pairs=0;
  renderVu(rainbow);
}

void renderM03(){
  const MusicModeSettings& cfg=activeMusicCfg();
  requestedBrightness=static_cast<uint8_t>(cfg.brightness);
  for(uint8_t i=0;i<Cfg::LED_COUNT;++i){
    const uint8_t zone=static_cast<uint8_t>((static_cast<uint16_t>(i)*5U)/Cfg::LED_COUNT);
    const uint8_t band=(zone==0||zone==4)?BAND_HIGH:((zone==1||zone==3)?BAND_MID:BAND_LOW);
    leds[i]=CHSV(bandHue(band),255,musicRt.band.brightness[band]);
  }
  frameDirty=true;
}

void renderM04(){
  const MusicModeSettings& cfg=activeMusicCfg();
  requestedBrightness=static_cast<uint8_t>(cfg.brightness);
  for(uint8_t i=0;i<Cfg::LED_COUNT;++i){
    const uint8_t zone=static_cast<uint8_t>((static_cast<uint16_t>(i)*3U)/Cfg::LED_COUNT);
    const uint8_t band=zone==0?BAND_HIGH:(zone==1?BAND_MID:BAND_LOW);
    leds[i]=CHSV(bandHue(band),255,musicRt.band.brightness[band]);
  }
  frameDirty=true;
}

bool selectedBand(uint8_t mask,uint8_t& band){
  switch(static_cast<BandSubmode>(activeMusicCfg().submode)){
    case BandSubmode::THREE:
      if(mask&_BV(BAND_HIGH)){band=BAND_HIGH;return true;}
      if(mask&_BV(BAND_MID)){band=BAND_MID;return true;}
      if(mask&_BV(BAND_LOW)){band=BAND_LOW;return true;}
      return false;
    case BandSubmode::LOW_ONLY: if(mask&_BV(BAND_LOW)){band=BAND_LOW;return true;} return false;
    case BandSubmode::MID_ONLY: if(mask&_BV(BAND_MID)){band=BAND_MID;return true;} return false;
    case BandSubmode::HIGH_ONLY:if(mask&_BV(BAND_HIGH)){band=BAND_HIGH;return true;}return false;
  }
  return false;
}

void renderM05(){
  const MusicModeSettings& cfg=activeMusicCfg();
  uint8_t band=0;
  if(selectedBand(musicRt.band.flashMask,band))
    fill_solid(leds,Cfg::LED_COUNT,CHSV(bandHue(band),255,musicRt.band.brightness[band]));
  else fill_solid(leds,Cfg::LED_COUNT,CHSV(HUE_PURPLE,255,cfg.background));
  requestedBrightness=static_cast<uint8_t>(cfg.brightness);frameDirty=true;
}

void shiftM08(){
  constexpr uint8_t leftCenter=Cfg::LED_COUNT/2-1;
  constexpr uint8_t rightCenter=Cfg::LED_COUNT/2;
  for(uint8_t i=0;i<leftCenter;++i)leds[i]=leds[i+1];
  for(uint8_t i=Cfg::LED_COUNT-1;i>rightCenter;--i)leds[i]=leds[i-1];
}

void renderM08(){
  MusicModeSettings& cfg=activeMusicCfg();
  const unsigned long now=millis();
  const uint8_t shiftMs=cfg.speed?cfg.speed:1;
  if(now-musicRt.band.lastShiftMs>=shiftMs){
    musicRt.band.lastShiftMs=now;shiftM08();
  }
  uint8_t band=0;
  CRGB c=CHSV(HUE_PURPLE,255,cfg.background);
  if(selectedBand(musicRt.band.runningMask,band))
    c=CHSV(bandHue(band),255,musicRt.band.brightness[band]);
  leds[Cfg::LED_COUNT/2-1]=c;
  leds[Cfg::LED_COUNT/2]=c;
  requestedBrightness=static_cast<uint8_t>(cfg.brightness);frameDirty=true;
}

void updateSpectrum(){
  analyzeFht();
  uint8_t frameMax=5;
  for(uint8_t i=0;i<30;++i){
    uint8_t v=fht_log_out[i+2];
    if(v<extCfg.spectrumLowPass)v=0;
    else{
      uint16_t scaled=static_cast<uint16_t>(v)*activeMusicCfg().sensitivity/100U;
      v=scaled>255?255:static_cast<uint8_t>(scaled);
    }
    if(v>frameMax)frameMax=v;
    if(i<MUSIC_DISPLAY_BINS){
      if(musicRt.spectrum.trail[i]<v)musicRt.spectrum.trail[i]=v;
      musicRt.spectrum.trail[i]=musicRt.spectrum.trail[i]>2?musicRt.spectrum.trail[i]-2:0;
    }
  }
  const int32_t target=static_cast<int32_t>(frameMax)*256L;
  const int32_t delta=target-static_cast<int32_t>(musicRt.spectrum.maxFiltered256);
  musicRt.spectrum.maxFiltered256=static_cast<uint16_t>(
      static_cast<int32_t>(musicRt.spectrum.maxFiltered256)+delta/166L);
  if(musicRt.spectrum.maxFiltered256<5U*256U)musicRt.spectrum.maxFiltered256=5U*256U;
}

void renderM09(){
  const MusicModeSettings& cfg=activeMusicCfg();
  constexpr uint8_t half=Cfg::LED_COUNT/2;
  for(uint8_t pos=0;pos<half;++pos){
    uint8_t bin=static_cast<uint8_t>((static_cast<uint16_t>(pos)*MUSIC_DISPLAY_BINS)/half);
    if(bin>=MUSIC_DISPLAY_BINS)bin=MUSIC_DISPLAY_BINS-1;
    uint32_t br32=static_cast<uint32_t>(musicRt.spectrum.trail[bin])*255UL*256UL/
        musicRt.spectrum.maxFiltered256;
    if(br32>255)br32=255;
    const uint8_t br=static_cast<uint8_t>(br32);
    const uint8_t hue=static_cast<uint8_t>(cfg.speed+static_cast<uint16_t>(pos)*cfg.aux);
    const CRGB c=CHSV(hue,255,br);
    leds[half-1-pos]=c;
    leds[half+pos]=c;
  }
  requestedBrightness=static_cast<uint8_t>(cfg.brightness);frameDirty=true;
}

void updateMusic(){
  if(currentMode!=SystemMode::MUSIC)return;
  const unsigned long now=millis();
  if(now-lastMusicFrameMs<MUSIC_FRAME_MS)return;
  lastMusicFrameMs=now;
  switch(extCfg.selectedMusic){
    case MusicMode::M01:updateVu(false);break;
    case MusicMode::M02:updateVu(true);break;
    case MusicMode::M03:updateBandRuntime();renderM03();break;
    case MusicMode::M04:updateBandRuntime();renderM04();break;
    case MusicMode::M05:updateBandRuntime();renderM05();break;
    case MusicMode::M08:updateBandRuntime();renderM08();break;
    case MusicMode::M09:updateSpectrum();renderM09();break;
    default:break;
  }
}

void calibrateAudio(){
  prepareOff(); FastLED.show(); frameDirty=false; delay(120);
  audioDefaultPrescaler();
  uint32_t sum=0;uint16_t quietMax=0;
  for(uint16_t i=0;i<256;++i){const uint16_t v=analogRead(Pins::MIC_IN);sum+=v;if(v>quietMax)quietMax=v;}
  extCfg.micDcOffset=static_cast<int16_t>(sum/256UL);
  for(uint16_t i=0;i<200;++i){const uint16_t v=analogRead(Pins::MIC_IN);if(v>quietMax)quietMax=v;delay(2);}
  uint32_t lp=static_cast<uint32_t>(quietMax)+13UL;
  extCfg.vuLowPass=lp>1000?1000:static_cast<uint16_t>(lp);
  if(extCfg.micDcOffset<MIC_DC_MIN||extCfg.micDcOffset>MIC_DC_MAX){
    extCfg.audioCalibrated=0;configureAudioForMode();
    uartErr(UE_STATE);return;
  }
  audioFastPrescaler();
  uint8_t spectrMax=0;
  for(uint8_t f=0;f<100;++f){
    analyzeFht();
    for(uint8_t b=2;b<32;++b)if(fht_log_out[b]>spectrMax)spectrMax=fht_log_out[b];
  }
  const uint16_t sp=static_cast<uint16_t>(spectrMax)+3U;
  extCfg.spectrumLowPass=sp>255?255:static_cast<uint8_t>(sp);
  extCfg.audioCalibrated=1;extCfg.dirty=true;saveExtended();resetMusicRuntime();
  Serial.print(F("D 90 0 "));Serial.print(extCfg.micDcOffset);Serial.print(' ');
  Serial.print(extCfg.vuLowPass);Serial.print(' ');Serial.println(extCfg.spectrumLowPass);
}

void prepareAmbient(){
  ambientRuntimeHue=0;
  presetPhaseQ16=0;
  lastAmbientFrameMs=millis();lastAmbientAutoMs=millis();
  frameDirty=true;
}

void nextAmbient(int8_t dir){
  int8_t e=static_cast<int8_t>(extCfg.ambient.effect)+dir;
  if(e<0)e=2;if(e>2)e=0;
  extCfg.ambient.effect=static_cast<uint8_t>(e);extCfg.dirty=true;prepareAmbient();
}

uint16_t ambientFrameIntervalMs(uint8_t speed){
  // Public/API range remains 1..255. Higher value must always mean faster.
  // Mapping to frame interval avoids 8-bit hue-step aliasing (for example
  // 247 previously behaved like -9 hue units per frame).
  return static_cast<uint16_t>(260U-static_cast<uint16_t>(speed));
}

void updateAmbient(){
  if(currentMode!=SystemMode::AMBIENT)return;
  const unsigned long now=millis();
  if(presetCfg.selected){
    const uint32_t elapsed=now-lastAmbientFrameMs;
    if(elapsed<40UL)return;
    lastAmbientFrameMs=now;
    const uint8_t scene=static_cast<uint8_t>(presetCfg.selected-1U);
    const uint16_t t=advancePresetClock(
        elapsed,presetCfg.dynamics[scene],presetPhaseQ16,scene==10U);
    renderPreset(scene,t);
    return;
  }
  fill_solid(leds,Cfg::LED_COUNT,
             CHSV(extCfg.ambient.f01Hue,extCfg.ambient.f01Sat,255));
  requestedBrightness=extCfg.ambient.f01Brightness;frameDirty=true;
}

// -------------------- Dawn --------------------

// Warm only: Kelvin code is a 20 K step in the existing 1800..4000K L01 LUT.
// p is elapsed permille. Never render HSV blue/violet for the alarm.
uint16_t dawnKelvin(uint16_t p){
  if(p>1000)p=1000;
  const uint16_t steps=static_cast<uint16_t>(dawnCfg.startStep) +
      (static_cast<uint16_t>(dawnCfg.endStep-dawnCfg.startStep)*p)/1000U;
  return Cfg::DAWN_MIN_KELVIN+steps*Cfg::DAWN_STEP_KELVIN;
}
uint8_t dawnBrightness(uint16_t p){
  if(p>1000)p=1000;
  const uint32_t eased=static_cast<uint32_t>(p)*p/1000UL; // smooth early rise
  return static_cast<uint8_t>(1U+
      (static_cast<uint32_t>(dawnCfg.maxBrightness-1U)*eased)/1000UL);
}
void prepareDawn(uint16_t p){
  fill_solid(leds,Cfg::LED_COUNT,kelvinRgb(dawnKelvin(p)));
  requestedBrightness=dawnBrightness(p);frameDirty=true;
}

void startDawn(unsigned long durationMs,DawnSource source){
  if(durationMs==0)durationMs=1000;
  currentMode=SystemMode::DAWN;
  dawnPhase=DawnPhase::RUNNING;
  dawnDurationMs=durationMs; dawnStartMs=millis(); lastDawnFrameMs=0;
  dawnRecoveredAtBoot=false;

  RtcTime now;
  if(rtcValidNow(&now)){
    dawnRuntime.phase=DawnPhase::RUNNING; dawnRuntime.source=source;
    dawnRuntime.startRtcSeconds=rtcSeconds2000(now);
    dawnRuntime.durationSeconds=static_cast<uint32_t>((durationMs+999UL)/1000UL);
    saveDawnRuntime();
  } else {
    dawnRuntime=DawnRuntime();
  }
  prepareDawn(0);
  emitEvent3(2,static_cast<uint8_t>(source),static_cast<uint16_t>(durationMs/1000UL));
}

void stopDawn(){
  dawnPhase=DawnPhase::IDLE; dawnDurationMs=0; setDawnRuntimeIdle();
  currentMode=SystemMode::OFF; saveCore(); prepareOff();
  emitEvent(3);
}

void updateDawn(){
  if(currentMode!=SystemMode::DAWN)return;
  if(dawnPhase==DawnPhase::HOLD){
    if(dawnRuntime.source==DawnSource::ALARM && familyAlarm.holdMinutes){
      RtcTime t;
      if(rtcValidNow(&t) && rtcSeconds2000(t)>=
         dawnRuntime.startRtcSeconds+dawnRuntime.durationSeconds+
         static_cast<uint32_t>(familyAlarm.holdMinutes)*60UL)stopDawn();
    }
    return;
  }
  if(dawnPhase!=DawnPhase::RUNNING)return;
  const unsigned long now=millis();
  if(now-lastDawnFrameMs<Cfg::DAWN_FRAME_MS)return;
  lastDawnFrameMs=now;
  const unsigned long elapsed=now-dawnStartMs;
  if(elapsed>=dawnDurationMs){
    prepareDawn(1000); dawnPhase=DawnPhase::HOLD;
    dawnRuntime.phase=DawnPhase::HOLD;
    if(dawnRuntime.source==DawnSource::NONE)dawnRuntime.source=DawnSource::MANUAL;
    saveDawnRuntime();
    emitEvent(4);
    return;
  }
  const uint16_t p=static_cast<uint16_t>((static_cast<uint64_t>(elapsed)*1000ULL)/dawnDurationMs);
  prepareDawn(p);
}

bool recoverDawn(bool isCold){
  dawnRecoveredAtBoot=false;
  if(!dawnRuntime.storageValid || dawnRuntime.phase==DawnPhase::IDLE)return false;

  if(dawnRuntime.phase==DawnPhase::HOLD){
    if(isCold){
      setDawnRuntimeIdle();
      return false; // cold power-on must produce L01, not stale HOLD
    }
    currentMode=SystemMode::DAWN; dawnPhase=DawnPhase::HOLD;
    prepareDawn(1000); dawnRecoveredAtBoot=true;
    emitEvent3(5,2,static_cast<uint8_t>(dawnRuntime.source));
    return true;
  }

  RtcTime now;
  if(!rtcValidNow(&now) || dawnRuntime.startRtcSeconds==0 || dawnRuntime.durationSeconds==0){
    setDawnRuntimeIdle(); return false;
  }
  const uint32_t n=rtcSeconds2000(now);
  if(n<dawnRuntime.startRtcSeconds){setDawnRuntimeIdle();return false;}
  const uint32_t elapsed=n-dawnRuntime.startRtcSeconds;

  if(elapsed>=dawnRuntime.durationSeconds){
    if(isCold){
      setDawnRuntimeIdle();
      return false;
    }
    currentMode=SystemMode::DAWN; dawnPhase=DawnPhase::HOLD;
    dawnRuntime.phase=DawnPhase::HOLD; saveDawnRuntime(); prepareDawn(1000);
    dawnRecoveredAtBoot=true;
    emitEvent3(5,2,static_cast<uint8_t>(dawnRuntime.source));
    return true;
  }

  currentMode=SystemMode::DAWN; dawnPhase=DawnPhase::RUNNING;
  dawnDurationMs=dawnRuntime.durationSeconds*1000UL;
  dawnStartMs=millis()-elapsed*1000UL; lastDawnFrameMs=0;
  const uint16_t p=static_cast<uint16_t>((static_cast<uint64_t>(elapsed)*1000ULL)/dawnRuntime.durationSeconds);
  prepareDawn(p); dawnRecoveredAtBoot=true;
  emitEvent3(5,1,static_cast<uint8_t>(dawnRuntime.source));
  return true;
}

// -------------------- Alarm --------------------

// Weekday of wake date: Monday=0. Works for DS3231 calendar years
// 2000..2099, including leap years; avoids expensive 32-bit divisions on AVR.
uint8_t wakeWeekday(const RtcTime& t){
  static const uint8_t monthOffsets[] PROGMEM =
      {0,3,3,6,1,4,6,2,5,0,3,5};
  const uint8_t y=static_cast<uint8_t>(t.year-2000);
  const uint8_t n=5U+y+static_cast<uint8_t>((y+3U)/4U)+
      pgm_read_byte(monthOffsets+t.month-1)+t.day-1U+
      ((t.month>2 && !(y%4))?1U:0U);
  return n%7;
}

bool alarmTriggeredToday(const RtcTime& t){
  return alarmCfg.lastTriggerYear==t.year &&
         alarmCfg.lastTriggerMonth==t.month &&
         alarmCfg.lastTriggerDay==t.day;
}

void updateAlarm(){
  const unsigned long ms=millis();
  if(ms-lastRtcPollMs<Cfg::RTC_POLL_MS)return;
  lastRtcPollMs=ms;

  RtcTime now;
  if(!rtcValidNow(&now))return;

  if(nightCfg.scheduleEnabled){
    (void)syncNightSchedule(now,true,false);
  }

  if(!alarmCfg.enabled)return;
  // Mon=0..Sun=6. January 1st 2000 was Saturday (index 5).
  // Check the weekday of the WAKE DATE, not the preceding fade-start date.
  for(uint8_t kind=0;kind<2;++kind){
    if((kind==0&&!familyAlarm.weekdaysEnabled)||
       (kind==1&&!familyAlarm.weekendsEnabled))continue;
    const uint16_t wake=kind?
        minuteOfDay(familyAlarm.weekendHour,familyAlarm.weekendMinute):
        minuteOfDay(alarmCfg.hour,alarmCfg.minute);
    const uint16_t start=(wake+1440U-dawnCfg.fadeMinutes)%1440U;
    if(minuteOfDay(now.hour,now.minute)!=start)continue;
    RtcTime wakeDate=now;
    if(start>wake){
      if(++wakeDate.day>daysInMonth(wakeDate.year,wakeDate.month)){
        wakeDate.day=1;
        if(++wakeDate.month>12){wakeDate.month=1;++wakeDate.year;}
      }
    }
    const uint8_t weekday=wakeWeekday(wakeDate);
    if((weekday>=5)!=(kind==1)||alarmTriggeredToday(wakeDate))continue;
    alarmCfg.lastTriggerYear=wakeDate.year;
    alarmCfg.lastTriggerMonth=wakeDate.month;
    alarmCfg.lastTriggerDay=wakeDate.day;
    saveAlarm();
    emitEvent(6);
    startDawn(static_cast<unsigned long>(dawnCfg.fadeMinutes)*60UL*1000UL,DawnSource::ALARM);
    break;
  }
}

// -------------------- Gyver-style clap + compact family calibration --------------------

class RawEnvelope {
public:
  void begin(){pinMode(Pins::MIC_IN,INPUT);reset();}
  void reset(){
    _windowMax=0;_rawMax=0;_maxs=0;_count=0;
    _tmrSample=micros();_tmrPeriod=millis();_tmrAmpli=millis();
  }
  bool tick(){
    const unsigned long ms=millis();
    if(ms-_tmrAmpli>=Cfg::CLAP_AMPLI_DT_MS){_tmrAmpli=ms;_maxs=0;}
    if(ms-_tmrPeriod<Cfg::CLAP_VOL_PERIOD_MS)return false;
    const unsigned long us=micros();
    if(us-_tmrSample<Cfg::CLAP_VOL_DT_US)return false;
    _tmrSample=us;
    const uint16_t s=analogRead(Pins::MIC_IN);
    if(s>_windowMax)_windowMax=s;
    if(++_count<Cfg::CLAP_VOL_WINDOW)return false;
    _tmrPeriod=ms;
    if(_windowMax>_maxs)_maxs=_windowMax;
    _rawMax=_maxs;_windowMax=0;_count=0;return true;
  }
  uint16_t rawMax()const{return _rawMax;}
private:
  uint16_t _windowMax=0,_rawMax=0,_maxs=0;
  uint8_t _count=0;
  unsigned long _tmrSample=0,_tmrPeriod=0,_tmrAmpli=0;
};

class ClapDetector {
public:
  void configure(int tr,uint16_t to){_tr=tr;_tout=to;}
  void reset(){
    _tmr=millis();_tmr2=millis();_prev=0;_primed=false;_prevSignal=0;
    _state=0;_claps=0;_ready=false;_clap=false;_start=false;
    _posPeak=0;_negPeak=0;_strength=0;
  }
  void tick(int val){
    if(millis()-_tmr<10)return;_tmr=millis();
    if(!_primed){_prev=val;_primed=true;return;}
    const int der=val-_prev;_prev=val;
    int signal=0,front=0;
    if(der>_tr)signal=1;else if(der<-_tr)signal=-1;
    if(!_prevSignal&&signal)front=signal;
    _prevSignal=signal;
    const uint32_t dt=millis()-_tmr2;

    if(_state==1&&der>_posPeak)_posPeak=der;
    if(_state==2&&-der>_negPeak)_negPeak=-der;

    if(front==1&&_state==0){
      _state=1;_posPeak=der;_negPeak=0;
      if(!_start){_claps=0;_ready=false;}
      _start=true;_clap=false;_tmr2=millis();
    }else if(front==-1&&_state==1&&dt<=200){
      _state=2;_negPeak=-der;_tmr2=millis();
    }else if(!front&&_state==2&&dt<=200){
      _state=0;++_claps;_clap=true;
      const int w=_posPeak<_negPeak?_posPeak:_negPeak;
      _strength=w>0?static_cast<uint16_t>(w):0;_tmr2=millis();
    }else if(_state&&dt>200){
      _state=0;_posPeak=0;_negPeak=0;
    }else if(_start&&dt>_tout){
      _state=0;_start=false;if(_claps)_ready=true;
    }
  }
  bool takeClap(uint16_t& v){if(!_clap)return false;_clap=false;v=_strength;return true;}
  bool takeSequence(uint8_t& n){if(!_ready)return false;_ready=false;n=_claps;_claps=0;return true;}
private:
  unsigned long _tmr=0,_tmr2=0;
  int _prev=0,_tr=Cfg::DEFAULT_CLAP_TRSH;
  uint16_t _tout=Cfg::DEFAULT_CLAP_TIMEOUT_MS;
  uint8_t _state=0,_claps=0;
  int8_t _prevSignal=0;
  bool _primed=false,_ready=false,_clap=false,_start=false;
  int _posPeak=0,_negPeak=0;
  uint16_t _strength=0;
};

RawEnvelope clapVol;
ClapDetector clapDetector;
unsigned long clapIgnoreUntil=0;

bool clapCalActive=false,clapCalFinished=false;
uint8_t clapCalTargetPairs=0,clapCalGoodPairs=0;
uint16_t clapCalWeak[Cfg::CLAPCAL_MAX_PAIRS];
uint16_t clapCalQuietP99=0,clapCalP20=0,clapCalSuggested=0;

void resetClapDetector(){
  clapDetector.configure(clapCfg.threshold,clapCfg.timeoutMs);
  clapDetector.reset();
  clapIgnoreUntil=millis()+Cfg::CLAP_COMMAND_GUARD_MS;
}

void toggleLightByClap(){
  if(currentMode==SystemMode::LIGHT){
    currentMode=SystemMode::OFF;saveCore();prepareOff();
    emitEvent2(7,0);
  }else if(currentMode==SystemMode::OFF){
    currentMode=SystemMode::LIGHT;saveCore();prepareLight();
    emitEvent2(7,1);
  }else return;
  resetClapDetector();
}

void updateClap(){
  clapVol.tick();
  if(clapCalActive||!coreCfg.clapEnabled)return;
  if(currentMode!=SystemMode::LIGHT&&currentMode!=SystemMode::OFF)return;
  if(static_cast<long>(millis()-clapIgnoreUntil)<0)return;
  clapDetector.tick(clapVol.rawMax());
  uint8_t n=0;
  if(clapDetector.takeSequence(n)&&n==2)toggleLightByClap();
}

void sortU16(uint16_t* v,uint8_t n){
  for(uint8_t i=1;i<n;++i){
    const uint16_t key=v[i];int8_t j=static_cast<int8_t>(i)-1;
    while(j>=0&&v[j]>key){v[j+1]=v[j];--j;}v[j+1]=key;
  }
}

uint16_t measureClapQuietP99(){
  uint8_t hist[32]={0};
  clapVol.reset();
  uint16_t prev=0;bool primed=false;
  uint16_t samples=0;unsigned long last=0;
  delay(Cfg::CLAPCAL_PRE_DELAY_MS);
  const unsigned long start=millis();

  while(millis()-start<Cfg::CLAPCAL_QUIET_WINDOW_MS){
    clapVol.tick();
    if(millis()-last<Cfg::CLAPCAL_QUIET_SAMPLE_MS)continue;
    last=millis();
    const uint16_t cur=clapVol.rawMax();
    if(!primed){prev=cur;primed=true;continue;}
    const int d=static_cast<int>(cur)-static_cast<int>(prev);prev=cur;
    const uint16_t a=d<0?static_cast<uint16_t>(-d):static_cast<uint16_t>(d);
    const uint8_t bin=a>=248?31:static_cast<uint8_t>(a/8);
    if(hist[bin]<255)++hist[bin];++samples;
  }

  if(!samples)return 0;
  const uint16_t target=static_cast<uint16_t>((samples*99UL+99UL)/100UL);
  uint16_t sum=0;
  for(uint8_t i=0;i<32;++i){sum+=hist[i];if(sum>=target)return i*8U+7U;}
  return 255;
}

void resetClapCalibration(){
  clapCalActive=false;clapCalFinished=false;
  clapCalTargetPairs=0;clapCalGoodPairs=0;
  clapCalQuietP99=0;clapCalP20=0;clapCalSuggested=0;
  for(uint8_t i=0;i<Cfg::CLAPCAL_MAX_PAIRS;++i)clapCalWeak[i]=0;
}

void startClapCalibration(uint8_t pairs){
  resetClapCalibration();clapCalActive=true;clapCalTargetPairs=pairs;
  clapCalQuietP99=measureClapQuietP99();
  Serial.print(F("D 40 0 "));Serial.print(clapCalQuietP99);Serial.print(' ');Serial.println(clapCalTargetPairs);
}

void captureClapCalibrationSample(){
  if(!clapCalActive){uartErr(UE_STATE);return;}
  if(clapCalGoodPairs>=clapCalTargetPairs){uartErr(UE_STATE);return;}

  delay(Cfg::CLAPCAL_PRE_DELAY_MS);
  clapVol.reset();
  clapDetector.configure(Cfg::CLAPCAL_DER_FLOOR,1000);
  clapDetector.reset();

  uint16_t top1=0,top2=0;uint8_t count=0;
  const unsigned long start=millis();
  while(millis()-start<Cfg::CLAPCAL_SAMPLE_WINDOW_MS){
    clapVol.tick();clapDetector.tick(clapVol.rawMax());
    uint16_t s=0;
    if(clapDetector.takeClap(s)&&s>=Cfg::CLAPCAL_DER_FLOOR){
      ++count;
      if(s>=top1){top2=top1;top1=s;}
      else if(s>top2)top2=s;
    }
    uint8_t ignored=0;(void)clapDetector.takeSequence(ignored);
  }
  resetClapDetector();

  if(count<2){Serial.print(F("D 41 0 "));Serial.println(count);return;}
  clapCalWeak[clapCalGoodPairs]=top2;
  ++clapCalGoodPairs;
  Serial.print(F("D 41 1 "));Serial.print(clapCalGoodPairs);Serial.print(' ');
  Serial.print(clapCalTargetPairs);Serial.print(' ');Serial.print(top2);Serial.print(' ');Serial.println(top1);
}

void finishClapCalibration(){
  if(!clapCalActive||clapCalGoodPairs<clapCalTargetPairs){
    uartErr(UE_STATE);return;
  }

  sortU16(clapCalWeak,clapCalGoodPairs);
  const uint8_t p20=static_cast<uint8_t>(
      (static_cast<uint16_t>(clapCalGoodPairs-1)*20U)/100U);
  clapCalP20=clapCalWeak[p20];

  const uint16_t fromClap=static_cast<uint16_t>(
      (static_cast<uint32_t>(clapCalP20)*70UL)/100UL);
  const uint16_t fromNoise=clapCalQuietP99+10U;
  uint16_t v=fromClap>fromNoise?fromClap:fromNoise;
  if(v<35)v=35;if(v>150)v=150;

  if(fromNoise>=clapCalP20||v>=clapCalP20){
    uartErr(UE_STATE);return;
  }

  clapCalSuggested=v;clapCfg.threshold=v;clapCfg.dirty=true;
  clapCalFinished=true;clapCalActive=false;resetClapDetector();
  Serial.print(F("D 42 0 "));Serial.print(clapCalQuietP99);Serial.print(' ');
  Serial.print(clapCalP20);Serial.print(' ');Serial.println(clapCalSuggested);
}

void printClapCalStatus(){
  Serial.print(F("CAL ST "));
  Serial.print(clapCalActive?1:0);Serial.print(' ');
  Serial.print(clapCalFinished?1:0);Serial.print(' ');
  Serial.print(clapCalGoodPairs);Serial.print('/');
  Serial.print(clapCalTargetPairs);Serial.print(' ');
  Serial.print(clapCalQuietP99);Serial.print(' ');
  Serial.print(clapCalSuggested);Serial.println();
}

// -------------------- mode/render/reset --------------------

void applyMode(SystemMode m,bool persist){
  currentMode=m;
  if(m==SystemMode::LIGHT){
    audioDefaultPrescaler(); prepareLight(); resetClapDetector();
  } else if(m==SystemMode::NIGHT){
    audioDefaultPrescaler(); (void)reconcileNight(false);
  } else if(m==SystemMode::AMBIENT){
    audioDefaultPrescaler(); prepareAmbient();
  } else if(m==SystemMode::MUSIC){
    resetMusicRuntime();
  } else if(m==SystemMode::OFF){
    audioDefaultPrescaler(); prepareOff(); resetClapDetector();
  }
  if(persist && m!=SystemMode::DAWN)saveCore();
}

void resetUserSettingsToDefaults(){
  // RTC is intentionally preserved. Audio calibration is hardware-specific and
  // is also preserved; user-facing mode/settings values return to v1 defaults.
  const uint16_t micDc=extCfg.micDcOffset;
  const uint16_t vuLowPass=extCfg.vuLowPass;
  const uint8_t spectrumLowPass=extCfg.spectrumLowPass;
  const uint8_t audioCalibrated=extCfg.audioCalibrated;

  setDawnRuntimeIdle();
  dawnPhase=DawnPhase::IDLE;
  dawnDurationMs=0;
  dawnStartMs=0;
  dawnRecoveredAtBoot=false;

  lightCfg=LightSettings();
  clapCfg=ClapSettings();
  nightCfg=NightSettings();
  alarmCfg=AlarmSettings();
  familyAlarm=FamilyAlarmSettings();
  dawnCfg=DawnSettings();
  coreCfg=CoreState();
  setExtendedDefaults();

  extCfg.micDcOffset=micDc;
  extCfg.vuLowPass=vuLowPass;
  extCfg.spectrumLowPass=spectrumLowPass;
  extCfg.audioCalibrated=audioCalibrated;

  currentMode=SystemMode::LIGHT;
  nightEffectivePower=false;
  nightWindowActive=false;
  resetClapCalibration();
  resetMusicRuntime();

  saveLight();
  saveClap();
  saveNight();
  saveAlarm();
  saveFamilyAlarm();
  saveDawnSettings();
  saveExtended();
  presetDefaults();savePresets();
  saveCore();
  prepareLight();
}

void classifyReset(){
  rawResetFlags=MCUSR;
  MCUSR=0;
  const bool cookieValid=(ramResetCookie==Cfg::RAM_COOKIE_MAGIC);
  const bool por=(rawResetFlags&_BV(PORF))!=0;
  const bool bor=(rawResetFlags&_BV(BORF))!=0;
  coldBoot=por||bor||!cookieValid;
  ramResetCookie=Cfg::RAM_COOKIE_MAGIC;
}

const __FlashStringHelper* resetName(){
  if(coldBoot)return F("POWER");
  if(rawResetFlags&_BV(EXTRF))return F("EXTERNAL");
  if(rawResetFlags&_BV(WDRF))return F("WATCHDOG");
  return F("WARM_UNKNOWN");
}

// -------------------- compact UART v1 --------------------
// Line format: <opcode> [arg0 ... arg5]\n
// Responses: O <opcode> = ACK, E <code> = error, D ... = data.
// ESP8266 owns semantic HTTP names; Nano keeps this compact internal contract.



void uartAck(uint16_t op){
  Serial.print(F("O "));Serial.println(op);
}

void uartErr(uint8_t code){
  Serial.print(F("E "));Serial.println(code);
}

bool parseU16Token(const char*& p,uint16_t& out){
  while(*p==' ')++p;
  if(*p<'0'||*p>'9')return false;
  uint32_t v=0;
  while(*p>='0'&&*p<='9'){
    v=v*10UL+static_cast<uint8_t>(*p-'0');
    if(v>65535UL)return false;
    ++p;
  }
  out=static_cast<uint16_t>(v);
  return *p==' '||*p=='\0';
}

bool parseOpcodeLine(const char* p,uint16_t& op,uint16_t* a,uint8_t& n){
  n=0;
  if(!parseU16Token(p,op))return false;
  while(*p){
    while(*p==' ')++p;
    if(!*p)break;
    if(n>=6||!parseU16Token(p,a[n]))return false;
    ++n;
  }
  return true;
}

bool argRange(uint16_t v,uint16_t lo,uint16_t hi){
  return v>=lo&&v<=hi;
}

void dataPrefix(uint8_t group,uint8_t item){
  Serial.print(F("D "));Serial.print(group);Serial.print(' ');Serial.print(item);Serial.print(' ');
}

void printCompactTime(uint8_t group){
  RtcTime t;
  const bool ok=rtcValidNow(&t);
  Serial.print(F("D "));Serial.print(group);Serial.print(' ');Serial.print(ok?1:0);
  if(ok){
    Serial.print(' ');Serial.print(t.year);Serial.print(' ');Serial.print(t.month);
    Serial.print(' ');Serial.print(t.day);Serial.print(' ');Serial.print(t.hour);
    Serial.print(' ');Serial.print(t.minute);Serial.print(' ');Serial.print(t.second);
  }
  Serial.println();
}

void printCompactStatus(){
  RtcTime t;const bool rv=rtcValidNow(&t);
  Serial.print(F("D 2 "));
  Serial.print(static_cast<uint8_t>(currentMode));Serial.print(' ');
  Serial.print(rv?1:0);Serial.print(' ');
  Serial.print(coreCfg.clapEnabled?1:0);Serial.print(' ');
  Serial.print(clapCfg.threshold);Serial.print(' ');
  Serial.print(clapCfg.timeoutMs);Serial.print(' ');
  Serial.print(extCfg.currentLimitMa);Serial.print(' ');
  Serial.print(static_cast<uint8_t>(extCfg.selectedMusic));Serial.print(' ');
  Serial.print(extCfg.ambient.effect);Serial.print(' ');
  Serial.print(rawResetFlags);Serial.print(' ');
  Serial.println(millis());
}

void printCompactSettings(){
  const CRGB lc=lightColor();
  dataPrefix(3,0);
  Serial.print(static_cast<uint8_t>(lightCfg.colorMode));Serial.print(' ');
  Serial.print(lightCfg.kelvin);Serial.print(' ');
  Serial.print(lc.r);Serial.print(' ');Serial.print(lc.g);Serial.print(' ');Serial.print(lc.b);Serial.print(' ');
  Serial.print(lightCfg.brightness);Serial.print(' ');Serial.print(lightCfg.storageValid?1:0);Serial.print(' ');
  Serial.println(lightCfg.dirty?1:0);

  dataPrefix(3,1);
  Serial.print(coreCfg.clapEnabled?1:0);Serial.print(' ');Serial.print(clapCfg.threshold);Serial.print(' ');
  Serial.print(clapCfg.timeoutMs);Serial.print(' ');Serial.print(clapCfg.storageValid?1:0);Serial.print(' ');
  Serial.print(clapCalActive?1:0);Serial.print(' ');Serial.print(clapCalFinished?1:0);Serial.print(' ');
  Serial.print(clapCalGoodPairs);Serial.print(' ');Serial.print(clapCalTargetPairs);Serial.print(' ');
  Serial.print(clapCalQuietP99);Serial.print(' ');Serial.println(clapCalSuggested);

  dataPrefix(3,2);
  // Night status must show actual light, including schedule-driven activation.
  Serial.print(currentMode==SystemMode::NIGHT?1:0);Serial.print(' ');Serial.print(nightCfg.hue);Serial.print(' ');
  Serial.print(nightCfg.saturation);Serial.print(' ');Serial.print(nightCfg.brightness);Serial.print(' ');
  Serial.print(nightCfg.scheduleEnabled?1:0);Serial.print(' ');Serial.print(nightCfg.onHour);Serial.print(' ');
  Serial.print(nightCfg.onMinute);Serial.print(' ');Serial.print(nightCfg.offHour);Serial.print(' ');
  Serial.println(nightCfg.offMinute);

  dataPrefix(3,3);
  Serial.print(alarmCfg.enabled?1:0);Serial.print(' ');Serial.print(alarmCfg.hour);Serial.print(' ');
  Serial.print(alarmCfg.minute);Serial.print(' ');Serial.print(dawnCfg.fadeMinutes);Serial.print(' ');
  Serial.print(dawnCfg.maxBrightness);Serial.print(' ');Serial.print(dawnCfg.startStep);Serial.print(' ');
  Serial.print(dawnCfg.endStep);Serial.print(' ');Serial.print(static_cast<uint8_t>(dawnPhase));Serial.print(' ');
  Serial.print(dawnRecoveredAtBoot?1:0);Serial.println(F(" 1")); // warm Kelvin capability
  dataPrefix(3,21);
  Serial.print(F("1 ")); // family alarm / auto-off capability
  Serial.print(familyAlarm.weekdaysEnabled?1:0);Serial.print(' ');
  Serial.print(familyAlarm.weekendsEnabled?1:0);Serial.print(' ');
  Serial.print(familyAlarm.weekendHour);Serial.print(' ');
  Serial.print(familyAlarm.weekendMinute);Serial.print(' ');
  Serial.println(familyAlarm.holdMinutes);

  AmbientSettingsV1& x=extCfg.ambient;
  dataPrefix(3,4);
  Serial.print(x.effect);Serial.print(' ');Serial.print(x.autoCycle);Serial.print(' ');Serial.print(x.autoPeriodSec);Serial.print(' ');
  Serial.print(x.f01Hue);Serial.print(' ');Serial.print(x.f01Sat);Serial.print(' ');Serial.print(x.f01Brightness);Serial.print(' ');
  // F02/F03 were retired in D-109. Preserve the v1 14-field wire shape
  // for ESP V4 rollback, without serializing unused legacy effect settings.
  Serial.println(F("0 255 64 100 0 64 1 5"));

  for(uint8_t i=0;i<static_cast<uint8_t>(MusicMode::COUNT);++i){
    const MusicModeSettings& m=extCfg.music[i];
    dataPrefix(3,static_cast<uint8_t>(10+i));
    Serial.print(m.brightness);Serial.print(' ');Serial.print(m.background);Serial.print(' ');
    Serial.print(m.smooth);Serial.print(' ');Serial.print(m.sensitivity);Serial.print(' ');
    Serial.print(m.speed);Serial.print(' ');Serial.print(m.aux);Serial.print(' ');Serial.println(m.submode);
  }

  dataPrefix(3,20);
  Serial.print(extCfg.currentLimitMa);Serial.print(' ');Serial.print(extCfg.audioCalibrated);Serial.print(' ');
  Serial.print(extCfg.micDcOffset);Serial.print(' ');Serial.print(extCfg.vuLowPass);Serial.print(' ');
  Serial.println(extCfg.spectrumLowPass);
  uartAck(3);
}

void handleCompactCommand(uint16_t op,const uint16_t* a,uint8_t n){
  switch(op){
    case 1: // ping
      if(n)return uartErr(UE_PARSE);uartAck(op);return;
    case 2:
      if(n)return uartErr(UE_PARSE);printCompactStatus();return;
    case 3:
      if(n)return uartErr(UE_PARSE);printCompactSettings();return;
    case 4:
      if(n)return uartErr(UE_PARSE);printCompactTime(4);return;
    case 5: { // set RTC: year month day hour minute second
      if(n!=6)return uartErr(UE_PARSE);
      RtcTime t;
      t.year=a[0];t.month=static_cast<uint8_t>(a[1]);t.day=static_cast<uint8_t>(a[2]);
      t.hour=static_cast<uint8_t>(a[3]);t.minute=static_cast<uint8_t>(a[4]);t.second=static_cast<uint8_t>(a[5]);
      if(!validRtc(t)||!rtcSet(t))return uartErr(UE_RTC);
      rtcLostPower=false;uartAck(op);return;
    }
    case 10: { // top mode: 0 off, 1 light, 2 night, 3 ambient, 4 music
      if(n!=1||a[0]>4)return uartErr(UE_RANGE);
      const SystemMode map[5]={SystemMode::OFF,SystemMode::LIGHT,SystemMode::NIGHT,SystemMode::AMBIENT,SystemMode::MUSIC};
      applyMode(map[a[0]],true);uartAck(op);return;
    }
    case 20:
      if(n!=1||a[0]>1)return uartErr(UE_RANGE);
      applyMode(a[0]?SystemMode::LIGHT:SystemMode::OFF,true);uartAck(op);return;
    case 21:
      if(n!=1||a[0]>255)return uartErr(UE_RANGE);
      lightCfg.brightness=a[0];lightCfg.dirty=true;if(currentMode==SystemMode::LIGHT)prepareLight();uartAck(op);return;
    case 22:
      if(n!=1||!argRange(a[0],Cfg::MIN_KELVIN,Cfg::MAX_KELVIN))return uartErr(UE_RANGE);
      lightCfg.colorMode=ColorMode::KELVIN;lightCfg.kelvin=a[0];lightCfg.dirty=true;
      if(currentMode==SystemMode::LIGHT)prepareLight();uartAck(op);return;
    case 23:
      if(n!=3||a[0]>255||a[1]>255||a[2]>255)return uartErr(UE_RANGE);
      lightCfg.colorMode=ColorMode::RGB;lightCfg.customRgb=CRGB(a[0],a[1],a[2]);lightCfg.dirty=true;
      if(currentMode==SystemMode::LIGHT)prepareLight();uartAck(op);return;
    case 24:saveLight();uartAck(op);return;
    case 26:
      if(n!=1||a[0]>1)return uartErr(UE_RANGE);
      coreCfg.clapEnabled=a[0];saveCore();uartAck(op);return;
    case 40:
      if(n!=1||!argRange(a[0],Cfg::CLAPCAL_MIN_PAIRS,Cfg::CLAPCAL_MAX_PAIRS))return uartErr(UE_RANGE);
      startClapCalibration(static_cast<uint8_t>(a[0]));return;
    case 41:if(n)return uartErr(UE_PARSE);captureClapCalibrationSample();return;
    case 42:if(n)return uartErr(UE_PARSE);finishClapCalibration();return;
    case 43:
      if(n)return uartErr(UE_PARSE);
      if(!clapCalFinished&&!clapCfg.dirty)return uartErr(UE_STATE);
      saveClap();resetClapDetector();uartAck(op);return;
    case 44:
      if(n)return uartErr(UE_PARSE);
      resetClapCalibration();loadClap();resetClapDetector();uartAck(op);return;
    case 45:
      if(n)return uartErr(UE_PARSE);
      dataPrefix(45,0);Serial.print(clapCalActive?1:0);Serial.print(' ');
      Serial.print(clapCalFinished?1:0);Serial.print(' ');Serial.print(clapCalGoodPairs);Serial.print(' ');
      Serial.print(clapCalTargetPairs);Serial.print(' ');Serial.print(clapCalQuietP99);Serial.print(' ');
      Serial.println(clapCalSuggested);return;
    case 50:
      if(n!=1||a[0]>1)return uartErr(UE_RANGE);
      nightCfg.manualEnabled=a[0];saveNight();
      if(a[0]){
        const uint8_t from=currentMode==SystemMode::OFF?0:requestedBrightness;
        applyMode(SystemMode::NIGHT,true);
        beginNightFade(from,nightCfg.brightness,false);
      }else if(currentMode==SystemMode::NIGHT){
        beginNightFade(requestedBrightness,0,true);
      }
      uartAck(op);return;
    case 51:
      if(n!=1||a[0]>255)return uartErr(UE_RANGE);nightCfg.hue=a[0];(void)reconcileNight(false);uartAck(op);return;
    case 52:
      if(n!=1||a[0]>255)return uartErr(UE_RANGE);nightCfg.saturation=a[0];(void)reconcileNight(false);uartAck(op);return;
    case 53:
      if(n!=1||a[0]>255)return uartErr(UE_RANGE);nightCfg.brightness=a[0];(void)reconcileNight(false);uartAck(op);return;
    case 54:
      if(n!=1||a[0]>1)return uartErr(UE_RANGE);
      if(a[0]&&!rtcValidNow())return uartErr(UE_RTC);
      nightCfg.scheduleEnabled=a[0];saveNight();
      if(a[0]){
        if(!syncNightScheduleNow(false,true))return uartErr(UE_RTC);
      } else {
        nightWindowActive=false;
        (void)reconcileNight(false);
      }
      uartAck(op);return;
    case 55:
      if(n!=4||a[0]>23||a[1]>59||a[2]>23||a[3]>59||(a[0]==a[2]&&a[1]==a[3]))return uartErr(UE_RANGE);
      nightCfg.onHour=a[0];nightCfg.onMinute=a[1];nightCfg.offHour=a[2];nightCfg.offMinute=a[3];
      saveNight();
      if(nightCfg.scheduleEnabled && !syncNightScheduleNow(false,true))return uartErr(UE_RTC);
      uartAck(op);return;
    case 56:
      if(n)return uartErr(UE_PARSE);saveNight();uartAck(op);return;
    case 60:
      if(n!=1||a[0]>1)return uartErr(UE_RANGE);alarmCfg.enabled=a[0];saveAlarm();uartAck(op);return;
    case 61:
      if(n!=2||a[0]>23||a[1]>59)return uartErr(UE_RANGE);alarmCfg.hour=a[0];alarmCfg.minute=a[1];saveAlarm();uartAck(op);return;
    case 62: // atomic family settings: weekdays, weekends, hour, minute, hold
      if(n!=5||a[0]>1||a[1]>1||a[2]>23||a[3]>59||a[4]>120)
        return uartErr(UE_RANGE);
      familyAlarm.weekdaysEnabled=a[0];familyAlarm.weekendsEnabled=a[1];
      familyAlarm.weekendHour=a[2];familyAlarm.weekendMinute=a[3];
      familyAlarm.holdMinutes=a[4];saveFamilyAlarm();uartAck(op);return;
    case 71:stopDawn();uartAck(op);return;
    case 73:
      if(n!=1||!argRange(a[0],1,120))return uartErr(UE_RANGE);dawnCfg.fadeMinutes=a[0];uartAck(op);return;
    case 74:
      if(n!=1||!argRange(a[0],1,255))return uartErr(UE_RANGE);dawnCfg.maxBrightness=a[0];uartAck(op);return;
    case 75:
      if(n!=1||a[0]>Cfg::DAWN_MAX_STEP || a[0]>dawnCfg.endStep)return uartErr(UE_RANGE);
      dawnCfg.startStep=a[0];uartAck(op);return;
    case 76:
      if(n!=1||a[0]>Cfg::DAWN_MAX_STEP || a[0]<dawnCfg.startStep)return uartErr(UE_RANGE);
      dawnCfg.endStep=a[0];uartAck(op);return;
    case 78: // atomic warm Kelvin endpoints: 0..110 steps of 20 K above 1800 K
      if(n!=2||a[0]>a[1]||a[1]>Cfg::DAWN_MAX_STEP)return uartErr(UE_RANGE);
      dawnCfg.startStep=a[0];dawnCfg.endStep=a[1];uartAck(op);return;
    case 77:
      if(n)return uartErr(UE_PARSE);saveDawnSettings();uartAck(op);return;
    case 80:
      if(n!=1||a[0]>=static_cast<uint8_t>(MusicMode::COUNT))return uartErr(UE_RANGE);
      extCfg.selectedMusic=static_cast<MusicMode>(a[0]);extCfg.dirty=true;saveExtended();applyMode(SystemMode::MUSIC,true);uartAck(op);return;
    case 81:case 82:case 83:case 84:case 85:case 86:case 87:case 88: {
      if(n!=1)return uartErr(UE_PARSE);
      MusicModeSettings& m=activeMusicCfg();
      if(op==81){if(a[0]>255)return uartErr(UE_RANGE);m.brightness=a[0];}
      else if(op==82){if(a[0]>255)return uartErr(UE_RANGE);m.background=a[0];}
      else if(op==83){if(!argRange(a[0],5,100))return uartErr(UE_RANGE);m.smooth=a[0];}
      else if(op==84){if(!argRange(a[0],50,200))return uartErr(UE_RANGE);m.sensitivity=a[0];}
      else if(op==85){
        if((extCfg.selectedMusic!=MusicMode::M05&&extCfg.selectedMusic!=MusicMode::M08)||a[0]>3)return uartErr(UE_APPLICABILITY);
        m.submode=a[0];resetMusicRuntime();
      }else if(op==86){
        if(extCfg.selectedMusic!=MusicMode::M08||!argRange(a[0],1,255))return uartErr(UE_APPLICABILITY);m.speed=a[0];
      }else if(op==87){
        if(extCfg.selectedMusic==MusicMode::M02){if(!argRange(a[0],5,200))return uartErr(UE_RANGE);m.aux=a[0];}
        else if(extCfg.selectedMusic==MusicMode::M09){if(!argRange(a[0],1,255))return uartErr(UE_RANGE);m.aux=a[0];}
        else return uartErr(UE_APPLICABILITY);
      }else{
        if(extCfg.selectedMusic!=MusicMode::M09||a[0]>255)return uartErr(UE_APPLICABILITY);m.speed=a[0];
      }
      extCfg.dirty=true;uartAck(op);return;
    }
    case 89:saveExtended();uartAck(op);return;
    case 90:calibrateAudio();return;
    case 100: // F01 remains manual; F02/F03 wire identifiers retired/reserved
      if(n!=1||a[0]!=0)return uartErr(UE_RANGE);
      extCfg.ambient.effect=0;extCfg.dirty=true;presetCfg.selected=0;
      savePresets();prepareAmbient();applyMode(SystemMode::AMBIENT,true);uartAck(op);return;
    case 111: // select P01..P12; commit with 114
      if(n!=1||!argRange(a[0],1,PRESET_COUNT))return uartErr(UE_RANGE);
      presetCfg.selected=a[0];prepareAmbient();applyMode(SystemMode::AMBIENT,true);uartAck(op);return;
    case 112: // RAM brightness of selected Pxx
    case 113: // RAM dynamics of selected Pxx
      if(n!=1||a[0]>255)return uartErr(UE_RANGE);
      if(!presetCfg.selected)return uartErr(UE_APPLICABILITY);
      if(op==112)presetCfg.brightness[presetCfg.selected-1]=a[0];
      else presetCfg.dynamics[presetCfg.selected-1]=a[0];
      uartAck(op);return;
    case 114: // EEPROM.update, selected and all 12 settings
      if(n)return uartErr(UE_PARSE);
      savePresets();uartAck(op);return;
    case 115: // read all 12 values and active scene from Nano
      if(n)return uartErr(UE_PARSE);
      printPresets();return;
    case 103:case 104:case 108:case 109:
      // Removed Auto/F02/F03 controls. Wire opcodes stay reserved.
      uartErr(UE_APPLICABILITY);return;
    case 105:case 106:case 107: {
      if(n!=1||a[0]>255)return uartErr(UE_RANGE);
      AmbientSettingsV1& x=extCfg.ambient;
      if(presetCfg.selected)return uartErr(UE_APPLICABILITY);
      if(op==105)x.f01Hue=static_cast<uint8_t>(a[0]);
      else if(op==106)x.f01Sat=static_cast<uint8_t>(a[0]);
      else x.f01Brightness=static_cast<uint8_t>(a[0]);
      extCfg.dirty=true;frameDirty=true;uartAck(op);return;
    }
    case 110:saveExtended();uartAck(op);return;
    case 120:
      if(n!=1||!argRange(a[0],Cfg::MIN_CURRENT_LIMIT_MA,Cfg::HARD_CURRENT_LIMIT_MA))return uartErr(UE_RANGE);
      extCfg.currentLimitMa=a[0];extCfg.dirty=true;saveExtended();uartAck(op);return;
    case 130:
      if(n!=0)return uartErr(UE_PARSE);
      resetUserSettingsToDefaults();uartAck(op);return;
    default:uartErr(UE_PARSE);return;
  }
}

void handleCommand(char* cmd){
  resetClapDetector();
  uint16_t op=0,a[6];uint8_t n=0;
  if(!parseOpcodeLine(cmd,op,a,n)){uartErr(UE_PARSE);return;}
  handleCompactCommand(op,a,n);
}

void pollSerial(){
  while(Serial.available()>0){
    const char c=static_cast<char>(Serial.read());
    lastSerialRxMs=millis();
    if(c=='\r')continue;
    if(c=='\n'){
      if(rxLength){
        rxBuffer[rxLength]='\0';handleCommand(rxBuffer);rxLength=0;
      }
      continue;
    }
    if(rxLength<Cfg::RX_BUFFER_SIZE-1)rxBuffer[rxLength++]=c;
    else{rxLength=0;uartErr(UE_PARSE);}
  }
}

// -------------------- setup/loop --------------------

void setup(){
  classifyReset();

  Serial.begin(Cfg::SERIAL_BAUD);
  analogReference(DEFAULT);

  loadExtended();
  loadPresets();

  FastLED.addLeds<WS2812B,Pins::RING_A,GRB>(leds,Cfg::LED_COUNT);
  FastLED.addLeds<WS2812B,Pins::RING_B,GRB>(leds,Cfg::LED_COUNT);
  prepareOff();
  FastLED.show();

  twiMasterInit();
  delay(80);

  loadAlarm();
  loadFamilyAlarm();
  loadDawnSettings();
  loadDawnRuntime();
  loadNight();
  loadLight();
  loadClap();
  loadCore();
  resetClapCalibration();

  clapVol.begin();
  resetClapDetector();

  rtcPresent=rtcProbe();
  if(rtcPresent){
    bool lost=true;
    if(rtcReadLostPower(lost))rtcLostPower=lost;
  }

  Serial.println(F("ARDU1 8"));

  const bool recovered=recoverDawn(coldBoot);

  if(!recovered){
    if(coldBoot){
      currentMode=SystemMode::LIGHT;
      prepareLight();
      saveCore();
      emitEvent(8);
    } else {
      applyMode(coreCfg.storageValid?coreCfg.lastMode:SystemMode::LIGHT,false);
      emitEvent2(9,static_cast<uint8_t>(currentMode));
    }
  }

  // Power/reset inside an active schedule window must enter NIGHT immediately;
  // outside the window the normal startup mode is left untouched.
  if(!recovered && nightCfg.scheduleEnabled){
    (void)syncNightScheduleNow(false,true);
    // At a cold mains start the LEDs were still black. Fade up from zero,
    // never show the bright L01 startup profile for one frame at night.
    if(coldBoot && currentMode==SystemMode::NIGHT && nightFade.active){
      nightFade.from=0;requestedBrightness=0;frameDirty=true;
    }
  }

  showIfSafe();
  printCompactStatus();
}

void loop(){
  pollSerial();
  updateAlarm();
  updateDawn();
  updateNightFade();
  updateClap();
  updateAmbient();
  updateMusic();
  showIfSafe();
}
