dronrome1245/ARDU/03_СОСТОЯНИЕ_ПРОЕКТА.yaml

project:
  name: ARDU
  description: "Два синхронных круглых потолочных WS2812B-светильника со светомузыкой, рассветом и Wi-Fi приложением"
  initialized: "2026-09-05"
  phase: app_model_done_power_bench_next
  repository: "dronrome1245/ARDU"

constraints:
  minimize_new_hardware_purchase: true
  inventory_closed: true
  main_room_light_separate: true
  round_fixture_white_light_used: false
  second_wall_switch_hard_power_cut: true
  alarm_requires_wall_switch_on: true
  target_control: wifi_mobile_app
  network_cloud_required: false

hardware:
  arduino_nano:
    available: true
    role: realtime_controller
  esp8266:
    available: true
    role: wifi_gateway
    adapter_vcc_volts: 3.3
    five_volts_on_vcc_forbidden: true
    flashing_method_verified: false
  max9814:
    available: true
    role: primary_microphone
  max4466:
    available: true
    role: reserve_microphone
  ds3231:
    available: true
    battery: CR2032
    charging_path_present: true
    required_modification: "remove resistor 201 before normal 5V use"
  ws2812b:
    density_led_per_m_estimate: 60.7
    ring_path_cm: 71.5
    target_led_per_fixture: 44
    fixture_count: 2
    target_total_led: 88
    total_strip_length_required_m: 1.43
    total_strip_length_available_m: 5.0
    total_strip_length_available_confirmed: true
  psu:
    model: S-30-5
    output_nominal: "5V 6A 30W"
    output_measured: false
    led_current_limit_target_ma: 4500
  regulator_3v3:
    model: YP-8 AMS1117-3.3
    output_measured: false
    wifi_load_tested: false
  capacitor_100uf:
    available: true
    voltage_rating_v: 10
  capacitor_1000uf:
    available_probable: true
    voltage_rating_confirmed: false
    count_confirmed: false
  capacitor_disc_103:
    available: true
    capacitance_nf: 10
  data_resistor_330:
    required_count: 2
    confirmed_available: false

architecture:
  wifi_primary_mode: station
  wifi_fallback_mode: softap
  network_api_v1: http_local
  mobile_app: rewrite_from_scratch
  legacy_app_analyzed: true
  legacy_app_name: LumpV3.1
  legacy_protocol_external_compatibility_required: false
  one_controller_for_both_fixtures: true
  separate_data_lines: true
  nano_pinout:
    esp_uart_rx: D0
    esp_uart_tx: D1
    ws2812_a: D6
    ws2812_b: D7
    max9814_out: A0
    ds3231_sda: A4
    ds3231_scl: A5

modes:
  music:
    - M01_vu_gradient
    - M02_vu_rainbow
    - M03_5_band
    - M04_3_band
    - M05_1_band_submodes
    - M08_running_frequencies
    - M09_spectrum_analyzer
  ambient:
    - F01_static_color
    - F02_smooth_color_change
    - F03_running_rainbow
  night:
    base: "color + saturation + brightness"
    schedule: later_stage
  alarm:
    autonomous: true
    rtc: DS3231
    parameters:
      - enabled
      - time
      - fade_minutes
      - max_brightness
      - start_color
      - end_color
      - stop_active_dawn

power_topology:
  mains_path: "second switch -> one S-30-5"
  low_voltage_branches: 2
  desired_rule: "230V only up to PSU; 5V/GND/DATA to fixture bodies where possible"
  final_wiring_route_confirmed: false
  psu_location_confirmed: false

progress:
  hardware_inventory_percent: 100
  functional_architecture_percent: 100
  legacy_app_analysis_percent: 100
  app_functional_model_percent: 90
  dual_fixture_geometry_percent: 80
  mains_low_voltage_layout_percent: 30
  electrical_measurements_percent: 0
  wifi_hardware_verified_percent: 0
  uart_gateway_verified_percent: 0
  mobile_app_implementation_percent: 0

current_focus: "Verify/compile nano_m05, then upload and hardware-test M05 one-strip frequency submodes on one D6 ring"

critical_blockers:
  - "Distance and wiring topology between two ceiling fixtures not known"
  - "Safe physical location for common S-30-5 not confirmed"
  - "S-30-5 output not measured"
  - "YP-8 output and Wi-Fi load behavior not measured"
  - "ESP8266 flashing method not yet proven"
  - "1000uF count/rating not fully confirmed"
  - "330 ohm data resistors not confirmed in inventory"

next_milestone:
  name: power_bom_and_wifi_bench_ready
  success_condition: "Power measurements passed, ceiling low-voltage layout and PSU placement fixed, final BOM approved, ESP8266 flashed and UART PING/PONG with Nano works"

# handoff 2026-09-20
esp_flash_2026_09_20:
  status: reproducible_100_percent_diagnostic
  upload_speed: 115200
  local_capacitor: 100uF_10V
  boot_entry: gpio0_low_manual_rst_to_gnd_on_connecting
  direct_d0_to_esp_rx: diagnostic_only_unsafe_5v
  divider_1k5_3k: upload_error
  next_test: divider_750R_1k5_at_115200

# firmware handoff 2026-09-20
firmware_fw0:
  code_path: "04_Прошивка/nano_fw0/nano_fw0.ino"
  code_prepared: true
  hardware_verified: false
  expected_boot_line: "ARDU NANO FW0 READY"
  commands:
    PING: PONG
    STATUS: "STATUS FW=FW0 ..."
  next_stage_after_pass: FW1_single_ring_F01
programmer_level_shift:
  status: deferred_by_owner
  direct_5v_to_esp_rx_final_allowed: false

firmware_fw0_result_2026_09_20:
  status: passed
  nano_variant: mini_usb_atmega328p
  ide_processor: ATmega328P_Old_Bootloader
  ping: PONG
  status_line: "STATUS FW=FW0 POWER=OFF BRIGHTNESS=32 UPTIME_MS=127729"
firmware_fw1:
  code_path: "04_Прошивка/nano_fw1/nano_fw1.ino"
  revision: 2
  startup_expected: "ARDU NANO M05 R2 READY"
  status_revision_expected: 2
  code_prepared: true
  compile_verified: false
  hardware_verified: false
  ring_a_pin: D6
  led_count_target: 44
  current_limit_ma: 500

firmware_fw1_compile_2026_09_20:
  status: passed
  fastled_available: true
  hardware_test_next: true
  test_channel: D6
  test_led_count: 43
  current_limit_ma: 500

ws2812_reference_2026_09_20:
  source: AlexGyver_ColorMusic_and_WS2812_guide
  strip_power_capacitor_uf: "1000-2200"
  strip_power_capacitor_min_voltage_v: 6.3
  data_series_resistor_ohm: "200-500"
  preferred_data_resistor_ohm: 330
  temporary_1k5_data_resistor_allowed: false
  capacitor_replaces_data_resistor: false

fw1_passives_2026_09_20:
  data_resistor_ohm: 220
  data_resistor_confirmed: true
  strip_capacitor: 1000uF_6.3V
  strip_capacitor_confirmed: true
  ready_for_single_ring_hardware_test: true

firmware_fw1_hardware_2026_09_20:
  status: passed
  status_line: "STATUS FW=FW1 MODE=F01 POWER=ON BRIGHTNESS=32 RGB=32,0,0 LEDS=43 UPTIME_MS=11880"
  color_commands: OK
  data_pin: D6
  data_resistor_ohm: 220
  strip_capacitor: 1000uF_6.3V
firmware_fw2:
  code_path: "04_Прошивка/nano_fw2/nano_fw2.ino"
  code_prepared: true
  compile_verified: false
  hardware_verified: false
  ring_a_pin: D6
  ring_b_pin: D7
  led_count_each: 43

second_ring_policy_2026_09_20:
  physical_test_deferred: true
  ring_b_pin: D7
  behavior: mirror_ring_a_frame
  independent_logic: false
  test_after_single_ring_full_setup: true
  nano_fw2_file_status: future_test_draft
current_single_ring_focus:
  ring_pin: D6
  finish_f01_controls: true
  next_commands: [OFF, ON, BRIGHT_8, BRIGHT_64, STATUS]

single_ring_f01_complete_2026_09_20:
  status: passed
  commands_verified: [OFF, ON, BRIGHT_8, BRIGHT_64, STATUS, COLOR]
max9814_stage:
  code_path: "04_Прошивка/nano_mic_test/nano_mic_test.ino"
  code_prepared: true
  hardware_verified: false
  pin: A0
  wiring:
    Vdd: Nano_5V
    GND: Nano_GND
    Out: A0
    Gain: floating
    AR: floating
  diagnostic_command: MIC

max9814_measurement_2026_09_20:
  sample_1: {avg: 249, min: 61, max: 413, p2p: 352, samples: 251}
  sample_2: {avg: 252, min: 130, max: 415, p2p: 285, samples: 251}
  dc_bias_looks_expected: true
  clipping_observed: false
  sound_response_confirmed: false
  reason: "50ms rolling snapshot may miss transient sound"
  next_test_command: MIC1S

max9814_mic1s_2026_09_20:
  gain_state: floating_60dB
  quiet: {avg: 252, min: 108, max: 417, p2p: 309, samples: 4998}
  loud: {avg: 307, min: 0, max: 886, p2p: 886, samples: 4995}
  sound_response_confirmed: true
  low_rail_clipping_observed: true
  next_gain_state: GND_50dB
  aref_change_now: false

max9814_gain_gnd_attempt_2026_09_20:
  result: abnormal_zero_output
  sample_1: {avg: 0, min: 0, max: 5, p2p: 5, samples: 4993}
  sample_2: {avg: 0, min: 0, max: 16, p2p: 16, samples: 4992}
  gain_50db_verified: false
  likely_issue: wiring_or_wrong_pin
  next_step: revert_gain_floating_and_retest

max9814_recovery_2026_09_20:
  gain_state: floating_60dB
  noisy_sample: {avg: 278, min: 0, max: 508, p2p: 508, samples: 4996}
  module_and_a0_working: true
  clipping_low_rail_still_present: true
  prior_zero_output_tied_to_gain_wiring_attempt: true
  next_step: verify_physical_gain_pin_before_reconnect

max9814_gain_50db_2026_09_20:
  wiring_verified: true
  quiet: {avg: 250, min: 85, max: 360, p2p: 275, samples: 5000}
  loud: {avg: 260, min: 0, max: 507, p2p: 507, samples: 996}
  low_rail_clipping: true
  sample_count_anomaly: true
  next_gain_state: Vdd_40dB

max9814_50db_test_2026_09_20:
  gain_state: GND_50dB
  quiet: {avg: 250, min: 85, max: 360, p2p: 275, samples: 5000}
  loud_strip_on: {avg: 260, min: 0, max: 507, p2p: 507, samples_reported: 996}
  loud_strip_off: {avg: 257, min: 0, max: 506, p2p: 506, samples: 4991}
  strip_noise_detected: false
  clipping_low_rail: true
  next_gain_state: Vdd_40dB

max9814_40db_test_2026_09_20:
  gain_state: Vdd_40dB
  quiet: {avg: 250, min: 205, max: 282, p2p: 77, samples: 4997}
  loud: {avg: 250, min: 0, max: 503, p2p: 503, samples: 4999}
  fw4_passed: true
  accepted_for_m01: true
  negative_rail_clipping_extreme_transient: true
  revisit_before_fht: true
firmware_m01:
  code_path: "04_Прошивка/nano_m01/nano_m01.ino"
  source_basis: AlexGyver_ColorMusic_v2_10_VU
  code_prepared: true
  compile_verified: false
  hardware_verified: false
  gain_state: Vdd_40dB
  calibration_command: CAL
  diagnostic_command: AUDIO

firmware_m01_hardware_2026_09_20:
  status: passed
  calibration: {quiet_max: 260, low_pass: 273}
  audio_snapshot: {peak: 276, level: 2.6, filtered: 17.8, average: 63.4, max_level: 114.2, pairs: 3}
  visual_music_response_confirmed: true
firmware_fht_test:
  code_path: "04_Прошивка/nano_fht_test/nano_fht_test.ino"
  code_prepared: true
  compile_verified: false
  hardware_verified: false
  fht_n: 64
  bands:
    low: "2..5"
    mid: "6..10"
    high: "11..31"
  adc_reference: DEFAULT_5V
  reason_not_internal_1v1: "MAX9814 direct output has about 1.25V DC offset"
  commands: [CALF, FREQ, FREQRAW]

fht_library_2026_09_20:
  selected: AvrFHT
  source: KobaProduction/AvrFHT
  version_checked: 1.1.1
  architecture: avr
  relation: modified_ArduinoFHT_OpenMusicLabs
  alexgyver_old_fht_present: true
  alexgyver_path: libraries/FHT
  test_code_adapted: true
  api_transform_call: fht_transform
  samples_macro: FHT_SAMPLES_N

avrfht_first_run_2026_09_20:
  calf: {dc: 914, quiet_max: 32, spectr_low_pass: 35}
  freq_result: all_zero
  accepted_as_valid_physical_result: false
  conflict_with_previous_dc_about_250: true
  suspected_cause: dc_calibration_while_adc_prescaler_32
  code_fix:
    dc_measure_prescaler: 128
    discard_initial_conversions: 8
    fht_prescaler: 32
    direct_adc_command_added: true
  next_command: ADC

avrfht_second_run_2026_09_20:
  calf: {dc: 946, quiet_max: 33, spectr_low_pass: 36}
  freqraw_1: {low: 19, mid: 27, high: 19, peak: 27}
  freqraw_2: {low: 19, mid: 19, high: 19, peak: 19}
  accepted_as_valid_spectrum: false
  next_branch_test: ADC
  adc_unknown_command_means_old_sketch: true

avrfht_zero_input_2026_09_21:
  calf: {dc: 0, quiet_max: 19, spectr_low_pass: 22}
  freqraw_1: {low: 0, mid: 0, high: 0, peak: 0}
  freqraw_2: {low: 0, mid: 0, high: 0, peak: 0}
  valid_spectrum: false
  direct_input_must_be_restored_first: true
  expected_known_good_adc_avg: about_250
  first_branch: ADC_command
  if_zero_next: remove_gain_to_vdd_only_and_repeat_ADC

direct_adc_after_current_fht_2026_09_21:
  current_sketch_confirmed_by_help: true
  adc: {avg: 0, min: 0, max: 13}
  fht_primary_fault_excluded: true
  analog_path_fault_present: true
  next_measurements:
    - MAX9814_Vdd_to_GND
    - MAX9814_Out_to_GND
  expected_vdd_v: about_5
  expected_out_dc_v: about_1_25

max9814_direct_voltage_2026_09_21:
  vdd_to_gnd_v: 5.09
  out_to_gnd_v: 1.24
  module_power_ok: true
  dc_offset_ok: true
  current_fault_location: between_max9814_out_and_nano_a0_or_a0_input
  next_measurement: Nano_A0_to_Nano_GND

nano_a0_voltage_2026_09_21:
  max9814_out_v: 1.24
  nano_a0_v: 0.15
  direct_path_ok: false
  likely_fault: wire_contact_or_a0_loading
  next_checks:
    - continuity_out_to_a0_wire_power_off
    - resistance_a0_to_gnd_with_out_disconnected_power_off

analog_path_repaired_2026_09_21:
  fault: bad_out_to_a0_wire_or_contact
  nano_a0_voltage_after_fix_v: 1.25
  analog_path_voltage_restored: true
  next_command: ADC
  expected_adc_avg: "240..270"

avrfht_valid_run_2026_09_21:
  adc: {avg: 250, min: 233, max: 264}
  calf: {dc: 250, quiet_max: 61, spectr_low_pass: 64}
  quiet_raw: {low: 19, mid: 19, high: 16, peak: 19}
  sound_raw: {low: 64, mid: 30, high: 19, peak: 64}
  basic_fht_signal_response: true
  three_band_separation_verified: false
  fw6a_basic_status: hardware_working
  calibration_threshold_may_be_conservative: true
  next_test: gated_FREQ_quiet_and_music

avrfht_gate_issue_2026_09_21:
  calf_old: {dc: 258, quiet_max: 58, spectr_low_pass: 61}
  gated_freq_all_zero: true
  raw_sample: {low: 37, mid: 19, high: 19, peak: 37}
  cause: gate_above_useful_raw_signal_due_to_absolute_max_calibration
  calibration_fix:
    frames: 100
    statistic: p90_of_frame_peaks
    add: 3
    diagnostics: [P50, P90, MAX]
  code_commit: fe691e0cb13b7b08f4ead0b8c12028180c6e591e
  next_test: reload_and_run_CALF_then_FREQ

color_music_upstream_vendor_2026_09_21:
  upstream_repo: AlexGyver/ColorMusic
  upstream_commit: a3f94de053d431f15282c2f67681b77ab66c30ae
  baseline_reference: colorMusic_v2.10
  late_firmware_copies:
    - colorMusic_v2.7.ino
    - colorMusic_v2.8.ino
    - colorMusic_v2.9.ino
    - colorMusic_v2.10.ino
  fht:
    selected: original_AlexGyver_ColorMusic_FHT
    repo_path: "04_Прошивка/libraries/FHT"
    api: [FHT_N, FHT_h, fht_run, fht_mag_log]
    avrfht_primary: false
    compile_verified_after_switch: false

fht_fastled_compat_2026_09_21:
  problem: "legacy FHT global macro SCALE conflicts with modern FastLED identifiers"
  upstream_fht_modified: false
  sketch_fix: "undef SCALE after FHT.h before FastLED.h"
  verify_after_fix: pending
  grpc_invalid_utf8_note: "secondary until C++ compile error is gone"

original_fht_compile_upload_2026_09_21:
  compile: passed
  upload: passed
  nano: actual_hardware
  fastled_scale_compat_fix: passed
  upstream_fht_modified: false
  next_runtime_commands: [HELP, STATUS, ADC]

original_fht_runtime_2026_09_21:
  help_ok: true
  status_library: AlexGyver_FHT
  fht_n: 64
  startup_dc: 390
  adc_after_start: {avg: 251, min: 242, max: 258}
  analog_input_ok: true
  startup_dc_valid: false
  suspected_reason: early_calibration_before_analog_path_settled
  code_changes:
    startup_settle_delay_ms: 500
    calf_settle_delay_ms: 500
    calf_algorithm: original_absolute_max_plus_3
    p90_removed: true
  next: reload_then_STATUS_ADC_CALF

previous_dc390_correction_2026_09_21:
  previous_dc_390_valid: false
  reason: "MAX9814 Out to Nano A0 wire detached during previous test"
  startup_timing_fault_confirmed: false
  next_valid_sequence: [ADC, STATUS, CALF, FREQRAW]

original_fht_valid_calf_2026_09_21:
  adc: {avg: 265, min: 259, max: 272}
  startup_status_dc: 252
  calf: {dc: 264, quiet_max: 33, spectr_low_pass: 36}
  raw_sample: {low: 74, mid: 82, high: 27, peak: 82}
  dc_path_consistent: true
  original_max_plus_3_gate_reasonable: true
  gated_behavior_verified: false
  next_test: FREQ_quiet_then_sound

original_fht_gate_pass_2026_09_21:
  low_pass: 36
  quiet_samples:
    - {low: 0, mid: 0, high: 0, peak: 0}
    - {low: 0, mid: 0, high: 0, peak: 0}
    - {low: 0, mid: 0, high: 0, peak: 0}
  sound_samples:
    - {low: 38, mid: 0, high: 0, peak: 38}
    - {low: 0, mid: 0, high: 0, peak: 0}
    - {low: 66, mid: 0, high: 0, peak: 66}
  noise_gate_verified: true
  band_mapping_matches_colormusic_v2_10: true
  mid_band_verified: false
  high_band_verified: false
  next_test: controlled_tones_2k_4to5k_8k

audio_input_colormusic_v2_10_2026_09_21:
  decision: use_original_two_input_logic
  mono_vu_input: A2
  fht_input: A3
  fht_input_note: through_original_capacitor_network
  left_input_A1_used: false
  diagnostic_A0_final: false
  reason: minimize_relayout_of_original_v2_10_code
  next: reproduce_official_microphone_front_end_before_band_tests

fht_three_band_a0_pass_2026_09_21:
  input: A0_diagnostic_direct_MAX9814
  low_pass: 36
  tones:
    2000Hz:
      low: [92, 84, 92, 84]
      mid: 0
      high: 0
    5000Hz:
      low: 0
      mid: [92, 92, 92, 92]
      high: 0
    8000Hz:
      low: 0
      mid: 0
      high: [78, 68, 68, 72]
  fht_algorithm_verified: true
  noise_gate_verified: true
  three_band_separation_verified: true
  fw6a_diagnostic_status: passed
  final_input_still_planned: A2_VU_plus_A3_FHT

audio_v210_test_prepared_2026_09_21:
  sketch: "04_Прошивка/nano_audio_v210_test/nano_audio_v210_test.ino"
  wiring_doc: "04_Прошивка/AUDIO_V210_WIRING.md"
  vu_pin: A2
  fht_pin: A3
  aref: INTERNAL_1V1
  max9814_gain_db: 40
  ar: floating
  coupling_c1:
    capacitance_uf: 1
    minimum_voltage_v: 6.3
    polarity_plus: MAX9814_OUT
    polarity_minus: A2
  a2_pull_down_ohm: 9400
  a2_to_a3_cap_nf: 10
  compile_verified: false
  hardware_verified: false
  next_commands: [STATUS, ADC2, ADC3]


audio_single_input_d040_2026_09_24:
  status: passed_on_hardware
  final_input: A0
  microphone: MAX9814
  gain_db: 40
  ar: floating
  adc_reference: DEFAULT
  dc_subtraction: software
  fht_library: original_AlexGyver_ColorMusic
  fht_n: 64
  bins: {low: "2..5", mid: "6..10", high: "11..31"}
  three_band_classification_verified: true
  supersedes_audio_v210_a2_a3_as_final_path: true

firmware_m03_2026_09_24:
  code_path: "04_Прошивка/nano_m03/nano_m03.ino"
  mode_id: M03
  name: five_stripes
  ring_a_pin: D6
  ring_b_pin: D7_low_unconnected
  led_count: 43
  current_limit_ma: 500
  source_algorithm: AlexGyver_ColorMusic_v2_10
  code_prepared: true
  compile_verified: true
  upload_verified: true
  hardware_verified: false
  startup_status_verified: true
  startup_dc: 250
  background_default: 0
  next: ADC_then_CALF


firmware_m03_result_2026_09_25:
  status: passed_on_hardware
  ring_pin: D6
  led_count: 43
  common_ground_verified: true
  background_default: 0
  silence_fully_off: true
  bands_verified: {2000Hz: LOW, 5000Hz: MID, 8000Hz: HIGH}
  real_music_visual_test: passed

firmware_m04_2026_09_25:
  code_path: "04_Прошивка/nano_m04/nano_m04.ino"
  mode_id: M04
  name: three_stripes
  source_algorithm: AlexGyver_ColorMusic_v2_10
  frontend_reused_from_m03: true
  layout: "first third HIGH, middle third MID, final third LOW"
  led_distribution_43: {HIGH: 14, MID: 14, LOW: 15}
  background_default: 0
  code_prepared: true
  compile_verified: true
  upload_verified: true
  hardware_verified: false
  next: verify_compile


firmware_m04_adc_2026_09_25:
  avg: 249
  min: 243
  max: 256
  p2p: 13
  saturation: false
  baseline_valid: true
  next: CALF_quiet


firmware_m04_calf_2026_09_25:
  dc: 251
  quiet_max: 43
  spectr_low_pass: 46
  valid: true
  quiet_false_flashes: false
  keyboard_click_response: true
  next: controlled_2_5_8_kHz_three_zone_test


firmware_m04_band_classification_2026_09_25:
  status: passed
  tones: {2000Hz: LOW, 5000Hz: MID, 8000Hz: HIGH}
  steady_tone_visual_fade_expected: true
  final_m04_test: real_music_three_zones_and_silence_off


firmware_m04_result_2026_09_25:
  status: passed_on_hardware
  three_zones_real_music: true
  silence_fully_off: true
  band_classification: {2000Hz: LOW, 5000Hz: MID, 8000Hz: HIGH}

firmware_m05_2026_09_25:
  code_path: "04_Прошивка/nano_m05_r2/nano_m05_r2.ino"
  mode_id: M05
  name: one_strip_selected_frequency_group
  submodes: [THREE, LOW, MID, HIGH]
  default_submode: THREE
  three_priority: [HIGH, MID, LOW]
  background_default: 0
  frontend_reused_from_m04: true
  code_prepared: true
  compile_verified: false
  upload_verified: false
  hardware_verified: false
  next: verify_compile


firmware_revision_policy_2026_09_25:
  active: true
  rule: "Any code fix after owner handoff/testing increments Rn"
  mode_id_stable: true
  revision_visible_in_filename_startup_status: true


firmware_m05_r2_upload_2026_09_25:
  compile: passed
  upload: passed
  runtime_verified: false
  next: startup_and_status_rev2


firmware_m05_r2_runtime_2026_09_25:
  startup: "ARDU NANO M05 R2 READY"
  status_verified: true
  fw: M05
  rev: 2
  submode: THREE
  background: 0
  dc: 250
  calf_done: false
  next: ADC_quiet


firmware_m05_r2_adc_fault_2026_09_25:
  startup_dc: 250
  later_adc: {avg: 10, min: 6, max: 28, p2p: 22}
  valid: false
  adc_code_diff_vs_m04: none_detected
  calf_allowed: false
  next_measurements:
    - repeated_ADC_with_ring_OFF
    - MAX9814_Vdd_to_GND
    - MAX9814_Out_to_GND
    - Nano_A0_to_Nano_GND


m05_r2_out_a0_fault_2026_09_25:
  max9814_vdd_v: 5.08
  max9814_out_v: 1.25
  nano_a0_v: 0.16
  max9814_power_ok: true
  max9814_bias_ok: true
  out_to_a0_path_ok: false
  likely_fault: wire_contact_or_a0_loading
  calf_allowed: false


firmware_m05_r2_adc_recovered_2026_09_26:
  avg: 250
  min: 241
  max: 262
  p2p: 21
  valid: true
  saturation: false
  previous_out_a0_fault_currently_present: false
  next: CALF_and_all_submodes


firmware_m05_r2_reset_invalid_dc_2026_09_26:
  status: invalid_test_state
  before_reset: {submode: THREE, dc: 255, spectr_low_pass: 68, cal: true, uptime_ms: 710801}
  after_reset_first_seen: {submode: LOW, dc: 1000, spectr_low_pass: 40, cal: true, uptime_ms: 120349}
  reset_proven_by_uptime_drop: true
  reset_cause: unknown
  submode_results_after_reset_valid: false

firmware_m05_r3_2026_09_26:
  code_path: "04_Прошивка/nano_m05_r3/nano_m05_r3.ino"
  mode_id: M05
  revision: 3
  invalid_dc_guard: {min: 120, max: 400}
  invalid_calf_behavior: "ERR CALF_BAD_DC; CAL remains NO"
  status_has_dc_ok: true
  compile_verified: false
  upload_verified: false
  hardware_verified: false
  next: verify_upload_then_status_adc_calf_status


firmware_m05_r3_guard_test_2026_09_26:
  startup_dc: 249
  adc: {avg: 250, min: 223, max: 288, p2p: 65}
  rejected_calf_dc: [26, 25]
  accepted_calf:
    - {dc: 250, quiet_max: 42, spectr_low_pass: 45}
    - {dc: 250, quiet_max: 33, spectr_low_pass: 36}
    - {dc: 251, quiet_max: 33, spectr_low_pass: 36}
  final_status: {dc: 251, dc_ok: true, cal: true, spectr_low_pass: 36}
  reset_during_series: false
  submode_commands_passed: [THREE, LOW, MID, HIGH, THREE]
  guard_hardware_verified: true
  analog_path_stability_pending: true


firmware_m05_r3_visual_uart_result_2026_09_26:
  visual_submodes_passed: [THREE, LOW, MID, HIGH]
  active_ring_serial_errors_reproduced: true
  power_off_serial_burst_clean: true
  final_r3_status: {dc: 249, dc_ok: true, spectr_low_pass: 36, cal: true, uptime_ms: 3152824}
  reset_during_final_visual_series: false
  remaining_fault: FastLED_UART_coexistence

firmware_m05_r4_2026_09_26:
  code_path: "04_Прошивка/nano_m05_r4/nano_m05_r4.ino"
  mode_id: M05
  revision: 4
  fastled_allow_interrupts: true
  serial_rx_guard_ms: 5
  status_fields: [FASTLED_IRQ, RX_GUARD_MS]
  compile_verified: false
  upload_verified: false
  uart_stress_verified: false
  led_visual_regression_verified: false
  next: verify_upload_then_active_ring_uart_stress


firmware_m05_r4_result_2026_09_26:
  status: passed_on_hardware
  visual_submodes: passed
  active_ring_uart_stress: passed
  unknown_command_errors: 0
  bad_submode_errors: 0
  led_visual_artifacts: false
  transport_baseline:
    fastled_allow_interrupts: true
    serial_rx_guard_ms: 5

firmware_m08_r1_2026_09_26:
  code_path: "04_Прошивка/nano_m08_r1/nano_m08_r1.ino"
  mode_id: M08
  revision: 1
  name: running_frequencies
  submodes: [THREE, LOW, MID, HIGH]
  default_submode: THREE
  running_speed_ms_default: 11
  running_speed_range_ms: "1..255"
  odd_43_led_center_index: 21
  direction: center_to_both_data_chain_ends
  inherited_uart_fix: {fastled_allow_interrupts: true, serial_rx_guard_ms: 5}
  inherited_dc_guard: true
  compile_verified: false
  upload_verified: false
  hardware_verified: false
  next: verify_upload_adc_calf_visual_speed


firmware_m08_r1_result_2026_09_26:
  status: passed_on_hardware
  submodes: [THREE, LOW, MID, HIGH]
  speed_values_verified_ms: [5, 20, 50, 11]
  dc: 250
  dc_ok: true
  spectr_low_pass: 36
  cal: true
  active_ring_uart_errors: 0
  visual_behavior: passed

firmware_m09_r1_2026_09_26:
  code_path: "04_Прошивка/nano_m09_r1/nano_m09_r1.ino"
  mode_id: M09
  revision: 1
  name: spectrum_analyzer
  displayed_bins: 20
  fht_bin_first: 2
  hue_start_default: 0
  hue_step_default: 5
  light_smooth: 2
  odd_43_led_center_adaptation: true
  diagnostic_command: SPEC
  inherited_uart_fix: {fastled_allow_interrupts: true, serial_rx_guard_ms: 5}
  inherited_dc_guard: true
  compile_verified: false
  upload_verified: false
  hardware_verified: false
  next: verify_upload_adc_calf_visual_spec


firmware_m09_r1_result_2026_09_26:
  status: passed_on_hardware
  adc: {avg: 251, min: 231, max: 274, p2p: 43}
  calf: {dc: 251, quiet_max: 42, spectr_low_pass: 45}
  spec_dynamic_on_music: true
  hue_start_test: 80
  hue_step_test: 12
  defaults_restored: {hue_start: 0, hue_step: 5}
  active_ring_uart_errors: 0
  visual_behavior: passed

fw6_result_2026_09_26:
  status: passed_on_one_ring
  modes: [M03, M04, M05, M08, M09]

firmware_f02_r1_2026_09_26:
  code_path: "04_Прошивка/nano_f02_r1/nano_f02_r1.ino"
  mode_id: F02
  revision: 1
  name: smooth_color_cycle
  defaults: {brightness: 64, hue: 0, saturation: 255, speed_ms: 100}
  commands: [HUE, SAT, SPEED, BRIGHT, ON, OFF]
  inherited_uart_fix: {fastled_allow_interrupts: true, serial_rx_guard_ms: 5}
  compile_verified: false
  upload_verified: false
  hardware_verified: false
  next: verify_upload_visual_parameters


firmware_f02_r1_result_2026_09_26:
  status: passed_on_hardware
  speed_values_verified_ms: [20, 200, 100]
  saturation_values_verified: [80, 255]
  hue_set_verified: 96
  active_ring_uart_errors: 0
  visual_behavior: passed

firmware_f03_r1_2026_09_26:
  code_path: "04_Прошивка/nano_f03_r1/nano_f03_r1.ino"
  mode_id: F03
  revision: 1
  name: running_rainbow
  frame_interval_ms: 30
  defaults: {brightness: 64, speed: 1, step10: 5}
  speed_semantics: "base hue delta per 30 ms frame"
  step10_semantics: "spatial hue step x10 per LED"
  commands: [SPEED, STEP10, HUE, BRIGHT, ON, OFF]
  inherited_uart_fix: {fastled_allow_interrupts: true, serial_rx_guard_ms: 5}
  compile_verified: false
  upload_verified: false
  hardware_verified: false
  next: verify_upload_visual_speed_step


firmware_f03_r1_result_2026_09_26:
  status: passed_on_hardware
  visual_behavior: passed
  speed_control: passed
  spatial_step_control: passed
  hue_control: passed

firmware_ambient_r1_2026_09_26:
  code_path: "04_Прошивка/nano_ambient_r1/nano_ambient_r1.ino"
  revision: 1
  mode: AMBIENT
  effects: [F01, F02, F03]
  default_effect: F01
  manual_navigation: [EFFECT, NEXT, PREV]
  auto_cycle:
    default_enabled: false
    default_period_s: 10
    period_range_s: "1..255"
    sequence: [F01, F02, F03]
    manual_selection_resets_timer: true
  inherited_uart_fix: {fastled_allow_interrupts: true, serial_rx_guard_ms: 5}
  compile_verified: false
  upload_verified: false
  hardware_verified: false
  next: verify_upload_manual_auto_cycle


ambient_r1_result_2026_09_26:
  status: passed_on_hardware
  effects: [F01, F02, F03]
  manual_effect_select: passed
  next_prev: passed
  auto_cycle: passed
  fw7_closed: true

firmware_rtc_r1_2026_09_26:
  code_path: "04_Прошивка/nano_rtc_r1/nano_rtc_r1.ino"
  wiring_doc: "04_Прошивка/RTC_DS3231_WIRING.md"
  revision: 1
  device: DS3231
  i2c_address: "0x68"
  pins: {sda: A4, scl: A5}
  external_library_required: false
  commands: [STATUS, TIME, TEMP, SET, CLEAROSF]
  charge_resistor_201_removed_verified: false
  cr2032_installed: true
  hardware_power_allowed_with_cr2032: false
  compile_verified: false
  upload_verified: false
  rtc_present_verified: false
  retention_verified: false
  next: remove_201_then_verify_upload_rtc_test


rtc_r1_result_2026_09_26:
  status: passed_on_hardware
  i2c_address: "0x68"
  present: true
  time_running: true
  temperature_c: 29.50
  set_time_passed: true
  osf_after_set: 0
  lost_power_after_set: false
  resistor_201_removed: owner_confirmed
  battery_retention: owner_confirmed

firmware_alarm_r1_2026_09_26:
  code_path: "04_Прошивка/nano_alarm_r1/nano_alarm_r1.ino"
  test_doc: "04_Прошивка/ALARM_R1_TEST.md"
  revision: 1
  rtc: DS3231
  led_dawn_enabled: false
  storage: "ATmega328P internal EEPROM"
  persisted: [enabled, hour, minute, last_trigger_date]
  storage_guard: [magic, version, checksum]
  event: "EVENT ALARM_TRIGGER"
  compile_verified: false
  upload_verified: false
  hardware_verified: false
  next: verify_upload_persistence_daily_trigger


alarm_r1_result_2026_09_26:
  status: passed_on_hardware
  persisted_after_reset: true
  alarm_time_tested: "20:50"
  first_trigger: "2026-09-26 20:50:00"
  duplicate_without_clearlast: false
  clearlast_retrigger_same_minute_expected: true

firmware_dawn_r1_2026_09_26:
  code_path: "04_Прошивка/nano_dawn_r1/nano_dawn_r1.ino"
  test_doc: "04_Прошивка/DAWN_R1_TEST.md"
  revision: 1
  default_settings:
    fade_minutes: 30
    max_brightness: 120
    start_hue: 8
    end_hue: 32
  trajectory:
    brightness: linear
    hue: shortest_hsv_arc
    completion_state: HOLD
  manual_test_seconds_range: "5..120"
  alarm_trigger_starts_dawn: true
  dawn_stop_supported: true
  alarm_eeprom_backward_compatible: true
  dawn_eeprom_block_base: 16
  inherited_uart_fix: true
  active_dawn_reset_recovery: false
  compile_verified: false
  upload_verified: false
  hardware_verified: false
  next: verify_upload_manual_test_then_alarm_trigger


dawn_r1_result_2026_09_26:
  status: passed_on_hardware
  visual_trajectory: passed
  parameter_regression: passed
  dawn_stop: passed
  alarm_triggered_dawn: passed

firmware_dawn_r2_2026_09_26:
  code_path: "04_Прошивка/nano_dawn_r2/nano_dawn_r2.ino"
  test_doc: "04_Прошивка/DAWN_R2_TEST.md"
  revision: 2
  alarm_time_semantics: dawn_start
  recovery_clock: DS3231
  runtime_storage:
    eeprom_base: 32
    writes_only_on: [START, COMPLETE, STOP]
    persisted: [phase, source, start_rtc_seconds, duration_seconds]
  recovery_sources: [ALARM, MANUAL, TEST]
  status_fields: [SOURCE, RUNTIME_SAVED, RECOVERED]
  compile_verified: false
  upload_verified: false
  hardware_verified: false
  next: active_dawn_reset_recovery_test


dawn_r2_result_2026_09_26:
  status: passed_on_hardware
  test_recovery_running: passed
  recovered_test_elapsed_s: 19
  recovered_test_remaining_s: 11
  hold_persistence: passed
  stop_persistence: passed
  alarm_recovery_running: passed
  recovered_alarm_elapsed_s: 19
  recovered_alarm_remaining_s: 41
  duplicate_alarm_after_reset: false
  fw8_closed: true

firmware_night_r1_2026_09_26:
  code_path: "04_Прошивка/nano_night_r1/nano_night_r1.ino"
  test_doc: "04_Прошивка/NIGHT_R1_TEST.md"
  revision: 1
  mode: NIGHT
  defaults:
    power: false
    hue: 24
    saturation: 180
    brightness: 18
  storage:
    eeprom_base: 64
    persisted: [power, hue, saturation, brightness]
    guard: [magic, version, checksum]
  schedule_enabled: false
  inherited_uart_fix: true
  compile_verified: false
  upload_verified: false
  hardware_verified: false
  next: verify_upload_visual_and_persistence


firmware_night_r1_2026_09_26:
  status: superseded_before_hardware_test
  superseded_by: NIGHT_R2

firmware_night_r2_2026_09_26:
  code_path: "04_Прошивка/nano_night_r2/nano_night_r2.ino"
  test_doc: "04_Прошивка/NIGHT_R2_TEST.md"
  revision: 2
  mode: NIGHT
  defaults:
    manual_power: false
    hue: 24
    saturation: 180
    brightness: 18
    schedule_enabled: false
    schedule_on: "22:00"
    schedule_off: "07:00"
  schedule:
    rtc: DS3231
    supports_overnight: true
    interval_semantics: "[on, off)"
    manual_on_off_disables_schedule: true
    visual_changes_keep_schedule: true
    invalid_rtc_fail_safe_power: false
    transition_eeprom_writes: false
  storage:
    eeprom_base: 64
    version: 2
    persisted: [manual_power, hue, saturation, brightness, schedule_enabled, schedule_on, schedule_off]
  inherited_uart_fix: true
  compile_verified: false
  upload_verified: false
  hardware_verified: false
  next: verify_upload_manual_schedule_persistence


night_r2_result_2026_09_27:
  status: passed_on_hardware
  owner_confirmed_full_test: true
  fw9_closed: true

implementation_order_2026_09_27:
  owner_decision: true
  sequence:
    - m02_r1_hardware_pass
    - l01_and_clap_hardware_pass
    - full_nano_firmware_integration
    - full_nano_regression
    - esp8266_uart_http
    - mobile_app
  softap_v1: false
  home_wifi_only: true
  internet_required_for_control: false
  app_after_full_nano_regression: true
  app_developer_mode_required: true
  app_mode_settings_required: true
  app_microphone_calibration_required: true

m02_r1_plan_2026_09_27:
  code_path: "04_Прошивка/nano_m02_r1/nano_m02_r1.ino"
  test_doc: "04_Прошивка/M02_R1_TEST.md"
  revision: 1
  mode: M02
  frontend: "MAX9814 Out->A0, 40dB, AR floating, DEFAULT AREF"
  leds: 43
  data_pin: D6
  second_ring_connected: false
  default_background: 0
  rainbow_step10_default: 50
  smooth_percent_default: 30
  inherited_uart_fix: true
  compile_verified: true
  upload_verified: true
  hardware_verified: true
  calibration: passed_owner_report
  uart_stress: passed_owner_report
  visual_behavior: passed_owner_report
  result: passed_on_hardware
  background_visible_threshold_observed:
    global_brightness: 64
    approximately_raw_background: 35
    below_threshold: visually_off
  persistence_in_test_sketch: false
  next: closed


ordinary_light_requirements_2026_09_27:
  owner_decision: true
  top_level_mode: light
  stable_id: L01
  output: "two synchronized WS2812B rings"
  behavior: constant_white
  brightness_adjustable: true
  app_on_off: true
  cold_power_on_from_230v_switch: light_on
  service_reset_is_not_power_switch: true
  current_limit_required: true
  clap_switch:
    required: true
    sensor: MAX9814_A0
    local_on_nano: true
    app_enable_disable: true
    recognition_pattern: hardware_test_pending
    false_trigger_test_required: [music, speech, household_impulses]
  implementation_position: after_m02_before_full_nano

app_rtc_display_2026_09_27:
  owner_decision: true
  display_on_main_screen: true
  source_of_truth: DS3231
  phone_time_is_not_display_time: true
  phone_time_use: explicit_rtc_sync_only
  api_source: "/api/time"


settings_persistence_v1_2026_09_27:
  owner_decision: true
  canonical_source: Nano
  storage_preference: ATmega328P_internal_EEPROM
  fallback_storage_if_needed: DS3231_AT24C32_by_separate_decision
  structure_guard: [magic, version, checksum]
  per_mode_independent_settings: true
  survives_full_power_loss: true
  app_local_cache: true
  app_cache_authoritative: false
  app_sync_on_connect: [GET_api_status, GET_api_settings]
  live_preview_in_ram: true
  persist_every_slider_step: false
  final_value_requires_persistent_ack: true
  full_firmware_regression_requires_power_cycle_restore: true


m06_r1_retired_2026_09_27:
  status: passed_on_hardware_then_removed_by_owner
  mode_id_retired: M06
  active_firmware_file_present: false
  active_test_file_present: false
  included_in_final_firmware: false
  included_in_app: false

l01_r1_plan_2026_09_27:
  code_path: "04_Прошивка/nano_l01_r1/nano_l01_r1.ino"
  test_doc: "04_Прошивка/L01_R1_TEST.md"
  revision: 1
  mode: L01
  data_pin: D6
  leds: 43
  white_rgb: [255, 255, 255]
  startup_power: true
  default_brightness: 64
  single_ring_current_limit_ma: 500
  clap_in_r1: false
  persistence_in_r1: false
  inherited_uart_fix: true
  compile_verified: true
  upload_verified: true
  hardware_verified: true
  result: passed_on_hardware
  next: closed


l01_r2_plan_2026_09_27:
  code_path: "04_Прошивка/nano_l01_r2/nano_l01_r2.ino"
  test_doc: "04_Прошивка/L01_R2_TEST.md"
  revision: 2
  mode: L01
  color_modes: [KELVIN, RGB]
  kelvin_range: "1800..6500"
  presets_kelvin: [2700, 4000, 6000]
  custom_rgb: true
  brightness_range: "0..255"
  startup_profile_persistent: true
  storage: ATmega328P_internal_EEPROM
  commands: [KELVIN, PRESET, RGB, BRIGHT, SAVE, LOAD, ON, OFF, STATUS]
  clap_in_r2: false
  compile_verified: true
  upload_verified: true
  hardware_verified: false
  next: kelvin_rgb_save_load_full_power_cycle_test


led_geometry_2026_09_27:
  owner_confirmed_physical_led_each: 44
  total_led_two_rings: 88
  previous_43_led_tests: historical_valid
  future_firmware_led_count: 44
  integration_regression_required:
    - M01
    - M02
    - M03
    - M04
    - M08
    - M09

l01_r2_result_2026_09_27:
  status: passed_on_hardware
  kelvin_presets: passed
  arbitrary_kelvin: passed
  custom_rgb: passed
  brightness: passed
  save_load: passed
  reset_restore: passed
  full_power_cycle_restore: passed

l01_r3_plan_2026_09_27:
  code_path: "04_Прошивка/nano_l01_r3/nano_l01_r3.ino"
  test_doc: "04_Прошивка/L01_R3_TEST.md"
  revision: 3
  led_count: 44
  preset_2700_rgb: [255, 170, 87]
  preset_2700_visual_reference: "same as L01 R2 KELVIN 2200"
  persistence_structure_changed: false
  compile_verified: true
  upload_verified: true
  hardware_verified: true
  result: passed_on_hardware
  next: closed


historical_sketch_policy_2026_09_27:
  owner_decision: true
  old_43_led_test_sketches_immutable: true
  migrate_old_revisions_to_44: false
  integrated_firmware_led_count: 44
  integrated_visual_regression_required: [M01, M02, M03, M04, M08, M09]

clap_diag_r1_plan_2026_09_27:
  code_path: "04_Прошивка/nano_clap_diag_r1/nano_clap_diag_r1.ino"
  test_doc: "04_Прошивка/CLAP_DIAG_R1_TEST.md"
  revision: 1
  frontend: "MAX9814 Out->A0, 40dB, AR floating, DEFAULT AREF"
  led_control: false
  quiet_calibration: true
  threshold_adjustable: true
  event_fields: [P2P, PEAK_DEV, AVG, GAP_MS]
  false_positive_tests: [speech, music, household_impulses]
  final_gesture: hardware_data_pending
  compile_verified: true
  upload_verified: true
  hardware_verified: false
  result: insufficient_detector
  observed:
    startup_dc: 255
    startup_dc_ok: true
    calibrated: false
    default_threshold_p2p: 180
    adc_avg: 264
    adc_min: 246
    adc_max: 281
    adc_p2p: 35
    adc_peak_dev: 26
    mouse_click_event_p2p_min: 181
    mouse_click_event_p2p_max: 417
    clap_event_count: 0
  next: superseded_by_clap_diag_r2


clap_diag_r2_plan_2026_09_27:
  code_path: "04_Прошивка/nano_clap_diag_r2/nano_clap_diag_r2.ino"
  test_doc: "04_Прошивка/CLAP_DIAG_R2_TEST.md"
  revision: 2
  raw_capture_delay_ms: 1000
  raw_capture_window_ms: 3000
  raw_capture_threshold_free: true
  raw_capture_fields: [MAX_P2P, MAX_DEV, MIN, MAX, MAX_AVG_SHIFT, BLOCKS]
  event_logic: "P2P OR absolute deviation from DC"
  block_samples: 16
  capture_cases: [silence, mouse_click, clap_x3, speech, music]
  compile_verified: false
  upload_verified: false
  hardware_verified: false
  next: verify_upload_raw_capture_comparison


clap_diag_r2_observation_2026_09_27:
  dc: 249
  dc_ok: true
  quiet_avg_p2p: 17
  quiet_max_p2p: 366
  quiet_avg_dev: 15
  quiet_max_dev: 204
  auto_threshold_p2p: 732
  auto_threshold_dev: 408
  capture_max_p2p_samples: [503, 507, 505, 506, 318]
  capture_max_dev_samples: [255, 259, 257, 269, 172]
  diagnosis: absolute_max_outlier_dominated
  auto_calibration_accepted: false
  next_manual_threshold: {p2p: 180, dev: 120}


clap_diag_r3_plan_2026_09_27:
  code_path: "04_Прошивка/nano_clap_diag_r3/nano_clap_diag_r3.ino"
  test_doc: "04_Прошивка/CLAP_DIAG_R3_TEST.md"
  revision: 3
  calibration_delay_ms: 1500
  delayed_arm_after_clear_ms: 1500
  threshold_source: quiet_average
  quiet_max_used_for_threshold: false
  candidate_logic: "P2P AND DEV"
  event_lockout_ms: 250
  compile_verified: false
  upload_verified: false
  hardware_verified: false
  next: verify_upload_false_positive_characterization


clap_gyver_r1_plan_2026_09_27:
  code_path: "04_Прошивка/nano_clap_gyver_r1/nano_clap_gyver_r1.ino"
  test_doc: "04_Прошивка/CLAP_GYVER_R1_TEST.md"
  reference_doc: "04_Прошивка/CLAP_GYVER_REFERENCE.md"
  algorithm_source: "AlexGyver GyverLamp2 bundled VolAnalyzer + Clap"
  signal_to_clap: getRawMax
  detector: derivative_state_machine
  derivative_threshold_default: 250
  sequence_timeout_ms_default: 500
  target_claps: 2
  action_in_test: diagnostic_only
  fallback_thresholds: [200, 150]
  compile_verified: false
  upload_verified: false
  hardware_verified: false
  next: verify_upload_double_clap_false_positive_test


clap_gyver_r1_result_2026_09_27:
  status: failed_to_detect_clap_at_gyverlamp2_threshold
  startup_dc: 1019
  startup_dc_ok: false
  later_adc: {avg: 250, min: 181, max: 312, p2p: 131}
  derivative_threshold: 250
  clap_detected: false
  diagnosis:
    - startup_adc_transient
    - threshold_250_not_portable_to_ardu_max9814

clap_gyver_r2_plan_2026_09_27:
  code_path: "04_Прошивка/nano_clap_gyver_r2/nano_clap_gyver_r2.ino"
  test_doc: "04_Прошивка/CLAP_GYVER_R2_TEST.md"
  revision: 2
  derivative_threshold_default: 150
  sequence_timeout_ms: 500
  startup_settle_ms: 1200
  discard_reads: 16
  command_click_guard_ms: 700
  derivative_first_sample_priming: true
  fallback_threshold_after_trace: 100
  compile_verified: false
  upload_verified: false
  hardware_verified: false
  next: verify_upload_single_then_double_clap


clap_gyver_r2_observation_2026_09_27:
  algorithm_recognizes_real_clap: true
  threshold_150_reliability: intermittent
  trace_rawmax_rises_missed_approx: [87, 85]
  trace_rawmax_rise_detected_approx: 244
  trace_der_field_sampling_note: "50ms TRACE can miss 10ms derivative peak"
  next_threshold_test: 80
  firmware_change_required_for_next_test: false


clap_gyver_r2_threshold80_result_2026_09_27:
  derivative_threshold: 80
  single_test:
    single_events: 14
    sequences: 14
    double_events: 0
    owner_reports_false_single_events: true
  double_test:
    confirmed_double_events_min: 4
    owner_reliability: approximately_every_other_pair
    detected_pair_gaps_ms: [291, 291, 151, 141]
  interpretation:
    false_single_is_not_yet_false_switch: true
    double_reliability_insufficient: true
  next:
    derivative_threshold: 70
    sequence_timeout_ms: 500
    firmware_change_required: false


clap_gyver_r3_cal_plan_2026_09_27:
  code_path: "04_Прошивка/nano_clap_gyver_r3_cal/nano_clap_gyver_r3_cal.ino"
  test_doc: "04_Прошивка/CLAP_GYVER_R3_CAL_TEST.md"
  revision: 3
  app_ready_calibration: true
  target_gesture: double_clap
  calibration_pairs_range: "3..12"
  recommended_three_user_pairs: 9
  quiet_metric: p99_derivative
  clap_distribution_metric: p20_strength
  suggested_threshold_rule: "max(quiet_p99+10, 70% clap_p20)"
  apply_before_save: true
  persistent_storage: ATmega328P_internal_EEPROM
  compile_verified: false
  upload_verified: false
  hardware_verified: false
  next: verify_upload_multi_user_calibration


clap_default_profile_2026_09_27:
  owner_accepted_for_pre_app_use: true
  gesture: double_clap
  derivative_threshold: 70
  sequence_timeout_ms: 500
  family_calibration_deferred_to_app: true

fw10_core_r1_2026_09_27:
  code_path: "04_Прошивка/nano_fw10_core_r1/nano_fw10_core_r1.ino"
  test_doc: "04_Прошивка/FW10_CORE_R1_TEST.md"
  revision: 1
  led_count: 44
  physical_ring_outputs:
    D6: active
    D7: held_low
  current_limit_ma: 500
  integrated:
    - L01
    - clap_double
    - DS3231
    - alarm
    - dawn_recovery
    - night_schedule
    - reset_power_policy
  excluded_until_next_layers:
    - second_ring_D7
    - ambient
    - music
    - app_clap_calibration
  eeprom_map:
    alarm_base: 0
    dawn_settings_base: 16
    dawn_runtime_base: 32
    night_base: 64
    light_base: 128
    clap_base: 192
    core_base: 224
  clap_defaults: {threshold: 70, timeout_ms: 500, gesture: double}
  cold_boot_policy:
    unfinished_dawn_running: recover
    stale_dawn_hold: clear_and_L01
    otherwise: L01
  warm_reset_policy: restore_last_mode_or_dawn_runtime
  compile_verified: true
  compile_flash_bytes: 26014
  compile_flash_total_bytes: 30720
  compile_flash_percent: 84
  compile_global_sram_bytes: 1316
  compile_sram_total_bytes: 2048
  compile_global_sram_percent: 64
  compile_reported_free_sram_bytes: 732
  upload_verified: false
  hardware_verified: false
  next: upload_and_startup_gate


fw10_core_r1_compile_fix_2026_09_27:
  first_verify_result: failed
  errors:
    - "LightPersist does not name a type"
    - "ClapPersist does not name a type"
  cause: arduino_ino_auto_prototype_type_order
  fix_commit: "7bef2183b1cd78a4532105b48511adb32533830f"
  custom_type_order_scan: passed
  next: repeat_verify


fw10_core_r1_startup_2026_09_27:
  upload_verified: true
  startup_verified: true
  mode: L01
  reset_class: WARM_UNKNOWN
  mcusr: 0
  led_count: 44
  clap_threshold: 70
  rtc_valid: false
  blocker: rtc_diagnostics_before_core_regression


fw10_core_r1_rtc_gate_2026_09_27:
  rtc_valid: true
  owner_confirmed: true
  blocker_cleared: true
  next: l01_clap_reset_power_regression


fw10_core_r1_l01_block_2026_09_27:
  l01_persistence: passed
  double_clap_toggle: passed
  single_clap_no_toggle: passed
  warm_reset_restore_off: passed
  cold_power_on_l01: passed
  owner_confirmed: true
  next: night_manual_schedule_regression


fw10_core_r1_night_block_2026_09_27:
  manual_mode: passed
  visual_settings: passed
  schedule_transitions: passed
  schedule_reset_persistence: passed
  manual_override_disables_schedule: passed
  owner_confirmed: true
  next: dawn_recovery_alarm_regression


integration_regression_strategy_2026_09_27:
  owner_decision: true
  repeat_manual_core_regression_before_app: false
  final_regression_via_android_app: true
  app_platform: Android_Studio
  app_language: Kotlin
  transport_smoke_before_app_required: true

esp8266_http_bridge_r1_2026_09_27:
  code_path: "05_WiFi_и_приложение/esp8266_http_bridge_r1/esp8266_http_bridge_r1.ino"
  secrets_example: "05_WiFi_и_приложение/esp8266_http_bridge_r1/wifi_secrets.example.h"
  test_doc: "05_WiFi_и_приложение/ESP8266_HTTP_BRIDGE_R1_TEST.md"
  wifi_mode: station_only
  cloud_required: false
  uart_baud: 115200
  endpoints:
    - GET_api_ping
    - GET_api_status
    - GET_api_time
    - POST_api_dev_nano
    - GET_api_events
  compile_verified: false
  upload_verified: false
  wifi_verified: false
  nano_transport_verified: false
  next: compile_upload_transport_smoke


esp8266_http_bridge_r1_compile_result_2026_09_27:
  compile_verified: true
  ram_used_bytes: 30808
  ram_total_bytes: 80192
  ram_percent: 38
  iram_total_used_bytes: 60223
  iram_total_bytes: 65536
  iram_percent: 91
  iram_code_bytes: 27455
  flash_used_bytes: 294372
  flash_total_bytes: 1048576
  flash_percent: 28
  next: upload_physical_esp_then_http_uart_smoke


esp8266_http_bridge_r1_wifi_smoke_2026_09_27:
  wifi_verified: true
  http_ping_verified: true
  ip: "192.168.0.4"
  rssi_dbm: -55
  next: verify_uart_status_and_ping


transport_gate_closed_2026_09_29:
  esp_wifi_http: passed
  nano_uart_roundtrip: passed
  ping_pong: passed
  status: passed
  rtc_write: passed
  rtc_readback: passed
  rtc_readback_value: "2026-09-29 23:41:24"
  final_regression_via_android_app: true
  next: android_studio_kotlin_app_r1

android_app_r1_2026_09_29:
  code_path: "05_WiFi_и_приложение/android_app_r1"
  test_doc: "05_WiFi_и_приложение/ANDROID_APP_R1_TEST.md"
  platform: Android_Studio
  language: Kotlin
  agp: "9.4.1"
  gradle: "9.6.0"
  compile_sdk: 36
  min_sdk: 26
  source_created: true
  endpoints: [GET_api_ping, GET_api_status, GET_api_time, POST_api_dev_nano]
  events_deferred: true
  nano_source_of_truth: true
  normal_ui_shows_ip: false
  gradle_sync_verified: true
  build_verified: true
  physical_phone_run_verified: true
  app_ping_verified: true
  app_status_verified: true
  app_time_verified: true
  app_dev_ping_verified: true
  app_transport_pass: passed
  next: esp8266_http_bridge_r4_first_wired_flash

esp8266_http_bridge_r2_l01_stage1_2026_09_30:
  code_path: "05_WiFi_и_приложение/esp8266_http_bridge_r2/esp8266_http_bridge_r2.ino"
  test_doc: "05_WiFi_и_приложение/ESP8266_HTTP_BRIDGE_R2_TEST.md"
  revision: 2
  inherits_r1_transport: true
  startup_uart_framing_fix: true
  semantic_endpoints:
    - GET_api_light_status
    - POST_api_light_settings_enabled_only
  normal_ui_uses_raw_dev_endpoint: false
  nano_source_of_truth: true
  compile_verified: false
  upload_verified: false
  physical_light_status_verified: false
  physical_light_on_off_verified: false
  next: deferred_until_batched_esp_update

android_l01_stage1_2026_09_30:
  project_path: "05_WiFi_и_приложение/android_app_r1"
  app_version_name: "0.3-l01-semantic-r1"
  source_created: true
  reads_semantic_light_status: true
  semantic_read_endpoint: GET_api_light_status
  semantic_write_endpoint: POST_api_light_settings_enabled_only
  r1_compatibility_adapter: false
  developer_raw_endpoint_retained: true
  controls_enabled_only: true
  brightness_controls: false
  kelvin_controls: false
  rgb_controls: false
  android_read_only_verified: true
  android_read_only_connection: HTTP_BRIDGE_R5
  android_read_only_display: "Выключен • 2700 K • яркость 64"
  physical_verified: true
  physical_on_off_cycles: 3
  reconnect_state_reread_verified: true
  developer_ping_after_on_off_verified: true
  result: passed
  next: r6_brightness_kelvin_presets

esp_reflash_policy_2026_09_30:
  owner_decision: true
  current_physical_bridge: HTTP_BRIDGE_R7
  compact_wiring_should_remain_undisturbed: true
  reflash_for_each_app_iteration: false
  default_future_esp_update_path: OTA
  wired_programmer_role: recovery_only
  http_bridge_r2_source_kept_for_history: true

esp8266_http_bridge_r3_ota_2026_09_30:
  status: superseded_before_test
  code_path: "05_WiFi_и_приложение/esp8266_http_bridge_r3/esp8266_http_bridge_r3.ino"
  test_doc: "05_WiFi_и_приложение/ESP8266_HTTP_BRIDGE_R3_OTA_TEST.md"
  revision: 3
  inherits_r1_transport: true
  inherits_r2_l01_semantic_api: true
  wifi_credentials_source: manual_local_edit_in_sketch
  credentials_committed: false
  ota:
    implementation: ArduinoOTA
    hostname: ardu
    port: 8266
    password_required: true
    serial_logging_disabled: true
  compile_verified: false
  wired_upload_verified: true
  normal_boot_http_verified: true
  ota_discovery_verified: false
  ota_upload_verified: false
  future_default_esp_update_path: OTA_after_pass
  wired_programmer_after_pass: recovery_only
  next: compile_r3

esp8266_http_bridge_r4_ota_2026_09_30:
  code_path: "05_WiFi_и_приложение/esp8266_http_bridge_r4/esp8266_http_bridge_r4.ino"
  test_doc: "05_WiFi_и_приложение/ESP8266_HTTP_BRIDGE_R4_OTA_TEST.md"
  revision: 4
  supersedes: HTTP_BRIDGE_R3
  reason: pre_compile_wstring_flash_comparison_fix
  wifi_credentials_source: manual_local_edit_in_sketch
  ota:
    implementation: ArduinoOTA
    hostname: ardu
    port: 8266
    password_required: true
    serial_logging_disabled: true
  placeholder_check: strcmp
  reconnect_guard_when_unconfigured: true
  compile_verified: false
  wired_upload_verified: true
  normal_boot_http_verified: true
  ota_discovery_verified: true
  ota_network_port: "ardu 192.168.0.4"
  ota_upload_verified: false
  next: upload_http_bridge_r5_via_network_port

r4_ping_result_2026_09_30:
  status: passed
  ip: "192.168.0.4"
  firmware: HTTP_BRIDGE_R4
  wifi_connected: true
  rssi_dbm: -57
  ota_ready: true
  ota_hostname: ardu
  ota_port: 8266
  mdns_ardu_local_windows_curl: unresolved
  interpretation: direct_ip_transport_ok_mdns_resolution_issue_only
  next: ota_network_upload_proof


esp8266_http_bridge_r5_ota_proof_2026_09_30:
  status: ota_uploaded_and_booted
  code_path: "05_WiFi_и_приложение/esp8266_http_bridge_r5/esp8266_http_bridge_r5.ino"
  base: HTTP_BRIDGE_R4
  revision: 5
  purpose: first_real_ota_upload_proof
  functional_change: false
  observable_change:
    api_ping_fw: HTTP_BRIDGE_R5
  repository_credentials: placeholders_only
  local_credentials_required_before_upload: true
  target_network_port: "ardu 192.168.0.4"
  wiring_change_required: false
  compile_verified: true
  ota_authentication_verified: true
  ota_upload_verified: true
  reboot_verified: true
  api_ping_after_reboot_verified: true
  api_ping_firmware: HTTP_BRIDGE_R5
  wifi_after_reboot_verified: true
  ota_service_after_reboot_verified: true
  post_upload_checks:
    - GET_api_ping_fw_HTTP_BRIDGE_R5
    - GET_api_status
    - GET_api_time
    - Developer_PING_PONG
  post_upload_status_verified: true
  post_upload_status_fw: FW10_CORE
  post_upload_status_rev: 1
  post_upload_mode_observed: DAWN
  post_upload_rtc_valid: true
  post_upload_time_verified: true
  post_upload_time: "2026-09-30 22:18:58"
  post_upload_dev_ping_pong_verified: true
  post_upload_transport_regression: passed
  wired_programmer_role: recovery_only
  future_default_esp_update_path: OTA
  next: android_l01_semantic_on_off


r5_light_status_read_result_2026_09_30:
  status: passed
  endpoint: GET_api_light_status
  enabled: false
  color_mode: kelvin
  kelvin: 2700
  rgb: [255, 170, 87]
  brightness: 64
  saved: true
  dirty: false
  interpretation: current_top_level_mode_not_L01_profile_valid
  next: android_semantic_read_only_gate


esp8266_http_bridge_r6_l01_stage2_2026_09_30:
  status: ota_and_android_physical_pass
  code_path: "05_WiFi_и_приложение/esp8266_http_bridge_r6/esp8266_http_bridge_r6.ino"
  test_doc: "05_WiFi_и_приложение/ESP8266_HTTP_BRIDGE_R6_TEST.md"
  revision: 6
  base: HTTP_BRIDGE_R5
  keeps_ota: true
  semantic_settings:
    enabled: retained
    brightness_range: "0..255"
    kelvin_presets: [2700, 4000, 6000]
  nano_mapping:
    brightness: "LIGHT BRIGHT <0..255>"
    kelvin_preset: "LIGHT PRESET <2700|4000|6000>"
  arbitrary_kelvin: false
  rgb: false
  persistence_api: false
  compile_verified: true
  ota_upload_verified: true
  api_ping_firmware: HTTP_BRIDGE_R6
  android_brightness_verified: true
  android_kelvin_presets_verified: true
  direct_curl_json_smoke: failed_body_not_matched
  direct_curl_failure_interpretation: powershell_native_json_quoting_suspected
  physical_verified: true
  next: r7_complete_l01_profile

android_l01_stage2_2026_09_30:
  project_path: "05_WiFi_и_приложение/android_app_r1"
  app_version_name: "0.4-l01-bright-kelvin-r1"
  source_created: true
  requires_bridge: HTTP_BRIDGE_R6
  brightness_slider: true
  brightness_write_on_stop_tracking: true
  kelvin_preset_buttons: [2700, 4000, 6000]
  state_reread_after_write: true
  rgb_controls: false
  arbitrary_kelvin_slider: false
  persistence_controls: false
  build_verified: true
  physical_verified: true
  result: passed
  next: android_l01_stage3


esp8266_http_bridge_r7_l01_stage3_2026_09_30:
  status: physical_pass
  code_path: "05_WiFi_и_приложение/esp8266_http_bridge_r7/esp8266_http_bridge_r7.ino"
  test_doc: "05_WiFi_и_приложение/ESP8266_HTTP_BRIDGE_R7_TEST.md"
  revision: 7
  base: HTTP_BRIDGE_R6
  semantic_settings:
    enabled: retained
    brightness: retained
    kelvin_range: "1800..6500"
    rgb_channels: "0..255"
    persist_startup_profile: true
  nano_mapping:
    kelvin: "LIGHT KELVIN"
    rgb: "LIGHT RGB"
    persist: "LIGHT SAVE"
  compile_verified: true
  ota_upload_verified: true
  physical_verified: true
  arbitrary_kelvin_verified: true
  rgb_verified: true
  persistence_verified: true
  cold_power_cycle_restore_verified: true
  baseline_restored: "2700K_brightness64"
  result: passed
  next: clap_control_and_family_calibration

android_l01_stage3_2026_09_30:
  project_path: "05_WiFi_и_приложение/android_app_r1"
  app_version_name: "0.5-l01-profile-r1"
  source_created: true
  requires_bridge: HTTP_BRIDGE_R7
  arbitrary_kelvin_slider: true
  kelvin_range: "1800..6500"
  rgb_controls: true
  rgb_apply_button: true
  persistence_button: true
  saved_dirty_indicator: true
  persistence_only_on_explicit_save: true
  cold_power_cycle_test_required: true
  build_verified: true
  physical_verified: true
  result: passed
  next: clap_control_and_family_calibration


fw10_core_r2_clapcal_plan_2026_09_30:
  status: source_prepared
  base: FW10_CORE_R1
  purpose: integrate_app_ready_family_clap_calibration
  preserve:
    - l01
    - clap_runtime
    - rtc
    - alarm_dawn
    - night
    - eeprom_layout
  calibration_source: nano_clap_gyver_r3_cal
  calibration_pairs_range: "3..12"
  recommended_pairs: 9
  compile_budget_gate_required: true
  previous_core_r1_flash_bytes: 26014
  previous_core_r1_flash_total: 30720
  previous_core_r1_sram_globals: 1316
  previous_core_r1_sram_total: 2048
  upload_before_compile_budget_pass: false
  code_path: "04_Прошивка/nano_fw10_core_r2/nano_fw10_core_r2.ino"
  test_doc: "04_Прошивка/FW10_CORE_R2_CLAPCAL_TEST.md"
  revision: 2
  eeprom_layout_changed: false
  static_structure_check: passed
  compile_verified: true
  compile_flash_bytes: 29788
  compile_flash_total: 30720
  compile_flash_percent: 96
  compile_flash_free_bytes: 932
  compile_sram_globals_bytes: 1445
  compile_sram_total: 2048
  compile_sram_percent: 70
  compile_sram_free_bytes: 603
  compile_budget_result: fail_for_future_integration
  upload_allowed: false
  next: optimize_core_r2_then_reverify


fw10_core_r3_clapcal_plan_2026_09_30:
  status: compile_pass_hardware_test_allowed
  code_path: "04_Прошивка/nano_fw10_core_r3/nano_fw10_core_r3.ino"
  test_doc: "04_Прошивка/FW10_CORE_R3_CLAPCAL_TEST.md"
  revision: 3
  supersedes_for_test: FW10_CORE_R2
  r2_uploaded: false
  optimization:
    one_detector: true
    weak_strength_per_pair_only: true
    sample_top2_streaming: true
    quiet_histogram_bins: 32
    quiet_histogram_counter_bits: 8
    compact_uart_diagnostics: true
  eeprom_layout_changed: false
  static_structure_check: passed
  compile_verified: true
  compile_flash_bytes: 27822
  compile_flash_total: 30720
  compile_flash_percent: 90
  compile_flash_free_bytes: 2898
  compile_sram_globals_bytes: 1392
  compile_sram_total: 2048
  compile_sram_percent: 67
  compile_sram_free_bytes: 656
  compile_budget_result: accepted_for_clap_hardware_test_not_final_music_budget
  upload_allowed: true
  next: hardware_clapcal_batch

fw10_core_r3_upload_attempt_1_2026_09_30:
  compile_verified: true
  target: Arduino_Nano_ATmega328P_Old_Bootloader
  port: COM3
  avrdude_baud: 57600
  result: failed
  sync_response: "0x00"
  attempts: 10
  flash_write_verified: false
  current_nano_firmware_assumption: FW10_CORE_R1_unchanged
  likely_layer: bootloader_reset_or_com_port_access
  next: manual_nano_reset_during_upload_with_esp_held_reset


finalization_v1_2026_10_01:
  status: active
  canonical_plan: FINALIZATION_PLAN.md
  owner_decision: one_final_nano_and_one_final_esp_release_before_app_design_and_launch
  physical_nano_current: FW10_CORE_R1
  intermediate_core_r3_upload: cancelled
  physical_esp_line: HTTP_BRIDGE_R7_OTA_working
  next:
    - integrate_full_nano_v1_source
    - integrate_clapcal
    - integrate_ambient_f01_f02_f03
    - integrate_music_m01_m02_m03_m04_m05_m08_m09
    - adapt_all_renderers_to_44_led
    - enable_mirrored_d6_d7
    - finalize_persistence_and_settings
    - add_adjustable_safe_current_limit
    - freeze_uart_v1
    - optimize_flash_sram
    - verify_full_release
    - one_final_nano_upload
    - one_final_esp_ota_release
    - android_functional_completion
    - design_ux
    - second_ring_power_test
    - ceiling_install
    - final_acceptance
  firmware_freeze_after_acceptance: true
  firmware_revision_after_freeze_only_for_release_blocker: true


ceiling_topology_2026_10_01:
  status: confirmed_by_owner
  distance_between_housings_m: 2
  existing_feed:
    conductors: 2
    cross_section_mm2: 2.5
    same_wall_switch: true
    wall_wiring_accessible: false
  psu_location: near_ring_a_at_accessible_old_ceiling_light_point
  controller_location: near_ring_a_with_psu
  ring_a:
    data_pin: D6
    power: local
  ring_b:
    data_pin: D7
    route_length_m_approx: 2
    new_low_voltage_route: true
    required_conductors: [plus_5v, gnd, data_d7]
    data_reference_gnd_required: true
    preliminary_power_conductor_mm2: ">=1.5"
  mains_line_used_for_data: false
  open_safety_gate:
    - verify_exact_s30_5_input_terminal_marking
    - verify_pe_fg_requirement
    - verify_safe_enclosure_and_mains_termination


s30_5_pe_confirmation_2026_10_01:
  source: owner_photos
  case: metal
  terminals_confirmed: [L, N, PE, minus_v, plus_v]
  pe_terminal_present: true
  pe_currently_connected: false
  final_install_requires_pe: true
  neutral_must_not_be_used_as_pe: true
  if_pe_unavailable: replace_with_class_ii_double_insulated_5v_psu
  blocks_firmware_work: false
  blocks_final_mains_install_until_resolved: true


ceiling_pe_2026_10_01:
  pe_available: false
  owner_confirmed: true
  s30_5_final_install: prohibited
  s30_5_role: bench_only
  final_psu_required:
    class: class_ii_double_insulated
    output_v: 5
    pe_required: false
    power_selection: after_final_current_budget
  blocks_firmware: false


nano_ardu_v1_release_candidate_2026_10_01:
  status: ci_compile_pass
  path: "04_Прошивка/nano_ardu_v1/nano_ardu_v1.ino"
  scope_complete:
    - dual_ring_d6_d7_44_plus_44
    - l01
    - clap_runtime
    - family_clapcal
    - rtc
    - night_schedule
    - alarm_dawn_recovery
    - ambient_f01_f02_f03
    - music_m01_m02_m03_m04_m05_m08_m09
    - persistence
    - service_current_limit
  initial_build:
    flash_bytes: 43638
    flash_percent: 142
    globals_bytes: 1975
    globals_percent: 96
  compact_build:
    flash_bytes: 28090
    flash_total: 30720
    flash_percent: 91
    globals_bytes: 1070
    sram_total: 2048
    globals_percent: 52
    free_sram_bytes: 978
    ci: success
  physical_uploaded: false
  physical_nano_current: FW10_CORE_R1
  uart_v1: compact_numeric_frozen
  next: build_and_compile_final_esp_v1_before_release_upload_session


esp8266_ardu_v1_release_candidate_2026_10_01:
  status: ci_compile_pass
  path: "05_WiFi_и_приложение/esp8266_ardu_v1/esp8266_ardu_v1.ino"
  uart_contract: "06_Интерфейс_управления/UART_V1.md"
  static_opcode_scan_missing: 0
  endpoints_complete: true
  ota: true
  station_only: true
  compile:
    esp8266_core: "3.1.2"
    ram_bytes: 31988
    ram_total: 80192
    ram_percent: 39
    iram_bytes: 60823
    iram_total: 65536
    iram_percent: 92
    irom_code_bytes: 324376
  physical_uploaded: false
  current_physical_esp: HTTP_BRIDGE_R7
  next: final_release_upload_acceptance

nano_ardu_v1_persistence_refinement_2026_10_01:
  night_live_preview_opcodes: [51,52,53]
  night_save_opcode: 56
  dawn_live_preview_opcodes: [73,74,75,76]
  dawn_save_opcode: 77
  compile_flash_bytes: 28024
  compile_globals_bytes: 1070
  compile_pass: true


android_functional_v1_2026_10_02:
  version: "0.9-functional-v1-rc1"
  final_http_api: true
  sections:
    light: implemented
    music: implemented
    ambient: implemented
    night: implemented
    alarm_dawn: implemented
  clap_calibration_wizard: implemented
  rtc_sync: implemented
  events: implemented
  current_limit: implemented
  developer_numeric_uart: implemented
  saved_manual_address: implemented
  mock_esp_contract_tests: pass
  debug_apk_ci: pass
  physical_end_to_end: pending

nano_final_upload_blocker_2026_10_02:
  owner_reported_upload_failure: true
  replacement_nano_ordered: true
  old_board_root_cause: unknown
  firmware_source_change_required: false
  next_after_replacement: final_release_upload_acceptance


android_design_v1_2026_10_02:
  version: "0.10-design-v1-rc1"
  dark_low_glare_theme: true
  fixed_bottom_navigation:
    enabled: true
    sections: [light, music, ambient, night, alarm]
  settings_in_header: true
  cards_ui: true
  color_previews: true
  developer_mode_nested_in_settings: true
  horizontal_scroll_primary_navigation: false
  contract_tests: pass
  debug_apk_ci: pass
  physical_visual_smoke: pending
  physical_end_to_end: pending


android_home_ui_v0_11_2026_10_02:
  version: "0.11-home-ui-rc1"
  owner_feedback_source: "v0.10 physical-phone screenshot review"
  compact_header: true
  technical_status_moved_to_settings: true
  light_pilot:
    power_card: true
    quick_scenes: [evening_2200k, warm_2700k, day_4000k, cool_6000k]
    brightness_percent: true
    brightness_step_controls: true
    fine_brightness_slider: true
    touch_color_wheel: true
    precise_rgb_collapsed: true
  firmware_api_contract_changed: false
  contract_tests: pass
  debug_apk_ci: pass
  owner_visual_smoke: pending


android_smart_slider_v0_12_2026_10_02:
  version: "0.12-smart-slider-rc1"
  owner_feedback: "default Android sliders visually primitive"
  custom_slider:
    reusable: true
    third_party_dependency: false
    large_thumb: true
    rounded_track: true
    commit_on_release: true
  light:
    brightness_slider: smart_brightness
    kelvin_slider: warm_to_cool_gradient
    quick_scenes_preserved: true
    plus_minus_preserved: true
    color_wheel_preserved: true
  firmware_api_contract_changed: false
  contract_tests: pass
  debug_apk_ci: pass
  owner_visual_smoke: pending


android_smart_home_tabs_v0_13_2026_10_02:
  version: "0.13-smart-home-tabs-rc1"
  owner_light_style_approved: true
  tabs:
    light: smart_home
    music: smart_home
    ambient: smart_home
    night: smart_home
    alarm: smart_home
  smart_slider_modes:
    brightness: true
    kelvin: true
    hue: true
    accent_generic: true
  selected_state:
    music_modes: true
    music_submodes: true
    ambient_effects: true
  typography_sp:
    section: 24
    card: 16
    value: 15
    secondary: 13
  icon_compact_actions: true
  normal_user_stock_seekbars: 0
  technical_stock_seekbars:
    - precise_rgb_collapsed
    - current_limit_service
  static_layout:
    missing_ids: 0
    duplicate_ids: 0
  final_actions_run: 37056022090
  contract_tests: pass
  debug_apk_ci: pass
  firmware_api_contract_changed: false
  owner_cross_tab_visual_smoke: pending


android_final_ui_v0_14_2026_10_03:
  version: "0.14-ios-homehub-focus-rc1"
  owner_approved: true
  final_direction: "Home Hub + Focus Dial"
  palette: mint_dark
  light:
    overview: home_hub
    detail: focus_dial
    focus_dial_range: [0, 255]
    color_wheel_preserved: true
    precise_rgb_preserved: true
    clap_preserved: true
    startup_profile_preserved: true
  contextual_heroes:
    implementation: native_canvas
    external_bitmap_assets: false
    scenes: [living, music, ambient, night, dawn]
  other_tabs:
    music: contextual_home_hub
    ambient: contextual_home_hub
    night: contextual_home_hub
    alarm_dawn: contextual_home_hub
  new_http_endpoints: 0
  new_uart_opcodes: 0
  firmware_changed: false
  static_layout:
    missing_ids: 0
    duplicate_ids: 0
    duplicate_functions: 0
  final_actions_run: 37062432020
  contract_tests: pass
  debug_apk_ci: pass
  owner_phone_visual_smoke: pending


android_premium_light_v0_15_2026_10_03:
  version: "0.15-premium-light-rc1"
  final_direction_changed: false
  visual_reference_screen: light
  scene_tiles:
    native_canvas: true
    scenes: [evening, warm, day, cool]
    external_assets: false
  home_hub_hero:
    depth_pass: true
    vignette: true
    environmental_details: true
  focus_dial:
    sweep_gradient: true
    outer_glow: true
    radial_center_glow: true
    scale_ticks: true
    commit_on_release: true
  firmware_changed: false
  api_changed: false
  static_layout:
    missing_ids: 0
    duplicate_ids: 0
    duplicate_functions: 0
  actions_run: 37102197040
  contract_tests: pass
  debug_apk_ci: pass
  owner_phone_visual_smoke: pending


android_real_assets_light_v0_16_2026_10_03:
  version: "0.16-real-assets-light-rc1"
  owner_approved_asset_direction: true
  hero:
    type: photorealistic_generated_webp
    file: ardu_light_hero.webp
    dimensions: [640, 360]
    bytes: 12642
    header_over_image: true
    separate_light_status_rectangle: false
  scene_assets:
    evening: ardu_scene_evening.webp
    warm: ardu_scene_warm.webp
    day: ardu_scene_day.webp
    cool: ardu_scene_cool.webp
    total_asset_bytes_approx: 23868
  scene_tile_render:
    real_bitmap: true
    center_crop: true
    readability_gradient: true
  focus_dial_preserved: true
  firmware_changed: false
  api_changed: false
  static_layout:
    missing_ids: 0
    duplicate_ids: 0
    duplicate_functions: 0
  actions_run: 37105664138
  contract_tests: pass
  debug_apk_ci: pass
  owner_phone_visual_smoke: pending


android_light_layout_polish_v0_17_2026_10_03:
  version: "0.17-light-layout-polish-rc1"
  owner_feedback:
    hero_lamp_cropped: fixed
    unequal_summary_cards: fixed
  focal_crop:
    custom_native_view: true
    focus_x: 0.64
    focus_y: 0.50
    third_party_dependency: false
  summary_cards:
    equal_width: true
    height_dp: 108
    padding_dp: 16
    value_text_sp: 26
  final_actions_run: 37110520082
  contract_tests: pass
  debug_apk_ci: pass
  firmware_api_contract_changed: false


android_context_photo_heroes_v0_18_2026_10_03:
  version: "0.18-photo-heroes-rc1"
  owner_light_v0_17_visual_pass: true
  room_hero:
    renderer: real_photo_bitmap
    common_master: "drawable-nodpi/ardu_light_hero.webp"
    unique_context_assets: false
    contexts:
      music: {focus_x: 0.28, focus_y: 0.48, grade: indigo_teal}
      ambient: {focus_x: 0.52, focus_y: 0.50, grade: purple_cyan}
      night: {focus_x: 0.72, focus_y: 0.50, grade: navy_warm}
      alarm_dawn: {focus_x: 0.60, focus_y: 0.48, grade: sunrise_golden}
  firmware_api_contract_changed: false
  android_verify_run: 37111268646
  contract_tests: pass
  debug_apk_ci: pass
  owner_cross_tab_visual_smoke: pending
  next: owner_phone_visual_smoke_music_ambient_night_alarm


android_music_header_polish_v0_19_2026_10_03:
  version: "0.19-music-header-polish-rc1"
  owner_v0_18_feedback:
    contextual_photo_screens_otherwise_good: true
    music_two_line_labels_clipped: fixed
    global_status_outer_frame_unwanted: fixed
  music_mode_cards:
    width_dp: 100
    height_dp: 76
    max_lines: 2
    include_font_padding: false
    centered: true
  global_header:
    outer_card_background: false
    outer_stroke: false
    light_special_case_hero_overlay_unchanged: true
  firmware_api_contract_changed: false
  android_verify_run: 37112061533
  contract_tests: pass
  debug_apk_ci: pass
  owner_phone_visual_smoke: pending
  next: owner_check_music_labels_and_frameless_header


android_music_homehub_v0_20_2026_10_04:
  version: "0.20-music-homehub-rc1"
  music_hero:
    file: "drawable-nodpi/ardu_music_hero.webp"
    dedicated: true
    status_inside_hero: true
    fake_player: false
  music_controls:
    large_play_stop: false
    mode_card_direct_start: true
    labels_without_vu: true
    layout_rows: [4, 3]
    card_height_dp: 64
    horizontal_scroll: false
    stop_on_other_bottom_tab: true
    settings_does_not_stop_music: true
  smart_slider:
    global_edge_fix: true
    edge_inset: thumb_radius_plus_shadow_reserve
  bottom_navigation:
    icon_only: true
    native_vectors: true
    content_descriptions: true
  static_validation:
    missing_ids: 0
    duplicate_layout_ids: 0
    duplicate_private_functions: 0
  firmware_api_contract_changed: false
  android_verify_run: 37194558467
  contract_tests: pass
  debug_apk_ci: pass
  owner_phone_smoke: pending
  next: owner_phone_music_v0_20_smoke


android_music_visual_hotfix_v0_20_1_2026_10_04:
  version: "0.20.1-music-visual-hotfix-rc1"
  owner_v0_20_feedback:
    hero_over_zoomed: fixed
    mode_cards_lacked_visuals: fixed
    bottom_nav_not_centered_or_separated: fixed
  hero:
    foreground_scale: fit_center
    backdrop_scale: center_crop
    backdrop_alpha: 0.34
  music_mode_tiles:
    custom_view: MusicModeTileView
    height_dp: 104
    illustrated: true
    selected_mint_glow: true
  bottom_navigation:
    control_type: ImageButton
    separate_dock: true
    centered_icons: true
    visible_text_labels: false
  firmware_api_contract_changed: false
  android_verify_run: 37196929089
  contract_tests: pass
  debug_apk_ci: pass
  owner_phone_smoke: pending
  next: owner_phone_music_v0_20_1_visual_smoke


android_music_framing_icon_hotfix_v0_20_2_2026_10_04:
  version: "0.20.2-music-framing-icon-hotfix-rc1"
  owner_v0_20_1_feedback:
    hero_still_visually_zoomed: fixed
    frequency_too_similar_to_gradient: fixed
  hero:
    height_dp: 250
    foreground_scale: fit_center
    backdrop_photo_copy: false
    center_crop_music_photo: false
  music_mode_tiles:
    gradient_m01: smooth_multicolor_wave
    frequency_m05: radio_frequency_beacon_arcs
    frequency_distinct_from_gradient: true
  firmware_api_contract_changed: false
  android_verify_run: 37204187940
  contract_tests: pass
  debug_apk_ci: pass
  owner_phone_smoke: pending
  next: owner_phone_music_v0_20_2_visual_smoke


android_music_room_hero_v0_20_3_2026_10_04:
  version: "0.20.3-music-room-hero-rc1"
  version_code: 20
  owner_approved: true
  hero:
    file: "drawable-nodpi/ardu_music_hero.webp"
    size_px: [640, 360]
    composition:
      sofa_left: true
      compact_speaker_right: true
      plants_and_city_context: true
      lighting: blue_amber
    container_height_dp: 250
    scale_type: fit_center
    center_crop_layer: false
    right_edge_preserved: true
  firmware_api_contract_changed: false
  android_verify_run: 37209345952
  contract_tests: pass
  debug_apk_ci: pass
  owner_phone_smoke: pending
  next: owner_phone_music_v0_20_3_visual_smoke

android_ambient_homehub_v0_21_2026_10_04:
  version: "0.21-ambient-homehub-rc1"
  version_code: 21
  ambient_hero:
    home_hub: true
    height_dp: 250
    status_inside_hero: true
    global_header_hidden: true
    renderer: RoomHeroView
  ambient_effect_tiles:
    custom_view: AmbientEffectTileView
    illustrated: true
    effects: [F01, F02, F03]
    selected_mint_glow: true
  firmware_api_contract_changed: false
  static_validation:
    ambient_id_bindings_clean: true
    custom_view_present: true
  android_verify_status: not_observed_via_connector
  owner_phone_smoke: pending
  software_next: owner_phone_ambient_v0_21_visual_smoke
  hardware_next: final_esp_v1_ota_then_acceptance

physical_handoff_2026_10_04_current:
  replacement_nano_numeric_uart_ping: pass
  ping_command: "1"
  ping_response: "O 1"
  esp_v1_local_compile: pass
  next: final_esp_v1_ota

android_night_alarm_homehub_v0_22_2026_10_04:
  version: "0.22-night-alarm-homehub-rc1"
  version_code: 22
  owner_directive: remaining_pages_same_homehub_format
  night:
    hero_height_dp: 250
    status_inside_hero: true
    dynamic_summary: [enabled, brightness, schedule_or_manual]
    semantics_changed: false
  alarm:
    hero_height_dp: 250
    status_inside_hero: true
    dynamic_summary: [enabled, alarm_time, dawn_phase, rtc]
    large_time_editor: true
    semantics_changed: false
  global_header:
    hidden_on_all_normal_tabs: true
    settings_service_unchanged: true
  static_validation:
    total_layout_ids: 177
    duplicate_layout_ids: 0
    night_alarm_ids: 41
    missing_night_alarm_bindings: 0
    duplicate_private_functions: 0
  firmware_api_contract_changed: false
  android_verify_status: not_observed_via_connector
  owner_phone_smoke: pending

physical_handoff_2026_10_04_readonly_gate:
  final_esp_v1_ota: pass
  status_api: pass
  settings_api: pass
  time_api_valid: false
  nano_fw: ARDU_V1
  uart_protocol: 1
  current_blocker: ds3231_invalid_time
  next: sync_rtc_then_repeat_time_and_status

physical_wifi_android_gate_2026_10_04:
  esp_fw: ARDU_ESP_V1
  nano_fw: ARDU_V1
  ip: "192.168.0.4"
  uart_protocol: 1
  ping: pass
  status: pass
  settings: pass
  rtc: pass
  l01_off_on_repeat: pass
  final_mode: light
  light_kelvin: 4000
  light_brightness: 64
  clap_enabled: true
  current_limit_ma: 3000
  next: android_v0_22_real_device_connection

android_concept_parity_v0_23_2026_10_04:
  version: "0.23-concept-parity-rc1"
  version_code: 23
  real_android_device_connection: pass_owner_video
  rollback:
    branch: "archive/android-v0.22-homehub-2026-10-04"
    commit: "a9daf3839786414b264f32dfe0a680b68f8a7be3"
    manifest: "05_WiFi_и_приложение/ANDROID_V0_22_ARCHIVE.md"
  scope: android_visual_only
  changes:
    light_interactive_overview_sliders: true
    light_concept_scenes: true
    music_compact_real_modes: true
    ambient_distinct_media_wall_context: true
    ambient_progressive_disclosure: true
    night_distinct_bedroom_context: true
    night_primary_brightness_plus_minus: true
    alarm_distinct_dawn_bedroom_context: true
    alarm_primary_wake_color: true
    success_text_cleared: true
  unsupported_fake_features_added: false
  firmware_api_uart_changed: false
  static_validation:
    layout_ids: 187
    duplicate_ids: 0
    missing_bindings: 0
    duplicate_private_functions: 0
    kotlin_balance: clean
    xml_balance: clean
  android_verify_status: not_observed_via_connector
  next: owner_phone_real_device_v0_23_smoke

routerless_reserve_ready_2026_10_05:
  station_primary: true
  softap_fallback:
    implemented_in_source: true
    physical_pass: false
    ssid: "ARDU-DIRECT"
    ip: "192.168.4.1"
    password_local_only: true
    ota_over_softap: false
  android_direct_probe:
    implemented_in_source: true
    ip: "192.168.4.1"
    validates_device: true
    validates_uart_protocol: true
  backup_power:
    battery_installed_in_v1: false
    accessible_usb_c_pd_input_required_before_ceiling: true
    requested_pd: "15V_3A"
    path: "USB-C_PD -> HUSB238 -> fuse -> 15to5V_DC_DC -> NORMAL_BACKUP_selector -> common_5V_bus"
    external_battery_optional_later: true
  next_gate: "v0.23 phone smoke -> ESP compile/OTA -> ARDU-DIRECT physical smoke -> reserve hardware load test"

ring_profiles_v1_2026_10_05:
  implemented_in_source: true
  compile_pass: false
  physical_pass: false
  normal_default: both
  emergency_default: a
  selections: [both, a, b]
  mains_sense:
    pin: D8
    high: normal
    low: backup
    wiring: "MAIN_5V -> 1.5k -> D8; D8 -> 4.7k -> GND"
  uart:
    get: 121
    set: 122
  http: "/api/system/rings"
  android_settings: true
  source_switch:
    manual_switch: false
    candidate: "INV-051 SRD-05VDC-SL-C"
    load_test_required: true
  battery_required_for_v1: false

backup_branch_cancelled_2026_10_07:
  owner_approved: true
  decision: D-100
  battery_backup: cancelled
  ext_power_input: false
  husb238: not_in_bom
  reserve_dc_dc: not_in_bom
  source_selector_relay: not_in_bom
  mains_sense: false
  emergency_ring_profiles: false
  ring_profile_api: false
  nano_usb_c_role: service_only
  rings:
    ring_a: D6
    ring_b: D7
    behavior: mirrored
  ardu_direct:
    retained: true
    physical_pass: false
    ssid: "ARDU-DIRECT"
    ip: "192.168.4.1"
  next: "v0.23 phone smoke -> ARDU-DIRECT compile/physical smoke -> normal two-ring power acceptance"

android_visual_rollback_2026_10_07:
  owner_approved: true
  decision: D-101
  rejected:
    version: "0.23-concept-parity-rc1"
    reason: "owner: не пойдет"
  canonical:
    version: "0.22.1-homehub-restored-rc1"
    version_code: 24
    visual_source: "archive/android-v0.22-homehub-2026-10-04"
    exact_archive_visual_files: true
  retained_post_v0_22:
    ardu_direct_android_probe: true
    network_mode_status: true
  static_validation:
    layout_ids: 177
    duplicate_ids: 0
    missing_bindings: 0
    duplicate_private_functions: 0
  next: "restored_main_phone_smoke -> ARDU_DIRECT_physical_smoke -> two_ring_power_acceptance"

android_owner_polish_v0_22_2_2026_10_07:
  decision: D-102
  version: "0.22.2-homehub-owner-polish-rc1"
  version_code: 25
  visual_baseline: v0_22_homehub
  v0_23_rejected: true
  android:
    bottom_nav_labels: true
    settings_back: true
    settings_direct_wifi_help: true
    settings_reset_defaults: true
    light_overview_power: true
    light_distinct_scenes: [evening, cinema, guests, reading]
    actual_active_button_state: true
    tab_switch_activates_runtime_mode: true
    ambient_presets: [aurora, sunset, ocean, cosmos]
    dedicated_heroes: [ambient, night, alarm_dawn]
    layout_ids: 195
    duplicate_ids: 0
    missing_bindings: 0
  firmware_source:
    ambient_speed_monotonic: true
    reset_defaults_uart_opcode: 130
    reset_defaults_http: "/api/system/reset-defaults"
    physical_upload: pending
  next: emulator_visual_review_then_firmware_compile_upload_gate

android_generated_heroes_v0_22_4_2026_10_07:
  decision: D-103
  owner_approved: true
  version: "0.22.4-generated-heroes-rc1"
  version_code: 27
  hero_assets:
    ambient_blob: "22aae69892044ecf3e1a8ab01a3e450a40de3e70"
    night_blob: "8b0f4441efa75113eacec86b60298d15723693ba"
    alarm_blob: "ec59069783d9566861712bb0f418aed0c2004f41"
  render: full_wide_scene_with_subdued_fill
  v0_22_3_inset_scale_workaround: retired
  ambient_presets:
    current_four: provisional
    owner_requires_more_than_four: true
    behavior_design: pending_owner_discussion
    stable_ids_not_frozen: true
  next: emulator_hero_check_then_ambient_preset_behavior_design

ambient_preset_idea_d104_2026_10_08:
  status: idea_only_not_approved_for_implementation
  owner_decision: D-104
  target_manual_ambient_effect: F01
  future_ui_excludes: [F02, F03]
  current_firmware_retains_legacy_f02_f03: true
  source_changes_in_this_iteration: false
  proposed_scene_count: 12
  proposed_algorithm_families: [gradient_waves, flicker_fire, sparse_stars, breathing]
  proposed_controls: [brightness, dynamics]
  proposed_ids_frozen: false
  proposed_http_api_frozen: false
  proposed_uart_frozen: false
  proposed_eeprom_schema_frozen: false
  concept_doc: "04_Прошивка/AMBIENT_PRESETS_CONCEPT.md"
  android_version_unchanged: "0.22.5-ambient-hero-hotfix-rc1"
  next: "verify_ambient_hero_in_emulator; implementation_only_after_explicit_approval"

# 2026-10-08 handoff: planned Ambient presets (documentation only)
ambient_presets_plan_2026_10_08:
  doc: "04_Прошивка/AMBIENT_PRESETS_IMPLEMENTATION_PLAN.md"
  status: "documented_not_implemented"
  owner_approved_current_hero_images: true
  android_source: "0.22.5-ambient-hero-hotfix-rc1"
  future_manual_effect: "F01"
  future_ui_excludes_effects: ["F02", "F03"]
  old_wire_identifiers_retained: true
  scene_ids: "P01..P12_provisional_not_frozen"
  p12_rainbow: "undecided"
  next_gate: "G0_G1_catalog_scope_and_fresh_full_nano_esp_compile_flash_sram_eeprom"
  physical_upload_authorized: false
  preserve_finalization_plan_release_policy: true
  deployed_nano_esp_unchanged: true

# 2026-10-08: first Ambient presets source prototype with CI evidence
ambient_presets_lab_r1_2026_10_08:
  status: source_prototype_ci_pass_hardware_pending
  report: "04_Прошивка/AMBIENT_PRESETS_LAB_R1.md"
  renderer: "04_Прошивка/nano_ardu_v1/ambient_preset_probe.h"
  concepts: [P01_aurora, P04_cosmos, P05_fireplace]
  ids_frozen: false
  full_catalog_approved: false
  ci_run: "https://github.com/dronrome1245/ARDU/actions/runs/37807204353"
  nano_default_flash_bytes: 28690
  nano_lab_flash_bytes: 29312
  nano_flash_limit_bytes: 30720
  nano_target_95pct_flash_bytes: 29184
  nano_lab_over_target_bytes: 128
  nano_default_sram_globals_bytes: 1234
  nano_lab_sram_globals_bytes: 1234
  host_tests: pass
  nano_default_build: pass
  nano_lab_build: pass
  hardware_led_test: not_done
  stable_uart_api_eeprom_changes: false
  physical_upload_performed: false
  next: flash_reserve_and_stack_review_before_full_release_candidate

# 2026-10-08 complete full Nano Ambient preview RC1, hardware pending
ambient_preview_rc1_2026_10_08:
  status: compiled_ci_pass_waiting_for_owner_hardware_smoke
  source: "04_Прошивка/nano_ambient_preview_rc1/nano_ambient_preview_rc1.ino"
  header: "04_Прошивка/nano_ambient_preview_rc1/ambient_preset_probe.h"
  test_doc: "04_Прошивка/AMBIENT_PRESETS_PREVIEW_RC1_TEST.md"
  ci_run: "https://github.com/dronrome1245/ARDU/actions/runs/37809369365"
  hex_artifact: "https://github.com/dronrome1245/ARDU/actions/runs/37809369365/artifacts/11564965835"
  default_flash_bytes: 28690
  preview_flash_bytes: 29376
  preview_globals_sram_bytes: 1234
  free_flash_bytes: 1344
  free_sram_for_runtime_bytes: 814
  excess_over_95_percent_flash_target_bytes: 192
  full_sketch_compile_passed: true
  device_flashed: false
  visual_acceptance: pending
  new_uart_http_ids: false
  new_eeprom_layout: false
  preview_cycle: [P01_aurora, P04_cosmos, P05_fireplace, F01_legacy]
  next: owner_safe_nano_upload_and_ambient_f01_visual_smoke

# 2026-10-08: single-file Nano RC2 fixes Windows missing-header compile
ambient_preview_rc2_2026_10_08:
  status: one_file_source_ci_pass_pending_windows_verify_and_physical_test
  supersedes_preview: nano_ambient_preview_rc1
  observed_blocker: ambient_preset_probe_h_not_found_on_owner_windows
  root_cause_confirmed: false
  source: "04_Прошивка/nano_ambient_preview_rc2/nano_ambient_preview_rc2.ino"
  additional_local_header_required: false
  test_doc: "04_Прошивка/AMBIENT_PRESETS_PREVIEW_RC2_TEST.md"
  ci: "https://github.com/dronrome1245/ARDU/actions/runs/37814719230"
  ci_isolated_one_ino_compile: pass
  ci_host_tests: pass
  ci_integrity_check: pass
  flash_bytes: 29376
  sram_globals_bytes: 1234
  hex_artifact: "https://github.com/dronrome1245/ARDU/actions/runs/37814719230/artifacts/11567275089"
  physical_upload_done: false
  device_led_test_done: false
  api_uart_eeprom_unchanged: true
  next: open_rc2_single_ino_windows_arduino_verify_then_safe_upload

# Owner-approved full Ambient12 and ARDU-DIRECT v2 release-candidate handoff 2026-10-08
ambient12_direct_rc_2026_10_08:
  status: source_and_ci_pass_hardware_upload_pending
  decision: D-109
  owner_approved_catalogue: [P01, P02, P03, P04, P05, P06, P07, P08, P09, P10, P11, P12]
  manual_effect: F01
  retired_user_effects: [F02, F03]
  numeric_wire_ids_reused: false
  nano_sketch: "04_Прошивка/nano_ambient12_v1/nano_ambient12_v1.ino"
  nano_new_eeprom_base: 512
  nano_preset_storage_bytes: 29
  nano_flash_ci_bytes_latest: 29306
  nano_sram_globals_ci_bytes_latest: 1282
  esp_sketch: "05_WiFi_и_приложение/esp8266_ardu_v2/esp8266_ardu_v2.ino"
  esp_requires_private_credentials: true
  esp_direct_ssid: ARDU-DIRECT
  esp_direct_ip: "192.168.4.1"
  esp_ota_station_only: true
  android_version: "0.22.6-ambient12-functional-rc1"
  android_version_code: 29
  hardware_esp_v2_ota_uploaded: false
  hardware_nano_v2_usb_uploaded: false
  physical_direct_mode_verified: false
  physical_scene_visual_pass: false
  ci_nano: "https://github.com/dronrome1245/ARDU/actions/runs/37820974644"
  ci_esp: "https://github.com/dronrome1245/ARDU/actions/runs/37820404281"
  ci_android: "https://github.com/dronrome1245/ARDU/actions/runs/37819918951"
  test_guide: "ARDU_AMBIENT12_RELEASE_CANDIDATE.md"
  next: esp_v2_station_ota_then_full_nano_v2_then_android_then_direct_wifi_smoke

# D-110, 2026-10-08: self-contained ESP v2 R2 with manual credentials
esp_v2_r2_manual_config_2026_10_08:
  state: source_and_ci_pass_physical_upload_pending
  sketch: "05_WiFi_и_приложение/esp8266_ardu_v2/esp8266_ardu_v2.ino"
  external_wifi_secrets_h_required: false
  local_extra_project_headers_required: false
  fields: [ARDU_WIFI_SSID, ARDU_WIFI_PASSWORD, ARDU_OTA_PASSWORD, ARDU_SOFTAP_PASSWORD]
  config_flag_required: false
  placeholder_ota_build_rejected: true
  ci: "https://github.com/dronrome1245/ARDU/actions/runs/37823238584"
  ci_one_ino_build: pass
  ci_negative_default_credentials: pass
  secrets_in_git: false
  hardware_uploaded: false
  next: edit_four_local_strings_verify_then_station_ota
  handoff: "ARDU_AMBIENT12_RELEASE_CANDIDATE.md"

# 2026-10-08: hardware owner confirmation of ESP v2 OTA
esp_v2_r2_ota_physical_2026_10_08:
  verified: true
  installed_fw: ARDU_ESP_V2_AMBIENT12
  proof: owner_http_api_ping_response
  ip: "192.168.0.4"
  station_wifi_connected: true
  network_mode: station
  rssi_dbm: -57
  ota_service_ready: true
  ota_port: 8266
  ota_hostname: ardu
  softap_active_during_station: false
  ardu_direct_without_router_tested: false
  nano_uart_bridge_confirmed_after_esp_ota: false
  nano_v2_uploaded: false
  next: get_api_status_and_ambient_presets_before_nano_v2_upload

# 2026-10-08: all 12 owner-approved photo thumbnails integrated into Android
android_ambient12_images_2026_10_08:
  decision: D-111
  status: source_and_android_ci_pass_owner_visual_smoke_pending
  version_code: 30
  version_name: "0.22.7-ambient12-photo-tiles-rc1"
  scene_ids: [P01,P02,P03,P04,P05,P06,P07,P08,P09,P10,P11,P12]
  images: twelve_webp_at_192x192
  drawable_directory: "05_WiFi_и_приложение/android_app_r1/app/src/main/res/drawable-nodpi"
  asset_pattern: "ardu_preset_pXX.webp"
  display_grid_columns: 4
  display_grid_rows: 3
  images_owner_approved: true
  android_ci_run: "https://github.com/dronrome1245/ARDU/actions/runs/37838263956"
  ci_assets_check: pass
  ci_unit_tests: pass
  ci_apk_build: pass
  apk_artifact: "https://github.com/dronrome1245/ARDU/actions/runs/37838263956/artifacts/11576287564"
  android_on_device_photo_grid_checked: false
  nano_firmware_modified_for_images: false
  esp_firmware_modified_for_images: false
  next: git_pull_android_studio_run_owner_visual_smoke

# 2026-10-09: Android UX corrections after first twelve-photo phone walkthrough
android_ux_2026_10_09:
  decision: D-112
  version_code: 31
  version_name: "0.22.8-ux-readback-rc1"
  ci_run: "https://github.com/dronrome1245/ARDU/actions/runs/37930295301"
  owner_all_twelve_photo_tiles_rendered: true
  video_esp_connected: false
  video_led_strip_connected: false
  source_offline_command_guard: true
  source_unconfirmed_state_placeholder: true
  source_failed_write_readback: true
  source_scroll_reset_each_tab: true
  source_ambient_grid_first: true
  source_manual_f01_retained: true
  source_explicit_music_start_stop: true
  source_night_alarm_clap_readback: true
  current_limit_above_3000_requires_confirmation: true
  nano_esp_firmware_modified: false
  actual_phone_test_v0_22_8_pass: false
  next: owner_git_pull_run_test_offline_then_connected

# 2026-10-09: foreground heartbeat / optional service captions
android_v0_22_9_2026_10_09:
  version_code: 32
  version_name: "0.22.9-keepalive-diagnostics-rc1"
  decision: D-113
  current_phase: android_source_ci_pass_owner_phone_pending
  ci: "https://github.com/dronrome1245/ARDU/actions/runs/37958078703"
  foreground_ping_seconds: 5
  nano_status_checked_independently: true
  lifecycle_on_stop_cancels_poll: true
  auto_recovers_snapshot_after_reconnect: true
  optional_work_messages_in_settings: true
  work_messages_visible_by_default: false
  errors_connection_badge_remain_visible: true
  music_start_text_contrast_fixed: true
  uploaded_videos_identical: true
  owner_video_esp_fw: ARDU_ESP_V2_AMBIENT12
  owner_video_nano_fw: ARDU_V2
  owner_video_12_presets_present: true
  reported_configured_current_limit_ma: 4500
  measured_current_ma: null
  led_animation_physically_reviewed: false
  nano_dynamics_speed_three_steps_source_fact: true
  nano_dynamics_continuous_fix_done: false
  hardware_firmware_modified: false
  next: owner_pull_run_foreground_power_cycle_then_separate_nano_speed_candidate

# 2026-10-09: owner confirms Android 0.22.9 live connectivity states
android_0229_owner_phone_gate_2026_10_09:
  app_version: "0.22.9-keepalive-diagnostics-rc1"
  auto_online_offline_owner_reported_pass: true
  owner_video: "18429670918804.mp4"
  video_duration_approx_seconds: 63
  video_includes_disconnection_moment: false
  disconnection_latency_measured: false
  video_light_music_ui_seen: true
  music_start_text_visible: true
  service_message_toggle_owner_verified: false
  led_effects_physically_reviewed_from_video: false
  firmware_modified_for_video: false
  next: nano_continuous_dynamics_source_compile_gate

# 2026-10-09 — Nano Ambient12 R2 source clock fix and compile/host gates
nano_ambient12_speed_r2_2026_10_09:
  decision: D-114
  full_source: "04_Прошивка/nano_ambient12_v2/nano_ambient12_v2.ino"
  original_full_source_preserved: "04_Прошивка/nano_ambient12_v1/nano_ambient12_v1.ino"
  new_boot_marker: "ARDU1 3"
  uart_protocol_changed: false
  eeprom_layout_changed: false
  number_of_leds_per_ring: 44
  ring_channels: [D6,D7]
  new_scene_animation_phase_globals_bytes: 4
  dynamics_monotonic_steps: 256
  dynamics_rate_q16_per_ms_min: 512
  dynamics_rate_q16_per_ms_max: 2042
  breathing_cycle_s_low_approx: 16.4
  breathing_cycle_s_high_approx: 4.1
  ci: "https://github.com/dronrome1245/ARDU/actions/runs/37966945125"
  ci_outcome: pass
  ci_exact_renderer_host_tests: pass
  old_full_flash_bytes: 29306
  old_globals_sram_bytes: 1282
  new_full_flash_bytes: 29336
  new_globals_sram_bytes: 1286
  compiled_flash_limit_bytes: 30720
  globals_sram_limit_bytes: 2048
  flash_soft_95_percent_target_exceeded_bytes: 152
  runtime_stack_worst_case_measured: false
  physical_upload_owner_confirmed: false
  physical_led_motion_pass: false
  current_limit_for_gate_ma: 3000
  rollback_on_failure: "04_Прошивка/nano_ambient12_v1/nano_ambient12_v1.ino"
  next: "one_44_led_nano_r2_upload_and_velocity_visual_gate"

# 2026-10-09: owner-approved breathing visual feel; slightly slower P11 minimum in Nano R3
nano_p11_r3_2026_10_09:
  decision: D-115
  user_feedback_p11_r2_visual_positive: true
  physical_period_seconds_r2_measured: false
  full_source: "04_Прошивка/nano_ambient12_v3/nano_ambient12_v3.ino"
  previous_r2_rollback: "04_Прошивка/nano_ambient12_v2/nano_ambient12_v2.ino"
  boot_marker: "ARDU1 4"
  P11_cycle_at_0_seconds_approx: 20.2
  P11_cycle_at_128_seconds_approx: 6.8
  P11_cycle_at_255_seconds_approx: 4.1
  other_11_preset_clocks_changed: false
  all_12_preset_pixel_renderers_changed: false
  eeprom_and_uart_changed: false
  esp_and_android_changed: false
  cli_ci: "https://github.com/dronrome1245/ARDU/actions/runs/37971273171"
  ci_outcome: pass
  ci_flash_bytes: 29376
  ci_globals_sram_bytes: 1286
  physical_upload_r3_confirmed: false
  hardware_runtime_stack_pass: false
  next: "one_44_led_p11_low_speed_visual_gate"

# 2026-10-09: all 12 P-scenes visibly animated in full Nano R4 source
nano_ambient12_r4_all_scenes_2026_10_09:
  decision: D-116
  owner_request: "сделай все сразу. сейчас работает только дыхание"
  full_firmware_path: "04_Прошивка/nano_ambient12_v4/nano_ambient12_v4.ino"
  previous_full_firmware_rollback: "04_Прошивка/nano_ambient12_v3/nano_ambient12_v3.ino"
  boot_serial_marker: "ARDU1 5"
  phase_bug_r3: "most effect renderers used t >> 2 and low contrast"
  visible_pixel_motion_host_verified_scenes: 12
  dynamics_endpoints_tested: [0,255]
  p11_r3_pixel_formula_preserved: true
  p11_r3_q16_clock_preserved: true
  other_mode_uart_eeprom_api_changed: false
  android_esp_changed: false
  ci: "https://github.com/dronrome1245/ARDU/actions/runs/37975908088"
  ci_result: pass
  compile_fqbn: "arduino:avr:nano:cpu=atmega328old"
  flash_bytes: 29410
  flash_limit_bytes: 30720
  global_sram_bytes: 1286
  global_sram_limit_bytes: 2048
  flash_remaining_bytes: 1310
  non_globals_sram_headroom_bytes: 762
  physical_owner_nano_r4_uploaded: false
  physical_owner_all_scenes_visual_pass: false
  full_two_ring_power_pass: false
  runtime_stack_worst_case_measured: false
  next: "owner_safe_r4_upload_then_all_12_p_scene_one_ring_visual_smoke"

# 2026-10-09: owner confirms movement of all 12 presets on actual lamp
nano_r4_owner_motion_gate_2026_10_09:
  owner_statement: "все задвигалось это хорошо"
  motion_present_on_real_hardware_by_owner_report: true
  all_p01_to_p12_motion_gate: owner_pass
  recorded_boot_revision_ardu1_5: false
  per_scene_palette_quality_final_pass: false
  individually_saved_scene_brightness_dynamics_power_cycle_verified: false
  both_44_led_rings_power_pass: false
  measured_voltage_current_heat_and_stack: false
  android_0229_auto_online_offline_owner_pass: true
  next_software_gate: android_http_write_readback_separation_and_clap_wizard_finish
  next_hardware_gate: mode_regression_then_direct_wifi_then_two_rings_power_class_ii
  ci_main_r4: "https://github.com/dronrome1245/ARDU/actions/runs/37976579921"

# 2026-10-09: Android 0.22.10 native launcher icon, HTTP and CLAPCAL fixes
android_02210_launcher_readback_clap_2026_10_09:
  decision: D-117
  application_id: "com.ardu.app"
  version_code: 33
  version_name: "0.22.10-launcher-readback-clap-rc1"
  launcher_icon_standard: "@mipmap/ic_launcher"
  launcher_icon_round: "@mipmap/ic_launcher_round"
  launcher_icon_monochrome: "@drawable/ardu_launcher_monochrome"
  approved_home_hub_focus_dial_design_preserved: true
  broken_get_once_retry: true
  never_retry_post_on_transport_error: true
  post_ack_separate_from_get_readback: true
  clap_wizard_closes_after_save_acknowledgment: true
  clap_wizard_saved_dismissal_survives_app_restart: true
  firmware_or_protocol_changed: false
  ci: "https://github.com/dronrome1245/ARDU/actions/runs/37981648045"
  ci_outcome: pass
  android_debug_apk_artifact: "ardu-android-02210-launcher-debug-apk"
  owner_phone_visual_and_functional_pass: false
  next: "owner_git_pull_android_studio_run_verify_launcher_clap_music"

# 2026-10-10 — video-driven Android v0.22.11 four UX fixes
android_02211_ambient_music_scenes_2026_10_10:
  decision: D-118
  owner_video: "18437905058452.mp4"
  owner_video_duration_s_approx: 368.98
  android_version_code: 34
  android_version_name: "0.22.11-presets-submodes-scene-contrast-rc1"
  ambient_only_12_preset_tiles_visible: true
  ambient_legacy_F01_hidden_not_deleted_from_api: true
  ambient_legacy_manual_auto_ui_hidden: true
  ambient_on_off_buttons_visible: true
  music_submode_four_equal_width_buttons: true
  music_submode_above_effect_sliders: true
  music_submode_selected_strong_mint_fill: true
  music_background_color_independently_adjustable: false
  music_background_brightness_existing_api: true
  music_M09_unused_bg_slider_hidden: true
  evening_kelvin: 2700
  evening_brightness: 115
  cinema_kelvin: 1800
  cinema_brightness: 18
  guests_reading_unchanged: true
  nano_esp_firmware_changed: false
  ci: "https://github.com/dronrome1245/ARDU/actions/runs/38035137524"
  ci_result: pass
  ci_debug_apk: "ardu-android-02211-presets-music-scenes-debug-apk"
  physical_phone_test_completed: false
  next: "owner_git_pull_run_02211_verify_four_changes"

# 2026-10-17 D-126: ESP V4 remote Nano programming source/CI ready; physical reset-stage + first remote write/verify pending.

# Canonical project state is STATUS.md; legacy structured handoff snapshot.
handoff_2026_11_14:
  decision: "D-128 family-friendly UX"
  android_source: "0.22.16-family-schedule-rc1"
  android_ci: "PASS 43593418689"
  nano_candidate: "nano_warm_dawn_v7"
  nano_boot: "ARDU1 8"
  nano_compile_ci: "PASS 43595155594"
  nano_flash_bytes: 30712
  nano_flash_limit_bytes: 30720
  esp_candidate: "esp8266_family_v5"
  esp_compile_ci: "PASS 43595155594"
  hardware_r7_installed: false
  next_test: "04_Прошивка/FAMILY_R7_ACCEPTANCE.md"
  hardware_power_44x2_gate_pass: false
  class_ii_ceiling_psu_confirmed: false
  primary_truth: "STATUS.md"
