dronrome1245/ARDU/(commit log)

2026-09-05 Add artifact registry
    [РЕЕСТР_АРТЕФАКТОВ.csv]
2026-09-05 Add canonical components BOM
2026-09-05 Refine BOM after second hardware inventory batch
2026-09-06 Mark inventory complete and identify remaining BOM checks
2026-09-06 Спроектировать питание двух синхронных светильников
2026-09-06 Зафиксировать архитектуру двух светильников и Wi-Fi
2026-09-06 Обновить статус после проектирования двух корпусов
2026-09-06 Зафиксировать решения по двум светильникам
2026-09-06 Добавить источники по ESP8266, RTC и WS2812B
2026-09-06 Уточнить BOM для двух колец WS2812B
2026-09-06 Снять разрешенные коллизии и оставить физические вопросы
2026-09-06 Обновить архитектуру на два синхронных кольца
2026-09-06 Синхронизировать handoff по двум светильникам
2026-09-06 Синхронизировать следующий шаг после решений
2026-09-06 Обновить machine-readable состояние проекта
2026-09-06 Confirm 5m LED strip and App Inventor source
2026-09-06 Record LED stock and App Inventor baseline
2026-09-06 Record LED stock and App Inventor source
2026-09-06 Add staged firmware implementation plan
2026-09-13 Record YP-8 no-load voltage measurement
2026-09-13 Record S-30-5 5.01 V measurement
2026-09-13 Record S-30-5 5.01 V measurement source
2026-09-13 Record YP-8 voltage with ESP8266 connected
2026-09-13 Record ESP8266 load voltage on YP-8
2026-09-13 Record YP-8 voltage with ESP8266 load
2026-09-17 Add explicit wiring explanation rule
2026-09-18 Mark ESP8266 power as unstable pending diagnosis
2026-09-19 Record Nano USB-UART loopback test
2026-09-19 Record Nano USB-UART loopback measurement
2026-09-19 Record ESP power-drop localization
2026-09-19 Record ESP power measurements
2026-09-19 Record S-30-5 loaded voltage
2026-09-20 Refine ESP power-drop diagnosis
2026-09-20 Record ground-referenced power measurements
2026-09-20 Record ground-path voltage drop
2026-09-20 Record ground-path measurement
2026-09-20 Record stable ESP power after rewiring
2026-09-20 Record post-rewire power measurements
2026-09-20 Record Nano-to-ESP voltage measurements
2026-09-20 Account for Nano onboard UART resistor
2026-09-20 Record Nano onboard UART resistor correction
2026-09-20 Add Arduino Nano UART resistor source
2026-09-20 Separate runtime and programmer UART dividers
2026-09-20 Separate runtime and programmer UART level shifting
2026-09-20 Account for Nano programmer UART resistor
2026-09-20 Correct Nano programmer UART resistor assumption
2026-09-20 Record Nano UART photo inspection
2026-09-20 Record Nano UART component markings
2026-09-20 Use measured Nano programmer UART path
2026-09-20 Correct Nano programmer resistor status
2026-09-20 Record direct-UART upload result
2026-09-20 Record direct-UART upload evidence
2026-09-20 Record diagnostic-only direct UART decision
2026-09-20 Update Nano USB-UART flashing status
2026-09-20 Align FW-1 wiring with AlexGyver WS2812 guidance
2026-09-20 Record AlexGyver FW-1 wiring alignment
2026-09-20 Add official AlexGyver WS2812 wiring sources
2026-09-20 Update FW-1 wiring to AlexGyver scheme
2026-09-20 Confirm 1000uF 6.3V strip capacitor
2026-09-20 Record 1000uF 6.3V capacitor
2026-09-20 Record 1000uF capacitor marking
2026-09-20 Confirm WS2812 power capacitor
2026-09-20 Confirm 1000uF 6.3V inventory capacitor
2026-09-20 Advance FW-1 to data resistor check
2026-09-20 Confirm 220 ohm WS2812 data resistor
2026-09-20 Record FW-1 220 ohm resistor
2026-09-20 Record 220 ohm data resistor availability
2026-09-20 Add 220 ohm resistor to inventory
2026-09-20 Advance FW-1 to single-ring assembly
2026-09-20 Close single-ring F01 and start MAX9814 stage
2026-09-20 Record F01 completion and MAX9814 stage
2026-09-20 Switch microphone test to 1-second capture
2026-09-20 Record abnormal MAX9814 gain-to-GND result
2026-09-20 Record MAX9814 gain wiring anomaly
2026-09-20 Revert MAX9814 to last known-good wiring
2026-09-20 Require Gain pin verification before retry
2026-09-20 Record concrete MAX9814 pin order
2026-09-20 Clarify exact MAX9814 Gain-to-GND connection
2026-09-20 Set M01 calibration and music test
2026-09-20 Advance current focus to FHT diagnostic
2026-09-20 Add physical M01 calibration data
2026-09-20 Set FHT compile and calibration as next step
2026-09-20 Switch FHT diagnostic to AvrFHT
2026-09-20 Fix AvrFHT DC calibration at default ADC speed
    [nano_fht_test.ino]
2026-09-20 Record and fix invalid AvrFHT DC calibration
2026-09-20 Record AvrFHT DC calibration bug
2026-09-20 Retest AvrFHT with direct ADC check
2026-09-20 Record AvrFHT first-run bug and fix
    [03_СОСТОЯНИЕ_ПРОЕКТА.yaml]
2026-09-20 Use ADC as branch diagnostic
2026-09-21 Reload current FHT test before diagnostics
2026-09-21 Record direct ADC zero on current FHT sketch
2026-09-21 Add direct ADC bench result
2026-09-21 Record direct ADC fault branch
2026-09-21 Localize ADC fault after MAX9814 output
2026-09-21 Record MAX9814 direct voltage measurements
2026-09-21 Add MAX9814 direct voltage measurements
2026-09-21 Measure voltage directly at Nano A0
2026-09-21 Record Out-to-A0 voltage drop
2026-09-21 Record analog path voltage drop
2026-09-21 Add Nano A0 direct voltage measurement
2026-09-21 Record analog signal wire repair
2026-09-21 Add restored A0 voltage measurement
2026-09-21 Retest ADC after signal wire repair
2026-09-21 Record valid FHT response after wire repair
2026-09-21 Make FHT noise calibration robust to spikes
    [nano_fht_test.ino]
2026-09-21 Record FHT gate issue and P90 calibration
2026-09-21 Record robust FHT calibration change
2026-09-21 Add FHT gate measurements and calibration rationale
2026-09-21 Document P90 FHT calibration
2026-09-21 Retest FHT with P90 calibration
2026-09-21 Record FHT gate fix
    [03_СОСТОЯНИЕ_ПРОЕКТА.yaml]
2026-09-21 Fix legacy FHT SCALE conflict with FastLED
    [nano_fht_test.ino]
2026-09-21 Restore ColorMusic max-plus-3 calibration and settle delay
2026-09-21 Correct DC390 interpretation after A0 wire detachment
2026-09-21 Correct previous DC390 validity
    [03_СОСТОЯНИЕ_ПРОЕКТА.yaml]
2026-09-21 Record valid original FHT calibration
2026-09-21 Add valid original FHT calibration measurements
2026-09-21 Document A2 A3 capacitor relationship
2026-09-21 Document ColorMusic v2.10 A2 A3 microphone wiring
2026-09-21 Define A2 A3 bench wiring for ColorMusic v2.10
2026-09-21 Update BOM for ColorMusic v2.10 audio input
2026-09-21 Add A2 A3 regression stage
2026-09-21 Set A2 A3 compile and wiring step
2026-09-22 Correct A2 A3 wiring to official ColorMusic scheme
2026-09-22 Correct A2 A3 wiring decision
2026-09-22 Record official ColorMusic microphone schematic
2026-09-22 Remove A2 pulldown from BOM
2026-09-22 Unassign 4k7 resistors from audio path
2026-09-22 Correct A2 A3 hardware stage
2026-09-22 Set corrected A2 A3 wiring step
2026-09-22 Clarify official A2 A3 wiring and C1 polarity
2026-09-22 Record visual verification of A2 A3 schematic
2026-09-22 Add owner-provided official schematic verification
2026-09-22 Add A2 A3 ADC hardware evidence
2026-09-22 Log A3 spectrum calibration
2026-09-22 Switch A3 diagnosis to raw spectrum
2026-09-22 Localize A2 A3 tone loss with ADC
2026-09-22 Record A2 A3 ADC response to 2 kHz
2026-09-22 Add ADC tone propagation evidence
2026-09-22 Add fast ADC and zero-mean FHT diagnostics
2026-09-22 Advance A3 diagnosis to fast ADC and zero mean FHT
2026-09-22 Record fast ADC saturation and AlexGyver AREF guidance
2026-09-22 Advance audio diagnosis to silence fast ADC
2026-09-22 Add fast A2 and A3 charge trace diagnostics
2026-09-22 Record fast ADC floating A3 hypothesis
2026-09-22 Log A3 charge-up diagnostic
2026-09-22 Add ADC impedance and ColorMusic community evidence
2026-09-22 Add A2 fast and A3 trace diagnostic step
2026-09-22 Record dual-input fast ADC saturation
2026-09-22 Add MAX4466 comparative wiring
2026-09-22 Record low MAX4466 ADC baseline and direct-output check
2026-09-22 Pause MAX4466 FHT for direct voltage check
2026-09-22 Add isolated MAX4466 voltage test
2026-09-22 Record direct MAX4466 A2 ADC result
2026-09-22 Log stable direct MAX4466 ADC
2026-09-22 Add direct A2 voltage cross-check
2026-09-22 Advance MAX4466 to physical A2 voltage check
2026-09-22 Add minimal A2 ADC sanity test
2026-09-22 Record A2 voltage versus ADC mismatch
2026-09-22 Log minimal ADC sanity pivot
2026-09-22 Add A2 2.55V ADC mismatch evidence
2026-09-22 Insert minimal ADC sanity checkpoint
2026-09-22 Set MAX9814 A0 single-input as current path
2026-09-22 Update BOM for single-input MAX9814
2026-09-23 Log restored single-input spectrum calibration
2026-09-24 Gate D-040 8 kHz on ADC amplitude
2026-09-24 Add current M03 handoff
2026-09-24 Switch next step to isolated strip test
2026-09-25 Record strip test result after common ground
2026-09-25 Record M03 ADC recovery with common ground
2026-09-25 Record recovered M03 ADC baseline
2026-09-25 Record valid M03 CALF after ground fix
2026-09-25 Set M04 as current hardware test
2026-09-25 Record M04 quiet ADC baseline
2026-09-25 Record M04 ADC baseline
2026-09-25 Record M04 ADC measurement
2026-09-25 Record M04 calibration and quiet gate
2026-09-25 Set M05 as current hardware test
2026-09-25 Fix M05 Arduino LOW HIGH macro collision
2026-09-25 Identify stale M05 sketch in Arduino IDE
2026-09-25 Record stale Arduino M05 compile copy
2026-09-25 Add versioned M05 R2 after compile fix
    [nano_m05_r2.ino]
2026-09-25 Set M05 R2 as only current test target
2026-09-25 Track M05 R2 and firmware revision policy
2026-09-25 Advance M05 R2 to ADC calibration
2026-09-25 Record invalid M05 R2 ADC and diagnostic plan
2026-09-25 Record M05 R2 ADC dropout
2026-09-25 Record M05 Out A0 voltage localization
2026-09-26 Record recovered M05 R2 ADC and batch test
2026-09-26 Record recovered M05 R2 ADC baseline
2026-09-26 Add M05 R3 with invalid DC calibration guard
2026-09-26 Reject invalid M05 calibration DC
2026-09-26 Advance M05 to R3 calibration guard
2026-09-26 Set M05 R3 as current test
2026-09-26 Track M05 R3 invalid DC guard
2026-09-26 Document FastLED UART collision hypothesis
2026-09-26 Record UART FastLED timing observation
2026-09-26 Add FastLED AVR UART timing source
2026-09-26 Add M05 R4 FastLED UART coexistence experiment
2026-09-26 Prepare M05 R4 FastLED UART coexistence test
2026-09-26 Record M05 visual pass and R4 UART experiment
2026-09-26 Document FastLED AVR interrupt configuration
2026-09-26 Gate M08 on M05 R4 UART test
2026-09-26 Handoff M05 R4 UART test
2026-09-26 Set M05 R4 UART stress test
2026-09-26 Track M05 R4 UART experiment
2026-09-26 Clarify inherited UART fix in M08 R1
    [nano_m08_r1.ino]
2026-09-26 Carry UART fix and define M08 odd-ring geometry
2026-09-26 Track M08 R1 implementation
2026-09-26 Track M09 R1 implementation
2026-09-26 Track F02 R1 after FW6 completion
2026-09-26 Track F03 R1 after F02 pass
2026-09-26 Track AMBIENT R1 integration
2026-09-26 Document AMBIENT R1 test UART commands
2026-09-26 Add DS3231 RTC hardware test wiring
2026-09-26 Track RTC R1 and DS3231 safety gate
2026-09-26 Mark DS3231 resistor removal as pending gate
2026-09-26 Track RTC pass and ALARM R1
2026-09-26 Document ALARM R1 test UART
2026-09-26 Track DAWN R1
2026-09-26 Document DAWN R1 test UART
2026-09-26 Add DAWN R2 RTC-based reset recovery
    [nano_dawn_r2.ino]
2026-09-26 Track DAWN R2 recovery
2026-09-26 Track NIGHT R1 after FW8 completion
2026-09-26 Document NIGHT R1 test UART
2026-09-26 Track NIGHT R2 schedule
2026-09-26 Document NIGHT R2 schedule UART
2026-09-27 Track M02 R1 next step
2026-09-27 Define ordinary light and clap switch requirements
2026-09-27 Document future L01 and RTC UART requirements
2026-09-27 Insert L01 clap test before full firmware
2026-09-27 Track L01 clap and RTC app clock
2026-09-27 Align power decision with L01 ordinary light
2026-09-27 Require L01 load test in BOM
2026-09-27 Track M02 R1 upload pass
2026-09-27 Set M02 runtime ADC gate
2026-09-27 Record M02 R1 ADC gate pass
2026-09-27 Advance M02 R1 to calibration and visual test
2026-09-27 Track M02 background threshold and settings persistence
2026-09-27 Close M02 and track M06 R1
2026-09-27 Set L01 as current next step
2026-09-27 Retire M06 and track L01 R1
2026-09-27 Document L01 R2 test UART
2026-09-27 Track L01 R2 plan
2026-09-27 Add L01 R3 warm 2700K and 44 LED geometry
2026-09-27 Add L01 R3 warm 2700K and 44 LED test
2026-09-27 Record 44 LED geometry and warmer 2700K mapping
2026-09-27 Advance status to 44 LED L01 R3
2026-09-27 Record L01 R2 pass and 44 LED change
2026-09-27 Update BOM to 44 LED per ring
2026-09-27 Record physical 44 LED ring geometry
2026-09-27 Add 44 LED migration gate
2026-09-27 Set L01 R3 44 LED as next step
2026-09-27 Track 44 LED geometry and L01 R3
2026-09-27 Smooth warm Kelvin curve around calibrated 2700K
2026-09-27 Refresh AI handoff for 44 LED L01 R3
2026-09-27 Record owner 44 LED and 2700K calibration source
2026-09-27 Keep historical 43 LED test sketches unchanged
2026-09-27 Close L01 R3 and track clap diagnostic
2026-09-27 Track clap R1 limitation and R2 raw capture
2026-09-27 Record clap R2 calibration failure
2026-09-27 Track clap R2 calibration observation
2026-09-27 Track clap diagnostic R3
2026-09-27 Switch clap work to GyverLamp2 algorithm
2026-09-27 Track GyverLamp2-style clap diagnostic
2026-09-27 Track Gyver clap R2 plan
2026-09-27 Track Gyver R2 threshold tuning
2026-09-27 Track threshold 80 clap result
2026-09-27 Add family clap calibration R3
2026-09-27 Add family clap calibration test
2026-09-27 Require app-driven family clap calibration
2026-09-27 Advance to family clap calibration
2026-09-27 Record family clap calibration
2026-09-27 Add app clap calibration requirements
2026-09-27 Persist clap calibration settings
2026-09-27 Add clap calibration wizard to app screens
2026-09-27 Add clap calibration app flow
2026-09-27 Add clap calibration API
2026-09-27 Document clap calibration UART
2026-09-27 Set family clap calibration as next step
2026-09-27 Track family clap calibration
2026-09-27 Align FW10 clap EEPROM with calibration format
2026-09-27 Guard clap detector across commands and mode switches
2026-09-27 Create FW10 core R1 integration stage
2026-09-27 Add staged FW10 integration order
2026-09-27 Track FW10 core R1
2026-09-27 Fix Arduino auto-prototype struct ordering in FW10 core R1
    [nano_fw10_core_r1.ino]
2026-09-27 Record FW10 Arduino prototype ordering fix
2026-09-27 Track FW10 first compile fix
    [03_СОСТОЯНИЕ_ПРОЕКТА.yaml]
2026-09-27 Track FW10 RTC gate pass
2026-09-27 Record FW10 L01 clap reset power pass
2026-09-27 Track FW10 L01 integrated pass
2026-09-27 Track FW10 Night integrated pass
2026-09-27 Add ESP8266 HTTP UART bridge R1
2026-09-27 Track ESP HTTP bridge and app-first regression
2026-09-27 Track ESP bridge compile result
2026-09-27 Record ESP pre-upload voltage gate
2026-09-27 Record ESP voltage gate
2026-09-27 Track ESP WiFi smoke pass
2026-09-28 Add canonical compact FW10 ESP working wiring
2026-09-29 Record working Nano to ESP UART divider verification
2026-09-29 Record UART divider voltage verification
2026-09-29 Record end-to-end ESP Nano UART transport pass
2026-09-29 Flush Nano UART framing after ESP boot
2026-09-29 Document ESP boot UART framing fix
2026-09-29 Close ESP UART RTC transport gate
2026-09-29 Advance current project step to Android app R1
2026-09-30 Supersede ESP R3 with OTA-ready R4 compile fix
    [03_СОСТОЯНИЕ_ПРОЕКТА.yaml, esp8266_http_bridge_r4.ino]
2026-09-30 Log updated ESP boot wiring behavior
2026-09-30 Track R5 OTA proof state
2026-09-30 Log Android semantic L01 switch
2026-09-30 Track semantic L01 Android stage
2026-09-30 Track Android semantic read pass
2026-09-30 Document Android L01 stage 2
2026-09-30 Close Android L01 ON OFF and stage R6
2026-09-30 Close L01 ON OFF and track R6 stage
2026-09-30 Record R6 pass and stage complete L01 profile
2026-09-30 Track R6 pass and R7 full profile stage
2026-09-30 Close R7 L01 profile and advance to clap calibration
2026-09-30 Stage CORE R2 CLAPCAL compile gate
2026-09-30 Track CORE R2 CLAPCAL source state
2026-09-30 Track CORE R2 compile budget failure
    [03_СОСТОЯНИЕ_ПРОЕКТА.yaml]
2026-09-30 Stage compact CORE R3 verify gate
2026-09-30 Track compact CORE R3 state
2026-09-30 Track CORE R3 upload attempt failure
    [03_СОСТОЯНИЕ_ПРОЕКТА.yaml]
2026-09-30 Supersede incremental firmware flow with v1 release
2026-09-30 Track v1 finalization state
2026-10-01 Update BOM for 2m two-ring wiring
2026-10-01 Record ceiling wiring facts
2026-10-01 Log final ceiling wiring data
2026-10-01 Fix final two-housing physical topology
2026-10-01 Track confirmed ceiling topology
2026-10-01 Mark S-30-5 PE requirement in BOM
2026-10-01 Track S-30-5 PE requirement
2026-10-01 Track no-PE final PSU decision
2026-10-01 Add Arduino Nano v1 compile verification
2026-10-01 Fix Nano v1 integration compile errors
    [nano_ardu_v1.ino]
2026-10-01 Use fixed-point music runtime and PROGMEM Kelvin table
    [nano_ardu_v1.ino]
2026-10-01 Fix Arduino prototype order for Kelvin anchor
    [nano_ardu_v1.ino]
2026-10-01 Replace Wire with compact DS3231 TWI driver
    [nano_ardu_v1.ino]
2026-10-01 Freeze compact numeric Nano UART v1
2026-10-01 Fix compact UART compile integration
    [nano_ardu_v1.ino]
2026-10-01 Replace FastLED power model with compact dual-ring limiter
    [nano_ardu_v1.ino]
2026-10-01 Wire compact current limiter into frame output
2026-10-01 Compact Nano v1 async events and calibration replies
2026-10-01 Track Nano v1 release candidate compile pass
2026-10-01 Fix ESP v1 Arduino prototype ordering
2026-10-01 Document frozen compact UART v1
2026-10-01 Freeze compact UART v1 and release candidates
2026-10-01 Point release firmware to numeric UART v1
2026-10-01 Track final ESP v1 compile pass
2026-10-02 Add Music and Ambient power controls
2026-10-02 Wire Music and Ambient power controls
2026-10-02 Track replacement Nano and Android functional RC
2026-10-02 Track Android functional RC and Nano blocker
2026-10-02 Track Android design v1 release candidate
2026-10-02 Add smart-home color wheel control
2026-10-02 Wire smart-home Light scenes and color wheel
2026-10-02 Track Android home UI v0.11
2026-10-02 Wire smart sliders into Light controls
2026-10-02 Track Android smart slider v0.12
2026-10-02 Wire smart-home controls across Music Ambient Night Alarm
2026-10-02 Track Android smart-home tabs v0.13
2026-10-02 Wire Home Hub overview and Focus Dial to final API
2026-10-02 Track approved Android Home Hub Focus Dial RC
2026-10-03 Replace Light scene buttons with visual scene tiles
2026-10-03 Wire premium Light scene tiles
2026-10-03 Track Android premium Light v0.15
2026-10-03 Place Light header and device status over real hero photo
2026-10-03 Track Android real-assets Light v0.16
2026-10-03 Track Light layout polish v0.17
2026-10-03 Track Android contextual photo heroes v0.18
2026-10-03 Remove framed global status header
2026-10-03 Track Android Music/header polish v0.19
2026-10-03 Record frameless header owner decision
2026-10-04 Track owner-approved Music v0.20 plan
2026-10-04 Track Android Music Home Hub v0.20
2026-10-04 Use visual Music tiles and centered nav image buttons
2026-10-04 Track Music visual hotfix v0.20.1
2026-10-04 Track Android Music v0.20.1
2026-10-04 Track Android Music v0.20.2
2026-10-04 Track Music v0.20.2 handoff state
2026-10-04 Track Music room hero v0.20.3 handoff state
2026-10-04 Record replacement Nano numeric UART transport pass
2026-10-04 Log replacement Nano UART PING pass
2026-10-04 Wire Ambient Home Hub interactions
2026-10-04 Track Ambient v0.21 visual checkpoint
2026-10-04 Set current Ambient v0.21 next steps
2026-10-04 Fix Ambient refresh button recovery
2026-10-04 Wire Night and Alarm Home Hub UI
2026-10-04 Track normal-tab Home Hub completion
2026-10-04 Wire compact concept-parity controls
2026-10-04 Align Light scenes with concept board
2026-10-04 Log real-device review and v0.23 pass
2026-10-04 Track real-device visual parity checkpoint
2026-10-05 Add optional external 5V reserve power decision
2026-10-05 Add external reserve power items to BOM
2026-10-05 Record optional 5V reserve power requirement
2026-10-05 Log external reserve power architecture
2026-10-05 Refine reserve power BOM to USB-C PD input
2026-10-05 Validate device identity during direct Wi-Fi discovery
2026-10-05 Add direct Wi-Fi and reserve power component sources
2026-10-05 Wire ring profile selection into Android settings
2026-10-05 Update BOM for automatic backup and ring selection
2026-10-05 Document UART ring profile opcodes
2026-10-05 Apply ring profile immediately when power source changes
2026-10-05 Expose power source change event
2026-10-05 Replace stale purchase list with final battery-free v1 BOM
2026-10-05 Promote USB-C Nano and relay candidate in inventory
2026-10-05 Clarify USB-C Nano service role in BOM
2026-10-05 Add final v1 power component sources
2026-10-05 Set ring profile and battery-free v1 acceptance sequence
2026-10-07 Revert backup-only changes in nano_ardu_v1.ino
    [nano_ardu_v1.ino]
2026-10-07 Revert backup-only changes in ArduApiClient.kt
    [ArduApiClient.kt]
2026-10-07 Cancel ARDU backup battery architecture
2026-10-07 Remove cancelled backup hardware from final BOM
2026-10-07 Return relay module to non-core inventory after backup cancellation
2026-10-07 Remove cancelled ring profile UART extension
2026-10-07 Log owner cancellation of backup power branch
2026-10-07 Set current next step after backup cancellation
2026-10-07 Track owner rollback to v0.22 visual baseline
2026-10-07 Add selectable Ambient preset thumbnail frame
2026-10-07 Wire owner-requested navigation scenes presets and settings UX
2026-10-07 Add Android reset-defaults API action
    [ArduApiClient.kt]
2026-10-07 Fix Ambient speed semantics and add settings reset
    [nano_ardu_v1.ino]
2026-10-07 Extend UART v1 for owner-requested defaults reset
2026-10-07 Track v0.22.2 visual gate
2026-10-08 Record no UART changes under D-104
2026-10-08 Plan staged Ambient presets implementation and accept approved hero visuals
2026-10-08 Compile Nano v1 with optional Ambient lab probe and CI size gate
2026-10-08 Shrink Ambient preview gate and specialize its 44-LED geometry
2026-10-08 Optimize three Ambient renderers with shared fixed-shift timeline
    [ambient_preset_probe.h]
2026-10-08 Make Ambient preview RC1 self-contained for Arduino IDE and verify sync in CI
2026-10-08 Fix missing preview header with standalone one-file Nano Ambient RC2 and isolated CI build
    [nano_ambient_preview_rc2.ino]
2026-10-08 Record Windows RC1 header failure, RC2 single-file CI PASS and revised upload handoff
    [03_СОСТОЯНИЕ_ПРОЕКТА.yaml]
2026-10-08 Harden ESP v2 OTA credentials and verify one-file Arduino compile
2026-10-08 Fix missing semicolon in inlined ESP v2 response type
    [esp8266_ardu_v2.ino]
2026-10-08 Document staged one-time ESP OTA plus full Nano12, app and ARDU-DIRECT acceptance
2026-10-08 Trim retired F02 F03 and auto-cycle UART handling from full Nano12
2026-10-08 Document Ambient12 scene IDs, new UART extension and v2 release evidence
2026-10-08 Update Ambient12 v2 HTTP contract, Android behavior and device handoff
2026-10-08 Confirm physical ESP v2 OTA success from owner ping; gate Nano update on UART smoke
2026-10-09 Confirm owner physical motion PASS for all twelve Nano R4 presets; prioritize Android and power gates
2026-10-10 ESP V3: stabilize ARDU-DIRECT radio with AP clients and expose warm dawn Kelvin API
    [esp8266_warm_dawn_v3.ino]
2026-10-10 D-124: define Ring B 44-LED 3-core 1.5 mm² wiring and ceiling safety gate
2026-10-17 ci: make AVRDUDE verify flag check case-sensitive
2026-10-17 ci: stage one-shot Nano bridge R2 builder
2026-10-17 ci: stage one-shot Nano bridge R3 diagnostics
2026-10-17 diag: instrument Nano verify UART path
2026-11-07 Record Night D-125 read-only Wi-Fi acceptance gate and current hardware status
2026-11-07 Track second ring connected, pending low voltage 44+44 acceptance
2026-11-07 Record ring B LED output restored after DIN direction fix; mounting blocked
2026-11-07 Log ring B DIN correction and working LEDs before mounting gate
2026-11-14 Wire weekday/weekend alarm and post-dawn timeout controls with capability gating
2026-11-14 ESP V5: merge and apply family settings as a single Nano UART transaction
2026-11-14 Shrink Nano R7 EEPROM policy and reuse existing LED lerp to fit AVR
2026-11-14 Shrink Nano R7 day-of-week test to 8-bit math valid for DS3231 2000–2099
2026-11-14 Optimize 16-second Night fade: emit LED frames only when brightness changes
2026-11-14 Compact retired F02/F03 readback in Nano R7 without changing old ESP wire shape
